gralco/TAZ6/production_parts/electronics/index.html

# Index of /TAZ/Olive/production_parts/electronics

(ICO) | Name | Last modified | Size | Description
(PARENTDIR) | Parent Directory | | -
(DIR) | RAMBo/ | 2017-02-20 23:40 | -
( ) | TAZ6_Wiring.pdf | 2017-12-14 18:19 | 142K
(DIR) | Wire_Harnesses/ | 2016-12-08 21:19 | -
(DIR) | stepper_motors/ | 2016-09-29 14:19 | -
