gralco/TAZ6/production_parts/electronics/RAMBo/index.html

# Index of /TAZ/Olive/production_parts/electronics/RAMBo

(ICO) | Name | Last modified | Size | Description
(PARENTDIR) | Parent Directory | | -
(DIR) | ArduinoAddons/ | 2017-02-20 23:40 | -
(TXT) | README.md | 2017-02-20 23:40 | 662
(DIR) | board/ | 2017-02-20 23:40 | -
(DIR) | bootloaders/ | 2017-02-20 23:40 | -
(DIR) | docs/ | 2017-02-20 23:40 | -
(DIR) | drivers/ | 2017-02-20 23:40 | -
(TXT) | license.txt | 2017-02-20 23:40 | 285
(DIR) | past/ | 2017-02-20 23:40 | -
