gralco/TAZ6/production_parts/electronics/stepper_motors/index.html

# Index of /TAZ/Olive/production_parts/electronics/stepper_motors

(ICO) | Name | Last modified | Size | Description
(PARENTDIR) | Parent Directory | | -
( ) | moons_stepper_NEMA17_MS17HD6P4150-01.pdf | 2016-09-29 14:19 | 58K
