gralco/TAZ6/production_parts/electronics/Wire_Harnesses/index.html

# Index of /TAZ/Olive/production_parts/electronics/Wire_Harnesses

(ICO) | Name | Last modified | Size | Description
(PARENTDIR) | Parent Directory | | -
( ) | Cable_List.ods | 2016-12-08 21:19 | 20K
(DIR) | External_Cable_Harnesses/ | 2017-12-06 19:19 | -
(DIR) | Extruder_Wiring/ | 2019-04-02 19:19 | -
(DIR) | Internal_Cable_Harnesses/ | 2018-10-31 19:19 | -
