gralco/TAZ6/production_parts/printed_parts/bed_mount_chassis/index.html

# Index of /TAZ/Olive/production_parts/printed_parts/bed_mount_chassis

(ICO) | Name | Last modified | Size | Description
(PARENTDIR) | Parent Directory | | -
( ) | bed_mount_chassis_v3.3_A-x8.stl | 2016-09-16 21:56 | 36M
( ) | bed_mount_chassis_v3.3_A.FCStd | 2016-09-16 21:56 | 533K
( ) | bed_mount_chassis_v3.3_A.stl | 2016-09-16 21:56 | 4.5M
(DIR) | mini/ | 2017-06-07 18:19 | -
