gralco/TAZ6/production_parts/printed_parts/electronics_case_mount/index.html

# Index of /TAZ/Olive/production_parts/printed_parts/electronics_case_mount

(ICO) | Name | Last modified | Size | Description
(PARENTDIR) | Parent Directory | | -
( ) | electronics_case_mount_v2.0-x9.stl | 2016-09-16 21:56 | 596K
( ) | electronics_case_mount_v2.0.fcstd | 2016-09-16 21:56 | 36K
( ) | electronics_case_mount_v2.0.stl | 2016-09-16 21:56 | 66K
(DIR) | mini/ | 2019-03-18 20:49 | -
(DIR) | mini2/ | 2019-03-18 20:49 | -
