gralco/TAZ6/production_docs/compliance/TAZ6_chassis_radiated_emissions_data.pdf

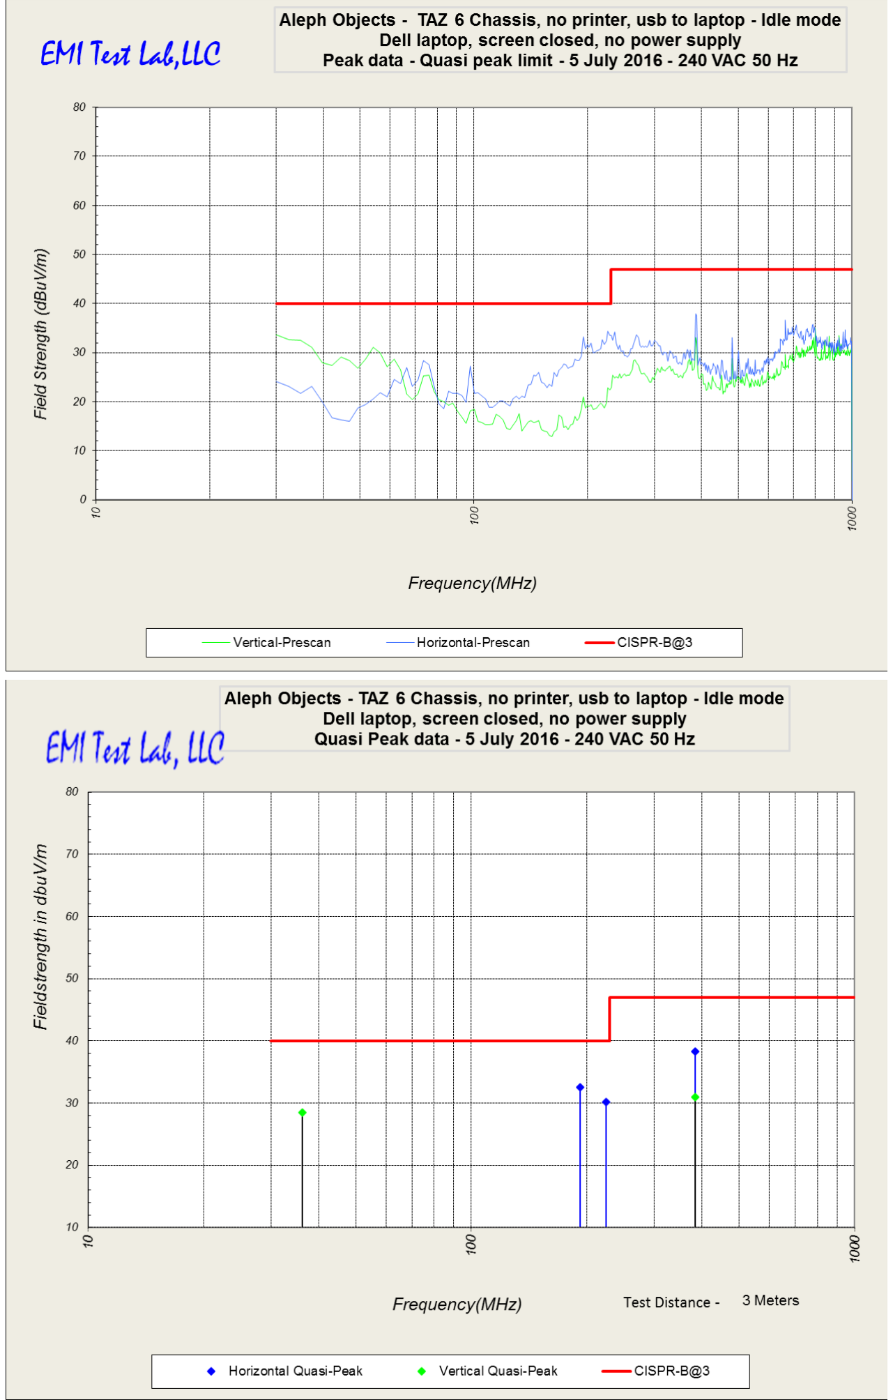
[picture p1: page 1]

### * No laptop power supply *

# EMI Test Lab

Frequency | F.S. EUT | Limit | Azimuth | Height
(MHz) | (dBuV/m) | (dBuV/m) | Degrees | Meters | H or V | Margin
383.99 | 30.94 | 47 | 228.0 | 1.40 | V | -16.06
36.18 | 28.42 | 40 | 228.0 | 1.40 | V | -11.58
191.99 | 32.53 | 40 | 16.0 | 1.40 | H | -7.47
384.00 | 38.32 | 47 | 64.0 | 1.40 | H | -8.68
224.49 | 30.20 | 40 | 312.0 | 1.40 | H | -9.80
1822 Skyway Drive, Unit J, Longmont Co | Dennis King
dennis@emitestlab.com , Cell 303-746-0611
| Antenna Polarization
