gralco/TAZ6/production_docs/OHAI/06_Frame_OHAI-T6.pdf

Frame Sub Assy

LulzBot TAZ 6.0 Frame
Step Pictures | Gather Tools and Parts

LulzBot TAZ 6.0 Frame
Step Pictures | Front Frame assembly
647 | 649
T-Nut installation orientation | 500mm threaded end alignment
651 | 2582 500mm 510mm
500mm/ 510mm frame alignment (arrows show Tnuts) | Four (4) T -Nuts per corner, Top slot
653 | 2567

500mm/ 510mm frame alignment

3mm Hex driver Squaring fixter | 4x- 500mm Aluminum Extrusion, M5 threaded one end 4x- 510mm Aluminum Extrusion, ends not threaded 41x- M5 T-Nut 32x- M5x10 BHCS 32x- M5 Washer, Black 8x- Corner gussets

Gather tools

Install four (4) T-Nuts into one side of a 500mm aluminum strut, position the T-Nuts so there are two (2) at each end of the strut; repeat for a second 500mm strut

Install four (4) T-Nuts into one side of a 510mm aluminum strut, position the T-Nuts so there are two (2) at each end of the strut; repeat for a second 510mm strut

Place the four (4) struts with the T-Nut side up

Arrange each of the 500mm struts parallel to each other and with their threaded ends at the same end oriented toward yourself

Place each of the 510mm struts between the 500mm struts so the 510mm struts align with the side and end of the 500mm strut (T-Nut sides should still be up)

Insert two (2) T-Nuts into the inside slot of the bottom 510mm strut, these will be used later in the assembly.

Place a corner gusset at each of the strut intersections; Loosely secure each gusset with (4) M5X10 BHCS and (4) M5 black washer.

Place one corner joint into a known square location, such as a squaring table; ensure the corners are square and the ends are flush; Secure each of the gusset screws are tightened to 4 ft-lbs (5.4NM); repeat this for each corner.

Additional T-Nuts on Top slot of the bottom extrusion

Frame Sub Assy

LulzBot TAZ 6.0 Frame
Step Pictures | Back Frame assembly

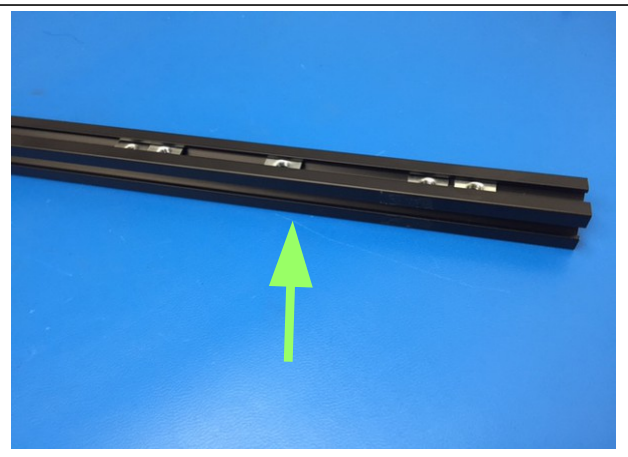
[picture p71: figure]
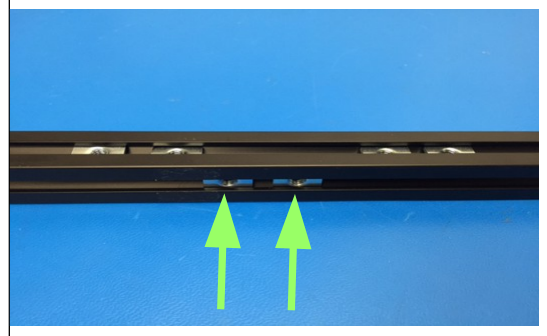
[picture p72: figure]

653 | 656
Back frame- Additional T-Nuts, Inside slot, right side | Back frame- Additional T-Nut, Top slot, left side

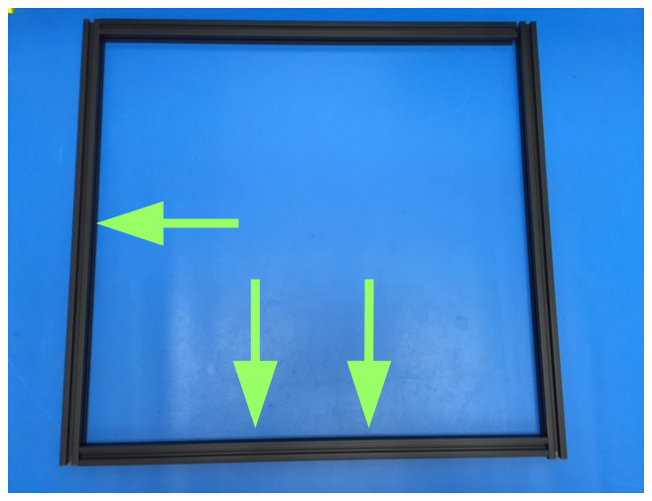
[picture p73: figure]
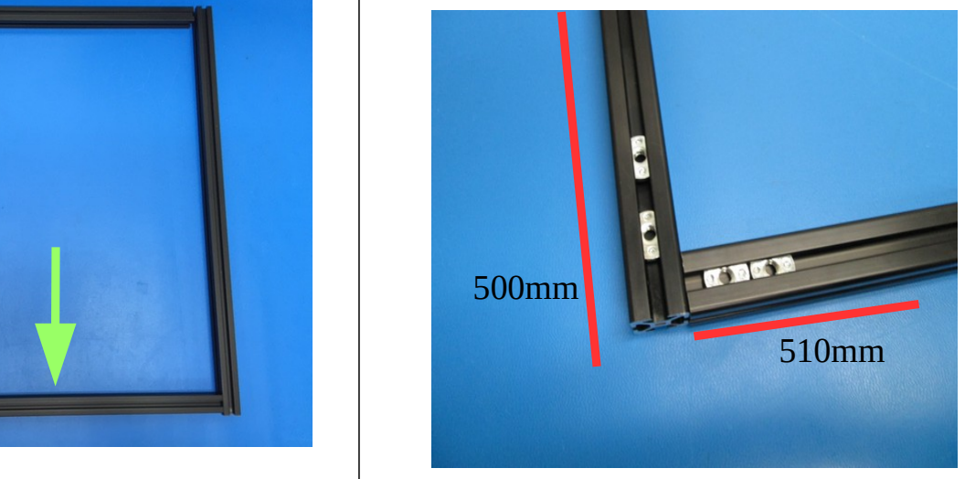
[picture p74: figure]

500mm/ 510mm frame alignment | Back frame- Additional T-Nut, Top slot, left side

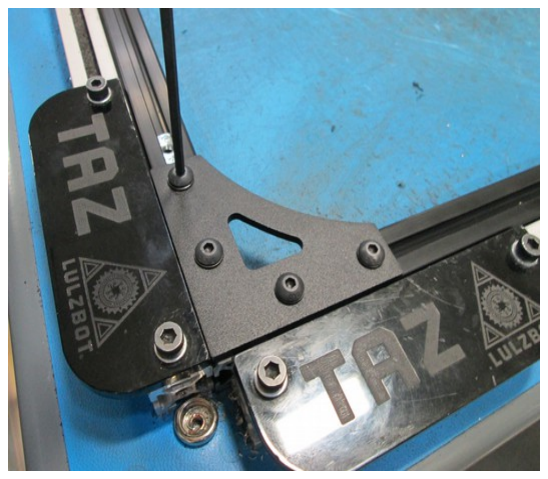
[picture p75: figure]

500mm/ 510mm frame alignment

Install four (4) T-Nuts into one side of a 500mm aluminum strut, position the T-Nuts so there are two (2) at each end of the strut; repeat for a second 500mm strut

Install four (4) T-Nuts into one side of a 510mm aluminum strut, position the T-Nuts so there are two (2) at each end of the strut; repeat for a second 510mm strut

Place the four (4) struts with the T-Nut side up

Arrange each of the 500mm struts parallel to each other and with their threaded ends at the same end oriented toward yourself

Place each of the 510mm struts between the 500mm struts so the 510mm struts align with the side and end of the 500mm strut (T-Nut sides should still be up)

Insert two (2) T-Nuts into the inside slot of the bottom 510mm strut, these will be used later in the assembly.

Place a corner gusset at each of the strut intersections; Loosely secure each gusset with (4) M5X10 BHCS and (4) M5 black washer.

Place one corner joint into a known square location, such as a squaring table; ensure the corners are square and the ends are flush; Secure each of the gusset screws are tightened to 4 ft-lbs (5.4NM); repeat this for each corner.
