gralco/TAZ6/production_docs/OHAI/10_XAssy_OHAI-T6.pdf

X Axis Sub

LulzBot TAZ 6.0 X Carriage sub assembly
Step Pictures | Gather Parts and Tools

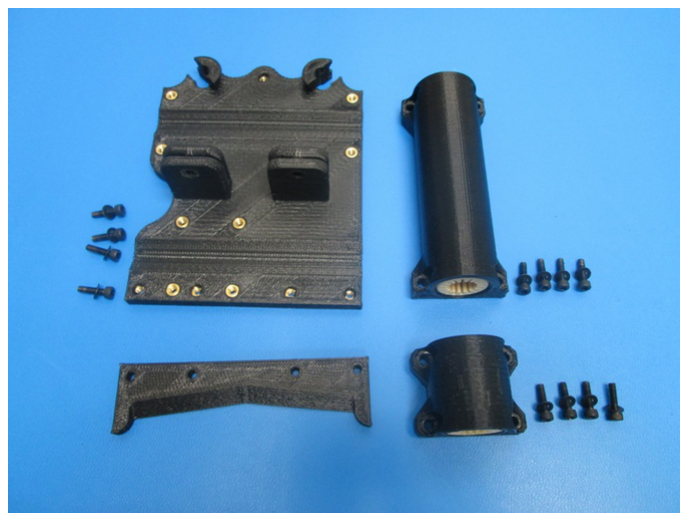
[picture p140: figure]

2134 | 2mm Hex driver | Gather Parts: 1x- X Carriage (with inserts installed) 1x- X Carriage Guide 1x- Single Bearing Holder (with bushing installed) 1x- Double Bearing Holder (with 2x bushings installed) 11x- M3x12 BHCS 12x- M3 Black washer 1x- M3x8 BHCS
Parts | Tools

LulzBot TAZ 6.0 X Carriage sub assembly
Step Pictures | X Carriage assembly

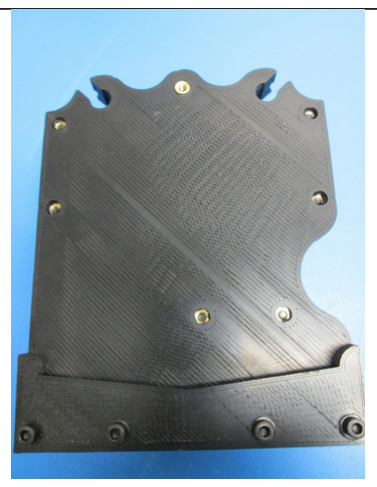
[picture p141: figure]
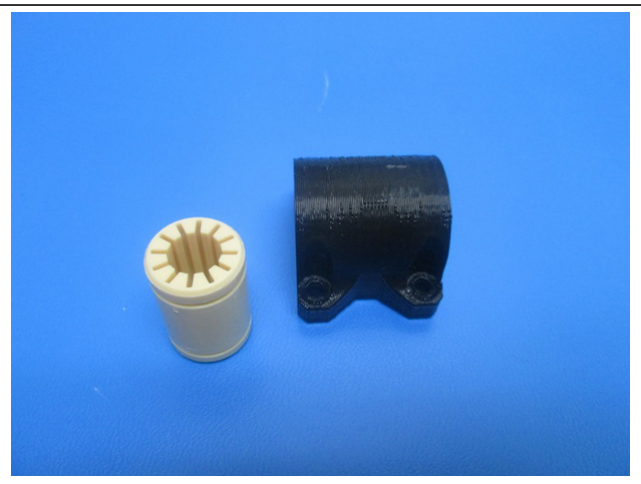
[picture p142: figure]

2007 | 2137
Install X Carriage Guide | Install single bearing into the holder

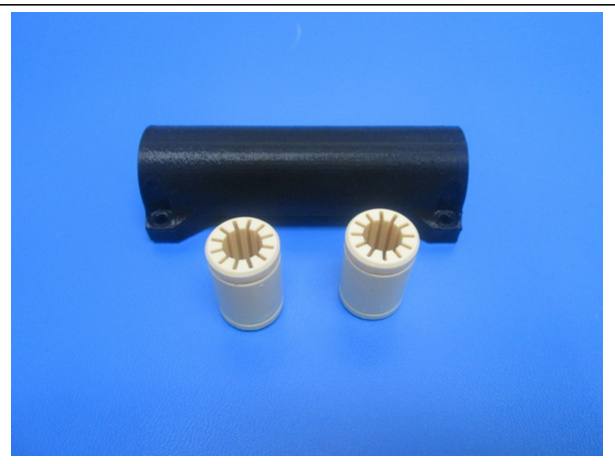
[picture p143: figure]
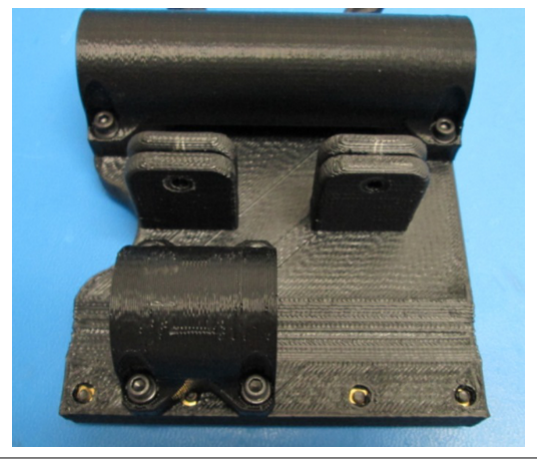
[picture p144: figure]

2009 | 2135
Install single bearing holder on the X Carraige | Install double bearing holder

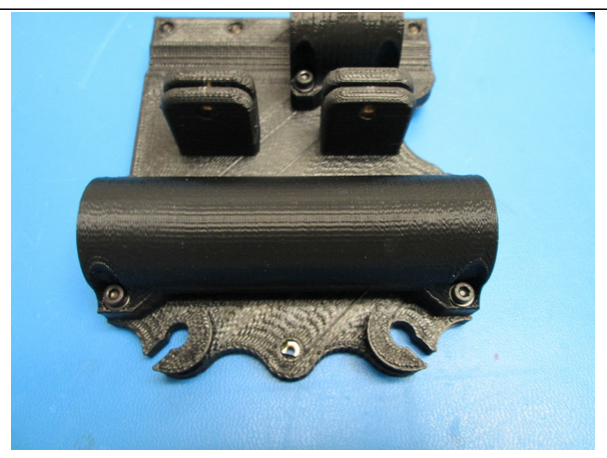
[picture p145: figure]

Install double bearing holder

Use four (4) M3x6 BHCS and four (4) M3 Black washers to install the X Carriage Guide onto the X Carriage; secure screws to hand tight

Install bushings into the Single Bearing holder

Use four (4) M3x6 BHCS and four (4) M3 Black washers to install the Single Bearing Holder onto the X Carriage; secure screws to hand tight

Install bushings into the Double Bearing holder

Use four (4) M3x6 BHCS and four (4) M3 Black washers to install the Double Bearing Holder onto the X Carriage; secure screws to hand tight
