gralco/TAZ6/software/firmware/Marlin_Oliveoil_Tilapia_v1.0.2.22_60d344d/Documentation/LCD Menu Tree.pdf

# Marlin LCD Menu Tree

Main Menu | Tune Menu | Move Menu
Info screen | Main | Prepare
Tune | Speed | Move 10mm | Move Menu
Prepare | Nozzle | Move 1mm | Move axis
Control | Nozzle2 | Move 0.1mm | Move X
Pause print | Nozzle3 | | Move Y
Resume print | Bed | | Move Z
Stop print | Fan speed | Temperature Menu | Extruder
Print from SD | Flow | Control
Change SD card | Babystep X | Nozzle
No SD card | Babystep Y | Nozzle2
Init. SD card | Babystep Z | Nozzle3
| Change filament | Bed
| | Fan speed
| | Autotemp
| Prepare Menu | \002 Min
| Main | \002 Max | Preheat PLA
| Autostart | \002 Fact | Temperature
| Disable steppers | PID-P | Fan speed
| Auto home | PID-I | Nozzle
| Preheat PLA | PID-D | Bed
| Preheat ABS | PID-C | Store memory
| Cooldown | Preheat PLA conf
| Switch power off | Preheat ABS conf | Preheat ABS
Switch power on | Temperature
Move axis | Fan speed
| Motion Menu | Nozzle
| Control | Bed
Control Menu | Z Offset | Store memory
Main | Accel
Temperature | Vxy-jerk
Motion | Vz-jerk
LCD contrast | Ve-jerk
Retract | Vmax x
Store memory | Vmax y
Load memory | Vmax z
Restore failsafe | Vmax e
| Vmin
| VTrav min
SD Card Menu | Amax x
Main | Amax y
Refresh | Amax z
filenames | Amax e
| A-retract
| Xsteps/mm
| Ysteps/mm
| Zsteps/mm
| Esteps/mm
| Endstop abort

Retract Menu
Control
AutoRetr.
Retract mm
Retract F
Hop mm
UnRet +mm
UnRet F
