gralco/TAZ6/production_parts/electronics/RAMBo/board/pin_list.ods

Port | Arduino Digital # | Function | RAMBo Function | Color | Function
PE0 | 0 | USART0_RX | USB/Serial Ext 3 |  | Serial
PE1 | 1 | USART0_TX | USB/Serial Ext 4 |  | MOSFET
PE4 | 2 | PWM2 | Fan-2 |  | Stepper
PE5 | 3 | PWM3 | Bed-Heat |  | I2C
PG5 | 4 | PWM4 | PS-On/PWM Ext 6 |  | Ext2
PE3 | 5 | PWM5 | PWM Ext 5 |  | Analog In
PH3 | 6 | PWM6 | Fan-1 |  | SPI
PH4 | 7 | PWM7 | Heat-1 |  | PWM
PH5 | 8 | PWM8 | Fan-0 |  | Stepper Ext
PH6 | 9 | PWM9 | Heat-0 |  | Endstop
PB4 | 10 | PWM10 | Z-Min |  | Endstop/Stepper Ext
PB5 | 11 | PWM11 | Y-Min
PB6 | 12 | PWM12 | X-Min
PB7 | 13 | PWM13 | LED/PWM Ext 3
PJ1 | 14 | USART3_TX | Serial Ext 10
PJ0 | 15 | USART3_RX | Serial Ext 9
PH1 | 16 | USART2_TX | Serial Ext 8
PH0 | 17 | USART2_RX | Serial Ext 7
PD3 | 18 | USART1_TX | Serial Ext 6
PD2 | 19 | USART1_RX | Serial Ext 5
PD1 | 20 | I2C_SDA | I2C Ext 3
PD0 | 21 | I2C_SCL | I2C Ext 4
PA0 | 22 | D22 | MX1-3
PA1 | 23 | D23 | Y-Max/MX3-3
PA2 | 24 | D24 | X-Max/MX2-3
PA3 | 25 | D25 | E1-En
PA4 | 26 | D26 | E0-En
PA5 | 27 | D27 | Z-En
PA6 | 28 | D28 | Y-En
PA7 | 29 | D29 | X-En
PC7 | 30 | D30 | Z-Max/MX2-4
PC6 | 31 | D31 | MX3-4
PC5 | 32 | D32 | MX1-4
PC4 | 33 | D33 | E1-Step
PC3 | 34 | D34 | E0-Step
PC2 | 35 | D35 | Z-Step
PC1 | 36 | D36 | Y-Step
PC0 | 37 | D37 | X-Step
PD7 | 38 | D38 | DigiPot-SS
PG2 | 39 | D39 | Y-MS2
PG1 | 40 | D40 | X-MS1
PG0 | 41 | D41 | X-MS2
PL7 | 42 | D42 | E1-Dir
PL6 | 43 | D43 | E0-Dir
PL5 | 44 | D44 | MX1-5
PL4 | 45 | D45 | MX3-5
PL3 | 46 | D46 | MX2-5
PL2 | 47 | D47 | Z-Dir
PL1 | 48 | D48 | X-Dir
PL0 | 49 | D49 | Y-Dir
PB3 | 50 | SPI_MISO | SPI Ext 3
PB2 | 51 | SPI_MOSI | SPI Ext 4
PB1 | 52 | SPI_SCK | SPI Ext 5
PB0 | 53 | SPI_SS | SPI Ext 6
PF0 | 54 | A0 | T0
PF1 | 55 | A1 | T1
PF2 | 56 | A2 | T2
PF3 | 57 | A3 | Analog Ext 8
PF4 | 58 | A4 | Analog Ext 6
PF5 | 59 | A5 | Analog Ext 4
PF6 | 60 | A6 | Analog Ext 3
PF7 | 61 | A7 | T3/Analog Ext 5
PK0 | 62 | A8 | Analog Ext 7
PK1 | 63 | A9 | E1-MS1
PK2 | 64 | A10 | E1-MS2
PK3 | 65 | A11 | E0-MS1
PK4 | 66 | A12 | E0-MS2
PK5 | 67 | A13 | Z-MS2
PK6 | 68 | A14 | Z-MS1
PK7 | 69 | A15 | Y-MS1
PG4 | 70 | D70 | Ext2 5
PG3 | 71 | D71 | Ext2 7
PJ2 | 72 | D72 | Ext2 9
PJ3 | 73 | D73 | Ext2 11
PJ7 | 74 | D74 | Ext2 13
PJ4 | 75 | D75 | Ext2 15
PJ5 | 76 | D76 | Ext2 17
PJ6 | 77 | D77 | Ext2 19
PE2 | 78 | D78 | Ext2 20
PE6 | 79 | D79 | Ext2 18
PE7 | 80 | D80 | Ext2 16
PD4 | 81 | D81 | Ext2 14
PD5 | 82 | D82 | Ext2 12
PD6 | 83 | D83 | Ext2 10
PH2 | 84 | D84 | Ext2 8
PH7 | 85 | D85 | Ext2 6
