gralco/TAZ6/production_docs/Cura_Update_Insert_02.pdf

# Attention:

The applications, documentation and source files included within may have been updated since the packaging of this LulzBot product.
Get the latest features, improved performance, and even more filament compatibility by installing the latest version of Cura LulzBot Edition: LulzBot.com/Cura
Learn more about Cura LE: LulzBot.com/Cura-QSG View the latest source files: Download.LulzBot.com Get answers and advice when you need them:
Lulzbot.com/Support | Support@LulzBot.com | +1-970-377-1111
