gralco/TAZ6/documentation/manual/source/images-1600x1200/electronics_case_rec.JPG

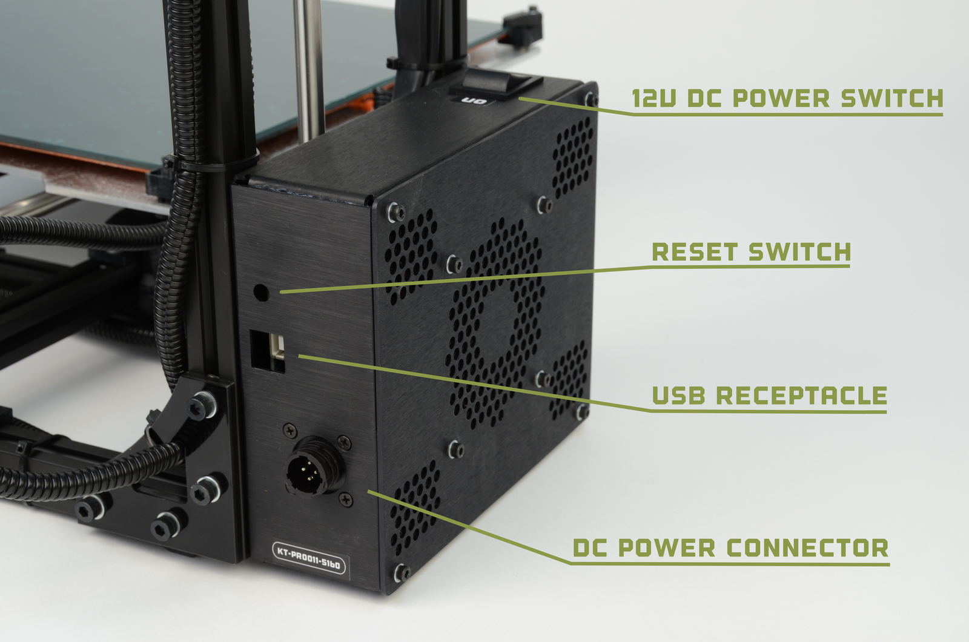
documentation/manual/source/images-1600x1200/electronics_case_rec.JPG
