gralco/TAZ6/documentation/manual/source/images-1600x1200/electronics_DC_connector_tight.JPG

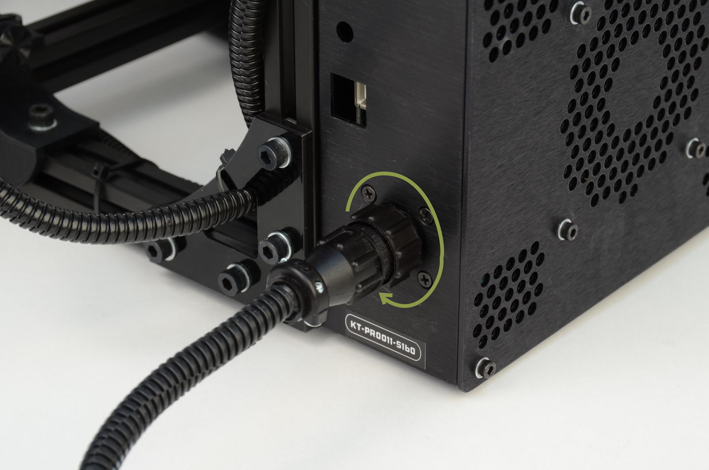
documentation/manual/source/images-1600x1200/electronics_DC_connector_tight.JPG
