gralco/TAZ6/photos/mock.JPG

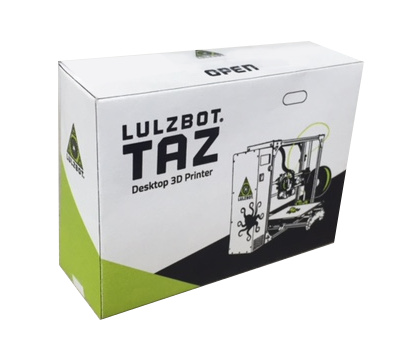
photos/mock.JPG
