gralco/TAZ6/photos/taz_6_angle_octopus.jpg

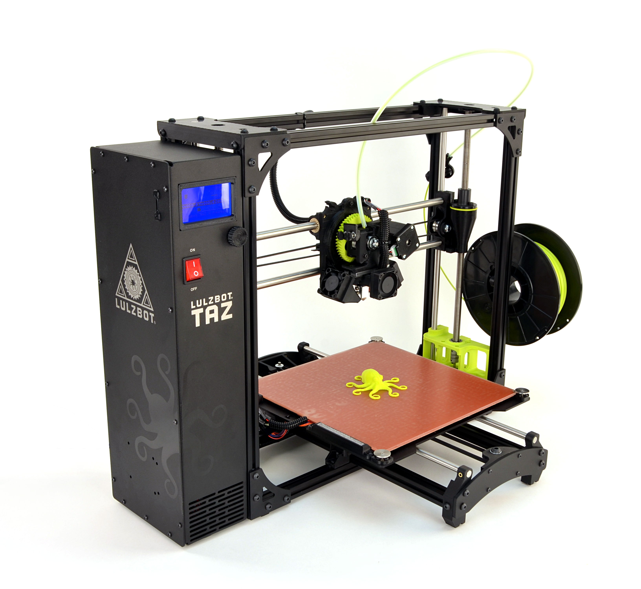
photos/taz_6_angle_octopus.jpg
