gralco/TAZ6/photos/TAZ_6_Angle_Rock2pus.jpg

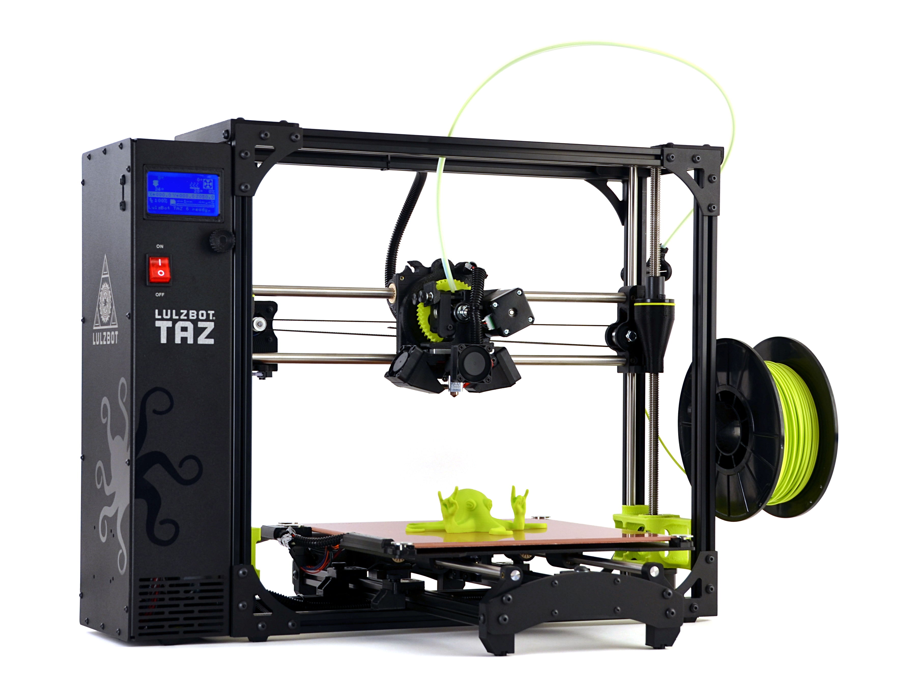
photos/TAZ_6_Angle_Rock2pus.jpg
