gralco/TAZ6/photos/TAZ_6_Angle_Rock2pus_2.jpg

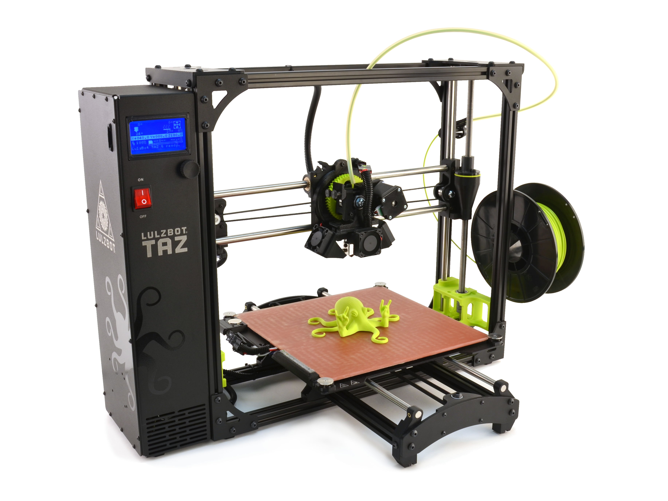
photos/TAZ_6_Angle_Rock2pus_2.jpg
