gralco/TAZ6/photos/TAZ_6_Angle_w_Rock2pus_300X200.Jpg

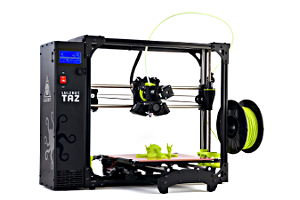
photos/TAZ_6_Angle_w_Rock2pus_300X200.Jpg
