gralco/TAZ6/photos/TAZ_6_Box_FullRes_whiteBG.JPG

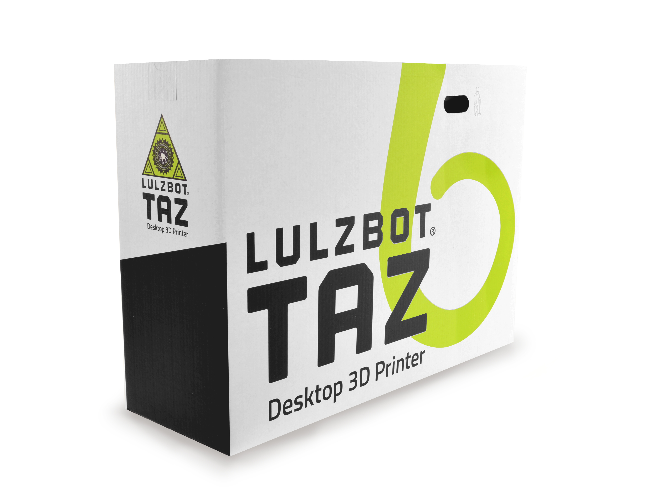
photos/TAZ_6_Box_FullRes_whiteBG.JPG
