gralco/TAZ6/photos/TAZ_6_BoxWithTape.JPG

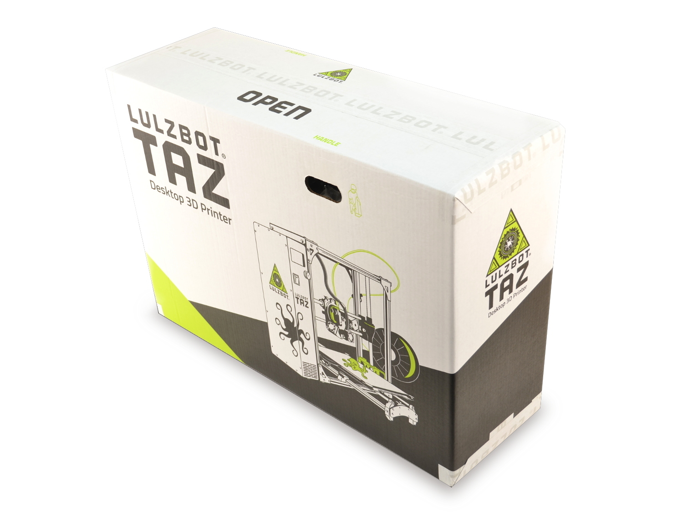
photos/TAZ_6_BoxWithTape.JPG
