gralco/TAZ6/photos/TAZ_6_DragonKnockerOnBed.JPG

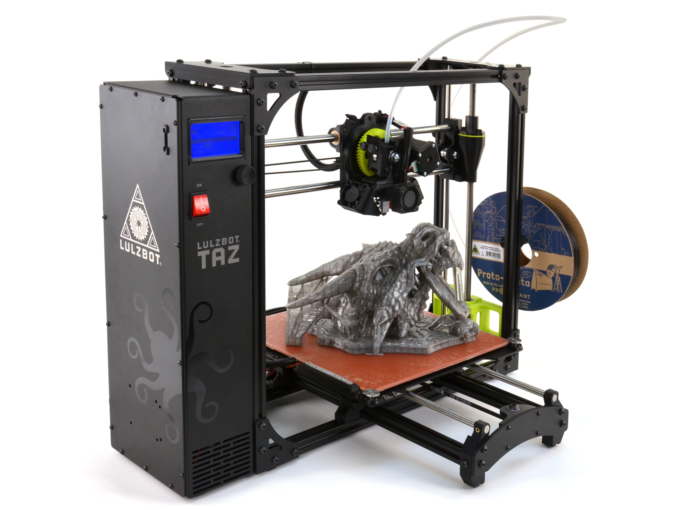
photos/TAZ_6_DragonKnockerOnBed.JPG
