gralco/TAZ6/photos/TAZ_6_frontal_transpBG.png

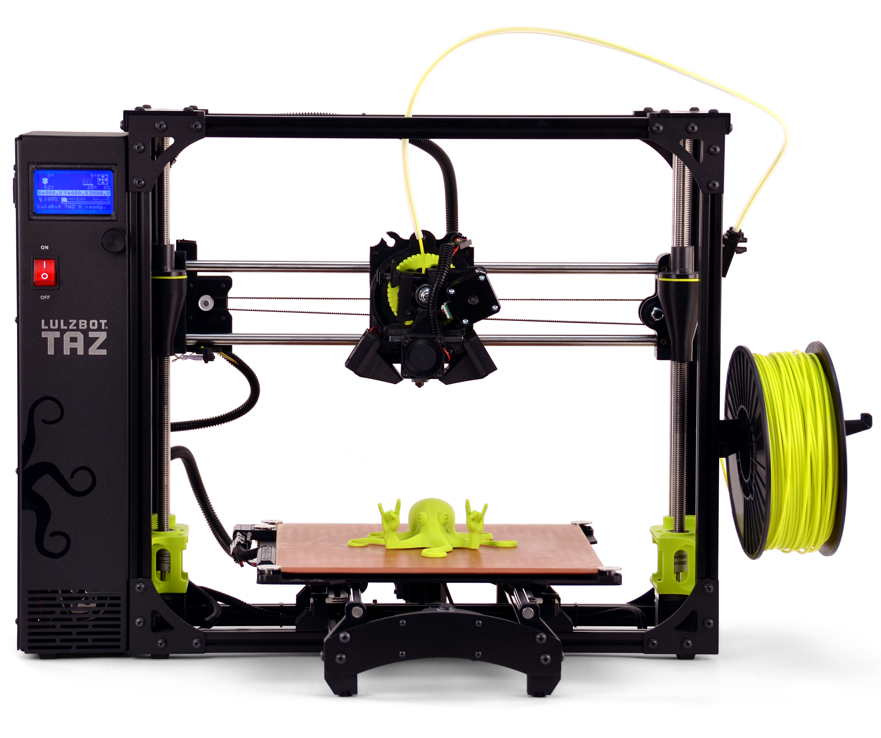
photos/TAZ_6_frontal_transpBG.png
