gralco/TAZ6/photos/TAZ_6_RightQuarterTurn_FullRes.JPG

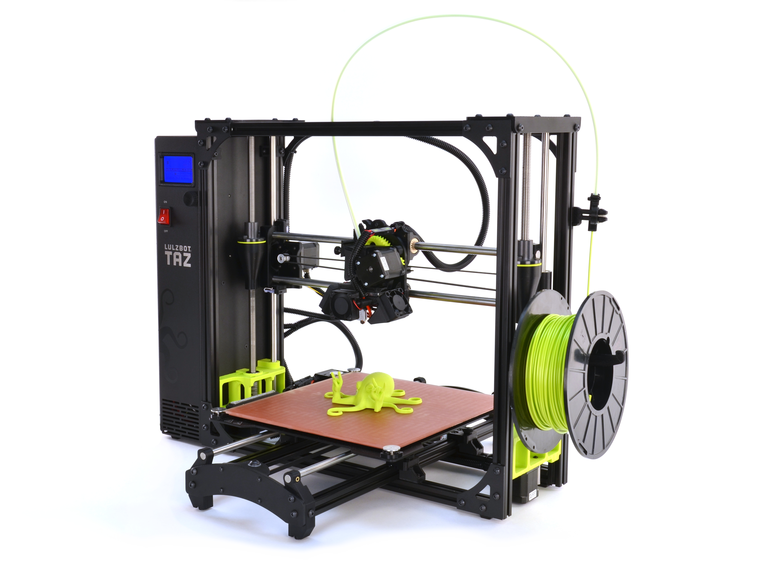
photos/TAZ_6_RightQuarterTurn_FullRes.JPG
