gralco/TAZ6/production_parts/electronics/RAMBo/past/motorExt1-1.jpg

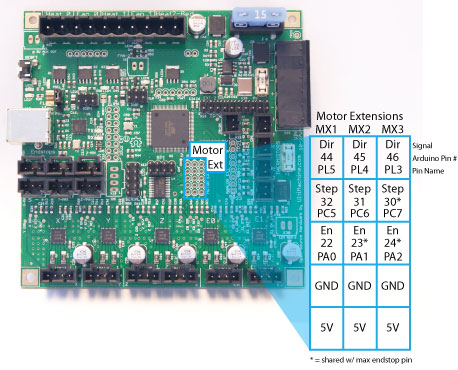
production_parts/electronics/RAMBo/past/motorExt1-1.jpg
