gralco/TAZ6/production_parts/printed_parts/bed_corner_taz6/index.html

Name | Last modified | Size | Description
Parent Directory |  | -
Taz/ | 2018-08-22 20:49 | -
bed_corner_taz6_v2.fcstd | 2016-09-16 21:56 | 19K
bed_corner_taz6_v2.stl | 2016-09-16 21:56 | 28K
mini-flexy/ | 2019-03-18 15:49 | -
mini_Aero-flexy/ | 2017-10-26 00:49 | -
