gralco/TAZ6/production_parts/printed_parts/flexy_bed_foot/index.html

Name | Last modified | Size | Description
Parent Directory |  | -
Taz/ | 2018-08-14 14:19 | -
flexy_bed_foot_v0.1.fcstd | 2016-09-16 21:56 | 6.2K
flexy_bed_foot_v0.1.stl | 2016-09-16 21:56 | 88K
mini/ | 2018-10-23 17:49 | -
