gralco/TAZ6/production_parts/printed_parts/flexy_washer/index.html

Name | Last modified | Size | Description
Parent Directory |  | -
Taz/ | 2018-08-08 16:19 | -
flexy_washer_v0.1.fcstd | 2016-09-16 21:56 | 5.2K
flexy_washer_v0.1.stl | 2016-09-16 21:56 | 107K
mini/ | 2017-11-08 15:49 | -
