gralco/TAZ6/production_parts/printed_parts/spool_arm/index.html

Name | Last modified | Size | Description
Parent Directory |  | -
spool_arm_v0.2-x2.stl | 2016-09-16 21:56 | 667K
spool_arm_v0.2.FCStd | 2016-09-16 21:56 | 758K
spool_arm_v0.2.stl | 2016-09-16 21:56 | 334K
taz/ | 2017-02-21 20:19 | -
taz6/ | 2017-01-17 19:49 | -
