gralco/TAZ6/production_docs/OliveOil_TAZ-BOM_3000.Ordering.ods

Sheet: KT-PR0041NA
Category | AO Part # | Description | Manufacturer | Manufacturer PN | Distributor | Distributor SKU | Qty Per | UOM | Price Per Unit | Price Total | Qty to Order | PO | Date | ETA
 |  |  |  |  |  |  |  |  |  | #VALUE! | 1,100
Printer | KT-PR0041 | TAZ 3D Printer, v6.0 | Aleph Objects, Inc. | KT-PR0041 |  |  | 1 | ea | = | #VALUE!
Accessories | DC-LB0098 | Label, Lulzbot TAZ 6.0 Barcode, KT-PR0041NA |  |  | Print Source of Loveland |  | 1 | ea | $0.105 | $0.10 | 1,100 | PO12745 | 03/31/16 | 04/06/16 | received
Accessories | DC-LB0097 | TAZ v6.0 serial number sticker, KT-PR0041NA |  |  | Print Source of Loveland |  | 1 | ea | $0.015 | $0.02 | 1,100 | PO12745 | 03/31/16 | 04/06/16 | received

Sheet: KT-PR0041EU
Category | AO Part # | Description | Manufacturer | Manufacturer PN | Distributor | Distributor SKU | Qty Per | UOM | Price Per Unit | Price Total | Qty to Order | PO | Date | ETA
 |  |  |  |  |  |  |  |  |  | #VALUE! | 300
Printer | KT-PR0041 | TAZ 3D Printer, v6.0 | Aleph Objects, Inc. | KT-PR0041 |  |  | 1 | ea | = | #VALUE!
Accessories | DC-LB0100 | Label, Lulzbot TAZ 6.0 Barcode, KT-PR0041EU |  |  | Print Source of Loveland |  | 1 | ea | $0.06 | $0.06 | 300 | PO12745 | 03/31/16 | 04/01/16
Accessories | DC-LB0099 | TAZ v6.0 serial number sticker, KT-PR0041EU |  |  | Print Source of Loveland |  | 1 | ea | $0.04 | $0.04 | 300 | PO12745 | 03/31/16 | 04/01/16
Accessories | EL-CA0031 | 6ft 18AWG England Power Cord Cable - H05VV-F NEMA C13 – Black |  |  | Linvox | 7691 | 1 | ea | $1.98 | $1.98 | 300 |  |  |  | 525 on hand, Hold on ordering per Steven.
Accessories | EL-CA0032 | 6ft 18AWG European Power Cord Cable - H05VV-F NEMA C13 – Black |  |  | Linvox | 7692 | 1 | ea | $1.25 | $1.25 | 300 |  |  |  | 625 On hand, Hold on ordering per Steven

Sheet: KT-PR0041AU
Category | AO Part # | Description | Manufacturer | Manufacturer PN | Distributor | Distributor SKU | Qty Per | UOM | Price Per Unit | Price Total | Qty to Order | PO | Date | ETA
 |  |  |  |  |  |  |  |  |  | #VALUE! | 100
Printer | KT-PR0041 | TAZ 3D Printer, v6.0 | Aleph Objects, Inc. | KT-PR0041 |  |  | 1 | ea | = | #VALUE!
Accessories | DC-LB0102 | Label, Lulzbot TAZ 6.0 Barcode, KT-PR0041AU |  |  | Print Source of Loveland |  | 1 | ea | $0.21 | $0.21 | 100 | PO12745 | 03/31/16 | 04/04/16
Accessories | DC-LB0101 | TAZ v6.0 serial number sticker, KT-PR0041AU |  |  | Print Source of Loveland |  | 1 | ea | $0.10 | $0.10 | 100 | PO12745 | 03/31/16 | 04/04/16
Accessories | EL-CA0056 | 6ft 18AWG Australian Power Cord Cable - H05VV-FNEMA C13 – Black |  |  | Linvox | 7670 | 1 | ea | $1.70 | $1.70 | 100 |  |  |  | PER Steven- hold to order….158 pc in stock now 4/7/16

Sheet: OdooParts_PurchaseNotes
Internal Reference | Name | Type | Long Lead | U/M | Price Per Unit | Manufacturer | Mfg PN | Supplier | Supplier PN | Distributor SKU | Notes | 2nd Distributor | 2nd Dist. Part Number | Mass each (g) | Mass per Printer (g) | Mass Total (kg)
AS-CB0005 | TAZ6, Extruder Heatsink Fan Harness | Make | No | PCE | 0 | AlephObjects | 0 | 0 | 0 | 0 | 0 | 0 | 0 | 0 | 0 | 0
AS-CB0006 | TAZ6, Extruder X-Max Switch Ext Harness | Make | No | PCE | 0 | AlephObjects | 0 | 0 | 0 | 0 | 0 | 0 | 0 | 0 | 0 | 0
AS-CB0007 | Heater Cartridge 180mm Harness | Make | No | PCE | 0 | AlephObjects | 0 | 0 | 0 | 0 | 0 | 0 | 0 | 0 | 0 | 0
AS-CB0008 | Thermistor 150mm Harness | Make | No | PCE | 0 | AlephObjects | 0 | 0 | 0 | 0 | 0 | 0 | 0 | 0 | 0 | 0
AS-CB0009 | Zero Sense 155mm Harness | Make | No | PCE | 0 | AlephObjects | 0 | 0 | 0 | 0 | 0 | 0 | 0 | 0 | 0 | 0
AS-HE0002 | .50 mm Hot End Assembly, for single | Make | No | PCE | 0 | AlephObjects | 0 | 0 | 0 | 0 | 0 | 0 | 0 | 0 | 0 | 0
AS-PK0005 | TAZ6, Olive Oil, Packaging | Make | No | PCE | 0 | AlephObjects | 0 | 0 | 0 | 0 | 0 | 0 | 0 | 0 | 0 | 0
AS-PK0006 | TAZ6, Olive Oil, Documentation Bag | Make | No | PCE | 0 | AlephObjects | 0 | 0 | 0 | 0 | 0 | 0 | 0 | 0 | 0 | 0
AS-PK0007 | TAZ6, Olive Oil, Extruder Package | Make | No | PCE | 0 | AlephObjects | 0 | 0 | 0 | 0 | 0 | 0 | 0 | 0 | 0 | 0
AS-PK0008 | TAZ6, Olive Oil, Accessories Package | Make | No | PCE | 0 | AlephObjects | 0 | 0 | 0 | 0 | 0 | 0 | 0 | 0 | 0 | 0
AS-PK0009 | TAZ6, Tool Kit | Make | No | PCE | 0 | AlephObjects | 0 | 0 | 0 | 0 | 0 | 0 | 0 | 0 | 0 | 0
AS-PK0010 | 90 mm wiper pad set | Make | No | PCE | 0 | AlephObjects | 0 | 0 | 0 | 0 | 0 | 0 | 0 | 0 | 0 | 0
AS-PR0001 | TAZ6, Olive Oil, Calibrated Assembly | Make | No | PCE | 0 | AlephObjects | 0 | 0 | 0 | 0 | 0 | 0 | 0 | 0 | 0 | 0
AS-PR0002 | TAZ6, Print Bed Assembly | Make | No | PCE | 0 | AlephObjects | 0 | 0 | 0 | 0 | 0 | 0 | 0 | 0 | 0 | 0
AS-PR0003 | TAZ6, Olive Oil, Final Mechanical Assembly | Make | No | PCE | 0 | AlephObjects | 0 | 0 | 0 | 0 | 0 | 0 | 0 | 0 | 0 | 0
AS-PR0004 | TAZ6, Olive Oil, Control Box Assembly | Make | No | PCE | 0 | AlephObjects | 0 | 0 | 0 | 0 | 0 | 0 | 0 | 0 | 0 | 0
AS-PR0005 | TAZ6, Power Supply with External wiring Assembly | Make | No | PCE | 0 | AlephObjects | 0 | 0 | 0 | 0 | 0 | 0 | 0 | 0 | 0 | 0
AS-PR0006 | TAZ6, Frame, Final Assembly | Make | No | PCE | 0 | AlephObjects | 0 | 0 | 0 | 0 | 0 | 0 | 0 | 0 | 0 | 0
AS-PR0008 | TAZ6, Bed Mount Chassis with Inserts | Make | No | PCE | 0 | AlephObjects | 0 | 0 | 0 | 0 | 0 | 0 | 0 | 0 | 0 | 0
AS-PR0008 | TAZ6, Bed Mount Chassis with Inserts | Make | No | PCE | 0 | AlephObjects | 0 | 0 | 0 | 0 | 0 | 0 | 0 | 0 | 0 | 0
AS-PR0011 | TAZ6, Tippy Feed Tube Holder with Bushing Assembly | Make | No | PCE | 0 | AlephObjects | 0 | 0 | 0 | 0 | 0 | 0 | 0 | 0 | 0 | 0
AS-PR0012 | TAZ6, Spool Arm with Bushing Assembly | Make | No | PCE | 0 | AlephObjects | 0 | 0 | 0 | 0 | 0 | 0 | 0 | 0 | 0 | 0
AS-PR0013 | TAZ6, Z Axis Left Assembly | Make | No | PCE | 0 | AlephObjects | 0 | 0 | 0 | 0 | 0 | 0 | 0 | 0 | 0 | 0
AS-PR0014 | TAZ6, Z Carriage Motor with Bearings and Inserts Assembly | Make | No | PCE | 0 | AlephObjects | 0 | 0 | 0 | 0 | 0 | 0 | 0 | 0 | 0 | 0
AS-PR0015 | TAZ6, Z Carriage Motor with Bearings Assembly | Make | No | PCE | 0 | AlephObjects | 0 | 0 | 0 | 0 | 0 | 0 | 0 | 0 | 0 | 0
AS-PR0016 | TAZ6, Z Lower Left with Inserts Assembly | Make | No | PCE | 0 | AlephObjects | 0 | 0 | 0 | 0 | 0 | 0 | 0 | 0 | 0 | 0
AS-PR0017 | TAZ6, Z Axis Right Assembly | Make | No | PCE | 0 | AlephObjects | 0 | 0 | 0 | 0 | 0 | 0 | 0 | 0 | 0 | 0
AS-PR0018 | TAZ6, Z Carriage Idler with Bearings and Inserts Assembly | Make | No | PCE | 0 | AlephObjects | 0 | 0 | 0 | 0 | 0 | 0 | 0 | 0 | 0 | 0
AS-PR0019 | TAZ6, Z Carriage Idler with Bearings Assembly | Make | No | PCE | 0 | AlephObjects | 0 | 0 | 0 | 0 | 0 | 0 | 0 | 0 | 0 | 0
AS-PR0020 | TAZ6, Z Lower Right with Inserts Assembly | Make | No | PCE | 0 | AlephObjects | 0 | 0 | 0 | 0 | 0 | 0 | 0 | 0 | 0 | 0
AS-PR0021 | TAZ6, Olive Oil, Y Axis Assembly | Make | No | PCE | 0 | AlephObjects | 0 | 0 | 0 | 0 | 0 | 0 | 0 | 0 | 0 | 0
AS-PR0022 | TAZ6, Y Axis Bed Plate Assembly | Make | No | PCE | 0 | AlephObjects | 0 | 0 | 0 | 0 | 0 | 0 | 0 | 0 | 0 | 0
AS-PR0023 | 90mm Cut wiper pad | Make | No | PCE | 0 | AlephObjects | 0 | 0 | 0 | 0 | 0 | 0 | 0 | 0 | 0 | 0
AS-PR0024 | TAZ6, Y Belt Mount with Inserts Assembly | Make | No | PCE | 0 | AlephObjects | 0 | 0 | 0 | 0 | 0 | 0 | 0 | 0 | 0 | 0
AS-PR0025 | 10mm Single Bearing holders Assembly | Make | No | PCE | 0 | AlephObjects | 0 | 0 | 0 | 0 | 0 | 0 | 0 | 0 | 0 | 0
AS-PR0026 | TAZ6, Y Corner Right with Insert Assembly | Make | No | PCE | 0 | AlephObjects | 0 | 0 | 0 | 0 | 0 | 0 | 0 | 0 | 0 | 0
AS-PR0027 | TAZ6, Y Corner Left with Insert Assembly | Make | No | PCE | 0 | AlephObjects | 0 | 0 | 0 | 0 | 0 | 0 | 0 | 0 | 0 | 0
AS-PR0028 | TAZ6, Y Idler with Bearings and Inserts | Make | No | PCE | 0 | AlephObjects | 0 | 0 | 0 | 0 | 0 | 0 | 0 | 0 | 0 | 0
AS-PR0029 | TAZ6, Y Idler Mount with Inserts Assembly | Make | No | PCE | 0 | AlephObjects | 0 | 0 | 0 | 0 | 0 | 0 | 0 | 0 | 0 | 0
AS-PR0030 | TAZ6, Y Axis Motor End Assembly | Make | No | PCE | 0 | AlephObjects | 0 | 0 | 0 | 0 | 0 | 0 | 0 | 0 | 0 | 0
AS-PR0031 | TAZ6, Y Motor Mount with Inserts Assembly | Make | No | PCE | 0 | AlephObjects | 0 | 0 | 0 | 0 | 0 | 0 | 0 | 0 | 0 | 0
AS-PR0032 | TAZ6, Olive Oil, X Carriage Assembly | Make | No | PCE | 0 | AlephObjects | 0 | 0 | 0 | 0 | 0 | 0 | 0 | 0 | 0 | 0
AS-PR0033 | TAZ6, X carriage with Inserts Assembly | Make | No | PCE | 0 | AlephObjects | 0 | 0 | 0 | 0 | 0 | 0 | 0 | 0 | 0 | 0
AS-PR0034 | TAZ6, 12mm Double Bearing Holder with Bearings Assembly | Make | No | PCE | 0 | AlephObjects | 0 | 0 | 0 | 0 | 0 | 0 | 0 | 0 | 0 | 0
AS-PR0035 | TAZ6, 12mm Single Bearing Holder with Bearing Assembly | Make | No | PCE | 0 | AlephObjects | 0 | 0 | 0 | 0 | 0 | 0 | 0 | 0 | 0 | 0
AS-PR0036 | 16mm Thumbscrew Cap Installed onto M5 x14 Black Oxide screw | Make | No | PCE | 0 | AlephObjects | 0 | 0 | 0 | 0 | 0 | 0 | 0 | 0 | 0 | 0
AS-PR0082 | Feed Tube Assembly, v3.0 | Make | No | PCE | 0 | AlephObjects | 0 | 0 | 0 | 0 | 0 | 0 | 0 | 0 | 0 | 0
AS-TH0003 | Large Herringbone, Green with Hob Bolt Assembly | Make | No | PCE | 0 | AlephObjects | 0 | 0 | 0 | 0 | 0 | 0 | 0 | 0 | 0 | 0
AS-TH0004 | Extruder Idler Block with Bearing Assembly | Make | No | PCE | 0 | AlephObjects | 0 | 0 | 0 | 0 | 0 | 0 | 0 | 0 | 0 | 0
AS-TH0005 | Extruder Thumb Screw assembly | Make | No | PCE | 0 | AlephObjects | 0 | 0 | 0 | 0 | 0 | 0 | 0 | 0 | 0 | 0
AS-TH0011 | TAZ, Dual Extruder, Feed Tube Assembly | Make | No | PCE | 0 | AlephObjects | 0 | 0 | 0 | 0 | 0 | 0 | 0 | 0 | 0 | 0
AS-TH0014 | TAZ6, Olive Oil, Extruder Assembly | Make | No | PCE | 0 | AlephObjects | 0 | 0 | 0 | 0 | 0 | 0 | 0 | 0 | 0 | 0
AS-TH0015 | TAZ6, Extruder Mount with Inserts | Make | No | PCE | 0 | AlephObjects | 0 | 0 | 0 | 0 | 0 | 0 | 0 | 0 | 0 | 0
AS-TH0016 | Extruder Heatsink Fan duct with Insert Assembly | Make | No | PCE | 0 | AlephObjects | 0 | 0 | 0 | 0 | 0 | 0 | 0 | 0 | 0 | 0
AS-TH0017 | TAZ6, Fan Duct Left | Make | No | PCE | 0 | AlephObjects | 0 | 0 | 0 | 0 | 0 | 0 | 0 | 0 | 0 | 0
AS-TH0018 | TAZ6, Fan Duct Right | Make | No | PCE | 0 | AlephObjects | 0 | 0 | 0 | 0 | 0 | 0 | 0 | 0 | 0 | 0
DC-LB0001 | Label, Lulzbot AO-101 Barcode label |  |  | PCE |  |  | 0 |  | 0
DC-LB0002 | Label, LulzBot AO-100 Barcode |  |  | PCE |  |  | 0 |  | 0
DC-LB0003 | Label, Hobbed Bolt |  |  | PCE |  |  | 0 |  | 0
DC-LB0004 | Label, Budaschnozzle 1.1 threaded extension |  |  | PCE |  |  | 0 |  | 0
DC-LB0005 | 2 x 2" D.O.T. Labels - "Right to Know" |  |  | PCE |  |  | 0 |  | S-2845
DC-LB0006 | Label, Lulzbot TAZ 2.0 Barcode |  |  | PCE |  |  | 0 |  | 0
DC-LB0007 | Label, Top of Box |  |  | PCE |  |  | 0 |  | 0
DC-LB0008 | 2 x 2" D.O.T. Labels - "Right to Know", single label |  |  | PCE |  |  | 0 |  | 0
DC-LB0009 | 1", "Made In USA" Labels 500/roll |  |  | PCE |  |  | 0 |  | S-17021
DC-LB0010 | 3X5 DELICATE INSTRUMENTS LBL 500/RL |  |  | PCE |  |  | 0 |  | S-3005
DC-LB0011 | Flame Labels - "Hot", 1 1⁄2 x 2" |  |  | PCE |  |  | 0 |  | S-248
DC-LB0012 | 14035T23 Hazardous Material Sign, NFPA Diamond Style, 5" X5", Adhesive-Backed Vinyl |  |  | PCE |  |  | 0 |  | 14035T23
DC-LB0013 | Hazardous Material Sign, NFPA Diamond, 10-1/2" x 10-1/2", Adhesive-Back Vinyl |  |  | PCE |  |  | 0 |  | 14035T25
DC-LB0014 | TAZ v3.1 serial number sticker |  |  | PCE |  |  | 0 |  | 0
DC-LB0015 | 24VDC sticker |  |  | PCE |  |  | 0 |  | 0
DC-LB0016 | TAZ v3.1 bar code and serial number sticker |  |  | PCE |  |  | 0 |  | 0
DC-LB0017 | Label, Extruder E-Step Number, Avery 1/2 x 3/4 |  |  | PCE |  |  | 0 |  | 112797
DC-LB0018 | TAZ v4.0 serial number sticker |  |  | PCE |  |  | 0 |  | 0
DC-LB0019 | Label, 12VDC Extrusion Fan |  |  | PCE |  |  | 0 |  | 0
DC-LB0020 | Label, 24VDC Extrusion Fan |  |  | PCE |  |  | 0 |  | 0
DC-LB0021 | 1" Circle Inventory Control Labels - "Inspected by _____" roll 500 |  |  | PCE |  |  | 0 |  | S-13119
DC-LB0022 | 2" Circle Inventory Control Labels - "QC Rejected" roll 500 |  |  | PCE |  |  | 0 |  | S-5914
DC-LB0023 | 1" Circle Inventory Control Labels - "QC Passed" Roll 500 |  |  | PCE |  |  | 0 |  | S-13118
DC-LB0024 | Label, Bottom of Box |  |  | PCE |  |  | 0 |  | 0
DC-LB0025 | TAZ v4.1 serial number sticker |  |  | PCE |  |  | 0 |  | 0
DC-LB0026 | Label, Lulzbot TAZ 4.1 Barcode |  |  | PCE |  |  | 0 |  | 0
DC-LB0027 | KITTAZ Labels Complete Set |  |  | PCE |  |  | 0 |  | 0
DC-LB0028 | Label, Lulzbot Mini Barcode |  | 0 | PCE | 0.14 | 0 | 0 | The print shop of loveland | 0 | 0 | 0 | 0 | 0 | 0 | 0 | 0
DC-LB0029 | Mini v1 serial number sticker |  | 0 | PCE | 0.014 | 0 | 0 | The print shop of loveland | 0 | 0 | 0 | 0 | 0 | 0 | 0 | 0
DC-LB0030 | "CE" Regulated Label - 1 x 1" |  |  | PCE |  |  | 0 |  | S-13827
DC-LB0031 | TAZ v5.0 serial number sticker, KT-PR0017NA |  |  | PCE |  |  | 0 |  | 0
DC-LB0032 | Label, Lulzbot TAZ 5.0 Barcode, KT-PR0017NA |  |  | PCE |  |  | 0 |  | 0
DC-LB0033 | TAZ v5.0 serial number sticker, KT-PR0017EU |  |  | PCE |  |  | 0 |  | 0
DC-LB0034 | Label, Lulzbot TAZ 5.0 Barcode, KT-PR0017EU |  |  | PCE |  |  | 0 |  | 0
DC-LB0035 | TAZ v5.0 serial number sticker, KT-PR0017AU |  |  | PCE |  |  | 0 |  | 0
DC-LB0036 | Label, Lulzbot TAZ 5.0 Barcode, KT-PR0017AU |  |  | PCE |  |  | 0 |  | 0
DC-LB0037 | FCC Sticker, Blank |  |  | PCE |  |  | 0 |  | 0
DC-LB0038 | FCC Sticker, KT-PR0035-**** |  |  | PCE |  |  | 0 |  | 0
DC-LB0039 | Label, LulzBot TAZ Single Extruder Tool Head v2, 0.35 Nozzle |  |  | PCE |  |  | 0 |  | 0
DC-LB0040 | Label, Lulzbot Mini Barcode, NA |  |  | PCE |  |  | 0 |  | 0
DC-LB0041 | Label, Lulzbot Mini Barcode, EU |  |  | PCE |  |  | 0 |  | 0
DC-LB0042 | Label, Lulzbot Mini Barcode, AU |  |  | PCE |  |  | 0 |  | 0
DC-LB0043 | Mini v1 serial number sticker, NA |  |  | PCE |  |  | 0 |  | 0
DC-LB0044 | Mini v1 serial number sticker, EU |  |  | PCE |  |  | 0 |  | 0
DC-LB0045 | Mini v1 serial number sticker, AU |  |  | PCE |  |  | 0 |  | 0
DC-LB0046 | FCC-CE-RSF-Colorado Made 3" x 3" B&W Sticker |  |  | PCE |  |  | 0 |  | Custom Part
DC-LB0047 | TAZ v5.0 serial number sticker, KT-PR0036NA |  |  | PCE |  |  | 0 |  | 0
DC-LB0048 | Label, Lulzbot TAZ 5.0 Barcode, KT-PR0036NA |  |  | PCE |  |  | 0 |  | 0
DC-LB0049 | TAZ v5.0 serial number sticker, KT-PR0036EU |  |  | PCE |  |  | 0 |  | 0
DC-LB0050 | Label, Lulzbot TAZ 5.0 Barcode, KT-PR0036EU |  |  | PCE |  |  | 0 |  | 0
DC-LB0051 | TAZ v5.0 serial number sticker, KT-PR0036AU |  |  | PCE |  |  | 0 |  | 0
DC-LB0052 | Label, Lulzbot TAZ 5.0 Barcode, KT-PR0036AU |  |  | PCE |  |  | 0 |  | 0
DC-LB0053 | Label, LulzBot TAZ Flexystruder Tool Head v2, 0.6 Nozzle |  |  | PCE |  |  | 0 |  | 0
DC-LB0054 | TAZ v5.0 serial number sticker, KT-PR0036NA |  |  | PCE |  |  | 0 |  | 0
DC-LB0055 | Label, Lulzbot TAZ 5.0 Barcode, KT-PR0036NA |  |  | PCE |  |  | 0 |  | 0
DC-LB0056 | TAZ v5.0 serial number sticker, KT-PR0036EU |  |  | PCE |  |  | 0 |  | 0
DC-LB0057 | Label, Lulzbot TAZ 5.0 Barcode, KT-PR0036EU |  |  | PCE |  |  | 0 |  | 0
DC-LB0058 | TAZ v5.0 serial number sticker, KT-PR0036AU |  |  | PCE |  |  | 0 |  | 0
DC-LB0059 | Label, Lulzbot TAZ 5.0 Barcode, KT-PR0036AU |  |  | PCE |  |  | 0 |  | 0
DC-LB0060 | Tool head ID label, TAZ 5 0.5mm Nozzle |  |  | PCE |  |  | 0 |  | 0
DC-LB0061 | FCC_CE_ROHS_OSHW_RYF_CO_Made_Sticker_4" x3" |  |  | PCE |  |  | 0 |  | Custom Part
DC-LB0062 | Clam Knife Sheath Sticker - Caution Sharp Blade! (1"x2.5" Rectangle) | Buy |  | PCE | $0.04 | Sticker Giant |  | Sticker Giant |  |  | Received 5,700
DC-LB0063 | Modification Warning Insert Modification 2.75 x 8.5 on 100 lb. Astrobright Lift Off Lemon Very Bright | Buy |  | PCE | $0.07 | The Print shop of Loveland |  | The Print shop of Loveland |  |  | Received 3,050
DC-LB0064 | Hexagon Hot End Retail Box Label |  |  | PCE |  |  | 0 |  | 0
DC-LB0065 | Hexagon Hot End Retail Box Label, 0.35mm |  |  | PCE |  |  | 0 |  | 0
DC-LB0066 | Hexagon Hot End Retail Box Label, 0.50mm |  |  | PCE |  |  | 0 |  | 0
DC-LB0067 | Hexagon Hot End Retail Box Label, 0.60mm |  |  | PCE |  |  | 0 |  | 0
DC-LB0068 | Label, LulzBot TAZ Flexystruder Tool Head v2c, 0.6 Nozzle, Front |  |  | PCE |  |  | 0 |  | 0
DC-LB0069 | Label, LulzBot TAZ Flexystruder Tool Head v2c, 0.6 Nozzle, Back |  |  | PCE |  |  | 0 |  | 0
DC-LB0070 | Label, LulzBot Mini Flexystruder Tool Head v2, 0.6 Nozzle, Front |  |  | PCE |  |  | 0 |  | 0
DC-LB0071 | Label, LulzBot Mini Flexystruder Tool Head v2, 0.6 Nozzle, Back |  |  | PCE |  |  | 0 |  | 0
DC-LB0072 | Label, LulzBot TAZ Dual Extruder Tool Head v2c, 0.5 Nozzle, Front |  |  | PCE |  |  | 0 |  | 0
DC-LB0073 | Label, LulzBot TAZ Dual Extruder Tool Head v2c, 0.5 Nozzle, Back |  |  | PCE |  |  | 0 |  | 0
DC-LB0074 | Label, LulzBot TAZ FlexyDually Tool Head v2c, 0.6 Nozzle, Front |  |  | PCE |  |  | 0 |  | 0
DC-LB0075 | Label, LulzBot TAZ FlexyDually Tool Head v2c, 0.6 Nozzle, Back |  |  | PCE |  |  | 0 |  | 0
DC-LB0076 | LulzBot Mini Flexystruder v2 Serial Number Label |  |  | PCE |  |  | 0 |  | 0
DC-LB0077 | Tool head ID label, TAZ 5 0.35mm Nozzle |  |  | PCE |  |  | 0 |  | 0
DC-LB0078 | Label, LulzBot TAZ Single Extruder Tool Head v2c, 0.5 Nozzle, Front |  |  | PCE |  |  | 0 |  | 0
DC-LB0079 | Label, LulzBot TAZ Single Extruder Tool Head v2c, 0.5 Nozzle, Back |  |  | PCE |  |  | 0 |  | 0
DC-LB0080 | Label, LulzBot TAZ Single Extruder Tool Head v2c, 0.35 Nozzle, Front |  |  | PCE |  |  | 0 |  | 0
DC-LB0081 | Label, LulzBot TAZ Single Extruder Tool Head v2c, 0.35 Nozzle, Back |  |  | PCE |  |  | 0 |  | 0
DC-LB0082 | LulzBot TAZ Flexystruder v2 Serial Number Label |  |  | PCE |  |  | 0 |  | 0
DC-LB0083 | LulzBot TAZ Dual Extruder v2 Serial Number Label |  |  | PCE |  |  | 0 |  | 0
DC-LB0084 | LulzBot TAZ FlexyDually v2 Serial Number Label |  |  | PCE |  |  | 0 |  | 0
DC-LB0085 | LulzBot TAZ Single Extruder 0.50noz v2c Serial Number Label |  |  | PCE |  |  | 0 |  | 0
DC-LB0086 | LulzBot TAZ Single Extruder 0.35noz v2c Serial Number Label |  |  | PCE |  |  | 0 |  | 0
DC-LB0087 | Lulzbot Mini topper "sign for Micro Center" |  |  | PCE |  |  | 0 |  | 0
DC-LB0088 | Lulzbot Taz 5, "sign for Micro Center" |  |  | PCE |  |  | 0 |  | 0
DC-LB0089 | Lulzbot ticket molding "for Micro Center" |  |  | PCE |  |  | 0 |  | 0
DC-LB0090 | Lulzbot Channel strip "for Micro Center" |  |  | PCE |  |  | 0 |  | 0
DC-LB0091 | Lulzbot Mini Fact Tag "for Micro Center" |  |  | PCE |  |  | 0 |  | 0
DC-LB0092 | Lulzbot Taz 5 Fact Tag "for Micro Center" |  |  | PCE |  |  | 0 |  | 0
DC-LB0093 | RCM certified for sales in Australia |  |  | PCE |  |  | 0 |  | 0
DC-LB0094 | Serial number label sheets (blank) 100/pk 105 up - 1.25" x 0.375" |  |  | PCE |  |  | 0 |  | 105 up - 1.25" x 0.375"
DC-LB0095 | LulzBot Logo Sticker, 3 - Inch | Buy |  | PCE | $0.21 | Sticker Giant |  | Sticker Giant |  |  | Received 3,150 pcs
DC-LB0096 | Tool head ID label, Mini 0.5mm Nozzle |  |  | PCE |  |  | 0 |  | 0
DC-LB0097 | TAZ v6.0 serial number sticker, KT-PR0041NA |  |  | PCE |  |  | 0 |  | 0
DC-LB0098 | Label, Lulzbot TAZ 6.0 Barcode, KT-PR0041NA |  |  | PCE |  |  | 0 |  | 0
DC-LB0099 | TAZ v6.0 serial number sticker, KT-PR0041EU |  |  | PCE |  |  | 0 |  | 0
DC-LB0100 | Label, Lulzbot TAZ 6.0 Barcode, KT-PR0041EU |  |  | PCE |  |  | 0 |  | 0
DC-LB0101 | TAZ v6.0 serial number sticker, KT-PR0041AU |  |  | PCE |  |  | 0 |  | 0
DC-LB0102 | Label, Lulzbot TAZ 6.0 Barcode, KT-PR0041AU |  |  | PCE |  |  | 0 |  | 0
DC-LB0104 | Tool Head Wiring Connector Alignment Label | Buy |  | PCE | $0.03 | Sticker Giant |  | Sticker Giant |  |  | Received 6,150
DC-LB0105 | Arrow Labels - Yellow, 1 x 3" 500/roll | Buy |  | PCE | $0.04 | Uline | S-13121 | Uline | S-13121 |  | Received 3,500
DC-LB0106 | TAZ 6 Inner Box Label #1 Contents |  |  | PCE | 0.0977 | Sticker Giant | 0 | Sticker Giant | 0
DC-LB0107 | TAZ 6 Inner Box Label #2, Contents |  |  | PCE | 0.0977 | Sticker Giant | 0 | Sticker Giant | 0
DC-LB0108 | Filament Samples Bag Label - TAZ 6 |  |  | PCE | 0.148 | Sticker Giant | 0 | Sticker Giant | 0
DC-LB0109 | Label, LulzBot TAZ Opah Tool Head v2c, 1.2 Nozzle, Front |  |  | PCE |  |  | 0 |  | 0
DC-LB0110 | Label, LulzBot TAZ Opah Tool Head v2c, 1.2 Nozzle, Back |  |  | PCE |  |  | 0 |  | 0
DC-LB0118 | Save your TAZ 6 Packaging Sticker |  |  | PCE | 0.1 | MaverickLabel | 0 | MaverickLabel | 0
DC-MN0000 | AO-100 User Manual |  |  | Each - OLD |  |  | 0 |  | 0
DC-MN0001 | AO-101 User Manual |  |  | PCE |  |  | 0 |  | 0
DC-MN0002 | Lulzbot-Taz Manual Print & Binding |  |  | PCE |  |  | 0 |  | 0
DC-MN0003 | Lulzbot-Taz User Manual |  |  | PCE |  |  | 0 |  | 0
DC-MN0004 | Quick Start Guide, Lulzbot |  |  | PCE |  |  | 0 |  | 0
DC-MN0005 | Lulzbot-Taz 2.0 User Manual |  |  | PCE |  |  | 0 |  | 0
DC-MN0006 | Lulzbot-Taz 2.1 User Manual |  |  | PCE |  |  | 0 |  | 0
DC-MN0007 | Lulzbot-Taz 3.0 User Manual |  |  | PCE |  |  | 0 |  | 0
DC-MN0008 | Lulzbot-Taz 3.1 User Manual |  |  | PCE |  |  | 0 |  | 0
DC-MN0009 | Lulzbot-Taz 4.0 User Manual |  |  | PCE |  |  | 0 |  | 0
DC-MN0010 | Lulzbot-Taz 4.1 User Manual |  |  | PCE |  |  | 0 |  | 0
DC-MN0011 | Getting Started Guide, TAZ 4 |  |  | PCE |  |  | 0 |  | 0
DC-MN0012 | Getting Started Guide, TAZ 5 |  |  | PCE |  |  | 0 |  | 0
DC-MN0013 | Lulzbot-Taz 5.0 User Manual |  |  | PCE |  |  | 0 |  | 0
DC-MN0014 | LulzBot Mini User Manual (PDF) |  |  | PCE |  |  | 0 |  | 0
DC-MN0015 | Lulzbot-TAZ 6.0 User Manual | Buy |  | PCE | $3.74 | Lightning Source |  | Lightning Source |  |  | Received 3,050
DC-MN0016 | Operating Guide, TAZ 6 | Buy |  | PCE | $1.07 |  |  | Color Pro Print |  |  | Received 3,050
DC-MN0017 | Unboxing Guide, TAZ 6 | Buy |  | PCE | $1.07 |  |  | Color Pro Print |  |  | Received 3,050
DC-MN0018 | FreeCAD: A Manual |  |  | PCE |  |  | 0 |  | 0
DC-MS0001 | Registration Card, AO-100 |  |  | PCE |  |  | 0 |  | 0
DC-MS0003 | AO-101 Unpacking Instructions |  |  | PCE |  |  | 0 |  | 0
DC-MS0004 | Quality checklist, TAZ 2.0 |  |  | PCE |  |  | 0 |  | 0
DC-MS0005 | Test/Acceptance record TAZ 2.0 |  |  | PCE |  |  | 0 |  | 0
DC-MS0006 | Forum Postcards |  |  | PCE |  |  | 0 |  | 0
DC-MS0007 | Packing List, TAZ 2.0 |  |  | PCE |  |  | 0 |  | 0
DC-MS0008 | AO-101 Printer Documentation |  |  | PCE |  |  | 0 |  | 0
DC-MS0009 | Brochure, Lulzbot Flyer |  |  | PCE |  |  | 0 |  | 0
DC-MS0010 | DVD Training 12: Blender for 3D Printing |  |  | PCE |  |  | 0 |  | 0
DC-MS0011 | New Product Introduction |  |  | PCE |  |  | 0 |  | 0
DC-MS0012 | Postcards |  |  | PCE |  |  | 0 |  | 0
DC-MS0013 | Product Flyers |  |  | PCE |  |  | 0 |  | 0
DC-MS0014 | Quality checklist, TAZ 3.1 |  |  | PCE |  |  | 0 |  | 0
DC-MS0015 | Test/Acceptance record TAZ 3.1 |  |  | PCE |  |  | 0 |  | 0
DC-MS0016 | Packing List, TAZ 3.1 |  |  | PCE |  |  | 0 |  | 0
DC-MS0017 | TAZ 3 unpacking instructions, #1 |  |  | PCE |  |  | 0 |  | 0
DC-MS0018 | TAZ 3 set up instructions, #2 |  |  | PCE |  |  | 0 |  | 0
DC-MS0019 | TAZ 3 quick print instructions, #3 |  |  | PCE |  |  | 0 |  | 0
DC-MS0020 | Test/Acceptance record TAZ 4.0 |  |  | PCE |  |  | 0 |  | 0
DC-MS0021 | Quality checklist, TAZ 4.0 |  |  | PCE |  |  | 0 |  | 0
DC-MS0022 | Packing List, TAZ 4.0 |  |  | PCE |  |  | 0 |  | 0
DC-MS0023 | Test/Acceptance record TAZ 4.1 |  |  | PCE |  |  | 0 |  | 0
DC-MS0024 | Quality checklist, TAZ 4.1 |  |  | PCE |  |  | 0 |  | 0
DC-MS0025 | Packing List, TAZ 4.1 |  |  | PCE |  |  | 0 |  | 0
DC-MS0026 | KITTAZ 4 Page Packing List |  |  | PCE |  |  | 0 |  | 0
DC-MS0027 | KITTAZ Insert |  |  | PCE |  |  | 0 |  | 0
DC-MS0028 | Packing List, Mini 1.0 |  | 0 | PCE | 0.24 | 0 | 0 | The print shop of loveland | 0 | 0 | 0 | 0 | 0 | 0 | 0 | 0
DC-MS0029 | Quality assurance record Mini 1.0 |  | 0 | PCE | 0.72 | 0 | 0 | The print shop of loveland | 0 | 0 | 0 | 0 | 0 | 0 | 0 | 0
DC-MS0030 | Lulzbot Mini Poster |  | 0 | PCE | 0.75 | 0 | 0 | The print shop of loveland | 0 | 0 | 0 | 0 | 0 | 0 | 0 | 0
DC-MS0031 | Warning sheet, Mini |  | 0 | PCE | 0.07 | 0 | 0 | The print shop of loveland | 0 | 0 | 0 | 0 | 0 | 0 | 0 | 0
DC-MS0032 | Quick start guide, Mini |  | 0 | PCE | 0.95 | 0 | 0 | Citizen Printing | 0 | 0 | 0 | 0 | 0 | 0 | 0 | 0
DC-MS0033 | EC Declaration of Conformity, Mini v1.0 |  | 0 | PCE | 0.114 | 0 | 0 | The print shop of loveland | 0 | 0 | 0 | 0 | 0 | 0 | 0 | 0
DC-MS0034 | Test/Acceptance record TAZ 5.0 |  |  | PCE |  |  | 0 |  | 0
DC-MS0035 | Quality checklist, TAZ 5.0 |  |  | PCE |  |  | 0 |  | 0
DC-MS0036 | Packing List, TAZ 5.0 |  |  | PCE |  |  | 0 |  | 0
DC-MS0037 | Colorado Made Green Sticker |  |  | PCE |  |  | 0 |  | 0
DC-MS0038 | Lulzbot Mini Promo Postcard |  |  | PCE |  |  | 0 |  | 0
DC-MS0039 | Lulzbot MINI Brochure |  |  | PCE |  |  | 0 |  | 0
DC-MS0040 | TAZ 4, One Pager (Brochure and Specs) |  |  | PCE |  |  | 0 |  | 0
DC-MS0041 | EC Declaration of Conformity, TAZ v5.0 |  |  | PCE |  |  | 0 |  | 0
DC-MS0042 | TAZ 5, One Pager (Brochure and Specs) |  |  | PCE |  |  | 0 |  | 0
DC-MS0043 | Vinyl Lulzbot Wall Graphic, 4/0, contour cut, 24 x 30 White # 3M Control Tac IJ180 CV3 Matte , high resolution ink jet on 1 side |  |  | PCE |  |  | 0 |  | DC-MS0043
DC-MS0044 | LulzBot Give-Away Banner v2 |  |  | PCE |  |  | 0 |  | 0
DC-MS0045 | LulzBot_Give-Away_Banner_Final |  |  | PCE |  |  | 0 |  | 0
DC-MS0046 | Warning sheet, TAZ |  |  | PCE |  |  | 0 |  | 0
DC-MS0047 | v2 - CONGRATULATIONS!- Tool Head Instruction Card |  |  | PCE |  |  | 0 |  | 0
DC-MS0048 | TAZ 1 Page Brochure v. 3.1 |  |  | PCE |  |  | 0 |  | 0
DC-MS0049 | Test/Acceptance record TAZ 6.0 | Buy |  | PCE | $0.31 | 2 SIDED |  | The Print shop of Loveland |  |  | Received 3,050
DC-MS0050 | Packing List, TAZ 6.0 | Buy |  | PCE | $0.15 |  |  | The Print shop of Loveland |  |  | Received 3,050
DC-MS0051 | EC Declaration of Conformity, TAZ 6.0 | Buy |  | PCE | $0.15 |  |  | The Print shop of Loveland |  |  | Received 3,050
DC-MS0052 | Safety Warnings sheet, TAZ 6.0 | Buy |  | PCE |  |  |  | The Print shop of Loveland |  |  | Received 3,050
DC-MS0053 | LulzBot Give-Away Banner |  |  | PCE |  |  | 0 |  | 0
DC-MS0054 | Firmware Update Warning Cards |  |  | PCE |  |  | 0 |  | 0
DC-MS0055 | TAZ 6 One-Page Flyers |  |  | PCE |  |  | 0 |  | 0
DC-MS0056 | Frosted Vinyl Applique Sticker |  |  | PCE |  |  | 0 |  | 0
DC-MS0057 | Mini One-Page Flyers |  |  | PCE |  |  | 0 |  | 0
EL-CA0001 | 6ft USB 2.0 A Male to B Male 28/24AWG Cable |  |  | PCE |  |  | 0 |  | ALE-0000133
EL-CA0002 | AC Power Cable w/ Bare End |  |  | PCE |  |  | 0 |  | ALE-0000132
EL-CA0003 | 1.5ft USB 2.0 A Male to A Male 28/24AWG Cable (Gold Plated) |  |  | PCE |  |  | 0 |  | 5441
EL-CA0004 | 15ft USB 2.0 A Male to A Male 28/24AWG Cable (Gold Plated) |  |  | PCE |  |  | 0 |  | 5445
EL-CA0005 | 1.5ft USB 2.0 A Male to B Male 28/24AWG Cable - (Gold Plated) |  |  | PCE |  |  | 0 |  | 5436
EL-CA0006 | 15ft USB 2.0 A Male to B Male 28/24AWG Cable (Gold Plated) |  |  | PCE |  |  | 0 |  | 5440
EL-CA0007 | 3ft USB 2.0 A Male to A Male 28/24AWG Cable (Gold Plated) |  |  | PCE |  |  | 0 |  | 5442
EL-CA0008 | 3ft USB 2.0 A Male to B Male 28/24AWG Cable - (Gold Plated) |  |  | PCE |  |  | 0 |  | 5437
EL-CA0009 | 6ft USB 2.0 A Male to A Male 28/24AWG Cable (Gold Plated) |  |  | PCE |  |  | 0 |  | 5443
EL-CA0010 | 10ft USB 2.0 A Male to B Male 28/24AWG Cable (Gold Plated) |  |  | PCE |  |  | 0 |  | 5439
EL-CA0011 | 10ft USB 2.0 A Male to Mini-B 5pin Male 28/24AWG Cable w/ Ferrite Core (Gold Plated) |  |  | PCE |  |  | 0 |  | 5449
EL-CA0012 | 100cm Length Wire K-type Thermocouple Sensor Probe Temperature 1M Cable New |  |  | PCE |  |  | 0 |  | 0
EL-CA0013 | Ativa® 3' High-Speed HDMI Cable, Black |  |  | PCE |  |  | 0 |  | 482038
EL-CA0014 | BNC to USB Video Converter Cable, 2M length |  |  | PCE |  |  | 0 |  | 51935
EL-CA0015 | CBL, MNG, PVC, 6' |  |  | PCE |  |  | 0 |  | 284410
EL-CA0016 | Flat Cables .050" 10C SHIELDED BLACK 28AWG STRANDED |  |  | ft |  |  | 0 |  | 517-3517/10
EL-CA0016 old | (Obsolete) Flat Cables .050" 10C SHIELDED BLACK 28AWG STRANDED |  |  | PCE |  |  | 0 |  | 517-3517/10
EL-CA0017 | HDMI cable for Raspberry Pi |  |  | PCE |  |  | 0 |  | 0
EL-CA0018 | Lot of Male to Male A/A USB cables |  |  | PCE |  |  | 0 |  | 0
EL-CA0019 | USB DATA CABLE |  |  | PCE |  |  | 0 |  | 0
EL-CA0020 | USB Extension Cable |  |  | PCE |  |  | 0 |  | 0
EL-CA0021 | AmazonBasics High-Speed HDMI Cable (6.5 Feet/2.0 Meters) - Supports Ethernet, 3D, and Audio Return [Newest Standard] |  |  | PCE |  |  | 0 |  | B003L1ZYYM
EL-CA0022 | Micro HDMI Low Profile Cable |  |  | PCE |  |  | 0 |  | 8818542
EL-CA0023 | 50ft Ultra Slim Series High Performance HDMI® Cable w/ RedMere® Technology |  |  | PCE |  |  | 0 |  | 9432
EL-CA0024 | 3FT 24AWG Cat5e 350MHz UTP Bare Copper Ethernet Network Cable - Black, 2132 |  |  | PCE |  |  | 0 |  | 2132
EL-CA0025 | 7FT 24AWG Cat5e 350MHz UTP Bare Copper Ethernet Network Cable - Black, 2139 |  |  | PCE |  |  | 0 |  | 2139
EL-CA0026 | 14FT 24AWG Cat5e 350MHz UTP Bare Copper Ethernet Network Cable - Black, 2145 |  |  | PCE |  |  | 0 |  | 2145
EL-CA0027 | 20FT 24AWG Cat5e 350MHz UTP Bare Copper Ethernet Network Cable - Black, 4984 |  |  | PCE |  |  | 0 |  | 4984
EL-CA0028 | 25FT 24AWG Cat5e 350MHz UTP Bare Copper Ethernet Network Cable - Black, 2151 |  |  | PCE |  |  | 0 |  | 2151
EL-CA0029 | 10FT 24AWG Cat5e 350MHz UTP Bare Copper Ethernet Network Cable - Black, 3384 |  |  | PCE |  |  | 0 |  | 3384
EL-CA0030 | North American - 6ft 18AWG Power Cord Cable w/ 3 Conductor PC Power Connector Socket (C13/5-15P) - Black, 5279, Box of 125 |  | 0 | PCE | 1.1 | 0 | 0 | Linvox | 5279 | 5279 | 0 | 0 | 0 | 0 | 0 | 0
EL-CA0031 | 6ft 18AWG England Power Cord Cable - H05VV-F NEMA C13 - Black , Box of 75 |  | 0 | PCE | 0 | 0 | 0 | Linvox | 7691 | 7691 | confirmed | 0 | 0 | 0 | 0 | 0
EL-CA0032 | 6ft 18AWG European Power Cord Cable - H05VV-F NEMA C13 - Black order in 125 qty boxes |  | 0 | PCE | 0 | 0 | 0 | Linvox | 7692 | 7692 | confirmed | 0 | 0 | 0 | 0 | 0
EL-CA0033 | 10ft 18AWG Power Cord Cable w/ 3 Conductor PC Power Connector Socket (C13/5-15P) - Black, 5280 |  |  | PCE |  |  | 0 |  | 5280
EL-CA0034 | 15ft 18AWG Power Cord Cable w/ 3 Conductor PC Power Connector Socket (C13/5-15P) - Black, 5281 |  |  | PCE |  |  | 0 |  | 5281
EL-CA0035 | CABLE 22AWG 2COND 300V 152M |  |  | PCE |  |  | 0 |  | T3008-152-ND
EL-CA0036 | Velcro Reusable Self-Gripping Cable Ties, 0.5 Inches x 8 Inches Long, Black, 100 Ties per Pack (91140) |  |  | PCE |  |  | 0 |  | 0
EL-CA0037 | 5FT 24AWG Cat5e 350MHz UTP Bare Copper Ethernet Network Cable - Black, 3375 |  |  | PCE |  |  | 0 |  | 0
EL-CA0038 | Patch Cord, Cat5E, 7 foot |  |  | PCE |  |  | 0 |  | 0
EL-CA0039 | Patch Cord, Cat5E, 10 foot |  |  | PCE |  |  | 0 |  | 0
EL-CA0040 | Patch Cord, Cat5E, 3 foot |  |  | PCE |  |  | 0 |  | 0
EL-CA0041 | C2G / Cables to Go 27329 WSB 2.0 A to Mini-B Cable, Black (1 Meter/3.28 Feet) |  |  | PCE |  |  | 0 |  | 0
EL-CA0042 | 50 Ft Power Extension Cable |  |  | PCE |  |  | 0 |  | 0
EL-CA0043 | Olimex Ribbon Cables / IDC Cables UEXT FEM-FEM REPLACEMENT CABLE |  |  | PCE |  |  | 0 |  | 909-CABLE-IDC40-15CM
EL-CA0044 | Olimex Specialized Cables USB TO SERIAL CABLE |  |  | PCE |  |  | 0 |  | 1188-1018-ND
EL-CA0045 | 1.5ft USB 2.0 A Male to Micro 5pin Male 28/28AWG Cable |  |  | PCE |  |  | 0 |  | 5137
EL-CA0046 | Panel Mount USB Cable - A Male to A Female |  |  | PCE |  |  | 0 |  | 908
EL-CA0047 | Panel Mount Ethernet Extension Cable |  |  | PCE |  |  | 0 |  | 909
EL-CA0048 | 1.5ft 28AWG High Speed HDMI® Cable w/Ferrite Cores - Black |  |  | PCE |  |  | 0 |  | 3872
EL-CA0049 | Serial Debug Cable for pcDuino |  |  | PCE |  |  | 0 |  | SERCAB_PCDUINO_O29
EL-CA0050 | 15ft 24AWG CL2 Standard HDMI® Cable Male to Female Extension - Black, 3344 |  |  | PCE |  |  | 0 |  | 3344
EL-CA0051 | 25ft 24AWG CL2 Standard HDMI® Cable Male to Female Extension - Black, 3345 |  |  | PCE |  |  | 0 |  | 3345
EL-CA0052 | 10ft 24AWG CL2 Silver Plated High Speed HDMI® Cable - Black, 3659 |  |  | PCE |  |  | 0 |  | 3659
EL-CA0053 | CABLE 40COND GRAY 25' RIBBON |  |  | PCE |  |  | 0 |  | AE40A-25-ND
EL-CA0054 | AmazonBasics High-Speed HDMI Cable - 3 Feet (0.9 Meter) - Supports Ethernet, 3D and Audio Return |  |  | PCE |  |  | 0 |  | RFQ442
EL-CA0055 | 7FT FLEXboot Series 24AWG Cat5e 350MHz UTP Bare Copper Ethernet Network Cable - Black, 11381 |  |  | PCE |  |  | 0 |  | 11381
EL-CA0056 | 6ft 18AWG Australian Power Cord Cable - H05VV-FNEMA C13 - Black, Box of 75 |  |  | PCE |  |  | 0 | Linvox | 7670
EL-CA0057 | Cable Assembly SMA STR Plug RG58 36" |  |  | PCE |  |  | 0 |  | ACX17236-ND
EL-CA0059 | 110A Probe Cable |  |  | PCE |  |  | 0 |  | 110A
EL-CA0060 | Cable Molded RG58/U 48" |  |  | PCE |  |  | 0 |  | 290-1012-ND
EL-CA0061 | Black Extension Cord, 14 Gauge Wire, 3' Long |  |  | PCE |  |  | 0 |  | 9581T21
EL-CA0062 | Black Extension Cord, 14 Gauge Wire, 6' Long |  |  | PCE |  |  | 0 |  | 5388K14
EL-CA0063 | 6ft Tripp Lite - USB 2.0 A/B Gold Device Cable Ferrite Chokes A Male B Male | Buy | YES | PCE | $2.89 | Trip Lite | U023-006 | EDC – Electronics Distributors Corporation | U023-006 | Tripplite U023-006 | Received 3,050
EL-CA0064 | Cable 2PR CPU SHLD PVC 22 AWG 50' |  |  | PCE |  |  | 0 |  | C1352-50-ND
EL-CA0065 | 3ft Passive HDMI Cable - Black |  |  | PCE |  |  | 0 |  | 11559
EL-CA0066 | 10FT 24AWG Cat5e 350MHz UTP Bare Copper Ethernet Network Cable - White |  |  | PCE |  |  | 0 |  | 3391
EL-CA0067 | Coboc CY-CAT5E-10-BK 10ft.24AWG Snagless Cat 5e Black Color 350MHz UTP Ethernet Stranded Copper Patch cord /Molded Network lan C |  |  | PCE |  |  | 0 |  | N82E16812422007
EL-CA0068 | 1.5 Feet USB 2.0 Extender Cable - A Male to A Female 28/24AWG Extension Gold Plated (Black) |  |  | PCE |  |  | 0 |  | B00GCG94WG
EL-CA0069 | 15ft USB 2.0 A Male to Micro 5pin Male 28/24 AWG Cable w/Ferrite Core (Gold Plated) |  |  | PCE |  |  | 0 |  | 5460
EL-CA0070 | 15ft. USB 2.0 A Male to Mini - B 5pin Male 28/24 AWG Cable w/Ferrite Core (Gold Plated) |  |  | PCE |  |  | 0 |  | 5450
EL-CA0071 | Plantronics APD-80 CS500/SAVI EHS For Grandstream |  |  | PCE |  |  | 0 |  | 87327-01
EL-CA0072 | 10ft USB Cable 2.0 EXT 3M Gold, A Male to A Female |  |  | PCE |  |  | 0 |  | TL383-ND
EL-CA0073 | Belden 1310A 010U500 Multi-Conductor Cables 14AWG 4C UNSHLD, BLACK |  |  | mm |  |  | 0 |  | 1310A 010U500
EL-CA0073- old | OLD - Multi-Conductor Cables 14AWG 4C UNSHLD 500ft BOX BLACK |  |  | PCE |  |  | 0 |  | 566-1310A-U500-10
EL-CA0074 | AmazonBasics High-Speed HDMI Cable 2-Pack - 3 Feet |  |  | PCE |  |  | 0 |  | B00L3KNY22
EL-CA0075 | Monoprice 109767 3-Feet 3.5mm Stereo Male to RCA Stereo Male Gold Plated Cable for Mobile, Black |  |  | PCE |  |  | 0 |  | 109767 or B00AJHBES6
EL-CA0076 | Ativa® 6' High-Speed HDMI Cable Kit, Black |  |  | PCE |  |  | 0 |  | 443149
EL-CA0077 | ONN miniHDMI to HDMI Cable, 3', Black |  |  | PCE |  |  | 0 |  | 68113107335
EL-CA0078 | Flat Cables .050" 10C 10 COLOR 28AWG STRANDED 2x180mm | Buy |  | mm | $0.25 | TE Connectivity AMP Connectors | 3302/10-300 | TTI | 517-3302/10-300 |  | Received 3,900ft
EL-CA0079 | Electop USB 2.0 A Female To 2 Dual USB Male Jack Y Splitter Charger Cable |  |  | PCE |  |  | 0 |  | 0
EL-CA0080 | 6ft 16 AWG 1-to-2 Power Cord Splitter (NEMA 5-15P to 1 NEMA 5-15R + 1 IEC320C13) |  |  | PCE |  |  | 0 |  | 29812
EL-CA0081 | Cable Matters Micro USB SlimPort (MyDP) to HDMI 6 Foot Cable with 6 Foot USB Charging Cable |  |  | PCE |  |  | 603002 |  | 603002
EL-CA0082 | 6ft Japan NEMA 5-15P 3-pin to C13 Power Cord with VCTF 0.75mm, Black (Box of 100) | Buy |  | PCE | $1.14 | Linvox | 3271VF76 | Linvox | 3271VF76 |  | **BOM change needed N America EL-CA0030 PO15769 KG We do not need this Japan cord,
EL-FA0001 | 40mm Fan, 5.75 CFM |  |  | PCE |  |  | 0 |  | UM40FAN
EL-FA0002 | FAN DC 40X10.5MM 12V 6.7CFM |  |  | PCE |  |  | 0 |  | 1053-1205-ND
EL-FA0004 | 12vDC Fan 40mm |  |  | PCE |  |  | 0 |  | TF4010-12H-S
EL-FA0005 | Brushless DC Cooling Fan 5V or 12V 24V 4010S Blades 40x40x10mm Sleeve-bearing |  |  | PCE |  |  | 0 |  | 0
EL-FA0006 | Fan, 12VDC |  |  | PCE |  |  | 0 |  | ME40101V1-000U-A99
EL-FA0007 | Fan 40x10mm, 5 VDC 0.9Wm 7.0 cfm |  |  | PCE |  |  | 0 |  | 25-1565-ND
EL-FA0008 | FAN 40X20MM 12VDC 1.38W 10.8CFM |  |  | PCE |  |  | 0 |  | 259-1630-ND
EL-FA0009 | Fans & Blowers 40mm 24VDC 6.8CFM |  |  | PCE |  |  | 0 |  | 664-D4010HX-G70-LF
EL-FA0010 | Link Depot FAN-4LED-80BU 80mm |  |  | PCE |  |  | 0 |  | 0
EL-FA0011 | 69829 FAN,24VDC,Sleeve,5.75CFM,40X40X10MM,60mA |  | 0 | PCE |  |  | TF4010-24H-S |  | 69829 - TF4010-24H-S
EL-FA0012 | 69866 FAN,24VDC,BALL,31.60CFM,80×80×15 MM,100mA |  | 0 | PCE |  |  | TF8015-24M-B |  | 69866 - TF8015-24M-B
EL-FA0013 | FAN DC 40X10.5MM 12V 5.7CFM |  |  | PCE |  |  | 0 |  | TF4010-12H-S
EL-FA0014 | FAN DC 40X10.5MM 24V 6.7CFM |  |  | PCE |  |  | 0 |  | 1053-1210-ND
EL-FA0015 | 24V fan for add on kit w/ connector |  |  | PCE |  |  | 0 |  | 0
EL-FA0016 | 12V fan for add on kit w/ connector |  |  | PCE |  |  | 0 |  | 0
EL-FA0017 | TAZ 24V Extruder Fan Add-on Kit |  |  | PCE |  |  | 0 |  | 0
EL-FA0018 | TAZ 12V Extruder Fan Add-on |  |  | PCE |  |  | 0 |  | TF4010-12H-S
EL-FA0019 | BLOWER 12VDC 51.6 X 51.6 X 15MM |  |  | PCE |  |  | 0 |  | 259-1316-ND
EL-FA0020 | RFB2008 Micro Blower with 30awg wire that is 250mm long |  | 0 | PCE | 6.54 | 0 | 0 | Pelonis | RFB2008 | 0 | 0 | 0 | 0 | 0 | 0 | 0
EL-FA0021 | BLOWER DC 24V 51X15 6500RPM |  |  | PCE |  |  | 0 |  | 603-1116-ND
EL-FA0022 | FAN 12VDC 30X10MM 3.5CFM |  |  | PCE |  |  | 0 |  | 259-1615-ND
EL-FA0023 | 30x30x10mm 24v DC Fan |  |  | PCE |  |  | 0 |  | 0
EL-FA0024 | RFB2008 Micro Blower, 5.5v Retail (DO Not Use - See KT-CP0082) |  |  | PCE |  |  | 0 |  | 0
EL-FA0025 | FAN 24VDC 40X40X10 Crimped Retail |  |  | PCE |  |  | 0 |  | TF4010-24H-S
EL-FA0026 | FAN 12vDC 80x80x15 Crimped Retail |  |  | PCE |  |  | 0 |  | TF8015-24M-B
EL-FA0027 | RFB2008 Micro Blower, 5.5v Crimped RMAs |  |  | PCE |  |  | 0 |  | 0
EL-FA0028 | Computer Fans - System 76 |  |  | PCE |  |  | 0 |  | 0
EL-FA0029 | FAN AXIAL 40X10MM VAPO 5VDC WIRE |  |  | PCE |  |  | 0 |  | 259-1565-ND
EL-FA0030 | Dual blower harness for v2.0 dual extruders |  |  | PCE |  |  | 0 |  | 0
EL-FA0031 | Dual 40mm fan harness for v2.0 dual extruders |  |  | PCE |  |  | 0 |  | 0
EL-FA0032 | Pelonis FAN 24V 40mmx40mmx10mm Low flow | Buy | YES | PCE | $3.13 | Pelonis | C4010L24BPLB1b-7 | Pelonis | C4010L24BPLB1b-7 |  | Received 6,200 pc
EL-FA0033 | Pelonis FAN 24V 80x80x15mm Low flow | Buy | YES | PCE | $3.12 | Pelonis | C8015L24BPLP1b-7 | Pelonis | C8015L24BPLP1b-7 |  | Received Shipping via air from China on 7/29/16.
EL-FA0034 | Pelonis FAN 5V 40x40x10mm Low flow | Buy | YES | PCE | $3.07 | Pelonis | C4010L05BPLB1b-7 | Pelonis | C4010L05BPLB1b-7 |  | Received 3,100 pc
EL-FA0035 | Pelonis FAN 24V 40x10mm Medium flow |  |  | PCE |  |  | 0 |  | C4010M24BPLP1b-7
EL-FA0036 | TAZ 6 CB Case Fan Assembly v1.0 |  |  | PCE |  |  | 0 |  | 0
EL-FA0037 | 963E Benchtop Air Ionizer w / North America Power Cord (US/MX only) |  |  | PCE |  |  | 963E |  | 00051135329573-31196
EL-FA0038 | EBM-PAPST FAN AXIAL 40X10MM 24VDC WIRE 414FH |  |  | PCE |  |  | 414FH |  | 381-2367-ND
EL-FA0039 | ORION FAN AXIAL 40X10MM 24VDC WIRE OD4010-24HSS |  |  | PCE |  |  | OD4010-24HSS |  | 1053-1210-ND
EL-FA0040 | ORION FAN AXIAL 40X10.5MM 24VDC WIRE - OD4010-24HB |  |  | PCE |  |  | OD4010-24HB |  | 1053-1208-ND
EL-FA0041 | ORIX MDS410-24, DC Axial Fan |  |  | PCE |  |  | MDS410-24 |  | MDS410-24
EL-FA0044 | Pelonis FAN 80x80x15 Medium flow |  |  | PCE |  |  | C8015M24BPLP1b-7 |  | C8015M24BPLP1b-7
EL-FA0045 | Pelonis FAN 80x80x15 High flow |  |  | PCE |  |  | C8015H24BPLP1b-7 |  | C8015H24BPLP1b-7
EL-FA0046 | LiteWorld Protective Enclosure: Additional Fan |  |  | PCE |  |  | 0 |  | 0
EL-HB0000 | 5 RepRap PCB heated beds, Out of Spec |  |  | PCE |  |  | 0 |  | 0
EL-HB0001 | Flexible Silicone-Rubber Heat Sheet Plain Backing, 6" X 6" Sheet, Med Watts/SQ Inch |  |  | PCE |  |  | 0 |  | 35765K51
EL-HB0002 | Heated Bed Kit |  |  | PCE |  |  | 0 |  | 0
EL-HB0003 | Low watts, Flexible Silicone-rubber Heat Sheet Plain backing, 10" x 10" sheet |  |  | PCE |  |  | 0 |  | 35765k512
EL-HB0004 | Med Watts, Flexible Silicone-rubber Heat Sheet Plain Backing, 10" X 10" sheet |  |  | PCE |  |  | 0 |  | 35765K513
EL-HB0005 | PCB Heatbed MK1 - soldered power wires |  |  | PCE |  |  | 0 |  | 0
EL-HB0006 | PCB Heatbed MK1 - soldered power wires and thermistor |  |  | PCE |  |  | 0 |  | 0
EL-HB0007 | Silicone Heating Pads |  |  | PCE |  |  | 0 |  | 0
EL-HB0008 | Silicone Rubber Heater Mat w/ Thermistor 12"x12" |  |  | PCE |  |  | 0 |  | 0
EL-HB0009 | Silicone-Rubber Heat Sheet Plain Backing, 9" X 9" Sheet, Med Watts/SQ Inch |  |  | PCE |  |  | 0 |  | 35765K55
EL-HB0011 | TAZ 5 Heat Bed Kit |  |  | PCE |  |  | 0 |  | 0
EL-HR0000 | Servo Y-Harness PCB |  |  | PCE |  |  | 0 |  | HH-SC_PCB_YH
EL-HR0001 | Thermistor Wire Harness |  |  | PCE |  |  | 0 |  | 0
EL-HR0002 | Y Opto Wire Harness, 470mm |  |  | PCE |  |  | 0 |  | 0
EL-HR0003 | X Opto Wire Harness, 680mm |  |  | PCE |  |  | 0 |  | 0
EL-HR0004 | Z Opto Wire Harness, 850mm |  |  | PCE |  |  | 0 |  | 0
EL-HR0006 | Heat bed extensions |  |  | PCE |  |  | 0 |  | 0
EL-HR0007 | Heat bed wiring assembly |  |  | PCE |  |  | 0 |  | 0
EL-HR0009-2 | Y switch extension short, TAZ |  |  | PCE |  |  | 0 |  | 0
EL-HR0010-2 | X switch extension short, TAZ |  |  | PCE |  |  | 0 |  | 0
EL-HR0011 | Jumper wire yellow |  |  | PCE |  |  | 0 |  | 0
EL-HR0012 | Jumper wire red |  |  | PCE |  |  | 0 |  | 0
EL-HR0014 | Power thru case assembly |  |  | PCE |  |  | 0 |  | 0
EL-HR0017-1 | Motor extension -1 |  |  | PCE |  |  | 0 |  | 0
EL-HR0017-2 | Motor extension -2 |  |  | PCE |  |  | 0 |  | 0
EL-HR0017-3 | Motor extension -3 |  |  | PCE |  |  | 0 |  | 0
EL-HR0017-4 | Motor extension -4 |  |  | PCE |  |  | 0 |  | 0
EL-HR0018 | Endstop wire harness from Rambo kit |  |  | PCE |  |  | 0 |  | 0
EL-HR0019 | Switch Wires from RAMBo Kit |  |  | PCE |  |  | 0 |  | 0
EL-HR0020 | 24vDC Power supply assembly |  |  | PCE |  |  | 0 |  | 0
EL-HR0021 | Power through case assembly, TAZ |  |  | PCE |  |  | 0 |  | 0
EL-HR0022 | Heat bed extension assembly, #6 |  |  | PCE |  |  | 0 |  | 0
EL-HR0023 | Y extension assembly, #5 |  |  | PCE |  |  | 0 |  | 0
EL-HR0024 | Budaschnozzle extension, 1300mm |  |  | PCE |  |  | 0 |  | 0
EL-HR0025 | Print head extension, #4 |  |  | PCE |  |  | 0 |  | 0
EL-HR0026 | Z switch extension assembly, #1 |  |  | PCE |  |  | 0 |  | 0
EL-HR0027 | Z right motor extension assembly, #2 |  |  | PCE |  |  | 0 |  | 0
EL-HR0028 | X extension assembly, #3A |  |  | PCE |  |  | 0 |  | 0
EL-HR0029 | X switch extension assembly, #3B |  |  | PCE |  |  | 0 |  | 0
EL-HR0030 | AMP-3K TERMINATOR MACHINE RENTAL |  |  | PCE |  |  | 0 |  | 1725950-2
EL-HR0031 | ANVIL |  |  | PCE |  |  | 0 |  | 1333228-2
EL-HR0032 | ANVIL, COMBINATION (.055) |  |  | PCE |  |  | 0 |  | 1-1333201-1
EL-HR0033 | CRIMPER, INSULATION (.070) |  |  | PCE |  |  | 0 |  | 2-456135-2
EL-HR0034 | CRIMPER, INSUL O PREMIUM |  |  | PCE |  |  | 0 |  | 2119784.7
EL-HR0035 | CRIMPER, WIRE .062 F |  |  | PCE |  |  | 0 |  | 1-456403-2
EL-HR0036 | CRIMPER, WIRE .090 F |  |  | PCE |  |  | 0 |  | 4-456406-7
EL-HR0037 | FLOATING SHEAR |  |  | PCE |  |  | 0 |  | 454276-1
EL-HR0038 | FLOATING SHEAR |  |  | PCE |  |  | 0 |  | 462006-6
EL-HR0039 | HD-I 5SMPR055F070O BENCH RENTAL |  |  | PCE |  |  | 0 |  | 1426179-2
EL-HR0040 | INSERT, SHEAR |  |  | PCE |  |  | 0 |  | 2119806-1
EL-HR0041 | OC-AT-S-FM-062F120O-001-0212 RENTAL |  |  | PCE |  |  | 0 |  | 2151641-1
EL-HR0042 | OC-AT-S-FM-090F120O-001-0021 RENTAL |  |  | PCE |  |  | 0 |  | 2151101-1
EL-HR0043 | WORK LIGHT 110V |  |  | PCE |  |  | 0 |  | CRK-1003
EL-HR0044 | Short Motor Wires - 2 |  |  | PCE |  |  | 0 |  | 0
EL-HR0045 | Dual Extruder Wiring Harness - Pre-TAZ 4.0 |  |  | PCE |  |  | 0 |  | 0
EL-HR0046 | Fan add-on wiring harness |  |  | PCE |  |  | 0 |  | 0
EL-HR0049 | FINGER GUARD |  |  | PCE |  |  | 0 |  | CRK-420102105
EL-HR0050 | Enclosure Power Connector Assy |  |  | PCE |  |  | 0 |  | 0
EL-HR0051 | Power Connector Assy |  |  | PCE |  |  | 0 |  | 0
EL-HR0052 | Extruder Extension v2.1 |  |  | PCE |  |  | 0 |  | 0
EL-HR0053 | PS-GRD Wire v1.0, Pomfret |  |  | PCE |  |  | 0 |  | 0
EL-HR0054 | PP-GRD Wire v1.0, Pomfret |  |  | PCE |  |  | 0 |  | 0
EL-HR0055 | PP-SW Black Wire v1.0, Pomfret |  |  | PCE |  |  | 0 |  | 0
EL-HR0056 | PS-SW Black Wire v1.0, Pomfret |  |  | PCE |  |  | 0 |  | 0
EL-HR0057 | PS-SW White Wire v1.0, Pomfret |  |  | PCE |  |  | 0 |  | 0
EL-HR0058 | PP-SW White Wire v1.0, Pomfret |  |  | PCE |  |  | 0 |  | 0
EL-HR0059 | TAZ Extruder Pin Assignments v3.0 |  |  | PCE |  |  | 0 |  | 0
EL-HR0060 | TAZ Extruder Extension v3.0 |  |  | PCE |  |  | 0 |  | 0
EL-HR0061 | Extruder Extension Adapter v2c to v1/v2a |  |  | PCE |  |  | 0 |  | 0
EL-HR0062 | Extruder Extension Adapter v1/v2a to v2c |  |  | PCE |  |  | 0 |  | 0
EL-HR0063 | Extruder Extension Adapter v2c to v2b |  |  | PCE |  |  | 0 |  | 0
EL-HR0064 | External Blower Harness add-on |  |  | PCE |  |  | 0 |  | 0
EL-HR0066 | TAZ Extruder Pin Assignments v2.1 |  |  | PCE |  |  | 0 |  | 0
EL-HR0067 | TAZ Extruder Pin Assignments v2.0 |  |  | PCE |  |  | 0 |  | 0
EL-HR0068 | Mini Plug to Ground Post Extension |  | 0 | PCE | 0 | 0 | 0 | 0 | 0 | 0 | 0 | 0 | 0 | 0 | 0 | 0
EL-HR0069 | Mini PS to Ground Post Extension |  | 0 | PCE | 0 | 0 | 0 | 0 | 0 | 0 | 0 | 0 | 0 | 0 | 0 | 0
EL-HR0070 | X-Extruder-1 Assembly for Mini |  |  | PCE |  |  | 0 |  | 0
EL-HR0071 | Mini Ferrite-Jumper Extension |  |  | PCE |  |  | 0 |  | 0
EL-HR0072 | Hexagon Hot End Kit, Adapter Harness |  |  | PCE |  |  | 0 |  | 0
EL-HR0073 | Thermistor Assembly |  |  | PCE |  |  | 0 |  | 0
EL-HR0074 | DC Power Harness v1.0 TAZ 6 |  |  | PCE |  |  | 0 |  | 0
EL-HR0075 | X Harness External TAZ 6 |  |  | PCE |  |  | 0 |  | 0
EL-HR0076 | Taz 6 switch to PSU white |  |  | PCE |  |  | 0 |  | 0
EL-HR0077 | TAZ 6 switch to PSU black |  |  | PCE |  |  | 0 |  | 0
EL-HR0078 | TAZ 6 plug to ground green |  |  | PCE |  |  | 0 |  | 0
EL-HR0079 | TAZ 6 PSU to ground green |  |  | PCE |  |  | 0 |  | 0
EL-HR0080 | TAZ 6 plug to switch black and white with ferrite |  |  | PCE |  |  | 0 |  | 0
EL-HR0081 | TAZ 6 Bed Harness Internal |  |  | PCE |  |  | 0 |  | Q5-3X-3/4-01
EL-HR0082 | Bed power harness internal, TAZ 6 |  |  | PCE |  |  | 0 |  | 0
EL-HR0083 | Bed power harness external, TAZ 6 |  |  | PCE |  |  | 0 |  | 0
EL-HR0084 | TAZ 6, X Harness Internal |  |  | PCE |  |  | 0 |  | Q5-3X-3/4-01
EL-HR0085 | Shielded 24AWG harness for Moon's NEMA17 stepper, 640mm |  |  | PCE |  |  | 0 |  | 0
EL-HR0086 | Mini, Ferrite Motor Extension |  |  | PCE |  |  | 0 |  | 0
EL-HR0087 | TAZ 6, CB Extruder Harness Internal |  |  | PCE |  |  | 0 | CCX | FSD74-6
EL-HR0088 | TAZ 6, Y & Z Harness Internal |  |  | PCE |  |  | 0 | CCX | Q5-3X-3/4-01
EL-HR0089 | Taz 6, Bed harness extension |  |  | PCE |  |  | 0 |  | 0
EL-HR0090 | Taz 6, Bed harness external |  |  | PCE |  |  | 0 |  | 0
EL-HR0091 | Taz 6 Y & Z harness external |  |  | PCE |  |  | 0 |  | 0
EL-HR0092 | Taz 6, Extruder 0 harness external |  |  | PCE |  |  | 0 |  | 0
EL-HR0093 | Mini X-Motor Adapter, Moons' v1.0 |  |  | PCE |  |  | 4634140204390 |  | 4634140204390
EL-HR0094 | TAZ XY, Mini Y-Motor Adapter, Moons' v1.0 |  |  | PCE |  |  | 4634140204391 |  | 4634140204391
EL-HR0095 | Extruder Fan Harness TAZ 6, v0.1 |  |  | PCE |  |  | 0 |  | 0
EL-HR0096 | Extruder Motor-switch Harness TAZ 6, v0.1 |  |  | PCE |  |  | 0 |  | 0
EL-HR0097 | LCD Harness TAZ 6, v0.1 |  |  | PCE |  |  | 0 |  | 0
EL-HR0098 | TAZ 2-3pin Blower Adapter |  |  | PCE |  |  | 0 |  | 0
EL-HR0100 | Opah thermistor assembly v0.1 |  |  | PCE |  |  | 0 |  | 0
EL-HR0101 | Taz 6, CB extruder 1 harness |  |  | PCE |  |  | 0 |  | 0
EL-HR0102 | Mini Bed Harness Assembly - Gladiola |  | 0 | PCE | 0 | 0 | 0 | 0 | 0 | 0 | 0 | 0 | 0 | 0 | 0 | 0
EL-HR0104 | Mini Plug to SW Extension Harness Assembly - Gladiola |  |  | PCE |  |  | 0 |  | 0
EL-HR0106 | Mini PS to RAMBo Harness Assembly - Gladiola |  |  | PCE |  |  | 0 |  | 0
EL-HR0107 | Mini SW to PS Extension Harness Assembly - Gladiola |  |  | PCE |  |  | 0 |  | 0
EL-HR0108 | Mini X Extruder Harnesses Assembly - Gladiola |  | 0 | PCE | 0 | 0 | 0 | 0 | 0 | 0 | 0 | 0 | 0 | 0 | 0 | 0
EL-HR0109 | Finger Guard 80mm Plastic |  |  | PCE |  |  | 09080-G |  | CR282-ND
EL-HR0110 | Finger/ Filter Assembly 80mm Plastic 30ppl |  |  | PCE |  |  | 09325-F/30 |  | CR212-ND
EL-HR0111 | Fan Filter 80mm 45ppl |  |  | PCE |  |  | GRM80-45 |  | 1053-1394-ND
EL-HR0112 | Finger Guard 8mm Plastic |  |  | PCE |  |  | 09325-G |  | CR226-ND
EL-HR0113 | igus Bed Harness Cable Sub-Assembly - Gladiola |  |  | PCE |  |  | 0 |  | 0
El-HR0114 | Mini Bed Harness Completed Assembly - Gladiola |  |  | PCE |  |  | 0 |  | 0
EL-HR0115 | Mini XY Harness Assembly - Gladiola |  |  | PCE |  |  | 0 |  | 0
EL-HR0116 | Mini USB to Ground Harness |  |  | PCE |  |  | 0 |  | 0
EL-MS0001 | Female Connector Pins .1in Gold Terminals |  |  | PCE |  |  | 0 |  | HH-PT1IN_FT
EL-MS0002 | 1x4-pin Connector Housing |  |  | PCE |  |  | 0 |  | HH-PT1IN_1x4
EL-MS0003 | Male Connector Pins .1in Gold Terminals |  |  | PCE |  |  | 0 |  | HH-PT1IN_MT
EL-MS0004 | 1x2-pin Connector Housing |  |  | PCE |  |  | 0 |  | HH-PT1IN_1x2
EL-MS0005 | 1x3-pin Connector Housing |  |  | PCE |  |  | 0 |  | HH-PT1IN_1x3
EL-MS0006 | Power Cord with Three-Blade Plug, 18 Gauge Wire, NEMA 5-15 Plug, 6' 7" Long |  |  | PCE |  |  | 0 |  | 70355K76
EL-MS0007 | 22-18 AWG butt connector |  |  | PCE |  |  | 0 |  | 0
EL-MS0008 | Anderson-Heavy Duty Power Connectors HOUSING ONLY, BLACK-BULK POWERPOLE 15/45 | Buy |  | PCE | $0.19 | Anderson | 1327G6-BK | Sager | 879-1327G6-BK |  | received
EL-MS0009 | Wire Wrap, 1/4", 100' Length |  |  | cm |  |  | 0 |  | 7432K91
EL-MS0010 | Heavy Duty Power Connectors POWERPOLE 15A CONT | Buy |  | PCE | $0.10 | Anderson | 1332-BK | Sager | 879-1332-BK |  | received
EL-MS0011 | Wire Wrap, 1/2", 100' Length |  |  | cm |  |  | 0 |  | 7432K93
EL-MS0012 | Noninsulated Wire Ferrule, 24-20 AWG, .31" Pin Length | Buy |  | PCE | $0.06 | Phoenix Contact | 3202478 | Mcmaster | 9681K15 |  | Received 15,400
EL-MS0013 | Wire Ferrules, 18 AWG |  |  | PCE |  |  | 0 |  | 9681K17
EL-MS0014 | Noninsulated Wire Ferrule, 16 AWG, .28" Pin Length |  |  | PCE | 0.0625 |  | 0 | Mcmaster | 9681K21 | 0749648
EL-MS0015 | Terminal, quick disconnect, female 22-18 AWG |  |  | PCE |  |  | 0 |  | 538-19003-0107
EL-MS0016 | Wire Wrap, 1/4", 300mm |  |  | PCE |  |  | 0 |  | 0
EL-MS0017 | Wire Wrap, 1/4", 340mm |  |  | PCE |  |  | 0 |  | 0
EL-MS0018 | Wire Wrap, 1/4", 420mm |  |  | PCE |  |  | 0 |  | 0
EL-MS0019 | Wire Wrap, 1/2", 90mm |  |  | PCE |  |  | 0 |  | 0
EL-MS0020 | 1x5-pin Connector Housing |  |  | PCE |  |  | 0 |  | HH-PT1IN_1x5
EL-MS0021 | Universal Servo JR Connector Housings |  |  | PCE |  |  | 0 |  | HH-SC_UNH
EL-MS0022 | Universal Servo Connector Sleeves |  |  | PCE |  |  | 0 |  | HH-SC_UNS
EL-MS0023 | Futaba J Servo Connector Housings |  |  | PCE |  |  | 0 |  | HH-SC_FJH
EL-MS0024 | Futaba J Servo Connector Male Sleeves |  |  | PCE |  |  | 0 |  | HH-SC_FJS
EL-MS0025 | 1x1-pin Connector Housing |  |  | PCE |  |  | 0 |  | HH-PT1IN_1x1
EL-MS0026 | 1x6-pin Connector Housing |  |  | PCE |  |  | 0 |  | HH-PT1IN_1x6
EL-MS0027 | 1x7-pin Connector Housing |  |  | PCE |  |  | 0 |  | HH-PT1IN_1x7
EL-MS0028 | 1x8-pin Connector Housing |  |  | PCE |  |  | 0 |  | HH-PT1IN_1x8
EL-MS0029 | 1x9-pin Connector Housing |  |  | PCE |  |  | 0 |  | HH-PT1IN_1x9
EL-MS0030 | 1x10-pin Connector Housing |  |  | PCE |  |  | 0 |  | HH-PT1IN_1x10
EL-MS0031 | 2x2-pin Connector Housing |  |  | PCE |  |  | 0 |  | HH-PT1IN_2x2
EL-MS0032 | 2x3-pin Connector Housing |  |  | PCE |  |  | 0 |  | HH-PT1IN_2x3
EL-MS0033 | 2x4-pin Connector Housing |  |  | PCE |  |  | 0 |  | HH-PT1IN_2x4
EL-MS0034 | 2x5-pin Connector Housing |  |  | PCE |  |  | 0 |  | HH-PT1IN_2x5
EL-MS0035 | Gold Single Row Straight Header - 40 Pin |  |  | PCE |  |  | 0 |  | HH-PT1IN_SRSH40
EL-MS0036 | Gold Double Row Straight Header - 80 Pin |  |  | PCE |  |  | 0 |  | HH-PT1IN_SRSH80
EL-MS0037 | Gold Single Row Right Angle Header - 40 Pin |  |  | PCE |  |  | 0 |  | HH-PT1IN_SRRAH40
EL-MS0038 | Gold Double Row Right Angle Header - 80 Pin |  |  | PCE |  |  | 0 |  | HH-PT1IN_SRRAH80
EL-MS0039 | Servo Connector Female to Male Adapter |  |  | PCE |  |  | 0 |  | HH-PT1IN_SCFMA
EL-MS0040 | Gold Single Row Female to Male Adapter Header - 40 Pin |  |  | PCE |  |  | 0 |  | HH-PT1IN_SRFMA40
EL-MS0041 | Gold Double Row Female to Male Adapter Header - 80 Pin |  |  | PCE |  |  | 0 |  | HH-PT1IN_SRFMA80
EL-MS0042 | Servo Connector Three-Way Male / Y Adapter |  |  | PCE |  |  | 0 |  | HH-SC_3WM
EL-MS0043 | Hammond Mfg Enclosure, 1593HAMBONEBK, Beaglebone |  |  | PCE |  |  | 0 |  | 70313867
EL-MS0044 | 0.1" Servo Strip PCB |  |  | PCE |  |  | 0 |  | HH-SC_PCB_PT1INSS
EL-MS0045 | Universal Servo Connector Adapter PCB |  |  | PCE |  |  | 0 |  | HH-SC_PCB_USCA
EL-MS0046 | Universal 22 AWG 8" Servo Lead |  |  | PCE |  |  | 0 |  | HH-LEAD_DX22-08
EL-MS0047 | Connector 4 Pin Din Power |  |  | PCE |  |  | 0 |  | ALE-0000217
EL-MS0048 | Non-Insulated Crimp-on Wire Ferrule, 12 AWG, .35" Overall Length, Packs of 100 |  |  | PCE |  |  | 0 |  | 9681K28
EL-MS0049 | Non-Insulated Crimp-on Wire Ferrule, 14 AWG, .39" Overall Length, Packs of 100 |  |  | PCE |  |  | 0 |  | 9681K25
EL-MS0050 | Non-Insulated Crimp-on Wire Ferrule, 16 AWG, .28" Overall Length, Packs of 100 |  |  | PCE |  |  | 0 |  | 9681K21
EL-MS0051 | Non-Insulated Crimp-on Wire Ferrule, 24-22 AWG, .20" Overall Length, Packs of 100 |  |  | PCE |  |  | 0 |  | 9681K13
EL-MS0052 | Non-Insulated Crimp-on Wire Ferrule, 26-24 AWG, .20" Overall Length, Packs of 100 |  |  | PCE |  |  | 0 |  | 9681K11
EL-MS0053 | Hammond Manufacturing Strip, Power; 6; 6 ft.; UL Listed, CSA Certified; Metal; 6 ft. |  |  | PCE |  |  | 0 |  | 70175099
EL-MS0054 | ENCODER OPTICAL ROTARY 256 CPR |  |  | PCE |  |  | 0 |  | ENS1J-B28-L00256L-ND
EL-MS0055 | REPLICAPE |  |  | PCE |  |  | 0 |  | 0
EL-MS0056 | Rubber Static Control Work Surface Mat, 36" L X24" W X1-16" Thickness, Wrist Strap & Ground Kit, Blue |  |  | PCE |  |  | 0 |  | 4446T72
EL-MS0057 | Rubber Static Control Work Surface Mat, 48" L X24" W 1/16" Thickness, Wrist Strap & Ground Kit, Blue |  |  | PCE |  |  | 0 |  | 4446T74
EL-MS0058 | CONN PIN MALE 24-30AWG CRIMP TIN 20K REELS |  |  | PCE |  |  | 16-02-0108 |  | 1-66106-5
EL-MS0059 | Molex-CONN TERM FEMALE 22-24AWG TIN Reels of 20K | Buy |  | PCE | $0.01 | Molex | 16-02-0086 / 16-02-0102 | TTI | WM2510TR-ND | 16-02-0086 | received 442,250
EL-MS0060 | Conn, term, female, .187 Rohs comp, insulated |  |  | PCE |  |  | 0 |  | 534-8291
EL-MS0061 | Molex-CONN HOUSING MALE 4POS .100 | Buy |  | PCE | $0.12 | Molex | 701070003 | Sager | 701070003 | WM2535-ND | Received 3,050 pc
EL-MS0062 | MOLEX-CONN HOUSING 4POS .100 W/LATCH | Buy |  | PCE | $0.05 | Molex | 50579404 | Sager | ALE-0000191 | WM2902-ND | Received 18,300 pc
EL-MS0064 | TERM BLOCK 5.08MM VERT 3POS PCB |  |  | PCE |  |  | 0 |  | ED2581-ND
EL-MS0065 | Kingston 4 GB microSDHC Class 4 Flash Memory Card SDC4/4GBET |  |  | PCE |  |  | 0 |  | B00200K1TI
EL-MS0066 | Wire Ferrules, 24-20 AWG |  |  | PCE |  |  | 0 |  | 9681K17
EL-MS0067 | Wire Ferrules, 16 AWG |  |  | PCE |  |  | 0 |  | 9681K17
EL-MS0068 | Conn, Crimp, .250, 14-16AWG |  |  | PCE |  |  | 0 |  | 3-350820-2
EL-MS0069 | 48" x 500' 4 Mil Anti-Static Poly Sheeting Roll |  |  | PCE |  |  | 0 |  | S-13010
EL-MS0071 | Connector, 8 pin ribbon |  |  | PCE |  |  | 0 |  | 71600-308LF
EL-MS0072 | Ace 16-14 AWG Blue Insulated Ring Terminal - 100 Pack |  |  | PCE |  |  | 0 |  | 34542
EL-MS0073 | Tubing Corrugated Loom .25", Black, 3200' Box | Buy |  | ft | $0.00 | Panduit / Fastenal | 0708161 | EDC – Electronics Distributors Corporation | 708161 |  | Received 160000 ft
EL-MS0073 (obsolete) | Tubing Corrugated Loom .25" x 100' (obsolete) |  |  | PCE |  |  | 0 |  | CLT25F-C20 / 298-1141-ND
EL-MS0074 | Molex-CONN HOUSING 20POS .100 DUAL, BLACK | Buy |  | PCE | $0.56 | Molex | 22552201 | Sager | 22552201 | WM2527-ND | Received 3,050
EL-MS0075 | CONN HOUSING 8POS .100 DUAL, Black | Buy |  | PCE | $0.37 | Molex | 22552081 | Sager | 22552081 |  | Received 7,390 pc
EL-MS0076 | .1in Female Gold Terminals (x1,000) |  |  | PCE |  |  | 0 |  | HH-PT1IN_FT (x1,000)
EL-MS0077 | .1in Male Gold Terminals (x1,000) |  |  | PCE |  |  | 0 |  | HH-PT1IN_MT (x1,000)
EL-MS0079 | 10 Yubikeys in White |  |  | pkg, 10 |  |  | 0 |  | 0
EL-MS0080 | 1500 Watts Step Up-Step Down Voltage Converter |  |  | PCE |  |  | 0 |  | TC-1500
EL-MS0081 | 1x1 .1in Plastic Housings (x100) |  |  | PCE |  |  | 0 |  | HH-PT1IN_1x1 (x100)
EL-MS0082 | 1x2 .1in Plastic Housings (x300) |  |  | PCE |  |  | 0 |  | HH-PT1IN_1x2 (x300)
EL-MS0083 | 1x3 .1in Plastic Housings (Economy Servo Housings) (x300) |  |  | PCE |  |  | 0 |  | HH-PT1IN_1x3 (x300)
EL-MS0084 | 1x4 .1in Plastic Housings (x300) |  |  | PCE |  |  | 0 |  | HH-PT1IN_1x4 (x300)
EL-MS0085 | AC Power Entry Modules PWR INLET W/FUSEHLDR |  |  | PCE |  |  | 0 |  | 161-PF0030/28
EL-MS0086 | Antistatic Cleaner, 32-oz Trigger Spray |  |  | PCE |  |  | 0 |  | 98265T72
EL-MS0087 | Auto Fuse Holder, Littelfuse |  |  | PCE |  |  | 0 |  | 79458035360
EL-MS0088 | Buffers & Line Drivers Hex Non-Inverting |  |  | PCE |  |  | 0 |  | 595-CD74HC4050M
EL-MS0089 | Buffers & Line Drivers Hi-Spd CMOS Logic Hex Non-Inv Bfr |  |  | PCE |  |  | 0 |  | 595-CD74HC4050PWRG4
EL-MS0090 | CONN CABLE CLAMP CPC SIZE 11 BLK |  |  | PCE |  |  | 0 |  | A32515-ND
EL-MS0091 | DC 3A Step-Down Adjustable Breadboard Module; Power Supply Converter USA |  |  | PCE |  |  | 0 |  | 0
EL-MS0092 | Fuse 5A 125V Fast NANO2 SMD |  |  | PCE |  |  | 0 |  | F1641CT-ND
EL-MS0093 | FUSE BLADE 15A 32V ATO FAST-ACT |  |  | PCE |  |  | 0 |  | F4200-ND
EL-MS0094 | Fuse Holder Inline |  |  | PCE |  |  | 0 |  | BPHHN
EL-MS0095 | FUSE MED-ACT 7A 125V UL 5X20MM |  |  | PCE |  |  | 0 |  | F4710-ND
EL-MS0096 | Cartridge Fuses 125V 7A 5X20 MA UL LBC |  | 0 | PCE | 0.381 | 0 | F4710-ND | Mouser | 576-0233007.MXP | 576-0233007.MXP | 0 | 0 | 0 | 0 | 0 | 0
EL-MS0097 | Heater Cartridge 24V, 40W |  |  | PCE |  |  | 0 |  | 0
EL-MS0098 | HOOK MINI TEST CONN BLK |  |  | PCE |  |  | 0 |  | 461-1013-ND
EL-MS0099 | HOOK MINI TEST CONN RED |  |  | PCE |  |  | 0 |  | 461-1014-ND
EL-MS0100 | MOD PWR INLET STD FILTER 10A PNL |  |  | PCE |  |  | 0 |  | 486-2181-ND
EL-MS0101 | Modular Plug |  |  | PCE |  |  | 0 |  | 783250853960
EL-MS0102 | (OLD - use EL-MS0012) Noninsulated Wire Ferrule, 24-20 AWG, .31" pin length |  |  | PCE |  |  | 0 |  | 9681K15
EL-MS0103 | Rectifiers Vr/400V Io/1A |  |  | PCE |  |  | 0 |  | 625-1N4004-E3/54
EL-MS0104 | Ring Term 12-10 GA |  |  | PCE |  |  | 0 |  | 85417
EL-MS0105 | Safe Glass Fuse, Littelfuse |  |  | PCE |  |  | 0 |  | 819562006029
EL-MS0106 | Solid State Relay SSR-25DA 25A /250V 3-32VDC for Temperature Controller |  |  | PCE |  |  | 0 |  | 0
EL-MS0107 | Static Control Strap for Personnel, 4 Receptacle Grounding Station, 10' Straight Cord |  |  | PCE |  |  | 0 |  | 72555K66
EL-MS0108 | Static Control Strap for Personnel, Wrist Strap, Coiled Cord, 6' Cord Length |  |  | PCE |  |  | 0 |  | 72555K55
EL-MS0109 | Static Control Strap for Personnel, Wrist Strap, Straight Cord, 4' Cord Length |  |  | PCE |  |  | 0 |  | 72555K54
EL-MS0110 | Static Control Strap for Personnel, Wrist Strap, Straight Cord, 6' Cord Length |  |  | PCE |  |  | 0 |  | 72555K53
EL-MS0111 | Term QD 12-10 F .375 |  |  | PCE |  |  | 0 |  | 85447
EL-MS0112 | Wall Socket, single |  |  | PCE |  |  | 0 |  | 0
EL-MS0113 | TRENDnet Rack Mount Kit for TEG-S16Dg and TEG-S24Dg (ETH-11MK) |  |  | PCE |  |  | 0 |  | 0
EL-MS0114 | Transcend 16GB Class 10 SDHC Flash Memory Card (TS16GSDHC10E) |  |  | PCE |  |  | 0 |  | 0
EL-MS0115 | CONN PWR PLUG DC 2.1X5.5 8A MOD |  |  | PCE |  |  | 0 |  | CP3-002AH-ND
EL-MS0116 | Kingston 8 GB 240-Pin DDR3 SDRAM ECC Registered DDR3 1600 (PC3 12800) Server Memory DR x4 Model KVR16R11D4/8 |  |  | PCE |  |  | 0 |  | N82E16820239229
EL-MS0117 | Pluggable Terminal Block, 6 contacts 5.08mm (black) |  |  | PCE |  |  | 0 |  | 0
EL-MS0118 | Pluggable Terminal Block, 2 contacts 5.08mm (black) |  |  | PCE |  |  | 0 |  | 0
EL-MS0119 | SD Card from GLCD Kit |  |  | PCE |  |  | 0 |  | 0
EL-MS0120 | (N82E16820239275) Kingston 16GB 240-Pin DDR3 SDRAM ECC Registered DDR3 1600 Server Memory DR x4 Model KVR16R11D4/16 |  |  | PCE |  |  | 0 |  | N82E13820239275
EL-MS0121 | 14-18 AWG Tin Sockets for Receptacle, 4k reel |  |  | PCE |  |  | 1-66359-4 |  | 1-66358-6
EL-MS0122 | CONN PIN .062 14-18AWG TIN CRIMP |  |  | PCE |  |  | 0 |  | 1-66359-4
EL-MS0123 | CONN PIN .062 24-26AWG TIN CRIMP |  |  | PCE |  |  | 0 |  | 1-66106-5
EL-MS0124 | 20-24 AWG Tin Sockets for Receptacle - 4K Reel | Buy |  | PCE | $0.21 | TE Connectivity AMP Connectors | 1-66331-4 | TTI -DIGIKEY | 1-66331-4 |  | Received 28,000 Outstanding balance 20k ETA 10/27
EL-MS0126 | CONN PLUG, 25 POS, IDC GOLD |  |  | PCE |  |  | 0 |  | 3M15408-ND
EL-MS0127 | CONN D-SUB RCPT 25 POS IDC GOLD |  |  | PCE |  |  | 0 |  | 8325-8003
EL-MS0128 | CONN PLUG CPC 4POS REV SER 1 |  |  | PCE |  |  | 206429-1 |  | 206429-1
EL-MS0129 | CONN CABLE CLAMP CPC SIZE 17 BLK |  |  | PCE |  |  | 20607-8 |  | 206070-8
EL-MS0130 | CONN CABLE CLAMP R/A CPC SIZE 17 |  |  | PCE |  |  | 0 |  | 1546349-2
EL-MS0131 | CONN PLUG CPC 14POS REV SER 1 |  |  | PCE |  |  | 206044-1 |  | A1358-ND
EL-MS0132 | CONN CLAMP, R/A, W/O COVER, SIZE 17 |  |  | PCE |  |  | 0 |  | 0
EL-MS0133 | CONN, RCPT, 14 POS w/Brass Inserts | Buy |  | PCE | $3.12 | TE Connectivity AMP Connectors | 211103-1 | TTI | 211103-1 |  | Received 3050 pc
EL-MS0134 | Conn backshell DB25 Flat Ribbon Plast |  |  | PCE |  |  | 0 |  | 636-976-025-010R031
EL-MS0136 | Corrugated Wrap-Around Polyethylene Sleeving, 3/8" ID, 100' Length, Blue |  |  | ft |  |  | 0 |  | 7700k52
EL-MS0138 | SPEAKER 4OHM 3W 82DB 28X40MM |  |  | PCE |  |  | 0 |  | 668-1234-ND
EL-MS0139 | Tubing Corrugated Loom 3/8" ID, Black, 1900' Box | Buy |  | ft | $0.00 | Panduit / Fastenal | 0708162 | EDC – Electronics Distributors Corporation | 7840K72 |  | Received 152000 ft
EL-MS0140 | Conn Cable Clamp Shell size 11 for 4-Pos; 0.329” opening |  |  | PCE |  |  | 0 |  | 1-206062-5
EL-MS0141 | Term Ring Non Ins 26-22AWG #4 Order Bulk Only | Buy | YES | PCE | $0.06 | Panduit | P22-4R-M | TTI | P22-4R-M |  | Received 30,500
EL-MS0142 | Conn Recept Faston 22-26AWG .110 - Reel of 3K | Buy | YES | PCE | $0.08 | Molex | 7-520365-2 | TTI | 7-520365-2 | A27793-ND | Received 33,000
EL-MS0143 | Conn Fast Receptacle14-16 AWG .250 - REEL of 2200 Units | Buy | YES | PCE | $0.07 | TE Connectivity AMP Connectors | 3-350819-2 | TTI | 3-350819-2 | 22-26AWG .110 | Received 22,000 pc
EL-MS0144 | Connector Accessories, Sealing Cap, Shell Size 17 | Buy | YES | PCE | $1.73 | TE Connectivity AMP Connectors | 207445-3 | TTI / Online components | 207445-3 |  | 3,050 received
EL-MS0145 | CONN D-SUB PLUG 25POS IDC GOLD |  |  | PCE |  |  | 0 |  | 3M15408-ND
EL-MS0148 | (OLD) 14-18 AWG Tin Sockets for Receptacle-[use EL-MS0121] |  |  | PCE |  |  | 0 |  | A31997-ND
EL-MS0149 | (obsolete use EL-MS0122) 14-18 AWG Tin Pin for Plug |  |  | PCE |  |  | 0 |  | A31998-ND
EL-MS0150 | CONN PIN 20-24AWG TIN CRIMP |  |  | PCE |  |  | 0 |  | A32008TR-ND
EL-MS0151 | CONN SOCKET 20-24AWG TIN CRIMP |  |  | PCE |  |  | 0 |  | A31990TR-ND
EL-MS0152 | CONN SKT .062 20-24AWG TIN CRIMP |  |  | PCE |  |  | 0 |  | A32007TR-ND
EL-MS0153 | CONN SKT .062 14-18AWG AU CRIMP |  |  | PCE |  |  | 0 |  | A25012TR-ND
EL-MS0155 | Serial Enabled 20x4 LCD - Black on Green 5V |  |  | PCE |  |  | 0 |  | LCD-09568
EL-MS0156 | IC REG LDO 5V 3A TO220-3 |  |  | PCE |  |  | 0 |  | 576-1121-ND
EL-MS0157 | Tubing Corrugated Loom .25", Blue |  |  | ft |  |  | 0 |  | 7700K51
EL-MS0158 | JY-MCU Bluetooth Wireless Serial Port Module for Arduino |  |  | PCE |  |  | 0 |  | 104299
EL-MS0159 | Eleronic Butt Terminal |  |  | PCE |  |  | 0 |  | 0
EL-MS0160 | Noninsulated Wire Ferrule, 14 AWG, .39" Pin Length |  |  | PCE |  |  | 11225-04231 |  | 11225-04231
EL-MS0161 | LCD Graphic Display Modules & Accessories 4.3"LCDDispCAPEw/Tch for Beaglebone Black |  |  | PCE |  |  | 0 |  | 971-4DCAPE-43T
EL-MS0162 | Display Modules 7" LCD DispCapew/tch for BeagleBone Black |  |  | PCE |  |  | 0 |  | 971-4DCAPE-70T
EL-MS0163 | CONN PIN .062 24-26AWG TIN CRIMP |  |  | PCE |  |  | 0 |  | 1-66107-2-ND (BULK)
EL-MS0164 | Servo - Generic (Sub-Micro Size) |  |  | PCE |  |  | 0 |  | ROB-09065
EL-MS0165 | Snap-Together Cable and Hose Carrier, Feed-Through, 0.41" High x 0.39" Wide Interior Size |  | 0 | ft | 0.0202604986877 | 0 | 06-10-028-0 | IGUS | 06-10-028-0 | 06-10-028-0 | 0 | 0 | 0 | 0 | 0 | 0
EL-MS0165- old | (OLD) Snap-Together Cable and Hose Carrier, Feed-Through, 0.41" High x 0.39" Wide Interior Size |  |  | PCE |  |  | 0 |  | 55835K32
EL-MS0166-Female | Mounting Brackets for .41" High x .39" Wide Interior Snap-Together Cable and Hose Carrier - Female |  |  | PCE |  |  | 060-10-12 |  | 060-10-1
EL-MS0166-Male | Mounting Brackets for .41" High x .39" Wide Interior Snap-Together Cable and Hose Carrier - Male |  |  | PCE |  |  | 060-10-12 |  | 55835K2
EL-MS0167 | QUALITY USA brand fuses, Set of 5 pcs, T6.3AL250V, T6.3A 250V, T6.3L250V cartridge GLASS fuses 5X20mm (3/16" X 3/4"), 6.3A 250V |  |  | PCE |  |  | 0 |  | 0
EL-MS0168 | UniCrimp 200 Crimping Machine |  |  | PCE |  |  | 0 |  | 0
EL-MS0169 | Uni-A Mechanical Side Feed / Double Banded Applicator for Processing Molex Terminal #16-02-0086 |  |  | PCE |  |  | 0 |  | 0
EL-MS0170 | Uni-A Mechanical Side Feed / Front Banded Applicator for Processing Molex Terminal #16-02-0105 |  |  | PCE |  |  | 0 |  | 0
EL-MS0171 | FUSE 10 A/T 5x20 (115V) |  |  | PCE |  |  | 0 |  | CRK-22042
EL-MS0172 | FUSE 2 A/T 5x20 (24V) |  |  | PCE |  |  | 0 |  | CRK-6270008
EL-MS0173 | MAGNETIC BASE FOR WORK LIGHT |  |  | PCE |  |  | 0 |  | CRK-1005
EL-MS0174 | Olimex LCD Graphic Display Modules & Accessories 7 IN TFT TOUCHSCREEN A13 OLINUXINO |  |  | PCE |  |  | 0 |  | 909-A13-LCD7-TS
EL-MS0175 | pcDuino3 |  |  | PCE |  |  | 0 |  | PCDUINOV3
EL-MS0176 | Kingston Digital 8 GB microSD Class 10 UHS-1 Memory Card 30MB/s with Adapter SDC10/8GB |  |  | PCE |  |  | 0 |  | 0
EL-MS0177 | Micro USB OTG Adapter |  |  | PCE |  |  | 0 |  | 9724
EL-MS0178 | RJ-45 MODULAR PLUGS RJ45 - 100 PACK FOR SOLID |  |  | PCE |  |  | 0 |  | 7245
EL-MS0179 | Cat5e Inline Coupler - White |  |  | PCE |  |  | 0 |  | 7284
EL-MS0180 | Prototyping board, PC BOARD 2-SIDE PPH 2.0X3.0 |  |  | PCE |  |  | 8029 |  | V2025-ND
EL-MS0181 | Breakout pins, 2x36 |  |  | PCE |  |  | 0 |  | S2252E-36-ND
EL-MS0182 | Breakout pins, 1x36 |  |  | PCE |  |  | 0 |  | WM50018-36-ND
EL-MS0183 | 2 POS Term block header, 5.08mm |  |  | PCE |  |  | 395311002 |  | WM7837-ND
EL-MS0184 | 24V 40W Heater Cartridge |  |  | PCE |  |  | 0 |  | 0
EL-MS0200 | FOOT PEDAL, UniCrimp |  |  | PCE |  |  | 0 |  | SCH-404129
EL-MS0201 | 7"HDMI LCD Module Display Optional TouchScreen VGA,Video Driver board |  |  | PCE |  |  | 0 |  | ER-TFTV070-3
EL-MS0202 | Power Module |  |  | PCE |  |  | 0 |  | PL-TPower
EL-MS0203 | Leviton 30/50 Amp Black Commercial Grade Straight Blade Plug (00931-000) |  |  | PCE |  |  | 0 |  | 3201365
EL-MS0204 | 10mm Strip to Strip Snap Connector for RGB |  |  | PCE |  |  | 0 |  | RGB-C2
EL-MS0205 | Molex-CONN TERM MALE 22-24AWG TIN - Reels of 20K | Buy |  | PCE | $0.02 | Molex | 16-02-0107 | TTI | 16-02-0107 | WM2517TR-ND | Received 220,000
EL-MS0206 | CONN 3.5MM MALE MONO PHONE PLUG |  |  | PCE |  |  | MP3-3501 |  | CP3-1005-ND
EL-MS0207 | POT 10K OHM 17MM RD .06W CARB |  |  | PCE |  |  | 0 |  | PDB182-E420K-103A-ND
EL-MS0208 | Crucial 16GB (2 x 8GB) 240-Pin DDR3 SDRAM ECC Unbuffered DDR3 1600 (PC3 12800) Server Memory Model CT2KIT102472BA160B |  |  | PCE |  |  | 0 |  | 0
EL-MS0209 | BULK - RING TONGUE CONN 16-22 AWG #10 PIDG |  |  | PCE |  |  | 0 |  | A1062-ND
EL-MS0210 | CONN RING UNINS 15-20AWG #M3 DO NOT USE See EL-MS0246 |  |  | PCE |  |  | 0 |  | A107160CT-ND
EL-MS0211 | TE- REEL / RING TONGUE CONN 16-22 AWG #10 PIDG |  | 0 | PCE | 0.0854 | TE | 2-36154-2 | SAGER | 2-36154.2 | A1062TR-ND | 0 | 0 | 0 | 0 | 0 | 0
EL-MS0212 | Molex-CONN PIN 24-30AWG Crimp Tin, 20,000 Unit Reel |  |  | PCE | 0.022 | Molex | 16-02-0105 | TTI | WM2565-ND
EL-MS0213 | 2 x 50' Vinyl Anti-Static Table Mat |  |  | PCE |  |  | 0 |  | S-14117
EL-MS0214 | Ferrite Tubular Bead 13.72mm |  |  | PCE |  |  | 0 |  | 240-2116-ND
EL-MS0215 | Ferrite Tubular Bead 15.49mm |  |  | PCE |  |  | 0 |  | 240-2313-ND
EL-MS0216 | Steward-Ferrite Tubular Bead 19.00mm |  | 0 | PCE | 0.295 | Laird Technologies - Signal Integrity Products | 28B1142-100 | SAGER | 28B1142-100 | 28B1142-100 | Received SAGER $0.295 ea 12-14 wk leadtime w/expedite | 0 | 0 | 0 | 0 | 0
EL-MS0217 | Ferrite Tubular Bead 19.00mm |  |  | PCE |  |  | 0 |  | 240-2118-ND
EL-MS0218 | FERRITE BEAD CORE EMI L/F 15.0MM |  |  | PCE |  |  | 0 |  | 240-2285-ND
EL-MS0219 | Ferrite Bead Core EMI L/F 10.0mm |  |  | PCE |  |  | 0 |  | 240-2283-ND
EL-MS0220 | SWM Style USB Flash drive, 4gb, black with MINI logo |  |  | PCE |  |  | 0 |  | 0
EL-MS0221 | Near Field E/H Probe Set to 3GHz |  |  | PCE |  |  | 0 |  | EMCO-7405
EL-MS0222 | 9kHz-6GHz Spectrum Analyzer w/EMI Filter/Detector/Tracking Gen opts B31/34,B30,K9,B7,B8,B22 |  |  | PCE |  |  | 0 |  | ROHD-FSL616-PKG02
EL-MS0223 | 9kHz-200MHz Transient Limiter, BNC(f) Input, N(m) Output |  |  | PCE |  |  | 0 |  | AGIL-11947A
EL-MS0224 | LISN, 10kHz-50MHz 500V Single Line, 50A max, 50uH |  |  | PCE |  |  | 0 |  | SOLA-9247-50-TS-50-N
EL-MS0225 | Broadband AMPL / SMA |  |  | PCE |  |  | 0 |  | ZFL-1000LN+
EL-MS0226 | Programmable DC Power Supply with 2 0-30V/3A c |  |  | PCE |  |  | 0 |  | RIGOLDP832
EL-MS0227 | Conn Adapt SMA Plug to BNC Jack |  |  | PCE |  |  | 0 |  | J10098-ND
EL-MS0228 | Test Lead STKG BANAMINGRABR - BLACK |  |  | PCE |  |  | 0 |  | 501-1060-ND
EL-MS0229 | Test Lead STKG BANAMINGRABR - RED |  |  | PCE |  |  | 0 |  | 501-1061-ND
EL-MS0231 | Pneumatic Feed Kit for pneumatic applicator |  |  | PCE |  |  | 0 |  | CRK-5000
EL-MS0232 | Uni-A Mechanical Side Feed / Front Banded Applicator, for Processing TE #1-66331-4 |  |  | PCE |  |  | 0 |  | SCA-700266001
EL-MS0233 | Uni-A Mechanical Side Feed / Front Banded Applicator, for Processing TE #1-66358-6 & 1-66359-4 |  |  | PCE |  |  | 0 |  | SCA-700269001 for Processing TE# 1-66358-6 & 1-66359-4
EL-MS0234 | Uni-A Mechanical Side Feed / Front Banded Applicator, for processing TE #1-66106-5 |  |  | PCE |  |  | 0 |  | 0
EL-MS0235 | Surface Mount Fuses 125V V/FA 5A NANO2 |  |  | PCE |  |  | 0 |  | 576-0448005.MR
EL-MS0236 | Steward-FERRITE CYLINDR BOX CLAMP.350"WHT |  |  | PCE |  |  | 28A2029-0A0 |  | 28A2029-0A0
EL-MS0237 | FERRITE BEADCORE L/F EMI 19.00MM |  |  | PCE |  |  | 0 |  | 240-2139-ND
EL-MS0238 | Enercell™ High-Power AC Adapter |  |  | PCE |  |  | 0 |  | 0
EL-MS0239 | Grounding Cord Kit for Rubber Static Control Work Surface Mat |  |  | PCE |  |  | 0 |  | 4446T752
EL-MS0240 | Beagle Bone Enclosure - Plastic, Black |  |  | PCE |  |  | 0 |  | PRT-12843
EL-MS0241 | 4 GB DataStick Pro USB 2.0 Flash Drive DSP4GB-007 |  |  | PCE |  |  | 0 |  | DSP4GB-007
EL-MS0242 | TAPE COPPER FOIL 12.7MMX5.5 |  |  | PCE |  |  | 0 |  | 3M9903-ND
EL-MS0243 | Corrugated Wrap-Around Polyethylene Sleeving, 3/8" ID, 100' Length, Blue |  |  | mm |  |  | 0 |  | 7700K52
EL-MS0244 | D SUB CONNECTOR, STANDARD, 25 POSITION, PLUG - ASSEMBLY |  |  | PCE |  |  | 0 |  | 8225-6000
EL-MS0245 | D SUB CONNECTOR, STANDARD, 25 POSITION, RECEPTACLE - ASSEMBLY |  |  | PCE |  |  | 0 |  | 8325-6003
EL-MS0246 | Conn Ring 16-22 AWG #4 Red PIDG - Reel 5000 | Buy |  | PCE | $0.40 | Digikey | A27229TR-ND | TTI | 2-323758-1 | A27229TR-ND | Received 10,000 pc
EL-MS0247 | Heat Shrink Tubing – 0.19-0.09 – Black, 100' | Buy |  | PCE | $0.01 | EDC – Electronics Distributors Corporation | 88-01870 | McMaster-Carr | 7856K74 |  | Received 700'
EL-MS0248 | CONN RING 14-16 AWG #10 PIDG - 5,000 Unit Reel | Buy |  | PCE | $0.10 | TE Connectivity AMP Connectors | 2-36160-1 | TTI | A1072TR-ND |  | Received 30,000
EL-MS0249 | WEiPU Front Mount Male, 4 pin, solder |  |  | PCE |  |  | SP2112/P4 1N |  | SP2112/P4 1N
EL-MS0250 | WEiPU Cable connector female, 4 pin, solder |  |  | PCE |  |  | SP2110/S4II 1N |  | SP2110/S4II1N
EL-MS0251 | CONN HOUSING 16POS .100 DUAL | Buy |  | PCE | $0.53 | Molex | 22552161 | TTI | 22552161 |  | Received 6,100
EL-MS0252 | Nikon MH-23 Quick Charger for EN-EL9 Li-ion Battery by Nikon |  |  | PCE |  |  | 0 |  | B000KWGS9K
EL-MS0253 | FERRITE TUBULAR BEAD 7.87MM |  |  | PCE |  |  | 0 |  | 240-2115-ND
EL-MS0254 | FERRITE BRDBAND CYLINDER 17.07MM |  |  | PCE |  |  | 0 |  | 240-2769-ND
EL-MS0255 | FERRITE EMI SPLIT/SNAP-ON CORE |  |  | PCE |  |  | 0 |  | 240-2601-ND
EL-MS0256 | FERRITE CYLINDER CLAMP-ON 6.60MM |  |  | PCE |  |  | 0 |  | 240-2246-ND
EL-MS0257 | FERRITE BROADBAND CLAMPON 9.00MM |  |  | PCE |  |  | 0 |  | 240-2124-ND
EL-MS0258 | FERRITE EMI SPLIT/SNAP-ON CORE |  |  | PCE |  |  | 0 |  | 240-2604-ND
EL-MS0259 | Heat Shrink DL WL Q53X 3/4" | Buy |  | ft, 100 | $0.17 | Qualtek | Q5-3X-3/4-01-QB48IN-5 | Electronics Distributors Corp. | 67-30751 | Q53X034B-ND | Received 2,100 ft
EL-MS0260 | SSB 31-5TJ Battery |  |  | PCE |  |  | 0 |  | 0
EL-MS0261 | ADATA 8GB Micro SDHC Card Class 4 + SD Adapter - AUSDH8GCL4-RA1 by A-Data USA |  |  | PCE |  |  | 0 |  | AUSDH8GCL4-RA1
EL-MS0262 | SWM Style USB Flash drive, 4gb, Black Pre-flashed with Data and Logo |  | 0 | PCE | 3.95 | 0 | 0 | Nexcopy | 0 | 0 | 0 | 0 | 0 | 0 | 0 | 0
EL-MS0323 | Reflective Safety Strip, Silver |  |  | PCE |  |  | 0 |  | 2906900907
EL-MS0324 | Uni-A Mechanical Side Feed / Front Banded Applicator for Processing Molex Terminal #70021-0004 |  |  | PCE |  |  | 0 |  | SCA-99-700
EL-MS0325 | CONNECTOR, PLUG CPC 57POS |  |  | PCE |  |  | 0 |  | A1383-ND
EL-MS0326 | CONNECTOR CABLE CLAMP SZ 23 1 3/8-18 |  |  | PCE |  |  | 0 |  | A32517-ND
EL-MS0327 | CONNECTOR RECEPTICAL CPC 57POS REV SER 2 |  |  | PCE |  |  | 0 |  | A1381-ND
EL-MS0328 | Heater Cartridge - 24V, 30W, 6mm OD, 20mm long, 230mm Wire length minimum - RoHS compliant |  |  | PCE |  |  | 0 |  | 0
EL-MS0329 | TVS Diode – 1500W, 5V Reverse Standoff, 6V Breakdown, 9.4V Clamp, 200A Surge | Buy |  | PCE | $0.17 | ON Semiconductor | 1N6373G | Future | 1N6373G | 1N6373GOS-ND | Received 3,050
EL-MS0330 | TVS DIODE 5VWM 7.5VC 1.5KE |  |  | PCE |  |  | 1N6373-E3/54GICT-ND |  | 1N6373-E3/54GICT-ND
EL-MS0331 | Ferrite Cable Cores 82ohm @100MHz Beads Core |  |  | PCE |  |  | 81-FSRH070140RN000B |  | 81-FSRH070140RN000B
EL-MS0332 | Ferrite Cable Cores 220ohms 100MHz 5mm I.D. | Buy |  | PCE | $0.15 | Laird Technologies - Signal Integrity Products | 28B0434-000 | Mouser / Sager | 28B0434-000 |  | Eta 9/27
EL-MS0333 | Ferrite Toroids / Ferrite Rings 10/6/4 T46 TOROID |  |  | PCE |  |  | B64290L0038X046 |  | B64290L0038X046
EL-MS0334 | Ferrite Toroids / Ferrite Rings 475ohm @100MHz Ring Core |  |  | PCE |  |  | FSRB100100RTB00B |  | FSRB100100RTB00B
EL-MS0335 | Ferrite Cable Cores 92ohm @100MHz Beads Core |  |  | PCE |  |  | FSRH100150RTB00T |  | FSRH100150RTB00T
EL-MS0336 | Ferrite Cable Cores 310ohms 100MHz 7mm Inside Dia. | Buy |  | PCE | $0.29 | Laird Technologies - Signal Integrity Products | 28B0616-000 | Sager | 28B0616-000 |  | Received 3,050
EL-MS0337 | Ferrite Cable Cores WE-AFB Axial 25MHz 195Ohm |  |  | PCE |  |  | 74270053 |  | 74270053
EL-MS0338 | Ferrite Cable Cores WE-AFB Axial 25MHz 133Ohm |  |  | PCE |  |  | 7427005 |  | 7427005
EL-MS0339 | Ferrite Cable Cores 200ohm @100MHz Beads Core |  |  | PCE |  |  | FSRH190285RT000T |  | FSRH190285RT000T
EL-MS0340 | Ferrite Cable Cores WE-AFB Axial 25MHz 90Ohm |  |  | PCE |  |  | 74270093 |  | 74270093
EL-MS0341 | Ferrite Cable Cores 43 Round Cable Core Z=53 OHM @100MHz |  |  | PCE |  |  | 2643801502 |  | 2643801502
EL-MS0342 | Ferrite Tubular Bead 7.87MM RoHS Status | Buy |  | PCE | $0.23 | Laird Technologies - Signal Integrity Products | 28B0625-100 | Sager | 240-2115-ND |  | 500 pcs Ordered fill in from Digikey 9/27 delivery / best delivery 10/5 from Sager, Ordered fill in from Digikey
EL-MS0343 | Ferrite Tubular Bead 10.16MM | Buy |  | PCE | $0.26 | Laird Technologies - Signal Integrity Products | 28B0735-000 | Sager | 240-2080-ND |  | Received 3,050
EL-MS0344 | Ferrite Tubular Bead 5.90mm | Buy |  | PCE | $0.34 | Laird Technologies - Signal Integrity Products | 28B0591-200 | Sager Digikey | 240-2242-ND |  | Eta 9/27 per tracking
EL-MS0345 | MODULE POWER ENTRY W/FUSE HOLDER |  |  | PCE |  |  | CCM1620-ND |  | CCM1620-ND
EL-MS0346 | MOD PWR ENTRY INLET W/FUSE 6A - IEC C14 Receptacle – AC Filter 6A 250VAC | Buy |  | PCE | $4.70 | Shaffner | FN9260-6-06 | Sager | FN9260-6-06 | 817-1488-ND | Received Confirmed 2095 pc 8/2 balance 5,145 9/1Sager quoted new cost $4.70. KG (from $4.76ea previously)
EL-MS0347 | Fuse Ceramic 6.3A 250VAC 5X20MM | Buy |  | PCE | $0.37 | Littlefuse | 023406.3MXP | Mouser & TTI | 023406.3MXP |  | received 7,000 pc
EL-MS0348 | Heat Shrink Tubing, Flexible, HRHT - 1/3 (.25') |  |  | PCE |  |  | A105288-ND |  | A105288-ND
EL-MS0349 | HEAT SHRINK EPS400 .700 BK 48 IN (4') |  |  | PCE |  |  | 0 |  | 3M15379-ND
EL-MS0350 | Heat Shrink Dual Wall 16MM 1 = 1' |  |  | ft |  |  | ATUM-16/4-0-SP-01-ND |  | ATUM-16/4-0-SP-01-ND
EL-MS0350 | HEAT SHRINK DUAL WALL 16MM 1=1FT(do not use) |  |  | ft |  |  | ATUM-16/4-0-SP-01-ND |  | ATUM-16/4-0-SP-01-ND
EL-MS0351 | JST - CONN TERM CRIMP PH 24-30AWG - 8,000 Unit Reel | Buy |  | PCE | $0.01 | JST Sales America, Inc. | SPH-002T-P0.5S | Future Electronics / Digikey | 455-1127-1-ND |  | ** stock available on hand to cover this build**do not need to order KG
EL-MS0352 | Heavy Duty Power Connectors PP30 #12-16 CONTACT |  |  | PCE |  |  | 0 |  | 0
EL-MS0353 | Ferrule for 16 AWG wire |  |  | PCE |  |  | 3200043 |  | 3200043
EL-MS0354 | Ferrule for 14 AWG wire |  |  | PCE |  |  | 3200522 |  | 3200522
EL-MS0355 | CONN HOUSING PH 6POS 2MM WHITE | Buy |  | PCE | $0.04 | JST Sales America, Inc. | PHR-6 | Future Electronics / Digikey | PHR-6 |  | 108,500 pc on hand on hand, to cover Olivebranch
EL-MS0356 | Heat Shrink Dual Tubing 1/2" for 5mm ID 11mm OD Ferrite, Black 4FT | Buy |  | ft | $0.01 | Molex | 192690028 | Electronics Distributors Corp. | 84-60500 | WM7377-ND | Received 16,000ft
EL-MS0357 | 24 AWG 8.0mm Pin Length Power Phase® Turquoise Single Wire - Insulated Ferrule |  |  | PCE |  |  | 0 |  | 749599
EL-MS0358 | Ferrule, Terminals 20AWG NON-INSL |  |  | PCE |  |  | 0 |  | F76-8-M
EL-MS0359 | Ferrule, Terminals 18AWG NON-INSL |  |  | PCE |  |  | 0 |  | F77-8-M
EL-MS0360 | Ferrule, Terminals 16AWG NON-INSL | Buy |  | PCE | $0.03 | Panduit | F78-8-M | Fastenal | 713067 |  | Received 3,500 pc
EL-MS0361 | 16 AWG 6.0mm Pin Length Power Phase Black Single Wire - Insulated Ferrule | Buy |  | PCE | $0.20 | Panduit | FSD78-6-D | TTI | FSD78-6-D | FSD78-6-D | Received 32,300 pc
EL-MS0362 | 24 AWG 6.0mm Pin Length Single Wire - Insulated Ferrule | Buy |  | PCE | $0.19 | Panduit | FSD73-6-D | TTI | FSD73-6-D | 713000 | Received 47,000 PO15013 = 4,130 received mouser. Backfil for CCX & 3,490 Digikey received.
EL-MS0363 | JST - CONN HEADER PH TOP 6POS 2MM |  |  | PCE |  |  | B6B-PH-K-S(LF)(SN) |  | 455-1708-ND
EL-MS0364 | 4 Circuit 0.438" (11.12mm) Barrier Block Connector, Screws |  |  | PCE |  |  | 4-141 |  | CBBB204-ND
EL-MS0365 | SENS OPTO SLOT 3.81MM TRANS C-MT |  |  | PCE |  |  | OPB857Z |  | 365-1741-ND
EL-MS0366 | Vernier Sensor - Gas Pressure Sensor |  |  | PCE |  |  | SEN-12874 |  | SEN-12874
EL-MS0367 | Terminal .110 Faston Tab PCB |  |  | PCE |  |  | 61134-3 |  | 61134-3
EL-MS0368 | RepRapDiscount Heater Cartridges |  |  | PCE |  |  | 0 |  | 0
EL-MS0369 | Conn Header 12POS .100 VERT 15AU |  |  | PCE |  |  | 70545-0046 |  | 70545-0046
EL-MS0370 | Conn Header 20POS .100 VERT GOLD |  |  | PCE |  |  | 70246-2002 |  | WM6549-ND
EL-MS0371 | Conn Header 2POS .100 VERT TIN |  |  | PCE |  |  | 70545-0001 |  | WM4133-ND
EL-MS0372 | Conn Header 8POS .100 VERT TIN |  |  | PCE |  |  | 70545-0007 |  | WM4138-ND
EL-MS0373 | Conn Header 10POS .100" STR GOLD |  |  | PCE |  |  | 90136-1210 |  | WM8231-ND
EL-MS0374 | Term Block HDR 6POS VERT 5.08MM |  |  | PCE |  |  | 395311006 |  | 395311006
EL-MS0375 | Class 1 Bluetooth USB Serial Adapter |  |  | PCE |  |  | 0 |  | KC-4132
EL-MS0377 | 24V 30W Heater Cartridge, 23cm Leads (with no connectors on end) |  |  | PCE | 1.95 | Reprapdiscount | 0 | Reprapdiscount | HC24V
EL-MS0378 | igus Energy chain® 06 Series 16mm Inner Width, 28mm Bend Radius |  |  | PCE |  |  | 06-16-028-0 | IGUS | 06-16-028-0
EL-MS0379 | igus Energy chain® 06 Series 20mm Inner Width, 28mm Bend Radius |  | 0 | PCE | 0 | Igus | 06-20-028-0 | IGUS | 06-20-028-0 | 06-10-028-0 | 0 | 0 | 0 | 0 | 0 | 0
EL-MS0380 | igus Energy chain® 06 Series 30mm Inner Width, 28mm Bend Radius |  | 0 | PCE | 0 | Igus | 06-30-028-0 | IGUS | 06-30-028-0 | 0 | 0 | 0 | 0 | 0 | 0 | 0
EL-MS0381 | Igus 06 Series Mounting Bracket Set 16mm Inner Width |  |  | PCE |  |  | 0 | IGUS | 060-16-12
EL-MS0382 | Igus 06 Series Mounting Bracket Set 20mm Inner Width |  | 0 | PCE | 1.8 | Igus | E2-100-20-12 or ?? 06-20-12 | IGUS | E2-100-20-12 | 0 | Female and Males are sold as a set under a single MFR Part Number. Please see part number description in ERP for details and make sure we don't double order. | 0 | 0 | 0 | 0 | 0
EL-MS0383 | Igus 06 Series Mounting Bracket Set 30mm Inner Width |  | 0 | PCE | 5.1 | Igus | E2-100-30-12 or ?? 06-30-12 | IGUS | E2-100-30-12 | 0 | 0 | 0 | 0 | 0 | 0 | 0
EL-MS0384 | igus Chainflex® CF9 Control Cable TPE |  |  | PCE |  |  | CF9-02-08 | IGUS | CF9-02-08
EL-MS0385 | Verbatim 8GB SDHC Class 10 UHS-I / Bulk | Buy |  | PCE | $4.20 | Verbatim | 99197 – 8GB SDHC Memory Card Class 10 UHS-1 400Pk Bulk | Verbatim Americas, LLC | 99197 – 8GB SDHC Memory Card Class 10 UHS-1 400Pk Bulk
EL-MS0386 | Schottky Diodes & Rectifiers 1.0A 30V |  |  | PCE |  |  | 0 |  | 621-SB130-T
EL-MS0387 | Schottky Diodes & Rectifiers Schottky Brdge Rect 2A 40V Low Vf |  |  | PCE |  |  | 0 |  | CDBHM240L-HF
EL-MS0388 | 2-1/2" x 2" Standard Magnetic-Base Holder for Dial and Digital Indicators |  |  | PCE |  |  | 41111630 |  | 3299171
EL-MS0389 | Headers, Wire Housing 20P Strt 1 Row Gold 5.5mm mating pin |  |  | PCE |  |  | 961120-6404-AR |  | 517-9611206404AR
EL-MS0399 | SD Card Connector |  |  | PCE |  |  | 10067847-011RLF |  | 649-10067847-011RLF
EL-MS0400 | Encoders 11mm 15 RES 30 DTENT |  |  | PCE |  |  | EC11E15244B2 |  | 688-EC11E15244B2
EL-MS0401 | Audio Indicators & Alerts Buzzers |  |  | PCE |  |  | CX-0905C |  | 490-CX-0905C
EL-MS0402 | Audio Indicators / Alerts Buzzers |  |  | PCE |  |  | 30310-6002HB |  | 517-30310-6002
EL-MS0403 | LDO Voltage Regulator |  |  | PCE |  |  | MIC5209-3.3YS-TR |  | 998-MIC5209-3.3YSTR
EL-MS0404 | Buffer & Line Drivers Hex Non-Inverting |  |  | PCE |  |  | CD74HC4050M9 |  | 595-CD74HC4050M9
EL-MS0405 | Bipolar Transistor BJT NPN BIPOLAR |  |  | PCE |  |  | BC817-40-7-F |  | 621-BC817-40-7-F
EL-MS0406 | Thick Film Resistors - SMD 0805 68ohms 5% AEC-Q200 |  |  | PCE |  |  | ERJ-6GEYJ680V |  | 667-ERJ-6GEYJ680V
EL-MS0407 | Thick Film Resistors - SMD 1/8watt 1Kohms 1% 100ppm |  |  | PCE |  |  | CRCW08051K00FKEA |  | 71-CRCW08051K00FKEA
EL-MS0408 | Multilayer Ceramic Capacitors MLCC - SMD/SMT 50V .1uF X7R 0805 10% Tol |  |  | PCE |  |  | 08055C104KAT2A |  | 581-08055C104K
EL-MS0409 | Multilayer Ceramic Capacitors MLCC - SMD/SMT 1uF 100Volts X7R 10% 1812 STD |  |  | PCE |  |  | HMK432B7105KM-T |  | 963-HMK432B7105KM-T
EL-MS0410 | LCD Display Serial Graphic Display 128x64 ST7920,White on Blue |  |  | PCE |  |  | 128x64 ST7920,White on Blue |  | 128x64 ST7920,White on Blue
EL-MS0411 | Docooler 1 ohm - 10M ohm 1/4W Metal Film Resistors Assortment Kit Set 64 Values Total 1280pcs |  |  | PCE |  |  | 0 |  | H9917
EL-MS0412 | Ceramic Electrolytic Capacitor Mix, 40 Value 866 Pcs |  |  | PCE |  |  | 0 |  | 0
EL-MS0413 | DIP Color Wheel Inductor Assorted Kit 1/2W 10%, VvW 0410 (0.56uH - 4.7mH) 24 value 240pcs |  |  | PCE |  |  | 0 |  | 700646562671
EL-MS0414 | Cartridge Fuse 250V 3.15A Slo-Blo |  |  | PCE |  |  | 02153.15MXP |  | 576-02153.15MXP
EL-MS0415 | Solder Sleeves |  |  | PCE |  |  | 0 |  | 30515-03
EL-MS0416 | Solder Sleeve B155, one step |  |  | PCE |  |  | 0 |  | A104858-ND
EL-MS0417 | Graphic Module 128x64 Serial LCD Display ST7920 Black on White |  |  | PCE |  |  | 128x64 Serial LCD Display ST7920 Black on White |  | 128x64 Serial LCD Display ST7920 Black on White
EL-MS0418 | Conn Housing 10Pos .100 Dual |  |  | PCE |  |  | 22552101 |  | 22552101
EL-MS0419 | Audio Indicators & Alerts 5V 85dBA 2300Hz |  |  | PCE |  |  | AI-1223-TWT-5V-R |  | AI-1223-TWT-5V-R
EL-MS0420 | SWM Style USB Flash Drive, 16gb, Black with Mini Logo - No Data |  |  | PCE |  |  | 0 |  | 0
EL-MS0421 | CABLE CLAMP BLACK 1/2" |  |  | PCE |  |  | 0 |  | RP329-ND
EL-MS0422 | Circuit Breaker Thermal 5A 250VAC 32VDC |  |  | PCE |  |  | 0 |  | PB186-ND
EL-MS0431 | Fork Terminal, non-insulated, 26 – 22 AWG, #4 stud size |  |  | PCE |  |  | P22-4F-C |  | 0
EL-MS0432 | Clip-On EMI Shielding Gasket 150.876mm length |  |  | PCE | 1.77 | Tech Etch | 187RF1C100-5.94-L-08 |  | 187RF1C100-5.94-L-08
EL-MS0434 | Heat Shrink Tubing – 0.19-0.09 – Red, 100' | Buy |  | PCE | $0.02 | 3M | FP-301-3/16-RED-100' | Electronics Distributors Corp. |  |  | Received 100' next 300' due 9/30
EL-MT0001 | NEMA 17 Stepper Motors |  |  | PCE |  |  | 0 |  | 0
EL-MT0002 | Pololu Stepper Motor: Unipolar/Bipolar, 200 Steps/Rev, 42x48mm, 4V, 1200mA |  |  | PCE |  |  | 0 |  | 1200
EL-MT0003 | Lin Engineering NEMA 17 Stepper Motor |  |  | PCE |  |  | 0 |  | 28M068
EL-MT0004 | Kysan DC Geared Motor A37RE-12V2RPM |  |  | PCE |  |  | 0 |  | 1156006
EL-MT0005 | Kysan NEMA 17 Motor 42BYGH102 |  |  | PCE |  |  | 0 |  | 1124002
EL-MT0006 | Kysan 1124030 Nema 17 Stepper Motor |  |  | PCE |  |  | 0 |  | UMN17MTR
EL-MT0007 | Lot of 22 Stepper Motors |  |  | PCE |  |  | 0 |  | 0
EL-MT0008 | Nema 17 Stepper Motors, Motor Wire Lengths - 350mm |  |  | PCE |  |  | 0 |  | 0
EL-MT0009 | 12VDC Wiper Motor |  |  | PCE |  |  | 0 |  | 12VWM
EL-MT0010 | A4988 Stepper Motor Driver Carrier |  |  | PCE |  |  | 0 |  | 1182
EL-MT0011 | Gearhead Step Motor, 12V, 2.3A |  |  | PCE |  |  | 0 |  | 18840 MS
EL-MT0014 | Kysan 1124001 42BYGH001 NEMA 17 Stepper Motors |  |  | PCE |  |  | 0 |  | 1124001
EL-MT0015 | Low Profile NEMA 17 for Dual, Changzhou SY42STH33-1504A |  |  | PCE |  |  | SY42STH33-1504A |  | 42BYGH001-D
EL-MT0016 | Kysan 1124110 Stepper Motor, 12mm, Bipolar, 1.7kg-cm, 2vdc/0.95a, 2.1 Ohm, 2.3 mH 42BYGH001-D |  |  | PCE |  |  | 42BYGH001-D |  | 1124110
EL-MT0017 | Half Height NEMA 17 Stepper Motor |  |  | PCE |  |  | 0 |  | 17H133H-150-4A
EL-MT0018 | Kysan 1040214 Geared Stepper Motor, 1/27 ratio |  |  | PCE |  |  | 1040214 |  | 1040214
EL-MT0019 | Kysan 1040217 Geared Stepper Motor, 1/100 ratio |  |  | PCE |  |  | 1040217 |  | 1040217
EL-MT0020 | NEMA 17 Stepper Motor, terminated, TAZ XYZ |  |  | PCE |  |  | 0 |  | 0
EL-MT0021 | NEMA 17 Stepper Motor, terminated, Mini X |  |  | PCE |  |  | 0 |  | 0
EL-MT0022 | NEMA 17 Stepper Motor, terminated, Mini Y / Z-right |  |  | PCE |  |  | 0 |  | 0
EL-MT0023 | NEMA 17 Stepper Motor, terminated, Mini Z-Left |  |  | PCE |  |  | 0 |  | 0
EL-MT0024 | NEMA 17 Stepper Motor, terminated, Mini Extruder |  |  | PCE |  |  | 0 |  | 0
EL-MT0025 | NEMA 17 Stepper Motor, terminated, TAZ Extruder |  |  | PCE |  |  | 0 |  | 0
EL-MT0026 | NEMA 17 Stepper Motor, 48mm long, Kysan |  |  | PCE |  |  | 0 |  | 1124098
EL-MT0027 | NEMA 17 Stepper Motor, 34mm long, Kysan |  |  | PCE |  |  | 0 |  | 1124099
EL-MT0028 | NEMA 17 Stepper Motor, Moons' |  |  | PCE |  |  | 0 |  | MS17HD6P4150
EL-MT0029 | NEMA 17 Stepper Motor, Moons' - NOT INCLUDING wire harness | Buy |  | PCE | $8.30 | Moons | MS17HD6P4150-01-B | Moons | MS17HD6P4150-01-B | MS17HD6P4150MS17HD6P4150-01-B | Scheduled monthly deliveries slated to begin 8/31/16 and run until 1/30/17 and we have until June 30, 2017 to pull these in if the line slows down.
EL-MT0030 | NEMA 17 Stepper Motor, Moons' - INCLUDING Adapter |  |  | PCE |  |  | MS17HD6P4150-01-B |  | MS17HD6P4150-01-B
EL-MT0031 | NEMA 17 Damper - Astrosyn MY17RMDAMP |  |  | PCE |  |  | 0 |  | N17D
EL-MT0032 | Nema 17 Stepper Motor Damper, Flange-less, w/Pilot - Moons' |  |  | PCE | 2.45 | Moons | 4696325000008 | Moons | 4696325000008 | 4696325000008 | 0 | 0 | 0 | 0 | 0 | 0
EL-PS0001 | 12vDC 20A 240W Power Supply (DO NOT USE) |  |  | PCE |  |  | 0 |  | SP-240-12
EL-PS0002 | 400W (12/24V/48V for selected) M&W brand switch power supply |  |  | PCE |  |  | 0 |  | S-400
EL-PS0003 | 12vDC 25A 300W Power Supply |  |  | PCE |  |  | 0 |  | S-300-12
EL-PS0004 | Power Supply with Cord, 12V, 16A with 4pin DIn and power cord |  |  | PCE |  |  | 0 |  | ALE-0000214
EL-PS0005 | Assy, Power Supply 12V, 16A with 4Pin DIN and Power Cord |  |  | PCE |  |  | 0 |  | ALE-0000214
EL-PS0006 | 12vDC 16A Power Supply w/ 4 pin plug |  |  | PCE |  |  | 0 |  | 0
EL-PS0009 | 12vDC 30A 360W Power Supply |  |  | PCE |  |  | 0 |  | S-360-12
EL-PS0011 | AC100-240V to 24V DC 6A 145W Regulated Switching Power Supply |  |  | PCE |  |  | 0 |  | 0
EL-PS0012 | General Purpose / Industrial Relays 5A 12VDC SPDT PCB |  |  | PCE |  |  | 0 |  | 769-JQ1-12V-F
EL-PS0013 | Linear and Switching Power Supplies 350.4W 24V 14.6A |  |  | PCE |  |  | 0 |  | 709-NES350-24
EL-PS0014 | 24vDC 15A 360W Power Supply |  |  | PCE |  |  | 0 |  | 0
EL-PS0015 | Power supply, 24v, 15amp, 360w, PCIE-6 pin, Pengchu Ind. Ltd. |  |  | PCE |  |  | 0 |  | 0
EL-PS0017 | Power Supply, 24V, 16.66A, 400W, 4pin, Pengchu Ltd. Kit |  |  | PCE |  |  | 0 |  | PC-240167
EL-PS0018 | Power Supply, 24V, 16.66A, 400W, 4pin, Pengchu Ltd. |  |  | PCE |  |  | 0 |  | 0
EL-PS0019 | AC/DC CONVERTER 24V 150W |  |  | PCE |  |  | 0 |  | 1145-1075-ND
EL-PS0020 | AC/DC CONVERTER 24V 200W UL |  |  | PCE |  |  | 0 |  | 1145-1076-ND
EL-PS0021 | 12V DC Power Adapter Supply 2.1mm 1A, CCTV |  |  | PCE |  |  | 0 |  | 0
EL-PS0022 | Power Supply, 24V, 16.66A, 400W, 4pin, Pengchu Ltd. v2 |  |  | PCE |  |  | 0 |  | 0
EL-PS0023 | DC/DC CONVERTER 12V 0.75W |  |  | PCE |  |  | 0 |  | 811-2892-5-ND
EL-PS0024 | JACKYLED New DC 12V 2A 2.0A Switching Power Supply Adapter For 110V- 240V AC 50/60Hz 2.1mm |  |  | PCE |  |  | 0 |  | 0
EL-PS0025 | DELTA POWER SUP 150W 24V 6.25A PNL MT |  | 0 | PCE | 23 | Delta | PMC-24V150W1AA | DELTA | 603-1637-ND | PMC-24V150W1AA | 0 | 0 | 0 | 0 | 0 | 0
EL-PS0026 | S-400-24 400W 24V Switching Power Supply |  |  | PCE |  |  | 0 |  | S-400-24
EL-PS0027 | Switching Power Supplies 451.2W 24V 18.8A |  |  | PCE |  |  | 0 |  | 709-SE450-24
EL-PS0028 | PWR WALLMNT ADPT MED 5V 10W US |  |  | PCE |  |  | 0 |  | 454-1453-ND
EL-PS0030 | Mean Well Switching Power Supplies 451.2W 24V 18.8A W/PFC |  |  | PCE |  |  | 0 |  | HRP-450-24
EL-PS0031 | Mean Well Switching Power Supplies 500W 24V 21A Power Supply W/PFC | Buy |  | PCE | $65.00 | Mean Well | RSP-500-24 | Sager | RSP-500-24 |  | Received 3,200 pcs 800 units per month delivery from California warehouse to here Freight cost is only from CA – CO We have from Aug.2015 - Dec. 2016 to take delivery of the 10,000 units The above stated delivery schedule can be adjusted as needed. Net 60.TS
EL-SD0001 | American Terminal AT-31604 60-40 Rosin Core Solder (4 Ounces) |  |  | PCE |  |  | 0 |  | B00030AP48
EL-SD0002 | Chem-Wik® Rosin SD Desoldering Braid .050" x 5', Yellow, ESD Spool |  |  | PCE |  |  | 0 |  | 5-5L
EL-SD0003 | Chemtronics Chem-Wik. Sz 5, Rosin, .050"Wx5', yellow |  |  | Each - OLD |  |  | 0 |  | 0
EL-SD0004 | Kester Wire Solder, .015”, Sn63 Pb37, #50/245, 1 lb. |  |  | PCE |  |  | 0 |  | 488SO788
EL-SD0005 | Kester Wire Solder, .031", Sn96.5 Ag3 Cu.5, #58/275, 1 lb |  |  | PCE |  |  | 0 |  | 488SO7871
EL-SD0006 | Soder-Wick® No Clean SD .030" ESD 10' Spool |  |  | PCE |  |  | 0 |  | 60-1-10
EL-SD0007 | Solder, Fluxes & Accessories SUPERWICK - #1 WHITE |  |  | PCE |  |  | 0 |  | 590-423
EL-SD0008 | Solder, Fluxes & Accessories SUPERWICK - #2 YELLO |  |  | PCE |  |  | 0 |  | 590-424
EL-SD0009 | 7659A42 Solder with Rosin Flux Core for Electronics, 0.031" Diameter, 370°F Melting Temperature, 1/2 oz. |  |  | PCE |  |  | 0 |  | 7659A42
EL-SD0010 | Solder Removal SUPRWIK .050in WIDTH YELLOW 5FT LENGTH |  |  | PCE |  |  | 0 |  | 590-424
EL-SD0011 | Solder Removal SUPRWIK .075in WIDTH GREEN 5FT LENGTH |  |  | PCE |  |  | 0 |  | 590-425
EL-SD0012 | Soldering Flux 2331-ZX WS FLUX PEN |  |  | PCE |  |  | 0 |  | 533-2331
EL-SD0013 | Solder Removal Desoldering Pump |  |  | PCE |  |  | 0 |  | 801-DP-140
EL-SD0014 | Lead-Free Wire Solder with No-Clean Flux Core for HVAC & High Temperature Applications, 0.125" Diameter, 1 lb. |  |  | PCE |  |  | 0 |  | 7837A38
EL-SD0015 | Lead-Free Solder without Flux Core, Drinking-Water Safe, 0.118" Diameter Wire, 1 lb. |  |  | PCE |  |  | 0 |  | 76805A61
EL-SD0016 | ECG J-045-DS 45 Watt Desoldering Iron |  |  | PCE |  |  | 0 |  | ECG J-045-DS
EL-SW0000 | TRENDnet 16-Port Gigabit GREENnet Switch (TEG-S16DG) |  |  | PCE |  |  | 0 |  | 0
EL-SW0001 | Rocker Switch, 16A Oval, Black Housing, Wht Off-On |  |  | PCE |  |  | 0 |  | 612-RE111C1121
EL-SW0002 | Mechanical Endstops - Red Wizard |  |  | PCE |  |  | 0 |  | 0
EL-SW0003 | Mechanical Endstop Switch, 3 Pack(DO NOT USE. SEE [KT-EL0062] |  |  | PCE |  |  | 0 |  | 0
EL-SW0004 | Switch, 24V, 20A |  |  | PCE |  |  | 0 |  | C1350ARBB-602AW
EL-SW0005 | Tactile & Jog Switches 6MM R/A TACT W/SQARE ACTUATOR |  |  | PCE |  |  | 0 |  | 506-FSMRACDAH
EL-SW0006 | Tactile & Jog Switches SPST Rnd Bttn PC .05A 12VDC Thru-Hole |  |  | PCE |  |  | 0 |  | 611-PTS645SH70LFS
EL-SW0007 | Toggle Switches SWITCH TOGGLE SPDT |  |  | PCE |  |  | 0 |  | 108-1MS1T2B3M2QE-EVX
EL-SW0008 | Rocker Switches & Paddle Switches POWER ROCKER 16A 250V |  |  | PCE |  |  | 0 |  | ALE-0000126
EL-SW0010 | SWITCH ROCKER DPST 20A 250V (C1350AABB-602AW) |  |  | PCE |  |  | 0 |  | 1091-1017-ND / C1350AABB-602AW
EL-SW0011 | OMRON Switch Snap Action N.O./N.C. SPDT Simulated Roller Lever Quick Connect 3A 125VAC 30VDC 0.5N Screw Mount |  |  | PCE |  |  | 0 |  | SS-3GL13PT
EL-SW0012 | SPST On-None-Off Full Size Toggle Switch, 4A |  |  | PCE |  |  | 0 |  | 5002 SW
EL-SW0013 | SWITCH MINIATURE SNAP ACTION |  |  | PCE |  |  | 0 |  | MS0850505F065C1A-ND
EL-SW0014 | TRENDnet 24-Port Unmanaged Gigabit GREENnet Desktop Switch (24 x Gigabit Auto-MDIX RJ-45 Ports) TEG-S24Dg (Black Metal) |  |  | PCE |  |  | 0 |  | 0
EL-SW0015 | TRENDnet 16-Port Unmanaged 10/100 Mbps GREENnet Ethernet Desktop Metal Housing Switch, TE100-S16EG |  |  | PCE |  |  | 0 |  | N82E16833156273
EL-SW0016 | Rocker Switches & Paddle Switches SPST ROCKER SWITCH 16A 250V |  |  | PCE |  |  | 0 |  | 103-R13-112A-02-EV
EL-SW0017 | TRENDnet 8-Port Unmanaged Gigabit GREENnet Desktop Metal Housing Switch, TEG-S80g |  |  | PCE |  |  | 0 |  | 0
EL-SW0018 | TRENDnet 24-Port Unmanaged Gigabit GREENnet Desktop Metal Housing Switch, TEG-S24Dg |  |  | PCE |  |  | 0 |  | 0
EL-SW0019 | TRENDnet Rack Mount Kit, TEG-S24Dg |  |  | PCE |  |  | 0 |  | 0
EL-SW0020 | Switch Rocker DPST 20A 125V |  |  | PCE |  |  | 0 |  | R5ABLKBLKFF0
EL-SW0021 | Switch SIM Roll SPDT 3A 125V | Buy |  | PCE | $0.59 | Omron | SS-3GL13PT | TTI | SW768-ND |  | Received 7,349 pcs 8,175 pc balance due 10/25 TTI 22,000 on hand AO.
EL-SW0022 | SWITCH BASIC SPDT 3A .110QC 125V |  | YES | PCE | 0.42 | 0 | SS-3GPT | TTI | SS-3GPT | SW766-ND | TTI 18-20 wk Ltime Interium stock ordered Cyclop Electronics – until Heilind stock available | 0 | 0 | 0 | 0 | 0
EL-SW0023 | SWITCH ROCKER DPST 20A 250V, Illuminated Red | Buy | YES | PCE | $1.25 | E-Switch | R5BBLKREDFF2 | Future / Cyclops | R5BBLKREDFF2 | 612-R5BBLKREDFF2
EL-SW0024 | SWITCH ROCKER DPST 20A 277V, RED Illuminated |  |  | PCE |  |  | 0 |  | 1091-1193-ND
EL-SW0025 | TRENDnet TE100-S16Eg Switches 12 to 16 Ports GREENnet Switch |  |  | PCE |  |  | 0 |  | N82E16833156273
EL-SW0026 | SWITCH ROCKER DPST 20A 125V - Green |  |  | PCE |  |  | 0 |  | R5BBHLKGRNFF2
EL-SW0027 | Sealed C&K Pushbutton Switches Module |  |  | PCE |  |  | 0 |  | 611-ESMK1215NCL130
EL-SW0028 | Pushbutton Switches PushBtn Switch SPST N.O. Economy Black |  |  | PCE |  |  | 0 |  | 706-30-601BLK
EL-SW0029 | Pushbutton Switches 0-2A 48VDC Off (On) 16mm Flat 1 Pole |  |  | PCE |  |  | 0 |  | 612-PV2F240NNM01
EL-SW0030 | Momentary Metal Flat Flush Mount Push Button Switch | Buy |  | PCE | $3.44 | Parts Express | 060-660 (Model Number 66-2436) | Parts Express | 060-660 (66-2436) |  | Received 3,050 pc
EL-SW0031 | Stainless Steel Push button momentary Switch |  |  | PCE |  |  | 0 |  | 0
EL-SW0032 | TRENDnet 5-Port Unmanaged Gigabit GREENnet Desktop Metal Housing Switch, TEG-S50g |  |  | PCE |  |  | TEG-S50g |  | TEG-S50g
EL-SW0033 | TP-LINK TL-SG105 5-Port Gigabit Ethernet Desktop Switch, 10/100/1000 Mbps,IEEE 802.1p QoS by TP-LINK |  |  | PCE |  |  | 0 |  | TL-SG105
EL-SW0034 | Schurter - SWITCH PUSHBUTTON SPDT 5A 125V |  |  | PCE |  |  | 1241.6631.1120000 |  | 486-1186-ND
EL-SW0035 | Bulgin - SWITCH PUSHBUTTON SPDT 5A 250V |  |  | PCE |  |  | MP0038 |  | 708-1297-ND
EL-SW0036 | Schurter - SWITCH PUSH SPST-NO 100MA 42V |  |  | PCE |  |  | 1241.3008 |  | 486-1546-ND
EL-SW0037 | Switch Push SPST-NO 3A 250V |  |  | PCE |  |  | 2213763-1 |  | 2213763.1
EL-SW0038 | EAO Switch Momentary, Non-Illuminated, Flat Lens, Screw Terminals |  |  | PCE |  |  | 82-5152.1000 |  | 82-5152.1000
EL-SW0039 | TP-LINK 16-Port Gigabit Ethernet Rackmount Switch (TL-SG1016D) by TP-LINK |  |  | PCE |  |  | 0 |  | TL-SG1016D
EL-TH0001 | 100k Honeywell Axial Thermistor |  |  | PCE |  |  | 135-104LAG-J01 |  | 785-135-104LAG-J01
EL-TH0002 | Thermistor, 100k heatbed (USE: 100k Epcos Thermistor) |  |  | PCE |  |  | 0 |  | 0
EL-TH0003 | 100k Epcos Thermistor |  |  | PCE |  |  | B57560G1104F |  | 871-B57560G104F
EL-TH0004 | Honeywell Thermistors - NTC ecncapsultd. CHIP |  |  | PCE |  |  | 0 |  | 785-135-104LAG-J01
EL-TH0005 | THERMISTOR NTC GLASS 100KOHM AXL |  |  | PCE |  |  | 0 |  | 480-3135-ND
EL-TH0006 | Thermistors - NTC 100KOHM 2% Axial Thermistor NTC GLASS |  |  | PCE |  |  | 135-104QAD-J01 |  | 785-135-104QAD-J01
EL-TH0007 | Thermistors - NTC 100kohm 3%, Semitec |  |  | PCE |  |  | 0 |  | 954-104GT-2
EL-TH0008 | Semitec GT2 thermistor for Hexagon 100kOhm, 23cm leads |  |  | PCE |  |  | 0 |  | 0
EL-TH0009 | NTC Thermistors 100kohm 3%, 4390 |  |  | PCE |  |  | 0 |  | 954-104NT-4-R025H43G
EL-TH0010 | NTC Thermistors 100kohm 3%, 4267 |  |  | PCE |  |  | 0 |  | 954-104NT-4-R025H43G
EL-TH0011 | Semitec GT2 Thermistor (100kOhm type) 23cm Leads with no connectors on end. |  | YES | PCE | 0.8 | Reprapdiscount | 0 | Reprapdiscount | Semitec104gt2 Thermistor
EL-TH0012 | Cartridge Style Thermistor with Molex Connector |  |  | PCE |  |  | 0 |  | 0
EL-VA0060 | Cable Molded RG58/U 48" |  |  | PCE |  |  | 0 |  | 290-1012-ND
EL-WR0001 | 20 AWG, red, 610mm |  |  | PCE |  |  | 0 |  | 0
EL-WR0002 | 20 AWG, black, 610mm |  |  | PCE |  |  | 0 |  | 0
EL-WR0003 | Wire, Red, 16AWG Stranded |  |  | PCE |  |  | 0 |  | 0
EL-WR0004 | Wire, Yellow, 16AWG Stranded |  |  | PCE |  |  | 0 |  | ALE-0000232
EL-WR0005 | 20 AWG, red, 100' Length |  |  | cm |  |  | 0 |  | B0002ZGBLK
EL-WR0006 | 20 AWG, black, 100' Length |  |  | cm |  |  | 0 |  | B0002ZGBME
EL-WR0007 | 22 AWG Two Strand Wire, 100' Length |  |  | cm |  |  | 0 |  | 0
EL-WR0008 | 24 AWG 3 Conductor Ribbon Cable, 100' Length |  |  | cm |  |  | 0 |  | 0
EL-WR0009 | Cerrowire 1,000 ft. 24/4-Gauge Category 5e Riser Gray Internet Wire |  |  | PCE |  |  | 0 |  | 48243994137
EL-WR0010 | 16 AWG 2 conductor wire, black |  |  | ft |  |  | 0 |  | 252-1001G3
EL-WR0011 | 20 AWG, High Temp Wire, red, 80mm |  |  | PCE |  |  | 0 |  | 0
EL-WR0012 | 20 AWG, High Temp Wire, red, 100' Length |  |  | ft, 100 |  |  | 0 |  | 602-2856/1-100-03
EL-WR0013 | HOOK-UP WIRE 100FT 18AWG TIN-COPPER BLK |  |  | ft |  |  | 0 |  | C2064B-100-ND
EL-WR0014 | 24 AWG, High Temp Wire, Orange, 100' Length |  |  | ft, 100 |  |  | 0 |  | 602-2854/1-100-08
EL-WR0015 | 20 AWG, High Temp Wire, red, 140mm |  |  | PCE |  |  | 0 |  | 0
EL-WR0016 | 24 AWG, High Temp Wire, Orange, 140mm |  |  | PCE |  |  | 0 |  | 0
EL-WR0017 | 20 AWG, High Temp Wire, red, 300' Length |  |  | ft, 100 |  |  | 0 |  | ALE-0000024
EL-WR0019 | 22 AWG Two Strand Wire |  |  | PCE |  |  | 0 |  | 0
EL-WR0020 | 24 AWG 3 Conductor Ribbon Cable, 470mm |  |  | PCE |  |  | 0 |  | 0
EL-WR0021 | 24 AWG 3 Conductor Ribbon Cable, 680mm |  |  | PCE |  |  | 0 |  | 0
EL-WR0022 | 24 AWG 3 Conductor Ribbon Cable, 850mm |  |  | PCE |  |  | 0 |  | 0
EL-WR0023 | 24 AWG 2 conductor wire, black, 600mm |  |  | PCE |  |  | 0 |  | 0
EL-WR0024 | Economy Servo Wire 24 AWG - Futaba Colors |  |  | ft |  |  | 0 |  | HH-SW_EC_24_FU
EL-WR0025 | Deluxe Servo Wire 22AWG - Futaba Colors |  |  | ft |  |  | 0 |  | HH-SW_DX22_FU
EL-WR0026 | 20 AWG, blue, 100' Length |  |  | cm |  |  | 0 |  | C2003L-100-ND
EL-WR0027 | 20 AWG, High Temp Wire, red, 180mm |  |  | PCE |  |  | 0 |  | 602-2856-1-100-03
EL-WR0029 | Deluxe 22AWG Servo Wire - Futaba Colors |  |  | ft |  |  | 0 |  | 0
EL-WR0030 | Deluxe 22AWG Servo Wire - Futaba Colors (300ft) |  |  | ft |  |  | 0 |  | HH-SW_DX22_FU (300ft)
EL-WR0031 | Deluxe 22 AWG Battery Wire (10ft) |  |  | PCE |  |  | 0 |  | HH-BW_DX22
EL-WR0032 | Deluxe 22AWG Battery Wire (300ft) |  |  | ft |  |  | 0 |  | HH-BW_DX22 (300ft)
EL-WR0033 | Stranded Single-Conductor Wire, UL 1007/1569, 16 AWG, 300 VAC, Purple |  |  | PCE |  |  | 0 |  | ALE-0000095
EL-WR0034 | Stranded Single-Conductor Wire, UL 1007/1569, 16 AWG, 300 VAC, Red |  |  | PCE |  |  | 0 |  | 7587K962
EL-WR0035 | Stranded Single-Conductor Wire, UL 1007/1569, 24 AWG, 300 VAC, Yellow by ft |  |  | PCE |  |  | 0 |  | 7587K923
EL-WR0036 | Wire - Single Conductor 24 AWG Yellow, 100' |  |  | ft |  |  | 0 |  | 8073K621
EL-WR0037 | Easy-ID Low Voltage Cable, 24/2 AWG, .11" w X .06" thickness, 12 VDC |  |  | PCE |  |  | 0 |  | 9697T1
EL-WR0038 | Cerrowire 250 ft. Black 16/2 Lamp Cord |  |  | PCE |  |  | 0 |  | 48243437252
EL-WR0039 | Cable, Ribbon, 8 cond |  |  | PCE |  |  | 0 |  | 3365/08 100
EL-WR0040 | Wire - Single Conductor 20AWG SOLID PTFE, RED | Buy |  | ft | $0.00 | Alpha Wire | 2856/1 | Allcable | 602-2856/1-100-03 |  | received
EL-WR0040-old | Wire - Single Conductor 20AWG SOLID PTFE 100ft SPOOL RED (OLD) |  |  | PCE |  |  | 0 |  | 602-2856/1-100-03
EL-WR0041 | Wire - Single Conductor 24AWG SOLID PTFE 100ft SPOOL ORANGE |  |  | ft |  |  | 0 |  | 602-2854/1-100-08
EL-WR0041-old | Wire - Single Conductor 24AWG SOLID PTFE 100ft SPOOL ORANGE (OLD) |  |  | PCE |  |  | 0 |  | 602-2854/1-100-08
EL-WR0042 | Headers & Wire Housings .100"RCPYT 2X5" |  |  | PCE |  |  | 0 |  | 649-71600-310LF
EL-WR0043 | Headers & Wire Housings 10P SR HEADER |  |  | PCE |  |  | 0 |  | 649-69190-410HLF
EL-WR0044 | Headers & Wire Housings 12P SR UNSHRD HRD TIN OVER NI |  |  | PCE |  |  | 0 |  | 649-68000-412HLF
EL-WR0045 | Headers & Wire Housings 16 CON STR BRDMNT SKT |  |  | PCE |  |  | 0 |  | 517-929974-01-16-RK
EL-WR0046 | Headers & Wire Housings 16P 1ROW STRT SOCKET |  |  | PCE |  |  | 0 |  | 517-974-01-16
EL-WR0047 | Headers & Wire Housings 22-24 TERMINAL BULK FEMALE |  |  | PCE |  |  | 0 |  | 538-16-02-0102
EL-WR0048 | Headers & Wire Housings 4 CKT VERT HEADER |  |  | PCE |  |  | 0 |  | 538-39-28-1043
EL-WR0049 | Headers & Wire Housings 4P STRT BRD MNT SKT 2 ROW 10MICRO AU |  |  | PCE |  |  | 0 |  | 517-929852-01-02-RA
EL-WR0050 | Headers & Wire Housings BOARDMOUNT SOCKET Female Header |  |  | PCE |  |  | 0 |  | 517-929974-01-36-RK
EL-WR0051 | Headers & Wire Housings CLOSED WITH TABS 2P red tin 22 AWG |  |  | PCE |  |  | 0 |  | 571-3-643813-2
EL-WR0052 | Headers & Wire Housings CLOSED WITH TABS 3P red tin 22 AWG |  |  | PCE |  |  | 0 |  | 571-3-643813-3
EL-WR0053 | Headers & Wire Housings CLOSED WITH TABS 4P red tin 22 AWG |  |  | PCE |  |  | 0 |  | 571-3-643813-4
EL-WR0054 | Stranded Single-Conductor Wire, UL 1007/1569, 16 AWG, 300 VAC, Black, per foot |  |  | ft |  |  | 0 |  | 0
EL-WR0055 | Stranded Single-Conductor Wire, UL 1007/1569, 16 AWG, 300 VAC, Gray, per foot |  |  | ft |  |  | 0 |  | 0
EL-WR0057 | Coleman Cable 100ft Black Primary Wire (12-100-17) |  |  | PCE |  |  | 0 |  | 83180
EL-WR0058 | Jumper Wire Kit |  |  | PCE |  |  | 0 |  | COM-00124
EL-WR0070 | Headers & Wire Housings 18P STR DR TMT HDR .76 AU .425IN LENGTH 2x18 |  |  | PCE |  |  | 0 |  | 649-77313-101-18LF
EL-WR0072 | Headers & Wire Housings 8 PIN STACKABLE MALE HEADER, TH |  |  | PCE |  |  | 0 |  | 649-77313-101-18LF
EL-WR0073 | Headers & Wire Housings ECONOMY SHUNT Jumper |  |  | PCE |  |  | 0 |  | A31697-ND
EL-WR0074 | Headers & Wire Housings HSG 2P SINGLE ROW POSITIVE LATCH |  |  | PCE |  |  | 0 |  | 538-50-57-9402
EL-WR0075 | Headers & Wire Housings OPEN TOP .100 GOLD PLATED |  |  | PCE |  |  | 0 |  | 737-MSB-G
EL-WR0076 | Headers & Wire Housings POLARIZED HEADER 2P Right Angle Post tin |  |  | PCE |  |  | 0 |  | 571-6404552
EL-WR0077 | Headers & Wire Housings POLARIZED HEADER 3P Right Angle Post tin |  |  | PCE |  |  | 0 |  | 571-6404553
EL-WR0078 | Headers & Wire Housings POLARIZED HEADER 4P Right Angle Post tin |  |  | PCE |  |  | 0 |  | 571-6404554
EL-WR0079 | 842 Degree F Braided Wire 20 AWG, .105" OD, 600 VAC/VDC, Tan |  |  | PCE |  |  | 0 |  | 8209K11
EL-WR0080 | ALPHA WIRE, ORG, 24AWGM 1/24AWG, 30.5M |  |  | PCE |  |  | 0 |  | 2854/1 OR005
EL-WR0081 | Aluminum Wire, 19 gauge, 50 ft |  |  | PCE |  |  | 0 |  | 0
EL-WR0082 | ScotchLok Inline 4-wire 19-24 AWG |  |  | PCE |  |  | 0 |  | U1R20017-ND
EL-WR0083 | Static-Free Fluxed Copper Braid, 1/32" Width, 10' Length |  |  | PCE |  |  | 0 |  | 76855A8
EL-WR0084 | Stranded Single Conductor Wire, UL 1007/1569, 24 AWG, 300 VAC, Orange, 100' Length |  |  | ft, 100 |  |  | 0 |  | 7587K929
EL-WR0085 | Stranded Single-Conductor Wire, UL 1007/1569, 24 AWG, 300 VAC, Black, 100' Length |  |  | ft, 100 |  |  | 0 |  | 7587K921
EL-WR0086 | Stranded Single-Conductor Wire, UL 1007/1569, 24 AWG, 300 VAC, Blue, 100' Length |  |  | ft, 100 |  |  | 0 |  | 7587K28
EL-WR0087 | Stranded Single-Conductor Wire, UL 1007/1569, 24 AWG, 300 VAC, Green, 100' Length |  |  | ft, 100 |  |  | 0 |  | 7587K19
EL-WR0088 | Stranded Single-Conductor Wire, UL 1007/1569, 24 AWG, 300 VAC, Purple, 100' Length |  |  | ft, 100 |  |  | 0 |  | 7587K075
EL-WR0089 | Stranded Single-Conductor Wire, UL 1007/1569, 24 AWG, 300 VAC, Red, 100' Length |  |  | ft, 100 |  |  | 0 |  | 7587K922
EL-WR0090 | Wire - Single Conductor 16AWG 19/29 PTFE 100' SPOOL VIOLET |  |  | PCE |  |  | 0 |  | 602-5858-100-10
EL-WR0091 | Wire - Single Conductor 16AWG Purple, 100' |  |  | ft |  |  | 0 |  | 7587K079
EL-WR0092 | Greg's Wade Reloaded Extruder |  |  | PCE |  |  | 0 |  | 0
EL-WR0092 | Wire - Two Conductor 24 AWG Red and Black, 1' |  |  | ft |  |  | 0 |  | 0
EL-WR0093 | Stranded Single-Conductor Wire, 16 AWG, White |  |  | PCE |  |  | 0 |  | 0
EL-WR0094 | Stranded Single-Conductor Wire, 24 AWG, Yellow |  |  | PCE |  |  | 0 |  | 0
EL-WR0095 | Stranded Single-Conductor Wire, 16 AWG, Yellow |  |  | PCE |  |  | 0 |  | 0
EL-WR0097 | Wire, Shielded, 4 cond, 22 AWG |  |  | PCE |  |  | 0 |  | 0
EL-WR0098 | Cable 25Cond Ribbon LT GRY |  |  | ft |  |  | 0 |  | HF-365/25SF
EL-WR0099 | Shielded 22AWG UL2464 4 COND | Buy |  | ft | $0.00 | Allcable | C0762A.41.10 | Allcable | C0762A.41.10 | W504-100-ND | received
EL-WR0101 | (obsolete) 16AWG Stranded – Violet |  |  | PCE |  |  | 0 |  | C2065V-1000-ND
EL-WR0102 | (obsolete) 24AWG Stranded – Yellow |  |  | PCE |  |  | 0 |  | C2015Y-1000-ND
EL-WR0103 | 24AWG Stranded – Red | Buy |  | ft | $0.00 | Allcable | HU1569247RD | Allcable | C2015R-1000-ND |  | received
EL-WR0104 | 24AWG Stranded – Orange | Buy |  | ft | $0.00 | Allcable | HU1569247OE | Allcable | HU1569247OE |  | received
EL-WR0105 | 24AWG Stranded – Black | Buy |  | ft | $0.00 | Allcable | HU1569247BK | Allcable | HU1569247BK |  | received
EL-WR0106 | 16AWG Stranded – Red | Buy |  | ft | $0.00 | Allcable | HU15691626RD | Allcable | HU15691626RD | C2065R-1000-ND | Received 17,000 ft
EL-WR0107 | 24AWG Stranded – White | Buy |  | ft | $0.00 | Allcable | HU1569247WE | Allcable | HU1569247WE |  | received
EL-WR0108 | 16AWG Stranded – Violet |  |  | ft |  |  | 0 |  | 78R8060
EL-WR0109 | 24AWG Stranded – Yellow | Buy |  | ft | $0.00 | Allcable | HU1569247YW | Allcable | HU1569247YW |  | received
EL-WR0110 | 16AWG Stranded - Yellow |  |  | ft |  |  | 0 |  | C2065Y-100-ND
EL-WR0111 | 24AWG Stranded – Blue | Buy |  | ft | $0.00 | Allcable | HU1569247BE | Allcable | HU1569247BE |  | received
EL-WR0112 | 24AWG Stranded – Red (use EL-WR0103) |  |  | ft |  |  | 0 |  | HU1569247RD
EL-WR0113 | Headers & Wire Housings HSG 4P W/O EARS SINGLE ROW, Molex 70107-0003 |  |  | PCE |  |  | 0 |  | 538-70107-0003
EL-WR0114 | HOOK-UP STRND 16AWG BLACK 100' |  |  | ft |  |  | 0 |  | C2065B-100-ND
EL-WR0115 | HOOK-UP STRND 16AWG GREEN 100' |  |  | ft |  |  | 0 |  | C2065G-100-ND
EL-WR0116 | HOOK-UP STRND 16AWG WHITE 100' |  |  | ft |  |  | 0 |  | C2065W-100-ND
EL-WR0117 | RGB 4 Wire Cable |  |  | PCE |  |  | 0 |  | SA-LS-ACC-001
EL-WR0118 | 24AWG Stranded Wire – Blue (Use EL-WR0111) |  |  | ft |  |  | 0 |  | C2015L-100-ND
EL-WR0119 | 24AWG Stranded Wire – Green | Buy |  | ft | $0.00 | Allcable | HU1569247GN | Allcable | HU1569247GN |  | received
EL-WR0120 | 24AWG Stranded Wire – Purple | Buy |  | ft | $0.00 | Allcable | HU1569247VT | Allcable | HU1569247VT |  | received
EL-WR0121 | 16AWG Stranded Wire – Black | Buy |  | ft | $0.00 | Allcable | HU15691626BK | Allcable | HU15691626BK |  | Received 26,000 ft
EL-WR0122 | 16AWG Stranded Wire – Green |  |  | ft |  |  | 0 |  | C2065G-100-ND
EL-WR0123 | 16AWG Stranded Wire – White | Buy |  | ft | $0.00 | Allcable | HU15691626WE | Allcable | HU15691626WE | C2065W-100-ND | Received 15,000 ft
EL-WR0124 | 16AWG Stranded – Green w/ yellow stripe | Buy |  | mm | $0.00 | Allcable | HU15691626GN | Allcable | HU15691626GN | HU15691626GN | Received 4,000 ft
EL-WR0124 (old) | (OLD) 16AWG Stranded – Green w/ yellow stripe |  |  | PCE |  |  | 0 |  | 0
EL-WR0125 | Multi-Conductor Cables 16AWG 4C UNSHLD, BLACK |  |  | mm |  |  | 0 |  | 566-1308A-U500-10
EL-WR0126 | Hook-up Wire 28AWG SOLID PTFE, WHT |  |  | mm |  |  | 0 |  | 602-2842/1-100-01
EL-WR0127 | Hook-up Wire 26AWG SOLID PTFE, WHT |  |  | mm |  |  | 0 |  | 2843/1 WH005
EL-WR0128 | Hook-up Wire 28AWG KYNAR INSUL 100' SPOOL BLUE |  |  | mm |  |  | 0 |  | 801-R28B
EL-WR0129 | Multi-Paired Cables 24AWG9PR SHIELD 100ft SPOOL SLATE |  |  | PCE |  |  | 0 |  | 602-5479C-100
EL-WR0130 | Wire, HOOK-UP STRND 28AWG BLACK 100' |  |  | PCE |  |  | 0 |  | 6710 BK005-ND
EL-WR0131 | Wire, HOOK-UP STRND 28AWG RED 100' |  |  | PCE |  |  | 0 |  | 6710 RD005
EL-WR0132 | INSULTHERM TRU-FIT 16AWG 500' |  |  | PCE |  |  | FGLG.16BK |  | 1030-1124-ND
EL-WR0133 | INSULTHERM TRU-FIT 18AWG |  |  | PCE |  |  | FGLG.18BK |  | 1030-1124-ND
EL-WR0134 | INSULTHERM TRU-FIT 20AWG |  |  | PCE |  |  | FGLG.20BK |  | 1030-1124-ND
EL-WR0135 | WIRE MTW 16AWG PPL 500ft SPOOL 600V 26-STRAND BARE COPPER - Purple | Buy |  | ft | $0.00 | Allcable | MTW16PL25 | Allcable | MTW16PL |  | received
EL-WR0136 | Hook-up Wire 20AWG 600V MICA 100ft SPOOL TAN |  |  | ft, 100 |  |  | 3112010 TN005 |  | 3112010 TN005
EL-WR0137 | igus 2-Wire 16AWG Chainflex Cable |  |  | PCE |  |  | CF9-15-02 |  | CF9-15-02
EL-WR0138 | igus 6-Wire Chainflex® CF9 Control Cable TPE |  | 0 | mm | 0 | Igus | CF9-02-06 | 0 | CF9-02-06 | 0 | 0 | 0 | 0 | 0 | 0 | 0
EL-WR0139 | igus 12-Wire Chainflex® CF9 Control Cable TPE |  |  | mm |  |  | CF9-02-012 |  | CF9-02-012
EL-WR0140 | igus 4-Wire Chainflex® CF11 Data Cable TPE |  | 0 | mm | 0 | Igus | CF11-02-02-02 | 0 | CF11-02-02-02 | 0 | 0 | 0 | 0 | 0 | 0 | 0
EL-WR0141 | igus Chainflex® CF9 control cable TPE |  |  | mm |  |  | CF9-02-02 |  | CF9-02-02
HD-BL0000 | Belt GT2 2mm, 516 tooth, Neoprene |  |  | PCE |  |  | 0 |  | 0
HD-BL0001 | Belt, T5 860mm, Y-axis |  |  | PCE |  |  | 0 |  | 0
HD-BL0002 | Belt, T5 910mm, X-axis |  |  | PCE |  |  | 0 |  | 0
HD-BL0003 | Belt, T5 |  |  | ft |  |  | 0 |  | B6T5-MPS
HD-BL0004 | Belt, T5 840mm |  |  | PCE |  |  | 0 |  | QB-T5-0840-06
HD-BL0005 | Belt, T5 1380mm |  |  | PCE |  |  | 0 |  | QB-T5-1380-06
HD-BL0007 | 6T2.5 Open End Belt Roll Polyurethane with Steel Cords |  |  | PCE |  |  | 0 |  | B6T2.5-MPS
HD-BL0008 | GT2, Single sided Neoprene Belt, 2mm pitch, 628 teeth, 6mm wide,fiberglass cords |  |  | PCE |  |  | 0 |  | ALE-0000080
HD-BL0009 | 1164-2P-06-2MR-1164-06 / GT 2 Single Sided Neoprene Belt - 1164mm by 6mm belt | Buy |  | PCE | $2.54 | B&B Manufacturing | 1164-2P-06 (2MR-1164-06) | B&B Manufacturing | 1164-2P-06 - 2MR-1164-06 |  | Received 3,050 pcs with 3050 balance due 9/22 confirmed
HD-BL0010 | Belt, T5, per foot |  |  | PCE |  |  | 0 |  | 0
HD-BL0011 | DONTUSE. 1164-2P-06 - 2MR-1164-06. Use [HD-BL0009] GT2 1164mm by 6mm belt |  |  | PCE |  |  | 0 |  | 0
HD-BL0012 | GT2 (3mm) Pitch, 308 Teeth, 6mm (.236) Wide Neoprene Belt |  |  | PCE |  |  | 0 |  | A 6R53M308060
HD-BL0013 | GT2 (3mm) Pitch, 350 Teeth, 6mm (.236) Wide Neoprene Belt |  |  | PCE |  |  | 0 |  | A 6R53M350060
HD-BL0014 | DRIVE BELT |  |  | PCE |  |  | 0 |  | 89140301004
HD-BL0015 | Timing belt, 372 teeth, GT2 2mm pitch, 744 mm pitch length, 6 mm belt width, Neoprene |  | 0 | PCE | 1.93 | 0 | 0 | B & B Manufacturing, Inc | 744-2P06-2MR-744-06 | 744-2P-06 (2MR-744-06) | 0 | 0 | 0 | 0 | 0 | 0
HD-BT0001 | M3 x 14 Bolt, SHCS Black-oxide |  |  | PCE |  |  | 0 |  | 8050-0314
HD-BT0002 | Hobbed Bolt, plain steel |  |  | PCE |  |  | 0 |  | 0
HD-BT0003 | M4 x 50 Hex Head Bolt |  |  | PCE |  |  | 0 |  | 91280A154
HD-BT0004 | M8 x 60 Hex Head Bolt, Stainless Steel |  |  | PCE |  |  | 0 |  | 91287A160
HD-BT0005 | M3 x 10 Bolt, SHCS Black-oxide |  |  | PCE |  |  | 0 |  | 8050-0310
HD-BT0006 | M3 x 16 Bolt, SHCS Black-oxide |  |  | PCE |  |  | 0 |  | 8050-0316
HD-BT0007 | M3 x 20 Bolt, SHCS Black-oxide |  |  | PCE |  |  | 0 |  | 91290A123
HD-BT0008 | M3 x 25 Bolt, SHCS Black-oxide |  |  | PCE |  |  | 0 |  | 8050-0325
HD-BT0009 | M3 x 35 Bolt, SHCS Black-oxide |  |  | PCE |  |  | 0 |  | N/A
HD-BT0010 | M4 x 20 Bolt, SHCS Black-oxide | Buy |  | PCE | $0.01 | Fastenal | 1139527 | Fastenal | 1139527 | 91290A168 | Received 4,000 pc (PO for complete Olivebranch Build, Monthly qtys identified and will be delivered when we signal Fastenal.)
HD-BT0011 | M8 x 30 Bolt, SHCS Black-oxide |  |  | PCE |  |  | 0 |  | 91290A434
HD-BT0012 | M3 Set Screw (Grub Screw) | Buy |  | PCE | $0.02 | Fastenal | 40818 | Fastenal | 40818 | 91390A100 | Received 22,000 pc (PO for complete Olivebranch Build, Monthly qtys identified and will be delivered when we signal Fastenal.)
HD-BT0013 | M3 x 12 Bolt, SHCS Black-oxide |  |  | PCE |  |  | 0 |  | 8050-0312
HD-BT0014 | M3 Phillips Machine Screw, Zinc plated steel, 10mm |  |  | PCE |  |  | 0 |  | 92005A120
HD-BT0015 | M3 Phillips Machine Screw, Zinc plated steel, 25mm |  |  | PCE |  |  | 0 |  | 92005A130
HD-BT0016 | M3 Phillips Machine Screw, Zinc plated steel, 40mm |  |  | PCE |  |  | 0 |  | 92005A135
HD-BT0017 | M4 Phillips Machine Screw, Zinc plated steel, 20mm |  |  | PCE |  |  | 0 |  | 92005A228
HD-BT0018 | Metric 8.8 Zinc-Plated Steel Hex Head Cap Screw, M8 Size, 60MM Length, 1.25MM Pitch, Partially Thread, |  |  | PCE |  |  | 0 |  | 91280A550
HD-BT0019 | M3 x 40 Bolt, SHCS Black-oxide |  |  | PCE |  |  | 0 |  | 91290A136
HD-BT0020 | M3 x 5 Bolt, SHCS Black-oxide |  |  | PCE |  |  | 0 |  | 91290A110
HD-BT0021 | M5 x 10 Bolt, SHCS Black-oxide |  |  | PCE |  |  | 0 |  | 91290A224
HD-BT0022 | M5 x 45 Bolt, BHCS, Plain Steel |  |  | PCE |  |  | 0 |  | 0
HD-BT0023 | M8 x 35 Bolt, SHCS Black-oxide |  |  | PCE |  |  | 0 |  | 0
HD-BT0025 | M4 x 55 Hex Head Bolt |  |  | PCE |  |  | 0 |  | 0
HD-BT0027 | M5 x 16 Bolt, BHCS Black-oxide |  |  | PCE |  |  | 0 |  | 0
HD-BT0028 | Hobbed Bolt, M8 x 60mm Hex head, Stainless Steel |  |  | PCE |  |  | 0 |  | 0
HD-BT0029 | Metric Class 12.9 Socket Head Cap Screw Alloy Steel, M3 Thread, 40mm Length, 0.50mm Pitch |  |  | PCE |  |  | 0 |  | 91290A136
HD-BT0030 | Metric 8.8 Zinc-Pltd Steel Hex Head Cap Screw M4 Size, 20mm Length, .7mm Pitch, Fully Threaded |  |  | PCE |  |  | 1138525 |  | 91280A140
HD-BT0031 | Metric 18-8 Stainless Steel Cup Point Socket Set Screw, M3 size, 4MM Length, .5MM pitch |  |  | PCE |  |  | 0 |  | 92015A102
HD-BT0032 | M8 x 60 Hex Head Bolt, Zinc Plated Steel |  |  | PCE |  |  | 0 |  | 0
HD-BT0033 | Metric Class 12.9 Socket Head Cap Screw Alloy Steel, M4 Thread, 60mm Length, 0.70mm Pitch, packs of 25 |  |  | PCE |  |  | 0 |  | 91290A188
HD-BT0034 | Metric Zinc Yellow Plated Steel Hex Head Cap Screw, class 10.9, M8 sz, 50MM length, 1.25MM pitch |  |  | PCE |  |  | 0 |  | 95327A577
HD-BT0035 | Metric Class 12.9 Socket Head Cap Screw Alloy Steel, M8 Thread, 55mm Length, 1.25mm Pitch |  |  | PCE |  |  | 0 |  | 91290A452
HD-BT0036 | M8 x 55 Hex Head Bolt |  |  | PCE |  |  | 0 |  | 0
HD-BT0037 | M3-0.5, 8, SS 316 Phillips Pan Head Sheet Metal Screw |  |  | PCE |  |  | 0 |  | ALE-0000143
HD-BT0038 | Metric Class 12.9 Socket Head Cap Screw Alloy Steel, M2 Thread, 12mm Length, 0.4mm Pitch |  |  | PCE |  |  | 0 |  | 91290A019
HD-BT0039 | Metric Class 12.9 Socket Head Cap Screw, Alloy Steel, M3 Thread, 12MM Length, 0.50MM Pitch | Buy |  | PCE | $0.01 | Fastenal | 39505 | Fastenal | 39505 | 91290A117 | Received 24,000 pc balance will be delivered when we signal Fastenal
HD-BT0040 | Metric Class 12.9 Socket Head Cap Screw, Alloy Steel, M3 Thread, 20MM Length, 0.50MM Pitch, Packs of 100 |  |  | PCE |  |  | 0 |  | 91290A123
HD-BT0041 | Metric Class 12.9 Socket Head Cap Screw Alloy Steel, M3 Thread, 25mm Length, 0.50mm Pitch | Buy |  | PCE | $0.03 | Fastenal | 39508 | Fastenal | 39508 | 91290A125 | Ordered 9/30, will deliver 10/4/16 on hand qty from Extruders orders if needed.
HD-BT0042 | Metric Class 12.9 Socket Head Cap Screw, Alloy Steel, M3 Thread, 30MM Length, 0.50MM Pitch, packs of 100 |  |  | PCE |  |  | 0 |  | 91290A130
HD-BT0043 | Metric Class 12.9 Socket Head Cap Screw, Alloy Steel, M3 Thread, 35MM Length, 0.50MM Pitch |  |  | PCE |  |  | 0 |  | 91290A135
HD-BT0044 | Metric Class 12.9 Socket Head Cap Screw, Alloy Steel, M3 Thread, 5MM Length, 0.50MM Pitch |  | 0 | PCE | 0.0222 | Fastenal | 39501 | Fastenal | 91290A110 | 39501 | 3000 pcs requested delivery 10/19 | 0 | 0 | 0 | 0 | 0
HD-BT0045 | Metric Class 12.9 Socket Head Cap Screw, Alloy Steel, M3 Thread, 8MM Length, 0.50MM Pitch, Packs of 100 |  |  | PCE |  |  | 0 |  | 91290A113
HD-BT0046 | Metric Class 12.9 Socket Head Cap Screw, Alloy Steel, M4 thread, 16MM length, 0.70MM Pitch |  |  | PCE |  |  | 0 |  | 91290A154
HD-BT0048 | Metric Class 12.9 Socket Head Cap Screw Alloy Steel, M5 Thread, 10mm Length, 0.80mm Pitch |  | 0 | PCE | 0.021 | Fastenal | 39544 | Fastenal | 91290A224 | 39544 | Bin stock program Provided Fastenal totals for Foxglove demand and totals needed | Mcmaster | 91290A224 | 0 | 0 | 0
HD-BT0049 | Metric Class 12.9 Socket Head Cap Screw, Alloy Steel, M5 thread, 14MM length, 0.80MM pitch | Buy |  | PCE | $0.02 | Fastenal | 1139539 | Fastenal | 1139539 | 91290A230 | Received 12,000 pc (PO for complete Olivebranch Build, Monthly qtys identified and will be delivered when we signal Fastenal.)
HD-BT0050 | Metric Class 12.9 Socket Head Cap Screw, Alloy Steel, M8 Thread, 30MM length, 1.25MM pitch |  |  | PCE |  |  | 0 |  | 91290A452
HD-BT0051 | Metric Class 12.9 Socket Head Cap Screw, Alloy Steel, M8 Thread, 50MM Length, 1.25MM Pitch, packs of 25 |  |  | PCE |  |  | 0 |  | 91290A448
HD-BT0052 | Metric Class 12.9 Socket Head Cap Screw M4 Thread, 55mm Length, 0.70mm Pitch | Buy |  | PCE | $0.08 | Fastenal | ZT2530055PF000 | Fastenal | ZT2530055PF0000 | 91290A187 | Received 4,000 pc (PO for complete Olivebranch Build, Monthly qtys identified and will be delivered when we signal Fastenal.)
HD-BT0053 | 18-8 Stainless Steel Flat Head Phillips Machine Screw, Black-Oxide Finish, 4-40 Thread, 1/4" Length | Buy |  | PCE | $0.02 | Fastenal | 145202 | McMaster-Carr | 96640A054 |  | PO for complete Olivebranch Build, Monthly qtys identified and will be delivered when we signal Fastenal.
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
