gralco/TAZ6/production_docs/TAZ_6.02_BOM.ods

Sheet: BOM Structure
BOM Name | Level | Product Reference | Product Name | Quantity | Unit of Measure | Reference
LulzBot TAZ 3D Printer, v6.0 Boxed for Retail, NA |  | KT-PR0041NA | LulzBot TAZ 3D Printer, v6.0 Boxed for Retail, NA | 1 | PCE
 | > | AS-PR0001 | TAZ6, Olive Oil, Calibrated Assembly | 1 | PCE
 | > > | AS-PR0002 | TAZ6, Print Bed Assembly | 1 | PCE
 | > > > | PC-BD0027 | Silicon Heater, 24V ,360W, 298mm x 298mm, Self Adhesive, w/ connectors | 1 | PCE
 | > > > | HD-MS0002-3 | Borosilicate Glass Bed 300mm x 300mm x 1/8" | 1 | PCE
 | > > > | HD-MS0349 | PEI (10mil) with 3M 468 adhesive attached, heat-treated, TAZ | 1 | PCE
 | > > > > | HD-MS0311 | SULT1000NA.010X26.000X90FT - 0.010 X 26.000 WIDE X 90 FT NAT ULTEM 1000 FILM | 1024 | cm²
 | > > > > | HD-MS0310 | TAPE3M468MP.005X26.000X60YD .005" THK 3M ADHESIVE 468MP 26" WIDE X 60 YARDS | 1024 | cm²
 | > > > | EL-MS0073 | Tubing Corrugated Loom .25", Black, 3200' Box | 60 | mm
 | > > > | HD-MS0058 | Wire Tie, 8" Black, pk 1000 | 1 | PCE
 | > > | DC-MS0049 | Test/Acceptance record TAZ 6.0 | 1 | PCE
 | > > | AS-PR0003 | TAZ6, Olive Oil, Final Mechanical Assembly | 1 | PCE
 | > > > | PP-GP0154 | Electronics Case Mount v1.0 | 4 | PCE
 | > > > > | RM-AB0082 | Black ABS 3mm Filament, 5lb Reel Village Plastics | 4.19 | g
 | > > > | HD-WA0040 | Black-Oxide 18-8 Stainless Steel Flat Washer, M5 Screw Size, 5.3mm ID, 10.0mm OD | 8 | PCE
 | > > > | HD-WA0038 | Black-Oxide 18-8 Stainless Steel Flat Washer, M3 Screw Size, 3.2mm ID, 7.0mm OD | 11 | PCE
 | > > > | HD-RD0047 | 12mm X 515mm Stainless Steel Smooth Rod | 2 | PCE
 | > > > | HD-NT0053 | T-Slot Slide in T-nuts for Aluminum Frame, M5 | 4 | PCE
 | > > > | HD-MS0351 | Helical Flexible Shaft Coupling with Set Screw - X10835-5mm-5mm - Anodize IAW HPS1000 | 2 | PCE
 | > > > | HD-MS0336 | Black Adhesive-Back Bumper, Square, Polyurethane, 3/4" Wide, 1/4" High | 4 | PCE
 | > > > | HD-MS0058 | Wire Tie, 8" Black, pk 1000 | 7 | PCE
 | > > > | HD-BT0148 | Class 10.9 Steel Button-Head Socket Cap Screw, M3 Size, 10 mm Length, .5 mm Pitch | 8 | PCE
 | > > > | HD-BT0039 | Metric Class 12.9 Socket Head Cap Screw, Alloy Steel, M3 Thread, 12MM Length, 0.50MM Pitch | 3 | PCE
 | > > > | HD-BT0073 | Class 10.9 Stl Button Head Socket Cap Screw M5 Size, 10 Mm Length, .8 Mm Pitch | 8 | PCE
 | > > > | HD-BT0012 | M3 Set Screw (Grub Screw) | 4 | PCE
 | > > > | HD-BL0009 | 1164-2P-06-2MR-1164-06 / GT 2 Single Sided Neoprene Belt - 1164mm by 6mm belt | 1 | PCE
 | > > > | EL-MT0029 | NEMA 17 Stepper Motor, Moons' - NOT INCLUDING wire harness | 2 | PCE
 | > > > | HD-MS0055 | Metric Press-Fit Plastic Thumb Screw Head Knurled, Black, Fits M5 Screw, 16mm A, 6.5mm B | 4 | PCE
 | > > > | AS-PR0032 | TAZ6, Olive Oil, X Carriage Assembly | 1 | PCE
 | > > > > | HD-BT0146 | M3 x 12 BHCS, Black Oxide, Class 10.9 Steel | 11 | PCE
 | > > > > | PP-GP0207 | X Carriage Guide v2.0 | 1 | PCE
 | > > > > > | RM-AB0082 | Black ABS 3mm Filament, 5lb Reel Village Plastics | 6.12 | g
 | > > > > | HD-WA0038 | Black-Oxide 18-8 Stainless Steel Flat Washer, M3 Screw Size, 3.2mm ID, 7.0mm OD | 12 | PCE
 | > > > > | HD-BT0137 | M3 x 8 Bolt, BHCS, Black-Oxide | 1 | PCE
 | > > > > | AS-PR0035 | TAZ6, 12mm Single Bearing Holder with Bearing Assembly | 1 | PCE
 | > > > > > | HD-BU0029 | DryLin® R - Solid Precision Polymer Bearing RJMP-01, 12mm | 1 | PCE
 | > > > > > | RM-AB0082 | Black ABS 3mm Filament, 5lb Reel Village Plastics | 9.05 | g
 | > > > > | AS-PR0034 | TAZ6, 12mm Double Bearing Holder with Bearings Assembly | 1 | PCE
 | > > > > > | HD-BU0029 | DryLin® R - Solid Precision Polymer Bearing RJMP-01, 12mm | 2 | PCE
 | > > > > > | RM-AB0082 | Black ABS 3mm Filament, 5lb Reel Village Plastics | 22.65 | g
 | > > > > | AS-PR0033 | TAZ6, X carriage with Inserts Assembly | 1 | PCE
 | > > > > > | HD-MS0030 | Metric Brass Heat-Set Insert for Plastics Tapered, M3-.5 Internal Thread, 3.8mm Length | 15 | PCE
 | > > > > > | PP-GP0206 | X Carriage TAZ6 v0.3 | 1 | PCE
 | > > > > > > | RM-AB0082 | Black ABS 3mm Filament, 5lb Reel Village Plastics | 60.94 | g
 | > > > | AS-PR0021 | TAZ6, Olive Oil, Y Axis Assembly | 1 | PCE
 | > > > > | HD-RD0018 | 10mm Smooth Rod, Stainless Steel, 500mm | 2 | PCE
 | > > > > | PP-GP0238 | Flexy Bed Foot v0.1 | 4 | PCE
 | > > > > > | RM-TE0002 | Midnight NinjaFlex™ TPE Filament, 3mm, 0.75kg | 0.44 | g
 | > > > > | PP-GP0224 | Bed mount table v3.1 | 4 | PCE
 | > > > > > | RM-AB0082 | Black ABS 3mm Filament, 5lb Reel Village Plastics | 7.41 | g
 | > > > > | HD-WA0040 | Black-Oxide 18-8 Stainless Steel Flat Washer, M5 Screw Size, 5.3mm ID, 10.0mm OD | 24 | PCE
 | > > > > | AS-PR0030 | TAZ6, Y Axis Motor End Assembly | 1 | PCE
 | > > > > > | PP-MP0111 | Y End Plate v0.2 | 1 | PCE
 | > > > > > | HD-WA0038 | Black-Oxide 18-8 Stainless Steel Flat Washer, M3 Screw Size, 3.2mm ID, 7.0mm OD | 4 | PCE
 | > > > > > | HD-BT0148 | Class 10.9 Steel Button-Head Socket Cap Screw, M3 Size, 10 mm Length, .5 mm Pitch | 4 | PCE
 | > > > > > | HD-MS0030 | Metric Brass Heat-Set Insert for Plastics Tapered, M3-.5 Internal Thread, 3.8mm Length | 4 | PCE
 | > > > > > | PP-GP0226 | Y Motor Mount v3.0, TAZ | 1 | PCE
 | > > > > > > | RM-AB0082 | Black ABS 3mm Filament, 5lb Reel Village Plastics | 26.95 | g
 | > > > > | EL-HR0089 | Taz 6, Bed harness extension | 1 | PCE
 | > > > > > | PC-CN0061 | Male 8 pin Molex Connector Housing | 1 | PCE
 | > > > > > | EL-WR0119 | 24AWG Stranded Wire – Green | 360 | mm
 | > > > > > | EL-WR0111 | 24AWG Stranded – Blue | 500 | mm
 | > > > > > | EL-WR0104 | 24AWG Stranded – Orange | 500 | mm
 | > > > > > | EL-WR0103 | 24AWG Stranded – Red | 260 | mm
 | > > > > > | EL-MS0205 | Molex-CONN TERM MALE 22-24AWG TIN - Reels of 20K | 8 | PCE
 | > > > > > | EL-MS0142 | Conn Recept Faston 22-26AWG .110 - Reel of 3K | 4 | PCE
 | > > > > > | EL-MS0141 | Term Ring Non Ins 26-22AWG #4 Order Bulk Only | 2 | PCE
 | > > > > > | EL-MS0012 | Noninsulated Wire Ferrule, 24-20 AWG, .31" Pin Length | 2 | PCE
 | > > > > | EL-MT0029 | NEMA 17 Stepper Motor, Moons' - NOT INCLUDING wire harness | 1 | PCE
 | > > > > | HD-BL0009 | 1164-2P-06-2MR-1164-06 / GT 2 Single Sided Neoprene Belt - 1164mm by 6mm belt | 1 | PCE
 | > > > > | HD-BT0012 | M3 Set Screw (Grub Screw) | 4 | PCE
 | > > > > | HD-BT0073 | Class 10.9 Stl Button Head Socket Cap Screw M5 Size, 10 Mm Length, .8 Mm Pitch | 24 | PCE
 | > > > > | HD-BT0146 | M3 x 12 BHCS, Black Oxide, Class 10.9 Steel | 6 | PCE
 | > > > > | HD-EX0062 | T-Slot Aluminum Frame TPW, Extrusion 20mm x 20mm x 500mm,Tapped M5x0.8 on Both Ends, Black (Ends free of anodize) | 2 | PCE
 | > > > > | HD-MS0033 | GT2, 16 Teeth, timing pulley, AL | 1 | PCE
 | > > > > | HD-NT0053 | T-Slot Slide in T-nuts for Aluminum Frame, M5 | 16 | PCE
 | > > > > | AS-PR0026 | TAZ6, Y Corner Right with Insert Assembly | 2 | PCE
 | > > > > > | PP-GP0229 | Y Corner Right v2.4 | 1 | PCE
 | > > > > > > | RM-AB0082 | Black ABS 3mm Filament, 5lb Reel Village Plastics | 19.46 | g
 | > > > > > | HD-MS0060 | Metric Brass Heat-Set Insert For Plastics Tapered, M5-.8 Internal Thread, 11.1mm Length | 1 | PCE
 | > > > > > | HD-MS0030 | Metric Brass Heat-Set Insert for Plastics Tapered, M3-.5 Internal Thread, 3.8mm Length | 2 | PCE
 | > > > > | AS-PR0027 | TAZ6, Y Corner Left with Insert Assembly | 2 | PCE
 | > > > > > | PP-GP0228 | Y Corner Left V2.4 | 1 | PCE
 | > > > > > > | RM-AB0082 | Black ABS 3mm Filament, 5lb Reel Village Plastics | 19.4 | g
 | > > > > > | HD-MS0060 | Metric Brass Heat-Set Insert For Plastics Tapered, M5-.8 Internal Thread, 11.1mm Length | 1 | PCE
 | > > > > > | HD-MS0030 | Metric Brass Heat-Set Insert for Plastics Tapered, M3-.5 Internal Thread, 3.8mm Length | 2 | PCE
 | > > > > | AS-PR0028 | TAZ6, Y Idler with Bearings and Inserts | 1 | PCE
 | > > > > > | HD-MS0282 | 608-2RS ABEC3/C3 Rubber Sealed Bearing - BLACK | 2 | PCE
 | > > > > > | HD-WA0006 | M8 Washer, Steel, Zinc Plated | 4 | PCE
 | > > > > > | HD-NT0002 | M8 Nyloc Nut, Zinc Plated | 1 | PCE
 | > > > > > | PP-MP0111 | Y End Plate v0.2 | 1 | PCE
 | > > > > > | HD-WA0038 | Black-Oxide 18-8 Stainless Steel Flat Washer, M3 Screw Size, 3.2mm ID, 7.0mm OD | 4 | PCE
 | > > > > > | HD-BT0148 | Class 10.9 Steel Button-Head Socket Cap Screw, M3 Size, 10 mm Length, .5 mm Pitch | 4 | PCE
 | > > > > > | HD-BT0061 | Class 10.9 Stl Button Head Socket Cap Screw M8 Size, 40 Mm Length, 1.25 Mm Pitch | 1 | PCE
 | > > > > > | HD-MS0030 | Metric Brass Heat-Set Insert for Plastics Tapered, M3-.5 Internal Thread, 3.8mm Length | 4 | PCE
 | > > > > > | PP-GP0225 | Y Idler Mount v4.0, TAZ | 1 | PCE
 | > > > > > > | RM-AB0082 | Black ABS 3mm Filament, 5lb Reel Village Plastics | 17.81 | g
 | > > > > | AS-PR0023 | 90mm Cut wiper pad | 1 | PCE, 90mm
 | > > > > > | PP-FP0087 | LulzBot Wiper Pads | 90 | mm
 | > > > > | PP-GP0216 | Z-min switch mount v4.1 | 1 | PCE
 | > > > > > | RM-AB0082 | Black ABS 3mm Filament, 5lb Reel Village Plastics | 8.81 | g
 | > > > > | PP-GP0221 | Bed corner TAZ6 v2.0 | 4 | PCE
 | > > > > > | RM-TE0002 | Midnight NinjaFlex™ TPE Filament, 3mm, 0.75kg | 1.54 | g
 | > > > > | PP-GP0231 | Wiper Mount, v1.1 | 1 | PCE
 | > > > > > | RM-AB0082 | Black ABS 3mm Filament, 5lb Reel Village Plastics | 12.35 | g
 | > > > > | AS-PR0024 | TAZ6, Y Belt Mount with Inserts Assembly | 1 | PCE
 | > > > > > | PP-MP0066 | Metric Brass Heat-Set Insert for Plastics, Tapered, M2-.4 Internal Thread, 2.9MM Length | 4 | PCE
 | > > > > > | HD-MS0030 | Metric Brass Heat-Set Insert for Plastics Tapered, M3-.5 Internal Thread, 3.8mm Length | 2 | PCE
 | > > > > > | PP-GP0222 | Y belt mount v.75 | 1 | PCE
 | > > > > > > | RM-AB0082 | Black ABS 3mm Filament, 5lb Reel Village Plastics | 26.09 | g
 | > > > > | HD-WA0038 | Black-Oxide 18-8 Stainless Steel Flat Washer, M3 Screw Size, 3.2mm ID, 7.0mm OD | 41 | PCE
 | > > > > | HD-WA0027 | Metric 18-8 Stainless Steel Internal-Tooth Lock Washer, M3 Screw Size, 6MM OD, .4MM Min Thick | 1 | PCE
 | > > > > | HD-WA0012 | Steel Flat Washer, DIN 125 zinc-plated class 4,M2 screw sz, 5mm OD, .25mm-.35mm thick | 4 | PCE
 | > > > > | HD-NT0001 | Metric Zinc-Plated Steel Nylon-Insert Locknut, Class 8, M3 Screw sz, .5MM pitch, 5.5MM W, 4MM H | 1 | PCE
 | > > > > | HD-MS0058 | Wire Tie, 8" Black, pk 1000 | 1 | PCE
 | > > > > | HD-BT0148 | Class 10.9 Steel Button-Head Socket Cap Screw, M3 Size, 10 mm Length, .5 mm Pitch | 1 | PCE
 | > > > > | HD-BT0137 | M3 x 8 Bolt, BHCS, Black-Oxide | 34 | PCE
 | > > > > | HD-BT0107 | Metric Class 12.9 Socket Head Cap Screw Alloy Steel, Black, M2 Thread, 10mm Length, 0.4mm Pitch | 4 | PCE
 | > > > > | HD-BT0082 | Metric 18-8 SS Flat Head Socket Cap Screw M3 Size, 16mm Length, .50mm Pitch | 1 | PCE
 | > > > > | EL-SW0030 | Momentary Metal Flat Flush Mount Push Button Switch | 1 | PCE
 | > > > > | EL-SW0022 | SWITCH BASIC SPDT 3A .110QC 125V | 2 | PCE
 | > > > > | AS-PR0025 | 10mm Single Bearing holders Assembly | 4 | PCE
 | > > > > > | HD-BU0030 | DryLin® R - Solid Polymer Bearing RJMP-01-10mm | 1 | PCE
 | > > > > > | RM-AB0082 | Black ABS 3mm Filament, 5lb Reel Village Plastics | 9.51 | g
 | > > > > | PP-FP0080 | Laser Etched TAZ Bed Mount Plate, 6061 v5.0 - PP-MP0145 | 1 | PCE
 | > > > > > | PP-MP0145 | TAZ 300mm Bed Plate, 6061, revC | 1 | PCE
 | > > > > > | SR-MN0004 | Laser Etching Service for PP-FP0080 | 1 | PCE
 | > > > | AS-PR0006 | TAZ6, Frame, Final Assembly | 1 | PCE
 | > > > > | AS-PR0011 | TAZ6, Tippy Feed Tube Holder with Bushing Assembly | 1 | PCE
 | > > > > > | HD-MS0062 | Metric Aluminum Unthreaded Spacer, 8MM OD, 8MM Length, M5 Screw Size | 1 | PCE
 | > > > > > | PP-GP0218 | Tippy Feed tube holder v0.6 | 1 | PCE
 | > > > > > > | RM-AB0082 | Black ABS 3mm Filament, 5lb Reel Village Plastics | 4.43 | g
 | > > > > | HD-BT0049 | Metric Class 12.9 Socket Head Cap Screw, Alloy Steel, M5 thread, 14MM length, 0.80MM pitch | 2 | PCE
 | > > > > | AS-PR0017 | TAZ6, Z Axis Right Assembly | 1 | PCE
 | > > > > > | AS-PR0018 | TAZ6, Z Carriage Idler with Bearings and Inserts Assembly | 1 | PCE
 | > > > > > > | HD-MS0060 | Metric Brass Heat-Set Insert For Plastics Tapered, M5-.8 Internal Thread, 11.1mm Length | 2 | PCE
 | > > > > > > | HD-MS0030 | Metric Brass Heat-Set Insert for Plastics Tapered, M3-.5 Internal Thread, 3.8mm Length | 2 | PCE
 | > > > > > > | AS-PR0019 | TAZ6, Z Carriage Idler with Bearings Assembly | 1 | PCE
 | > > > > > > > | HD-BU0030 | DryLin® R - Solid Polymer Bearing RJMP-01-10mm | 2 | PCE
 | > > > > > > > | RM-AB0082 | Black ABS 3mm Filament, 5lb Reel Village Plastics | 89.11 | g
 | > > > > > | HD-MS0282 | 608-2RS ABEC3/C3 Rubber Sealed Bearing - BLACK | 3 | PCE
 | > > > > > | HD-BT0175 | Thread-Locking Socket Head Cap Screw, Alloy Steel, M5 Thread, 16mm Long, 0.8mm Pitch | 2 | PCE
 | > > > > > | HD-BT0012 | M3 Set Screw (Grub Screw) | 1 | PCE
 | > > > > > | AS-PR0020 | TAZ6, Z Lower Right with Inserts Assembly | 1 | PCE
 | > > > > > > | PP-GP0227 | Z Lower Right, v2.3 | 1 | PCE
 | > > > > > > > | RM-AB0096 | LulzBot Green ABS 3mm Filament, 5lb Reel Village Plastic | 81.84 | g
 | > > > > > > | HD-MS0030 | Metric Brass Heat-Set Insert for Plastics Tapered, M3-.5 Internal Thread, 3.8mm Length | 1 | PCE
 | > > > > > | PP-GP0237 | Flexy Washer v0.1 | 1 | PCE
 | > > > > > > | RM-TE0027 | LulzBot Green NinjaFlex TPE Filament, 3mm. 0.75kg Fenner Drives | 3.36 | g
 | > > > > > | HD-RD0048 | Helix - Screw, Lead, Stainless Steel 12mm x 2mm, RH, 420mm OAL, Machined | 1 | PCE
 | > > > > > | HD-RD0018 | 10mm Smooth Rod, Stainless Steel, 500mm | 1 | PCE
 | > > > > > | HD-NT0355 | Helix - Nut, Lead Screw, Resin, 12mm x 2mm, RH PPS, Round Flange | 1 | PCE
 | > > > > > | HD-NT0002 | M8 Nyloc Nut, Zinc Plated | 1 | PCE
 | > > > > > | HD-WA0006 | M8 Washer, Steel, Zinc Plated | 3 | PCE
 | > > > > > | HD-BT0061 | Class 10.9 Stl Button Head Socket Cap Screw M8 Size, 40 Mm Length, 1.25 Mm Pitch | 1 | PCE
 | > > > > | AS-PR0013 | TAZ6, Z Axis Left Assembly | 1 | PCE
 | > > > > > | PP-GP0237 | Flexy Washer v0.1 | 1 | PCE
 | > > > > > > | RM-TE0027 | LulzBot Green NinjaFlex TPE Filament, 3mm. 0.75kg Fenner Drives | 3.36 | g
 | > > > > > | HD-WA0038 | Black-Oxide 18-8 Stainless Steel Flat Washer, M3 Screw Size, 3.2mm ID, 7.0mm OD | 4 | PCE
 | > > > > > | HD-WA0012 | Steel Flat Washer, DIN 125 zinc-plated class 4,M2 screw sz, 5mm OD, .25mm-.35mm thick | 4 | PCE
 | > > > > > | HD-RD0048 | Helix - Screw, Lead, Stainless Steel 12mm x 2mm, RH, 420mm OAL, Machined | 1 | PCE
 | > > > > > | HD-RD0018 | 10mm Smooth Rod, Stainless Steel, 500mm | 1 | PCE
 | > > > > > | HD-NT0355 | Helix - Nut, Lead Screw, Resin, 12mm x 2mm, RH PPS, Round Flange | 1 | PCE
 | > > > > > | HD-MS0282 | 608-2RS ABEC3/C3 Rubber Sealed Bearing - BLACK | 1 | PCE
 | > > > > > | HD-MS0033 | GT2, 16 Teeth, timing pulley, AL | 1 | PCE
 | > > > > > | HD-BT0175 | Thread-Locking Socket Head Cap Screw, Alloy Steel, M5 Thread, 16mm Long, 0.8mm Pitch | 2 | PCE
 | > > > > > | HD-BT0146 | M3 x 12 BHCS, Black Oxide, Class 10.9 Steel | 4 | PCE
 | > > > > > | HD-BT0107 | Metric Class 12.9 Socket Head Cap Screw Alloy Steel, Black, M2 Thread, 10mm Length, 0.4mm Pitch | 4 | PCE
 | > > > > > | HD-BT0012 | M3 Set Screw (Grub Screw) | 2 | PCE
 | > > > > > | EL-SW0022 | SWITCH BASIC SPDT 3A .110QC 125V | 2 | PCE
 | > > > > > | EL-MT0029 | NEMA 17 Stepper Motor, Moons' - NOT INCLUDING wire harness | 1 | PCE
 | > > > > > | AS-PR0016 | TAZ6, Z Lower Left with Inserts Assembly | 1 | PCE
 | > > > > > > | PP-GP0215 | Z Lower Left, v2.3 | 1 | PCE
 | > > > > > > > | RM-AB0096 | LulzBot Green ABS 3mm Filament, 5lb Reel Village Plastic | 81.61 | g
 | > > > > > > | HD-MS0030 | Metric Brass Heat-Set Insert for Plastics Tapered, M3-.5 Internal Thread, 3.8mm Length | 1 | PCE
 | > > > > > | AS-PR0014 | TAZ6, Z Carriage Motor with Bearings and Inserts Assembly | 1 | PCE
 | > > > > > > | PP-MP0066 | Metric Brass Heat-Set Insert for Plastics, Tapered, M2-.4 Internal Thread, 2.9MM Length | 4 | PCE
 | > > > > > > | HD-MS0060 | Metric Brass Heat-Set Insert For Plastics Tapered, M5-.8 Internal Thread, 11.1mm Length | 2 | PCE
 | > > > > > > | HD-MS0030 | Metric Brass Heat-Set Insert for Plastics Tapered, M3-.5 Internal Thread, 3.8mm Length | 2 | PCE
 | > > > > > > | AS-PR0015 | TAZ6, Z Carriage Motor with Bearings Assembly | 1 | PCE
 | > > > > > > > | RM-AB0082 | Black ABS 3mm Filament, 5lb Reel Village Plastics | 103.38 | g
 | > > > > > > > | HD-BU0030 | DryLin® R - Solid Polymer Bearing RJMP-01-10mm | 2 | PCE
 | > > > > | AS-PR0012 | TAZ6, Spool Arm with Bushing Assembly | 1 | PCE
 | > > > > > | HD-MS0062 | Metric Aluminum Unthreaded Spacer, 8MM OD, 8MM Length, M5 Screw Size | 1 | PCE
 | > > > > > | PP-GP0217 | Spool Arm v0.2 | 1 | PCE
 | > > > > > > | RM-AB0082 | Black ABS 3mm Filament, 5lb Reel Village Plastics | 20.64 | g
 | > > > > | PP-GP0236 | Z Upper v2.3 | 2 | PCE
 | > > > > > | RM-AB0082 | Black ABS 3mm Filament, 5lb Reel Village Plastics | 55.1 | g
 | > > > > | HD-WA0040 | Black-Oxide 18-8 Stainless Steel Flat Washer, M5 Screw Size, 5.3mm ID, 10.0mm OD | 58 | PCE
 | > > > > | HD-NT0053 | T-Slot Slide in T-nuts for Aluminum Frame, M5 | 54 | PCE
 | > > > > | HD-NT0044 | Post assembly M5 T-nut | 1 | PCE
 | > > > > | HD-MS0282 | 608-2RS ABEC3/C3 Rubber Sealed Bearing - BLACK | 2 | PCE
 | > > > > | HD-BT0073 | Class 10.9 Stl Button Head Socket Cap Screw M5 Size, 10 Mm Length, .8 Mm Pitch | 56 | PCE
 | > > > > | HD-EX0061 | T-Slot Extrusion, Aluminum, 20mm x 20mm x 510mm, Black | 4 | PCE
 | > > > > | HD-EX0063 | T-Slot Aluminum Frame LTP, Extrusion 20mm x 20mm x 500mm,Tapped M5x0.8 on One End, Black | 4 | PCE
 | > > > > | PP-MP0106 | Corner Bracket V2.0 | 8 | PCE
 | > > > > | AS-PR0008 | TAZ6, Bed Mount Chassis with Inserts | 4 | PCE
 | > > > > > | HD-MS0060 | Metric Brass Heat-Set Insert For Plastics Tapered, M5-.8 Internal Thread, 11.1mm Length | 1 | PCE
 | > > > > > | PP-GP0223 | Bed Mount Chassis v3.3 | 1 | PCE
 | > > > > > > | RM-AB0082 | Black ABS 3mm Filament, 5lb Reel Village Plastics | 6.4 | g
 | > > > | AS-PR0004 | TAZ6, Olive Oil, Control Box Assembly | 1 | PCE
 | > > > > | PP-FP0075 | Silk Screened and Laser Etched TAZ Electronics Chassis revE v0.3 PP-FP0073 | 1 | PCE
 | > > > > > | PP-FP0073 | Silk Screened TAZ Electronics Chassis revD, PP-MP0110 | 1 | PCE
 | > > > > > | SR-MN0001 | Laser Etching Service for PP-FP0075 | 1 | PCE
 | > > > > | EL-HR0078 | TAZ 6 plug to ground green | 1 | PCE
 | > > > > > | EL-WR0124 | 16AWG Stranded – Green w/ yellow stripe | 120 | mm
 | > > > > > | EL-MS0246 | Conn Ring 16-22 AWG #4 Red PIDG - Reel 5000 | 1 | PCE
 | > > > > > | EL-MS0143 | Conn Fast Receptacle14-16 AWG .250 - REEL of 2200 Units | 1 | PCE
 | > > > > | EL-HR0075 | X Harness External TAZ 6 | 1 | PCE
 | > > > > > | PC-CN0053 | Headers & Wire Housings HSG 12P W/O Ears Single Row | 1 | PCE
 | > > > > > | EL-WR0109 | 24AWG Stranded – Yellow | 720 | mm
 | > > > > > | EL-WR0107 | 24AWG Stranded – White | 700 | mm
 | > > > > > | EL-WR0099 | Shielded 22AWG UL2464 4 COND | 285 | mm
 | > > > > > | EL-MS0355 | CONN HOUSING PH 6POS 2MM WHITE | 1 | PCE
 | > > > > > | EL-MS0351 | JST - CONN TERM CRIMP PH 24-30AWG - 8,000 Unit Reel | 4 | PCE
 | > > > > > | EL-MS0205 | Molex-CONN TERM MALE 22-24AWG TIN - Reels of 20K | 9 | PCE
 | > > > > > | EL-MS0142 | Conn Recept Faston 22-26AWG .110 - Reel of 3K | 4 | PCE
 | > > > > > | EL-MS0073 | Tubing Corrugated Loom .25", Black, 3200' Box | 270 | mm
 | > > > > | PP-FP0078 | Laser Etched TAZ Interconnect Cover v0.5, PP-MP0107 | 1 | PCE
 | > > > > > | PP-MP0107 | TAZ Interconnect Cover V0.5 | 1 | PCE
 | > > > > > | SR-MN0003 | Laser Etching Service for PP-FP0078 | 1 | PCE
 | > > > > | PP-FP0076 | Silk Screened and Laser Etched TAZ Electronics Cover PP-MP0109 | 1 | PCE
 | > > > > > | PP-MP0109 | TAZ Electronics Cover, v0.4 with Powder Coat | 1 | PCE
 | > > > > > | SR-MN0002 | Laser Etching Service for PP-FP0076 | 1 | PCE
 | > > > > | EL-FA0036 | TAZ 6 CB Case Fan Assembly v1.0 | 1 | PCE
 | > > > > > | PC-CN0001 | Molex-Conn Housing 2POS .100 W/Latch | 1 | PCE
 | > > > > > | EL-MS0059 | Molex-CONN TERM FEMALE 22-24AWG TIN Reels of 20K | 2 | PCE
 | > > > > > | EL-FA0033 | Pelonis FAN 24V 80x80x15mm Low flow | 1 | PCE
 | > > > > | PP-GP0235 | SD card bezel v0.8 | 1 | PCE
 | > > > > > | RM-AB0082 | Black ABS 3mm Filament, 5lb Reel Village Plastics | 0.82 | g
 | > > > > | PP-GP0234 | LCD Knob, V0.2 Design Dent 2 | 1 | PCE
 | > > > > > | RM-AB0082 | Black ABS 3mm Filament, 5lb Reel Village Plastics | 2.24 | g
 | > > > > | PP-GP0230 | LCD_bezel | 1 | PCE
 | > > > > > | RM-AB0082 | Black ABS 3mm Filament, 5lb Reel Village Plastics | 11.01 | g
 | > > > > | PP-GP0220 | Interconnect housing v0.6 | 1 | PCE
 | > > > > > | RM-AB0082 | Black ABS 3mm Filament, 5lb Reel Village Plastics | 37.97 | g
 | > > > > | PP-GP0089 | LCD_spacer_v0.4 | 4 | PCE
 | > > > > > | RM-AB0082 | Black ABS 3mm Filament, 5lb Reel Village Plastics | 0.08 | g
 | > > > > | PC-BD0045 | RAMBo Electronics v1.3L Assembled Board Only | 1 | PCE
 | > > > > | PC-AS0041 | Plastic Laser Cut LCD Cover | 1 | PCE
 | > > > > | PC-AS0019 | Full Graphic Smart LCD Controller, gLCD Kit | 1 | PCE
 | > > > > | HD-WA0038 | Black-Oxide 18-8 Stainless Steel Flat Washer, M3 Screw Size, 3.2mm ID, 7.0mm OD | 24 | PCE
 | > > > > | HD-WA0027 | Metric 18-8 Stainless Steel Internal-Tooth Lock Washer, M3 Screw Size, 6MM OD, .4MM Min Thick | 2 | PCE
 | > > > > | HD-WA0013 | Steel Flat Washer, DIN 125 Zinc-Plated Class 4, M2.5 screw sz, 6MM OD, .45MM-.55MM thick | 4 | PCE
 | > > > > | HD-NT0004 | M3 Nut, Steel, Zinc Plated | 4 | PCE
 | > > > > | HD-NT0001 | Metric Zinc-Plated Steel Nylon-Insert Locknut, Class 8, M3 Screw sz, .5MM pitch, 5.5MM W, 4MM H | 2 | PCE
 | > > > > | HD-MS0336 | Black Adhesive-Back Bumper, Square, Polyurethane, 3/4" Wide, 1/4" High | 3 | PCE
 | > > > > | HD-MS0249 | UV-Resistant Cable Tie Holder, Adhesive Back/Screw Mount, 4-Way, for.18" Maximum Tie, Black | 4 | PCE
 | > > > > | HD-MS0058 | Wire Tie, 8" Black, pk 1000 | 4 | PCE
 | > > > > | HD-BT0171 | Class 10.9 Steel Button-Head Socket Cap Screw M3 Size, 20 mm Length, .5 mm Pitch | 4 | PCE
 | > > > > | HD-BT0155 | Black Alloy Steel Flat-Head Socket Cap Screw, Class 10.9, M4 Size, 6mm Length, .70mm Pitch | 5 | PCE
 | > > > > | HD-BT0146 | M3 x 12 BHCS, Black Oxide, Class 10.9 Steel | 6 | PCE
 | > > > > | HD-BT0137 | M3 x 8 Bolt, BHCS, Black-Oxide | 14 | PCE
 | > > > > | HD-BT0116 | Black Alloy Steel Flat-Head Socket Cap Screw, Class 10.9, M3 Size, 10mm Length, .50mm Pitch | 2 | PCE
 | > > > > | HD-BT0104 | M3 x 8 Bolt, BHCS, SST | 4 | PCE
 | > > > > | HD-BT0054 | Metric Class 12.9 Socket Head Cap Screw, Alloy Steel, M2.5 Thread, 12MM Length, 0.45MM Pitch | 4 | PCE
 | > > > > | HD-BT0053 | 18-8 Stainless Steel Flat Head Phillips Machine Screw, Black-Oxide Finish, 4-40 Thread, 1/4" Length | 4 | PCE
 | > > > > | EL-SW0023 | SWITCH ROCKER DPST 20A 250V, Illuminated Red | 1 | PCE
 | > > > > | EL-MS0347 | Fuse Ceramic 6.3A 250VAC 5X20MM | 2 | PCE
 | > > > > | EL-MS0346 | MOD PWR ENTRY INLET W/FUSE 6A - IEC C14 Receptacle – AC Filter 6A 250VAC | 1 | PCE
 | > > > > | EL-MS0144 | Connector Accessories, Sealing Cap, Shell Size 17 | 1 | PCE
 | > > > > | EL-HR0101 | Taz 6, CB extruder 1 harness | 1 | PCE
 | > > > > > | PC-CN0032 | Term Block Plug 2POS STR 5.08MM | 2 | PCE
 | > > > > > | PC-CN0001 | Molex-Conn Housing 2POS .100 W/Latch | 2 | PCE
 | > > > > > | EL-WR0119 | 24AWG Stranded Wire – Green | 120 | mm
 | > > > > > | EL-WR0111 | 24AWG Stranded – Blue | 110 | mm
 | > > > > > | EL-WR0109 | 24AWG Stranded – Yellow | 120 | mm
 | > > > > > | EL-WR0107 | 24AWG Stranded – White | 110 | mm
 | > > > > > | EL-WR0105 | 24AWG Stranded – Black | 100 | mm
 | > > > > > | EL-WR0104 | 24AWG Stranded – Orange | 260 | mm
 | > > > > > | EL-WR0103 | 24AWG Stranded – Red | 200 | mm
 | > > > > > | EL-WR0099 | Shielded 22AWG UL2464 4 COND | 130 | mm
 | > > > > > | EL-MS0362 | 24 AWG 6.0mm Pin Length Single Wire - Insulated Ferrule | 4 | PCE
 | > > > > > | EL-MS0141 | Term Ring Non Ins 26-22AWG #4 Order Bulk Only | 1 | PCE
 | > > > > > | EL-MS0133 | CONN, RCPT, 14 POS w/Brass Inserts | 1 | PCE
 | > > > > > | EL-MS0124 | 20-24 AWG Tin Sockets for Receptacle - 4K Reel | 13 | PCE
 | > > > > > | EL-MS0062 | MOLEX-CONN HOUSING 4POS .100 W/LATCH | 1 | PCE
 | > > > > > | EL-MS0059 | Molex-CONN TERM FEMALE 22-24AWG TIN Reels of 20K | 8 | PCE
 | > > > > | EL-HR0097 | LCD Harness TAZ 6, v0.1 | 1 | PCE
 | > > > > > | PC-CN0010 | Conn Socket IDC, 10POS DUAL 30AU, | 2 | PCE
 | > > > > > | EL-MS0075 | CONN HOUSING 8POS .100 DUAL, Black | 1 | PCE
 | > > > > > | EL-MS0074 | Molex-CONN HOUSING 20POS .100 DUAL, BLACK | 1 | PCE
 | > > > > > | EL-MS0059 | Molex-CONN TERM FEMALE 22-24AWG TIN Reels of 20K | 18 | PCE
 | > > > > > | EL-CA0078 | Flat Cables .050" 10C 10 COLOR 28AWG STRANDED 2x180mm | 360 | mm
 | > > > > | EL-HR0092 | Taz 6, Extruder 0 harness external | 1 | PCE
 | > > > > > | PC-CN0055 | Headers & Wire Housings Male 20Ckt | 1 | PCE
 | > > > > > | EL-WR0120 | 24AWG Stranded Wire – Purple | 2040 | mm
 | > > > > > | EL-WR0119 | 24AWG Stranded Wire – Green | 1020 | mm
 | > > > > > | EL-WR0111 | 24AWG Stranded – Blue | 1020 | mm
 | > > > > > | EL-WR0109 | 24AWG Stranded – Yellow | 1020 | mm
 | > > > > > | EL-WR0107 | 24AWG Stranded – White | 1020 | mm
 | > > > > > | EL-WR0105 | 24AWG Stranded – Black | 1020 | mm
 | > > > > > | EL-WR0104 | 24AWG Stranded – Orange | 2040 | mm
 | > > > > > | EL-WR0103 | 24AWG Stranded – Red | 2040 | mm
 | > > > > > | EL-WR0099 | Shielded 22AWG UL2464 4 COND | 1020 | mm
 | > > > > > | EL-MS0251 | CONN HOUSING 16POS .100 DUAL | 1 | PCE
 | > > > > > | EL-MS0205 | Molex-CONN TERM MALE 22-24AWG TIN - Reels of 20K | 16 | PCE
 | > > > > > | EL-MS0139 | Tubing Corrugated Loom 3/8" ID, Black, 1900' Box | 1000 | mm
 | > > > > > | EL-MS0059 | Molex-CONN TERM FEMALE 22-24AWG TIN Reels of 20K | 15 | PCE
 | > > > > > | DC-LB0104 | Tool Head Wiring Connector Alignment Label | 1 | PCE
 | > > > > | EL-HR0091 | Taz 6 Y & Z harness external | 1 | PCE
 | > > > > > | PC-CN0057 | Male 16 pin Molex Connector Housing | 1 | PCE
 | > > > > > | EL-WR0099 | Shielded 22AWG UL2464 4 COND | 1285 | mm
 | > > > > > | EL-MS0355 | CONN HOUSING PH 6POS 2MM WHITE | 3 | PCE
 | > > > > > | EL-MS0351 | JST - CONN TERM CRIMP PH 24-30AWG - 8,000 Unit Reel | 12 | PCE
 | > > > > > | EL-MS0205 | Molex-CONN TERM MALE 22-24AWG TIN - Reels of 20K | 15 | PCE
 | > > > > > | EL-MS0073 | Tubing Corrugated Loom .25", Black, 3200' Box | 1225 | mm
 | > > > > | EL-HR0088 | TAZ 6, Y & Z Harness Internal | 1 | PCE
 | > > > > | EL-HR0087 | TAZ 6, CB Extruder Harness Internal | 1 | PCE
 | > > > > | EL-HR0084 | TAZ 6, X Harness Internal | 1 | PCE
 | > > > > | EL-HR0083 | Bed power harness external, TAZ 6 | 1 | PCE
 | > > > > > | PC-CN0062 | Female 8 pin Molex Connector Housing | 1 | PCE
 | > > > > > | PC-CN0059 | Male 10 pin Molex Connector Housing | 1 | PCE
 | > > > > > | PC-CN0001 | Molex-Conn Housing 2POS .100 W/Latch | 1 | PCE
 | > > > > > | HD-MS0058 | Wire Tie, 8" Black, pk 1000 | 1 | PCE
 | > > > > > | EL-WR0135 | WIRE MTW 16AWG PPL 500ft SPOOL 600V 26-STRAND BARE COPPER - Purple | 840 | mm
 | > > > > > | EL-WR0119 | 24AWG Stranded Wire – Green | 840 | mm
 | > > > > > | EL-WR0111 | 24AWG Stranded – Blue | 840 | mm
 | > > > > > | EL-WR0109 | 24AWG Stranded – Yellow | 860 | mm
 | > > > > > | EL-WR0104 | 24AWG Stranded – Orange | 840 | mm
 | > > > > > | EL-WR0103 | 24AWG Stranded – Red | 840 | mm
 | > > > > > | EL-MS0205 | Molex-CONN TERM MALE 22-24AWG TIN - Reels of 20K | 10 | PCE
 | > > > > > | EL-MS0139 | Tubing Corrugated Loom 3/8" ID, Black, 1900' Box | 350 | mm
 | > > > > > | EL-MS0073 | Tubing Corrugated Loom .25", Black, 3200' Box | 50 | mm
 | > > > > > | EL-MS0059 | Molex-CONN TERM FEMALE 22-24AWG TIN Reels of 20K | 10 | PCE
 | > > > > > | EL-MS0010 | Heavy Duty Power Connectors POWERPOLE 15A CONT | 4 | PCE
 | > > > > > | EL-MS0008 | Anderson-Heavy Duty Power Connectors HOUSING ONLY, BLACK-BULK POWERPOLE 15/45 | 4 | PCE
 | > > > > | EL-HR0082 | TAZ6 CB Bed Power Harness | 1 | PCE
 | > > > > > | EL-MS0356 | Heat Shrink Dual Tubing 1/2" for 5mm ID 11mm OD Ferrite, Black 4FT | 55 | mm
 | > > > > > | PC-CN0032 | Term Block Plug 2POS STR 5.08MM | 1 | PCE
 | > > > > > | EL-WR0123 | 16AWG Stranded Wire – White | 600 | mm
 | > > > > > | EL-MS0361 | 16 AWG 6.0mm Pin Length Power Phase Black Single Wire - Insulated Ferrule | 2 | PCE
 | > > > > > | EL-MS0332 | Ferrite Cable Cores 220ohms 100MHz 5mm I.D. | 1 | PCE
 | > > > > > | EL-MS0010 | Heavy Duty Power Connectors POWERPOLE 15A CONT | 2 | PCE
 | > > > > > | EL-MS0008 | Anderson-Heavy Duty Power Connectors HOUSING ONLY, BLACK-BULK POWERPOLE 15/45 | 2 | PCE
 | > > > > | EL-HR0081 | TAZ 6 Bed Harness Internal | 1 | PCE
 | > > > > | EL-HR0080 | TAZ 6 plug to switch black and white with ferrite | 1 | PCE
 | > > > > > | EL-WR0123 | 16AWG Stranded Wire – White | 455 | mm
 | > > > > > | EL-WR0121 | 16AWG Stranded Wire – Black | 455 | mm
 | > > > > > | EL-MS0356 | Heat Shrink Dual Tubing 1/2" for 5mm ID 11mm OD Ferrite, Black 4FT | 55 | mm
 | > > > > > | EL-MS0332 | Ferrite Cable Cores 220ohms 100MHz 5mm I.D. | 1 | PCE
 | > > > > > | EL-MS0143 | Conn Fast Receptacle14-16 AWG .250 - REEL of 2200 Units | 4 | PCE
 | > > > > | EL-HR0079 | TAZ 6 PSU to ground green | 1 | PCE
 | > > > > > | EL-WR0124 | 16AWG Stranded – Green w/ yellow stripe | 100 | mm
 | > > > > > | EL-MS0248 | CONN RING 14-16 AWG #10 PIDG - 5,000 Unit Reel | 1 | PCE
 | > > > > > | EL-MS0246 | Conn Ring 16-22 AWG #4 Red PIDG - Reel 5000 | 1 | PCE
 | > > > > | EL-HR0076 | Taz 6 switch to PSU white | 1 | PCE
 | > > > > > | EL-MS0248 | CONN RING 14-16 AWG #10 PIDG - 5,000 Unit Reel | 1 | PCE
 | > > > > > | EL-MS0143 | Conn Fast Receptacle14-16 AWG .250 - REEL of 2200 Units | 1 | PCE
 | > > > > > | EL-WR0123 | 16AWG Stranded Wire – White | 435 | mm
 | > > > > | EL-HR0077 | TAZ 6 switch to PSU black | 1 | PCE
 | > > > > > | EL-MS0248 | CONN RING 14-16 AWG #10 PIDG - 5,000 Unit Reel | 1 | PCE
 | > > > > > | EL-MS0143 | Conn Fast Receptacle14-16 AWG .250 - REEL of 2200 Units | 1 | PCE
 | > > > > > | EL-WR0121 | 16AWG Stranded Wire – Black | 435 | mm
 | > > > > | EL-PS0031 | Mean Well Switching Power Supplies 500W 24V 21A Power Supply W/PFC | 1 | PCE
 | > > > > | EL-HR0074 | DC Power Harness v1.0 TAZ 6 | 1 | PCE
 | > > > > > | PC-CN0036 | Term Block Plug 6POS STR 5.08mm | 1 | PCE
 | > > > > > | EL-MS0248 | CONN RING 14-16 AWG #10 PIDG - 5,000 Unit Reel | 6 | PCE
 | > > > > > | EL-MS0361 | 16 AWG 6.0mm Pin Length Power Phase Black Single Wire - Insulated Ferrule | 6 | PCE
 | > > > > > | EL-WR0106 | 16AWG Stranded – Red | 1650 | mm
 | > > > > > | EL-WR0121 | 16AWG Stranded Wire – Black | 1650 | mm
 | > > > | AS-TH0014 | TAZ6, Olive Oil, Extruder Assembly | 1 | PCE
 | > > > > | PP-MP0137 | Standard Hexagon Mount Plate | 1 | PCE
 | > > > > | PP-GP0192 | Herringbone Small Gear v1.1, Lulzbot green | 1 | PCE
 | > > > > > | RM-AB0096 | LulzBot Green ABS 3mm Filament, 5lb Reel Village Plastic | 3.47 | g
 | > > > > | PP-GP0186 | extruder body hex black v1.4.1 | 1 | PCE
 | > > > > > | RM-AB0082 | Black ABS 3mm Filament, 5lb Reel Village Plastics | 32.82 | g
 | > > > > | PP-GP0091 | Extruder Latch v2.1 | 1 | PCE
 | > > > > > | RM-AB0082 | Black ABS 3mm Filament, 5lb Reel Village Plastics | 2.46 | g
 | > > > > | PP-GP0060 | Extruder Washer v3.0, Taz | 1 | PCE
 | > > > > > | RM-AB0082 | Black ABS 3mm Filament, 5lb Reel Village Plastics | 0.2 | g
 | > > > > | HD-WA0039 | Black-Oxide 18-8 Stainless Steel Flat Washer, M4 Screw Size, 4.3mm ID, 9.0mm OD | 6 | PCE
 | > > > > | HD-WA0038 | Black-Oxide 18-8 Stainless Steel Flat Washer, M3 Screw Size, 3.2mm ID, 7.0mm OD | 5 | PCE
 | > > > > | HD-WA0012 | Steel Flat Washer, DIN 125 zinc-plated class 4,M2 screw sz, 5mm OD, .25mm-.35mm thick | 2 | PCE
 | > > > > | HD-WA0009 | Metric Spring Steel Shim - DIN 988 1.0mm Thick, 8mm ID, 14mm OD | 1 | PCE
 | > > > > | HD-WA0008 | Metric Spring Steel Shim - DIN 988 0.5mm Thick, 8mm ID, 14mm OD | 1 | PCE
 | > > > > | HD-WA0006 | M8 Washer, Steel, Zinc Plated | 3 | PCE
 | > > > > | HD-NT0011 | M4 Nut, Steel, Zinc Plated | 4 | PCE
 | > > > > | HD-NT0004 | M3 Nut, Steel, Zinc Plated | 2 | PCE
 | > > > > | HD-NT0002 | M8 Nyloc Nut, Zinc Plated | 1 | PCE
 | > > > > | HD-MS0282 | 608-2RS ABEC3/C3 Rubber Sealed Bearing - BLACK | 2 | PCE
 | > > > > | HD-MS0058 | Wire Tie, 8" Black, pk 1000 | 2 | PCE
 | > > > > | HD-MS0027 | Extruder Comp Spring - Music Wire, Extruder, 6mm OD, 0.8mm WD, 9.7mm FL | 2 | PCE
 | > > > > | HD-BT0118 | M3 x 14 Bolt FHCS, Black-Oxide | 4 | PCE
 | > > > > | HD-BT0107 | Metric Class 12.9 Socket Head Cap Screw Alloy Steel, Black, M2 Thread, 10mm Length, 0.4mm Pitch | 2 | PCE
 | > > > > | HD-BT0010 | M4 x 20 Bolt, SHCS Black-oxide | 2 | PCE
 | > > > > | HD-BT0041 | Metric Class 12.9 Socket Head Cap Screw Alloy Steel, M3 Thread, 25mm Length, 0.50mm Pitch | 2 | PCE
 | > > > > | HD-BT0039 | Metric Class 12.9 Socket Head Cap Screw, Alloy Steel, M3 Thread, 12MM Length, 0.50MM Pitch | 11 | PCE
 | > > > > | HD-BT0012 | M3 Set Screw (Grub Screw) | 1 | PCE
 | > > > > | EL-SW0022 | SWITCH BASIC SPDT 3A .110QC 125V | 1 | PCE
 | > > > > | EL-MT0029 | NEMA 17 Stepper Motor, Moons' - NOT INCLUDING wire harness | 1 | PCE
 | > > > > | EL-MS0139 | Tubing Corrugated Loom 3/8" ID, Black, 1900' Box | 70 | mm
 | > > > > | DC-LB0104 | Tool Head Wiring Connector Alignment Label | 1 | PCE
 | > > > > | AS-HE0002 | .50mm Hot End Assembly, for single | 1 | PCE
 | > > > > > | HD-BT0104 | M3 x 8 Bolt, BHCS, SST | 2 | PCE
 | > > > > > | PP-MP0134 | Hexagon Heater Block with Holes for Retention Plate and Hexagon Logo Laser Etched on Front | 1 | PCE
 | > > > > > | PP-MP0133 | Hexagon Heatsink for 3mm Filament | 1 | PCE
 | > > > > > | HD-BT0173 | Heat Sink Setscrew (M2 x 6 SCHS) | 1 | PCE
 | > > > > > | HD-BT0172 | M3 x 4 Setscrew (Heater Cartridge Set Screw) | 1 | PCE
 | > > > > > | PP-MP0136 | Thermistor Retention Plate | 1 | PCE
 | > > > > > | PP-MP0135 | 0.5mm Nozzle for 3mm Filament | 1 | PCE
 | > > > > > | AS-CB0008 | Thermistor 150mm Harness | 1 | PCE
 | > > > > > > | EL-TH0011 | Semitec GT2 Thermistor (100kOhm type) 23cm Leads with no connectors on end. | 1 | PCE
 | > > > > > > | EL-MS0212 | Molex-CONN PIN 24-30AWG Crimp Tin, 20,000 Unit Reel | 2 | PCE
 | > > > > > | AS-CB0007 | Heater Cartridge 180mm Harness | 1 | PCE
 | > > > > > > | EL-MS0377 | 24V 30W Heater Cartridge, 23cm Leads (with no connectors on end) | 1 | PCE
 | > > > > > > | EL-MS0205 | Molex-CONN TERM MALE 22-24AWG TIN - Reels of 20K | 2 | PCE
 | > > > > > | HD-WA0035 | Metric 18-8 Stainless Steel External Serrated Lock Washer, M3 Screw Size, 6mm OD, 0.4mm min Thick | 1 | PCE
 | > > > > > | AS-CB0009 | Zero Sense 155mm Harness | 1 | PCE
 | > > > > > > | EL-WR0040 | Wire - Single Conductor 20AWG SOLID PTFE, RED | 155 | mm
 | > > > > > > | EL-MS0205 | Molex-CONN TERM MALE 22-24AWG TIN - Reels of 20K | 1 | PCE
 | > > > > > > | EL-MS0141 | Term Ring Non Ins 26-22AWG #4 Order Bulk Only | 1 | PCE
 | > > > > | AS-TH0005 | Extruder Thumb Screw assembly | 2 | PCE
 | > > > > > | HD-MS0031 | Metric Press-Fit Plastic Thumb Screw Head Knurled, Black, Fits M4 Screw, 13mm A, 5.5mm B | 1 | PCE
 | > > > > > | HD-BT0052 | Metric Class 12.9 Socket Head Cap Screw M4 Thread, 55mm Length, 0.70mm Pitch | 1 | PCE
 | > > > > | AS-TH0004 | Extruder Idler Block with Bearing Assembly | 1 | PCE
 | > > > > > | PP-GP0193 | Extruder Idler Block v1.4c, Taz & Mini | 1 | PCE
 | > > > > > > | RM-AB0082 | Black ABS 3mm Filament, 5lb Reel Village Plastics | 9.3 | g
 | > > > > > | HD-MS0282 | 608-2RS ABEC3/C3 Rubber Sealed Bearing - BLACK | 1 | PCE
 | > > > > > | HD-RD0004 | 8mm Smooth Rod x 18-19mm, Stainless Steel (Nubbin) | 1 | PCE
 | > > > > | AS-TH0018 | TAZ6, Fan Duct Right | 1 | PCE
 | > > > > > | PP-MP0066 | Metric Brass Heat-Set Insert for Plastics, Tapered, M2-.4 Internal Thread, 2.9MM Length | 2 | PCE
 | > > > > > | PP-GP0212 | Fan duct right v0.7.4 | 1 | PCE
 | > > > > > > | RM-AB0082 | Black ABS 3mm Filament, 5lb Reel Village Plastics | 9.51 | g
 | > > > > > | HD-MS0030 | Metric Brass Heat-Set Insert for Plastics Tapered, M3-.5 Internal Thread, 3.8mm Length | 2 | PCE
 | > > > > | AS-TH0017 | TAZ6, Fan Duct Left | 1 | PCE
 | > > > > > | PP-GP0211 | Fan duct left v0.7.4 | 1 | PCE
 | > > > > > > | RM-AB0082 | Black ABS 3mm Filament, 5lb Reel Village Plastics | 9.51 | g
 | > > > > > | HD-MS0030 | Metric Brass Heat-Set Insert for Plastics Tapered, M3-.5 Internal Thread, 3.8mm Length | 2 | PCE
 | > > > > | AS-TH0016 | Extruder Heatsink Fan duct with Insert Assembly | 1 | PCE
 | > > > > > | PP-GP0232 | heatsink-fan-duct_black_v0.6 | 1 | PCE
 | > > > > > > | RM-AB0082 | Black ABS 3mm Filament, 5lb Reel Village Plastics | 11.07 | g
 | > > > > > | HD-MS0030 | Metric Brass Heat-Set Insert for Plastics Tapered, M3-.5 Internal Thread, 3.8mm Length | 4 | PCE
 | > > > > | AS-CB0006 | X-Max-185mm Purple Harness | 2 | PCE
 | > > > > > | EL-WR0120 | 24AWG Stranded Wire – Purple | 185 | mm
 | > > > > > | EL-MS0205 | Molex-CONN TERM MALE 22-24AWG TIN - Reels of 20K | 1 | PCE
 | > > > > > | EL-MS0142 | Conn Recept Faston 22-26AWG .110 - Reel of 3K | 1 | PCE
 | > > > > | EL-HR0096 | RevB Stepper Motor JST 115mm Harness | 1 | PCE
 | > > > > > | EL-WR0119 | 24AWG Stranded Wire – Green | 115 | mm
 | > > > > > | EL-WR0107 | 24AWG Stranded – White | 115 | mm
 | > > > > > | EL-WR0105 | 24AWG Stranded – Black | 115 | mm
 | > > > > > | EL-WR0103 | 24AWG Stranded – Red | 115 | mm
 | > > > > > | EL-MS0355 | CONN HOUSING PH 6POS 2MM WHITE | 1 | PCE
 | > > > > > | EL-MS0351 | JST - CONN TERM CRIMP PH 24-30AWG - 8,000 Unit Reel | 4 | PCE
 | > > > > > | EL-MS0251 | CONN HOUSING 16POS .100 DUAL | 1 | PCE
 | > > > > > | EL-MS0205 | Molex-CONN TERM MALE 22-24AWG TIN - Reels of 20K | 4 | PCE
 | > > > > | EL-HR0095 | Extruder Fan Harness TAZ 6, v0.1 | 1 | PCE
 | > > > > > | EL-WR0111 | 24AWG Stranded – Blue | 115 | mm
 | > > > > > | EL-WR0107 | 24AWG Stranded – White | 115 | mm
 | > > > > > | EL-MS0205 | Molex-CONN TERM MALE 22-24AWG TIN - Reels of 20K | 2 | PCE
 | > > > > > | EL-MS0416 | 2.7mm Solder Sleeve | 2 | PCE
 | > > > > > | EL-FA0032 | Pelonis FAN 24V 40mmx40mmx10mm Low flow | 2 | PCE
 | > > > > | AS-CB0005 | 40mm 5v Low Flow Fan-150mm Harness | 1 | PCE
 | > > > > > | EL-MS0205 | Molex-CONN TERM MALE 22-24AWG TIN - Reels of 20K | 2 | PCE
 | > > > > > | EL-FA0034 | Pelonis FAN 5V 40x40x10mm Low flow | 1 | PCE
 | > > > > | AS-TH0003 | Large Herringbone, Green with Hob Bolt Assembly | 1 | PCE
 | > > > > > | PP-GP0191 | Herringbone Large Gear v1.3, Lulzbot green | 1 | PCE
 | > > > > > > | RM-AB0096 | LulzBot Green ABS 3mm Filament, 5lb Reel Village Plastic | 23.71 | g
 | > > > > > | HD-BT0108 | Hobbed Bolt, M8 x 50mm Hex head, 26mm offset, Stainless Steel | 1 | PCE
 | > > > > | AS-TH0015 | TAZ6, Extruder Mount with Inserts | 1 | PCE
 | > > > > > | PP-GP0208 | Extruder Mount TAZ6 v0.8 | 1 | PCE
 | > > > > > > | RM-AB0082 | Black ABS 3mm Filament, 5lb Reel Village Plastics | 62.7 | g
 | > > > > > | HD-MS0030 | Metric Brass Heat-Set Insert for Plastics Tapered, M3-.5 Internal Thread, 3.8mm Length | 5 | PCE
 | > > | PP-MP0082 | Bed Leveling Washer, 303 SST | 4 | PCE
 | > > | HD-MS0287 | Metric 18-8 Stainless Steel Unthreaded Spacer, 8mm OD, 10mm Length, M3 Screw Size | 4 | PCE
 | > > | HD-BT0082 | Metric 18-8 SS Flat Head Socket Cap Screw M3 Size, 16mm Length, .50mm Pitch | 4 | PCE
 | > > | EL-MS0385 | Verbatim 8GB SDHC Class 10 UHS-I / Bulk | 1 | PCE
 | > > | EL-CA0030 | North American - 6ft 18AWG Power Cord Cable w/ 3 Conductor PC Power Connector Socket (C13/5-15P) - Black, 5279, Box of 125 | 1 | PCE
 | > > | EL-CA0063 | 6ft Tripp Lite - USB 2.0 A/B Gold Device Cable Ferrite Chokes A Male B Male | 1 | PCE
 | > > | AS-PR0082 | Feed Tube Assembly, v3.0 | 1 | PCE
 | > > > | PP-GP0219 | Feed tube spinner v3.0 | 1 | PCE
 | > > > > | RM-AB0082 | Black ABS 3mm Filament, 5lb Reel Village Plastics | 5.45 | g
 | > > > | HD-MS0058 | Wire Tie, 8" Black, pk 1000 | 1 | PCE
 | > > > | HD-TB0007 | Feed Tube, 0.187 ID X .250 OD NAT PTFE Tube | 850 | mm
 | > > | DC-LB0097 | TAZ v6.0 serial number sticker, KT-PR0041NA | 1 | PCE
 | > | EL-CA0030 | North American - 6ft 18AWG Power Cord Cable w/ 3 Conductor PC Power Connector Socket (C13/5-15P) - Black, 5279, Box of 125 | 1 | PCE
 | > | SH-PG0072 | 3M 8898 Economy Strapping Tape - 2" x 60 yards | 600 | mm
 | > | SH-PG0131 | #260 White Reinforced Gummed Tape with LulzBot Printed Logo, 10 Pack | 144 | inch(es)
 | > | SH-PG0141 | TAZ 6: Set of 4 Foam Corners, 1.5 lb. Density Expanded Polyethylene Foam, Black | 1 | PCE
 | > | SH-PG0142 | TAZ 6: Top Endcap Foam, 1.5 lb. Density Expanded Polyethylene Foam, Black | 1 | PCE
 | > | SH-PG0143 | TAZ 6: Bottom Endcap Foam, 1.5 lb. Density Expanded Polyethylene Foam, Black | 1 | PCE
 | > | SH-PG0069 | 3M 8898 Economy Strapping Tape - 1⁄2" x 60 yards | 700 | mm
 | > | DC-MS0051 | EC Declaration of Conformity, TAZ 6.0 | 1 | PCE
 | > | DC-MS0052 | Safety Warnings sheet, TAZ 6.0 | 1 | PCE
 | > | SH-BX0051 | TAZ 6 Box White: 34-1/2 x 11-3/16 x 25 RSC, 51ECT, Double Wall, White, 2 Colors, Glue Joint | 1 | PCE
 | > | SH-BX0053 | TAZ 6 Scored Pad: 10-3/8 x 28-3/4 Scored Pad, 44 ECT, C Flute, Kraft, Plain | 1 | PCE
 | > | SH-BX0054 | TAZ 6 U-Pad: 25 x 19-7/16 Scored Pad, 51 ECT, Double Wall, Kraft, Plain | 1 | PCE
 | > | SH-BX0052 | TAZ 6 Bed Insert: 19-5/8 x 17-1/8 Die Cut, 44 ECT, C Flute, Kraft, Plain | 1 | PCE
 | > | AS-PK0006 | TAZ6, Olive Oil, Documentation Bag | 1 | PCE
 | > > | DC-MN0017 | Unboxing Guide, TAZ 6 | 1 | PCE
 | > > | DC-MN0016 | Operating Guide, TAZ 6 | 1 | PCE
 | > > | DC-MN0015 | Lulzbot-TAZ 6.0 User Manual | 1 | PCE
 | > > | SH-PG0083 | 9 x 12" 8 Mil Reclosable Bags | 1 | PCE
 | > | AS-PK0007 | TAZ6, Olive Oil, Extruder Package | 1 | PCE
 | > > | SH-PG0123 | TAZ 6: Tool Head Foam Insert: 1.2 lb. Density Extruded Polyethylene Foam, Gray | 1 | PCE
 | > > | SH-BX0055 | TAZ 6 Tool Head and Accessory Box: 9-1/2 x 7 x 3-7/8 Die Cut, 32 ECT, B Flute, Kraft, Plain | 1 | PCE
 | > > | HD-MS0375 | ESD Foam 1.06" x .6" x .3" - Extruder Pin Insertion | 1 | PCE
 | > > | DC-LB0107 | TAZ 6 Inner Box Label #2, Contents | 1 | PCE
 | > | AS-PK0008 | TAZ6, Olive Oil, Accessories Package | 1 | PCE
 | > > | DC-LB0095 | LulzBot Logo Sticker, 3 - Inch | 1 | PCE
 | > > | RM-MS0035 | nGen Amphora (colorFabb) Sample Pack, AM3300 Polymer, LulzBot Green | 1 | PCE
 | > > | DC-LB0106 | TAZ 6 Inner Box Label #1 Contents | 1 | PCE
 | > > | SH-PG0031 | 2 x 3" No Print Reclosable Static Shielding Bags (ESD) | 1 | PCE
 | > > | SH-MS0057 | Label nGen Sample (for Olive) | 1 | PCE
 | > > | SH-BX0055 | TAZ 6 Tool Head and Accessory Box: 9-1/2 x 7 x 3-7/8 Die Cut, 32 ECT, B Flute, Kraft, Plain | 1 | PCE
 | > > | RM-PL0149 | Verbatim PLA 2.85mm, 5m Sample Coil | 1 | PCE
 | > > | RM-PL0091 | High Temp PLA 2.85mm, 5 Meter Sample Coil, Proto-Pasta | 1 | PCE
 | > | AS-PK0009 | TAZ6, Tool Kit | 1 | PCE
 | > > | AS-PK0010 | 90 mm wiper pad set | 1 | PCE, 90mm, 5 pack
 | > > > | AS-PR0023 | 90mm Cut wiper pad | 5 | PCE, 90mm
 | > > > > | PP-FP0087 | LulzBot Wiper Pads | 90 | mm
 | > > > | SH-PG0002 | 3 x 4" 2 Mil Reclosable Polypropylene Bags | 1 | PCE
 | > > | TL-HD0280 | Tekton 13-pc. Long Arm Ball Hex Key Wrench Set (Metric) - Red/Bulk Un-packaged | 1 | PCE
 | > > | TL-HD0049 | 6" Deluxe Bent Stainless Steel Tweezers with Serrated Teeth and Safety Cap | 1 | PCE
 | > > | TL-HD0050 | Stanley 6" Long Nose Pliers | 1 | PCE
 | > > | TL-HD0048 | Elmer's X-Acto No. 1 Precision Knife - Aluminum | 1 | PCE
 | > > | TL-HD0008 | Stainless Steel Pocket Rule Semiflexible, Metric Grads, 150 mm Length | 1 | PCE
 | > > | TL-HD0046 | PRO DENTAL PICK (PROBE) (DP-19) M S V - in a protective sleeve or with a safety cap | 1 | PCE
 | > > | TL-MS0020 | .003 Stainless Steel/Straight Instrument Cleaner Brush | 1 | PCE
 | > > | DC-LB0062 | Clam Knife Sheath Sticker - Caution Sharp Blade! (1"x2.5" Rectangle) | 1 | PCE
 | > > | TL-HD0359 | 7 1/2" Nylon Handle Clam Knife - Laser Etched with "Sharp" Icon | 1 | PCE
 | > > | TL-MS0343 | Bright Travels Hanging Utility Kit - TAZ Tool Bag with LulzBot Green Logo | 1 | PCE
 | > | DC-LB0063 | Modification Warning Insert Modification 2.75 x 8.5 on 100 lb. Astrobright Lift Off Lemon Very Bright | 1 | PCE
 | > | DC-LB0105 | Arrow Labels - Yellow, 1 x 3" 500/roll | 1 | PCE
 | > | DC-MS0050 | Packing List, TAZ 6.0 | 1 | PCE
 | > | DC-LB0118 | Save your TAZ 6 Packaging Sticker | 1 | PCE

Sheet: Pivot Table_BOM Structure_1
Product Reference | Product Name | Unit of Measure | Sum - Quantity
AS-CB0005 | 40mm 5v Low Flow Fan-150mm Harness | PCE | 1
AS-CB0006 | X-Max-185mm Purple Harness | PCE | 2
AS-CB0007 | Heater Cartridge 180mm Harness | PCE | 1
AS-CB0008 | Thermistor 150mm Harness | PCE | 1
AS-CB0009 | Zero Sense 155mm Harness | PCE | 1
AS-HE0002 | .50mm Hot End Assembly, for single | PCE | 1
AS-PK0006 | TAZ6, Olive Oil, Documentation Bag | PCE | 1
AS-PK0007 | TAZ6, Olive Oil, Extruder Package | PCE | 1
AS-PK0008 | TAZ6, Olive Oil, Accessories Package | PCE | 1
AS-PK0009 | TAZ6, Tool Kit | PCE | 1
AS-PK0010 | 90 mm wiper pad set | PCE, 90mm, 5 pack | 1
AS-PR0001 | TAZ6, Olive Oil, Calibrated Assembly | PCE | 1
AS-PR0002 | TAZ6, Print Bed Assembly | PCE | 1
AS-PR0003 | TAZ6, Olive Oil, Final Mechanical Assembly | PCE | 1
AS-PR0004 | TAZ6, Olive Oil, Control Box Assembly | PCE | 1
AS-PR0006 | TAZ6, Frame, Final Assembly | PCE | 1
AS-PR0008 | TAZ6, Bed Mount Chassis with Inserts | PCE | 4
AS-PR0011 | TAZ6, Tippy Feed Tube Holder with Bushing Assembly | PCE | 1
AS-PR0012 | TAZ6, Spool Arm with Bushing Assembly | PCE | 1
AS-PR0013 | TAZ6, Z Axis Left Assembly | PCE | 1
AS-PR0014 | TAZ6, Z Carriage Motor with Bearings and Inserts Assembly | PCE | 1
AS-PR0015 | TAZ6, Z Carriage Motor with Bearings Assembly | PCE | 1
AS-PR0016 | TAZ6, Z Lower Left with Inserts Assembly | PCE | 1
AS-PR0017 | TAZ6, Z Axis Right Assembly | PCE | 1
AS-PR0018 | TAZ6, Z Carriage Idler with Bearings and Inserts Assembly | PCE | 1
AS-PR0019 | TAZ6, Z Carriage Idler with Bearings Assembly | PCE | 1
AS-PR0020 | TAZ6, Z Lower Right with Inserts Assembly | PCE | 1
AS-PR0021 | TAZ6, Olive Oil, Y Axis Assembly | PCE | 1
AS-PR0023 | 90mm Cut wiper pad | PCE, 90mm | 6
AS-PR0024 | TAZ6, Y Belt Mount with Inserts Assembly | PCE | 1
AS-PR0025 | 10mm Single Bearing holders Assembly | PCE | 4
AS-PR0026 | TAZ6, Y Corner Right with Insert Assembly | PCE | 2
AS-PR0027 | TAZ6, Y Corner Left with Insert Assembly | PCE | 2
AS-PR0028 | TAZ6, Y Idler with Bearings and Inserts | PCE | 1
AS-PR0030 | TAZ6, Y Axis Motor End Assembly | PCE | 1
AS-PR0032 | TAZ6, Olive Oil, X Carriage Assembly | PCE | 1
AS-PR0033 | TAZ6, X carriage with Inserts Assembly | PCE | 1
AS-PR0034 | TAZ6, 12mm Double Bearing Holder with Bearings Assembly | PCE | 1
AS-PR0035 | TAZ6, 12mm Single Bearing Holder with Bearing Assembly | PCE | 1
AS-PR0082 | Feed Tube Assembly, v3.0 | PCE | 1
AS-TH0003 | Large Herringbone, Green with Hob Bolt Assembly | PCE | 1
AS-TH0004 | Extruder Idler Block with Bearing Assembly | PCE | 1
AS-TH0005 | Extruder Thumb Screw assembly | PCE | 2
AS-TH0014 | TAZ6, Olive Oil, Extruder Assembly | PCE | 1
AS-TH0015 | TAZ6, Extruder Mount with Inserts | PCE | 1
AS-TH0016 | Extruder Heatsink Fan duct with Insert Assembly | PCE | 1
AS-TH0017 | TAZ6, Fan Duct Left | PCE | 1
AS-TH0018 | TAZ6, Fan Duct Right | PCE | 1
DC-LB0062 | Clam Knife Sheath Sticker - Caution Sharp Blade! (1"x2.5" Rectangle) | PCE | 1 | Sticker Giant
DC-LB0063 | Modification Warning Insert Modification 2.75 x 8.5 on 100 lb. Astrobright Lift Off Lemon Very Bright | PCE | 1 | THE PRINT SHOP OF LOVELAND LLC (FORMERLY LIGHT SPEED COLOR)
DC-LB0095 | LulzBot Logo Sticker, 3 - Inch | PCE | 1 | Sticker Giant
DC-LB0097 | TAZ v6.0 serial number sticker, KT-PR0041NA | PCE | 1 | THE PRINT SHOP OF LOVELAND LLC (FORMERLY LIGHT SPEED COLOR)
DC-LB0104 | Tool Head Wiring Connector Alignment Label | PCE | 2 | Sticker Giant
DC-LB0105 | Arrow Labels - Yellow, 1 x 3" 500/roll | PCE | 1 | Uline | S-13121
DC-LB0106 | TAZ 6 Inner Box Label #1 Contents | PCE | 1 | Sticker Giant
DC-LB0107 | TAZ 6 Inner Box Label #2, Contents | PCE | 1 | Sticker Giant
DC-LB0118 | Save your TAZ 6 Packaging Sticker | PCE | 1 | MaverickLabel
DC-MN0015 | Lulzbot-TAZ 6.0 User Manual | PCE | 1 | LIGHTNING SOURCE
DC-MN0016 | Operating Guide, TAZ 6 | PCE | 1
DC-MN0017 | Unboxing Guide, TAZ 6 | PCE | 1 | THE PRINT SHOP OF LOVELAND LLC (FORMERLY LIGHT SPEED COLOR)
DC-MS0049 | Test/Acceptance record TAZ 6.0 | PCE | 1 | THE PRINT SHOP OF LOVELAND LLC (FORMERLY LIGHT SPEED COLOR)
DC-MS0050 | Packing List, TAZ 6.0 | PCE | 1 | THE PRINT SHOP OF LOVELAND LLC (FORMERLY LIGHT SPEED COLOR)
DC-MS0051 | EC Declaration of Conformity, TAZ 6.0 | PCE | 1 | THE PRINT SHOP OF LOVELAND LLC (FORMERLY LIGHT SPEED COLOR)
DC-MS0052 | Safety Warnings sheet, TAZ 6.0 | PCE | 1 | THE PRINT SHOP OF LOVELAND LLC (FORMERLY LIGHT SPEED COLOR)
EL-CA0030 | North American - 6ft 18AWG Power Cord Cable w/ 3 Conductor PC Power Connector Socket (C13/5-15P) - Black, 5279, Box of 125 | PCE | 2 | Linvox | 3271V86
EL-CA0063 | 6ft Tripp Lite - USB 2.0 A/B Gold Device Cable Ferrite Chokes A Male B Male | PCE | 1 | Electronics Distributors Corp. | U023-006
EL-CA0078 | Flat Cables .050" 10C 10 COLOR 28AWG STRANDED 2x180mm | mm | 360 | TTI Global Distribution‎ | 3302/10-300
EL-FA0032 | Pelonis FAN 24V 40mmx40mmx10mm Low flow | PCE | 2 | Pelonis Technologies, Inc. | C4010L24BPLB1b-7
EL-FA0033 | Pelonis FAN 24V 80x80x15mm Low flow | PCE | 1 | Pelonis Technologies, Inc. | C8015L24BPLP1b-7
EL-FA0034 | Pelonis FAN 5V 40x40x10mm Low flow | PCE | 1 | Pelonis Technologies, Inc. | C4010L05BPLB1b-7
EL-FA0036 | TAZ 6 CB Case Fan Assembly v1.0 | PCE | 1
EL-HR0074 | DC Power Harness v1.0 TAZ 6 | PCE | 1
EL-HR0075 | X Harness External TAZ 6 | PCE | 1
EL-HR0076 | Taz 6 switch to PSU white | PCE | 1
EL-HR0077 | TAZ 6 switch to PSU black | PCE | 1
EL-HR0078 | TAZ 6 plug to ground green | PCE | 1
EL-HR0079 | TAZ 6 PSU to ground green | PCE | 1
EL-HR0080 | TAZ 6 plug to switch black and white with ferrite | PCE | 1
EL-HR0081 | TAZ 6 Bed Harness Internal | PCE | 1 | CCX Corp. | Q5-3X-3/4-01
EL-HR0082 | TAZ6 CB Bed Power Harness | PCE | 1
EL-HR0083 | Bed power harness external, TAZ 6 | PCE | 1
EL-HR0084 | TAZ 6, X Harness Internal | PCE | 1 | CCX Corp. | Q5-3X-3/4-01
EL-HR0087 | TAZ 6, CB Extruder Harness Internal | PCE | 1 | CCX Corp. | FSD74-6
EL-HR0088 | TAZ 6, Y & Z Harness Internal | PCE | 1 | CCX Corp. | Q5-3X-3/4-01
EL-HR0089 | Taz 6, Bed harness extension | PCE | 1
EL-HR0091 | Taz 6 Y & Z harness external | PCE | 1
EL-HR0092 | Taz 6, Extruder 0 harness external | PCE | 1
EL-HR0095 | Extruder Fan Harness TAZ 6, v0.1 | PCE | 1
EL-HR0096 | RevB Stepper Motor JST 115mm Harness | PCE | 1
EL-HR0097 | LCD Harness TAZ 6, v0.1 | PCE | 1
EL-HR0101 | Taz 6, CB extruder 1 harness | PCE | 1
EL-MS0008 | Anderson-Heavy Duty Power Connectors HOUSING ONLY, BLACK-BULK POWERPOLE 15/45 | PCE | 6 | Sager Electronics | 879-1327G6-BK
EL-MS0010 | Heavy Duty Power Connectors POWERPOLE 15A CONT | PCE | 6 | Mouser Electronics | 879-1332-BK
EL-MS0012 | Noninsulated Wire Ferrule, 24-20 AWG, .31" Pin Length | PCE | 2 | McMaster-Carr | 9681K15
EL-MS0014 | Noninsulated Wire Ferrule, 16 AWG, .28" Pin Length | PCE | 2 | McMaster-Carr | 9681K21
EL-MS0059 | Molex-CONN TERM FEMALE 22-24AWG TIN Reels of 20K | PCE | 53 | TTI Global Distribution‎ | 16-02-0086
EL-MS0062 | MOLEX-CONN HOUSING 4POS .100 W/LATCH | PCE | 1 | Sager Electronics | 50579404
EL-MS0073 | Tubing Corrugated Loom .25", Black, 3200' Box | mm | 1605 | Electronics Distributors Corp. | 88-00011
EL-MS0074 | Molex-CONN HOUSING 20POS .100 DUAL, BLACK | PCE | 1 | TTI Global Distribution‎ | 22552201
EL-MS0075 | CONN HOUSING 8POS .100 DUAL, Black | PCE | 1 | TTI Global Distribution‎ | 22552081
EL-MS0124 | 20-24 AWG Tin Sockets for Receptacle - 4K Reel | PCE | 13 | TTI Global Distribution‎ | 1-66331-4
EL-MS0133 | CONN, RCPT, 14 POS w/Brass Inserts | PCE | 1 | TTI Global Distribution‎ | 211103-1
EL-MS0139 | Tubing Corrugated Loom 3/8" ID, Black, 1900' Box | mm | 1420 | Electronics Distributors Corp. | 88-00012
EL-MS0141 | Term Ring Non Ins 26-22AWG #4 Order Bulk Only | PCE | 4 | TTI Global Distribution‎ | P22-4R-M
EL-MS0142 | Conn Recept Faston 22-26AWG .110 - Reel of 3K | PCE | 9 | TTI Global Distribution‎ | 7-520365-2
EL-MS0143 | Conn Fast Receptacle14-16 AWG .250 - REEL of 2200 Units | PCE | 7 | TTI Global Distribution‎ | 3-350819-2
EL-MS0144 | Connector Accessories, Sealing Cap, Shell Size 17 | PCE | 1 | TTI Global Distribution‎ | 207445-3
EL-MS0205 | Molex-CONN TERM MALE 22-24AWG TIN - Reels of 20K | PCE | 70 | TTI Global Distribution‎ | 16-02-0107
EL-MS0212 | Molex-CONN PIN 24-30AWG Crimp Tin, 20,000 Unit Reel | PCE | 2 | TTI Global Distribution‎ | 16-02-0105
EL-MS0246 | Conn Ring 16-22 AWG #4 Red PIDG - Reel 5000 | PCE | 2 | TTI Global Distribution‎ | 2-323758-1
EL-MS0248 | CONN RING 14-16 AWG #10 PIDG - 5,000 Unit Reel | PCE | 9 | TTI Global Distribution‎ | 2-36160-1
EL-MS0251 | CONN HOUSING 16POS .100 DUAL | PCE | 2 | TTI Global Distribution‎ | 22552161
EL-MS0332 | Ferrite Cable Cores 220ohms 100MHz 5mm I.D. | PCE | 2 | Mouser Electronics | 28B0434-000
EL-MS0346 | MOD PWR ENTRY INLET W/FUSE 6A - IEC C14 Receptacle – AC Filter 6A 250VAC | PCE | 1 | Digi-Key Corp | 817-1488-ND
EL-MS0347 | Fuse Ceramic 6.3A 250VAC 5X20MM | PCE | 2 | Digi-Key Corp | 023406.3MXP
EL-MS0351 | JST - CONN TERM CRIMP PH 24-30AWG - 8,000 Unit Reel | PCE | 20 | Future Electronics | SPH-002T-P0.5S
EL-MS0355 | CONN HOUSING PH 6POS 2MM WHITE | PCE | 5 | Digi-Key Corp | PHR-6
EL-MS0356 | Heat Shrink Dual Tubing 1/2" for 5mm ID 11mm OD Ferrite, Black 4FT | mm | 110 | Digi-Key Corp | WM7377-ND
EL-MS0361 | 16 AWG 6.0mm Pin Length Power Phase Black Single Wire - Insulated Ferrule | PCE | 8 | Mouser Electronics | FSD78-6-D
EL-MS0362 | 24 AWG 6.0mm Pin Length Single Wire - Insulated Ferrule | PCE | 4 | Fastenal | 713000
EL-MS0377 | 24V 30W Heater Cartridge, 23cm Leads (with no connectors on end) | PCE | 1 | Reprapdiscount / PLUG IT LTD | HC24V
EL-MS0385 | Verbatim 8GB SDHC Class 10 UHS-I / Bulk | PCE | 1 | Verbatim Americas, LLC | 99197
EL-MT0029 | NEMA 17 Stepper Motor, Moons' - NOT INCLUDING wire harness | PCE | 5 | Moons' Industries (America), Inc. | MS17HD6P4150-01-B
EL-PS0031 | Mean Well Switching Power Supplies 500W 24V 21A Power Supply W/PFC | PCE | 1 | Sager Electronics | RSP-500-24
EL-SW0022 | SWITCH BASIC SPDT 3A .110QC 125V | PCE | 5 | TTI Global Distribution‎ | SS-3GPT
EL-SW0023 | SWITCH ROCKER DPST 20A 250V, Illuminated Red | PCE | 1 | Mouser Electronics | 612-R5BBLKREDFF2
EL-SW0030 | Momentary Metal Flat Flush Mount Push Button Switch | PCE | 1 | Parts Express | 060-660 (66-2436)
EL-TH0011 | Semitec GT2 Thermistor (100kOhm type) 23cm Leads with no connectors on end. | PCE | 1 | Reprapdiscount / PLUG IT LTD | Semitec104gt2 Thermistor
EL-WR0040 | Wire - Single Conductor 20AWG SOLID PTFE, RED | mm | 155 | Allcable | 2856/1
EL-WR0099 | Shielded 22AWG UL2464 4 COND | mm | 2720 | Digi-Key Corp | W504-100-ND
EL-WR0103 | 24AWG Stranded – Red | mm | 3455 | Digi-Key Corp | C2015R-1000-ND
EL-WR0104 | 24AWG Stranded – Orange | mm | 3640 | Digi-Key Corp | C2015A-1000-ND
EL-WR0105 | 24AWG Stranded – Black | mm | 1235 | Digi-Key Corp | C2015B-1000-ND
EL-WR0106 | 16AWG Stranded – Red | mm | 1650 | Allcable | HU15691626RD
EL-WR0107 | 24AWG Stranded – White | mm | 2075 | Allcable | HU1569247WE
EL-WR0109 | 24AWG Stranded – Yellow | mm | 2720 | Allcable | HU1569247YW
EL-WR0111 | 24AWG Stranded – Blue | mm | 2600 | Allcable | HU1569247BE
EL-WR0119 | 24AWG Stranded Wire – Green | mm | 2455 | Digi-Key Corp | C2015G-100-ND
EL-WR0120 | 24AWG Stranded Wire – Purple | mm | 2225 | Digi-Key Corp | C2015V-100-ND
EL-WR0121 | 16AWG Stranded Wire – Black | mm | 2540 | Allcable | HU15691626BK
EL-WR0123 | 16AWG Stranded Wire – White | mm | 1490 | Digi-Key Corp | C2065W-100-ND
EL-WR0124 | 16AWG Stranded – Green w/ yellow stripe | mm | 220 | Allcable | HU15691626GN
EL-WR0135 | WIRE MTW 16AWG PPL 500ft SPOOL 600V 26-STRAND BARE COPPER - Purple | mm | 840 | Allcable | MTW16VT
HD-BL0009 | 1164-2P-06-2MR-1164-06 / GT 2 Single Sided Neoprene Belt - 1164mm by 6mm belt | PCE | 2 | B & B Manufacturing, Inc | 1164-2P-06 - 2MR-1164-06
HD-BT0010 | M4 x 20 Bolt, SHCS Black-oxide | PCE | 2 | McMaster-Carr | 91290A168
HD-BT0012 | M3 Set Screw (Grub Screw) | PCE | 12 | McMaster-Carr | 91390A100
HD-BT0039 | Metric Class 12.9 Socket Head Cap Screw, Alloy Steel, M3 Thread, 12MM Length, 0.50MM Pitch | PCE | 14 | McMaster-Carr | 91290A117
HD-BT0041 | Metric Class 12.9 Socket Head Cap Screw Alloy Steel, M3 Thread, 25mm Length, 0.50mm Pitch | PCE | 2 | McMaster-Carr | 91290A125
HD-BT0049 | Metric Class 12.9 Socket Head Cap Screw, Alloy Steel, M5 thread, 14MM length, 0.80MM pitch | PCE | 2 | McMaster-Carr | 91290A230
HD-BT0052 | Metric Class 12.9 Socket Head Cap Screw M4 Thread, 55mm Length, 0.70mm Pitch | PCE | 1 | McMaster-Carr | 91290A187
HD-BT0053 | 18-8 Stainless Steel Flat Head Phillips Machine Screw, Black-Oxide Finish, 4-40 Thread, 1/4" Length | PCE | 4 | McMaster-Carr | 96640A054
HD-BT0054 | Metric Class 12.9 Socket Head Cap Screw, Alloy Steel, M2.5 Thread, 12MM Length, 0.45MM Pitch | PCE | 4 | McMaster-Carr | 91290A104
HD-BT0061 | Class 10.9 Stl Button Head Socket Cap Screw M8 Size, 40 Mm Length, 1.25 Mm Pitch | PCE | 2 | Fastenal | 38972
HD-BT0073 | Class 10.9 Stl Button Head Socket Cap Screw M5 Size, 10 Mm Length, .8 Mm Pitch | PCE | 88 | Fastenal | 1139905
HD-BT0082 | Metric 18-8 SS Flat Head Socket Cap Screw M3 Size, 16mm Length, .50mm Pitch | PCE | 5 | McMaster-Carr | 92125A134
HD-BT0104 | M3 x 8 Bolt, BHCS, SST | PCE | 6 | McMaster-Carr | 92095A181
HD-BT0107 | Metric Class 12.9 Socket Head Cap Screw Alloy Steel, Black, M2 Thread, 10mm Length, 0.4mm Pitch | PCE | 10 | Fastenal | 134599
HD-BT0108 | Hobbed Bolt, M8 x 50mm Hex head, 26mm offset, Stainless Steel | PCE | 1 | Quattro Machining Services, Inc.
HD-BT0116 | Black Alloy Steel Flat-Head Socket Cap Screw, Class 10.9, M3 Size, 10mm Length, .50mm Pitch | PCE | 2 | Fastenal | 40923
HD-BT0118 | M3 x 14 Bolt FHCS, Black-Oxide | PCE | 4 | McMaster-Carr | 91294A133
HD-BT0137 | M3 x 8 Bolt, BHCS, Black-Oxide | PCE | 49 | Fastenal | 40868
HD-BT0146 | M3 x 12 BHCS, Black Oxide, Class 10.9 Steel | PCE | 27 | McMaster-Carr | 91239A117
HD-BT0148 | Class 10.9 Steel Button-Head Socket Cap Screw, M3 Size, 10 mm Length, .5 mm Pitch | PCE | 17 | McMaster-Carr | 91239A115
HD-BT0155 | Black Alloy Steel Flat-Head Socket Cap Screw, Class 10.9, M4 Size, 6mm Length, .70mm Pitch | PCE | 5 | Fastenal | 40931
HD-BT0171 | Class 10.9 Steel Button-Head Socket Cap Screw M3 Size, 20 mm Length, .5 mm Pitch | PCE | 4 | Fastenal | 11510092
HD-BT0172 | M3 x 4 Setscrew (Heater Cartridge Set Screw) | PCE | 1 | Reprapdiscount / PLUG IT LTD | M3x4 Setscrew
HD-BT0173 | Heat Sink Setscrew (M2 x 6 SCHS) | PCE | 1 | Reprapdiscount / PLUG IT LTD | M2x6 SCHS
HD-BT0175 | Thread-Locking Socket Head Cap Screw, Alloy Steel, M5 Thread, 16mm Long, 0.8mm Pitch | PCE | 4 | McMaster-Carr | 91760A242
HD-BU0029 | DryLin® R - Solid Precision Polymer Bearing RJMP-01, 12mm | PCE | 3 | Igus, Inc. | RJMP-01-12
HD-BU0030 | DryLin® R - Solid Polymer Bearing RJMP-01-10mm | PCE | 5 | Igus, Inc. | RJMP-01-10
HD-EX0061 | T-Slot Extrusion, Aluminum, 20mm x 20mm x 510mm, Black | PCE | 4 | In-Position Technologies | 2020M CTL
HD-EX0062 | T-Slot Aluminum Frame TPW, Extrusion 20mm x 20mm x 500mm,Tapped M5x0.8 on Both Ends, Black (Ends free of anodize) | PCE | 2 | In-Position Technologies | 2020M 2 Tap
HD-EX0063 | T-Slot Aluminum Frame LTP, Extrusion 20mm x 20mm x 500mm,Tapped M5x0.8 on One End, Black | PCE | 4 | In-Position Technologies | 2020M 1 Tap
HD-MS0002-3 | Borosilicate Glass Bed 300mm x 300mm x 1/8" | PCE | 1 | Allen Scientific Glass, Inc. | HD-MS0002-3
HD-MS0027 | Extruder Comp Spring - Music Wire, Extruder, 6mm OD, 0.8mm WD, 9.7mm FL | PCE | 2 | Associated Spring | C0240-032-0380-M
HD-MS0030 | Metric Brass Heat-Set Insert for Plastics Tapered, M3-.5 Internal Thread, 3.8mm Length | PCE | 48 | McMaster-Carr | 94180A331
HD-MS0031 | Metric Press-Fit Plastic Thumb Screw Head Knurled, Black, Fits M4 Screw, 13mm A, 5.5mm B | PCE | 1 | Fastenal | 11102951
HD-MS0033 | GT2, 16 Teeth, timing pulley, AL | PCE | 2 | B & B Manufacturing, Inc | 16-2P06M6CA5
HD-MS0055 | Metric Press-Fit Plastic Thumb Screw Head Knurled, Black, Fits M5 Screw, 16mm A, 6.5mm B | PCE | 4 | Fastenal | 11225-04232
HD-MS0058 | Wire Tie, 8" Black, pk 1000 | PCE | 17 | McMaster-Carr | 7130K32
HD-MS0060 | Metric Brass Heat-Set Insert For Plastics Tapered, M5-.8 Internal Thread, 11.1mm Length | PCE | 7 | McMaster-Carr | 94180A363
HD-MS0062 | Metric Aluminum Unthreaded Spacer, 8MM OD, 8MM Length, M5 Screw Size | PCE | 2 | McMaster-Carr | 94669A757
HD-MS0249 | UV-Resistant Cable Tie Holder, Adhesive Back/Screw Mount, 4-Way, for.18" Maximum Tie, Black | PCE | 4 | McMaster-Carr | 7582K22
HD-MS0282 | 608-2RS ABEC3/C3 Rubber Sealed Bearing - BLACK | PCE | 11 | JSB Great Bearings | 608-2RS ABEC3/C3
HD-MS0287 | Metric 18-8 Stainless Steel Unthreaded Spacer, 8mm OD, 10mm Length, M3 Screw Size | PCE | 4 | Fastenal | 11225-04326
HD-MS0310 | TAPE3M468MP.005X26.000X60YD .005" THK 3M ADHESIVE 468MP 26" WIDE X 60 YARDS | cm² | 1024
HD-MS0311 | SULT1000NA.010X26.000X90FT - 0.010 X 26.000 WIDE X 90 FT NAT ULTEM 1000 FILM | cm² | 1024
HD-MS0336 | Black Adhesive-Back Bumper, Square, Polyurethane, 3/4" Wide, 1/4" High | PCE | 7 | McMaster-Carr | 95495K716
HD-MS0349 | PEI (10mil) with 3M 468 adhesive attached, heat-treated, TAZ | PCE | 1
HD-MS0351 | Helical Flexible Shaft Coupling with Set Screw - X10835-5mm-5mm - Anodize IAW HPS1000 | PCE | 2 | Helical Products Company, Inc. | 30070
HD-MS0375 | ESD Foam 1.06" x .6" x .3" - Extruder Pin Insertion | PCE | 1 | Preferred Packaging Products, Inc. | 4075
HD-NT0001 | Metric Zinc-Plated Steel Nylon-Insert Locknut, Class 8, M3 Screw sz, .5MM pitch, 5.5MM W, 4MM H | PCE | 3 | McMaster-Carr | 90576A102
HD-NT0002 | M8 Nyloc Nut, Zinc Plated | PCE | 3 | McMaster-Carr | 90576A117
HD-NT0004 | M3 Nut, Steel, Zinc Plated | PCE | 6 | McMaster-Carr | 90591A121
HD-NT0011 | M4 Nut, Steel, Zinc Plated | PCE | 4 | McMaster-Carr | 90591A141
HD-NT0044 | Post assembly M5 T-nut | PCE | 1 | Misumi USA | HNTAP5-5
HD-NT0053 | T-Slot Slide in T-nuts for Aluminum Frame, M5 | PCE | 74 | In-Position Technologies | 682888
HD-NT0355 | Helix - Nut, Lead Screw, Resin, 12mm x 2mm, RH PPS, Round Flange | PCE | 2 | Helix Linear Technologies | 16011745-01
HD-RD0004 | 8mm Smooth Rod x 18-19mm, Stainless Steel (Nubbin) | PCE | 1 | Vergent Products | ALE-0000108
HD-RD0018 | 10mm Smooth Rod, Stainless Steel, 500mm | PCE | 4 | Igus, Inc. | EWMR-10-500x
HD-RD0047 | 12mm X 515mm Stainless Steel Smooth Rod | PCE | 2 | Misumi USA | SSFHR12-515
HD-RD0048 | Helix - Screw, Lead, Stainless Steel 12mm x 2mm, RH, 420mm OAL, Machined | PCE | 2 | Helix Linear Technologies | 16011746-01
HD-TB0007 | Feed Tube, 0.187 ID X .250 OD NAT PTFE Tube | mm | 850 | Professional Plastics | 0.187 ID X .250 OD NAT PTFE TUBE
HD-TB0066 | Flexible Polyolefin Heat Shrink Tubing 1/8" ID Before, 1/16" ID After, 100' L, Black | mm | 40 | Electronics Distributors Corp. | 88-01250
HD-WA0006 | M8 Washer, Steel, Zinc Plated | PCE | 10 | McMaster-Carr | 91166A270
HD-WA0008 | Metric Spring Steel Shim - DIN 988 0.5mm Thick, 8mm ID, 14mm OD | PCE | 1 | Fastenal | 11511045
HD-WA0009 | Metric Spring Steel Shim - DIN 988 1.0mm Thick, 8mm ID, 14mm OD | PCE | 1 | Fastenal | 11511046
HD-WA0012 | Steel Flat Washer, DIN 125 zinc-plated class 4,M2 screw sz, 5mm OD, .25mm-.35mm thick | PCE | 10 | Fastenal | 40350
HD-WA0013 | Steel Flat Washer, DIN 125 Zinc-Plated Class 4, M2.5 screw sz, 6MM OD, .45MM-.55MM thick | PCE | 4 | Fastenal | 40351
HD-WA0027 | Metric 18-8 Stainless Steel Internal-Tooth Lock Washer, M3 Screw Size, 6MM OD, .4MM Min Thick | PCE | 3 | McMaster-Carr | 93925A240
HD-WA0035 | Metric 18-8 Stainless Steel External Serrated Lock Washer, M3 Screw Size, 6mm OD, 0.4mm min Thick | PCE | 1 | McMaster-Carr | 91120A120
HD-WA0038 | Black-Oxide 18-8 Stainless Steel Flat Washer, M3 Screw Size, 3.2mm ID, 7.0mm OD | PCE | 105 | McMaster-Carr | 98269A420
HD-WA0039 | Black-Oxide 18-8 Stainless Steel Flat Washer, M4 Screw Size, 4.3mm ID, 9.0mm OD | PCE | 6 | Fastenal | 11264487
HD-WA0040 | Black-Oxide 18-8 Stainless Steel Flat Washer, M5 Screw Size, 5.3mm ID, 10.0mm OD | PCE | 90 | Fastenal | 11264558
KT-PR0041NA | LulzBot TAZ 3D Printer, v6.0 Boxed for Retail, NA | PCE | 1
PC-AS0019 | Full Graphic Smart LCD Controller, gLCD Kit | PCE | 1 | Reprapdiscount / PLUG IT LTD
PC-AS0041 | Plastic Laser Cut LCD Cover | PCE | 1 | Laser Engraving Designs, LLC
PC-BD0027 | Silicon Heater, 24V ,360W, 298mm x 298mm, Self Adhesive, w/ connectors | PCE | 1 | National Plastic Heater | NPH PC-BD0027
PC-BD0045 | RAMBo Electronics v1.3L Assembled Board Only | PCE | 1 | Ultimachine | UMRAMBOPCB13
PC-CN0001 | Molex-Conn Housing 2POS .100 W/Latch | PCE | 4 | Digi-Key Corp | WM2900-ND
PC-CN0010 | Conn Socket IDC, 10POS DUAL 30AU, | PCE | 2 | TTI Global Distribution‎ | 71600-010LF
PC-CN0032 | Term Block Plug 2POS STR 5.08MM | PCE | 3 | TTI Global Distribution‎ | 395300002
PC-CN0036 | Term Block Plug 6POS STR 5.08mm | PCE | 1 | TTI Global Distribution‎ | 395300006
PC-CN0053 | Headers & Wire Housings HSG 12P W/O Ears Single Row | PCE | 1 | Mouser Electronics | 538-70107-0011
PC-CN0055 | Headers & Wire Housings Male 20Ckt | PCE | 1 | Mouser Electronics | 538-70107-0019
PC-CN0057 | Male 16 pin Molex Connector Housing | PCE | 1 | Mouser Electronics | 538-70107-0015
PC-CN0059 | Male 10 pin Molex Connector Housing | PCE | 1 | Mouser Electronics | 538-70107-0009
PC-CN0061 | Male 8 pin Molex Connector Housing | PCE | 1 | Mouser Electronics | 538-70107-0007
PC-CN0062 | Female 8 pin Molex Connector Housing | PCE | 1 | Mouser Electronics | 538-50-57-9408
PP-FP0073 | Silk Screened TAZ Electronics Chassis revD, PP-MP0110 | PCE | 1 | Precision Metal Manufacturing
PP-FP0075 | Silk Screened and Laser Etched TAZ Electronics Chassis revE v0.3 PP-FP0073 | PCE | 1 | Laser Engraving Designs, LLC
PP-FP0076 | Silk Screened and Laser Etched TAZ Electronics Cover PP-MP0109 | PCE | 1 | Laser Engraving Designs, LLC
PP-FP0078 | Laser Etched TAZ Interconnect Cover v0.5, PP-MP0107 | PCE | 1 | Laser Engraving Designs, LLC
PP-FP0080 | Laser Etched TAZ Bed Mount Plate, 6061 v5.0 - PP-MP0145 | PCE | 1 | Laser Engraving Designs, LLC
PP-FP0087 | LulzBot Wiper Pads | mm | 180 | eNTWORKS Ltd.
PP-GP0060 | Extruder Washer v3.0, Taz | PCE | 1
PP-GP0089 | LCD_spacer_v0.4 | PCE | 4
PP-GP0091 | Extruder Latch v2.1 | PCE | 1
PP-GP0154 | Electronics Case Mount v1.0 | PCE | 4
PP-GP0186 | extruder body hex black v1.4.1 | PCE | 1
PP-GP0191 | Herringbone Large Gear v1.3, Lulzbot green | PCE | 1
PP-GP0192 | Herringbone Small Gear v1.1, Lulzbot green | PCE | 1
PP-GP0193 | Extruder Idler Block v1.4c, Taz & Mini | PCE | 1
PP-GP0206 | X Carriage TAZ6 v0.3 | PCE | 1
PP-GP0207 | X Carriage Guide v2.0 | PCE | 1
PP-GP0208 | Extruder Mount TAZ6 v0.8 | PCE | 1
PP-GP0211 | Fan duct left v0.7.4 | PCE | 1
PP-GP0212 | Fan duct right v0.7.4 | PCE | 1
PP-GP0215 | Z Lower Left, v2.3 | PCE | 1
PP-GP0216 | Z-min switch mount v4.1 | PCE | 1
PP-GP0217 | Spool Arm v0.2 | PCE | 1
PP-GP0218 | Tippy Feed tube holder v0.6 | PCE | 1
PP-GP0219 | Feed tube spinner v3.0 | PCE | 1
PP-GP0220 | Interconnect housing v0.6 | PCE | 1
PP-GP0221 | Bed corner TAZ6 v2.0 | PCE | 4
PP-GP0222 | Y belt mount v.75 | PCE | 1
PP-GP0223 | Bed Mount Chassis v3.3 | PCE | 1
PP-GP0224 | Bed mount table v3.1 | PCE | 4
PP-GP0225 | Y Idler Mount v4.0, TAZ | PCE | 1
PP-GP0226 | Y Motor Mount v3.0, TAZ | PCE | 1
PP-GP0227 | Z Lower Right, v2.3 | PCE | 1
PP-GP0228 | Y Corner Left V2.4 | PCE | 1
PP-GP0229 | Y Corner Right v2.4 | PCE | 1
PP-GP0230 | LCD_bezel | PCE | 1
PP-GP0231 | Wiper Mount, v1.1 | PCE | 1
PP-GP0232 | heatsink-fan-duct_black_v0.6 | PCE | 1
PP-GP0234 | LCD Knob, V0.2 Design Dent 2 | PCE | 1
PP-GP0235 | SD card bezel v0.8 | PCE | 1
PP-GP0236 | Z Upper v2.3 | PCE | 2
PP-GP0237 | Flexy Washer v0.1 | PCE | 2
PP-GP0238 | Flexy Bed Foot v0.1 | PCE | 4
PP-MP0066 | Metric Brass Heat-Set Insert for Plastics, Tapered, M2-.4 Internal Thread, 2.9MM Length | PCE | 10 | McMaster-Carr | 94180A307
PP-MP0082 | Bed Leveling Washer, 303 SST | PCE | 4 | MBK Machine Corp. (S&DC CORP)
PP-MP0106 | Corner Bracket V2.0 | PCE | 8 | Precision Metal Manufacturing
PP-MP0107 | TAZ Interconnect Cover V0.5 | PCE | 1 | Precision Metal Manufacturing
PP-MP0109 | TAZ Electronics Cover, v0.4 with Powder Coat | PCE | 1 | Precision Metal Manufacturing
PP-MP0111 | Y End Plate v0.2 | PCE | 2 | Precision Metal Manufacturing
PP-MP0133 | Hexagon Heatsink for 3mm Filament | PCE | 1 | Reprapdiscount / PLUG IT LTD | Hexagon AO Body
PP-MP0134 | Hexagon Heater Block with Holes for Retention Plate and Hexagon Logo Laser Etched on Front | PCE | 1 | Reprapdiscount / PLUG IT LTD | Hexagon AO Block
PP-MP0135 | 0.5mm Nozzle for 3mm Filament | PCE | 1 | Reprapdiscount / PLUG IT LTD | Nozzle 0.5mm
PP-MP0136 | Thermistor Retention Plate | PCE | 1 | Reprapdiscount / PLUG IT LTD | Hexagon AO Retention Plate
PP-MP0137 | Standard Hexagon Mount Plate | PCE | 1 | Reprapdiscount / PLUG IT LTD | Grove Mount Plate
PP-MP0145 | TAZ 300mm Bed Plate, 6061, revC | PCE | 1 | Precision Metal Manufacturing | PP-MP0145
RM-AB0082 | Black ABS 3mm Filament, 5lb Reel Village Plastics | g | 724.94 | Village Plastics (3D SYSTEMS, INC.) | 356327-00-012-3MM-BK-5LB-R-ABS
RM-AB0096 | LulzBot Green ABS 3mm Filament, 5lb Reel Village Plastic | g | 190.63 | Village Plastics (3D SYSTEMS, INC.) | 357549-00-01-3MM-GNLULZ-543.1-5LB-R ABS
RM-MS0035 | nGen Amphora (colorFabb) Sample Pack, AM3300 Polymer, LulzBot Green | PCE | 1
RM-PL0091 | High Temp PLA 2.85mm, 5 Meter Sample Coil, Proto-Pasta | PCE | 1 | Proto-Pasta / ProtoPlant
RM-PL0149 | Verbatim PLA 2.85mm, 5m Sample Coil | PCE | 1
RM-TE0002 | Midnight NinjaFlex™ TPE Filament, 3mm, 0.75kg | g | 1.98 | Fenner Drives | 3D3011290A
RM-TE0027 | LulzBot Green NinjaFlex TPE Filament, 3mm. 0.75kg Fenner Drives | g | 6.72 | Fenner Drives | 3D3261290
SH-BX0051 | TAZ 6 Box White: 34-1/2 x 11-3/16 x 25 RSC, 51ECT, Double Wall, White, 2 Colors, Glue Joint | PCE | 1 | Preferred Packaging Products, Inc. | 3080E
SH-BX0052 | TAZ 6 Bed Insert: 19-5/8 x 17-1/8 Die Cut, 44 ECT, C Flute, Kraft, Plain | PCE | 1 | Preferred Packaging Products, Inc. | 3080F
SH-BX0053 | TAZ 6 Scored Pad: 10-3/8 x 28-3/4 Scored Pad, 44 ECT, C Flute, Kraft, Plain | PCE | 1 | Preferred Packaging Products, Inc. | 3080G
SH-BX0054 | TAZ 6 U-Pad: 25 x 19-7/16 Scored Pad, 51 ECT, Double Wall, Kraft, Plain | PCE | 1 | Preferred Packaging Products, Inc. | 3080H
SH-BX0055 | TAZ 6 Tool Head and Accessory Box: 9-1/2 x 7 x 3-7/8 Die Cut, 32 ECT, B Flute, Kraft, Plain | PCE | 2 | Preferred Packaging Products, Inc. | 3080I
SH-MS0057 | Label nGen Sample (for Olive) | PCE | 1 | Sticker Giant
SH-PG0002 | 3 x 4" 2 Mil Reclosable Polypropylene Bags | PCE | 1 | Uline | S-1292
SH-PG0031 | 2 x 3" No Print Reclosable Static Shielding Bags (ESD) | PCE | 1 | Mouser Electronics | 517-30023
SH-PG0069 | 3M 8898 Economy Strapping Tape - 1⁄2" x 60 yards | mm | 700 | Uline | S-16075
SH-PG0072 | 3M 8898 Economy Strapping Tape - 2" x 60 yards | mm | 600 | Uline | S-16076
SH-PG0083 | 9 x 12" 8 Mil Reclosable Bags | PCE | 1 | Uline | S-13440
SH-PG0123 | TAZ 6: Tool Head Foam Insert: 1.2 lb. Density Extruded Polyethylene Foam, Gray | PCE | 1 | Preferred Packaging Products, Inc. | 3080D
SH-PG0131 | #260 White Reinforced Gummed Tape with LulzBot Printed Logo, 10 Pack | inch(es) | 144 | Preferred Packaging Products, Inc. | 815
SH-PG0141 | TAZ 6: Set of 4 Foam Corners, 1.5 lb. Density Expanded Polyethylene Foam, Black | PCE | 1 | Preferred Packaging Products, Inc. | 3080C
SH-PG0142 | TAZ 6: Top Endcap Foam, 1.5 lb. Density Expanded Polyethylene Foam, Black | PCE | 1 | Preferred Packaging Products, Inc. | 3080A
SH-PG0143 | TAZ 6: Bottom Endcap Foam, 1.5 lb. Density Expanded Polyethylene Foam, Black | PCE | 1 | Preferred Packaging Products, Inc. | 3080B
SR-MN0001 | Laser Etching Service for PP-FP0075 | PCE | 1 | Laser Engraving Design
SR-MN0002 | Laser Etching Service for PP-FP0076 | PCE | 1 | Laser Engraving Design
SR-MN0003 | Laser Etching Service for PP-FP0078 | PCE | 1
SR-MN0004 | Laser Etching Service for PP-FP0080 | PCE | 1 | Laser Engraving Design
TL-HD0008 | Stainless Steel Pocket Rule Semiflexible, Metric Grads, 150 mm Length | PCE | 1 | McMaster-Carr | 6813A62
TL-HD0046 | PRO DENTAL PICK (PROBE) (DP-19) M S V - in a protective sleeve or with a safety cap | PCE | 1 | Image Supply Service, Inc. | J1031S
TL-HD0048 | Elmer's X-Acto No. 1 Precision Knife - Aluminum | PCE | 1 | BUSINESS SUPPLY | EPIX3201
TL-HD0049 | 6" Deluxe Bent Stainless Steel Tweezers with Serrated Teeth and Safety Cap | PCE | 1 | ROEDER INDUSTRIES INC. | TWE6 6'' Tweezers
TL-HD0050 | Stanley 6" Long Nose Pliers | PCE | 1 | Image Supply Service, Inc. | 2532-8493
TL-HD0280 | Tekton 13-pc. Long Arm Ball Hex Key Wrench Set (Metric) - Red/Bulk Un-packaged | PCE | 1 | Boston Industrial Tools | 25272
TL-HD0359 | 7 1/2" Nylon Handle Clam Knife - Laser Etched with "Sharp" Icon | PCE | 1 | Laser Engraving Designs, LLC
TL-MS0020 | .003 Stainless Steel/Straight Instrument Cleaner Brush | PCE | 1 | GORDON BRUSH MFG CO, INC | 906501
TL-MS0343 | Bright Travels Hanging Utility Kit - TAZ Tool Bag with LulzBot Green Logo | PCE | 1 | Specialty Incentives, Inc | 7007-04BKOR

Sheet: product_supplier
id | default_code | seller_ids/name/name | seller_ids/product_code
__export__.product_template_5573 | HD-MS0302 | Professional Plastics | SULT1000NA.010X26.000X90FT
__export__.product_template_2576 | TL-MS0020 | GORDON BRUSH MFG CO, INC | 906501
 |  | GORDON BRUSH MFG CO, INC | 906501
__export__.product_template_2407 | TL-MS0022 | GORDON BRUSH MFG CO, INC | 906500SDX
__export__.product_template_2039 | PP-MP0033 | Home Depot | 78575126029
__export__.product_template_283 | EL-MS0044 | Hansen Hobbies | HH-SC_PCB_PT1INSS
__export__.product_template_6873 | PP-MP0138 | Reprapdiscount / PLUG IT LTD | Nozzle 0.35mm
__export__.product_template_6866 | PP-MP0135 | Reprapdiscount / PLUG IT LTD | Nozzle 0.5mm
__export__.product_template_6874 | PP-MP0139 | Reprapdiscount / PLUG IT LTD | Nozzle 0.6mm
__export__.product_template_4923 | TL-HD0233 | Home Depot
__export__.product_template_1249 | HD-MS0072 | SDP-SI | A 7Z41MPSB10M
__export__.product_template_2153 | HD-MS0073 | VXB, NationSkander California Corp. | 100Skate
__export__.product_template_1661 | EL-CA0012 | tinxi-english
__export__.product_template_335 | EL-TH0003 | Mouser Electronics | 871-B57560G104F
 |  | Ultimachine | UMTHR100
 |  | Digi-Key Corp | 495-2136-ND
 |  | Vergent Products | ALE-0000094
__export__.product_template_37 | EL-TH0001 | Mouser Electronics | 785-135-104LAG-J01
 |  | Vergent Products | ALE-0000022
 |  | Digi-Key Corp | 480-3135-ND
__export__.product_template_4056 | HD-MS0204 | VXB, NationSkander California Corp. | kit708
__export__.product_template_1009 | OF-MS0065 | Shippers Supply, Inc | VDF13
__export__.product_template_819 | HD-RD0031 | McMaster-Carr | 99030A001
__export__.product_template_7643 | HD-BT0177 | Monoprice | 8621
__export__.product_template_7379 | OF-CS0418 | envelopesuperstore.com | 99602
__export__.product_template_3127 | EL-CA0033 | Monoprice | 5280
__export__.product_template_3128 | EL-CA0029 | Monoprice | 3384
__export__.product_template_4657 | EL-CA0066 | Monoprice | 3391
__export__.product_template_4291 | EL-CA0052 | Monoprice | 3659
__export__.product_template_925 | EL-CA0010 | Monoprice | 5439
__export__.product_template_885 | EL-CA0011 | Monoprice | 5449
__export__.product_template_5185 | EL-CA0072 | Digi-Key Corp | TL383-ND
__export__.product_template_3139 | FR-ST0085 | Walmart
__export__.product_template_7725 | OF-CP0234 | pfSense | CAB-10GSFP-P1M
__export__.product_template_7726 | OF-CP0235 | pfSense | CAB-10GSFP-P3M
__export__.product_template_4669 | HD-MS0251 | CS Hyde Company | 36-10A-12x12
__export__.product_template_4692 | HD-MS0253 | CS Hyde Company | 36-10A-12x12
__export__.product_template_4691 | HD-MS0252 | CS Hyde Company | 36-10A
__export__.product_template_4668 | HD-MS0250 | CS Hyde Company | 36-10A
__export__.product_template_1678 | FR-ST0034 | Fastenal | 403084
__export__.product_template_5275 | HD-RD0045 | Misumi USA | SLMU10
__export__.product_template_1797 | HD-RD0018 | Igus, Inc. | EWMR-10-500x
 |  | Igus, Inc. | EWMR-10-500x
__export__.product_template_4292 | EL-MS0204 | Flexfire LEDs | RGB-C2
__export__.product_template_7054 | PP-MP0150 | Amazon | B019MUIC
__export__.product_template_4478 | HD-NT0047 | Thomson | CTL_MTS10X2M
__export__.product_template_5274 | HD-RD0044 | Misumi USA | SFJ10-477
__export__.product_template_5267 | HD-RD0039 | Misumi USA | SSFHR10-477
__export__.product_template_5273 | HD-RD0043 | Misumi USA | SFJ10-500
__export__.product_template_7743 | HD-RD0050 | Igus, Inc. | HD-RD0050
__export__.product_template_2344 | OF-CP0076 | Monoprice | 9200
__export__.product_template_529 | TL-EL0003 | Zephyrtronics | THB-0010
__export__.product_template_530 | TL-HD0015 | Zephyrtronics | AT-10PC-S&P
__export__.product_template_8280 | PC-CN0065 | Digi-Key Corp | 952-1383-ND
__export__.product_template_1116 | OF-PA0020 | Shippers Supply, Inc | RP5
__export__.product_template_1397 | SH-PG0007 | Shippers Supply | R17
__export__.product_template_2143 | SH-BX0001 | SHIPPERS' SUPPLY CUSTOM PACK | R17
 |  | Uline | S-4105
__export__.product_template_1118 | SH-PG0008 | Shippers Supply, Inc | F21013
__export__.product_template_5684 | SH-PG0095 | Uline | S-14445
__export__.product_template_2617 | SH-BX0025 | SHIPPERS' SUPPLY CUSTOM PACK
__export__.product_template_3959 | SH-PG0065 | Uline | S-16536
__export__.product_template_901 | SH-BX0003 | SHIPPERS' SUPPLY CUSTOM PACK | R15
 |  | Uline | S4103
__export__.product_template_2577 | EL-MS0079 | YUBICO USA INC.
__export__.product_template_4797 | EL-CA0059 | Beehive Electronics | 110A
__export__.product_template_7721 | HD-BU0035 | Fastenal | 68014
__export__.product_template_5213 | SH-PG0088 | Uline | S-3180
__export__.product_template_5095 | HD-MS0273 | McMaster-Carr | 7776A25
__export__.product_template_6746 | SH-BX0058 | Uline | S-650
__export__.product_template_10265 | TL-CS0223 | Schleuniger, Inc. | PSP-639.0011
__export__.product_template_862 | HD-BL0009 | B & B Manufacturing, Inc | 1164-2P-06 - 2MR-1164-06
__export__.product_template_7428 | KT-CP0107 | B & B Manufacturing, Inc
__export__.product_template_3968 | SH-PA0023 | Uline | S-2964P
__export__.product_template_3271 | TL-MS0084 | McMaster-Carr | 1174K33
__export__.product_template_3273 | TL-MS0085 | McMaster-Carr | 1174K39
__export__.product_template_4803 | OF-MS0272 | Fire Exinguisher Depot | 397
__export__.product_template_4204 | SH-PG0070 | Uline | S-16668
__export__.product_template_5068 | FR-ST0144 | Uline | S-15643G
__export__.product_template_5067 | FR-ST0143 | Uline | S-12415BLU
__export__.product_template_5064 | FR-ST0140 | Uline | S-12416BLU
__export__.product_template_5150 | OF-MS0313 | Home Depot
__export__.product_template_4479 | TL-PW0057 | Amazon | CHIGH0014UL
__export__.product_template_4254 | FR-TB0023 | JUST OFFICE FURNITURE | PL237
__export__.product_template_5372 | FR-FU0053 | JUST OFFICE FURNITURE
__export__.product_template_1822 | OF-PA0019 | Shippers Supply, Inc | RP22
__export__.product_template_1762 | HD-MS0070 | Home Depot | 96037157503
__export__.product_template_6133 | OF-MS0380 | Amazon | BTKR-2502
__export__.product_template_1845 | PP-MP0032 | HardwareAndTools.com | 6102362
__export__.product_template_7762 | OF-MS0485 | Amazon | B00ATWXRWW
__export__.product_template_1120 | SH-MS0010 | Shippers Supply, Inc | HS-12
__export__.product_template_1686 | HD-MS0068 | Home Depot
__export__.product_template_1685 | HD-MS0069 | Home Depot | 1508108
__export__.product_template_8135 | TL-CS0202 | Home Depot | 788-287
__export__.product_template_9922 | TL-MS0486 | Home Depot | 803014143363
__export__.product_template_6940 | OF-MS0435 | Home Depot | 504926
__export__.product_template_6971 | KT-CP0097 | Igus, Inc. | RJMP-01, 12mm
__export__.product_template_7204 | PP-MP0155 | E3D Online Ltd. | CC-AO-NOZZEL-1200
__export__.product_template_7077 | KT-HD0002 | Igus, Inc. | EWMR-12-515x
__export__.product_template_7742 | HD-RD0051 | Igus, Inc. | HD-RD0051
__export__.product_template_6036 | HD-RD0047 | Misumi USA | SSFHR12-515
 |  | Igus, Inc. | EWMR-12-515x
__export__.product_template_1665 | HD-MS0137 | Fastenal | 68615
__export__.product_template_4278 | TL-HD0188 | Home Depot | 34139160328
__export__.product_template_6777 | HD-MS0356 | SHIPPERS' SUPPLY CUSTOM PACK
__export__.product_template_1339 | OF-MS0012 | Office Max | 71701913319
__export__.product_template_3991 | SH-PA0024 | SHIPPERS' SUPPLY CUSTOM PACK
__export__.product_template_8229 | OF-CS0428 | Amazon | B00HRCNB1E
__export__.product_template_26 | EL-PS0001 | Powergate, LLC | SP-240-12
 |  | Yueqing Mingyu Electronic Technology Co., Ltd. | S-240-12
__export__.product_template_453 | EL-PS0003 | Shenzhen TongliYuan Electronics Co., Ltd | S-300-12
__export__.product_template_2087 | EL-PS0009 | Shenzhen TongliYuan Electronics Co., Ltd | S-360-12
__export__.product_template_1531 | EL-FA0004 | Kysan | TF4010-12H-S
__export__.product_template_4159 | EL-PS0021 | Amazon
__export__.product_template_1695 | EL-MT0009 | Monster Guts | 12VWM
__export__.product_template_1357 | TL-PW0015 | Home Depot | 45242293025
__export__.product_template_6352 | SH-PG0111 | Uline | S-1703
__export__.product_template_1891 | HD-MS0074 | 1984yht888 | 8992
__export__.product_template_1138 | SH-PG0009 | Shippers Supply, Inc | R90~
__export__.product_template_2740 | SH-BX0031 | SHIPPERS' SUPPLY CUSTOM PACK | R 20
__export__.product_template_5415 | SH-BX0045 | SHIPPERS' SUPPLY CUSTOM PACK | R369
__export__.product_template_1007 | SH-BX0004 | SHIPPERS' SUPPLY CUSTOM PACK | R58
 |  | Uline | S-19068
__export__.product_template_5120 | HD-MS0275 | Amazon | B0027RL0SA
__export__.product_template_5119 | HD-MS0274 | Amazon | 10691
__export__.product_template_7092 | SH-BA0005 | Preferred Packaging Products, Inc. | 40F-1224
__export__.product_template_6954 | SH-PG0137 | Preferred Packaging Products, Inc. | 40F-1224
__export__.product_template_2738 | SH-PA0000 | SHIPPERS' SUPPLY CUSTOM PACK | B-1/2-24p12
__export__.product_template_2737 |  | SHIPPERS' SUPPLY CUSTOM PACK | STRAP PAK
__export__.product_template_4706 | TL-MS0210 | Uline | S-107
__export__.product_template_5113 | OF-MS0308 | Uline | S-3780
__export__.product_template_662 | TL-PW0001 | Sears | 921414000
__export__.product_template_5016 | TL-HD0253 | Image Supply Service, Inc. | MI13MML19
__export__.product_template_1055 | TL-HD0071 | Sears | 942870000
 |  | Orchards Ace Hardware | 2299857
__export__.product_template_2142 | SH-BX0002 | Uline | S-18196
__export__.product_template_2092 | SH-BX0005 | SHIPPERS' SUPPLY CUSTOM PACK | R76
__export__.product_template_1952 | SH-BX0006 | Uline | S-4886
__export__.product_template_5090 | SH-BX0042 | SHIPPERS' SUPPLY CUSTOM PACK | R386
__export__.product_template_3039 | DC-LB0012 | McMaster-Carr | 14035T23
__export__.product_template_3488 | EL-MS0121 | TTI Global Distribution‎ | 1-66358-6
 |  | Heilind | 1-66358-6
 |  | Digi-Key Corp | A31997TR-ND
__export__.product_template_1670 | HD-NT0032 | Fastenal | 36301
__export__.product_template_1679 | HD-BT0065 | Fastenal | 11009
__export__.product_template_1677 | HD-BT0066 | Fastenal | 11007
__export__.product_template_1666 | HD-BT0067 | Fastenal | 11010
__export__.product_template_1668 | HD-BT0068 | Fastenal | 11011
__export__.product_template_7717 | FR-ST0198 | Pallet Rack Now | RB-S32I-600-144
__export__.product_template_1682 | TL-MS0003 | Fastenal | 708910
__export__.product_template_824 | TL-MS0004 | Custom Laser Design
__export__.product_template_3124 | EL-CA0026 | Monoprice | 2145
__export__.product_template_1667 | HD-WA0018 | Fastenal | 33077
__export__.product_template_1773 | OF-CP0046 | Office Depot | 95.86
__export__.product_template_4866 | TL-HD0221 | McMaster-Carr | 7767A11
__export__.product_template_5000 | TL-HD0251 | McMaster-Carr | 7236A97
__export__.product_template_4570 | HD-MS0248 | McMaster-Carr | 7195A13
__export__.product_template_4571 | TL-HD0201 | McMaster-Carr | 5514A48
__export__.product_template_3946 | HD-MS0192 | McMaster-Carr | 5543A44
__export__.product_template_8290 | TL-HD0465 | McMaster-Carr | 5521A18
__export__.product_template_8230 | OF-CS0429 | Amazon | B00HRFGHJ4
__export__.product_template_2919 | HD-MS0138 | Home Depot
__export__.product_template_967 | SH-BX0007 | SHIPPERS' SUPPLY CUSTOM PACK | R391
__export__.product_template_5798 | SH-BX0046 | Shippers Supply | R 50
__export__.product_template_2670 | SH-BX0021 | Uline | S-4142
__export__.product_template_2291 | SH-BX0020 | SHIPPERS' SUPPLY CUSTOM PACK | R 31
__export__.product_template_7064 | SH-BX0061 | Uline | S-4410
__export__.product_template_7065 | SH-BX0062 | Uline | S-4943
__export__.product_template_2741 | SH-BX0033 | SHIPPERS' SUPPLY CUSTOM PACK | R 1042
 |  | Uline | S-11261
__export__.product_template_4904 | SH-BX0041 | SHIPPERS' SUPPLY CUSTOM PACK | R138
__export__.product_template_7423 | SH-BX0070 | Uline | S-16737
__export__.product_template_1077 | EL-MS0080 | 220converters.com | TC-1500
__export__.product_template_1450 | FR-ST0029 | Home Depot | 17398231008
 |  | Orchards Ace Hardware | 34270
__export__.product_template_696 | TL-MS0005 | Uline | H-480
__export__.product_template_5259 | OF-MS0328 | Amazon | NC1305224R1
__export__.product_template_5443 | OF-MS0335 | McMaster-Carr | 7503K9
__export__.product_template_5438 | OF-MS0334 | McMaster-Carr | 7361K54
__export__.product_template_4869 | OF-MS0281 | McMaster-Carr | 7361K46
__export__.product_template_5134 | EL-CA0068 | Amazon | B00GCG94WG
__export__.product_template_3126 | EL-CA0034 | Monoprice | 5281
__export__.product_template_4289 | EL-CA0050 | Monoprice | 3344
__export__.product_template_4206 | EL-CA0048 | Monoprice | 3872
__export__.product_template_7445 | EL-MS0427 | Monoprice | 6362
__export__.product_template_695 | EL-CA0003 | Monoprice | 5441
__export__.product_template_692 | EL-CA0004 | Monoprice | 5445
__export__.product_template_709 | EL-CA0005 | Monoprice | 5436
__export__.product_template_707 | EL-CA0006 | Monoprice | 5440
__export__.product_template_5160 | EL-CA0069 | Monoprice | 5460
__export__.product_template_4161 | EL-CA0045 | Monoprice | 5137
__export__.product_template_5161 | EL-CA0070 | Monoprice | 5450
__export__.product_template_2918 | TL-MS0073 | Home Depot
__export__.product_template_3806 | SH-PG0058 | Uline | S-17748
__export__.product_template_5063 | FR-ST0139 | Uline | S-12419BLU
__export__.product_template_73 | EL-WR0010 | Home Depot | 252-1001G3
__export__.product_template_6563 | EL-MS0361 | Mouser Electronics | FSD78-6-D
 |  | Fastenal | 713013
 |  | Allied Electronics | FSD78-6-D
 |  | TTI Global Distribution‎ | FSD78-6-D
 |  | Digi-Key Corp | 298-10766-ND
__export__.product_template_5355 | EL-WR0124 | Allcable | HU15691626GN
__export__.product_template_3640 | EL-WR0106 | Allcable | HU15691626RD
 |  | Digi-Key Corp | C2065R-1000-ND
__export__.product_template_3688 | EL-WR0108 | Newark | 78R8060
 |  | Digi-Key Corp | C2065V-1000-ND
 |  | Allcable | HU15691626VT
__export__.product_template_4548 | EL-WR0121 | Allcable | HU15691626BK
 |  | Digi-Key Corp | C2065B-100-ND
__export__.product_template_4549 | EL-WR0122 | Digi-Key Corp | C2065G-100-ND
 |  | Allcable | HU15691626GN
__export__.product_template_4550 | EL-WR0123 | Digi-Key Corp | C2065W-100-ND
 |  | Allcable | HU15691626WE
__export__.product_template_3703 | EL-WR0110 | Digi-Key Corp | C2065Y-100-ND
 |  | Allcable | HU15691626YW
__export__.product_template_4105 | PC-MS0027 | Office Max | 751492498096
__export__.product_template_4104 | PC-MS0026 | Office Max | 650590158584
__export__.product_template_4581 | SH-PA0037 | SHIPPERS' SUPPLY CUSTOM PACK | TP 35
__export__.product_template_10274 | SH-BA0008 | Uline | S-14410
__export__.product_template_1562 | MK-DM0000 | Bigwow Displays | 3066
__export__.product_template_4582 | SH-PA0038 | SHIPPERS' SUPPLY CUSTOM PACK | TP 9
__export__.product_template_6910 | SH-BX0059 | Shippers Supply | R 209
 |  | Uline | S-4165
__export__.product_template_10356 | SH-BX0079 | Uline | S-4535
__export__.product_template_4209 | TL-CS0113 | Amazon
__export__.product_template_2215 | RM-HI0003 | Village Plastics (3D SYSTEMS, INC.) | 44-1.75MM-1KG
__export__.product_template_2216 | RM-PL0024 | Village Plastics (3D SYSTEMS, INC.) | 33-175MM-N-.5KG
__export__.product_template_9920 | TL-CS0214 | Home Depot | 52427600127
__export__.product_template_2866 | OF-MS0132 | Uline | S-19290
__export__.product_template_4 | HD-WA0002 | McMaster-Carr | 94744A163
__export__.product_template_7134 | SH-BX0068 | Preferred Packaging Products, Inc.
__export__.product_template_4678 | TL-MS0209 | McMaster-Carr | 1882T11
__export__.product_template_1864 | HD-RD0023 | McMaster-Carr | 95061A191
__export__.product_template_917 | HD-BT0069 | McMaster-Carr | 91772A253
__export__.product_template_6266 | HD-BT0166 | McMaster-Carr | 92095A168
__export__.product_template_7339 | HD-BT0085 | McMaster-Carr | 92095A177
 |  | Fastenal | 11511411
__export__.product_template_4615 | HD-NT0048 | McMaster-Carr | 94758A655
__export__.product_template_2459 | HD-BT0053 | McMaster-Carr | 96640A054
 |  | Timberline Fasteners
 |  | Fastenal | 145202
__export__.product_template_8235 | HD-BT0178 | McMaster-Carr | 91287A020
__export__.product_template_8236 | HD-BT0179 | McMaster-Carr | 91287A125
__export__.product_template_2019 | HD-WA0019 | McMaster-Carr | 90313A107
__export__.product_template_10103 | HD-BT0180 | McMaster-Carr | 90265A121
__export__.product_template_8237 | HD-NT0055 | McMaster-Carr | 94545A210
__export__.product_template_10178 | FR-ST0212 | Omega Products Corp. | SU2-187236-C
__export__.product_template_953 | HD-MS0048 | Uline | S-12356FO
 |  | Vergent Products | ALE-0000185
__export__.product_template_943 | SH-MS0004 | Interstate Group - kaptontape.com | K20Z-Green
__export__.product_template_946 | SH-MS0005 | Interstate Group - kaptontape.com | K20ZV-Green
__export__.product_template_941 | SH-MS0006 | Interstate Group - kaptontape.com | K20Z-Red
__export__.product_template_944 | SH-MS0007 | Interstate Group - kaptontape.com | K20ZV-Red
__export__.product_template_942 | SH-MS0008 | Interstate Group - kaptontape.com | K20Z-Yellow
__export__.product_template_945 | SH-MS0009 | Interstate Group - kaptontape.com | K20ZV-Yellow
__export__.product_template_4099 | TL-HD0183 | Walmart | 88691000003
__export__.product_template_671 | TL-PW0002 | McMaster-Carr | 42955A66
__export__.product_template_6778 | HD-MS0357 | SHIPPERS' SUPPLY CUSTOM PACK
__export__.product_template_4324 | SH-BX0038 | Uline | S-4191
__export__.product_template_6751 | FR-ST0176 | Uline | S-1242C
__export__.product_template_4022 | FR-ST0124 | Uline | S-12422G
__export__.product_template_5062 | FR-ST0138 | Uline | S-12422BLU
__export__.product_template_4556 | FR-ST0130 | Uline | S-12422G
__export__.product_template_4557 | FR-ST0131 | Uline | S-12422R
__export__.product_template_4445 | SH-PA0033 | Uline | S-6132
__export__.product_template_10174 | SH-BX0077 | Uline | S-4468
__export__.product_template_1540 | SH-BX0028 | Shippers Supply, Inc | R96
__export__.product_template_970 | SH-PG0010 | Uline | S-11817B
 |  | Uline | S-11817
__export__.product_template_7425 | SH-PG0148 | Uline | S-1379
__export__.product_template_5676 | TL-HD0320 | Amazon | 683405470069
__export__.product_template_1778 | OF-MS0011 | Uline | S-13181
__export__.product_template_3995 | DC-LB0021 | Uline | S-13119
__export__.product_template_3997 | DC-LB0023 | Uline | S-13118
__export__.product_template_4239 | PC-LE0016 | SolidApollo | SA-LS-RGB-5050-300-24V-1F
__export__.product_template_975 | PC-BD0008 | Loveland Computer Repair
__export__.product_template_5866 | OF-MS0367 | Quill | 901-711514QL
__export__.product_template_8147 | TL-MS0475 | Home Depot | 130-222
__export__.product_template_497 | EL-MS0076 | Hansen Hobbies | HH-PT1IN_FT (x1,000)
__export__.product_template_498 | EL-MS0077 | Hansen Hobbies | HH-PT1IN_MT (x1,000)
__export__.product_template_878 | HD-MS0067 | Home Depot | 465796
__export__.product_template_8052 | TL-CS0198 | Home Depot | 22065
__export__.product_template_1824 |  | Village Plastics (3D SYSTEMS, INC.)
__export__.product_template_1846 |  | 1Kg Sample Spool; empty
__export__.product_template_1779 | DC-LB0009 | Uline | S-17021
__export__.product_template_8249 | TL-HD0461 | Home Depot | 82474966044
__export__.product_template_1889 | OF-CS0135 | Office Depot | 772407
__export__.product_template_2348 |  | SHIPPERS' SUPPLY CUSTOM PACK
__export__.product_template_7297 | TL-MS0434 | Fastenal | 501128
__export__.product_template_269 | EL-MS0030 | Hansen Hobbies | HH-PT1IN_1x10
__export__.product_template_499 | EL-MS0081 | Hansen Hobbies | HH-PT1IN_1x1 (x100)
__export__.product_template_264 | EL-MS0025 | Hansen Hobbies | HH-PT1IN_1x1
__export__.product_template_1740 | SH-BX0027 | Warneke Paper Box Company
__export__.product_template_500 | EL-MS0082 | Hansen Hobbies | HH-PT1IN_1x2 (x300)
__export__.product_template_43 | EL-MS0004 | Hansen Hobbies | HH-PT1IN_1x2
 |  | Newark | 08N6813
 |  | Vergent Products | ALE-0000100
__export__.product_template_501 | EL-MS0083 | Hansen Hobbies | HH-PT1IN_1x3 (x300)
__export__.product_template_46 | EL-MS0005 | Hansen Hobbies | HH-PT1IN_1x3
 |  | Vergent Products | ALE-0000123
__export__.product_template_5008 | TL-HD0252 | Home Depot
__export__.product_template_502 | EL-MS0084 | Hansen Hobbies | HH-PT1IN_1x4 (x300)
__export__.product_template_41 | EL-MS0002 | Hansen Hobbies | HH-PT1IN_1x4
 |  | Hansen Hobbies | HH-PT1IN_1x4
 |  | Vergent Products | ALE-0000055
__export__.product_template_255 | EL-MS0020 | Hansen Hobbies | HH-PT1IN_1x5
__export__.product_template_6708 | TL-HD0392 | Amazon | 64006
__export__.product_template_265 | EL-MS0026 | Hansen Hobbies | HH-PT1IN_1x6
__export__.product_template_266 | EL-MS0027 | Hansen Hobbies | HH-PT1IN_1x7
__export__.product_template_267 | EL-MS0028 | Hansen Hobbies | HH-PT1IN_1x8
__export__.product_template_268 | EL-MS0029 | Hansen Hobbies | HH-PT1IN_1x9
__export__.product_template_10060 | OF-CS0439 | Quill | 901-032962
__export__.product_template_6382 | OF-CS0394 | Quill | 901-032961
__export__.product_template_6381 | OF-CS0393 | Quill | 901-032960
__export__.product_template_2937 | OF-CS0136 | Quill | 901-030255
__export__.product_template_2928 |  | WELCH EQUIPMENT COMPANY
__export__.product_template_7595 | OF-MS0470 | Quill | 901-QDMA90MW17
__export__.product_template_4881 | OF-MS0283 | Quill | 901-SK240015
__export__.product_template_4750 | OF-MS0270 | Quill | 901-PM122815
__export__.product_template_6379 | OF-MS0402 | Quill | 901-BS1649016
__export__.product_template_10061 | OF-MS0510 | Quill | 901-QDM110MW17
__export__.product_template_6596 | PC-CN0064 | Fastenal | 58591
 |  | Fastenal | 710538
__export__.product_template_3491 | EL-MS0124 | TTI Global Distribution‎ | 1-66331-4
 |  | Digi-Key Corp | A31995TR-ND
 |  | TTI Global Distribution‎ | 1-66331-4
__export__.product_template_69 | EL-WR0006 | Amazon | B0002ZGBME
 |  | Vergent Products | ALE-0000030
__export__.product_template_464 | EL-WR0026 | Digi-Key Corp | C2003L-100-ND
__export__.product_template_113 | EL-WR0012 | Mouser Electronics | 602-2856/1-100-03
__export__.product_template_1036 | EL-WR0027 | Mouser Electronics | 602-2856-1-100-03
 |  | Allied Electronics | 70134931
__export__.product_template_2256 | EL-WR0017 | Vergent Products | ALE-0000024
__export__.product_template_68 | EL-WR0005 | Amazon | B0002ZGBLK
 |  | Digi-Key Corp | C2028R-100-ND
 |  | Vergent Products | ALE-0000029
__export__.product_template_6936 | OF-CS0405 | Amazon | B00G93CG0Y
__export__.product_template_5462 | FU-ST0155 | Quill | 901-18198Q
__export__.product_template_3122 | EL-CA0027 | Monoprice | 4984
__export__.product_template_6014 | TL-MS0336 | Home Depot | 938963
__export__.product_template_5910 | HD-MS0333 | OpenBuilds Part Store
__export__.product_template_5890 | HD-MS0332 | OpenBuilds Part Store
__export__.product_template_8286 | EL-MS0445 | Digi-Key Corp | 1212-1490-ND
__export__.product_template_8287 | EL-MS0446 | Digi-Key Corp | ED1600-ND
__export__.product_template_5152 | HD-MS0276 | Home Depot
__export__.product_template_1539 | SH-PG0013 | Shippers Supply, Inc | R217
__export__.product_template_1820 | SH-PG0014 | Shippers Supply, Inc | R217
__export__.product_template_2736 | RM-WO0001 | SHIPPERS' SUPPLY CUSTOM PACK | V-BOARD
__export__.product_template_7153 | EL-MS0388 | Fastenal | 3299171
__export__.product_template_2836 | OF-CP0103 | XIAMEN GREATOUCH TECHNOLOGY CO., LTD
__export__.product_template_3142 | TL-MS0076 | McMaster-Carr | 2196A73
__export__.product_template_3994 | SH-BX0035 | SHIPPERS' SUPPLY CUSTOM PACK
 |  | Uline | S-11380
__export__.product_template_3141 | TL-MS0077 | McMaster-Carr | 2216A54
__export__.product_template_7019 | TL-HD0402 | Flexible Assembly | BLD2
__export__.product_template_3143 | TL-MS0078 | McMaster-Carr | 22455A66
__export__.product_template_3140 | TL-MS0079 | McMaster-Carr | 2245A45
__export__.product_template_1552 | SH-BX0029 | Shippers Supply, Inc
__export__.product_template_2267 | SH-BX0018 | Vergent Products | ALE-0000180
__export__.product_template_1112 | SH-BX0019 | Shippers Supply, Inc | Z226111
__export__.product_template_900 | SH-BX0009 | Shippers Supply, Inc | TW848
__export__.product_template_969 | SH-BX0010 | Shippers Supply, Inc | R586~~
__export__.product_template_971 | SH-PA0003 | Uline | S-11818B
 |  | Vergent Products | ALE-0000181
__export__.product_template_7728 | SH-BX0073 | Preferred Packaging Products, Inc.
__export__.product_template_6595 | PC-CN0063 | Fastenal | 710538
 |  | Fastenal | 710538
__export__.product_template_6562 | EL-MS0362 | Fastenal | 713000
 |  | Walker Components | FSD73-8-D
 |  | Digi-Key Corp | FSD74-8-D
 |  | TTI Global Distribution‎ | FSD73-6-D
__export__.product_template_6453 | EL-MS0357 | Fastenal | 749599
__export__.product_template_115 | EL-WR0014 | Mouser Electronics | 602-2854/1-100-08
__export__.product_template_3639 | EL-WR0105 | Digi-Key Corp | C2015B-1000-ND
 |  | Allcable | HU1569247BK
__export__.product_template_3763 | EL-WR0111 | Allcable | HU1569247BE
 |  | Digi-Key Corp | C2015L-1000-ND
__export__.product_template_3638 | EL-WR0104 | Digi-Key Corp | C2015A-1000-ND
 |  | Allcable | HU1569247OE
__export__.product_template_3637 | EL-WR0103 | Digi-Key Corp | C2015R-1000-ND
 |  | Allcable | HU1569247RD
__export__.product_template_3641 | EL-WR0107 | Allcable | HU1569247WE
 |  | Digi-Key Corp | C2015W-1000-ND
__export__.product_template_4541 | EL-WR0118 | Digi-Key Corp | C2015L-100-ND
 |  | Allcable | HU1569247BE
__export__.product_template_4546 | EL-WR0119 | Digi-Key Corp | C2015G-100-ND
 |  | Allcable | HU1569247GN
__export__.product_template_4547 | EL-WR0120 | Digi-Key Corp | C2015V-100-ND
 |  | Allcable | HU1569247VT
__export__.product_template_3689 | EL-WR0109 | Allcable | HU1569247YW
 |  | Digi-Key Corp | C2015Y-1000-ND
__export__.product_template_7119 | PC-LE0019 | Home Depot | 836607009036
__export__.product_template_6868 | EL-MS0377 | Reprapdiscount / PLUG IT LTD | HC24V
__export__.product_template_7198 | EL-MS0184 | E3D Online Ltd. | E-HEATER-24V-40W
__export__.product_template_3041 | EL-HR0020 | RPC Manufacturing Solutions, LLC
__export__.product_template_5114 | OF-MS0309 | Uline | S-4243
__export__.product_template_2643 | SH-BX0026 | SHIPPERS' SUPPLY CUSTOM PACK | R 45
__export__.product_template_5137 | SH-BX0044 | SHIPPERS' SUPPLY CUSTOM PACK | R260
__export__.product_template_5136 | SH-BX0043 | SHIPPERS' SUPPLY CUSTOM PACK | R110
 |  | Uline | S-4340
__export__.product_template_968 | SH-BX0011 | Shippers Supply, Inc | R675
__export__.product_template_3160 | FR-TB0021 | Amazon
__export__.product_template_6924 | SH-BX0060 | Uline | S-18924
__export__.product_template_4709 | TL-MS0212 | McMaster-Carr | 2563A11
__export__.product_template_5390 | OF-CP0172 | Amazon | B00AF2OVEY
__export__.product_template_3121 | EL-CA0028 | Monoprice | 2151
__export__.product_template_4290 | EL-CA0051 | Monoprice | 3345
 |  | Amazon | ABAV001
__export__.product_template_7446 | EL-MS0428 | Monoprice | 6363
__export__.product_template_4911 | TL-HD0226 | MSC Industrial Supply | 44486009
 |  | Hayden Industrial Hardware and Supply, Inc.
__export__.product_template_5699 | TL-HD0327 | Amazon | MS107
__export__.product_template_6824 | SH-PG0124 | Preferred Packaging Products, Inc. | 804
__export__.product_template_6960 | SH-PG0131 | Preferred Packaging Products, Inc. | 815
__export__.product_template_5710 | TL-HD0329 | Lexjet | D444 - UPC076769444003
__export__.product_template_4970 | TL-HD0236 | Amazon | 27014
__export__.product_template_3205 | TL-PW0039 | McMaster-Carr | 27995A516
__export__.product_template_3204 | TL-PW0038 | McMaster-Carr | 27995A524
__export__.product_template_5151 | OF-MS0314 | Home Depot
__export__.product_template_3203 | TL-PW0037 | McMaster-Carr | 2821A143
__export__.product_template_7046 | TL-MS0412 | Northern Safety | 2835
__export__.product_template_7045 | TL-MS0411 | Northern Safety | 2822
__export__.product_template_7470 | EL-MS0430 | Adafruit Industries | 1947
__export__.product_template_7469 | EL-MS0429 | Adafruit Industries | 1651
__export__.product_template_3808 | TL-CS0097 | Walmart | 3019201815
 |  | Uline | H-2017
__export__.product_template_10173 | SH-BX0076 | Uline | S-4915
__export__.product_template_1838 | OF-MS0066 | Office Depot | 919320
__export__.product_template_3996 | DC-LB0022 | Uline | S-5914
__export__.product_template_10100 | HD-MS0388 | RobotDigg | IPulley-20T 4mm_No Tooth
__export__.product_template_10101 | HD-MS0389 | RobotDigg | IPulley-20T 4mm_Toothed
__export__.product_template_7786 | HD-MS0380 | RobotDigg | IPulley-20T 5mm_Toothed
__export__.product_template_6480 | TL-HD0378 | Amazon | 2250
__export__.product_template_8148 | TL-MS0476 | Home Depot | 130-249
__export__.product_template_6711 | OF-MS0418 | Quill | 901-732834STP
__export__.product_template_4879 | TL-HD0223 | Reprapdiscount / PLUG IT LTD
 |  | MSC Industrial Supply | 5747035
__export__.product_template_7482 | TL-MS0439 | Schleuniger, Inc. | CSB-5-2mm
__export__.product_template_4813 | TL-HD0215 | Home Depot | 28-142
__export__.product_template_4729 | EL-MS0183 | Digi-Key Corp | WM7837-ND
__export__.product_template_4005 | SH-PA0027 | SHIPPERS' SUPPLY CUSTOM PACK | F-1/2-48
__export__.product_template_2727 | SH-PG0011 | Uline | S-423
__export__.product_template_847 | SH-BX0034 | Uline | S-7010
__export__.product_template_1912 | DC-LB0005 | Uline | S-2845
__export__.product_template_270 | EL-MS0031 | Hansen Hobbies | HH-PT1IN_2x2
__export__.product_template_1266 | SH-PG0012 (DO NOT USE) See SH-PG0001 | Uline | S-1291
__export__.product_template_2482 | SH-PG0001 | Uline | S-1291
__export__.product_template_1703 | SH-PG0015 | Uline | S-5251
__export__.product_template_2859 | OF-CS0126 | Uline | S-7194
__export__.product_template_2863 | OF-CS0127 | Uline | S-18004
__export__.product_template_2858 | OF-CS0128 | Uline | S-16877
__export__.product_template_2860 | OF-CS0129 | Uline | S-9665
__export__.product_template_2861 | OF-CS0130 | Uline | S-13511
__export__.product_template_2862 | OF-CS0131 | Uline | S-385
__export__.product_template_2856 | OF-CS0132 | Uline | S-16873
__export__.product_template_2857 | OF-CS0133 | Uline | S-13512
__export__.product_template_2855 | OF-CS0134 | Uline | S-2183
__export__.product_template_835 | SH-PG0031 | Mouser Electronics | 517-30023
 |  | Uline | S-6509
__export__.product_template_271 | EL-MS0032 | Hansen Hobbies | HH-PT1IN_2x3
__export__.product_template_2582 | RM-WO0000 | Home Depot
__export__.product_template_272 | EL-MS0033 | Fastenal | 11511046
__export__.product_template_1741 | PC-BD0009 | Future Bits Open Tech UG
__export__.product_template_4705 | EL-MS0213 | Uline | S-14117
__export__.product_template_1089 | SH-PG0016 | Uline | S-7829
__export__.product_template_4558 | FR-FU0132 | Uline | H-786
__export__.product_template_273 | EL-MS0034 | Hansen Hobbies | HH-PT1IN_2x5
__export__.product_template_2728 | FR-FU0010 | Uline | H-3090
__export__.product_template_2428 | TL-MS0015 | PORT PLASTICS-DENVER | 30039
__export__.product_template_5805 | TL-MS0313 | PORT PLASTICS-DENVER | 30044
__export__.product_template_3412 | TL-MS0086 | PORT PLASTICS-DENVER | 30044
__export__.product_template_5806 | TL-MS0314 | PORT PLASTICS-DENVER | 30044
__export__.product_template_5225 | PP-MP0088 | Precision Metal Manufacturing | PP-MP0088
__export__.product_template_6017 | PP-MP0108 | Precision Metal Manufacturing
__export__.product_template_1990 | HD-WA0020 | McMaster-Carr | 98019A309
__export__.product_template_1963 | PP-MP0045 | Epocs Manufacturing
 |  | Rapid Sheet Metal | PP-MP0045
__export__.product_template_7011 | TL-HD0399 | Starrett.com | 3020-12
__export__.product_template_1041 | TL-PW0023 | McMaster-Carr | 3022A44
__export__.product_template_652 | TL-PW0005 | McMaster-Carr | 30555A64
__export__.product_template_7018 | TL-HD0401 | Flexible Assembly | FAS-TS30
__export__.product_template_7022 | TL-HD0403 | MSC Industrial Supply | 66934332
__export__.product_template_2099 | SH-PG0018 | MM Solutions, Inc
__export__.product_template_2705 | SH-BX0032 | SHIPPERS' SUPPLY CUSTOM PACK | CUSTOM
__export__.product_template_4776 | EL-FA0023 | E3D-online
__export__.product_template_3250 | TL-MS0083 | Ckitchen
__export__.product_template_5026 | SH-MS0043 | Uline | S2411GPW
__export__.product_template_5024 | SH-MS0041 | Uline | S2411RPW
__export__.product_template_5025 | SH-MS0042 | Uline | S2411YPW
__export__.product_template_5978 | TL-HD0353 | Home Depot | # 24250
__export__.product_template_10019 | HD-WA0043 | McMaster-Carr | 93237A104
__export__.product_template_2671 | SH-PA0014 | SHIPPERS' SUPPLY CUSTOM PACK | BUBBLE MASK 3
__export__.product_template_2739 |  | SHIPPERS' SUPPLY CUSTOM PACK | B-3/16-24P12
__export__.product_template_7390 | OF-MS0456 | Home Depot | 50563
__export__.product_template_854 | HD-MS0035 | Binswanger Glass | WGCLRCUT-3/32"
__export__.product_template_1600 | TL-MS0024 | Jax Outdoor Gear | J10342
__export__.product_template_765 | TL-EL0004 | Amscope | SM-4TZ-144-10MT
__export__.product_template_10125 | FR-ST0208 | Workplace Partners
__export__.product_template_5289 | FR-FU0142 | Global Industrial | 796491
__export__.product_template_1550 | HD-RD0015 | Vergent Products | ALE-0000081
__export__.product_template_2917 | HD-NT0040 | Home Depot | 887480023916
__export__.product_template_5093 | TL-HD0262 | McMaster-Carr | 5835A15
__export__.product_template_5094 | TL-HD0263 | McMaster-Carr | 5849A17
__export__.product_template_5115 | TL-HD0264 | McMaster-Carr | 5849A21
__export__.product_template_4999 | TL-HD0250 | McMaster-Carr | 5311A39
__export__.product_template_1746 | HD-MS0075 | VXB, NationSkander California Corp. | R6ZZ
__export__.product_template_1840 | OF-MS0015 | Office Depot | 465556
 |  | Quill | 901-7223WE
__export__.product_template_1470 | PP-FP0017 | Amazon | 3DX-700028
__export__.product_template_6759 | PC-BD0054 | 3Dfilamenta | BBP 1S
__export__.product_template_8322 | TL-HD0466 | Amazon | TBL-SPA-20
__export__.product_template_1319 | PC-BD0010 | 3D Robotics | BR-3DRLEA-6
__export__.product_template_1320 | KT-EL0003 | 3D Robotics | KT-Telemetry-DR433
__export__.product_template_1321 | KT-EL0002 | 3D Robotics | KT-Telemetry-3DR915
__export__.product_template_3125 | EL-CA0024 | Monoprice | 2132
__export__.product_template_4931 | EL-CA0065 | Monoprice | 11559
 |  | Amazon
__export__.product_template_694 | EL-CA0007 | Monoprice | 5442
__export__.product_template_708 | EL-CA0008 | Monoprice | 5437
__export__.product_template_10077 | EL-CA0103 | Monoprice | 5447
__export__.product_template_2178 | FR-FU0011 | Office Depot | 783882
__export__.product_template_8277 | TL-HD0462 | Home Depot | 37064090609
__export__.product_template_8279 | TL-MS0484 | Home Depot | 648846001272
__export__.product_template_5846 | FR-ST0160 | Uline | H-2188
__export__.product_template_9921 | TL-CS0215 | Home Depot | 76308731625
__export__.product_template_4953 | OF-MS0288 | Amazon
__export__.product_template_10237 | SH-PG0155 | Uline | S-12747
__export__.product_template_8141 | TL-MS0473 | Home Depot | 565-222
__export__.product_template_4948 | HD-MS0263 | Professional Plastics | 3M 468MP Adhesive Transfer Tape - 12.50" x 60 yards
__export__.product_template_4699 | HD-MS0254 | Professional Plastics | 3M 468MP Adhesive Transfer Tape - 12" x 60 yards
 |  | Uline | S-13994
__export__.product_template_5597 | HD-MS0307 | Professional Plastics | TAPE3M468MP.005x13.750x60YD
__export__.product_template_5171 | HD-MS0278 | Professional Plastics | TAPE3M468MP.005x14.400x60yd
__export__.product_template_5568 | HD-MS0300 | Uline | S-13995
__export__.product_template_5596 | HD-MS0306 | Professional Plastics | TAPE3M468MP.005x8.6250x60YD
__export__.product_template_4090 | SH-PG0068 | Uline | S-13973
__export__.product_template_7405 | TL-CS0186 | Amazon | 8810
__export__.product_template_4425 | SH-PG0069 | Uline | S-16075
__export__.product_template_4392 | SH-PG0072 | Uline | S-16076
__export__.product_template_5816 | HD-MS0325 | Amazon
__export__.product_template_5606 | TL-CS0142 | Pack-N-Tape | AP115 - 00051115234781
__export__.product_template_10262 | TL-MS0508 | Uline | H-2312
__export__.product_template_2960 | OF-MS0158 | Office Depot | 785460
__export__.product_template_2379 | OF-MS0018 | Office Depot | 447154
__export__.product_template_5128 | TL-MS0225 | Hayden Industrial Hardware and Supply, Inc. | 8984
__export__.product_template_7041 | TL-MS0409 | Uline | S-12572
__export__.product_template_7040 | TL-MS0408 | Uline | S-12570
__export__.product_template_5493 | OF-MS0336 | Amazon | MMMC22
__export__.product_template_680 | RM-AB0022 | Coombes Solutions Reprapcentral | RRCFL00079
__export__.product_template_681 | RM-AB0023 | Coombes Solutions Reprapcentral | RRCFL00082
__export__.product_template_679 | RM-AB0021 | Coombes Solutions Reprapcentral | RRCFL00080
__export__.product_template_674 | RM-AB0018 | AMS - 3D Printer Stuff | 22
__export__.product_template_675 | RM-AB0019 | AMS - 3D Printer Stuff | 31
__export__.product_template_7584 | EL-MS0189 | Mouser Electronics | 517-SD-RSMT-2-MQ
__export__.product_template_7483 | TL-MS0440 | Schleuniger, Inc. | CSB-5-3mm
__export__.product_template_1429 | RM-PL0029 | Printbl | PLA3MM1KBBRY
__export__.product_template_1426 | RM-PL0032 | Printbl | PLA3MM1KDIA
__export__.product_template_1428 | RM-PL0036 | Printbl | PLA3MM1KGRP
__export__.product_template_1427 | RM-PL0038 | Printbl | PLA3MM1KLYLK
__export__.product_template_1433 | RM-PL0039 | Printbl | PLA3MM1KORNG
__export__.product_template_1430 | RM-PL0000 | Printbl | PLA3MM1KSYBL
__export__.product_template_2426 | RM-NY0001 | Jdeal-Form srl / 3ntr | filpa-3-00-05
__export__.product_template_1649 | SH-PA0015 | SHIPPERS' SUPPLY CUSTOM PACK | 3M 371
 |  | Uline | S-749
__export__.product_template_1398 | OF-MS0016 | Office Depot
__export__.product_template_1837 | OF-MS0017 | Office Depot | 525282
__export__.product_template_4423 | HD-MS0206 | Pack-N-Tape | 51115647239
__export__.product_template_7657 | OF-CP0228 | Amazon | B00L2AN9IW
__export__.product_template_8139 | TL-MS0472 | Home Depot | 1000-541-538
__export__.product_template_8150 | TL-CS0210 | Home Depot | 1000-538-895
__export__.product_template_7094 | TL-CS0177 | Amazon | 11694NA
__export__.product_template_6050 | TL-MS0337 | Home Depot | 90128-00001
 |  | Walmart | 5114198569
__export__.product_template_8144 | TL-CS0208 | Home Depot | 253-884
__export__.product_template_4250 | TL-MS0202 | Home Depot
__export__.product_template_10014 | OF-WU0052 | Quill | 901-581WBE
__export__.product_template_5021 | OF-MS0298 | Amazon
__export__.product_template_1356 | TL-HD0054 | Home Depot | 716341015305
__export__.product_template_4098 | TL-HD0182 | Walmart | 88691005225
__export__.product_template_7088 | TL-MS0417 | McMaster-Carr | 7110A21
__export__.product_template_4102 | SH-PA0028 | SHIPPERS' SUPPLY CUSTOM PACK | F-1/2-48
__export__.product_template_7539 | FR-ST0187 | Uline | H-4607BL
__export__.product_template_2963 | FR-FU0035 | Amazon
__export__.product_template_2847 | OF-MS0133 | Uline | S-12552
__export__.product_template_1702 | SH-BX0012 | Uline | S-435
__export__.product_template_2013 | SH-BX0013 | Uline | S-10616
__export__.product_template_2015 | SH-PG0020 (DO NOT USE) See SH-PG0002 | Uline | S-1292
__export__.product_template_2483 | SH-PG0002 | Uline | S-1292
__export__.product_template_1545 | SH-PG0017 (DO NOT USE) See SH-PG0002 | Uline | S-1292
__export__.product_template_2486 | SH-PG0005 | Uline | S-1293
__export__.product_template_4767 | SH-PG0085 | Uline | S-14567
__export__.product_template_2853 | FR-FU0023 | Uline | H-1984BU
__export__.product_template_2854 | FR-FU0024 | Uline | H-1984GR
__export__.product_template_954 | DC-LB0010 | Uline | S-3005
__export__.product_template_1402 | TL-MS0025 | Hobby Town USA | SBMB4000LPTX
__export__.product_template_123 | EL-PS0002 | Yueqing Mingyu Electronic Technology Co., Ltd. | S-400
__export__.product_template_4912 | TL-HD0227 | MSC Industrial Supply | 42131888
 |  | Hayden Industrial Hardware and Supply, Inc.
__export__.product_template_653 | EL-FA0001 | Ultimachine | UM40FAN
 |  | Kysan | 1531067
__export__.product_template_6601 | SH-MS0055 | Mobile Mini, Inc | 401 63070
__export__.product_template_5709 | SH-MS0047 | Mobile Mini, Inc | 40ZS 194454
__export__.product_template_6725 | TL-MS0399 | Amazon | MG21011A
__export__.product_template_5956 | SH-BX0048 | Uline | S-3193
__export__.product_template_7574 | TL-HD0429 | McMaster-Carr | 5157A38
__export__.product_template_1179 | TL-HD0055 | McMaster-Carr | 5157A39
__export__.product_template_1680 | HD-BT0062 | Fastenal | 139005
__export__.product_template_6939 | OF-MS0434 | Home Depot | 521234W
__export__.product_template_6248 | SH-PG0110 | Uline | S-15136
__export__.product_template_4677 | TL-MS0208 | McMaster-Carr | 4372T28
__export__.product_template_5091 | TL-HD0260 | Tool Barn | Craftsman-009-24887
 |  | MSC Industrial Supply | 72902935
__export__.product_template_5896 | OF-CS0299 | Amazon | B00947QMK2
__export__.product_template_3938 | TL-PW0055 | Drytac | JM18
__export__.product_template_4620 | OF-MS0260 | Home Depot | 49206634008
__export__.product_template_6206 | FR-TB0030 | Uline | H-2127BL
__export__.product_template_4601 | OF-MS0259 | McMaster-Carr | 4793T81
__export__.product_template_3932 | RM-WO0003 | Home Depot | 854884001024
__export__.product_template_6938 | OF-MS0433 | Home Depot | 551738Y
__export__.product_template_1577 | KT-CP0016 | Home Depot | 808339671249
__export__.product_template_5278 | FR-FU0140 | Global Industrial | 796490
__export__.product_template_6597 | FR-BN0021 | Global Industrial | T9F601148
__export__.product_template_3249 | FR-BN0009 | Northern Tool | 143194
__export__.product_template_3248 | FR-BN0010 | Northern Tool | 143197
__export__.product_template_393 | EL-MS0069 | Uline | S-13010
 |  | Vergent Products | ALE-0000186
__export__.product_template_2692 | SH-PA0008 | MM Solutions, Inc | RP19 (10)L23
__export__.product_template_6653 | EL-MS0364 | Digi-Key Corp | CBBB204-ND
__export__.product_template_5293 | FR-ST0152 | JUST OFFICE FURNITURE | HON
__export__.product_template_7540 | MK-DM0013 | Discountexhibit.net
__export__.product_template_952 | HD-MS0076 | Uline | S-2151FO
__export__.product_template_6081 | OF-MS0376 | Home Depot | TGT8CL4 R24
__export__.product_template_6082 | OF-MS0377 | Home Depot | 456608
__export__.product_template_5148 | OF-CS0267 | Home Depot
__export__.product_template_5174 | OF-CS0270 | Home Depot
__export__.product_template_5122 | EL-MS0241 | Amazon | DSP4GB-007
__export__.product_template_6121 | TL-HD0363 | Home Depot | 441619
__export__.product_template_9972 | TL-HD0471 | McMaster-Carr | 7397A44
__export__.product_template_7577 | TL-HD0431 | McMaster-Carr | 3590A32
__export__.product_template_7129 | TL-HD0407 | Fastenal | 3162728
 |  | Zoro Tools | G0662277
__export__.product_template_4006 | OF-CP0139 | Monoprice | 6442
__export__.product_template_7112 | HD-MS0359 | Widgetco.com | #3-093-180-TP
__export__.product_template_2848 | OF-MS0134 | Uline | S-15578
__export__.product_template_2849 | OF-MS0135 | Uline | S-15579
__export__.product_template_524 | SH-PA0016 | Uline | S-12665
__export__.product_template_2250 | SH-PG0022 | Uline | S-417
__export__.product_template_1088 | SH-BX0014 | Uline | S-11607
 |  | Vergent Products | ALE-0000195
__export__.product_template_1254 | SH-BX0015 | Uline | S-11608
__export__.product_template_2484 | SH-PG0003 | Uline | S-1294
__export__.product_template_9963 | SH-BA0007 | Uline | S-1662
__export__.product_template_6249 | SH-PG0109 | Uline | S-12846
__export__.product_template_8266 | TL-MS0482 | Troemner | 318ST
__export__.product_template_6492 | TL-EL0098 | B & B Manufacturing, Inc | 74200508
__export__.product_template_3198 | OF-MS0175 | Walmart | 78175657101
__export__.product_template_4101 | EL-CA0042 | Walmart
__export__.product_template_2984 | EL-CA0023 | Monoprice | 9432
__export__.product_template_906 | PC-MS0005 | newdeparture2010 - Chun Shu
__export__.product_template_2339 | OF-WU0002 | Office Depot | 510232
__export__.product_template_5065 | FR-ST0141 | Uline | S-12413BLU
__export__.product_template_2038 | HD-TB0030 | Home Depot | 48643105423
__export__.product_template_4742 | OF-MS0268 | Home Depot | 71691467106
__export__.product_template_4649 | TL-HD0209 | McMaster-Carr | 5521A17
__export__.product_template_410 | TL-HD0016 | Lowe's | 338890
__export__.product_template_1053 | PC-AS0021 | Hobby King - HEXTRONIK LIMITED | 263000001
__export__.product_template_444 | HD-MS0077 | Uline | S-3810BLU
__export__.product_template_4234 | TL-CS0115 | Fastenal | 607086
__export__.product_template_1507 | TL-HD0056 | Home Depot | 79423029776
__export__.product_template_1825 |  | Village Plastics (3D SYSTEMS, INC.)
__export__.product_template_1870 | PP-MP0030 | B & B Manufacturing, Inc | 16-2P06M6CA5
__export__.product_template_7484 | TL-MS0441 | Schleuniger, Inc. | CSB-5-5mm
__export__.product_template_1542 | MK-MS0000 | B&H Photo Video Pro Audio | Impact IMFL5
__export__.product_template_1011 | OF-BK0021 | Amazon | 978-1563270475
__export__.product_template_1121 | SH-PG0024 | Shippers Supply, Inc | APB-5120
__export__.product_template_1648 | SH-BX0016 | Uline | S-461
__export__.product_template_10298 | SH-BX0078 | Preferred Packaging Products, Inc. | M437
__export__.product_template_2869 | SH-PG0055 | SHIPPERS' SUPPLY CUSTOM PACK
__export__.product_template_4021 | SH-PG0067 | Uline | S-1695
__export__.product_template_1931 | SH-BA0001 | Vergent Products | ALE-0000197
 |  | Uline | S-1695
__export__.product_template_2693 | SH-PG0026 | MM Solutions, Inc | F20507H
__export__.product_template_9962 | SH-BA0006 | Uline | S-15258
__export__.product_template_6942 | SH-PG0136 | Uline | S-5306
__export__.product_template_2249 | SH-PG0025 | Uline | S-1295
__export__.product_template_5252 | HD-MS0282 | JSB Great Bearings | 608-2RS ABEC3/C3
__export__.product_template_118 | HD-MS0013 | VXB, NationSkander California Corp. | 100SKATE
 |  | Vergent Products | ALE-0000056
__export__.product_template_2730 | FR-ST0037 | Uline | H-3158
__export__.product_template_3256 | FR-ST0133 | BuyMetalShelving.com | BS602484DS4HC
__export__.product_template_3247 | FR-BN0011 | Northern Tool | 143199
__export__.product_template_6131 | HD-BT0164 | Fastenal | 1172902
__export__.product_template_4693 | HD-BT0138 | Fastenal | 1131222
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
