gralco/TAZ6/production_parts/electronics/Wire_Harnesses/Cable_List.ods

Sheet: Cabling Requirements Dec2016
Project | Where used | PN | Odoo Description
Cuckoo | Extruder_assembly
Mini Flexy v3
TBD
Albatross | Extruder_assembly | AS-CB0003 | Zero Sense 220mm Harness
Mini Flexy v2 |  | AS-CB0015 | X-Max 160mm-Purple Harness
AS-TH0047 |  | AS-CB0023 | X-Max-160mm Black harness
 |  | AS-CB0008 | Thermistor 150mm Harness
 |  | AS-CB0016 | NEMA17 Stepper Motor-200mm Leads Harness
 |  | AS-CB0007 | Heater Cartridge 180mm Harness
 |  | AS-CB0020 | 40mm 24v Low Flow Fan-120mm Harness
 |  | AS-CB0017 | Microblower- 195mm
 |  | Pin assign | AS-TH0047_Mini_Flexystruder_v2_Pin_Assignments_RevA
Gladiola | Chassis assembly | EL-HR0128 | Mini Case Fan Harness RevA
Mini 1.04 |  | EL-HR0118 | Chassis Ground Extension Wire Harness
 |  | EL-HR0117 | Earth Ground Extension Wire Harness
 |  | EL-HR0068 | Mini Plug to Ground Post Extension
 |  | EL-HR0104 | Mini Plug to SW Extension Harness Assembly - Gladiola
 |  | EL-HR0069 | Mini PS to Ground Post Extension
 |  | EL-HR0106 | Mini PS to RAMBo Harness Assembly - Gladiola
 |  | EL-HR0107 | Mini SW to PS - Black Wire Extension Harness Assembly - Gladiola
 |  | EL-HR0127 | Mini SW to PS - White Wire Extension Harness Assembly – Gladiola
AS-TH0022 | Extruder_assembly | EL-HR0121 | Mini, Nozzle Fan Harness
 |  | EL-HR0122 | Mini, Extruder Motor Harness
 |  | EL-HR0123 | Mini, Heat Sink Fan Harness
 |  | EL-HR0124 | Mini, Zero Sense 215mm Harness
 |  | EL-HR0125 | Mini X Max Switch Harness
 |  | AS-CB0024 | 175mm_Heater_Cartridge_Harness
 |  | AS-CB0025 | 195mm_Thermistor_Harness
 |  | Pin assign | AS-TH0022_Mini_Extruder_Pin_Assignments_RevB
Olive | External Cable | EL-HR0089 | Taz 6, Bed harness extension
TAZ 6 |  | EL-HR0083 | Bed power harness external, TAZ 6
 |  | EL-HR0092 | Taz 6, Extruder 0 harness external
 |  | EL-HR0075 | X Harness External TAZ 6
 |  | EL-HR0091 | Taz 6 Y & Z harness external
 | Internal Cable | EL-HR0081 | TAZ 6 Bed Harness Internal
 |  | EL-HR0082 | TAZ6 CB Bed Power Harness
 |  | EL-FA0036 | [EL-FA0036] TAZ 6 CB Case Fan Assembly v1.0
 |  | EL-HR0074 | DC Power Harness v1.0 TAZ 6
 |  | EL-HR0101 | Taz 6, CB extruder 1 harness
 |  | EL-HR0087 | TAZ 6, CB Extruder Harness Internal
 |  | EL-HR0097 | LCD Harness TAZ 6, v0.1
 |  | EL-HR0078 | TAZ 6 plug to ground green
 |  | EL-HR0080 | TAZ 6 plug to switch black and white with ferrite
 |  | EL-HR0079 | TAZ 6 PSU to ground green
 |  | EL-HR0077 | TAZ 6 switch to PSU black
 |  | EL-HR0076 | Taz 6 switch to PSU white
 |  | EL-HR0084 | TAZ 6, X Harness Internal
 |  | EL-HR0088 | TAZ 6, Y & Z Harness Internal
AS-TH0014 | Extruder Wiring | EL-HR0095 | Extruder Fan Harness TAZ 6, v0.1
 |  | EL-HR0096 | Extruder Motor-switch Harness TAZ 6, v0.1
 |  | AS-CB0007 | Heater Cartridge 180mm Harness
 |  | AS-CB0008 | Thermistor 150mm Harness
 |  | AS-CB0005 | 40mm 5v Low Flow Fan-150mm Harness
 |  | AS-CB0006 | X-Max-185mm Purple Harness
 |  | Pin assign | AS-TH0014_TAZ6_Extruder_Pin_Assignments_RevC
Javelin | Extruder_assembly | EL-FA0030 | Dual Microblower-250mm
TAZ Dualy |  | EL-FA0031 | TAZ, Dual Extruder, 40mm Fan Harness
AS-TH0010 |  | EL-HR0060 | TAZ Extruder Extension v3.0
 |  | AS-CB0002 | Thermistor 220mm Harness
 |  | AS-CB0021 | NEMA17 Half Height Stepper Motor-130mm Leads Harness
 |  | AS-CB0001 | Heater Cartridge 225mm Harness
 |  | AS-CB0003 | Zero Sense 220mm Harness
 |  | Pin assign | AS-TH0010_TAZ_Dual_Extruder_v2_Pin_Assignments_RevA
Kanyu | Extruder_assembly | AS-CB0003 | Zero Sense 220mm Harness
TAZ flexy |  | AS-CB0019 | Heater Cartridge 210mm Harness
AS-TH0045 |  | AS-CB0022 | Thermistor 235mm Harness
 |  | AS-CB0017 | Microblower- 195mm
 |  | AS-CB0020 | 40mm 24v Low Flow Fan-120mm Harness
 |  | AS-CB0016 | NEMA17 Stepper Motor-200mm Leads Harness
 |  | Pin assign | AS-TH0045_TAZ_Flexy_v2_Pin_Assignments_RevA
Longfin | Extruder_assembly | EL-FA0030 | Dual Microblower-250mm
TAZ Flexy Dually |  | EL-FA0031 | TAZ, Dual Extruder, 40mm Fan Harness
AS-TH0019 |  | EL-HR0060 | TAZ Extruder Extension v3.0
 |  | AS-CB0002 | Thermistor 220mm Harness
 |  | AS-CB0021 | NEMA17 Half Height Stepper Motor-130mm Leads Harness
 |  | AS-CB0001 | Heater Cartridge 225mm Harness
 |  | AS-CB0003 | Zero Sense 220mm Harness
 |  | Pin assign | AS-TH0019_TAZ_FlexyDual_Extruder_v2_Pin_Assignments_RevA
Tilapia | Extruder_assembly | EL-HR0095 | Revision history is needed
TAZ 6 |  | EL-HR0096 | Revision history is needed
AS-TH0014 |  | AS-CB0009 | Zero Sense 155mm Harness
 |  | AS-CB0007 | Heater Cartridge 180mm Harness
 |  | AS-CB0008 | Thermistor 150mm Harness
 |  | AS-CB0005 | 40mm 5v Low Flow Fan-150mm Harness
 |  | AS-CB0006 | X-Max-185mm Purple Harness
 |  | Pin assign | AS-TH0014_TAZ6_Extruder_Pin_Assignments_RevC
Uaru | Extruder_assembly | AS-CB0016 | NEMA17 Stepper Motor-200mm Leads Harness
TAZ 5 |  | AS-CB0022 | Thermistor 235mm Harness
AS-TH0049 |  | AS-CB0019 | Heater Cartridge 210mm Harness
 |  | AS-CB0017 | Microblower- 195mm
 |  | AS-CB0020 | 40mm 24v Low Flow Fan-120mm Harness
 |  | Pin assign | AS-TH0049_TAZ5_Extruder_v2d_Pin_Assignments_RevB
Opah | Extruder_assembly | EL-TH0012 | MOARstruder 50mm Thermistor Harness
MOARstruder |  | EL-HR0096 | Extruder Motor-switch Harness TAZ 6, v0.1
AS-TH0032 |  | AS-CB0010 | Zero Sense 175mm Harness
 |  | AS-CB0011 | 40mm 5v Low Flow Fan-160mm Harness
 |  | AS-CB0012 | Dual 24v Fan 115mm-65mm SS Harness
 |  | AS-CB0013 | Heater Cartridge 185mm Harness
 |  | AS-CB0014 | MOARstruder Thermistor Extension Harness
 |  | Pin assign | AS-TH0032_MOARstruder_Extruder_Pin_Assignments_RevA

Sheet: Extruders Only Cables Dec2016
Project | PN | Odoo Description
Cuckoo
Mini Flexy v3
Albatross | AS-CB0003 | Zero Sense 220mm Harness
Mini Flexy v2 | AS-CB0015 | X-Max 160mm-Purple Harness
AS-TH0047 | AS-CB0023 | X-Max-160mm Black harness
 | AS-CB0008 | Thermistor 150mm Harness
 | AS-CB0016 | NEMA17 Stepper Motor-200mm Leads Harness
 | AS-CB0007 | Heater Cartridge 180mm Harness
 | AS-CB0020 | 40mm 24v Low Flow Fan-120mm Harness
 | AS-CB0017 | Microblower- 195mm
 | Pin assign | AS-TH0047_Mini_Flexystruder_v2_Pin_Assignments_RevA
Gladiola | EL-HR0121 | Mini, Nozzle Fan Harness
AS-TH0022 | EL-HR0122 | Mini, Extruder Motor Harness
 | EL-HR0123 | Mini, Heat Sink Fan Harness
 | EL-HR0124 | Mini, Zero Sense 215mm Harness
 | EL-HR0125 | Mini X Max Switch Harness
 | AS-CB0024 | 175mm_Heater_Cartridge_Harness
 | AS-CB0025 | 195mm_Thermistor_Harness
 | Pin assign | AS-TH0022_Mini_Extruder_Pin_Assignments_RevB
Olive | EL-HR0095 | Extruder Fan Harness TAZ 6, v0.1
AS-TH0014 | EL-HR0096 | Extruder Motor-switch Harness TAZ 6, v0.1
 | AS-CB0007 | Heater Cartridge 180mm Harness
 | AS-CB0008 | Thermistor 150mm Harness
 | AS-CB0005 | 40mm 5v Low Flow Fan-150mm Harness
 | AS-CB0006 | X-Max-185mm Purple Harness
 | Pin assign | AS-TH0014_TAZ6_Extruder_Pin_Assignments_RevC
Javelin | EL-FA0030 | Dual Microblower-250mm
TAZ Dualy | EL-FA0031 | TAZ, Dual Extruder, 40mm Fan Harness
AS-TH0010 | EL-HR0060 | TAZ Extruder Extension v3.0
 | AS-CB0002 | Thermistor 220mm Harness
 | AS-CB0021 | NEMA17 Half Height Stepper Motor-130mm Leads Harness
 | AS-CB0001 | Heater Cartridge 225mm Harness
 | AS-CB0003 | Zero Sense 220mm Harness
 | Pin assign | AS-TH0010_TAZ_Dual_Extruder_v2_Pin_Assignments_RevA
Kanyu | AS-CB0003 | Zero Sense 220mm Harness
TAZ flexy | AS-CB0019 | Heater Cartridge 210mm Harness
AS-TH0045 | AS-CB0022 | Thermistor 235mm Harness
 | AS-CB0017 | Microblower- 195mm
 | AS-CB0020 | 40mm 24v Low Flow Fan-120mm Harness
 | AS-CB0016 | NEMA17 Stepper Motor-200mm Leads Harness
 | Pin assign | AS-TH0045_TAZ_Flexy_v2_Pin_Assignments_RevA
Longfin | EL-FA0030 | Dual Microblower-250mm
TAZ Flexy Dually | EL-FA0031 | TAZ, Dual Extruder, 40mm Fan Harness
AS-TH0019 | EL-HR0060 | TAZ Extruder Extension v3.0
 | AS-CB0002 | Thermistor 220mm Harness
 | AS-CB0021 | NEMA17 Half Height Stepper Motor-130mm Leads Harness
 | AS-CB0001 | Heater Cartridge 225mm Harness
 | AS-CB0003 | Zero Sense 220mm Harness
 | Pin assign | AS-TH0019_TAZ_FlexyDual_Extruder_v2_Pin_Assignments_RevA
Tilapia | EL-HR0095 | Revision history is needed
TAZ 6 | EL-HR0096 | Revision history is needed
AS-TH0014 | AS-CB0009 | Zero Sense 155mm Harness
 | AS-CB0007 | Heater Cartridge 180mm Harness
 | AS-CB0008 | Thermistor 150mm Harness
 | AS-CB0005 | 40mm 5v Low Flow Fan-150mm Harness
 | AS-CB0006 | X-Max-185mm Purple Harness
 | Pin assign | AS-TH0014_TAZ6_Extruder_Pin_Assignments_RevC
Uaru | AS-CB0016 | NEMA17 Stepper Motor-200mm Leads Harness
TAZ 5 | AS-CB0022 | Thermistor 235mm Harness
AS-TH0049 | AS-CB0019 | Heater Cartridge 210mm Harness
 | AS-CB0017 | Microblower- 195mm
 | AS-CB0020 | 40mm 24v Low Flow Fan-120mm Harness
 | Pin assign | AS-TH0049_TAZ5_Extruder_v2d_Pin_Assignments_RevB
Opah | EL-TH0012 | MOARstruder 50mm Thermistor Harness
MOARstruder | EL-HR0096 | Extruder Motor-switch Harness TAZ 6, v0.1
AS-TH0032 | AS-CB0010 | Zero Sense 175mm Harness
 | AS-CB0011 | 40mm 5v Low Flow Fan-160mm Harness
 | AS-CB0012 | Dual 24v Fan 115mm-65mm SS Harness
 | AS-CB0013 | Heater Cartridge 185mm Harness
 | AS-CB0014 | MOARstruder Thermistor Extension Harness
 | Pin assign | AS-TH0032_MOARstruder_Extruder_Pin_Assignments_RevA
