gralco/TAZ6/production_docs/Olive_Project_ECO_Tracking.ods

Sheet: Log
Serial Number where implemented is required only during significant changes
Project: |  |  | TAZ 6.0 -Olive |  | Project release date: |  | April 1, 2016
ECO # | Change Type | ECO Date | Description of Change | Item impacted (Pn, file, etc.) | New Item (Pn, file, etc.) | Serial Number or Date implemented | LulzBot Material Disposition
1 | Part Design | 04/15/2016 | Bed plate material change from 5052 to 6061 aluminium to address supplier processing warping | PP-FP0108 | PP-MP0145 | N/A | Use up inventory
2 | Part Design | 04/28/16 | Change case masking area from 8.00mm to 7.50mm to improve masking exposure possibility due to tolerance stack | PP-FP0075 | N/A | N/A | Rework inventory
3 | Part Design | 05/02/16 | Correct through hole size in FreeCAD file to 2.5mm, add through hole dimension to part print; add masking requirement to 5 locations on painted bed plate to improve grounding | PP-FP0108 | N/A | N/A | Scrap inventory
4 | Part Design | 05/05/16 | Resize M5 insert through hole size to improve insert retention strength of Bed Mount Chassis | PP-GP0223 v3.3 | PP-GP0223 v3.4 | KT-PR0041NA-15230 | Scrap inventory
5 | Processing Change | 05/13/16 | Addition of TL-CS0114 White Lithium grease to Z drive rods left and right to process instructions and to BOM | N/A | N/A | 05/13/2016 KT-PR0041NA-15376 | N/A
6 | Hardware Change | Pending | Replace HD-BT004 (Class 12.9 SHCS, Alloy Steel, M5-.8 x 10mm) (X4) to Thread locking M5-.8 x 10 SHCS Black Oxide (x4); TEMPORARY DEVIATION to use M5-.8 x14 mm SHCS (HD-BT0049) until HD-BT0174 is available | HD-BT0048 | HD-BT0174 | KT-PR0041NA-15635 | N/A
7 | Processing Change | 05/16/16 | Update work instruction- changed corner M4 BHCS torque specification to 40 in-lbs from 48 in-lbs; electronic torque drivers released to production to allow torque setting verification; 40 in-lbs backed off of screw break rate | N/A | N/A | 05/11/16 | N/A
8 | Processing Change | 05/20/16 | Removal of TL-CS0114 White Lithium grease from Z drive rods left and right, removed from process instructions and to BOM | TL-CS0114 | N/A | 05/20/2016 KT-PR0041NA-15519 | N/A
9 | Part Design | 05/23/16 | Resize M5 & M3 insert through hole size to improve insert retention strength: change M5-.8 x 6.7mm insert length (HD-MS0158) to M5-.8 x 11.1mm insert length (HD-MS0060) | PP-GP0214 v2.7 (X4) HD-MS0158 | PP-GP0214 v2.9 (x4) HD-MS0060 | 05/27/2016 printing KT-PR0041NA-15411 | Scrap inventory
10 | Part Design | 05/23/16 | Resize M5 & M3 insert through hole size to improve insert retention strength, lower motor mount 5mm to align pulley with midpoint of idler, resized 12.4mm OD through holes to 12.2mm to address rigidity of Z axis;, change M5-.8 x 6.7mm insert length (HD-MS0158) to M5-.8 x 11.1mm insert length (HD-MS0060) | PP-GP0213 v2.9 (X4) HD-MS0158 | PP-GP0213 v2.10 (x4) HD-MS0060 | 05/27/2016 printing KT-PR0041NA-15670 | Scrap inventory
11 | Part Design | 05/23/16 | Move lower 1.65mm x 37.7mm slot in case to a higher location to improve weldability and metal erosion of the slot | PP-MP0110 Rev A | PP-MP0110 Rev B | released to supplier 5/26 | Use up inventory
12 | Part Design | 05/23/16 | Add callout of surface finish requirement in areas of laser etching | PP-MP0145 Rev A | PP-MP0145 Rev B | released to supplier 5/26
13 | Part Design | 05/23/16 | Palm project change- Rotate front nut recess 12 degrees to align a flat of the nut to a parallel orientation of the front edge of the printed part, increase part density to 60%, slightly increased size of nut recess to improve nut fit | PP-GP0186 V1.3.2 | PP-GP0186 V1.4.1-15C | 05/30/2016 Printing KT-PR0041NA-16243 | Scrap inventory
14 | INI- Temperature | 05/26/16 | bearing_holder ini changed to implement fan cooling to address part warping that resulted in bearing bind in ~30% of parts. | bearing_holder_v1.0-16c-m50.250.110-x2 | bearing_holder_v1.0-17c-m50.250.110-x2 | 05/26/2016 printing KT-PR0041NA-15564 | Use up inventory
15 | Part Design | 05/26/16 | Z_Lower_left, M4 mount to frame walls have 2x recesses each that are 2.5mm thick which can cause hardware stack interference allowing Z lower to slip- change is to thicken recess to 3.5mm each; resize 10mm rod holes to 10.2 (set screw hole) and 10.4 (lower hole) to address excess play; until change can be implemented a TEMPORARY DEVIATION to permit use of double washers in each of the mount holes is required. | PP-GP0215 v2.3 | PP-GP0215 v2.5 | 05/26/2016- TDA 6/6/2016 printing of 2.5 KT-PR0041NA-15981 | Use up inventory
16 | Part Design | 05/26/16 | Z_Lower_Right, M4 mount to frame walls have 2x recesses each that are 2.5mm thick which can cause hardware stack interference allowing Z lower to slip- change is to thicken recess to 3.5mm each; resize 10mm rod holes to 10.2 (set screw hole) and 10.4 (lower hole) to address excess play; until change can be implemented a TEMPORARY DEVIATION to permit use of double washers in each of the mount holes is required. | PP-GP0227 c2.3 | PP-GP0227 v2.5 | 05/26/2016- TDA 6/6/2016 printing of 2.5 KT-PR0041NA-15981 | Use up inventory
17 | Component Change | 06/01/16 | BOM and Drawing Change for EL-HR0087; Remove 1x: PC-CN0003 (3 pos conn) Add 1x: EL-MS0075 (8 pos conn), 6x EL-MS0059 (Female Socket 22-24awg) | PC-CN0003 | EL-MS0059 EL-MS0075 | KT-PR0041NA-15730 | Rework inventory
18 | Component Change | 05/23/16 | replace SD card with Verbatim model SD card | EL-MS0119 | EL-MS0385 | KT-PR0041NA-16105 | Scrap inventory
19 | Component Change | 07/18/16 | Replace M3x8 BHCS (qty 8 of HD-BT0137) ) used to mount Moon's motor to the Z axis with M3x10 BHCS (qty 8 of HD-BT0148), decreases HD-BT0137 to BOM Qty to 33 and increases HD-BT0148 BOM qty to 24 | HD-BT0137 | HD-BT0148 |  | Use up inventory
20 | Part Design | 07/25/16 | Z Upper removal of un-necessary radius that hampers assembly and increases size of top side mount holes to |  |  |  | Use up inventory
21 | Part Design | 07/25/16 | PP-MP0145 Rev B to Rev C- Additional masked area notes added, tolerance limits for parts reset at dimension lines | PP-MP0145 Rev B | PP-MP0145 Rev C |  | Use up inventory
22 | Part Design | 07/25/16 | PP-MP0109 rev C to D- Outer holes (3.4mm) increased to 4.0mm to ease fit of the cover to the case | PP-MP0109 rev C | PP-MP0109 rev D |  | Use up inventory
23 | Part Design | 07/25/16 | PP-MP0110 rev C to E, Skipped rev D due to an early release of a print before review- Rev D and E changes Updated freeCAD file to correct dimensional error with power entry module (change is noted in RevD), Corrected dimensional allowance for the power entry module, corrected Rev D note (Rev E) | PP-MP0110 Rev C | PP-MP0110 Rev E |  | Use up inventory

Sheet: Change Notifications
Action from Change | Purchased off the shelf item | Purchased make to AO print item | Printed/ Made in house item | Task Owner
New Part Number | Create PN in ERP | Create PN in ERP | Create PN in ERP | Purchasing
 | Update BOM | Update BOM | Update BOM | ??? (Mfg Eng. Am I taking over BOM control?)
 | Create new retail part? | Create new retail part? | Create new retail part? | Purchasing
 | Purchase new item | Purchase new item |  | Purchasing
 | Pull MSDS, provide to Facilities |  |  | Purchasing
 |  | Create new part model & drawing | Create new part model & drawing | R&D
 |  |  | Create Slice and gcode | R&D???
 | Update Downloads | Update Downloads | Update Downloads | ???
 | Apply material disposition (scrap, rework, UAI) to stock items | Apply material disposition (scrap, rework, UAI) to stock items | Apply material disposition (scrap, rework, UAI) to stock items | Warehouse
 | Create new Inspection plan | Create new Inspection plan |  | Quality Manager
 | review OHAI (update PN references if any, check form factors) | review OHAI (update PN references if any, check form factors) | review OHAI (update PN references if any, check form factors) | Mfg Eng
 | Purchased off the shelf item | Purchased make to AO print item | Printed/ Made in house item | Task Owner
Existing part modification | Update PN in ERP | Update PN in ERP | Update PN in ERP | Purchasing
 | Update BOM | Update BOM | Update BOM | ??? (Mfg Eng. Am I taking over BOM control?)
 | Revised retail part? | Revised retail part? | Revised retail part? | Purchasing
 | Purchase new item | Purchase new item |  | Purchasing
 | Pull MSDS, provide to Facilities |  |  | Purchasing
 |  | Revise part model & drawing | Revise part model & drawing | R&D
 |  |  | Create Slice and gcode | R&D ???
 | Update Downloads | Update Downloads | Update Downloads | ???
 | Apply material disposition (scrap, rework, UAI) to stock items | Apply material disposition (scrap, rework, UAI) to stock items | Apply material disposition (scrap, rework, UAI) to stock items | Warehouse
 | Revise Inspection plan | Revise Inspection plan |  | Quality Manager
 | review OHAI (update PN references if any, check form factors) | review OHAI (update PN references if any, check form factors) | review OHAI (update PN references if any, check form factors) | Mfg Eng
BOM item change |  |  |  | Task Owner
 | Temporary Deviation of PN or Quantity of part | Update purchasing plan for both parts, single part increase
 | Change from one existing part to another | Update purchasing plan for both parts
 | ECO # | Change Type | ECO Date | Description of Change | Item impacted (Pn, file, etc.) | New Item (Pn, file, etc.) | Serial Number or Date implemented | LulzBot Material Disposition
 | TAZ 6.0 -Olive

Sheet: Action Template
Project: | TAZ 6- Olive
ECO# | 19
Change: | Replace M3x8 BHCS (qty 8 of HD-BT0137) ) used to mount Moon's motor to the Z axis with M3x10 BHCS (qty 8 of HD-BT0148), decreases HD-BT0137 to BOM Qty to 33 and increases HD-BT0148 BOM qty to 32
Old item | Old Qty | New Item | New Qty | Old Item Disposition
HD-BT0137 HD-BT0148 | 49 16 | HD-BT0137 HD-BT0148 | 33 32 | USE AS IS
Task |  |  |  | Action Owner
Create PN in ERP |  |  |  | N/A
Update BOM |  |  |  | Mfg Eng
Create new retail part? |  |  |  | N/A
Purchase new item |  |  |  | Purchasing
Pull MSDS, provide to Facilities |  |  |  | N/A
Create new part model & drawing |  |  |  | N/A
Create Slice and gcode |  |  |  | N/A
Update Downloads |  |  |  | Steven
Apply material disposition (scrap, rework, UAI) to stock items |  |  |  | N/A
Create new Inspection plan |  |  |  | N/A
review OHAI (update PN references if any, check form factors) |  |  |  | Mfg Eng
Update materials at work stations
