gralco/TAZ6/photos/TAZ_6_prusa_parts.jpg

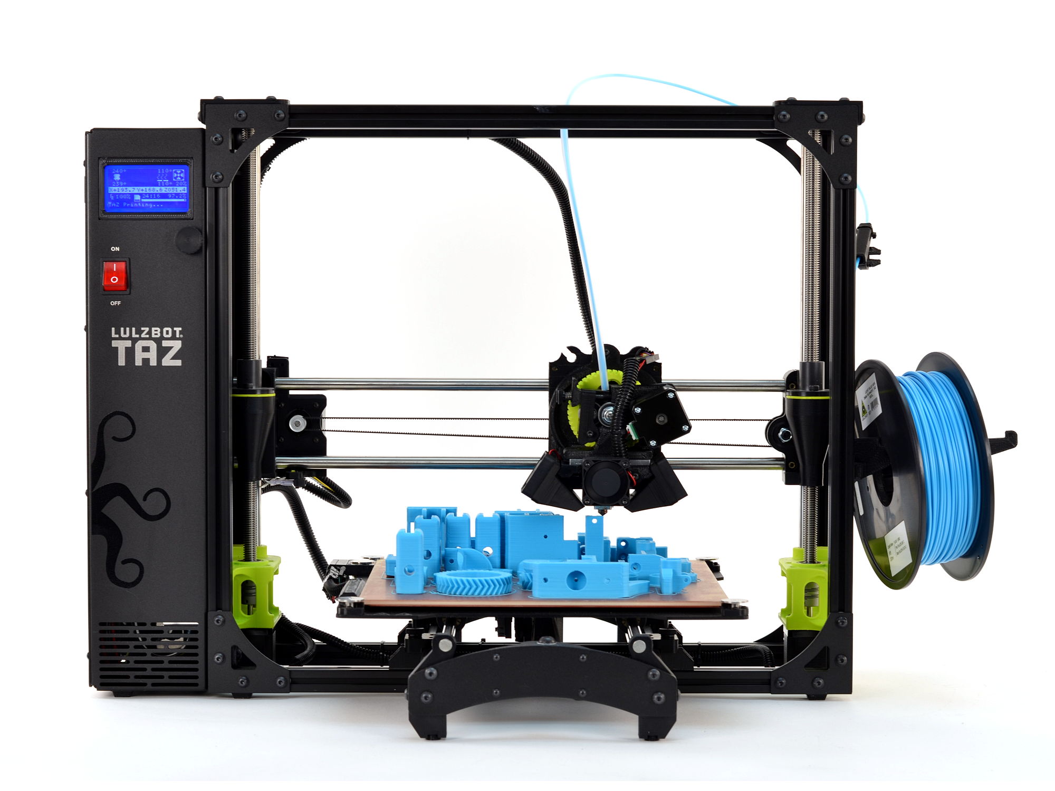
photos/TAZ_6_prusa_parts.jpg
