gralco/TAZ6/production_parts/assemblies/z_axis_assembly_left.fcstd

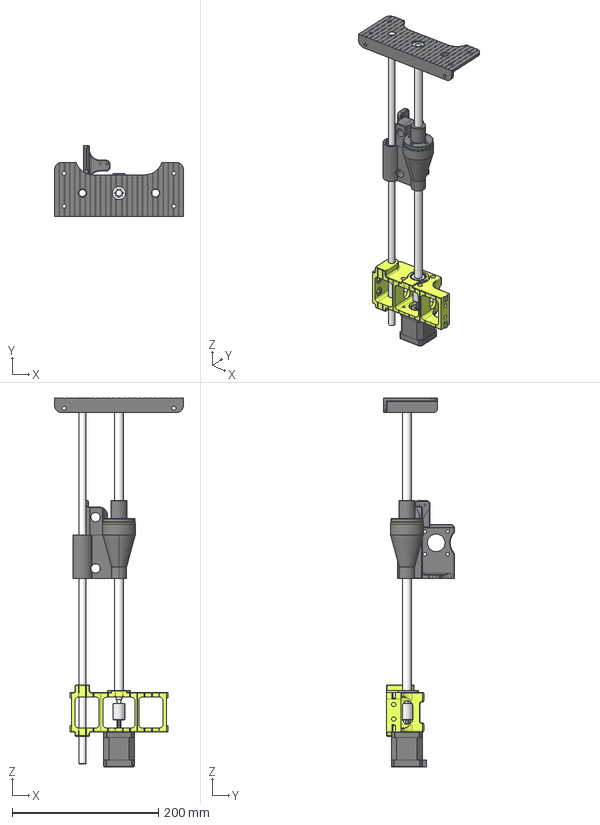
[picture p161: CAD file, 2024-03-15]
production_parts/assemblies/z_axis_assembly_left.fcstd
176.3 x 97.0 x 504.4 mm
z_lower_left_v2_5_01
z_upper_v2_3_01
_0mmx500mm_rod_v0_1_01
_08_bearing_01
_08_bearing_02
NEMA17_01
_2mm_drive_rod_01
z_coupler_01
drive_nut_01
z_carriage_motor_v2_10_01
flexy_washer_v0_1_01
