gralco/TAZ6/production_parts/assemblies/y_axis_assembly.fcstd

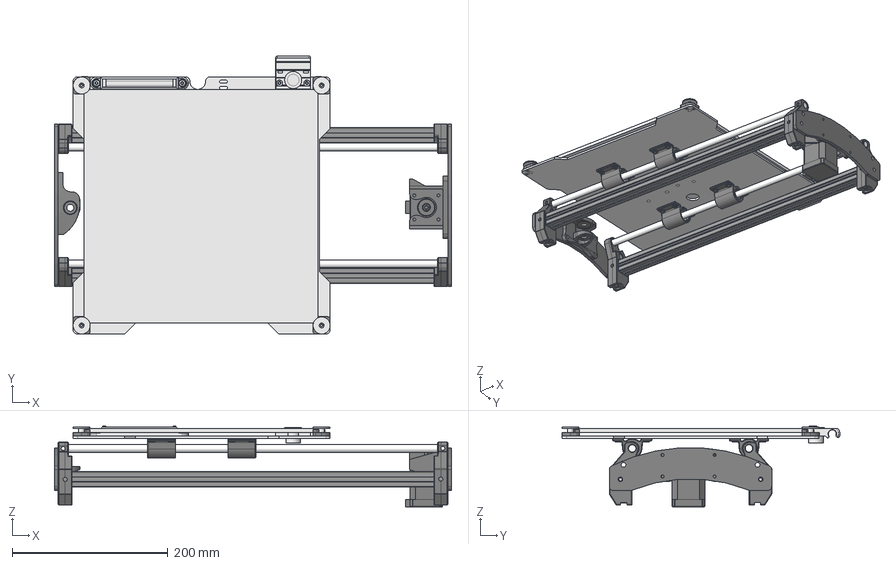
[picture p162: CAD file, 2024-03-15]
production_parts/assemblies/y_axis_assembly.fcstd
509.5 x 356.9 x 103.9 mm
y_corner_v2_4_01
y_corner_v2_4_02
y_corner_v2_4_01001
y_corner_v2_4_03
_0mmx500mm_rod_v0_1_01
_0mmx500mm_rod_v0_1_02
y_end_plate_v0_2_revB_01
y_end_plate_v0_2_revB_02
_00mm_extrusion_01
_00mm_extrusion_02
y_idler_mount_v4_0_01
y_motor_mount_v3_0_01
NEMA17_01
bearing_holder_v1_0_01
bearing_holder_v1_0_02
bearing_holder_v1_0_03
bearing_holder_v1_0_04
bed_corner_taz6_v2_01
bed_corner_taz6_v2_02
bed_corner_taz6_v2_03
bed_corner_taz6_v2_04
print_surface_assy_01
