gralco/TAZ6/production_parts/assemblies/z_axis_frame_assembly.fcstd

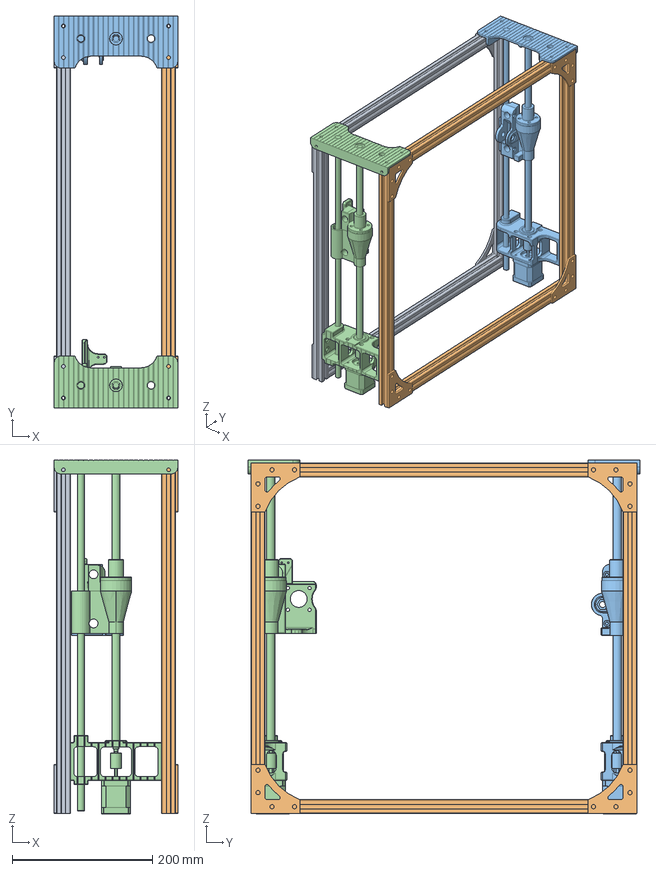
[picture p163: CAD file, 2024-03-15]
production_parts/assemblies/z_axis_frame_assembly.fcstd
176.4 x 558.0 x 504.4 mm
z_frame_assembly_01
z_frame_assembly_02
z_axis_assembly_right_01
z_axis_assembly_left_01
