gralco/TAZ6/production_parts/assemblies/electronics_case_assembly.fcstd

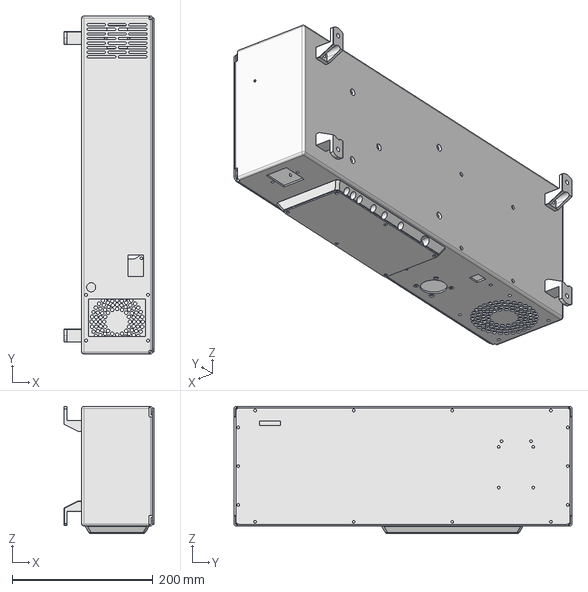
[picture p164: CAD file, 2024-03-15]
production_parts/assemblies/electronics_case_assembly.fcstd
127.6 x 480.0 x 180.9 mm
