gralco/TAZ6/production_parts/machined_parts/lulzbot_edition_hexagon_hotend-0.5mm/tube ASM long HB.DXF

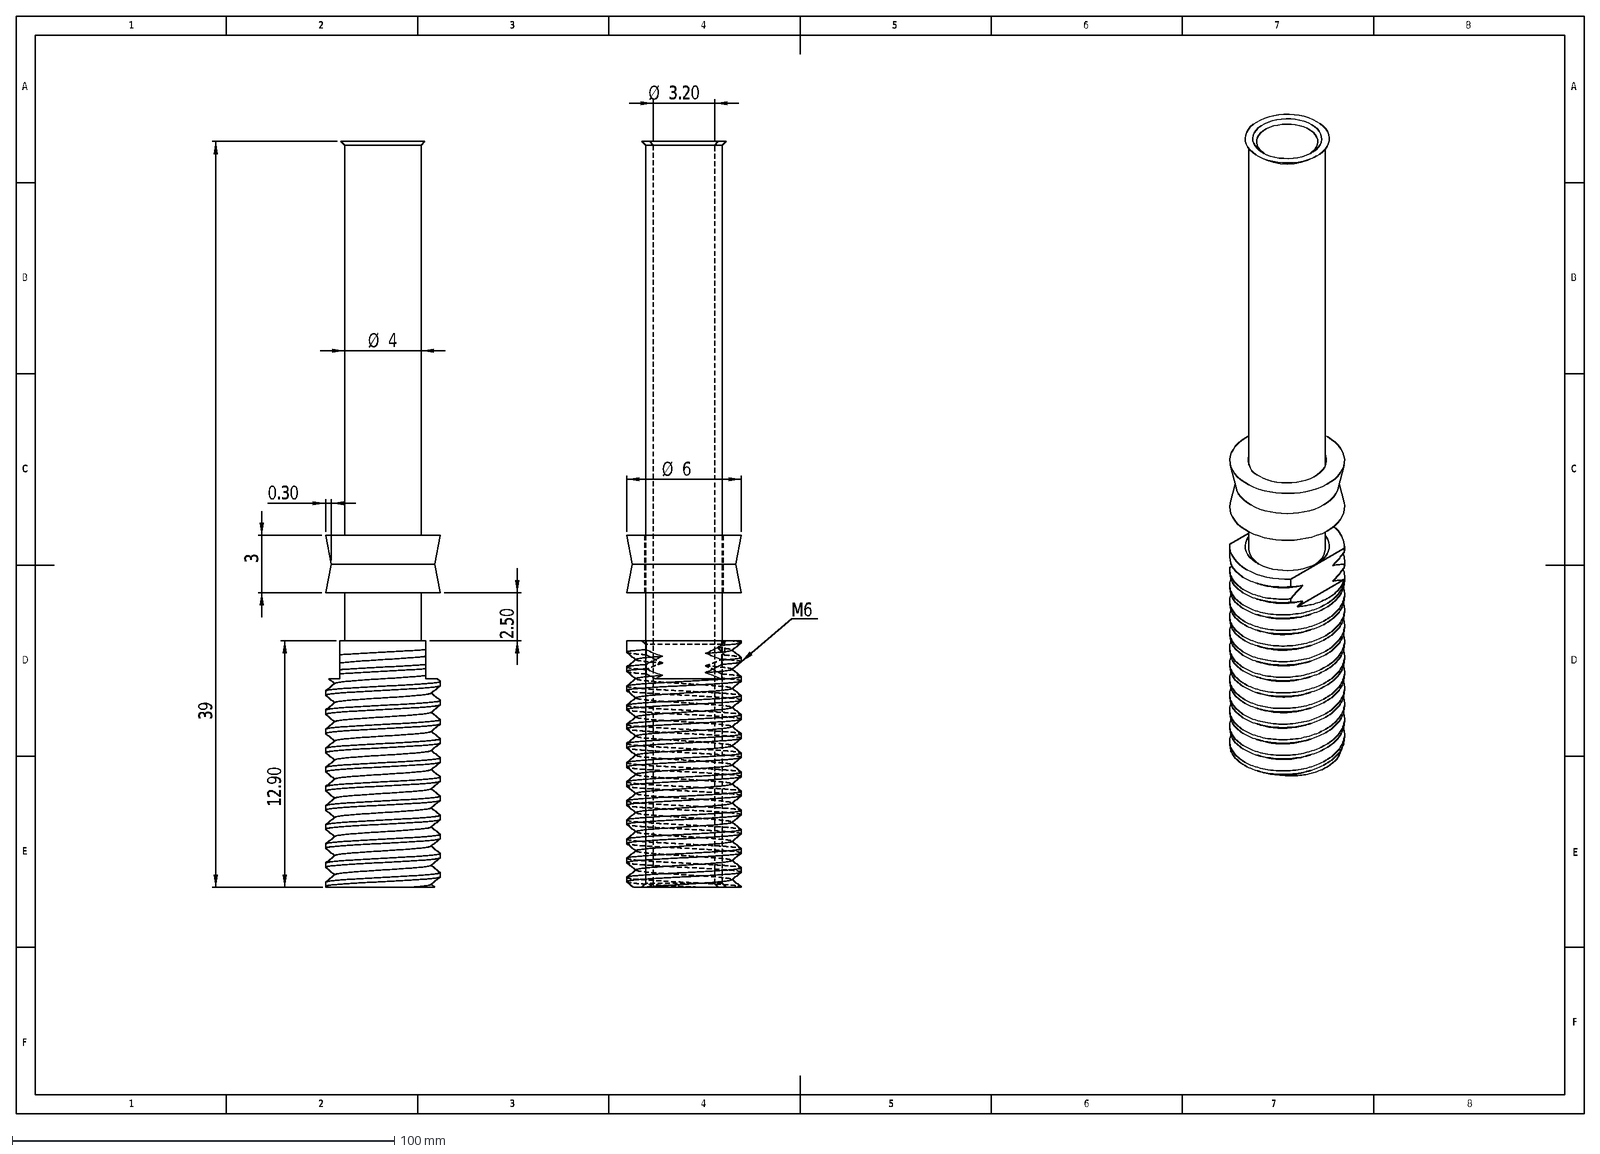
[picture p165: CAD file, 2024-03-15]
production_parts/machined_parts/lulzbot_edition_hexagon_hotend-0.5mm/tube ASM long HB.DXF
D
E
F
C
1
2
3
4
B
A
5
6
7
8
12.90
2.50
0.30
Ø
39
3.20
M6
