gralco/TAZ6/production_parts/assemblies/z_frame_assembly.fcstd

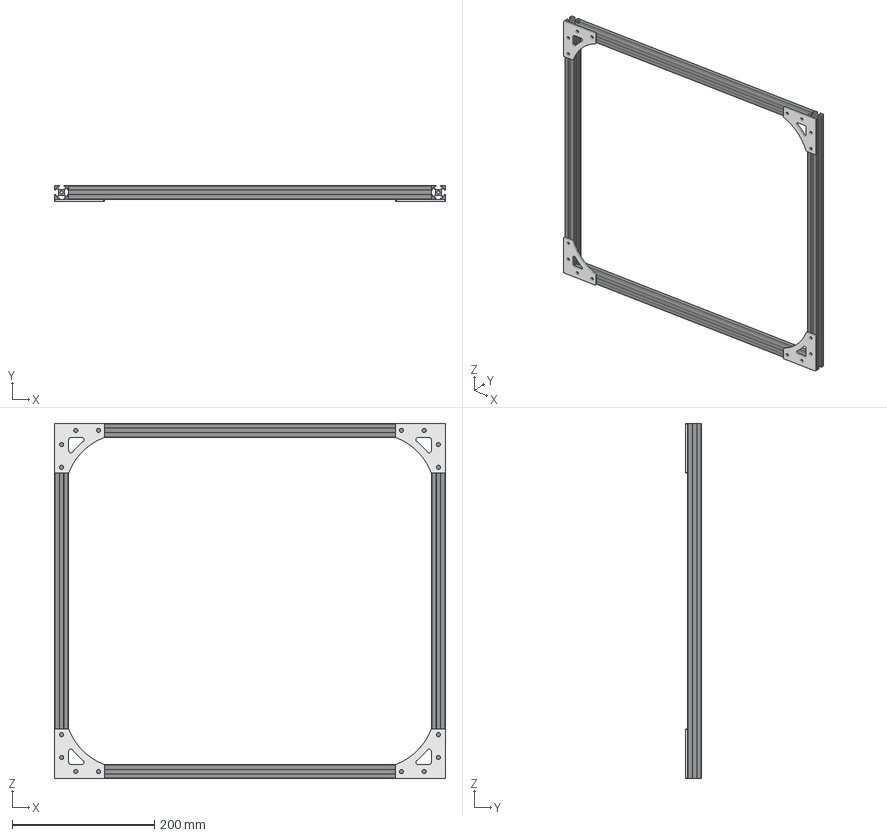
[picture p166: CAD file, 2024-03-15]
production_parts/assemblies/z_frame_assembly.fcstd
550.0 x 23.2 x 500.0 mm
_00mm_extrusion_01
_10mm_extrusion_01
_10mm_extrusion_02
_00mm_extrusion_02
corner_bracket_v2_0_1_01
corner_bracket_v2_0_1_02
corner_bracket_v2_0_1_03
corner_bracket_v2_0_1_04
