gralco/TAZ6/production_parts/assemblies/z_axis_assembly_right.fcstd

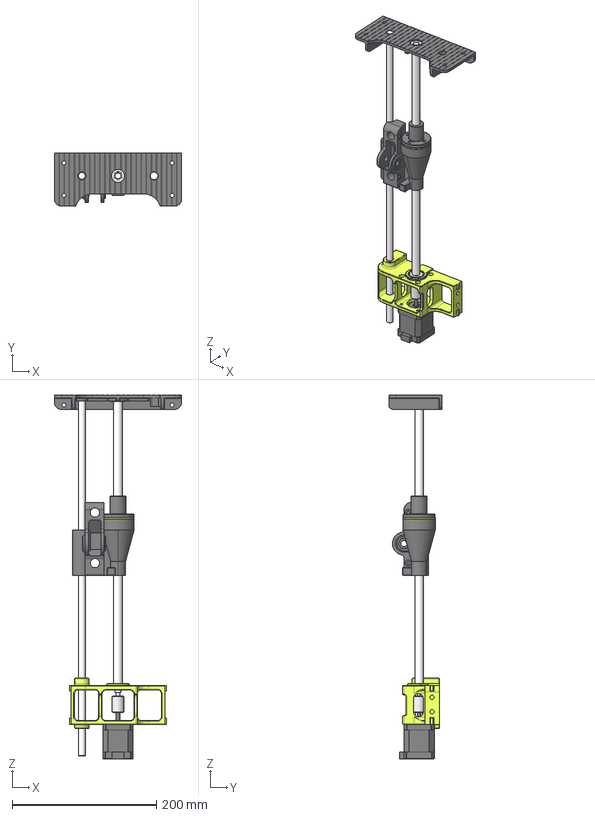
[picture p167: CAD file, 2024-03-15]
production_parts/assemblies/z_axis_assembly_right.fcstd
176.4 x 74.0 x 504.4 mm
z_upper_v2_3_01
_0mmx500mm_rod_v0_1_01
_08_bearing_01
_08_bearing_02
NEMA17_01
_2mm_drive_rod_01
z_coupler_01
drive_nut_01
z_carriage_idler_v2_9_01
z_lower_right_v2_5_01
flexy_washer_v0_1_01
