gralco/TAZ6/production_parts/jigs/TAZ6_frame_assy_fixture/TAZ6_frame_assy.fcstd

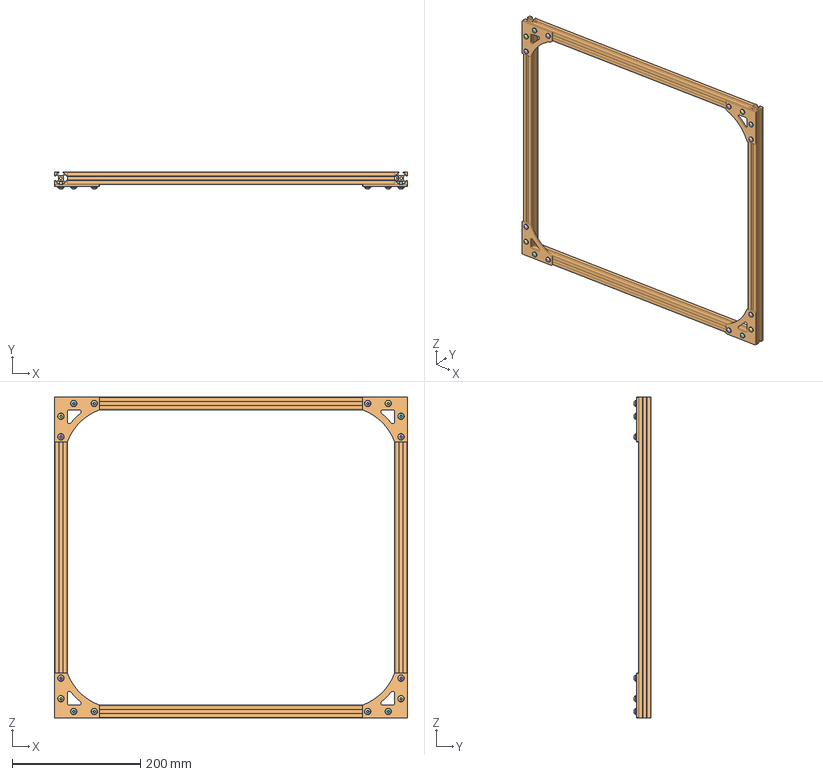
[picture p168: CAD file, 2024-03-15]
production_parts/jigs/TAZ6_frame_assy_fixture/TAZ6_frame_assy.fcstd
550.0 x 27.0 x 500.0 mm
M6-Washer
M5-Washer
M5-Washer001
M5-Washer002
M5-Washer003
M5x10-Screw
M5x10-Screw001
M5x10-Screw002
M5x10-Screw003
M5-Washer004
M5-Washer005
M5-Washer006
M5-Washer007
M5x10-Screw004
M5x10-Screw005
M5x10-Screw006
M5x10-Screw007
M5-Washer011
M5-Washer010
M5-Washer009
M5-Washer008
M5x10-Screw011
M5x10-Screw010
M5x10-Screw009
M5x10-Screw008
M5-Washer012
M5-Washer013
M5-Washer014
M5-Washer015
M5x10-Screw015
M5x10-Screw014
M5x10-Screw013
M5x10-Screw012
muxedAssembly
