gralco/TAZ6/production_parts/assemblies/assembly_parts/print_surface_assy.fcstd

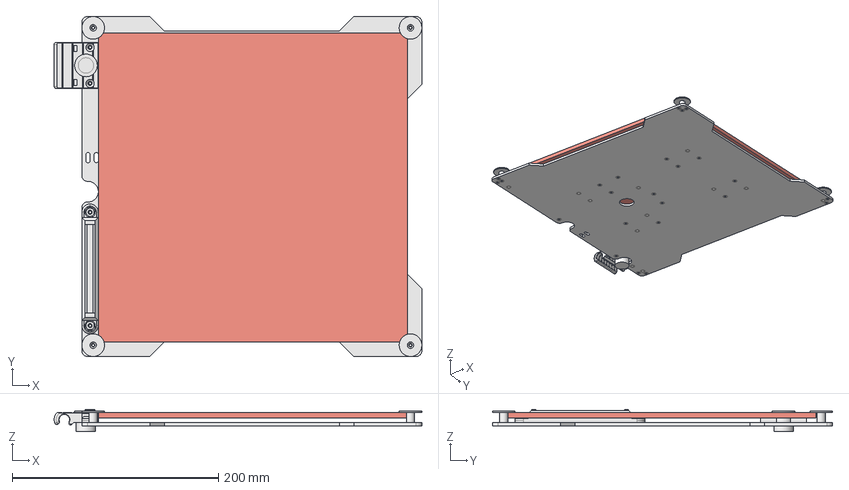
[picture p169: CAD file, 2024-03-15]
production_parts/assemblies/assembly_parts/print_surface_assy.fcstd
356.9 x 330.0 x 21.8 mm
bed_standoff_10mm_01
bed_standoff_10mm_02
bed_standoff_10mm_03
bed_standoff_10mm_04
_00mm_bed_plate_6061_revD_01
bed_leveling_washer_v2_0_PP_MP0082_01
bed_leveling_washer_v2_0_PP_MP0082_01001
bed_leveling_washer_v2_0_PP_MP0082_01002
bed_leveling_washer_v2_0_PP_MP0082_01003
_00mmx300mm_bed_01
wiper_mount_v1_1_01
z_min_switch_mount_v4_1_01
z_min_button_01
