gralco/TAZ6/production_parts/jigs/TAZ6_frame_assy_fixture/TAZ6_frame_full_assy.fcstd

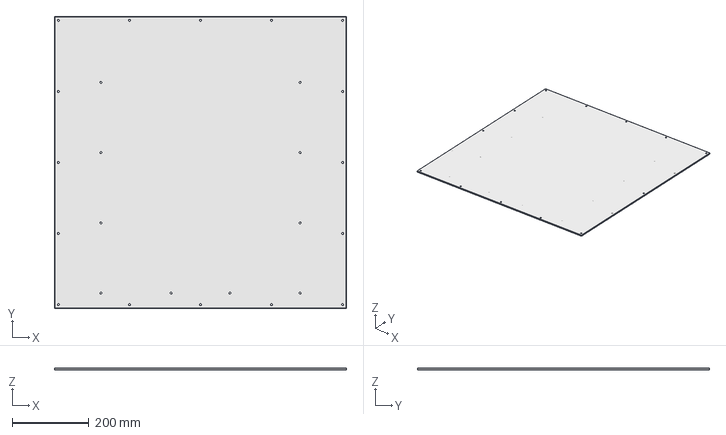
[picture p170: CAD file, 2024-03-15]
production_parts/jigs/TAZ6_frame_assy_fixture/TAZ6_frame_full_assy.fcstd
762.0 x 762.0 x 4.83 mm
