gralco/TAZ6/production_parts/assemblies/assembly_parts/NEMA17.fcstd

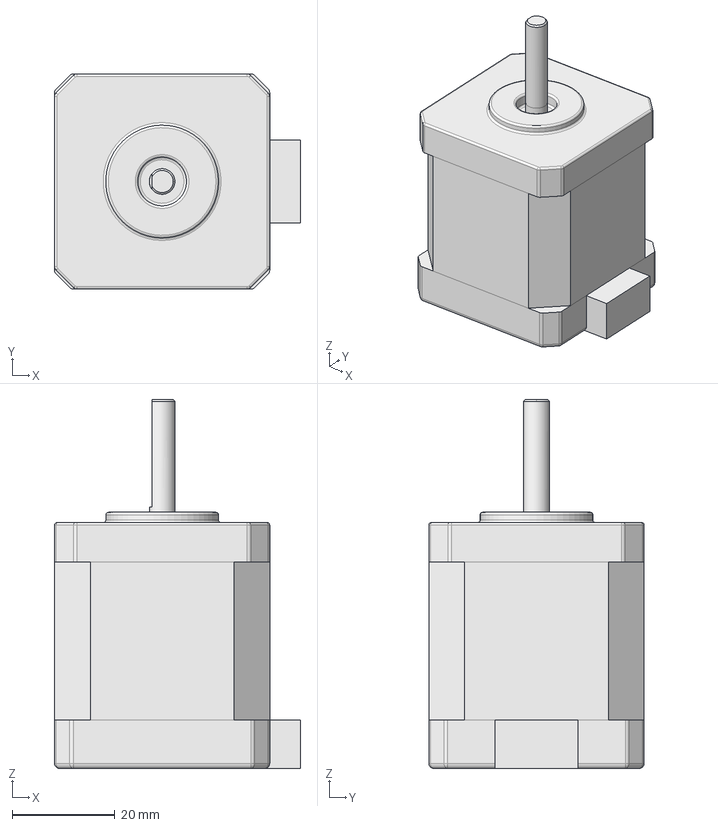
[picture p172: CAD file, 2024-03-15]
production_parts/assemblies/assembly_parts/NEMA17.fcstd
48.0 x 42.0 x 72.0 mm
