gralco/TAZ6/production_parts/jigs/anti_skid_pad.fcstd

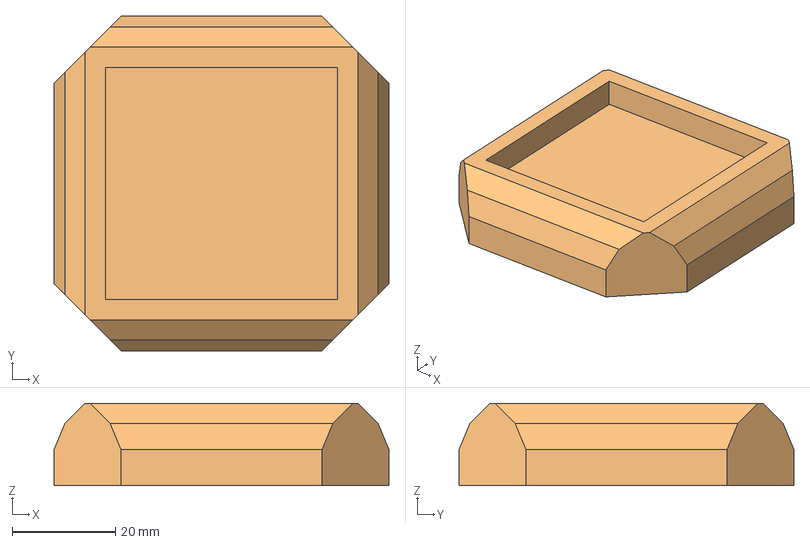
[picture p173: CAD file, 2024-03-15]
production_parts/jigs/anti_skid_pad.fcstd
65.0 x 65.0 x 16.0 mm
