gralco/TAZ6/production_parts/jigs/control_box_test_fixture/control_box_test_fixture_top_plate.fcstd

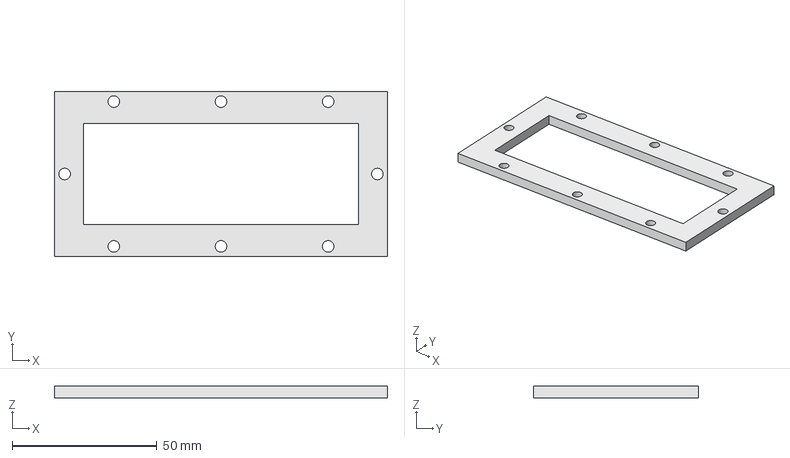
[picture p174: CAD file, 2024-03-15]
production_parts/jigs/control_box_test_fixture/control_box_test_fixture_top_plate.fcstd
115.0 x 57.0 x 4.00 mm
