gralco/TAZ6/production_parts/jigs/harness_test_fixture/taz_heat_bed_external_harness_v2.fcstd

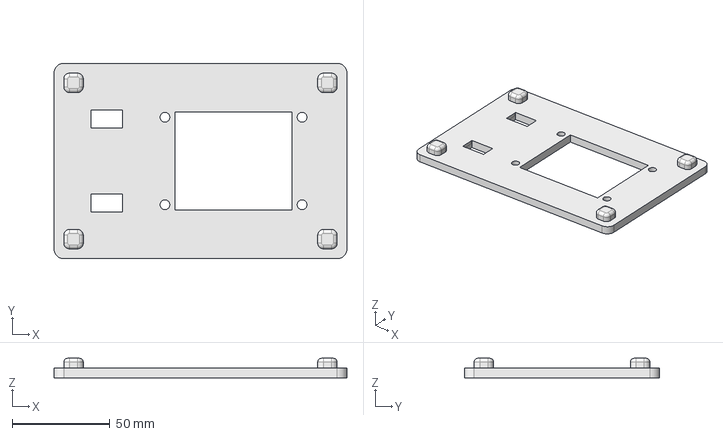
[picture p175: CAD file, 2024-03-15]
production_parts/jigs/harness_test_fixture/taz_heat_bed_external_harness_v2.fcstd
150.0 x 100.0 x 10.0 mm
