gralco/TAZ6/production_parts/jigs/insert jigs/Y corners/y_corner_left_insert_jig.stl

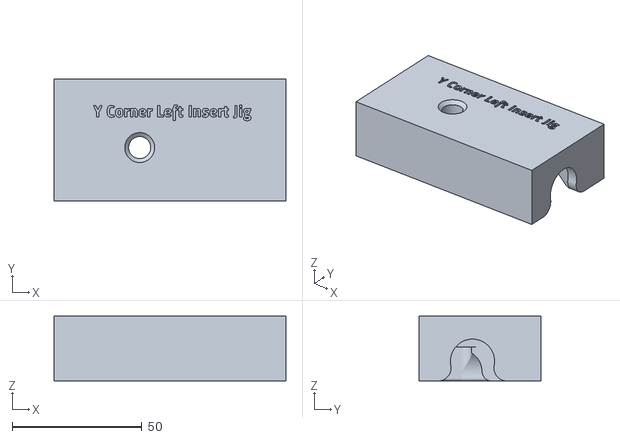
[picture p176: CAD file, 2024-03-15]
production_parts/jigs/insert jigs/Y corners/y_corner_left_insert_jig.stl
89.4 x 47.0 x 25.0
