gralco/TAZ6/production_parts/jigs/insert jigs/YmountChassis/ymnt_chassis_insert_x4.fcstd

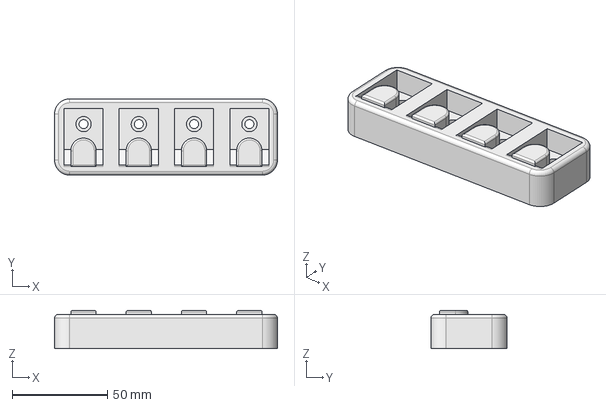
[picture p177: CAD file, 2024-03-15]
production_parts/jigs/insert jigs/YmountChassis/ymnt_chassis_insert_x4.fcstd
117.0 x 40.0 x 20.2 mm
