gralco/TAZ6/production_parts/jigs/insert jigs/Z lowers/Z_lower_insert_jig.fcstd

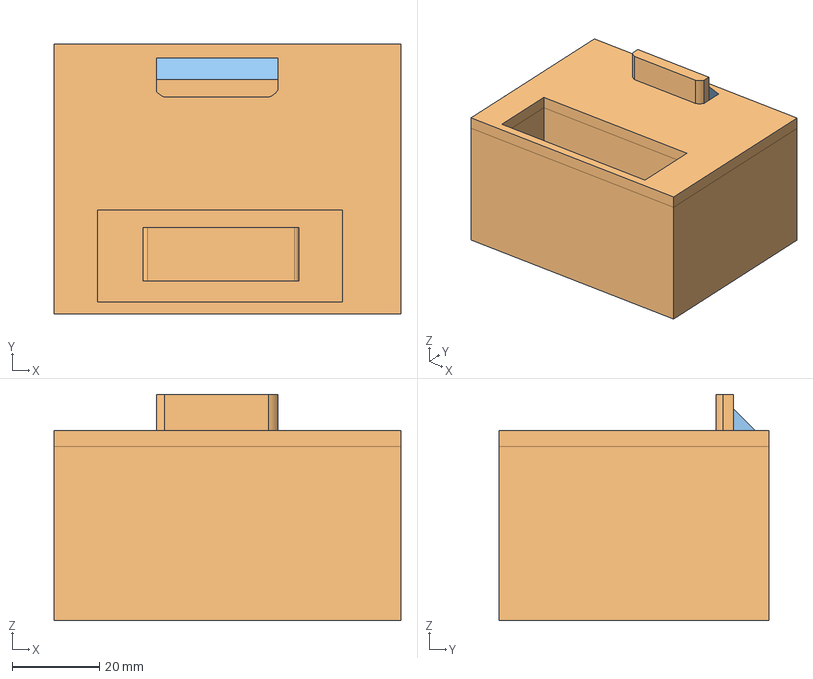
[picture p178: CAD file, 2024-03-15]
production_parts/jigs/insert jigs/Z lowers/Z_lower_insert_jig.fcstd
79.7 x 62.1 x 52.0 mm
Fillet002Body
ChamferBody
