gralco/TAZ6/production_parts/jigs/SmallHerringBone_DrillJig/Herring6shooterTOP.stl

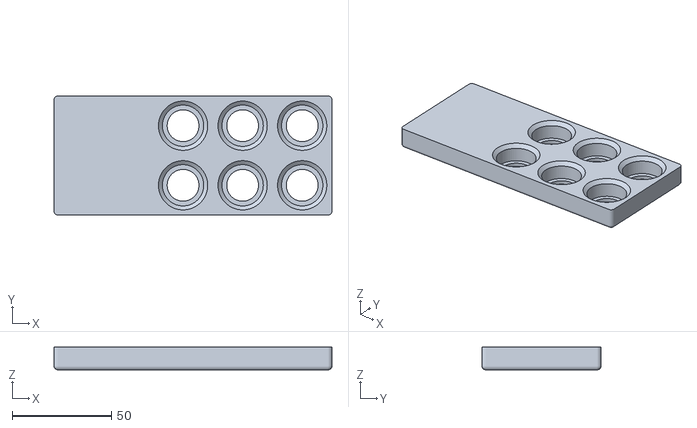
[picture p179: CAD file, 2024-03-15]
production_parts/jigs/SmallHerringBone_DrillJig/Herring6shooterTOP.stl
140.0 x 60.0 x 11.5
