gralco/TAZ6/production_parts/jigs/TAZ6_Control_Box_Tie_Down_Jig/Taz6_Control_Box_Tie_Down_Jig_v1.1.fcstd

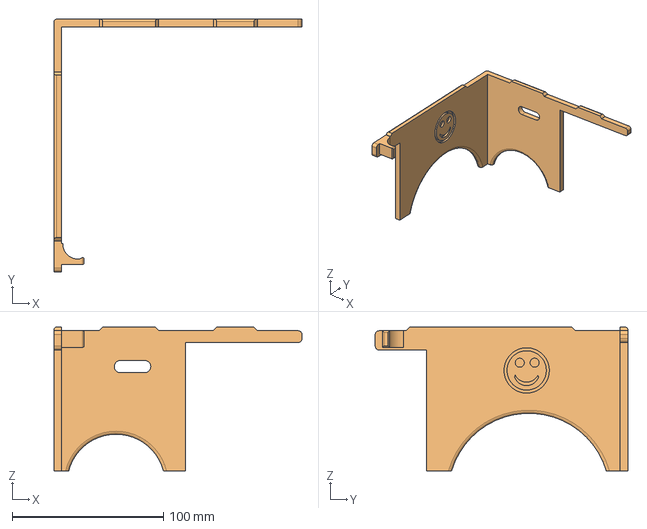
[picture p180: CAD file, 2024-03-15]
production_parts/jigs/TAZ6_Control_Box_Tie_Down_Jig/Taz6_Control_Box_Tie_Down_Jig_v1.1.fcstd
164.0 x 167.0 x 95.0 mm
