gralco/TAZ6/production_parts/jigs/TAZ6_frame_assy_fixture/2018_update/ClampHolder_milling_boxy_chamfer_flipside.fcstd

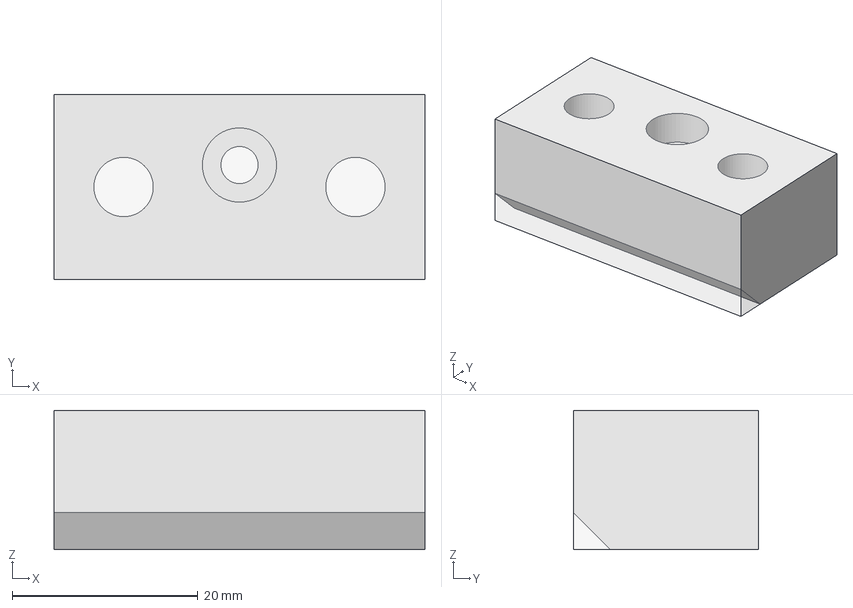
[picture p181: CAD file, 2024-03-15]
production_parts/jigs/TAZ6_frame_assy_fixture/2018_update/ClampHolder_milling_boxy_chamfer_flipside.fcstd
40.0 x 20.0 x 15.0 mm
Base-Chamfer001
Stock001
