gralco/TAZ6/production_parts/jigs/TAZ6_frame_assy_fixture/540mm_extrusion.fcstd

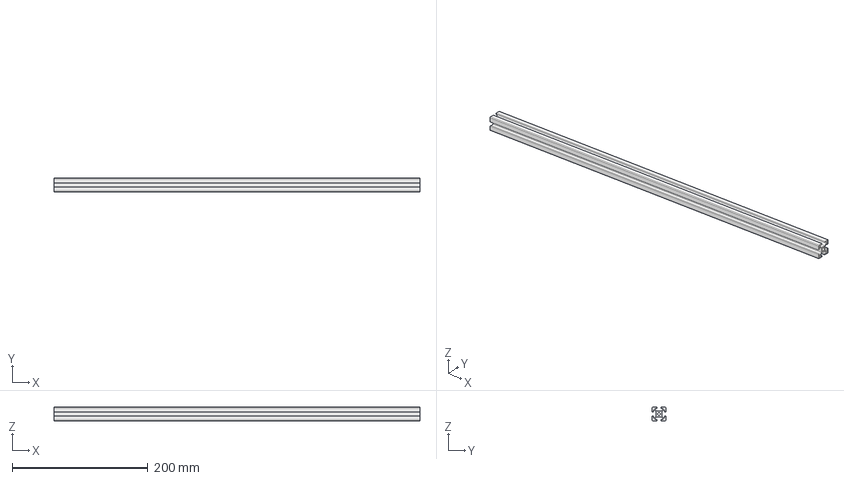
[picture p182: CAD file, 2024-03-15]
production_parts/jigs/TAZ6_frame_assy_fixture/540mm_extrusion.fcstd
540.0 x 20.0 x 20.0 mm
