gralco/TAZ6/production_parts/jigs/TAZ_drive_rod_run_out_fixture/slider_mount.fcstd

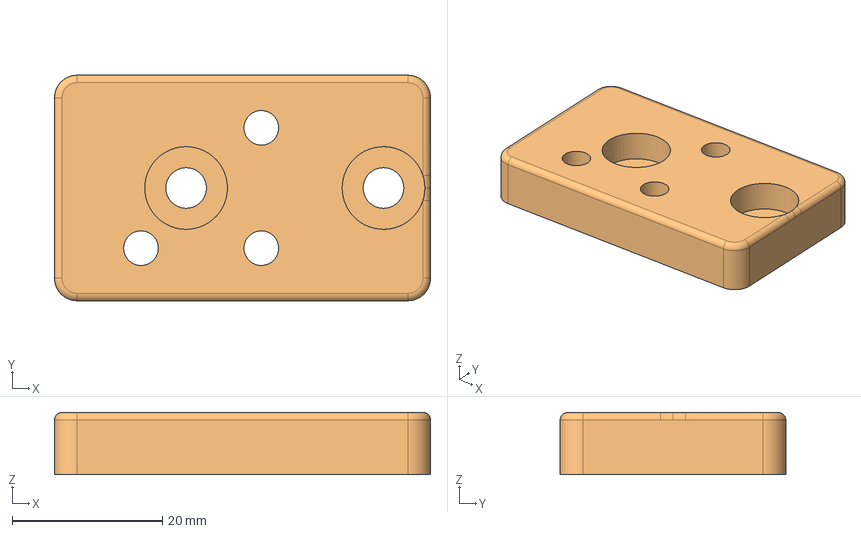
[picture p183: CAD file, 2024-03-15]
production_parts/jigs/TAZ_drive_rod_run_out_fixture/slider_mount.fcstd
50.0 x 30.0 x 8.25 mm
