gralco/TAZ6/production_parts/machined_parts/0.5mm_hotend_assembly_single_v2/V6 Nozzle.stp

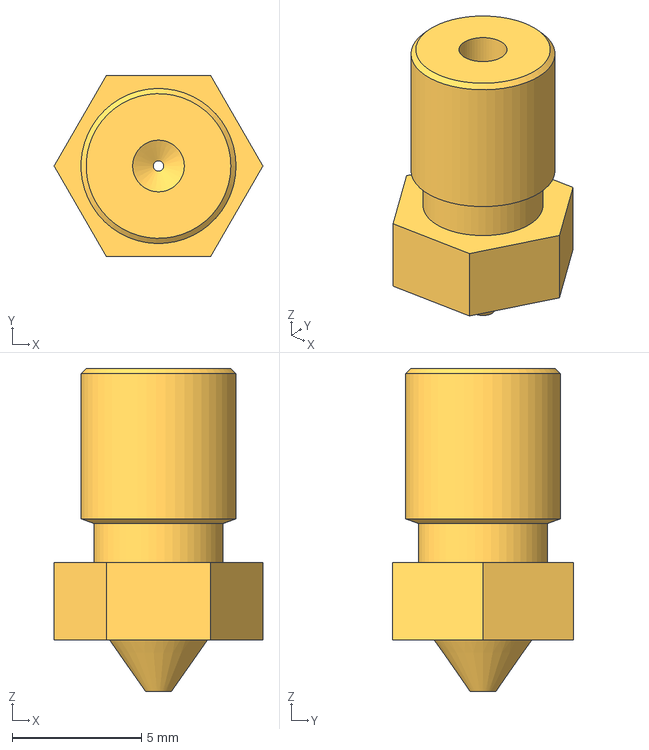
[picture p184: CAD file, 2024-03-15]
production_parts/machined_parts/0.5mm_hotend_assembly_single_v2/V6 Nozzle.stp
8.08 x 7.00 x 12.5 mm
