gralco/TAZ6/production_parts/machined_parts/10_12_mm_smooth_rods/12mmx515_rod_v1.0_revA.step

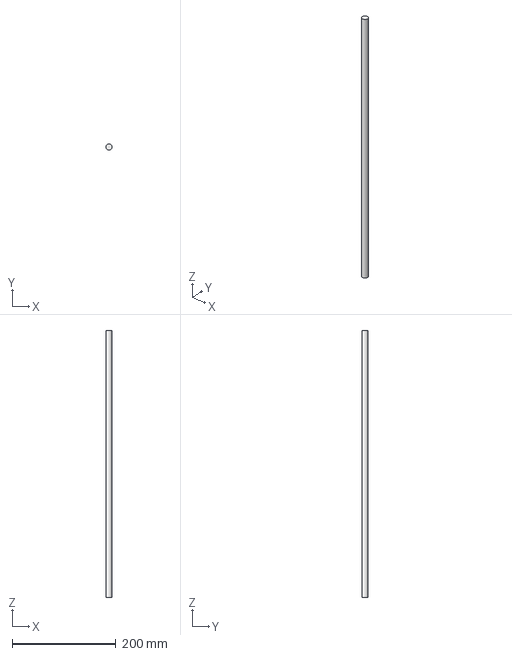
[picture p185: CAD file, 2024-03-15]
production_parts/machined_parts/10_12_mm_smooth_rods/12mmx515_rod_v1.0_revA.step
12.0 x 12.0 x 515.0 mm
