gralco/TAZ6/production_parts/machined_parts/bed_plate_v5.0/300mm_bed_plate_6061_PP-FP0146_revA.step

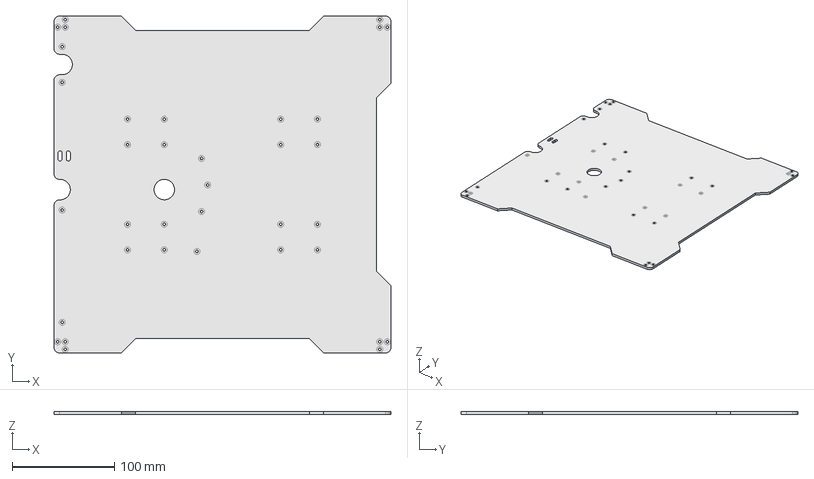
[picture p186: CAD file, 2024-03-15]
production_parts/machined_parts/bed_plate_v5.0/300mm_bed_plate_6061_PP-FP0146_revA.step
330.0 x 330.0 x 3.17 mm
