gralco/TAZ6/production_parts/machined_parts/corner_bracket_v2.0/corner_bracket_PP-MP0106_revC.step

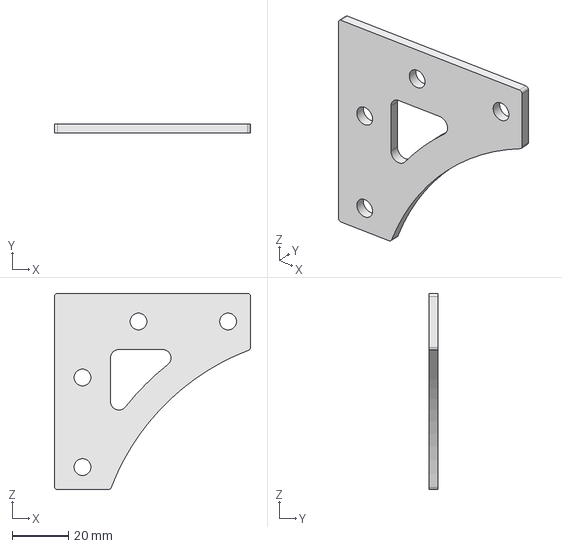
[picture p187: CAD file, 2024-03-15]
production_parts/machined_parts/corner_bracket_v2.0/corner_bracket_PP-MP0106_revC.step
70.0 x 3.18 x 70.0 mm
