gralco/TAZ6/production_parts/machined_parts/drive_rod_12mm/drive_rod_12mm_HD-RD0048_revA.step

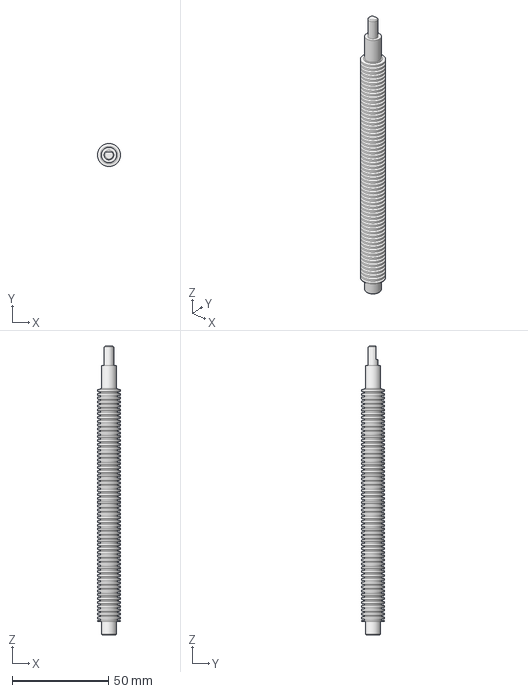
[picture p188: CAD file, 2024-03-15]
production_parts/machined_parts/drive_rod_12mm/drive_rod_12mm_HD-RD0048_revA.step
12.0 x 12.0 x 150.0 mm
