gralco/TAZ6/production_parts/machined_parts/electronics_chassis/electronics_chassis_PP-FP0142_RevA.step

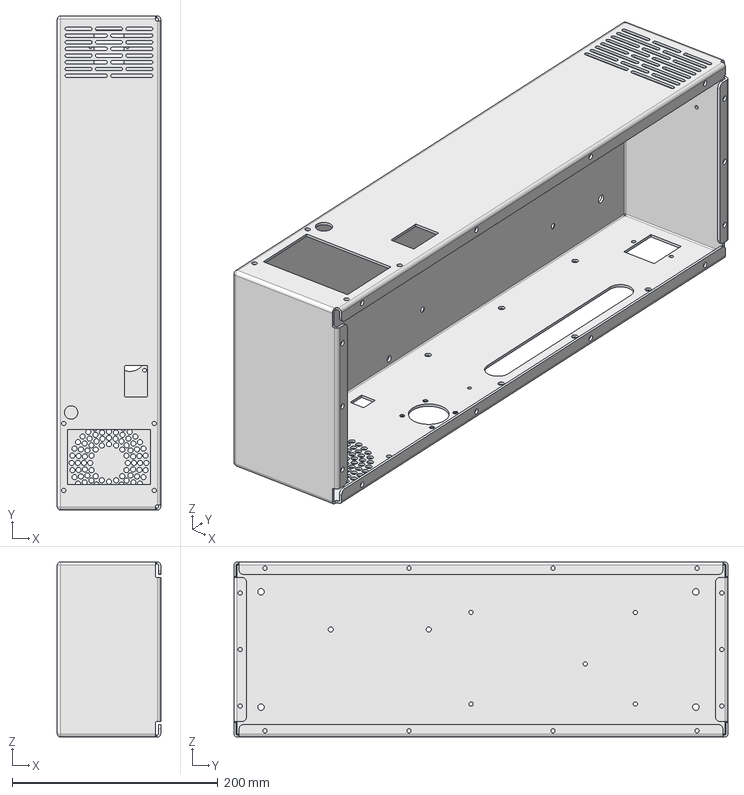
[picture p189: CAD file, 2024-03-15]
production_parts/machined_parts/electronics_chassis/electronics_chassis_PP-FP0142_RevA.step
100.6 x 480.0 x 170.0 mm
