gralco/TAZ6/production_parts/machined_parts/electronics_cover/electronics_cover_PP-FP0143_RevB.step

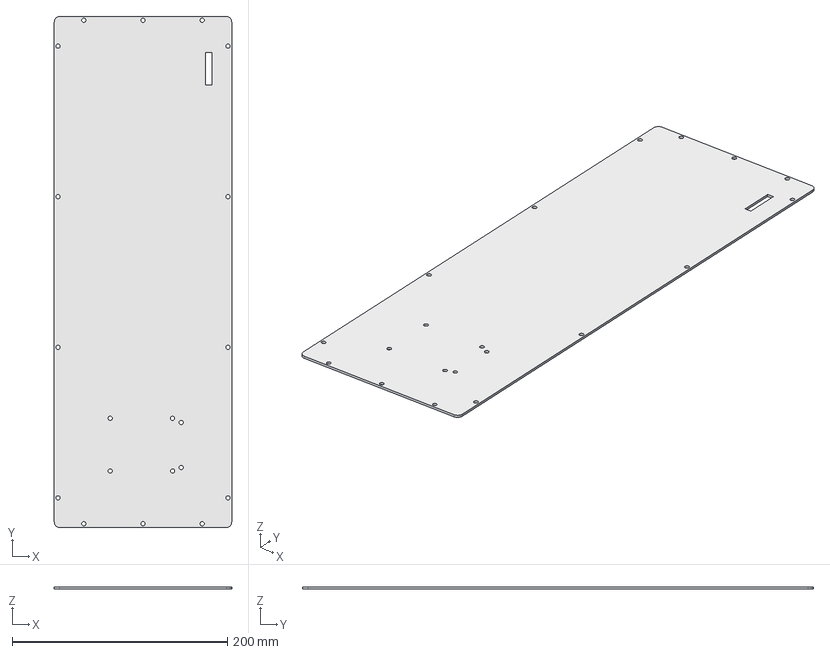
[picture p190: CAD file, 2024-03-15]
production_parts/machined_parts/electronics_cover/electronics_cover_PP-FP0143_RevB.step
165.0 x 475.0 x 2.03 mm
