gralco/TAZ6/production_parts/machined_parts/interconnect_cover_v0.5/interconnect_cover_PP-FP0144.step

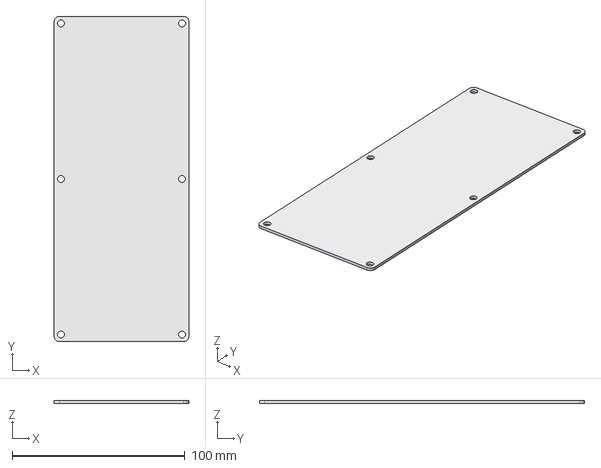
[picture p192: CAD file, 2024-03-15]
production_parts/machined_parts/interconnect_cover_v0.5/interconnect_cover_PP-FP0144.step
78.0 x 188.0 x 1.59 mm
