gralco/TAZ6/production_parts/machined_parts/lulzbot_edition_hexagon_hotend-0.5mm/cooling block 3mm short .DXF

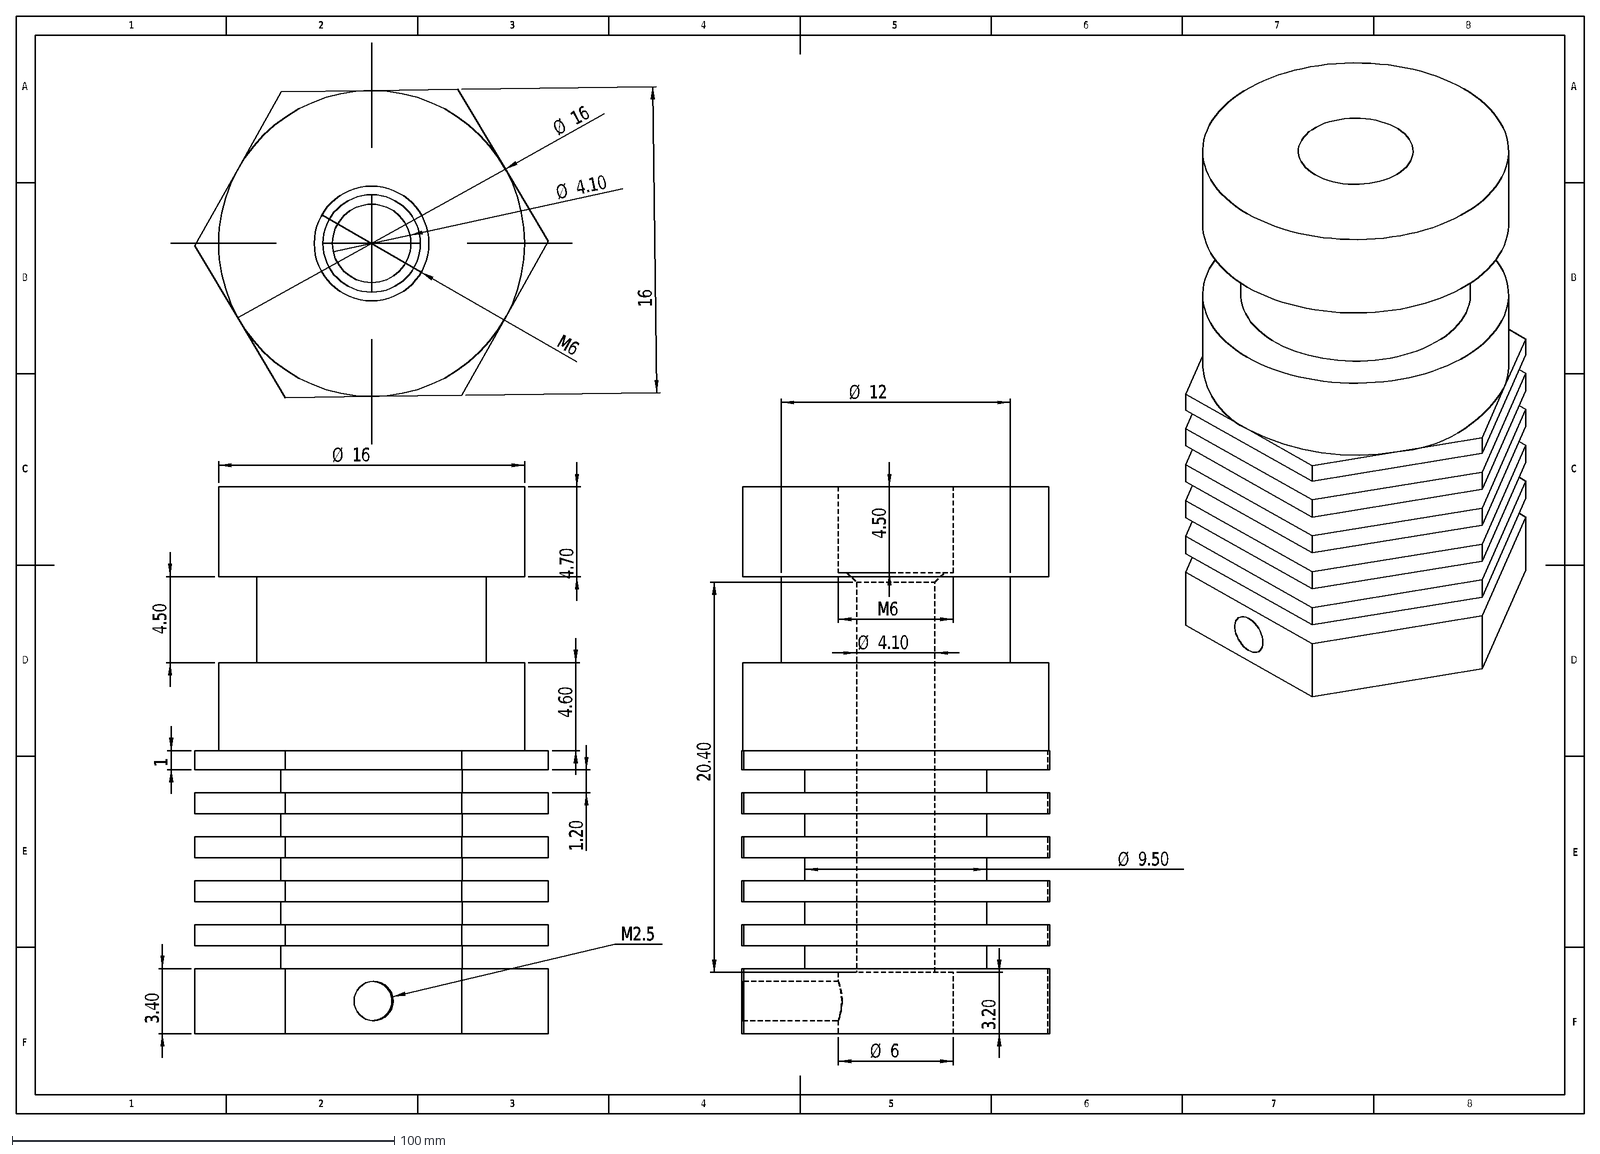
[picture p193: CAD file, 2024-03-15]
production_parts/machined_parts/lulzbot_edition_hexagon_hotend-0.5mm/cooling block 3mm short .DXF
D
E
F
C
1
2
3
4
B
A
5
6
7
8
4.70
4.60
4.50
Ø
16
1.20
3.40
M2.5
4.10
M6
3.20
20.40
12
9.50
