gralco/TAZ6/production_parts/machined_parts/plastic_laser_cut_lcd/plastic_laser_cut_lcd_cover.step

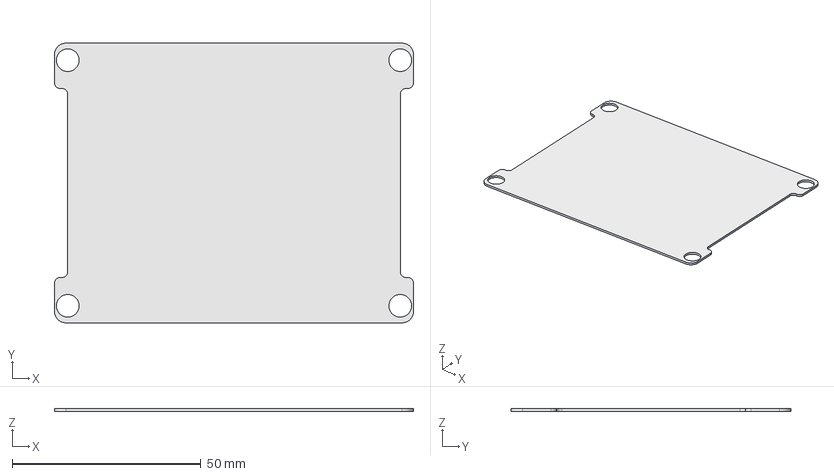
[picture p194: CAD file, 2024-03-15]
production_parts/machined_parts/plastic_laser_cut_lcd/plastic_laser_cut_lcd_cover.step
95.0 x 74.0 x 0.76 mm
