gralco/TAZ6/production_parts/machined_parts/y_end_plate_v0.2/y_end_plate_v0.2_revE.step

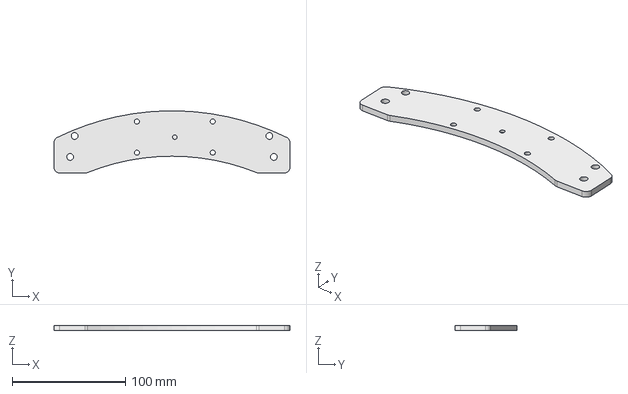
[picture p195: CAD file, 2024-03-15]
production_parts/machined_parts/y_end_plate_v0.2/y_end_plate_v0.2_revE.step
208.5 x 54.9 x 4.76 mm
