gralco/TAZ6/production_parts/printed_parts/12mm_double_bearing_holder/12mm_double_bearing_holder_v0.7.fcstd

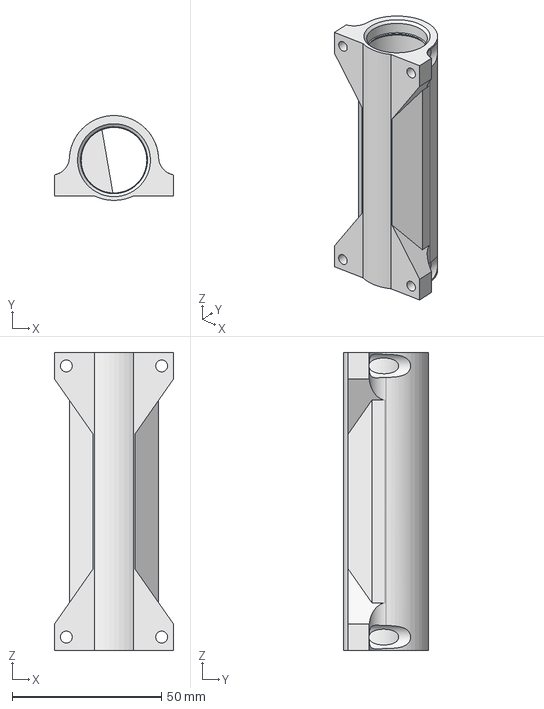
[picture p196: CAD file, 2024-03-15]
production_parts/printed_parts/12mm_double_bearing_holder/12mm_double_bearing_holder_v0.7.fcstd
40.0 x 28.5 x 100.0 mm
