gralco/TAZ6/production_parts/printed_parts/12mm_single_bearing_holder/12mm_single_bearing_holder_v0.4.FCStd

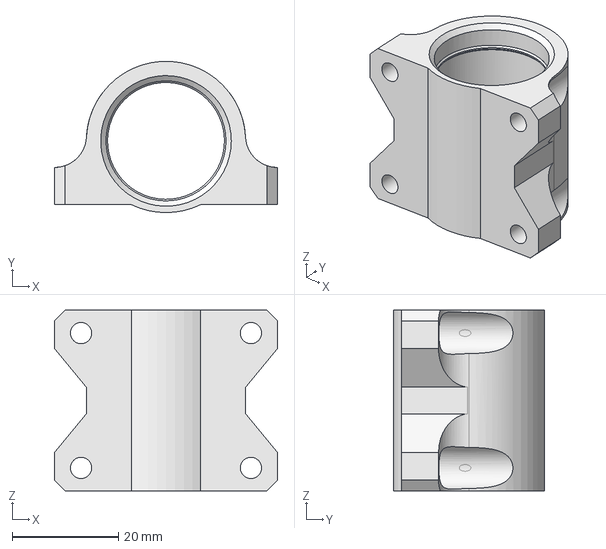
[picture p197: CAD file, 2024-03-15]
production_parts/printed_parts/12mm_single_bearing_holder/12mm_single_bearing_holder_v0.4.FCStd
42.0 x 28.5 x 34.0 mm
