gralco/TAZ6/production_parts/printed_parts/bearing_holder/bearing_holder_v1.0.fcstd

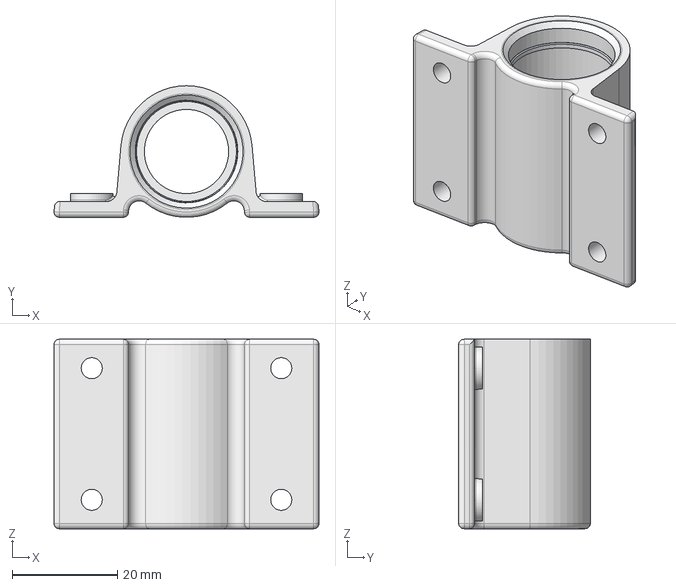
[picture p198: CAD file, 2024-03-15]
production_parts/printed_parts/bearing_holder/bearing_holder_v1.0.fcstd
50.3 x 25.0 x 36.0 mm
