gralco/TAZ6/production_parts/printed_parts/bed_corner_taz6/bed_corner_taz6_v2.fcstd

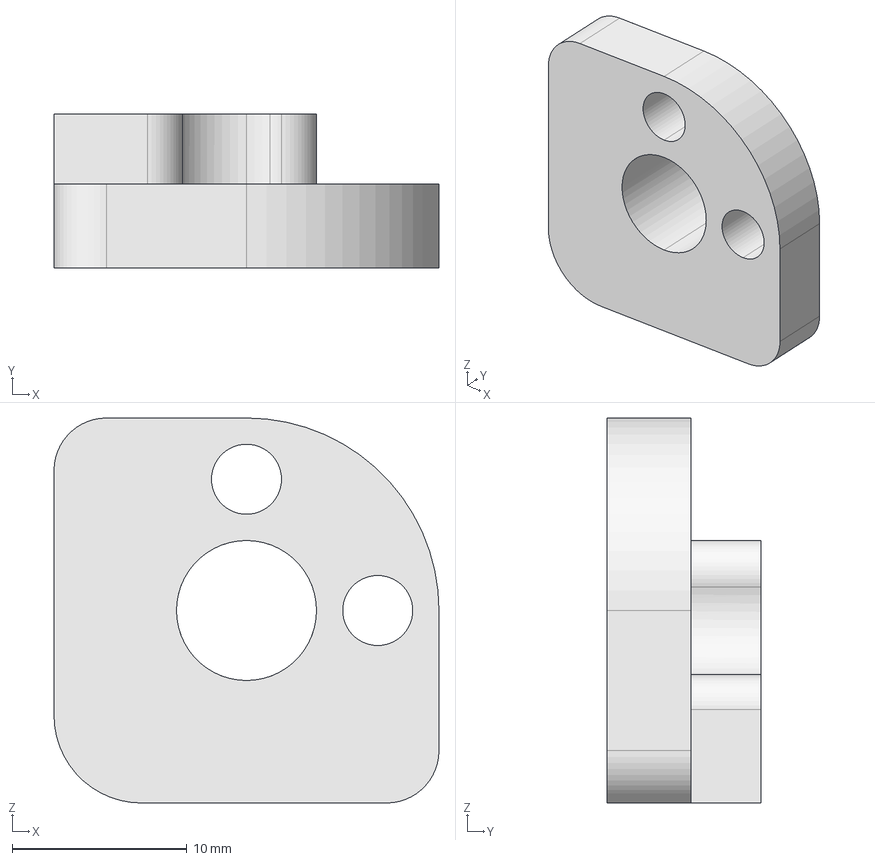
[picture p199: CAD file, 2024-03-15]
production_parts/printed_parts/bed_corner_taz6/bed_corner_taz6_v2.fcstd
22.0 x 8.82 x 22.0 mm
