gralco/TAZ6/production_parts/printed_parts/bed_mount_chassis/bed_mount_chassis_v3.3_A.FCStd

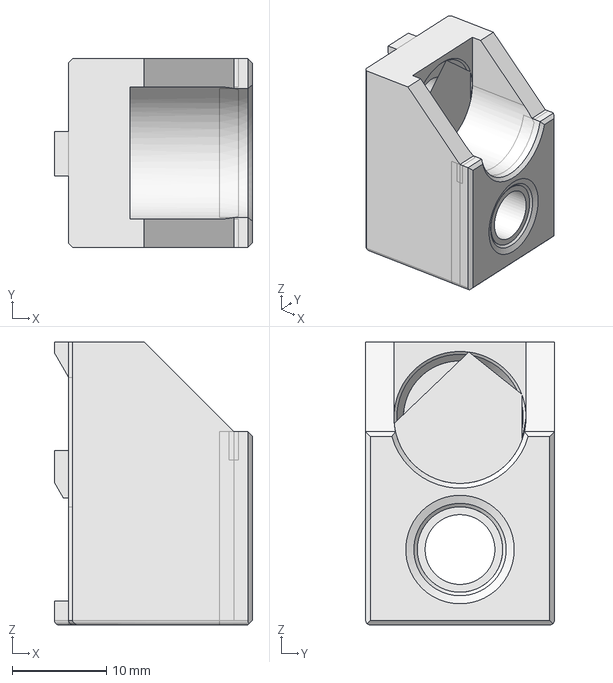
[picture p200: CAD file, 2024-03-15]
production_parts/printed_parts/bed_mount_chassis/bed_mount_chassis_v3.3_A.FCStd
21.0 x 20.0 x 30.0 mm
