gralco/TAZ6/production_parts/printed_parts/bed_mount_table/bed_mount_table_v3.1.fcstd

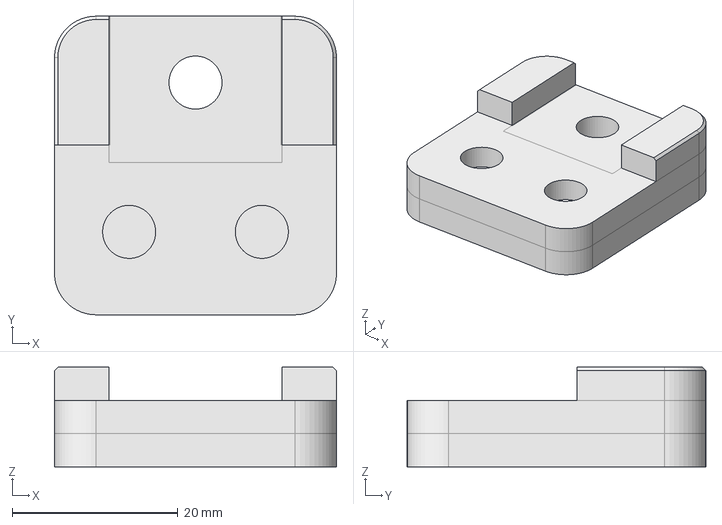
[picture p201: CAD file, 2024-03-15]
production_parts/printed_parts/bed_mount_table/bed_mount_table_v3.1.fcstd
34.0 x 36.0 x 12.0 mm
