gralco/TAZ6/production_parts/printed_parts/electronics_case_mount/electronics_case_mount_v2.0-x9.stl

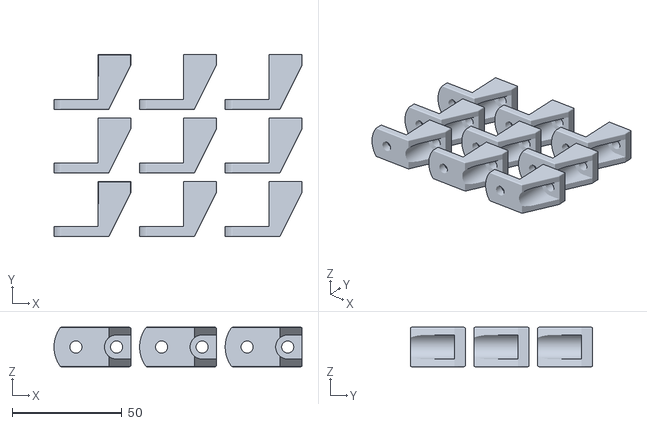
[picture p202: CAD file, 2024-03-15]
production_parts/printed_parts/electronics_case_mount/electronics_case_mount_v2.0-x9.stl
113.0 x 83.0 x 18.0
