gralco/TAZ6/production_parts/printed_parts/extruder_body_hex/extruder_body_hex_v1.4.1.stl

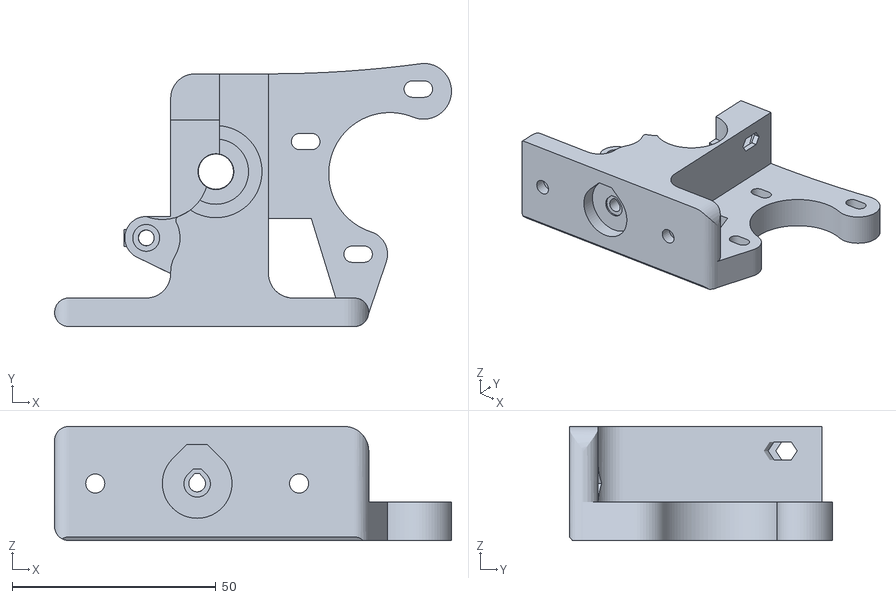
[picture p203: CAD file, 2024-03-15]
production_parts/printed_parts/extruder_body_hex/extruder_body_hex_v1.4.1.stl
97.4 x 64.5 x 28.0
