gralco/TAZ6/production_parts/printed_parts/extruder_latch/extruder_latch_v2.1.fcstd

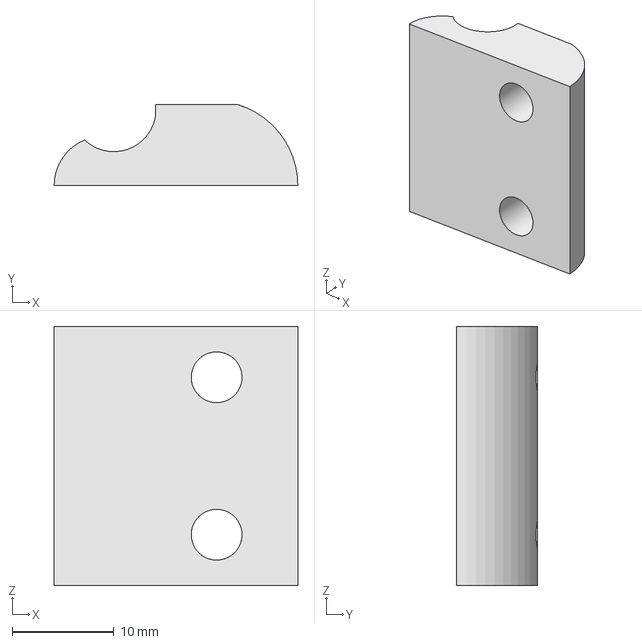
[picture p205: CAD file, 2024-03-15]
production_parts/printed_parts/extruder_latch/extruder_latch_v2.1.fcstd
24.0 x 8.00 x 25.5 mm
