gralco/TAZ6/production_parts/printed_parts/extruder_mount_taz6/extruder_mount_taz6_v0.8.stl

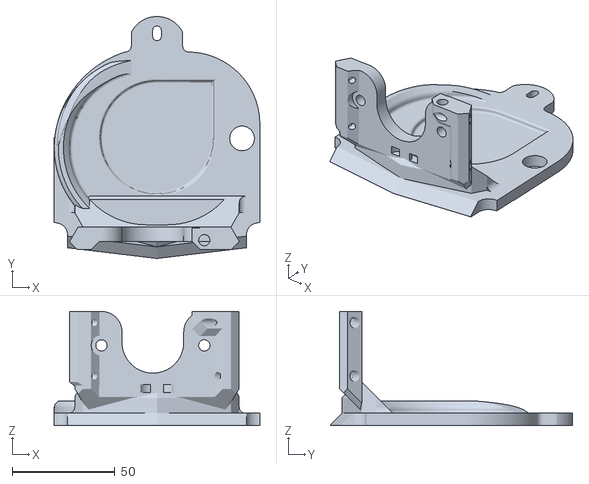
[picture p206: CAD file, 2024-03-15]
production_parts/printed_parts/extruder_mount_taz6/extruder_mount_taz6_v0.8.stl
100.0 x 117.7 x 55.5
