gralco/TAZ6/production_parts/printed_parts/fan_duct_left/fan_duct_left_v0.7.4.1d.stl

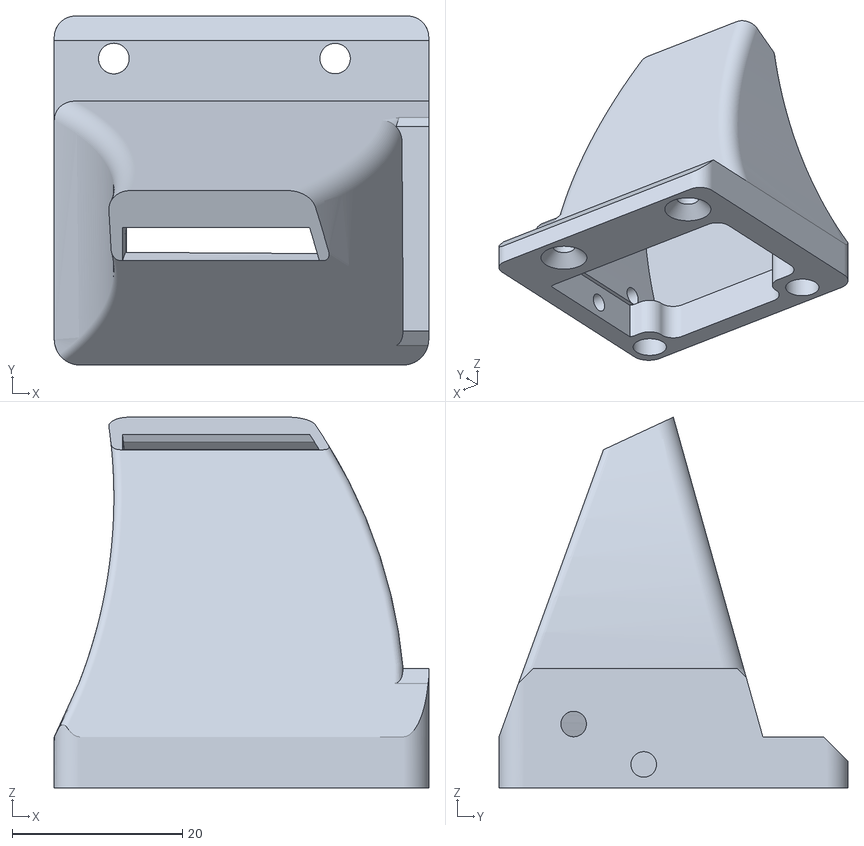
[picture p207: CAD file, 2024-03-15]
production_parts/printed_parts/fan_duct_left/fan_duct_left_v0.7.4.1d.stl
44.0 x 41.0 x 43.6
