gralco/TAZ6/production_parts/printed_parts/feed_tube_spinner/feed_tube_spinner_v3.0-x6.stl

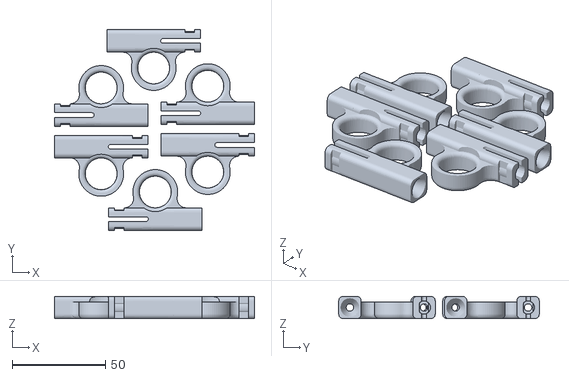
[picture p208: CAD file, 2024-03-15]
production_parts/printed_parts/feed_tube_spinner/feed_tube_spinner_v3.0-x6.stl
107.1 x 107.4 x 12.0
