gralco/TAZ6/production_parts/printed_parts/flexy_bed_foot/flexy_bed_foot_v0.1.fcstd

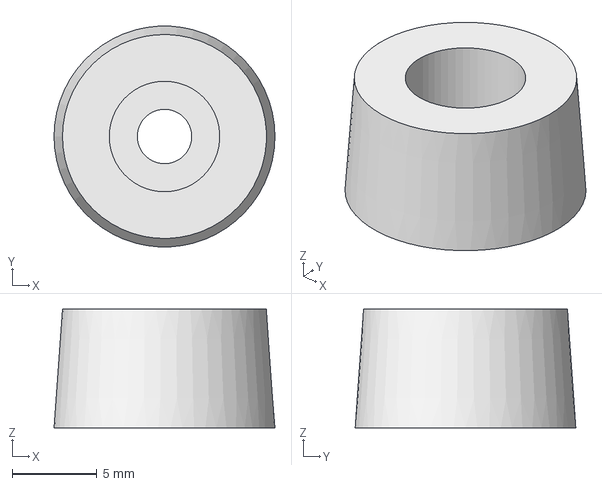
[picture p209: CAD file, 2024-03-15]
production_parts/printed_parts/flexy_bed_foot/flexy_bed_foot_v0.1.fcstd
13.0 x 13.0 x 7.00 mm
