gralco/TAZ6/production_parts/printed_parts/heatsink_fan/heatsink_fan_duct_v0.6.stl

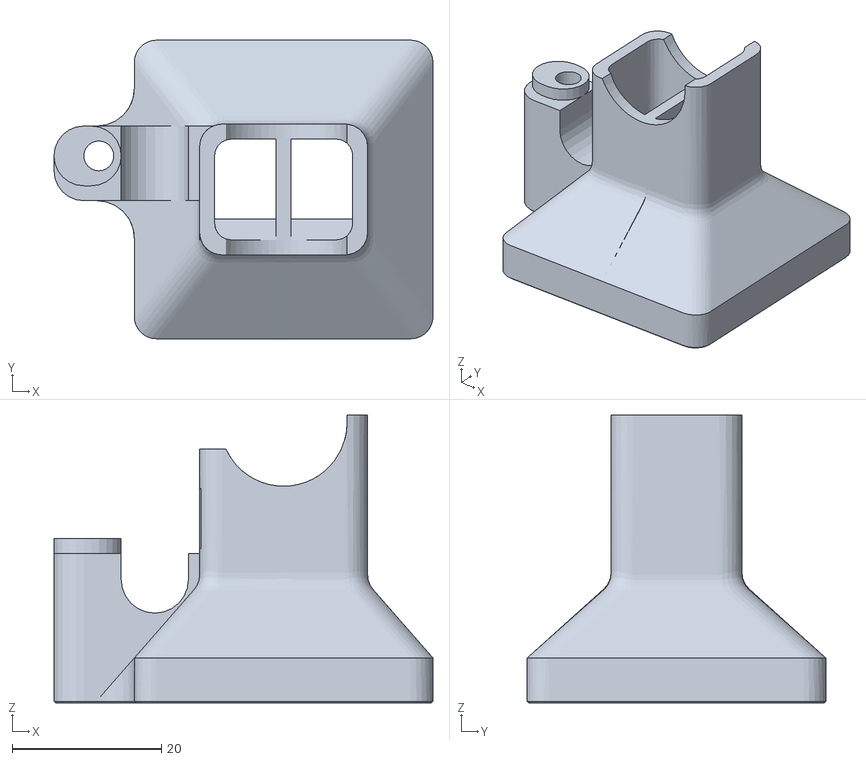
[picture p210: CAD file, 2024-03-15]
production_parts/printed_parts/heatsink_fan/heatsink_fan_duct_v0.6.stl
50.8 x 40.0 x 38.5
