gralco/TAZ6/production_parts/printed_parts/herringbone_large_gear_blk/herringbone_large_gear_v1.3.stl

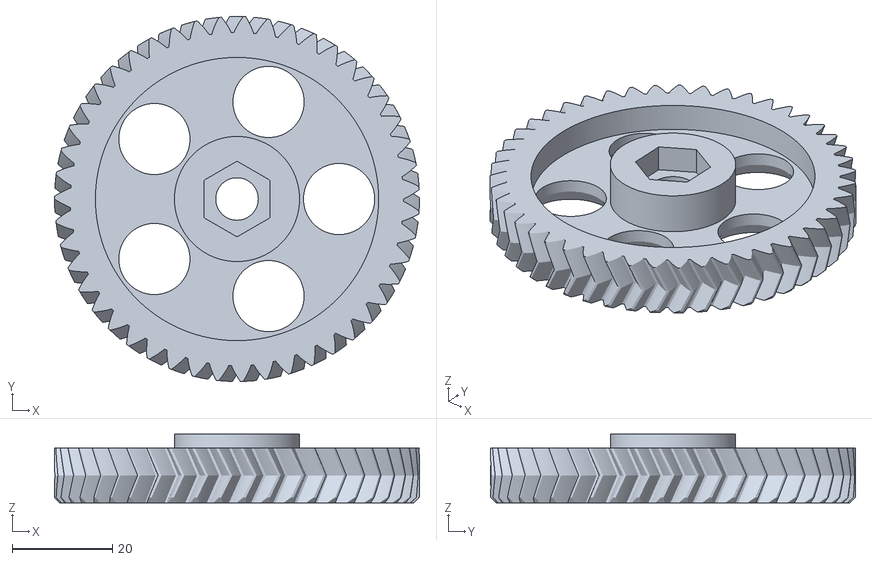
[picture p211: CAD file, 2024-03-15]
production_parts/printed_parts/herringbone_large_gear_blk/herringbone_large_gear_v1.3.stl
73.0 x 73.0 x 13.8
