gralco/TAZ6/production_parts/printed_parts/herringbone_small_gear_blk/herringbone_small_gear-1.1-highres-x3.stl

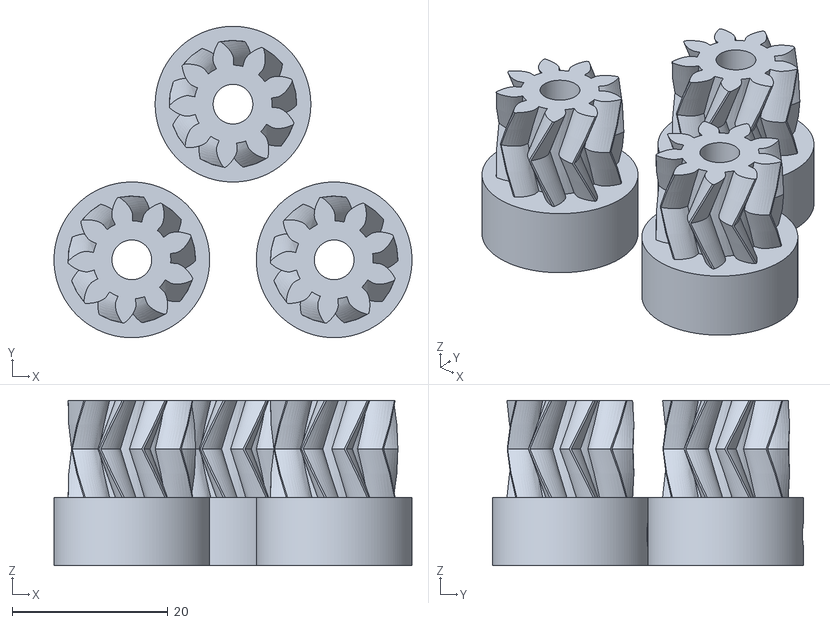
[picture p212: CAD file, 2024-03-15]
production_parts/printed_parts/herringbone_small_gear_blk/herringbone_small_gear-1.1-highres-x3.stl
46.0 x 40.0 x 21.2
