gralco/TAZ6/production_parts/printed_parts/herringbone_small_gear_blk/source/herringbone_small_gear.stl

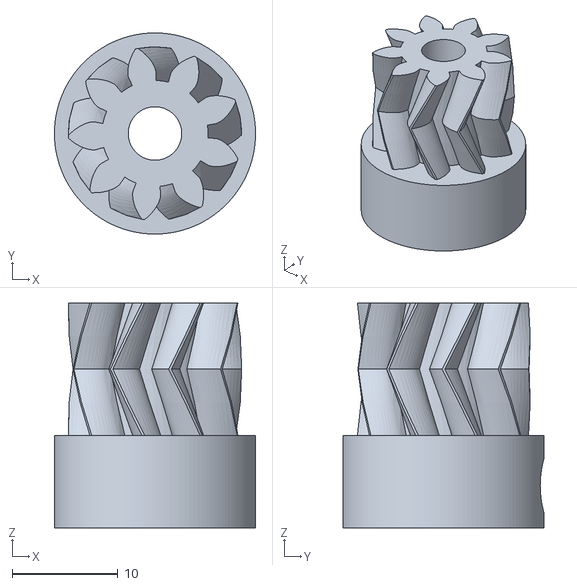
[picture p213: CAD file, 2024-03-15]
production_parts/printed_parts/herringbone_small_gear_blk/source/herringbone_small_gear.stl
19.0 x 19.0 x 21.2
