gralco/TAZ6/production_parts/printed_parts/herringbone_small_gear_grn/herringbone_small_gear-1.1-highres.stl

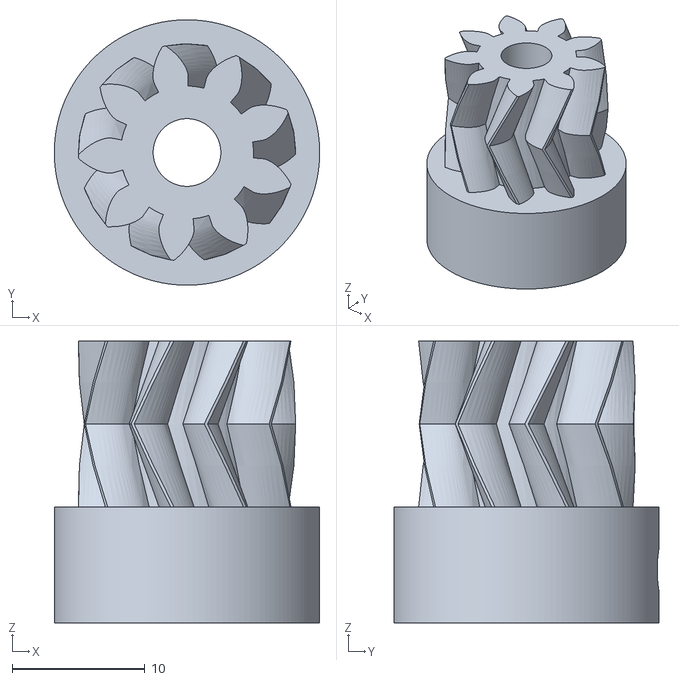
[picture p214: CAD file, 2024-03-15]
production_parts/printed_parts/herringbone_small_gear_grn/herringbone_small_gear-1.1-highres.stl
20.0 x 20.0 x 21.2
