gralco/TAZ6/production_parts/printed_parts/interconnect_housing/interconnect_housing_0.6.FCStd

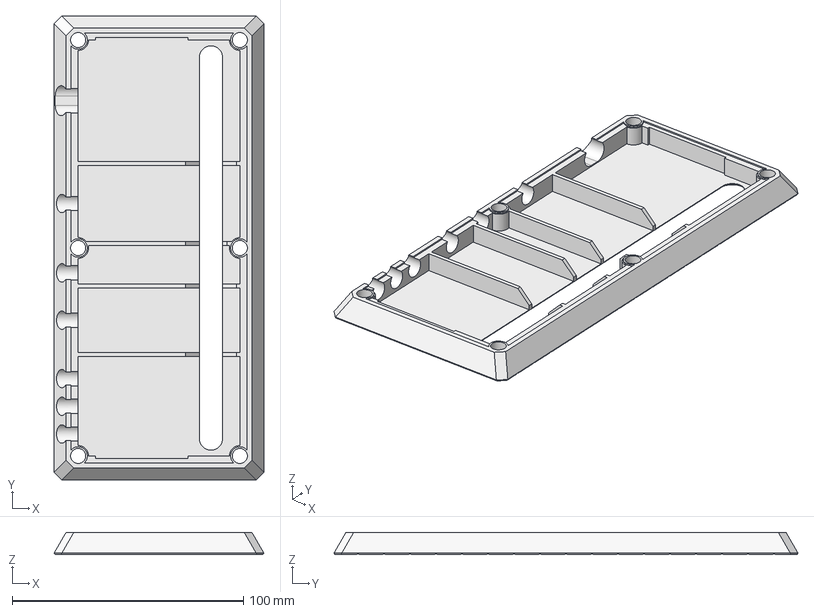
[picture p215: CAD file, 2024-03-15]
production_parts/printed_parts/interconnect_housing/interconnect_housing_0.6.FCStd
90.8 x 200.8 x 9.60 mm
