gralco/TAZ6/production_parts/printed_parts/lcd_bezel/lcd_bezel_v1.1.fcstd

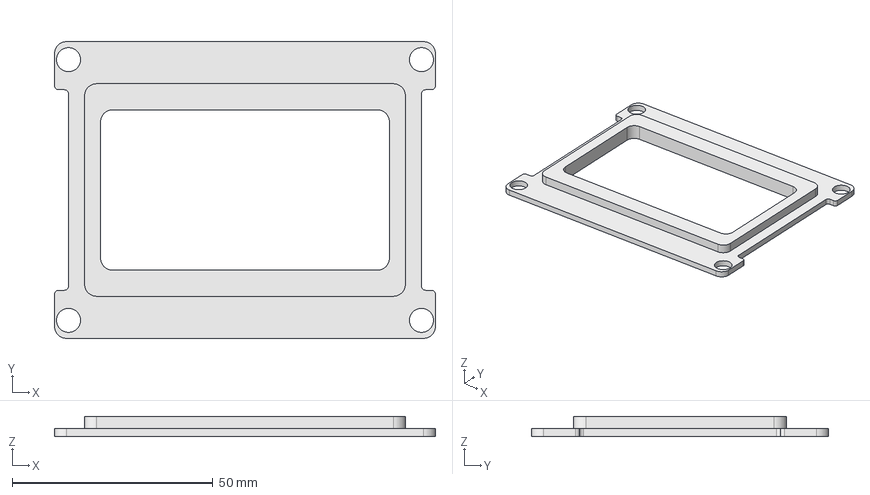
[picture p216: CAD file, 2024-03-15]
production_parts/printed_parts/lcd_bezel/lcd_bezel_v1.1.fcstd
95.0 x 74.0 x 5.00 mm
