gralco/TAZ6/production_parts/printed_parts/lcd_knob/lcd_knob_0.2_design_dent_2.stl

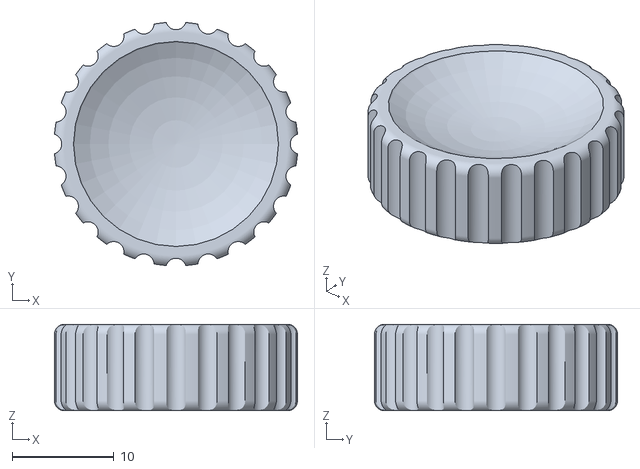
[picture p217: CAD file, 2024-03-15]
production_parts/printed_parts/lcd_knob/lcd_knob_0.2_design_dent_2.stl
23.9 x 23.9 x 8.50
