gralco/TAZ6/production_parts/printed_parts/lcd_spacer/lcd_spacer_v0.4-x200.stl

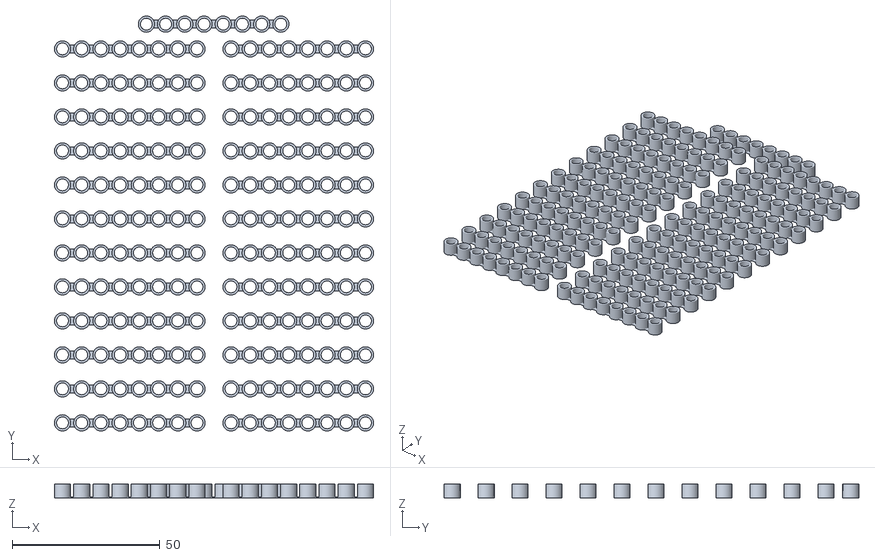
[picture p218: CAD file, 2024-03-15]
production_parts/printed_parts/lcd_spacer/lcd_spacer_v0.4-x200.stl
108.0 x 140.4 x 4.75
