gralco/TAZ6/production_parts/printed_parts/sd_card_bezel/sd_card_bezel_v0.8.fcstd

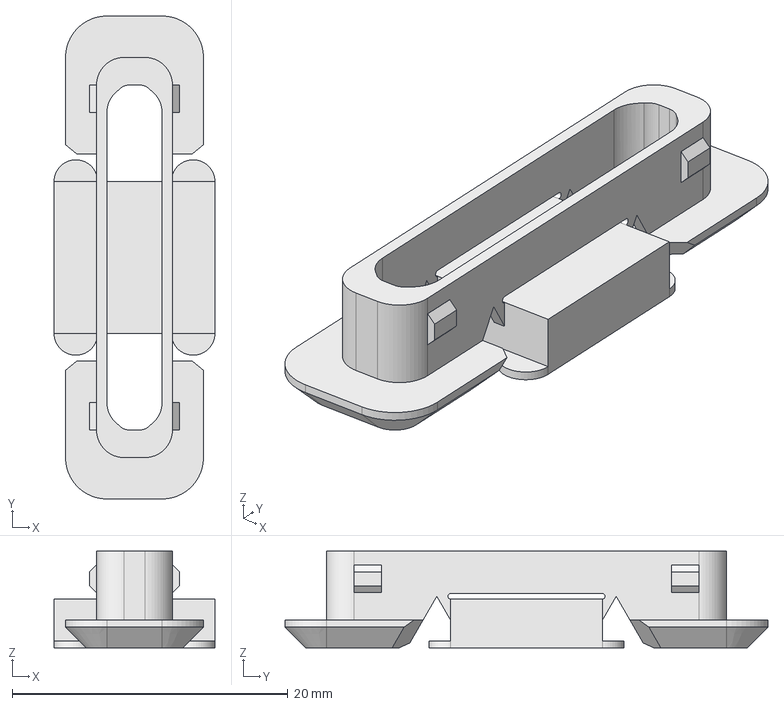
[picture p219: CAD file, 2024-03-15]
production_parts/printed_parts/sd_card_bezel/sd_card_bezel_v0.8.fcstd
11.7 x 35.0 x 7.00 mm
