gralco/TAZ6/production_parts/printed_parts/spool_arm/spool_arm_v0.2.FCStd

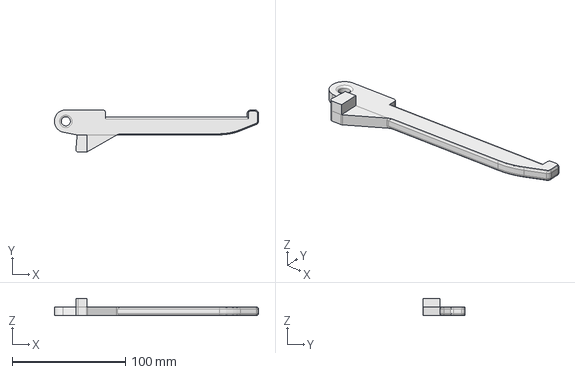
[picture p220: CAD file, 2024-03-15]
production_parts/printed_parts/spool_arm/spool_arm_v0.2.FCStd
180.0 x 37.0 x 15.0 mm
