gralco/TAZ6/production_parts/printed_parts/tippy_feed_tube_holder/tippy_feed_tube_holder_v0.6-x4.stl

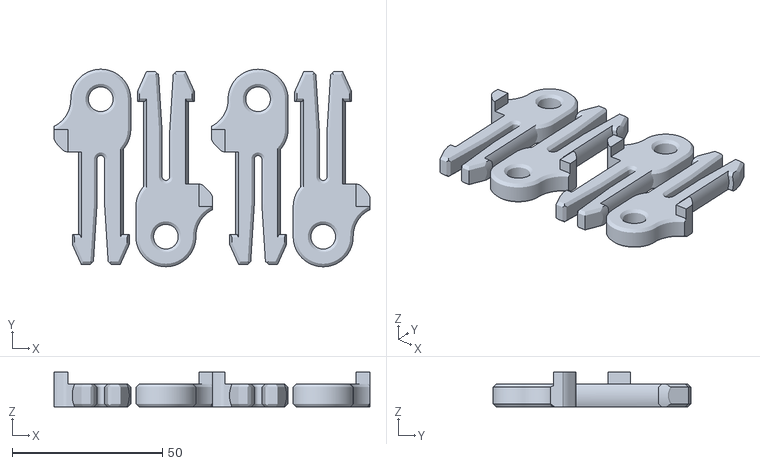
[picture p221: CAD file, 2024-03-15]
production_parts/printed_parts/tippy_feed_tube_holder/tippy_feed_tube_holder_v0.6-x4.stl
105.2 x 65.8 x 11.5
