gralco/TAZ6/production_parts/printed_parts/wiper_mount/wiper_mount_v1.1-x3.stl

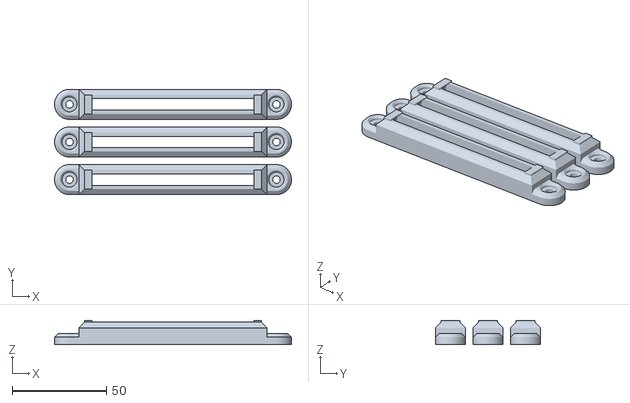
[picture p222: CAD file, 2024-03-15]
production_parts/printed_parts/wiper_mount/wiper_mount_v1.1-x3.stl
126.0 x 56.0 x 13.0
