gralco/TAZ6/production_parts/printed_parts/x_carriage/x_carriage_taz6_v0.3.FCStd

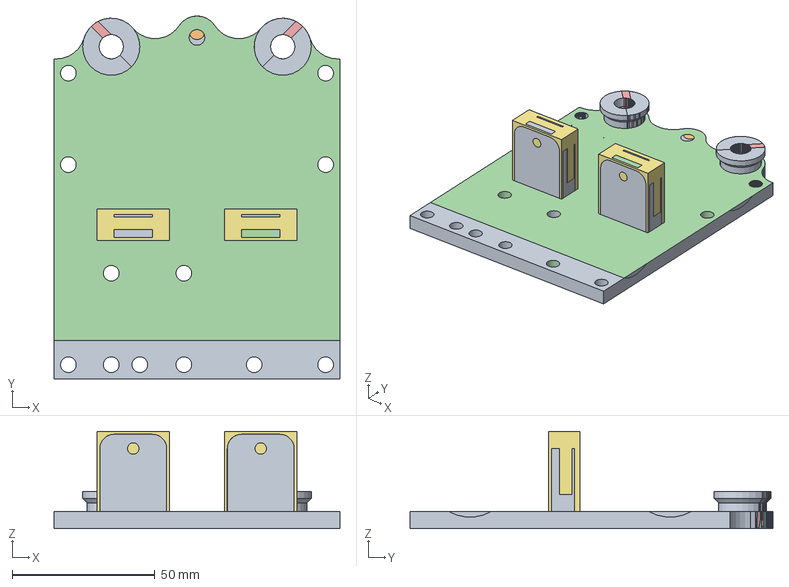
[picture p223: CAD file, 2024-03-15]
production_parts/printed_parts/x_carriage/x_carriage_taz6_v0.3.FCStd
100.0 x 127.0 x 34.0 mm
