gralco/TAZ6/production_parts/printed_parts/x_carriage_guide/x_carriage_guide_v2.fcstd

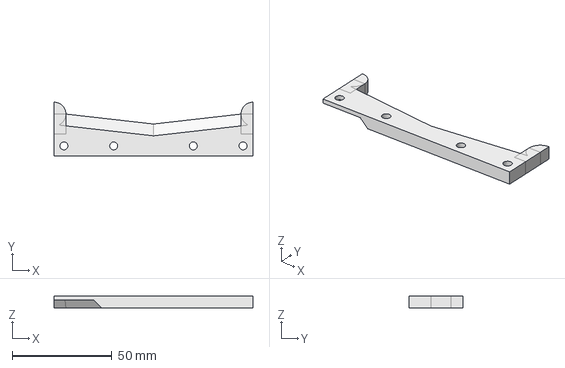
[picture p224: CAD file, 2024-03-15]
production_parts/printed_parts/x_carriage_guide/x_carriage_guide_v2.fcstd
100.0 x 27.0 x 6.00 mm
