gralco/TAZ6/production_parts/printed_parts/y_belt_clamp/Y_belt_clamp.fcstd

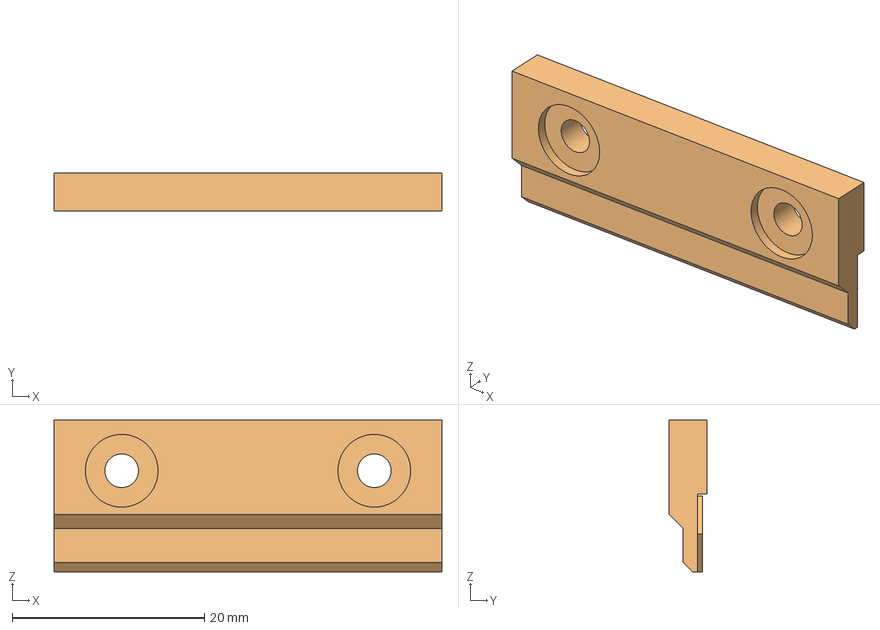
[picture p225: CAD file, 2024-03-15]
production_parts/printed_parts/y_belt_clamp/Y_belt_clamp.fcstd
40.4 x 4.00 x 15.8 mm
