gralco/TAZ6/production_parts/printed_parts/y_belt_mount/y_belt_mount_v2.2.fcstd

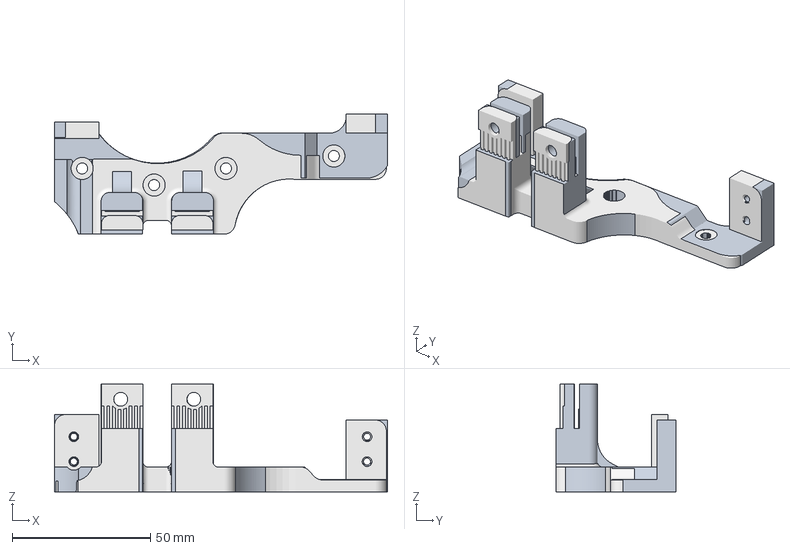
[picture p226: CAD file, 2024-03-15]
production_parts/printed_parts/y_belt_mount/y_belt_mount_v2.2.fcstd
120.4 x 43.5 x 39.0 mm
y_belt_mount_v2
