gralco/TAZ6/production_parts/printed_parts/y_corner_left/y_corner_left_v2.4-x2.stl

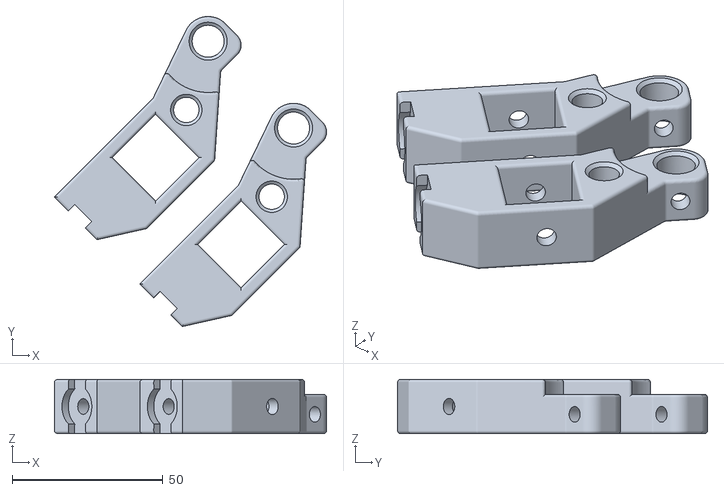
[picture p227: CAD file, 2024-03-15]
production_parts/printed_parts/y_corner_left/y_corner_left_v2.4-x2.stl
90.3 x 102.9 x 18.0
