gralco/TAZ6/production_parts/printed_parts/y_corner_right/y_corner_v2.4.fcstd

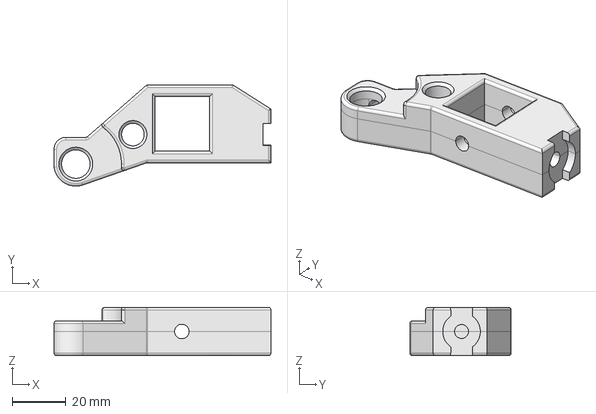
[picture p228: CAD file, 2024-03-15]
production_parts/printed_parts/y_corner_right/y_corner_v2.4.fcstd
80.8 x 37.7 x 18.0 mm
