gralco/TAZ6/production_parts/printed_parts/y_idler_mount/y_idler_mount_v4.0.FCStd

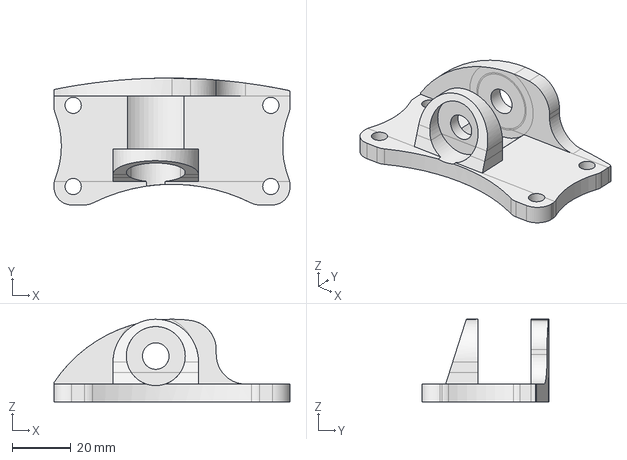
[picture p229: CAD file, 2024-03-15]
production_parts/printed_parts/y_idler_mount/y_idler_mount_v4.0.FCStd
80.0 x 43.0 x 28.0 mm
