gralco/TAZ6/production_parts/printed_parts/y_motor_mount/y_motor_mount_v3.0.FCStd

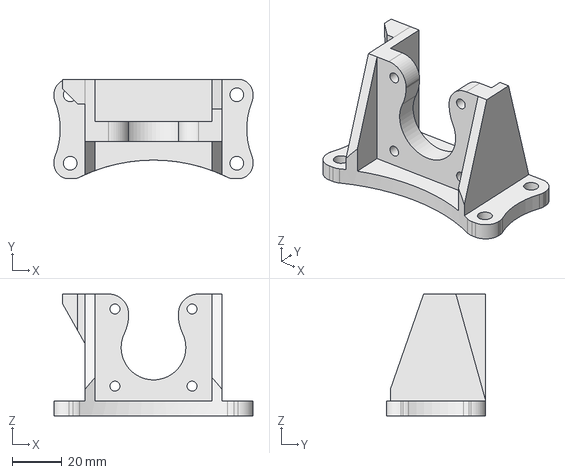
[picture p230: CAD file, 2024-03-15]
production_parts/printed_parts/y_motor_mount/y_motor_mount_v3.0.FCStd
80.0 x 40.0 x 49.0 mm
