gralco/TAZ6/production_parts/printed_parts/z-min_switch_mount/z-min_switch_mount_v4.1.fcstd

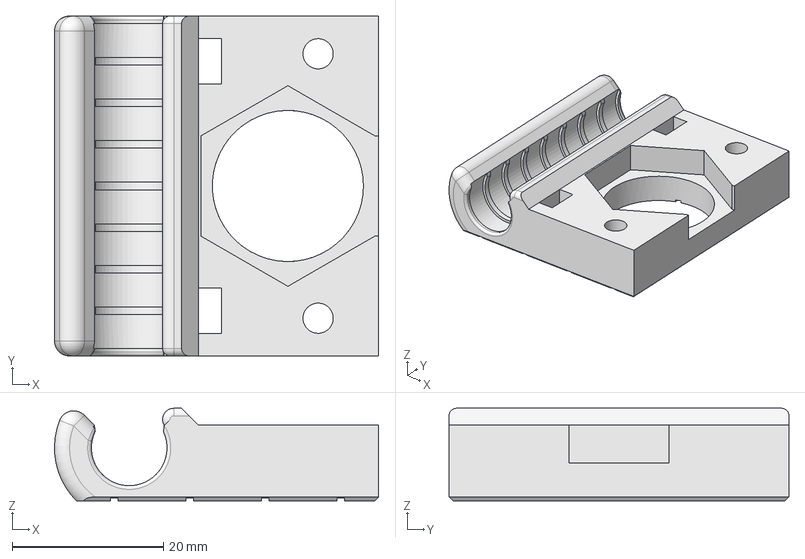
[picture p231: CAD file, 2024-03-15]
production_parts/printed_parts/z-min_switch_mount/z-min_switch_mount_v4.1.fcstd
42.9 x 45.0 x 12.3 mm
