gralco/TAZ6/production_parts/printed_parts/z_carriage_idler/carriage_base_olive_idler.fcstd

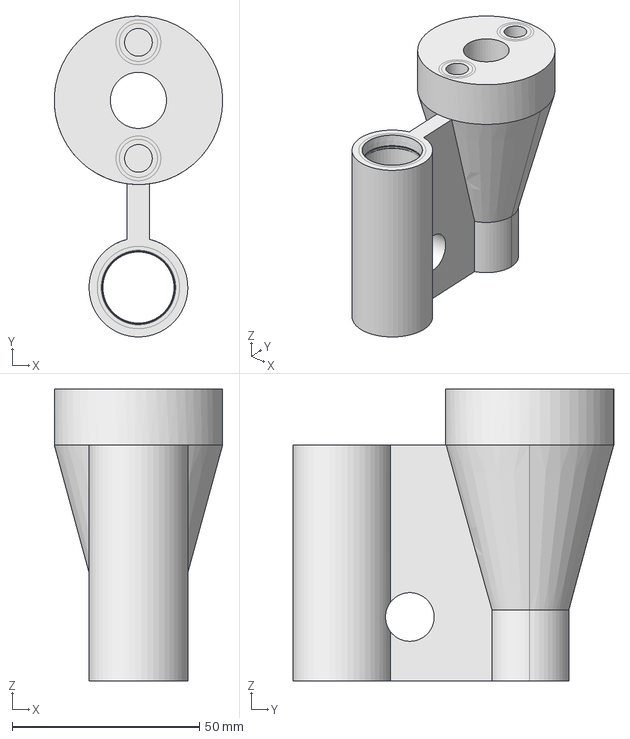
[picture p232: CAD file, 2024-03-15]
production_parts/printed_parts/z_carriage_idler/carriage_base_olive_idler.fcstd
45.0 x 85.7 x 78.0 mm
