gralco/TAZ6/production_parts/printed_parts/z_carriage_motor/carriage_motor_z.fcstd

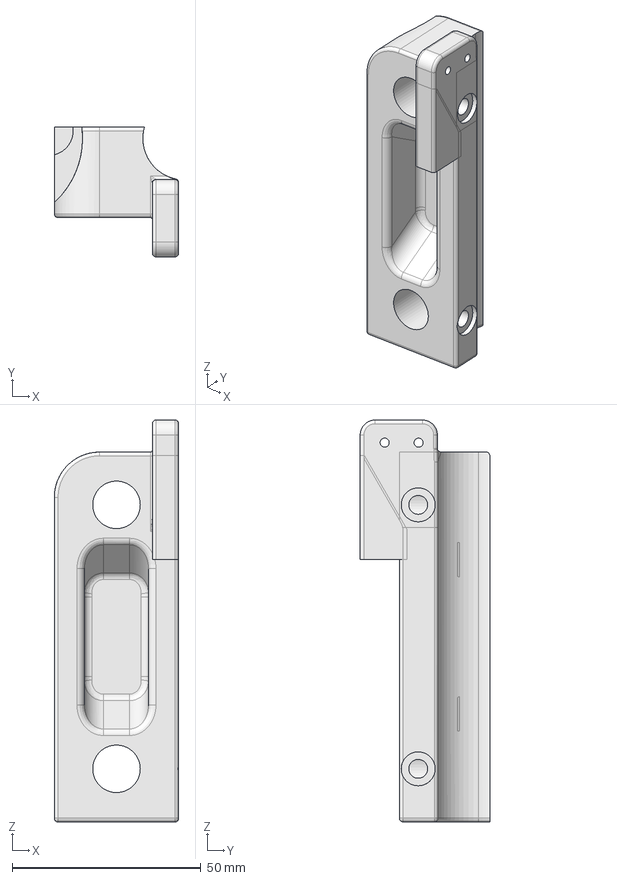
[picture p233: CAD file, 2024-03-15]
production_parts/printed_parts/z_carriage_motor/carriage_motor_z.fcstd
33.0 x 34.4 x 106.6 mm
