gralco/TAZ6/production_parts/printed_parts/z_lower_left/z_lower_left_v2.5_rotated.stl

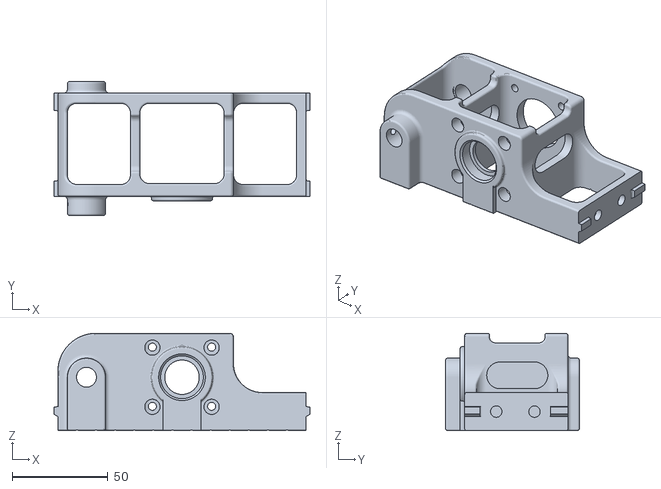
[picture p234: CAD file, 2024-03-15]
production_parts/printed_parts/z_lower_left/z_lower_left_v2.5_rotated.stl
134.0 x 70.0 x 51.0
