gralco/TAZ6/production_parts/printed_parts/z_upper/z_upper_v2.6.fcstd

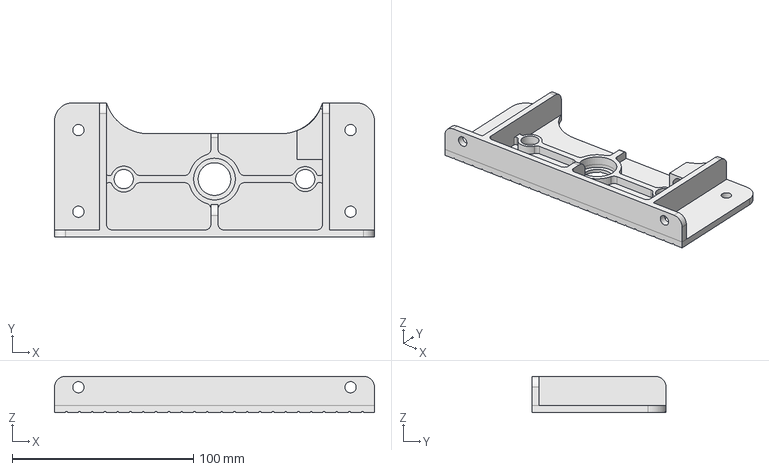
[picture p235: CAD file, 2024-03-15]
production_parts/printed_parts/z_upper/z_upper_v2.6.fcstd
176.3 x 74.0 x 20.0 mm
