gralco/TAZ6/sample_prints/benchmarks/make_2015_tests/all_tests_at_once.stl

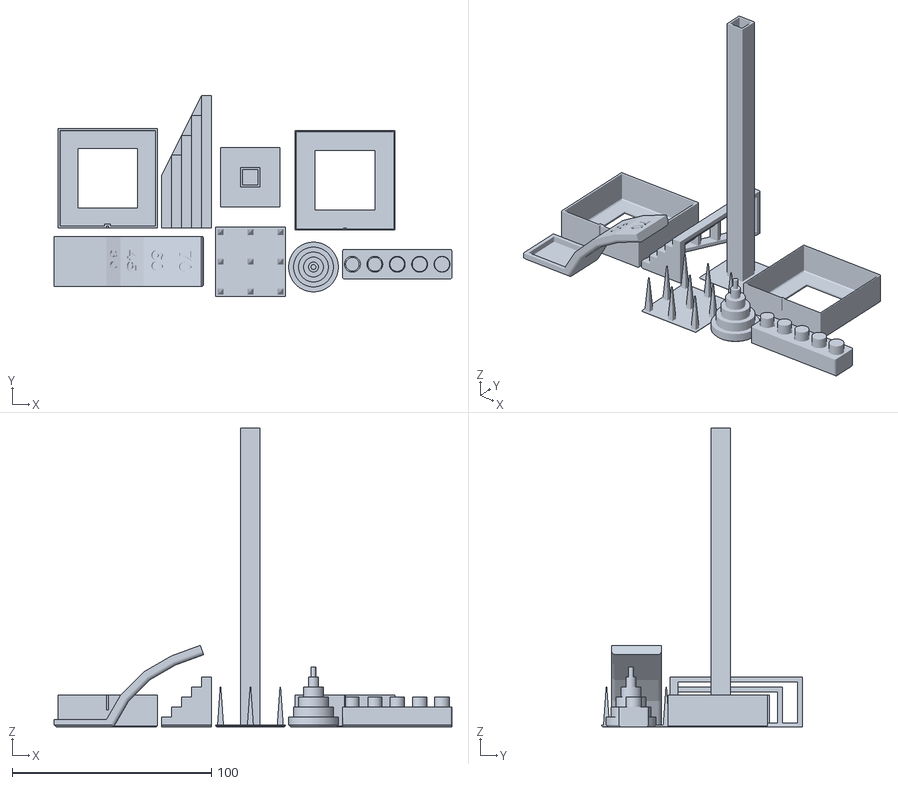
[picture p236: CAD file, 2024-03-15]
sample_prints/benchmarks/make_2015_tests/all_tests_at_once.stl
199.9 x 100.9 x 150.0
