gralco/TAZ6/sample_prints/benchmarks/make_torture_test/torture_test.stl

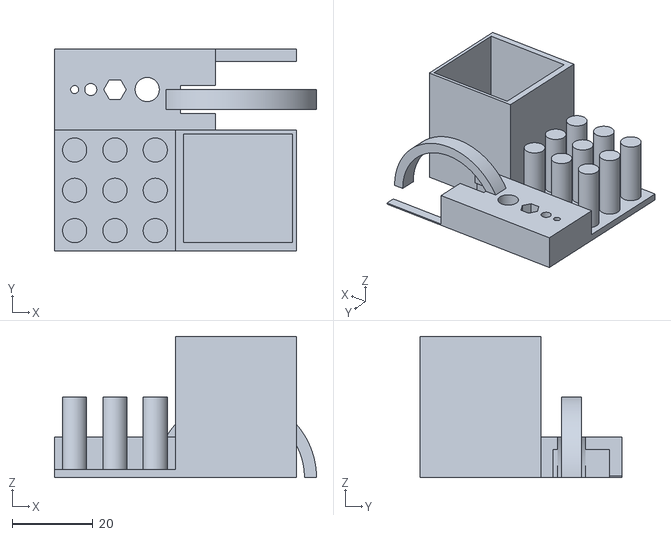
[picture p237: CAD file, 2024-03-15]
sample_prints/benchmarks/make_torture_test/torture_test.stl
65.0 x 50.0 x 35.0
