gralco/TAZ6/sample_prints/benchmarks/marvin_keychain/marvin_keychain.STL

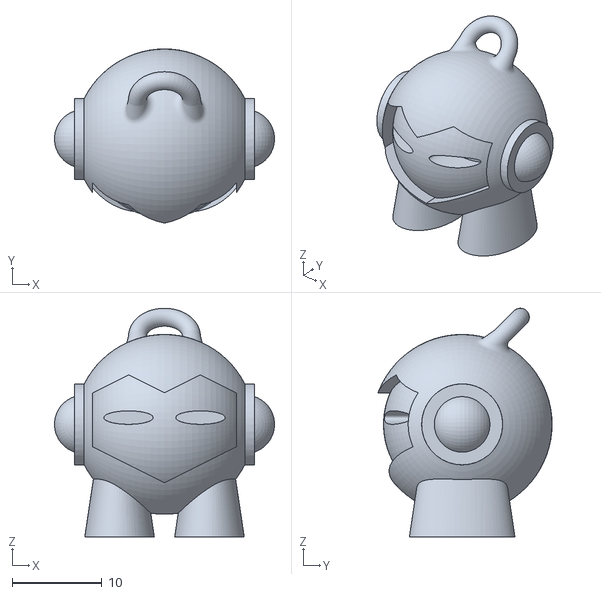
[picture p238: CAD file, 2024-03-15]
sample_prints/benchmarks/marvin_keychain/marvin_keychain.STL
24.5 x 19.4 x 25.4
