gralco/TAZ6/sample_prints/functional/mobile_device_rack/stand_3.stl

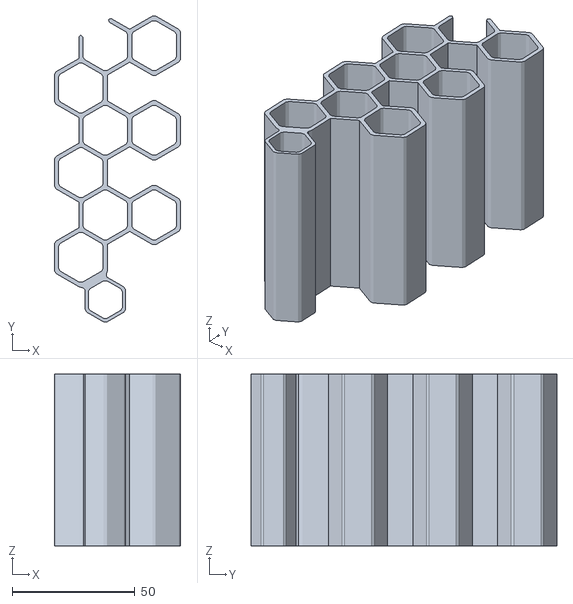
[picture p239: CAD file, 2024-03-15]
sample_prints/functional/mobile_device_rack/stand_3.stl
51.5 x 124.8 x 70.0
