gralco/TAZ6/sample_prints/LulzBot/LulzBot_keychain/LulzBot_keychain.stl

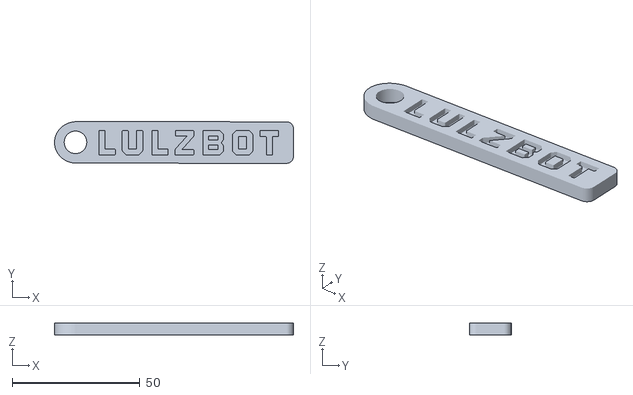
[picture p240: CAD file, 2024-03-15]
sample_prints/LulzBot/LulzBot_keychain/LulzBot_keychain.stl
93.7 x 16.3 x 4.80
