gralco/TAZ6/sample_prints/modifications/spool_mount/spool_mount.STL

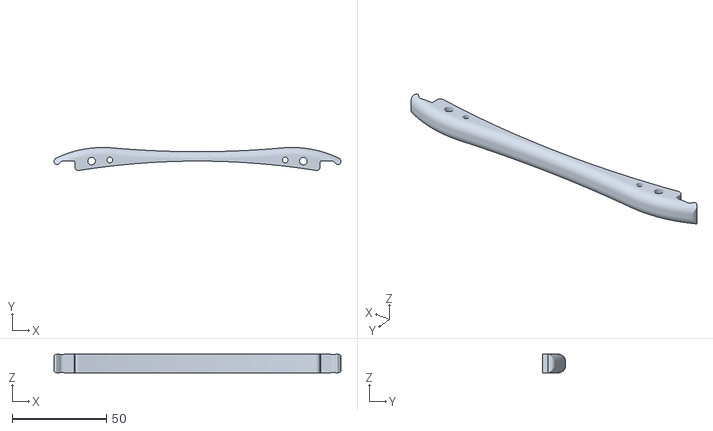
[picture p241: CAD file, 2024-03-15]
sample_prints/modifications/spool_mount/spool_mount.STL
152.0 x 12.2 x 10.0
