gralco/TAZ6/sample_prints/novelties/fish_fossilz/fish_fossilz.stl

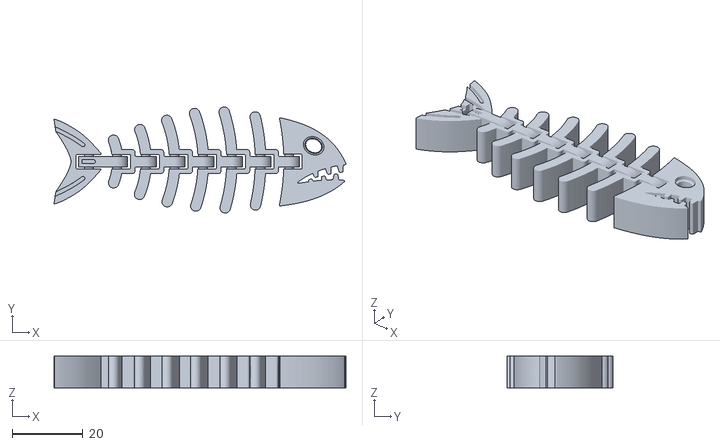
[picture p242: CAD file, 2024-03-15]
sample_prints/novelties/fish_fossilz/fish_fossilz.stl
82.8 x 30.1 x 9.00
