gralco/TAZ6/sample_prints/novelties/mustache_ring/mustache_ring.stl

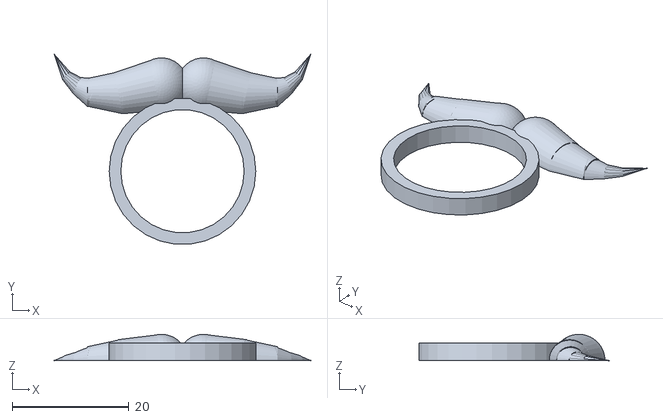
[picture p243: CAD file, 2024-03-15]
sample_prints/novelties/mustache_ring/mustache_ring.stl
43.9 x 32.5 x 4.50
