gralco/TAZ6/sample_prints/novelties/OSHW_logo/OSHW_logo.stl

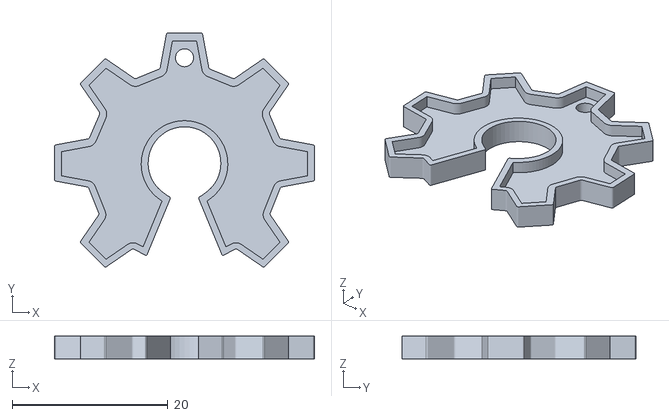
[picture p244: CAD file, 2024-03-15]
sample_prints/novelties/OSHW_logo/OSHW_logo.stl
33.3 x 30.0 x 2.94
