gralco/TAZ6/production_parts/jigs/40mmfan_65mm_wire_jig.fcstd

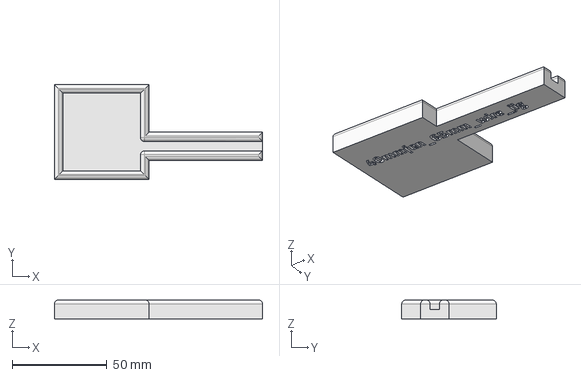
[picture p245: CAD file, 2024-03-15]
production_parts/jigs/40mmfan_65mm_wire_jig.fcstd
110.0 x 50.0 x 10.0 mm
