gralco/TAZ6/production_parts/jigs/control_box_test_fixture/frame_T.fcstd

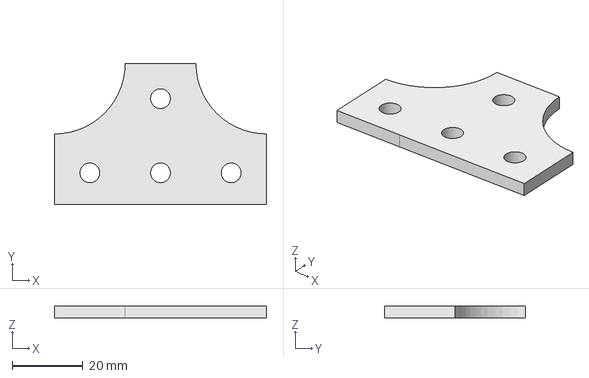
[picture p246: CAD file, 2024-03-15]
production_parts/jigs/control_box_test_fixture/frame_T.fcstd
60.0 x 40.0 x 3.50 mm
