gralco/TAZ6/production_parts/jigs/insert jigs/YmountChassis/ymnt_chassis_insert.fcstd

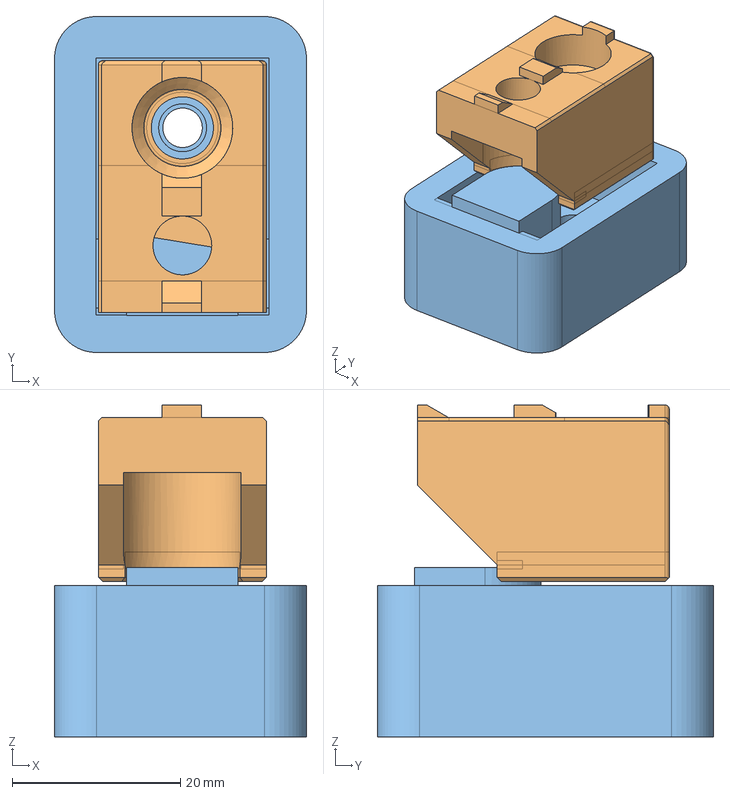
[picture p247: CAD file, 2024-03-15]
production_parts/jigs/insert jigs/YmountChassis/ymnt_chassis_insert.fcstd
30.0 x 40.0 x 39.5 mm
bed_mount_chassis_v3_3_A_01
