gralco/TAZ6/production_parts/jigs/SmallHerringBone_DrillJig/HerringBone6shooter.stl

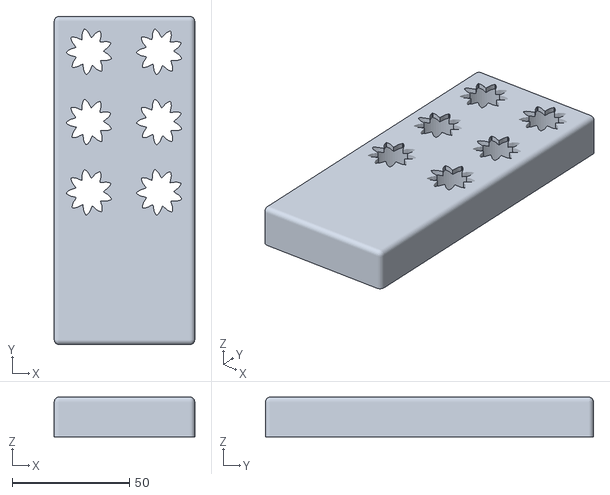
[picture p248: CAD file, 2024-03-15]
production_parts/jigs/SmallHerringBone_DrillJig/HerringBone6shooter.stl
60.0 x 140.0 x 17.0
