gralco/TAZ6/production_parts/jigs/TAZ6_Control_Box_Tie_Down_Jig/Taz6_Control_Box_Tie_Down_Jig.fcstd

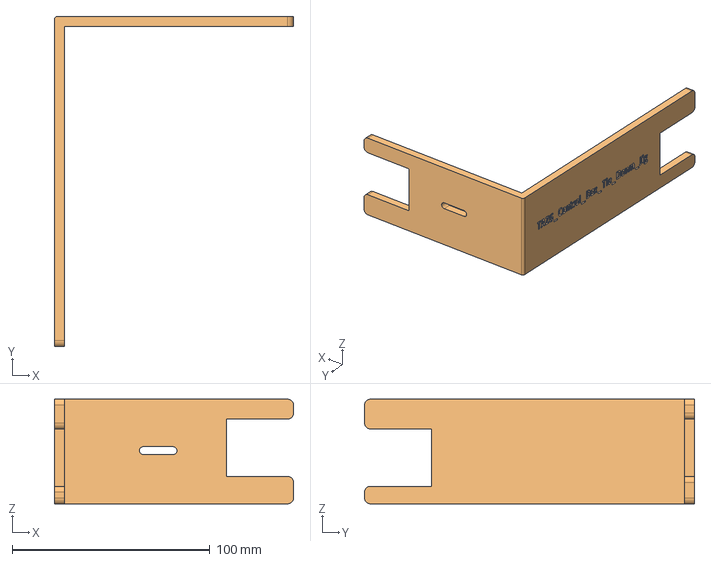
[picture p249: CAD file, 2024-03-15]
production_parts/jigs/TAZ6_Control_Box_Tie_Down_Jig/Taz6_Control_Box_Tie_Down_Jig.fcstd
121.0 x 167.0 x 53.0 mm
