gralco/TAZ6/production_parts/jigs/TAZ6_frame_assy_fixture/6X3_workspace.fcstd

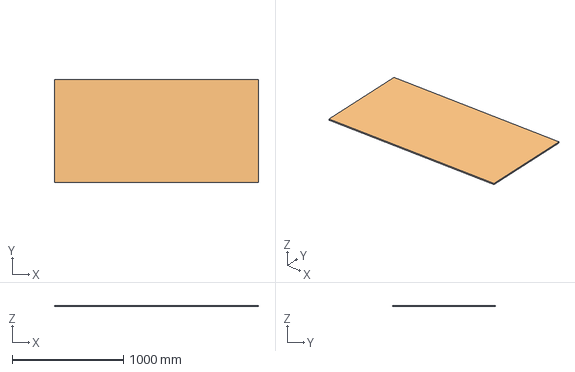
[picture p250: CAD file, 2024-03-15]
production_parts/jigs/TAZ6_frame_assy_fixture/6X3_workspace.fcstd
1830.0 x 923.0 x 12.0 mm
