gralco/TAZ6/production_parts/jigs/TAZ_drive_rod_run_out_fixture/Drive_rod_run_out_fixture_headstock_sliding.fcstd

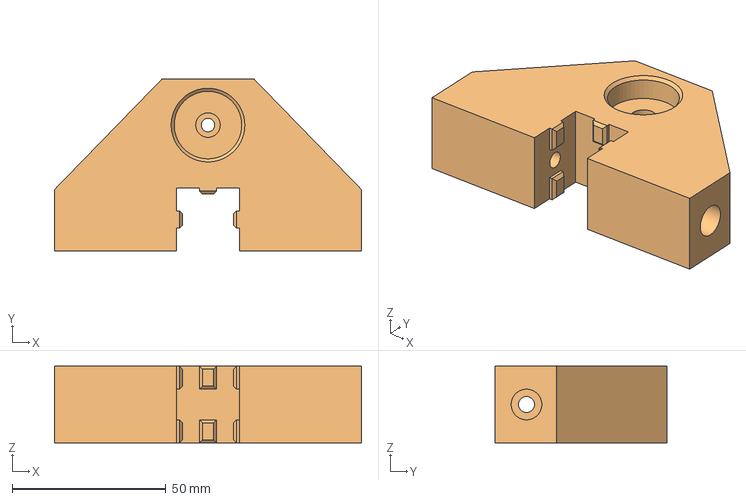
[picture p251: CAD file, 2024-03-15]
production_parts/jigs/TAZ_drive_rod_run_out_fixture/Drive_rod_run_out_fixture_headstock_sliding.fcstd
100.0 x 56.0 x 25.0 mm
