gralco/TAZ6/production_parts/machined_parts/0.5mm_hotend_assembly_single_v2/molex_2pos_male.fcstd

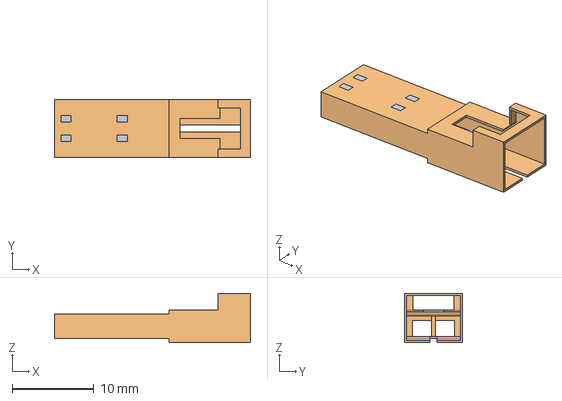
[picture p252: CAD file, 2024-03-15]
production_parts/machined_parts/0.5mm_hotend_assembly_single_v2/molex_2pos_male.fcstd
24.0 x 7.14 x 6.00 mm
