gralco/TAZ6/production_parts/machined_parts/lulzbot_edition_hexagon_hotend-0.5mm/retention plate V2 .DXF

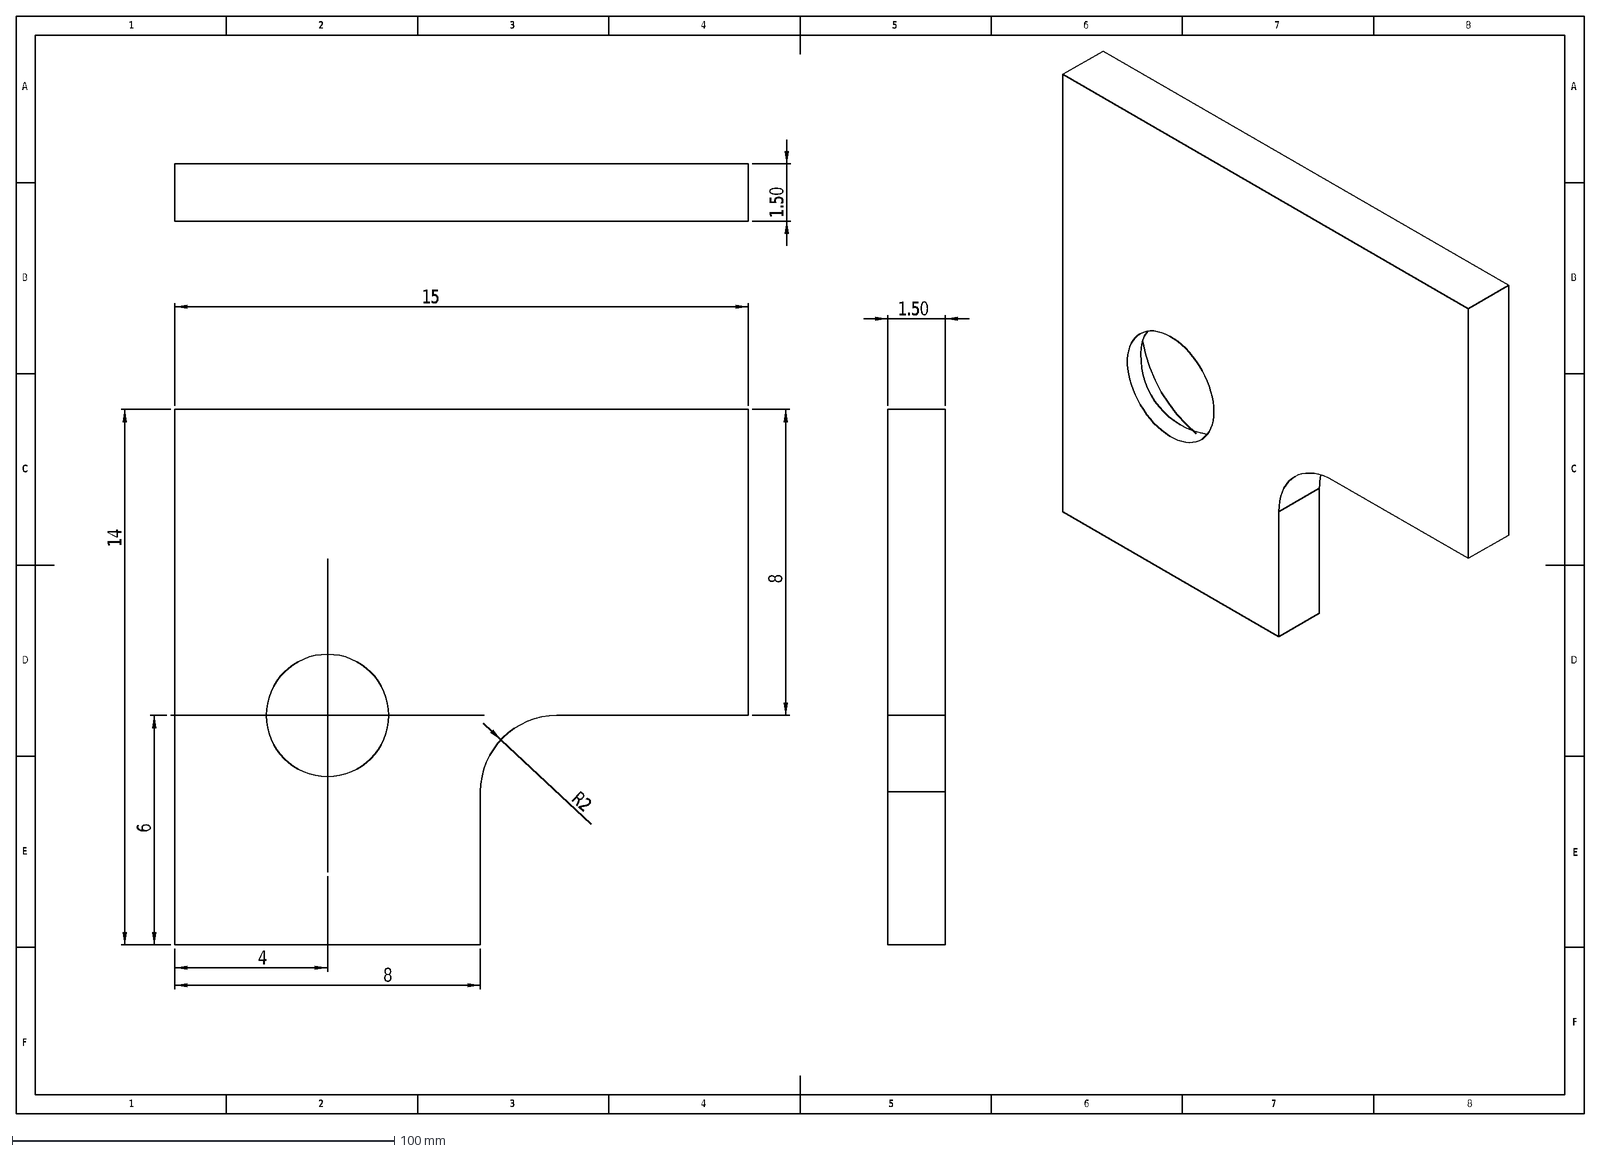
[picture p253: CAD file, 2024-03-15]
production_parts/machined_parts/lulzbot_edition_hexagon_hotend-0.5mm/retention plate V2 .DXF
D
E
F
C
1
2
3
4
B
A
5
6
7
8
15
14
R2
1.50
