gralco/TAZ6/production_parts/printed_parts/12mm_single_bearing_holder/12mm_single_bearing_holder_v0.4-x2.stl

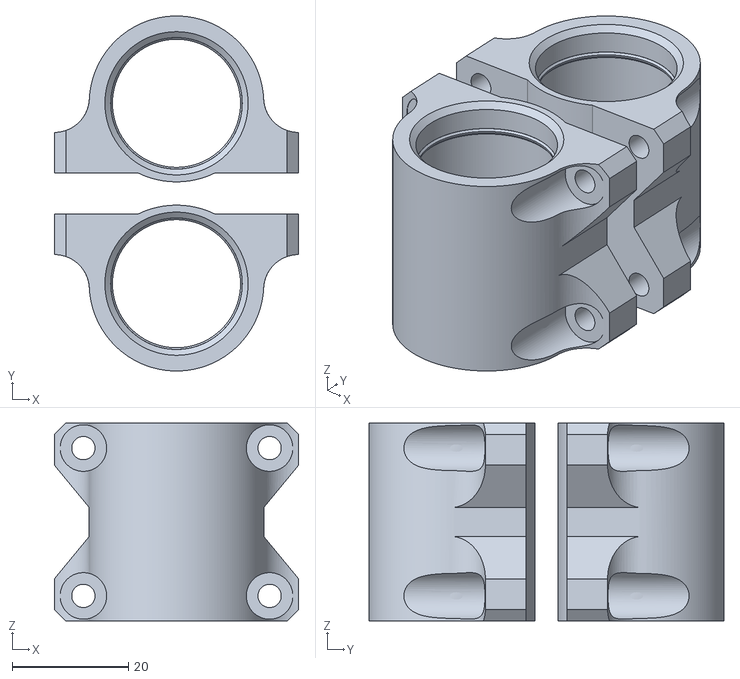
[picture p254: CAD file, 2024-03-15]
production_parts/printed_parts/12mm_single_bearing_holder/12mm_single_bearing_holder_v0.4-x2.stl
42.0 x 61.0 x 34.0
