gralco/TAZ6/production_parts/printed_parts/electronics_case_mount/electronics_case_mount_v2.0.fcstd

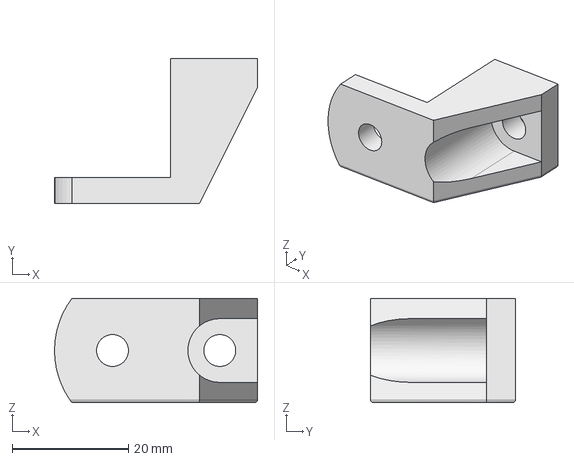
[picture p255: CAD file, 2024-03-15]
production_parts/printed_parts/electronics_case_mount/electronics_case_mount_v2.0.fcstd
35.0 x 25.0 x 18.0 mm
