gralco/TAZ6/production_parts/printed_parts/extruder_idler_block/extruder_idler_block_v1.4.fcstd

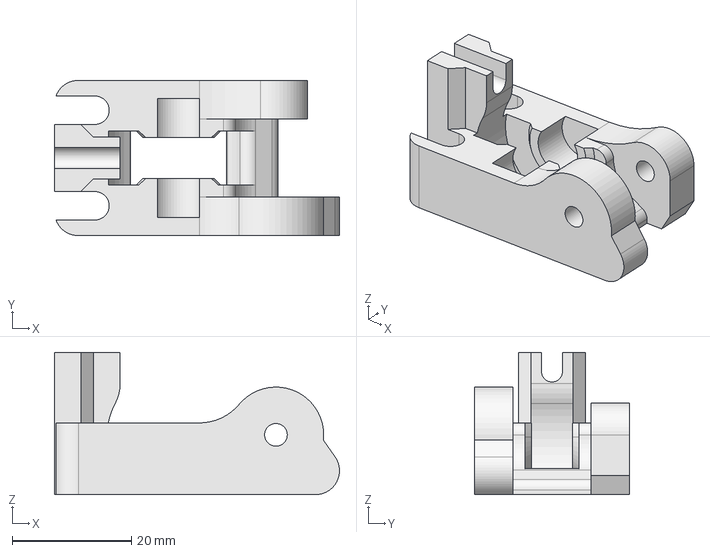
[picture p256: CAD file, 2024-03-15]
production_parts/printed_parts/extruder_idler_block/extruder_idler_block_v1.4.fcstd
47.7 x 26.0 x 23.8 mm
