gralco/TAZ6/production_parts/printed_parts/feed_tube_spinner/feed_tube_spinner_v3.0.FCStd

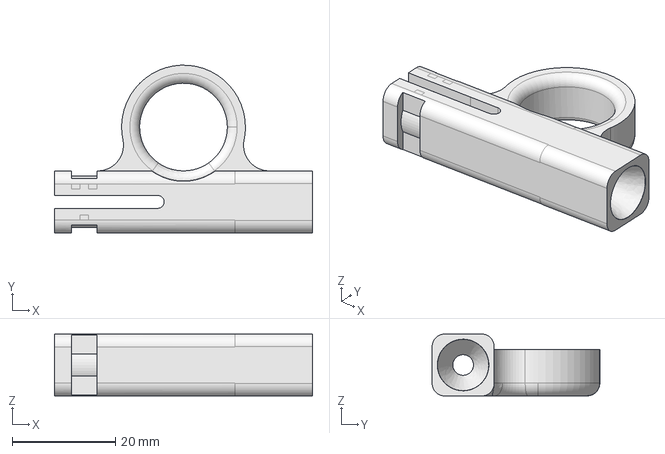
[picture p257: CAD file, 2024-03-15]
production_parts/printed_parts/feed_tube_spinner/feed_tube_spinner_v3.0.FCStd
50.0 x 32.5 x 12.0 mm
