gralco/TAZ6/production_parts/printed_parts/heatsink_fan/heatsink_fan_duct_v0.6_bedLayout.stl

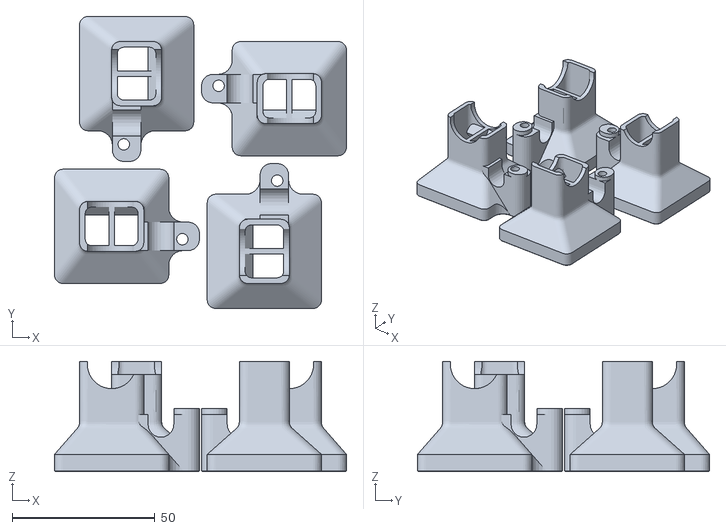
[picture p258: CAD file, 2024-03-15]
production_parts/printed_parts/heatsink_fan/heatsink_fan_duct_v0.6_bedLayout.stl
102.2 x 102.2 x 38.5
