gralco/TAZ6/production_parts/printed_parts/lcd_bezel/lcd_bezel_v1.1-x4.stl

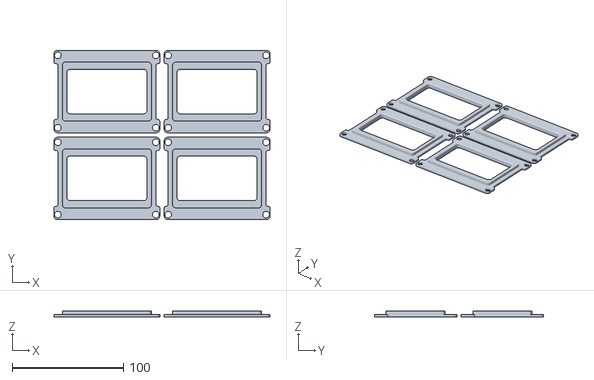
[picture p259: CAD file, 2024-03-15]
production_parts/printed_parts/lcd_bezel/lcd_bezel_v1.1-x4.stl
194.0 x 152.0 x 5.00
