gralco/TAZ6/production_parts/printed_parts/lcd_knob/lcd_knob_v0.2.fcstd

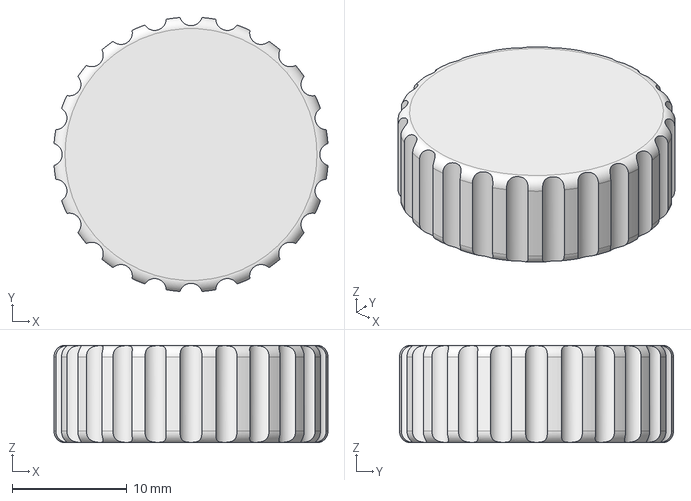
[picture p260: CAD file, 2024-03-15]
production_parts/printed_parts/lcd_knob/lcd_knob_v0.2.fcstd
23.9 x 23.9 x 8.50 mm
