gralco/TAZ6/production_parts/printed_parts/lcd_spacer/lcd_spacer_v0.4-x64.stl

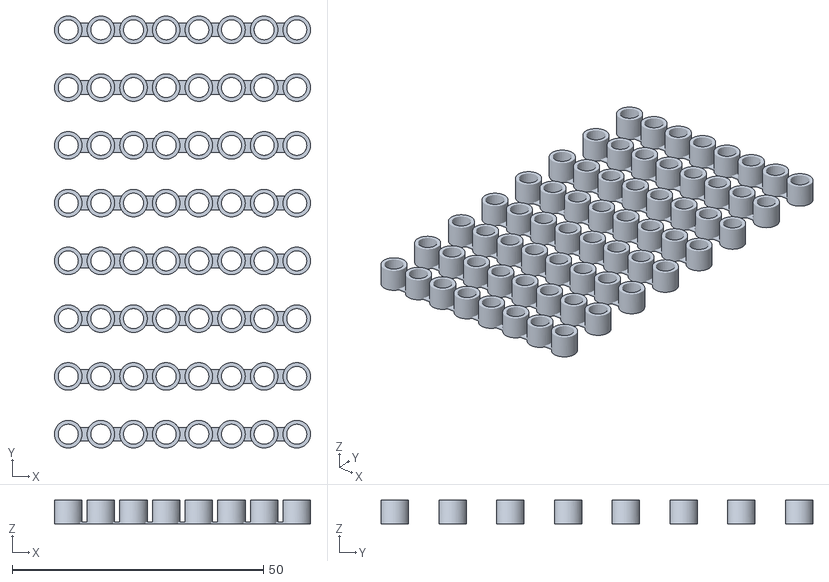
[picture p261: CAD file, 2024-03-15]
production_parts/printed_parts/lcd_spacer/lcd_spacer_v0.4-x64.stl
51.0 x 86.0 x 4.75
