gralco/TAZ6/production_parts/printed_parts/sd_card_bezel/sd_card_bezel_v0.8-x10.stl

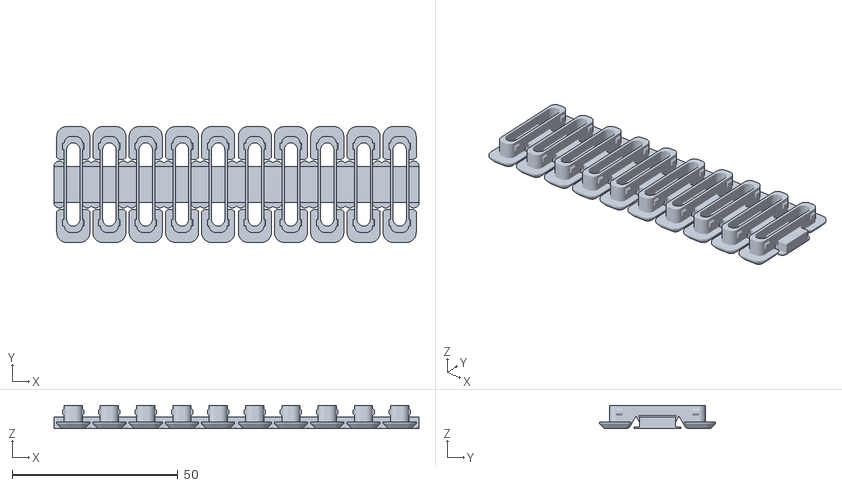
[picture p262: CAD file, 2024-03-15]
production_parts/printed_parts/sd_card_bezel/sd_card_bezel_v0.8-x10.stl
110.2 x 35.0 x 7.00
