gralco/TAZ6/production_parts/printed_parts/spool_arm/spool_arm_v0.2-x2.stl

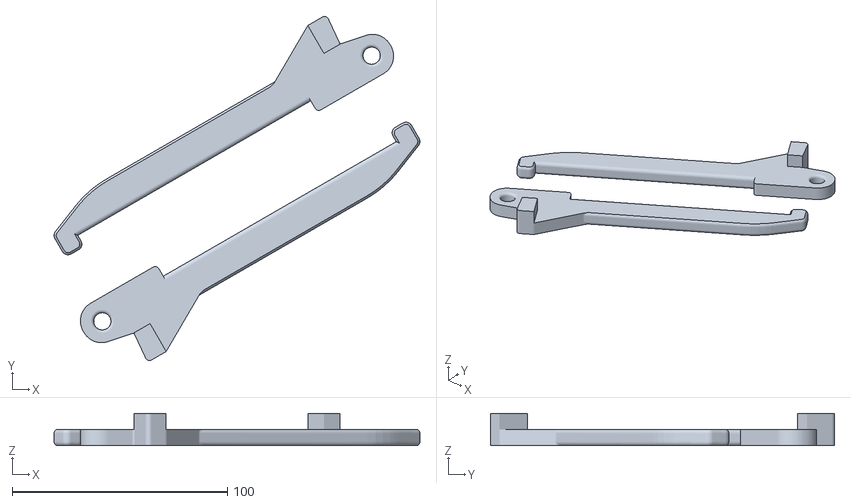
[picture p263: CAD file, 2024-03-15]
production_parts/printed_parts/spool_arm/spool_arm_v0.2-x2.stl
170.0 x 159.9 x 15.0
