gralco/TAZ6/production_parts/printed_parts/tippy_feed_tube_holder/tippy_feed_tube_holder_v0.6.fcstd

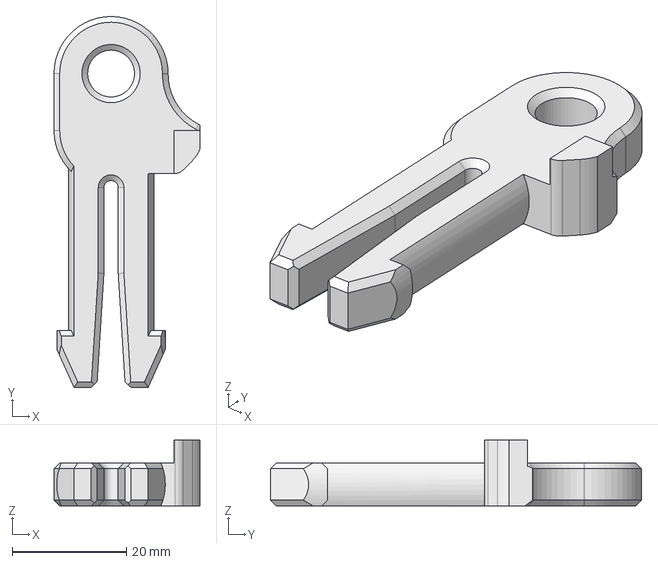
[picture p264: CAD file, 2024-03-15]
production_parts/printed_parts/tippy_feed_tube_holder/tippy_feed_tube_holder_v0.6.fcstd
25.6 x 65.0 x 11.5 mm
