gralco/TAZ6/production_parts/printed_parts/wiper_mount/wiper_mount_v1.1.fcstd

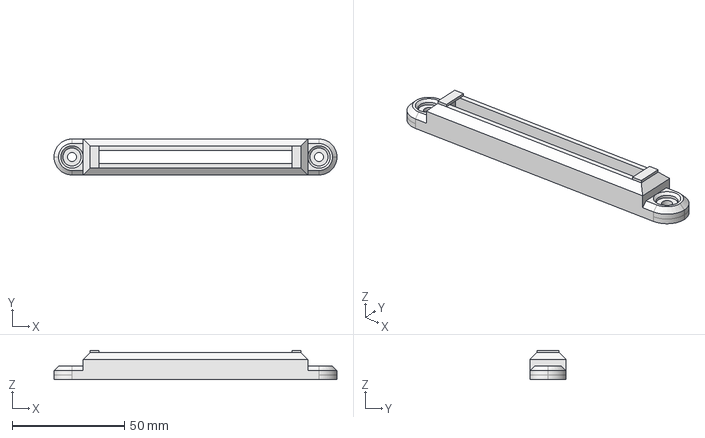
[picture p265: CAD file, 2024-03-15]
production_parts/printed_parts/wiper_mount/wiper_mount_v1.1.fcstd
126.0 x 16.0 x 13.0 mm
