gralco/TAZ6/production_parts/printed_parts/x_carriage_guide/x_carriage_guide_v2-x4.stl

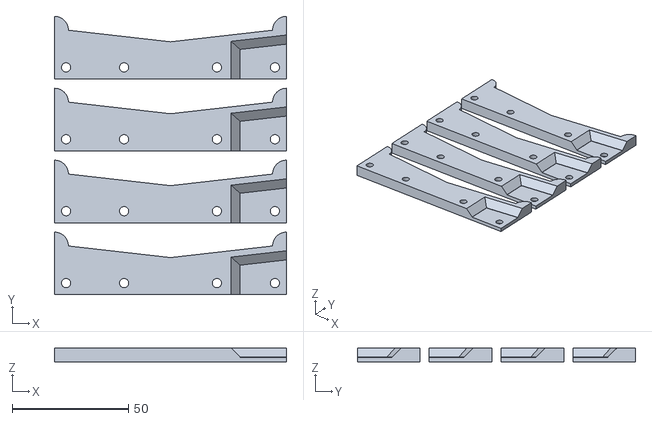
[picture p266: CAD file, 2024-03-15]
production_parts/printed_parts/x_carriage_guide/x_carriage_guide_v2-x4.stl
100.0 x 120.0 x 6.00
