gralco/TAZ6/production_parts/printed_parts/y_corner_right/y_corner_right_v2.4.stl

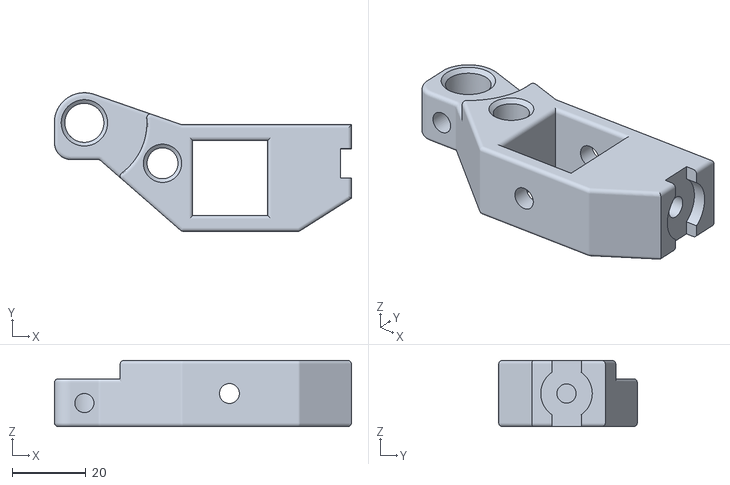
[picture p268: CAD file, 2024-03-15]
production_parts/printed_parts/y_corner_right/y_corner_right_v2.4.stl
80.8 x 37.7 x 18.0
