gralco/TAZ6/production_parts/printed_parts/z-min_switch_mount/zmin_switch_mount_v4.1-x4.stl

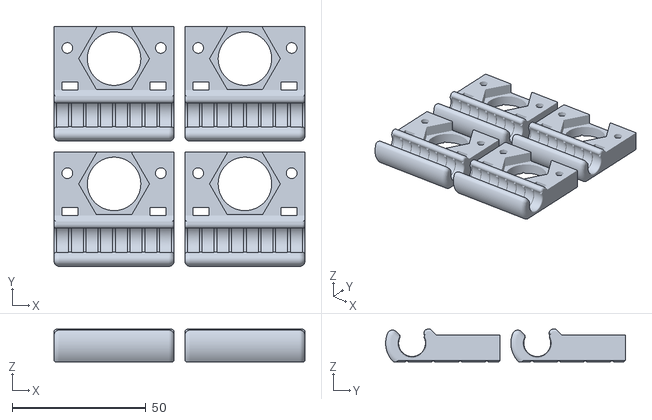
[picture p269: CAD file, 2024-03-15]
production_parts/printed_parts/z-min_switch_mount/zmin_switch_mount_v4.1-x4.stl
94.0 x 89.8 x 12.3
