gralco/TAZ6/production_parts/printed_parts/z_lower_right/z_lower_right_v2.5_rotated.stl

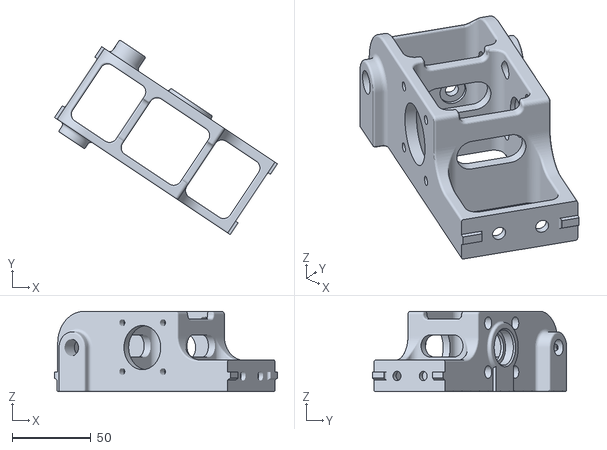
[picture p270: CAD file, 2024-03-15]
production_parts/printed_parts/z_lower_right/z_lower_right_v2.5_rotated.stl
141.4 x 123.3 x 51.0
