gralco/TAZ6/sample_prints/benchmarks/make_2015_tests/XY_resonance_test.stl

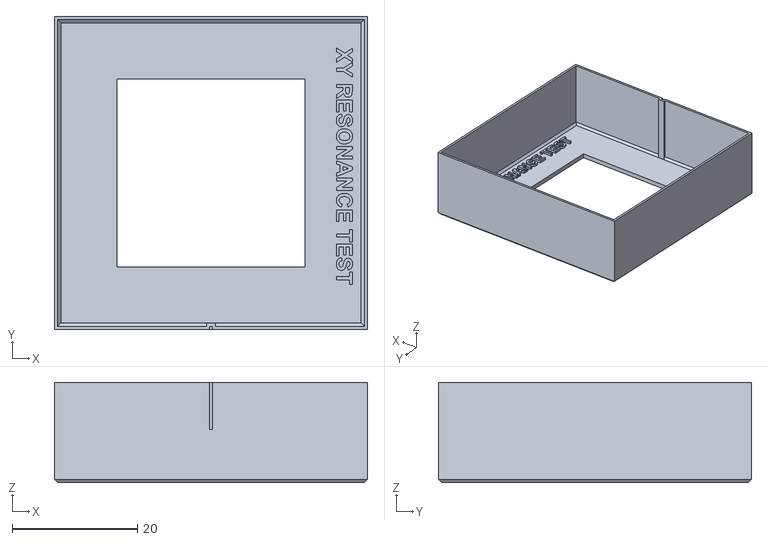
[picture p271: CAD file, 2024-03-15]
sample_prints/benchmarks/make_2015_tests/XY_resonance_test.stl
50.0 x 50.0 x 16.0
