gralco/TAZ6/production_parts/assemblies/assembly_parts/500mm_extrusion.fcstd

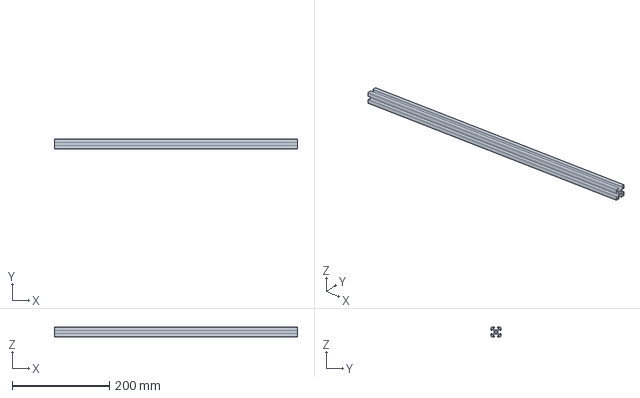
[picture p272: CAD file, 2024-03-15]
production_parts/assemblies/assembly_parts/500mm_extrusion.fcstd
500.0 x 20.0 x 20.0 mm
