gralco/TAZ6/production_parts/jigs/control_box_test_fixture/control_box_test_fixture_front.fcstd

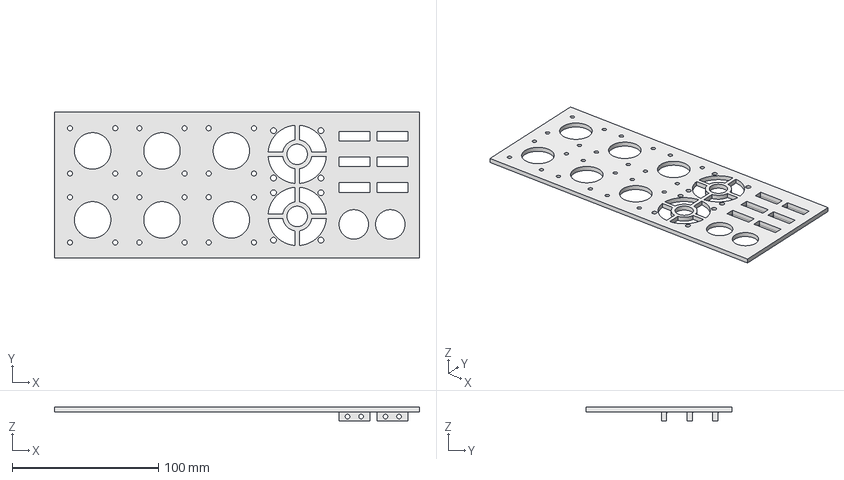
[picture p273: CAD file, 2024-03-15]
production_parts/jigs/control_box_test_fixture/control_box_test_fixture_front.fcstd
250.0 x 100.0 x 9.50 mm
