gralco/TAZ6/production_parts/jigs/heat_pad_alignment_jig_TAZ.fcstd

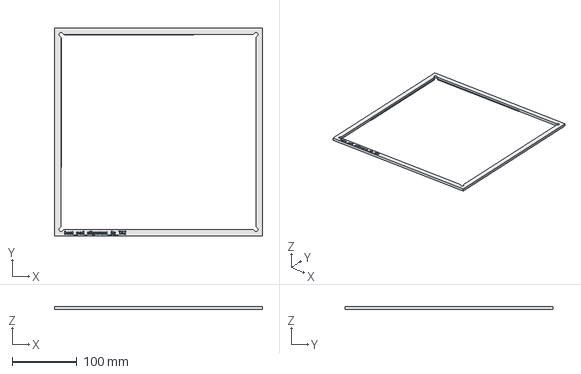
[picture p274: CAD file, 2024-03-15]
production_parts/jigs/heat_pad_alignment_jig_TAZ.fcstd
321.0 x 321.0 x 5.00 mm
