gralco/TAZ6/production_parts/jigs/insert jigs/YmountChassis/ymnt_chassis_insert_x4_with_label.stl

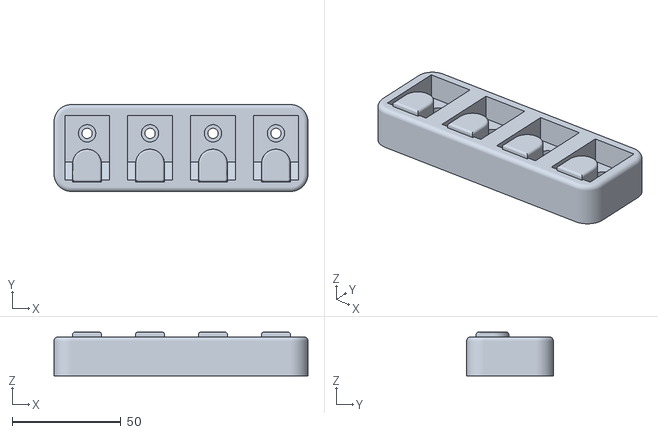
[picture p275: CAD file, 2024-03-15]
production_parts/jigs/insert jigs/YmountChassis/ymnt_chassis_insert_x4_with_label.stl
117.0 x 40.0 x 20.1
