gralco/TAZ6/production_parts/jigs/SmallHerringBone_DrillJig/HerringBone6shooterTOP.fcstd

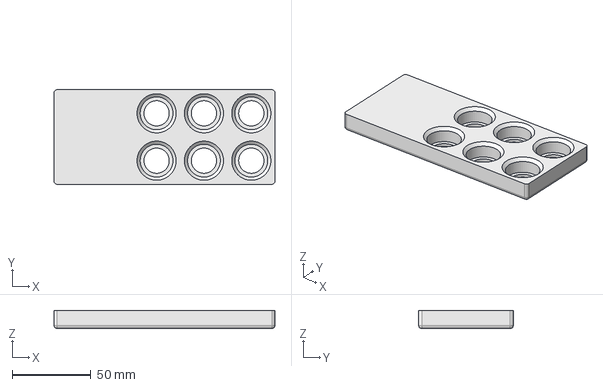
[picture p276: CAD file, 2024-03-15]
production_parts/jigs/SmallHerringBone_DrillJig/HerringBone6shooterTOP.fcstd
140.0 x 60.0 x 11.5 mm
