gralco/TAZ6/production_parts/jigs/TAZ6_frame_assy_fixture/762mm_extrusion.fcstd

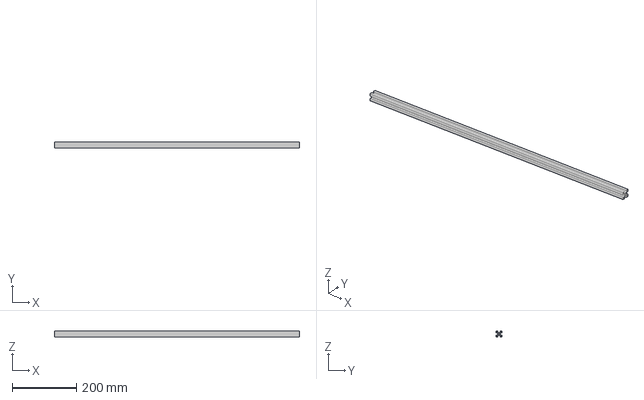
[picture p277: CAD file, 2024-03-15]
production_parts/jigs/TAZ6_frame_assy_fixture/762mm_extrusion.fcstd
762.0 x 20.0 x 20.0 mm
