gralco/TAZ6/production_parts/jigs/TAZ_drive_rod_run_out_fixture/angled_tailstock.stl

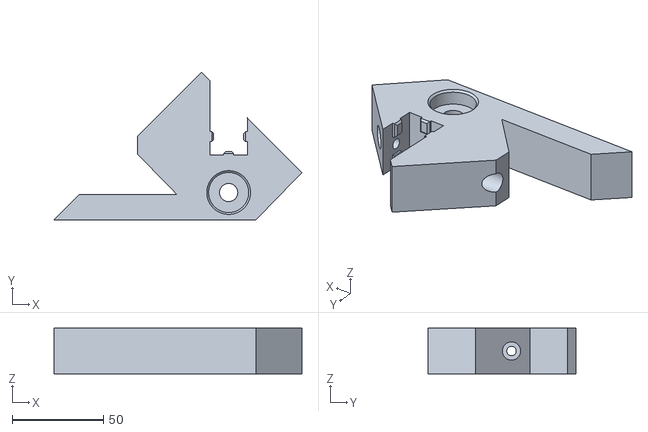
[picture p278: CAD file, 2024-03-15]
production_parts/jigs/TAZ_drive_rod_run_out_fixture/angled_tailstock.stl
136.2 x 81.1 x 25.0
