gralco/TAZ6/production_parts/machined_parts/0.5mm_hotend_assembly_single_v2/some_struder_heater_block.fcstd

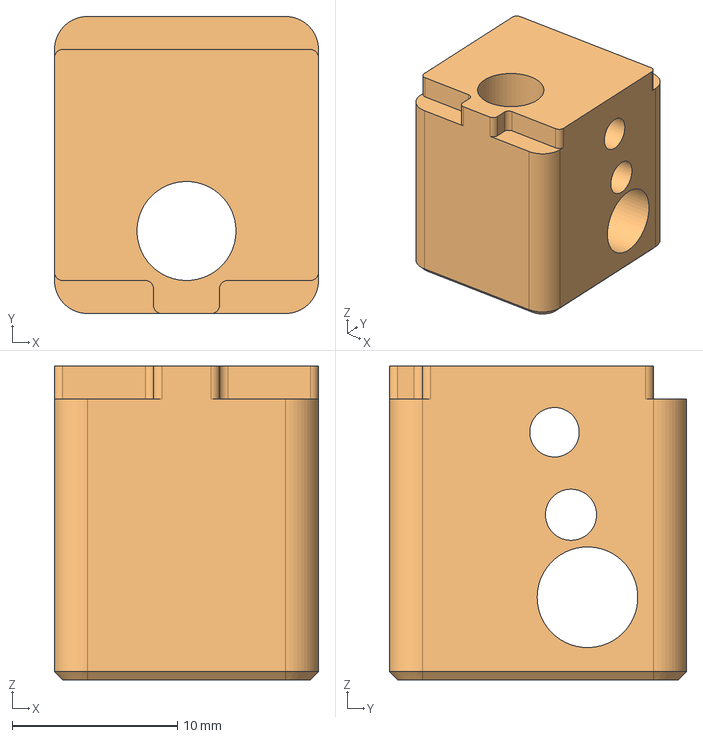
[picture p279: CAD file, 2024-03-15]
production_parts/machined_parts/0.5mm_hotend_assembly_single_v2/some_struder_heater_block.fcstd
16.0 x 18.0 x 19.0 mm
