gralco/TAZ6/production_parts/machined_parts/lulzbot_edition_hexagon_hotend-0.5mm/ao-hex_heater-block_revA.step

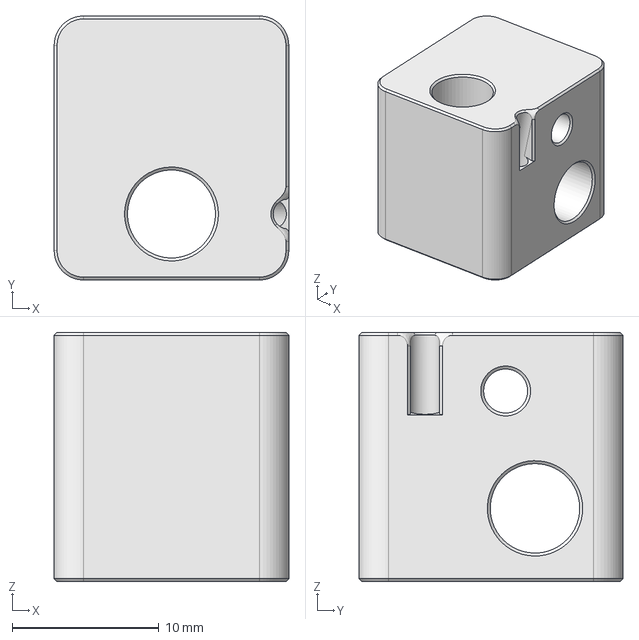
[picture p280: CAD file, 2024-03-15]
production_parts/machined_parts/lulzbot_edition_hexagon_hotend-0.5mm/ao-hex_heater-block_revA.step
16.0 x 18.0 x 17.0 mm
