gralco/TAZ6/production_parts/printed_parts/lcd_bezel/mini_lcd_bezel_v0.1.fcstd

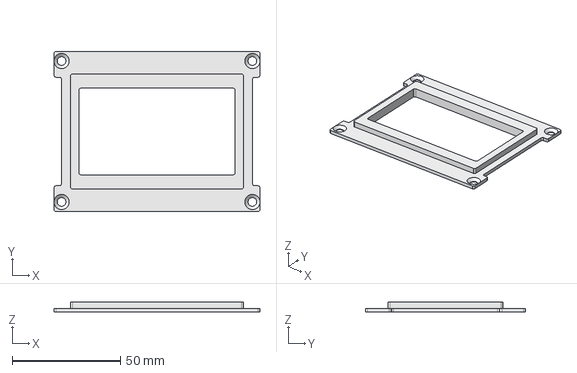
[picture p281: CAD file, 2024-03-15]
production_parts/printed_parts/lcd_bezel/mini_lcd_bezel_v0.1.fcstd
95.0 x 74.0 x 4.80 mm
