gralco/TAZ6/production_parts/printed_parts/y_corner_right/y_corner_right_v2.4-x2.stl

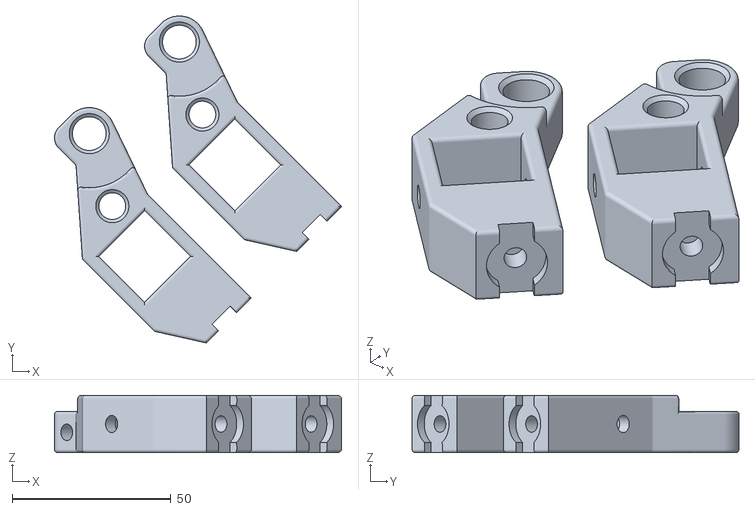
[picture p282: CAD file, 2024-03-15]
production_parts/printed_parts/y_corner_right/y_corner_right_v2.4-x2.stl
90.3 x 102.9 x 18.0
