gralco/TAZ6/sample_prints/benchmarks/make_2015_tests/overhang_test.stl

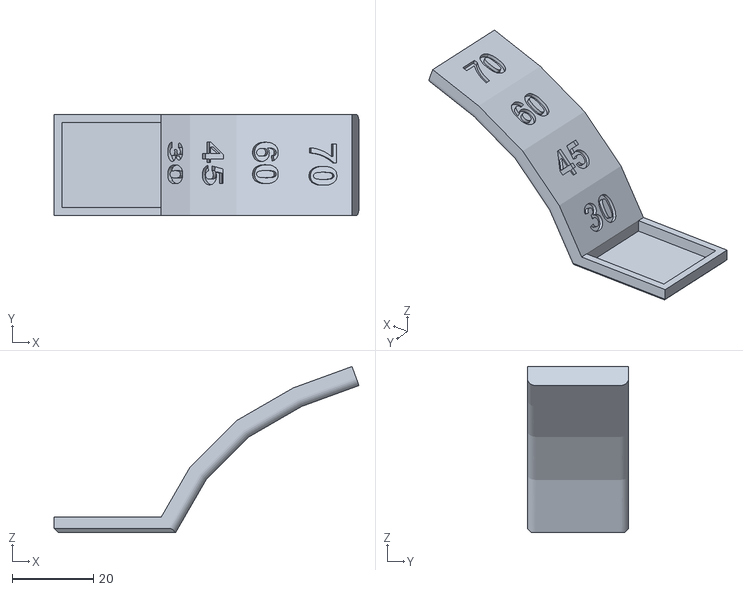
[picture p283: CAD file, 2024-03-15]
sample_prints/benchmarks/make_2015_tests/overhang_test.stl
75.2 x 25.0 x 40.9
