gralco/TAZ6/production_parts/assemblies/assembly_parts/power_switch.fcstd

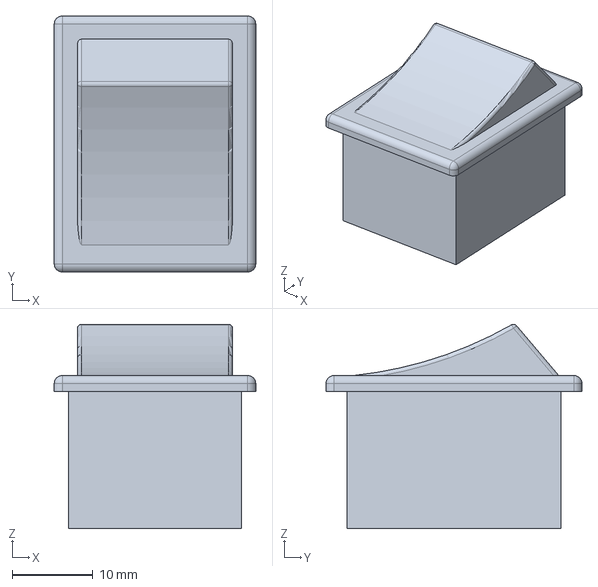
[picture p284: CAD file, 2024-03-15]
production_parts/assemblies/assembly_parts/power_switch.fcstd
25.0 x 31.8 x 25.4 mm
