gralco/TAZ6/production_parts/jigs/10mm_bushing_pusher_second_piece.fcstd

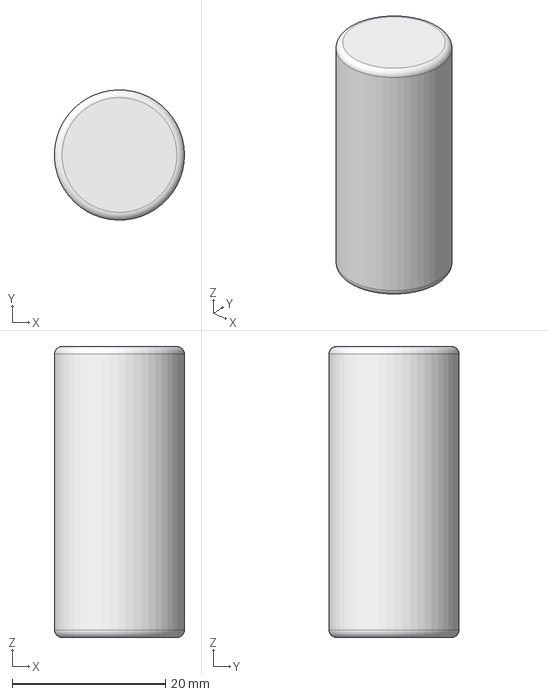
[picture p285: CAD file, 2024-03-15]
production_parts/jigs/10mm_bushing_pusher_second_piece.fcstd
17.0 x 17.0 x 38.0 mm
