gralco/TAZ6/production_parts/jigs/control_box_test_fixture/frame_corner_48.5_degree.fcstd

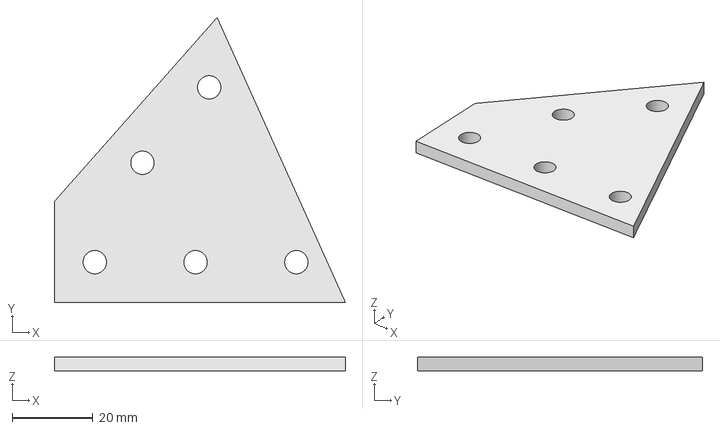
[picture p286: CAD file, 2024-03-15]
production_parts/jigs/control_box_test_fixture/frame_corner_48.5_degree.fcstd
72.2 x 70.7 x 3.50 mm
