gralco/TAZ6/production_parts/jigs/harness_test_fixture/blank_tile.stl

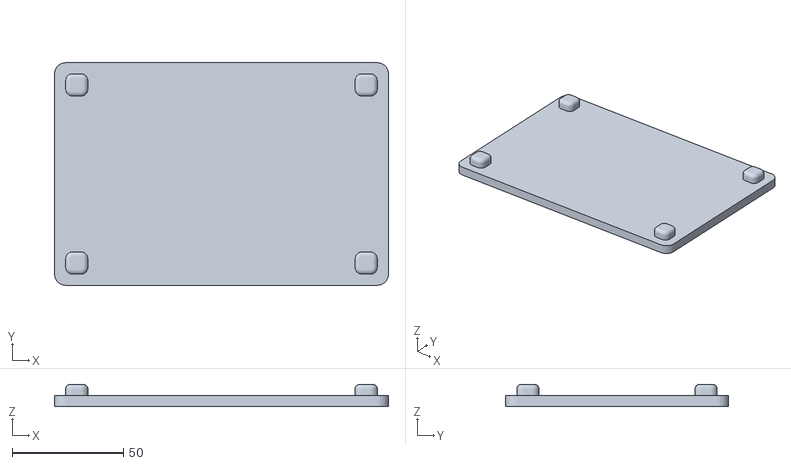
[picture p287: CAD file, 2024-03-15]
production_parts/jigs/harness_test_fixture/blank_tile.stl
150.0 x 100.0 x 10.0
