gralco/TAZ6/production_parts/jigs/insert jigs/YmountChassis/ymnt_chassis_insert_x4_with_label_2%bigger.stl

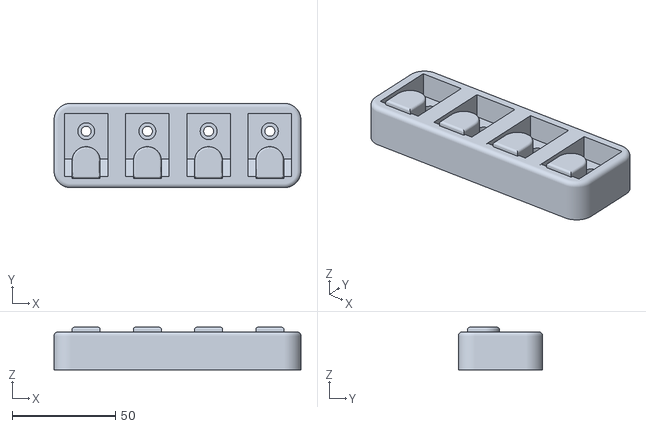
[picture p288: CAD file, 2024-03-15]
production_parts/jigs/insert jigs/YmountChassis/ymnt_chassis_insert_x4_with_label_2%bigger.stl
119.3 x 40.8 x 20.6
