gralco/TAZ6/production_parts/jigs/TAZ6_frame_assy_fixture/722mm_extrusion.fcstd

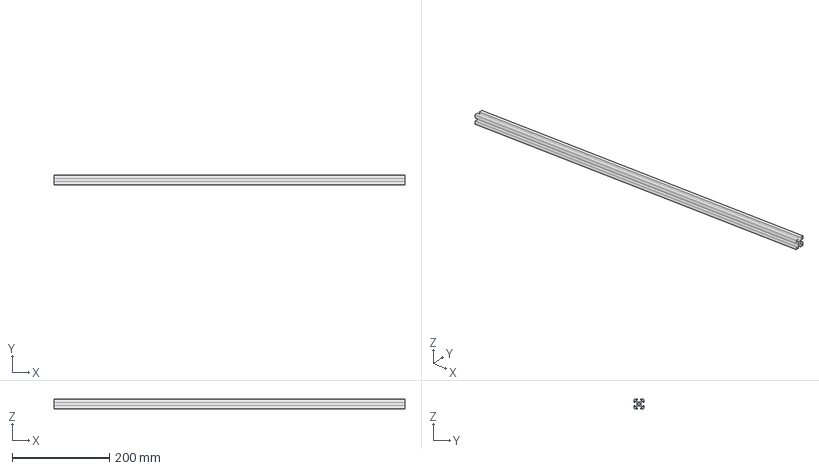
[picture p289: CAD file, 2024-03-15]
production_parts/jigs/TAZ6_frame_assy_fixture/722mm_extrusion.fcstd
722.0 x 20.0 x 20.0 mm
