gralco/TAZ6/(list of files, cad)

Other CAD files:
production_parts/jigs/TAZ6_frame_assy_fixture/TAZ6_frame_assy_fixture_base_plate.fcstd
production_parts/printed_parts/fan_duct_right/fan_duct_right_v0.7.4.1d.stl
production_parts/printed_parts/herringbone_large_gear_blk/source/herringbone_large_gear.stl
production_parts/printed_parts/herringbone_large_gear_grn/source/herringbone_large_gear.stl
production_parts/printed_parts/z_lower_right/z_lower_right_v2.5.stl
production_parts/jigs/harness_test_fixture/taz_heat_bed_external_extention_harness.fcstd
production_parts/jigs/insert jigs/Y corners/y_corner_right_insert_jig_m3.stl
production_parts/jigs/TAZ6_frame_assy_fixture/2018_update/ClampHolder_milling_boxy_chamfer_holes.fcstd
production_parts/printed_parts/interconnect_housing/interconnect_housing_v0.6.stl
production_parts/printed_parts/z_lower_left/z_lower_left_v2.5.stl
production_parts/jigs/harness_test_fixture/taz_bed_external_harness_v2.stl
production_parts/jigs/insert jigs/Y corners/y_corner_right_insert_jig.stl
production_parts/printed_parts/lcd_knob/knob_depression.fcstd
production_parts/printed_parts/y_corner_left/y_corner_v2.4.fcstd
production_parts/jigs/insert jigs/Y corners/y_corner_left_insert_jig_m3.stl
production_parts/printed_parts/herringbone_large_gear_blk/source/Herringbone_gears.scad
production_parts/printed_parts/herringbone_large_gear_blk/source/Herringbone_gears_hi-res.scad
production_parts/printed_parts/herringbone_large_gear_blk/source/Herringbone_gears_hi-res_chamfer.scad
production_parts/printed_parts/herringbone_large_gear_grn/source/Herringbone_gears.scad
production_parts/assemblies/assembly_parts/12mm_drive_rod.fcstd
production_parts/assemblies/assembly_parts/510mm_extrusion.fcstd
production_parts/assemblies/assembly_parts/608_bearing.fcstd
production_parts/assemblies/assembly_parts/drive_nut.fcstd
production_parts/assemblies/assembly_parts/pulley.fcstd
production_parts/assemblies/assembly_parts/z_coupler.fcstd
production_parts/jigs/10mm_bushing_pusher.fcstd
production_parts/jigs/10mm_bushing_pusher.stl
production_parts/jigs/10mm_bushing_pusher_second_piece.stl
production_parts/jigs/12mm_drill_handle.fcstd
production_parts/jigs/12mm_drill_handle.stl
production_parts/jigs/12mm_drill_handle_small.fcstd
production_parts/jigs/12mm_drill_handle_small.stl
production_parts/jigs/190mm_spacer-v1.2.fcstd
production_parts/jigs/190mm_spacer-v1.2.stl
production_parts/jigs/40mmfan_115mm_wire_jig.fcstd
production_parts/jigs/40mmfan_115mm_wire_jig.stl
production_parts/jigs/40mmfan_150mm_wire_jig.fcstd
production_parts/jigs/40mmfan_150mm_wire_jig.stl
production_parts/jigs/40mmfan_65mm_wire_jig.stl
production_parts/jigs/80mmfan_100mm_wire_jig.fcstd
production_parts/jigs/80mmfan_100mm_wire_jig.stl
production_parts/jigs/TAZ6_Control_Box_Tie_Down_Jig/Taz6_Control_Box_Tie_Down_Jig.stl
production_parts/jigs/TAZ6_Control_Box_Tie_Down_Jig/Taz6_Control_Box_Tie_Down_Jig_v1.1.stl
production_parts/jigs/TAZ6_frame_assy_fixture/200mm_extrusion.fcstd
production_parts/jigs/TAZ6_frame_assy_fixture/400mm_extrusion.fcstd
production_parts/jigs/TAZ6_frame_assy_fixture/510mm_extrusion.fcstd
production_parts/jigs/TAZ6_frame_assy_fixture/520mm_extrusion.fcstd
production_parts/jigs/TAZ6_frame_assy_fixture/550mm_extrusion.fcstd
production_parts/jigs/TAZ6_frame_assy_fixture/580mm_extrusion.fcstd
production_parts/jigs/TAZ6_frame_assy_fixture/590mm_extrusion.fcstd
production_parts/jigs/TAZ6_frame_assy_fixture/clamp_holder.fcstd
production_parts/jigs/TAZ6_frame_assy_fixture/clamp_holder.stl
production_parts/jigs/TAZ6_frame_assy_fixture/extrusion_slider.fcstd
production_parts/jigs/TAZ6_frame_assy_fixture/extrusion_slider.stl
production_parts/jigs/TAZ6_frame_assy_fixture/frame_corner_slide_stop_bottom.fcstd
production_parts/jigs/TAZ6_frame_assy_fixture/frame_corner_slide_stop_bottom.stl
production_parts/jigs/TAZ6_frame_assy_fixture/frame_corner_slide_stop_top.fcstd
production_parts/jigs/TAZ6_frame_assy_fixture/frame_corner_slide_stop_top.stl
production_parts/jigs/TAZ6_frame_assy_fixture/frame_corner_stop.fcstd
production_parts/jigs/TAZ6_frame_assy_fixture/frame_corner_stop.stl
production_parts/jigs/TAZ_drive_rod_run_out_fixture/10mm_M5_thumbscrew_spacer.fcstd
production_parts/jigs/TAZ_drive_rod_run_out_fixture/10mm_M5_thumbscrew_spacer.stl
production_parts/jigs/TAZ_drive_rod_run_out_fixture/6mm_M5_thumbscrew_spacer.fcstd
production_parts/jigs/TAZ_drive_rod_run_out_fixture/6mm_M5_thumbscrew_spacer.stl
production_parts/jigs/TAZ_drive_rod_run_out_fixture/Drive_rod_run_out_fixture.fcstd
production_parts/jigs/TAZ_drive_rod_run_out_fixture/Drive_rod_run_out_fixture_headstock.fcstd
production_parts/jigs/TAZ_drive_rod_run_out_fixture/Drive_rod_run_out_fixture_headstock.stl
production_parts/jigs/TAZ_drive_rod_run_out_fixture/Drive_rod_run_out_fixture_headstock_sliding.stl
production_parts/jigs/TAZ_drive_rod_run_out_fixture/Drive_rod_run_out_fixture_tailstock.fcstd
production_parts/jigs/TAZ_drive_rod_run_out_fixture/Drive_rod_run_out_fixture_tailstock.stl
production_parts/jigs/TAZ_drive_rod_run_out_fixture/angled_headstock.stl
production_parts/jigs/TAZ_drive_rod_run_out_fixture/slider_mount.stl
production_parts/jigs/anti_skid_pad.stl
production_parts/jigs/bearing_palm_press_0.1.fcstd
production_parts/jigs/bearing_palm_press_0.1.stl
production_parts/jigs/bed_spacer_from_control_box_135mm.fcstd
production_parts/jigs/bed_spacer_from_control_box_135mm.stl
production_parts/jigs/control_box_test_fixture/Control_box_test_fixture_front.stl
production_parts/jigs/control_box_test_fixture/Control_box_test_fixture_front_0.1.stl
production_parts/jigs/control_box_test_fixture/Control_box_test_fixture_top.stl
production_parts/jigs/control_box_test_fixture/Control_box_test_fixture_top_plate.stl
production_parts/jigs/control_box_test_fixture/control_box_test_fixture_front_0.1.fcstd
production_parts/jigs/control_box_test_fixture/control_box_test_fixture_top.fcstd
production_parts/jigs/control_box_test_fixture/frame_T.stl
production_parts/jigs/control_box_test_fixture/frame_corner.fcstd
production_parts/jigs/control_box_test_fixture/frame_corner.stl
production_parts/jigs/control_box_test_fixture/frame_corner_41.5_degree.fcstd
production_parts/jigs/control_box_test_fixture/frame_corner_41.5_degree.stl
production_parts/jigs/control_box_test_fixture/frame_corner_48.5_degree.stl
production_parts/jigs/control_box_test_fixture/heater_pwm_fan_test_ext.fcstd
production_parts/jigs/control_box_test_fixture/heater_pwm_fan_test_ext.stl
production_parts/jigs/control_box_test_fixture/stepper_arrow_wheel.fcstd
production_parts/jigs/control_box_test_fixture/stepper_arrow_wheel.stl
production_parts/jigs/control_box_test_fixture/stepper_arrows.stl
production_parts/jigs/double_box_handle_adhesive_jig.fcstd
production_parts/jigs/double_box_handle_adhesive_jig.stl
production_parts/jigs/extrusion_slider.fcstd
production_parts/jigs/extrusion_slider.stl
production_parts/jigs/harness_test_fixture/taz_Y_Z_Z_external_harness.fcstd
production_parts/jigs/harness_test_fixture/taz_Y_Z_Z_external_harness_proto_board_plate.fcstd
production_parts/jigs/harness_test_fixture/taz_Y_Z_Z_external_harness_proto_board_plate.stl
production_parts/jigs/harness_test_fixture/taz_bed_external_harness.stl
production_parts/jigs/harness_test_fixture/taz_dual_harness.fcstd
production_parts/jigs/harness_test_fixture/taz_dual_harness.stl
production_parts/jigs/harness_test_fixture/taz_dual_harness_internal.fcstd
production_parts/jigs/harness_test_fixture/taz_dual_harness_internal.stl
production_parts/jigs/harness_test_fixture/taz_heat_bed_external_extention_harness.stl
production_parts/jigs/harness_test_fixture/taz_heat_bed_external_extention_harness_plate.fcstd
production_parts/jigs/harness_test_fixture/taz_heat_bed_external_extention_harness_plate.stl
production_parts/jigs/harness_test_fixture/taz_heat_bed_external_harness.fcstd
production_parts/jigs/harness_test_fixture/taz_x_axis_external_harness.fcstd
production_parts/jigs/harness_test_fixture/taz_x_axis_external_harness.stl
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
