gralco/TAZ6/documentation/manual/source/Software.tex

%
% Software.tex
%
% LulzBot TAZ User Manual
%
% Copyright (C) 2015 Aleph Objects, Inc.
%
% This document is licensed under the Creative Commons Attribution 4.0
% International Public License (CC BY-SA 4.0) by Aleph Objects, Inc.
%

\section{Software Overview}
\index{software}

To operate your desktop 3D printer you will need to install a few software packages onto your PC. You will need a 3D printer host, an \texttt{.STL} to \texttt{.GCODE} generator, and optional CAD or 3D modeling software.

\texttt{Cura LulzBot Edition is the recommended software for your LulzBot 3D printer.} Download Cura LulzBot Edition by visiting \texttt{LulzBot.com/Cura}.

\glossary{.GCODE}{The file extension for G-Code files}
\glossary{GCODE}{The common name for the most widely used CNC programming language.}
\glossary{CAD}{Computer Aided Design}

\index{GNU/Linux}
\index{OS X}
\index{Windows}
\index{operating system}
All of the following Free/Libre Software packages are available for GNU/Linux, Windows, and OS X. We highly recommend using these programs on GNU/Linux.

\section{Software Types}
\index{printer hosts}
\index{slicing}
\index{slicers}
\index{GCODE}
\index{g-code}
\index{.gcode}
\index{.gco}

\begin{description}
\item{Printer Hosts} \hfill \\
Printer Host software is used to control the 3D printer. The program not only allows you to manually move the printer along all the axes, but set temperatures manually, send commands, and receive feedback/error messages from the onboard electronics. We recommend that new users start with Cura LulzBot Edition as it includes a slicing engine as well.

\item{\texttt{Slicers}} \hfill \\
These programs take the 3-Dimensional model (typically STL/OBJ/etc) and determine the 3D printer toolpath based on the options selected. The slicing engine uses the nozzle diameter, movement speeds, layer height, and other variables to determine the coordinates where it needs to move, and the rates at which it will do so. This information is exported out of the program as a GCODE file. The GCODE file is a plain-text file with a series of text-based codes and a list of the complete X,Y, and Z-axis coordinates used for printing the 3D model. We recommend that new users start with Cura LulzBot Edition as it includes the printer host as well.

%Recommended Slicers:
%\begin{itemize}
%\item Cura LulzBot Edition
%\item Slic3r
%\item Skeinforge
%\item Sfact
%\end{itemize}

\end{description}

\index{download}
\index{driver}
\section{Installing Drivers}
GNU/Linux and OS X users will not need to install a driver to communicate with the LulzBot TAZ 3D printer. Windows users will need to install the drivers. Using Cura LulzBot Edition as your printer host and slicing software is recommended, as the drivers will automatically be installed during the Cura installation process. Download Cura LulzBot Edition by visiting \texttt{LulzBot.com/Cura}. The drivers can also be downloaded from \texttt{LulzBot.com/downloads}. A visual guide showing the driver installation process can be found in our download section as well.

\section{CAD and 3D Modeling Software}
\index{CAD}
\index{STL}

LulzBot is not distributing a CAD or 3D modeling software package. However, multiple Free/Libre Software packages are available. Other common non-free CAD and 3D modeling software are also capable of exporting the required \texttt{.STL} files.

On some CAD and 3D modeling software you will need to select millimeters as the output unit. If possible it is best to build your 3D design in metric units rather than imperial units. Cura requires .STL/.OBJ files sized in millimeters. If an .STL/.OBJ with inches as units is loaded into Cura, the model will be scaled much smaller than expected. You can scale the model by \texttt{25.40} to compensate. The software listed below outputs millimeters as the unit by default.

\subsection{FreeCAD}
\index{FreeCAD}
\index{GNU/Linux}
\index{Windows}
\index{OS X}
Website: \texttt{http://www.freecadweb.org/}

Although still in development, contains a full GUI for building CAD models. FreeCAD is capable of creating simple to complex designs. STL files can also easily be exported for use with 3D printing. FreeCAD is available for GNU/Linux, Windows, and OS X. The latest development version is recommended.

\subsection{OpenSCAD}
\index{OpenSCAD}
\index{GNU/Linux}
\index{Windows}
\index{OS X}
Website: \texttt{http://openscad.org}

OpenSCAD is different than FreeCAD in that it is script based. Rather than using a GUI to generate CAD designs, OpenSCAD CAD designs are created using script based renderings. Users with programming experience would find this useful. Also, OpenSCAD uses a simple script language that is easy for users with little or no programming experience to learn.

\subsection{Blender}
\index{Blender}
\index{GNU/Linux}
\index{Windows}
\index{OS X}
Website: \texttt{http://blender.org}

The most widely used Free/Libre Software 3D modeling software, Blender is well documented with tutorials available on the Blender.org website as well as found online.

\begin{comment} %% Turning off as Shapesmith is no longer actively maintained.
\subsection{\texttt{Shapesmith}}
\index{Shapesmith}
Website: \texttt{http://shapesmith.net}

Shapesmith is a web-based 3D modeling software. This means there is no required software to get started designing models. Shapesmith is also a great choice for anyone starting out in CAD/ 3D modeling.
\end{comment}

\section{Alternative Printer Host Software}
\index{printer host}
\index{software}
\index{STL}

\subsection{OctoPrint}
\index{OctoPrint}
\index{GNU/Linux}
\index{Windows}
\index{OS X}
Website: \texttt{http://octoprint.org/}

Octoprint is a printer host that uses a web-based interface to access and control your 3D printer. Added web-cam functionality allows for time-lapse videos and a live stream. Octoprint will run on GNU/Linux, Windows, OS X based computers and can even run well on a Beagle Bone Black or a RaspberryPi (inexpensive business-card sized computers).

\subsection{BotQueue}
\index{BotQueue}
\index{GNU/Linux}
\index{OS X}
Website: \texttt{https://www.botqueue.com/}

BotQueue works well for those users wanting to have a web-based multiple 3D printer operation running off a queuing system.

\subsection{MatterControl}
\index{MatterControl}
%\index{GNU/Linux}
\index{Windows}
\index{OS X}
Website: \texttt{http://www.mattercontrol.com/}

MatterControl is another printer host that currently runs on GNU/Linux, Windows, and OS X. It features 2D and 3D model viewing, a print queue, and print file organization and searching.

\subsection{Source Files}
\index{source files}
Aleph Objects, Inc., the maker of the LulzBot TAZ 3D printer, completely supports Free Software, Libre Innovation, and Open Source Hardware. Along with the LulzBot TAZ 3D printer being a Free Software and Open Source Hardware design, it has been tested to work with 100\% Free/Libre Software. Our source code and design files are hosted on:

\begin{description}
\item [LulzBot Download Server] \texttt{http://download.lulzbot.com}
\item [LulzBot Development Server] \texttt{http://devel.lulzbot.com}
\item [Aleph Objects Code Repository] \texttt{http://code.alephobjects.com}
%\item [Aleph Objects Download Server] \texttt{http://download.alephobjects.com}
%\item [Aleph Objects Development Server] \texttt{http://devel.alephobjects.com}
\end{description}

\glossary{Free Software}{Free Software (or Free/Libre Software) can be thought of as ``free as in free speech, not just free as in free beer'', although most Free Software is available for no cost. Free Software can be copied, modified and is freely available for download.}
\glossary{Libre Innovation}{Aleph Objects uses Free/Libre Software to build and improve Open Source Hardware so that everything we create is free to be viewed, copied, and/or modified by anyone.}
\glossary{Open Source Hardware}{Open source hardware is hardware whose design is made publicly available so that anyone can study, modify, distribute, make, and sell the design or hardware based on that design. The hardware source, the design from which it is made, is available in the preferred format for making modifications to it. For more information visit \texttt{http://www.oshwa.org/definition/}.}
