gralco/TAZ6/documentation/manual/source/slic3r/FirstLayer.tex

%!TEX root = Slic3r-Manual.tex

\subsection{\texttt{The Important First Layer}}
\label{sec:the_important_first_layer}
\index{First Layer}
Before delving into producing the first print it is worthwhile taking a little detour to talk about the importance of getting the first layer right.  As many have found through trial and error, if the first layer is not the best it can be then it can lead to complete failure, parts detaching, and warping.  There are several techniques and recommendations one can heed in order to minimise the chance of this happening.

\paragraph{\texttt{Level bed.}} % (fold)
\label{par:level_bed}
Having a level bed is critical.  If the distance between the nozzle tip and the bed deviates by even a small amount it can result in either the material not lying down on the bed (because the nozzle is too close and scrapes the bed instead), or the material lying too high from the bed and not adhering correctly.
% paragraph level_bed (end)

\paragraph{\texttt{Higher temperature.}} % (fold)
\label{par:higher_temperature}
The extruder hot-end and bed, if it is heated, can be made hotter for the first layer, thus decreasing the viscosity of the material being printed.  As a rule of thumb, an additonal 5° is recommended.
% paragraph higher_temperature (end)

\paragraph{\texttt{Lower speeds.}} % (fold)
\label{par:lower_speeds}
Slowing down the extruder for the first layer reduces the forces applied to the molten material as it emerges, reducing the chances of it being stretched too much and not adhering correctly.  30\% or 50\% of the normal speed is recommended.
% paragraph lower_speeds (end)

\paragraph{\texttt{Correctly calibrated extrusion rates.}} % (fold)
\label{par:correct_extrusion_settings}
If too much material is laid down then the nozzle may drag through it on the second pass, causing it to lift off the bed (particularly if the material has cooled).  Too little material may result in the first layer coming loose later in the print, leading either to detached objects or warping.  For these reasons it is important to have a well-calibrated extrusion rate as recommended in §\ref{calibration}).
% paragraph correct_extrusion_settings (end)

\paragraph{\texttt{First layer height.}} % (fold)
\label{par:first_layer_height}
A thicker layer height will provide more flow, and consequently more heat, making the extrusion adhere to the bed more.  It also gives the benefit of giving more tolerance for the levelness of the bed.  It is recommended to raise the first layer height to match the diameter of the nozzle, e.g. a first layer height of 0.35mm for a 0.35mm nozzle.
Note: The first layer height is set this way automatically in simple mode.
% paragraph first_layer_height (end)

\paragraph{\texttt{Fatter extrusion width.}} % (fold)
\label{par:wider_extrusion_width}
The more material touching the bed, the better the object will adhere to it, and this can be achieved by increasing the extrusion width of the first layer, either by a percentage or a fixed amount.  Any spaces between the extrusions are adjusted accordingly.

A value of approximately 200\% is usually recommended, but note that the value is calculated from the layer height and so the value should only be set if the layer height is the highest possible.  For example, if the layer height is 0.1mm, and the extrusion width is set to 200\%, then the actual extruded width will only be 0.2mm, which is smaller than the nozzle.   This would cause poor flow and lead to a failed print.  It is therefore highly recommended to combine the high first layer height technique recommended above with this one. Setting the first layer height to 0.35mm and the first extrusion width to 200\% would result in a nice fat extrusion 0.65mm wide.
% paragraph wider_extrusion_width (end)

\paragraph{\texttt{Bed material.}} % (fold)
\label{par:bed_material}
Many options exist for the material to use for the bed, and preparing the right surface can vastly improve first layer adhesion.

PLA is more forgiving and works well on PEI, PET, Kapton, or blue painters tape.

ABS usually needs more cajoling. While it's generally preferred to print directly on the PEI surface, a watered-down PVA or white school-glue solution can help prints adhere to the bed and is preferred. \textcolor{red}{Never use anything with acetone on the PEI print surface as it can degrade the PEI material}. 
% paragraph bed_material (end)

\paragraph{\texttt{No cooling.}} % (fold)
\label{par:no_cooling}
Directly related with the above, it makes no sense to increase the temperature of the first layer and still have a fan or other cooling mechanism at work.  Keeping the fan turned off for the first few layers is generally recommended.
% paragraph no_cooling (end)
