gralco/TAZ6/production_docs/Packing_list_v6.1_Print_Shop.odt

Model: LulzBot TAZ 6 3D Printer

Serial Number:

Date Completed:

Completed by:

Items to include:

Printer and Cables:

- LulzBot TAZ 6 3D printer
- 1.83 meter (6ft) 18AWG North America Power Cord Cable
- 1.83 meter (6ft) 18AWG United Kingdom Power Cord Cable (If applicable)
- 1.83 meter (6ft) 18AWG Europe Power Cord Cable (If applicable)
- 1.83 meter (6ft) 18AWG Australia Power Cord Cable (If applicable)
- USB cord
- Filament guide tube with mounting clip
- Tool head assembly

Supplies:

- SD Card with source files
- Tool kit
- Sample filament
- LulzBot sticker

Documentation:

- Unboxing guide
- Operating guide
- Test acceptance record
- Packing list
- User manual
- EC Declaration of Conformity
- Safety and warning sheet
- Modification warning

Final Print:

- Octopus printed by this LulzBot TAZ 3D Printer. Octopus_v18 by yeoldbrian is licensed under CC BY-SA 4.0

Packing List
