gralco/TAZ6/sample_prints/index.html

# Index of /TAZ/Olive/sample_prints

(ICO) | Name | Last modified | Size | Description
(PARENTDIR) | Parent Directory | | -
(DIR) | LulzBot/ | 2016-09-16 21:57 | -
(TXT) | README.html | 2016-09-16 21:57 | 1.4K
(DIR) | benchmarks/ | 2016-09-16 21:57 | -
(DIR) | calibration/ | 2018-09-17 19:19 | -
(DIR) | functional/ | 2016-09-16 21:57 | -
(DIR) | modifications/ | 2016-09-16 21:57 | -
(DIR) | novelties/ | 2016-09-16 21:57 | -

About Sample Prints

This directory contains freely licensed sample prints for your LulzBot TAZ 6 desktop 3D printer. Each one comes with four files:

- Attribution: Credit to the original creator of the model.
- License: The copyleft terms that protect this model file and ensure it can be freely used.
- STL: Model files that can be edited in your 3D modeling software of choice and/or uploaded into Cura LulzBot Edition.
- GCODE: Printing files prepared with Cura LulzBot Edition quickprint profiles, based on the STL.

All GCODE in this directory is generated from nGen (colorFabb) quickprint profiles in Cura LulzBot Edition. To learn more about the software used to run your LulzBot TAZ 6, visit LulzBot.com/Cura

nGen is the default material for the LulzBot TAZ 6. nGen is a co-polyester filament made from Eastman Amphora 3300. To learn more about nGen and other materials, visit LulzBot.com/filament

If you are experiencing issues printing these files, contact technical support by emailing support@lulzbot.com or by calling +1-970-377-1111. Find a list of regional phone numbers by visiting LulzBot.com/contact
