gralco/TAZ6/production_parts/assemblies/index.html

# Index of /TAZ/Olive/production_parts/assemblies

(ICO) | Name | Last modified | Size | Description
(PARENTDIR) | Parent Directory | | -
(TXT) | README.txt | 2017-02-20 23:19 | 384
(DIR) | assembly_parts/ | 2017-02-20 23:19 | -
( ) | electronics_case_assembly.fcstd | 2017-02-20 23:19 | 470K
( ) | electronics_case_assembly.fcstd1 | 2017-02-20 23:19 | 245K
( ) | taz_full_assembly.fcstd | 2017-02-20 23:19 | 13M
( ) | taz_full_assembly.fcstd1 | 2017-02-20 23:19 | 13M
( ) | y_axis_assembly.fcstd | 2017-02-20 23:19 | 1.3M
( ) | y_axis_assembly.fcstd1 | 2017-02-20 23:19 | 1.3M
( ) | z_axis_assembly_left.fcstd | 2017-02-20 23:19 | 817K
( ) | z_axis_assembly_left.fcstd1 | 2017-02-20 23:19 | 817K
( ) | z_axis_assembly_right.fcstd | 2017-02-20 23:19 | 594K
( ) | z_axis_assembly_right.fcstd1 | 2017-02-20 23:19 | 594K
( ) | z_axis_frame_assembly.fcstd | 2017-02-20 23:19 | 1.5M
( ) | z_axis_frame_assembly.fcstd1 | 2017-02-20 23:19 | 1.5M
( ) | z_frame_assembly.fcstd | 2017-02-20 23:19 | 82K
