gralco/TAZ6/sample_prints/functional/index.html

# Index of /TAZ/Olive/sample_prints/functional

(ICO) | Name | Last modified | Size | Description
(PARENTDIR) | Parent Directory | | -
(DIR) | mobile_device_rack/ | 2016-09-16 21:57 | -
