gralco/TAZ6/sample_prints/modifications/index.html

# Index of /TAZ/Olive/sample_prints/modifications

(ICO) | Name | Last modified | Size | Description
(PARENTDIR) | Parent Directory | | -
(DIR) | spool_mount/ | 2016-09-16 21:57 | -
