gralco/TAZ6/production_parts/machined_parts/0.5mm_hotend_assembly_single_v2/index.html

# Index of /TAZ/Olive/production_parts/machined_parts/0.5mm_hotend_assembly_single_v2

(ICO) | Name | Last modified | Size | Description
(PARENTDIR) | Parent Directory | | -
( ) | 0.5mm_hotend_assem_single_v2.fcstd | 2019-02-22 15:49 | 494K
( ) | 0.5mm_hotend_assem_single_v2.odg | 2019-02-22 15:49 | 183K
( ) | 0.5mm_hotend_assem_single_v2.pdf | 2019-02-22 15:49 | 333K
( ) | HEATER_CARTRIDGE.fcstd | 2019-02-22 15:49 | 12K
( ) | MOARstruder-heatbreak_PP-MP0152_revA.fcstd | 2019-02-22 15:49 | 391K
( ) | MOARstruder-heatsink_PP-MP0151_revA.fcstd | 2019-02-22 15:49 | 320K
( ) | V6 Nozzle.stp | 2019-02-22 15:49 | 22K
( ) | m3_setscrew.fcstd | 2019-02-22 15:49 | 14K
( ) | molex_2pos_male.fcstd | 2019-02-22 15:49 | 202K
( ) | some_struder_heater_block.fcstd | 2019-02-22 15:49 | 355K
( ) | somestruder_retention_plate.fcstd | 2019-02-22 15:49 | 39K
( ) | thermistor.fcstd | 2019-02-22 15:49 | 12K
