gralco/TAZ6/production_docs/OHAI/03_ControlBoxWiring-OHAI-T6.pdf

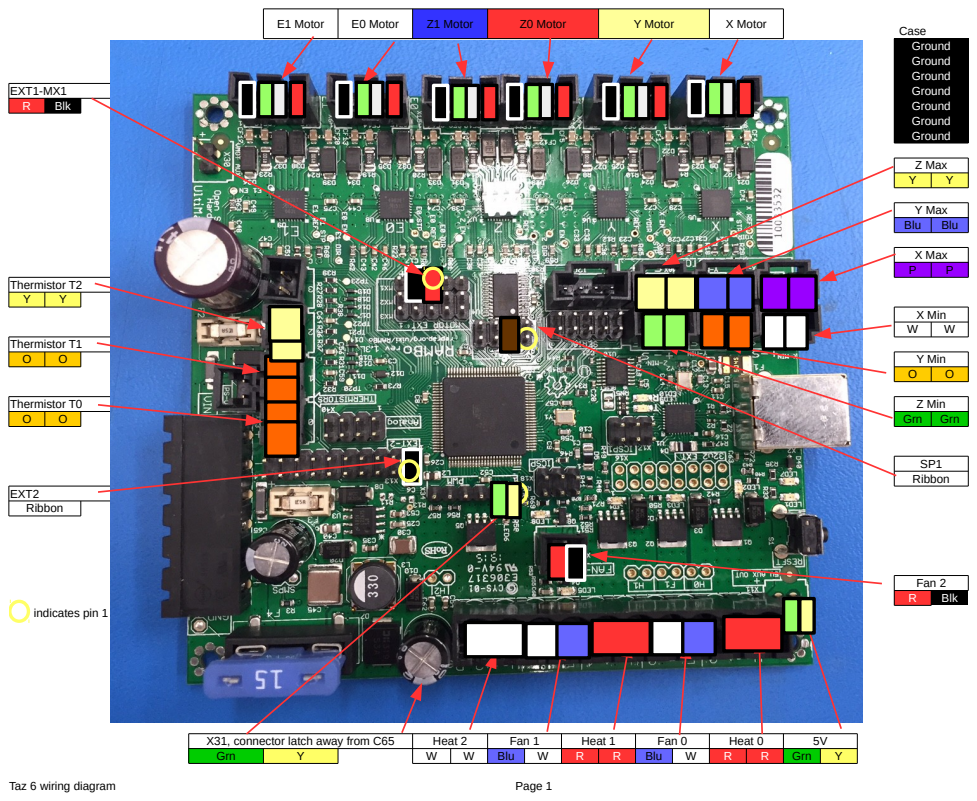
[picture p332: page 1]
Taz 6 wiring diagram; Page 1; E1 Motor; E0 Motor; Z1 Motor; Z0 Motor; Y Motor; X Motor; Case; Ground Ground Ground; EXT1-MX1; Ground; Blk; Ground Ground; Z Max; Y Max; Blu; X Max; Thermistor T2; X Min; Thermistor T1; Y Min; Thermistor T0; Z Min; Grn; SP1 Ribbon; EXT2 Ribbon; Fan 2; indicates pin 1

X31, connector latch away from C65 | Heat 2 | Fan 1 | Heat 1 | Fan 0 | Heat 0 | 5V
Grn | Y | | W | W | Blu | W | R | R | Blu | W | R | R | Grn | Y

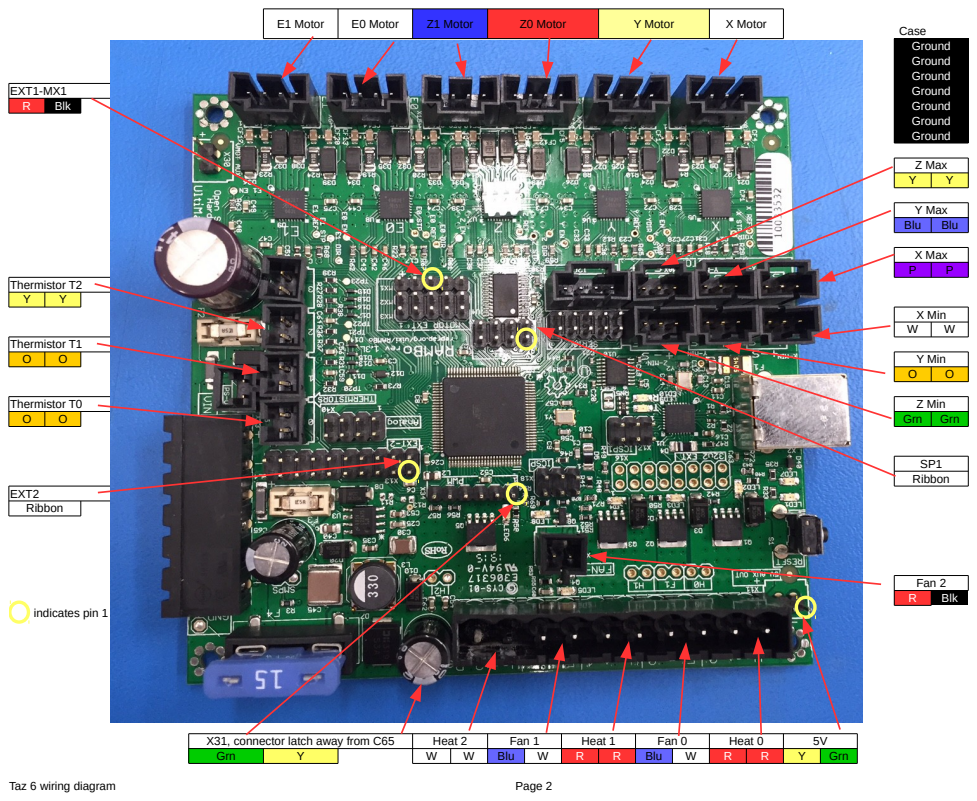
[picture p333: page 2]
E1 Motor; E0 Motor; Z1 Motor; Z0 Motor; Y Motor; X Motor; Case; Ground Ground Ground; EXT1-MX1; Ground; Blk; Ground Ground; Z Max; Y Max; Blu; X Max; Thermistor T2; X Min; Thermistor T1; Y Min; Thermistor T0; Z Min; Grn; SP1 Ribbon; EXT2 Ribbon; Fan 2; indicates pin 1

X31, connector latch away from C65 | Heat 2 | Fan 1 | Heat 1 | Fan 0 | Heat 0 | 5V
Grn | Y | | W | W | Blu | W | R | R | Blu | W | R | R | Y | Grn

EL-HR0088 | Z1 Motor | Z0 Motor | Y Motor

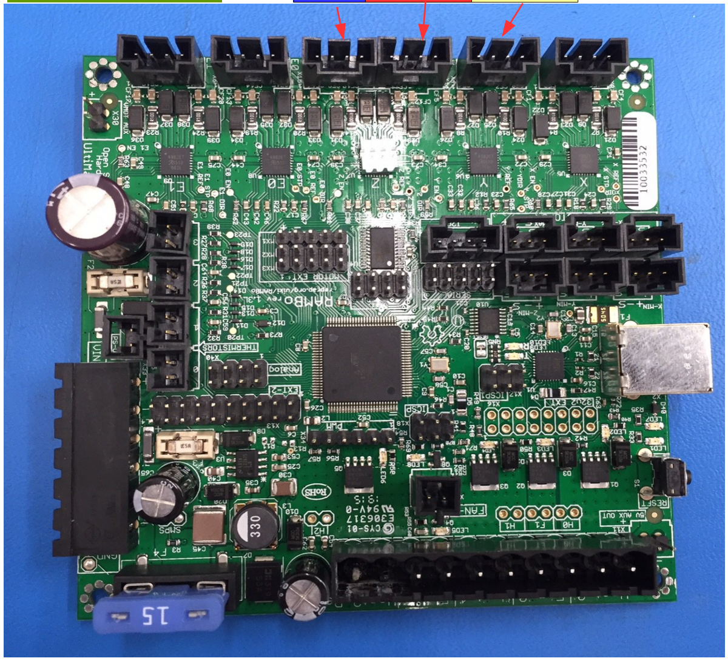
[picture p334: figure]

EL-HR0084 | X Motor | Case

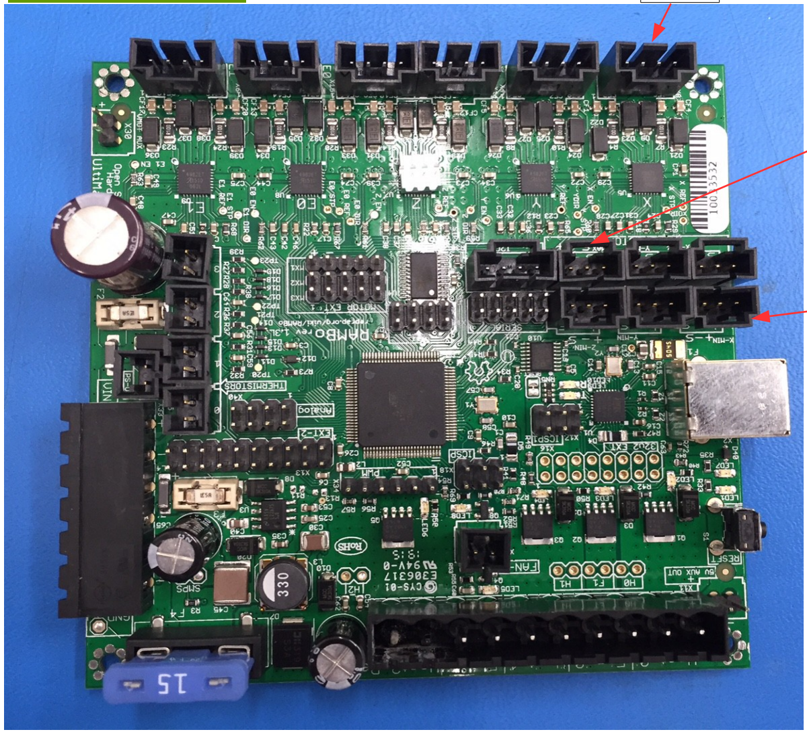
[picture p335: figure]

| | Ground

Z Max
Y Y

X Min
W W

## EL-HR0081

Case
Ground

EXT1-MX1
R

Y Max
Blu Blu

Thermistor T2
Y Y

Y Min
O O

Z Min
Grn Grn

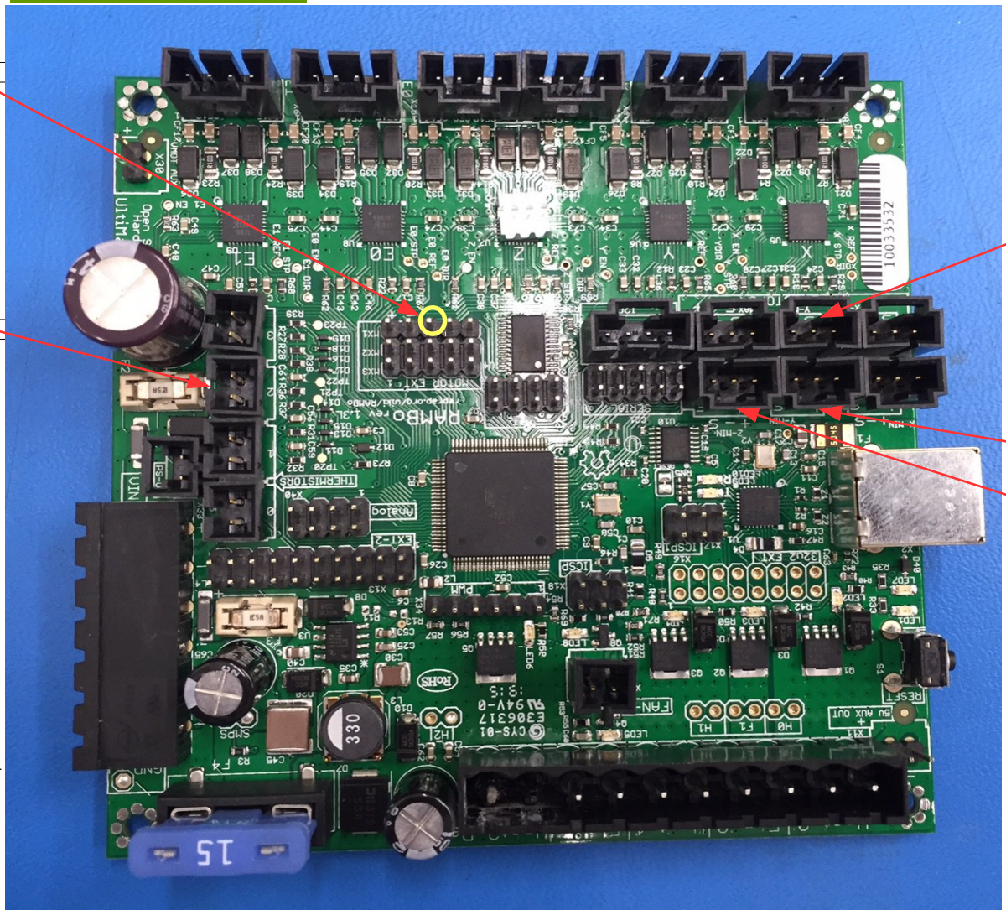
[picture p336: figure]

indicates pin 1

do not connect at
this time, connect
to EL-HR0087
before connecting
to EXT1-MX1

E0 Motor | EL-HR0087 | Case
| | Ground

EXT1-MX1
Blk

X Max
P P

Thermistor T0
O O

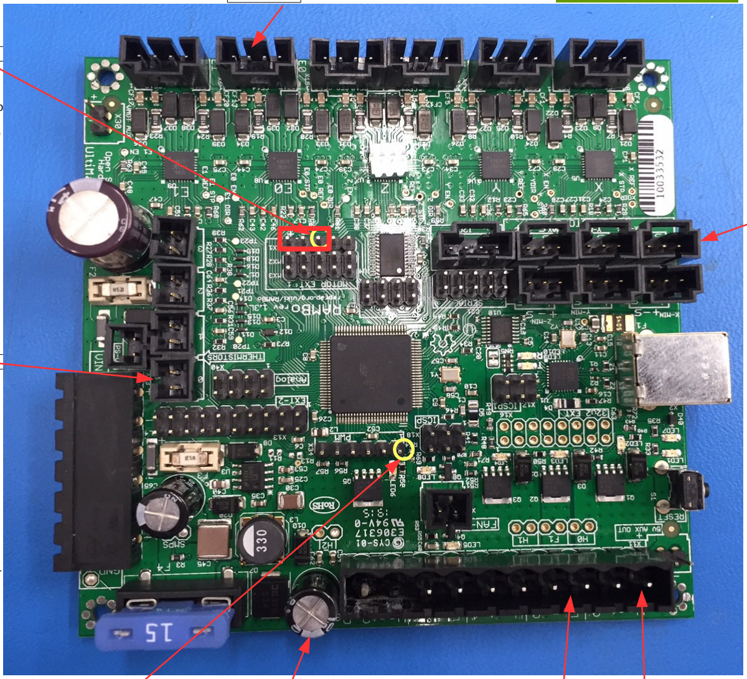
[picture p337: figure]

indicates pin 1

X31, connector latch away from C65 | Fan 0 | Heat 0
Grn | Y | Blu | W | R | R

Connect red wire
from EL-HR0081 to
the 3pin connector
before attaching to
MX1 header

E1 Motor | EL-HR0095 | Case
| | Ground

Thermistor T1
O O

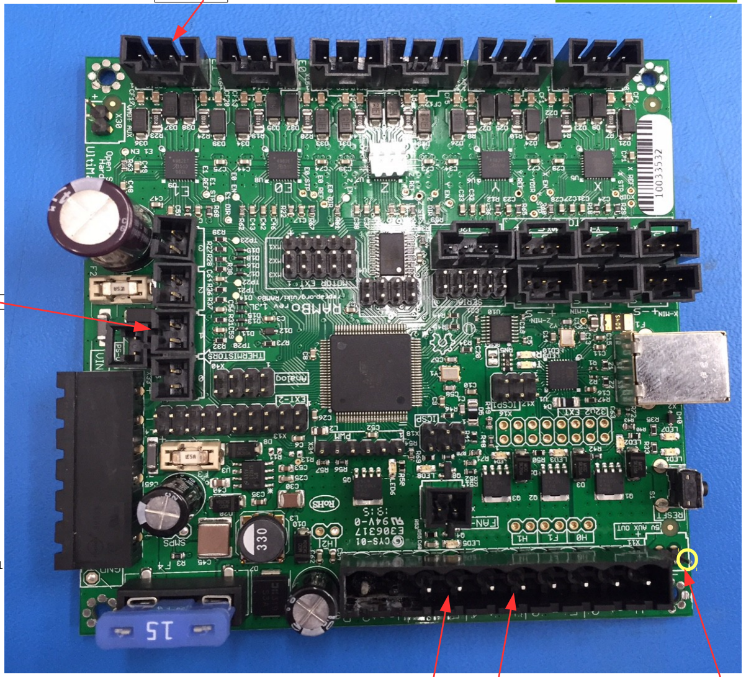
[picture p338: figure]

indicates pin 1

Fan 1 | Heat 1 | 5V
Blu | W | R | R | Y | Grn

## EL-HR0097

SP1
Ribbon
EXT2
Ribbon

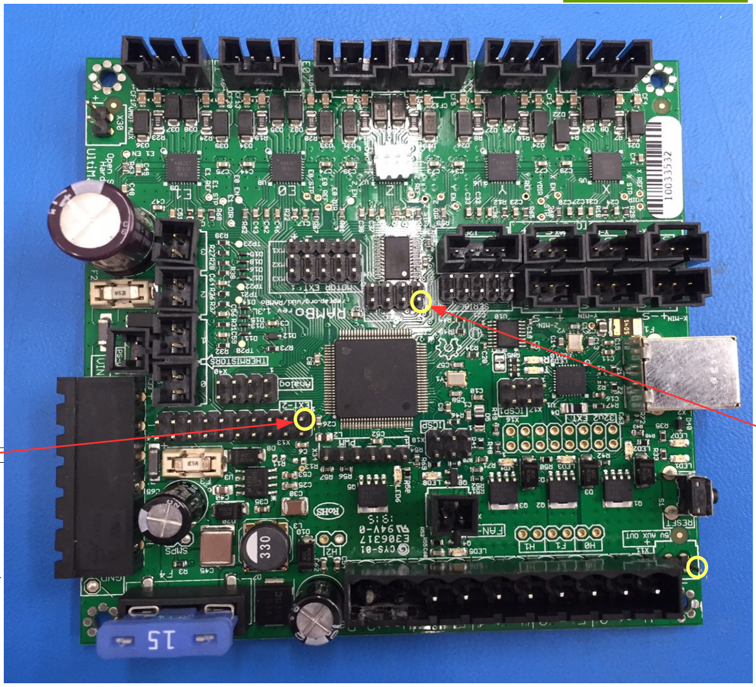
[picture p339: figure]

indicates pin 1

CASE FAN
Fan 2
R Blk

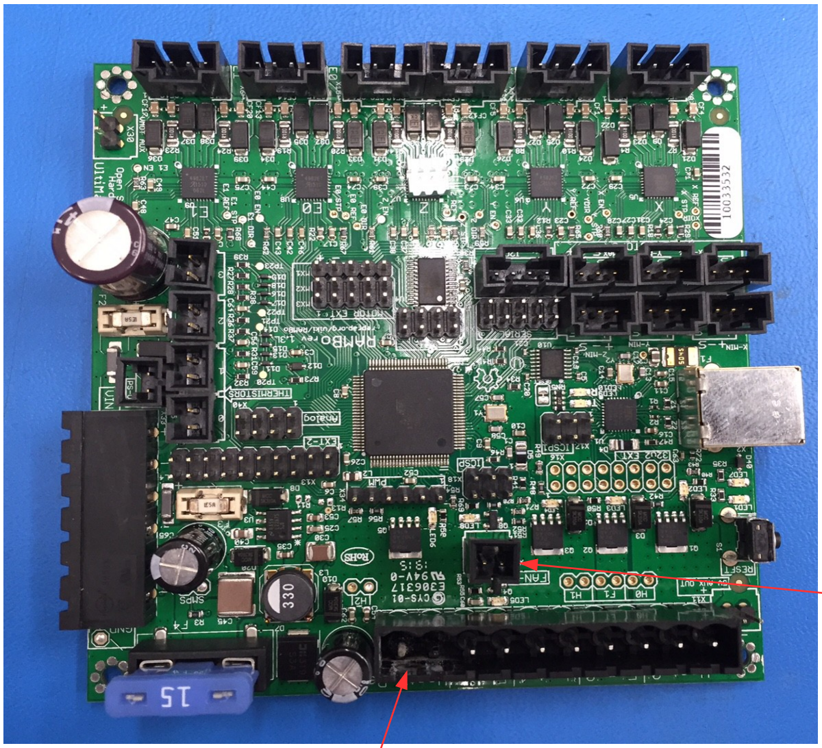
[picture p340: figure]

Heat 2
W W
EL-HR0082

EL-HR0088 CB Y-Z HarnesRambo | EL-HR0084 CB X Harness | EL-HR0081 CB Bed Harness | EL-HR0087 CB Extruder Harness
#1 | Red

Z0 Motor
| | #2 | Red
X Motor
#3 | Yellow | Thermistor T2 | #4 | Red

Motor Harness | E0 Motor White | X Harness | White | Yellow | White
Green | Green | Green
Black | Black | Green | Z Min | Black
| | | | Green
Red
Y Motor
Yellow | Z Max | EXT1- MX1 White | Yellow | Blue | Y Max | Black
Green | | | | | Blue
Black | White | X Min | Red | Heat 0 White | Orange | Y Min | Red

Red
Z1 Motor
| | | | | Orange
White | Black | Ground | Blue | Fan 0 Green | EXT1- MX1 | White
Black | | | | | Red
Yellow
Black | Ground | Black | Ground | Green
Connect Red wire to EL0HR0087 | Orange | Thermistor T0 at PC-CN0003 2Pin housing | Orange
Z1 | Y | Z0 | at pin 1
Purple | X Max Purple
Black | Ground
EL-HR0095 CB Dual Extruder Harness | EL-HR0097 CB LCD Harness | Case Fan
#5 | Red

E1 Motor
#6 | Gray

EXT2

#7 | Red | Fan 2 White | Gray | Case Fan | Black | 1 | EL-HR0088 CB Y-Z Harness

Green | Blue | 2 | EL-HR0084 CB X Harness
Black | Green | 3 | EL-HR0081 CB Bed Harness
EXP2 on LCD Orange | EL-HR0082 CB Bed Power Harness | 4 | EL-HR0095 CB Dual Extruder Harness
Blue | Fan 1 | Red | #8 | 5 | EL-HR0087 CB Extruder Harness
White | Pink | Heat Bed | White | Heat 2 | 6 | EL-HR0097 CB LCD Harness
Brown | White | 7 | Case Fan
Red | Heat 1 | 8 | EL-HR0082 CB Bed Power Harness
Red | Black

SP1

9 | EL-HR0074 CB DC Power Harness
White | EL-HR0074 CB DC Power Harness | 10 EL-HR0080 CB Plug to Switch Harn.
Yellow | 5V | Gray | #9 | PS | V In
Green | Gray

EXP1 on LCD

Blue
Orange | Thermistor T1 | Green | EL-HR0080 CB Plug to Switch Harn.
Orange | Orange | #10 | PS | Power Switch | SEQUENCE MUST BE FOLLOWED;
Red | NO ALTERATIONS OF WIRING OR
Black | Ground | Pink | ROUTING OF WIRES IS PERMITTED!
Brown

Pin 1 to Pin 1, both connectors

X31, connector
latch toward
C65

Cable installation &
Connection sequence
Extruder
Harness

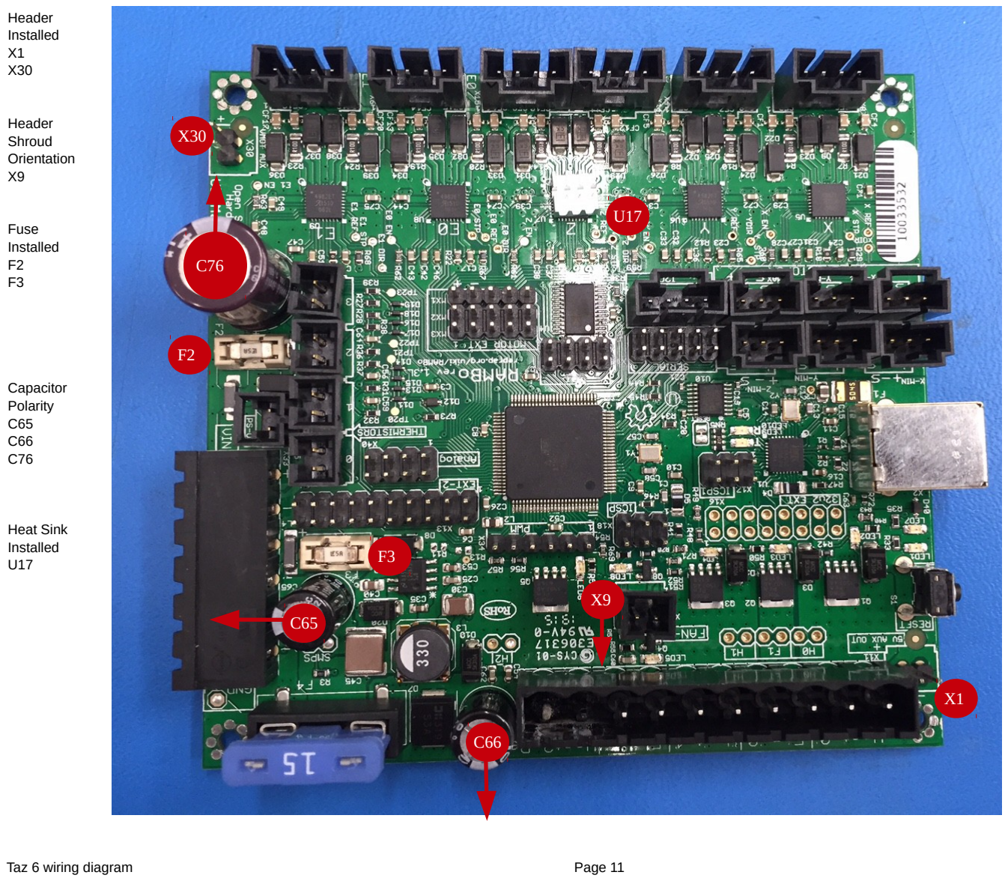
[picture p341: page 11]

Header
Installed
X1
X30

Header
Shroud
Orientation
X9

Fuse
Installed
F2
F3

Capacitor
Polarity
C65
C66
C76

Heat Sink
Installed
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
