gralco/TAZ6/production_docs/OHAI/TAZ6_OHAI_SequenceOfOperations.pdf

Sequence of Operations for building a TAZ 6.0

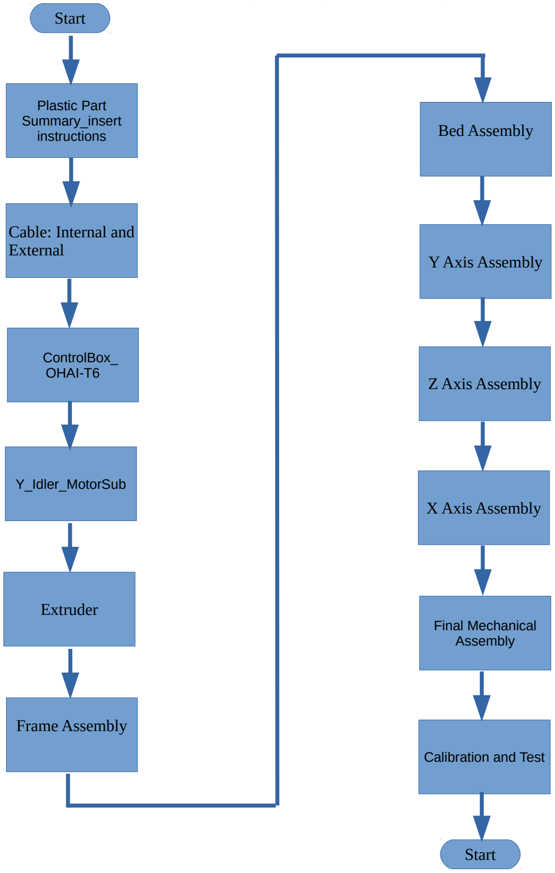
[picture p354: figure]
Y Axis Assembly; Z Axis Assembly; Frame Assembly; Cable: Internal and External; Plastic Part Summary_insert; instructions; Bed Assembly; Y_Idler_MotorSub; ControlBox_ OHAI-T6; Extruder; Final Mechanical Assembly; Calibration and Test; Start; X Axis Assembly

1) references to “hand tight” refer to the torque that can be applied to a screw with a screw driver, and hand tight roughly equates to 8 in-lbs or .9 N-m
2) references to “finger tight” refer to the torque that can be applied to a screw with a screw driver, and hand tight roughly equates to 5 in-lbs or .56 N-m
