gralco/TAZ6/documentation/manual/9780989378482_exterior_r6_02.pdf

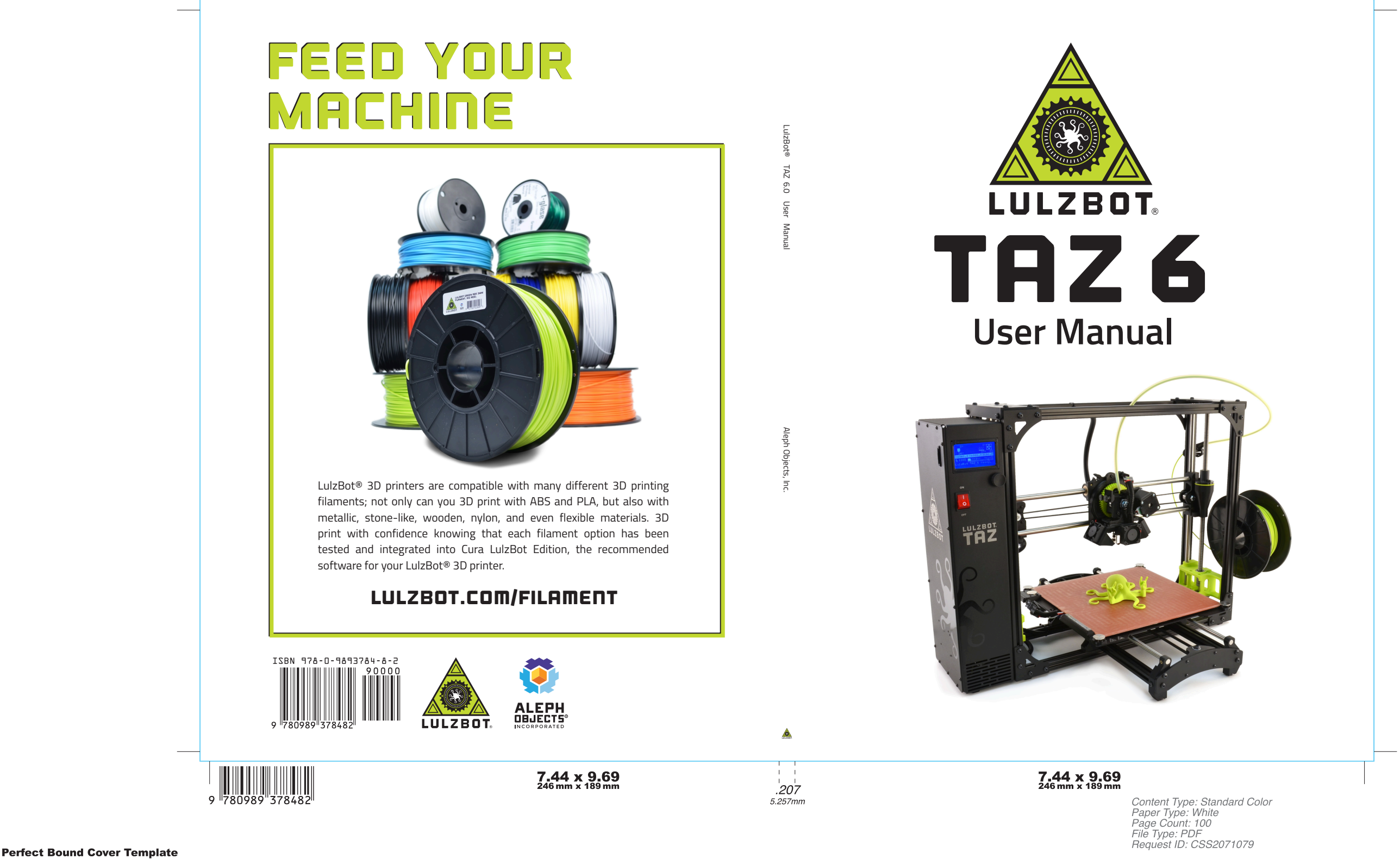
[picture p355: figure]
User Manual; FEED your mACHINE; LULZBOT.COM/FILAMENT; software for your LulzBot® 3D printer.; FEED your

LulzBot® 3D printers are compatible with many different 3D printing filaments; not only can you 3D print with ABS and PLA, but also with metallic, stone-like, wooden, nylon, and even flexible materials. 3D print with confidence knowing that each filament option has been tested and integrated into Cura LulzBot Edition, the recommended

mACHINE | LulzBot® TAZ 6.0 User Manual Aleph Objects, Inc.
