gralco/TAZ6/documentation/manual/source/Colophon.tex

%
% Colophon.tex
%
% LulzBot TAZ User Manual
%
% Copyright (C) 2015 Aleph Objects, Inc.
%
% This document is licensed under the Creative Commons Attribution 4.0
% International Public License (CC BY-SA 4.0) by Aleph Objects, Inc.
%

%%% COLOPHON %%%
\begin{vplace}
\centering
\emph{\LARGE Colophon}

\rule{0.5\textwidth}{0.4pt}\\[\baselineskip]

{\tiny Created with 100\% Free/Libre Software}

GNU/Linux

{\LaTeX} Memoir

% XXX surely a less dumb way to make some space :)
\rule{0\textwidth}{0pt}\\[\baselineskip]%
\rule{0.5\textwidth}{0.4pt}\\[\baselineskip]
\end{vplace}
%%% END COLOPHON %%%
