gralco/TAZ6/documentation/manual/source/Title.tex

%
% Title.tex
% Title Page.
%
% LulzBot TAZ User Manual
%
% Copyright (C) 2014 Aleph Objects, Inc.
%
% This document is licensed under the Creative Commons Attribution 4.0
% International Public License (CC BY-SA 4.0) by Aleph Objects, Inc.
%

% clear the page style
\date {}
\thispagestyle{empty}
\begingroup
\centering 

\begin{center}
%%{\huge \scshape TAZ Six User Manual}
\fontspec{Outage.ttf}\fontsize{24pt}{1em}\selectfont LulzBot TAZ
%%%\fontspec{Titillium-BoldUpright.otf}\fontsize{24pt}{1em}\selectfont 6
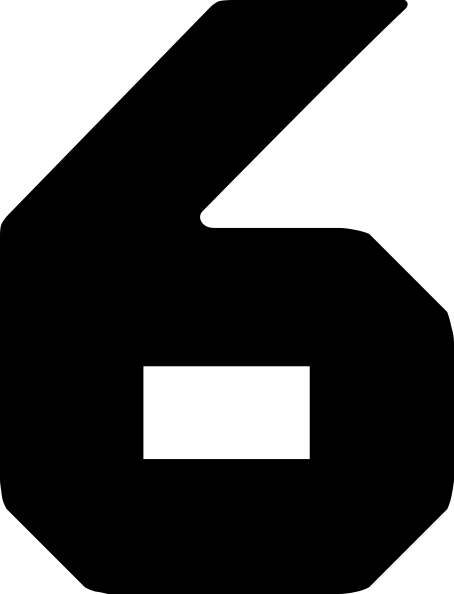
[picture p356: documentation/guide/source/images/outage-6.png]

\fontspec{Outage.ttf}\fontsize{24pt}{1em}\selectfont User Manual
\end{center}

\par

%\vspace*{0.1\textheight} 
%%% SET TITLE FONT

%\includegraphics[keepaspectratio=true,angle=0,height=1.0\textheight,width=1.0\textwidth]{TAZ_6_Angle.JPG}



%\null\vfill
%\rule{0.4\textwidth}{0.4pt}
%\par
\begin{center}


{\large \itshape Aleph Objects, Inc.}
\end{center}
\endgroup
%\vspace*{0.1\textheight} 
%\newpage
%\clearpage
