gralco/TAZ6/documentation/guide/index.html

# Index of /TAZ/Olive/documentation/guide

(ICO) | Name | Last modified | Size | Description
(PARENTDIR) | Parent Directory | | -
(DIR) | PDFs_for_print/ | 2017-01-19 16:49 | -
(DIR) | PDFs_for_web/ | 2017-01-19 16:49 | -
(DIR) | source/ | 2017-01-19 16:49 | -
