gralco/TAZ6/sample_prints/LulzBot/index.html

# Index of /TAZ/Olive/sample_prints/LulzBot

(ICO) | Name | Last modified | Size | Description
(PARENTDIR) | Parent Directory | | -
(DIR) | LulzBot_keychain/ | 2016-09-16 21:57 | -
(DIR) | rock2pus/ | 2016-09-16 21:57 | -
(DIR) | rocktopus/ | 2016-09-16 21:57 | -
