gralco/TAZ6/sample_prints/novelties/index.html

# Index of /TAZ/Olive/sample_prints/novelties

(ICO) | Name | Last modified | Size | Description
(PARENTDIR) | Parent Directory | | -
(DIR) | OSHW_logo/ | 2016-09-16 21:57 | -
(DIR) | fish_fossilz/ | 2016-09-16 21:57 | -
(DIR) | mustache_ring/ | 2016-09-16 21:57 | -
