gralco/TAZ6/documentation/guide/PDFs_for_print/index.html

# Index of /TAZ/Olive/documentation/guide/PDFs_for_print

(ICO) | Name | Last modified | Size | Description
(PARENTDIR) | Parent Directory | | -
( ) | TAZ_6_QSG_OPERATION_FINAL.pdf | 2017-01-19 16:49 | 37M
( ) | TAZ_6_QSG_Operation_COVER_FINAL.pdf | 2016-09-16 21:55 | 501K
( ) | TAZ_6_QSG_Unboxing_COVER_FINAL.pdf | 2016-09-16 21:56 | 501K
( ) | TAZ_6_QSG_Unboxing_FINAL.pdf | 2017-01-19 16:49 | 56M
