gralco/TAZ6/documentation/guide/PDFs_for_web/index.html

# Index of /TAZ/Olive/documentation/guide/PDFs_for_web

(ICO) | Name | Last modified | Size | Description
(PARENTDIR) | Parent Directory | | -
( ) | TAZ_6_QSG_OPERATION_WEB.pdf | 2017-01-19 16:49 | 5.1M
( ) | TAZ_6_QSG_Unboxing_WEB.pdf | 2017-01-19 16:49 | 8.6M
