gralco/TAZ6/documentation/guide/source/index.html

# Index of /TAZ/Olive/documentation/guide/source

(ICO) | Name | Last modified | Size | Description
(PARENTDIR) | Parent Directory | | -
(IMG) | Start_cover.png | 2016-09-16 21:56 | 71K
( ) | TAZ_6_QSG_OPERATION_FINAL.pdf | 2017-01-19 16:49 | 37M
( ) | TAZ_6_QSG_OPERATION_FINAL.sla | 2017-01-19 16:49 | 3.0M
( ) | TAZ_6_QSG_OPERATION_WEB.pdf | 2017-01-19 16:49 | 5.1M
( ) | TAZ_6_QSG_OPERATION_WEB.sla | 2017-01-19 16:49 | 3.0M
( ) | TAZ_6_QSG_Unboxing_FINAL.pdf | 2017-01-19 16:49 | 56M
( ) | TAZ_6_QSG_Unboxing_FINAL.sla | 2017-01-19 16:49 | 619K
( ) | TAZ_6_QSG_Unboxing_WEB.pdf | 2017-01-19 16:49 | 8.6M
( ) | TAZ_6_QSG_Unboxing_WEB.sla | 2017-01-19 16:49 | 622K
( ) | TAZ_6_Unbox_and_Operation_COVER_FINAL.sla | 2016-09-16 21:56 | 232K
(IMG) | cover_back.png | 2016-09-16 21:56 | 39K
(IMG) | cover_screenshot.png | 2016-09-16 21:56 | 74K
(DIR) | images/ | 2016-09-16 21:56 | -
