gralco/TAZ6/documentation/guide/source/cover_back.png

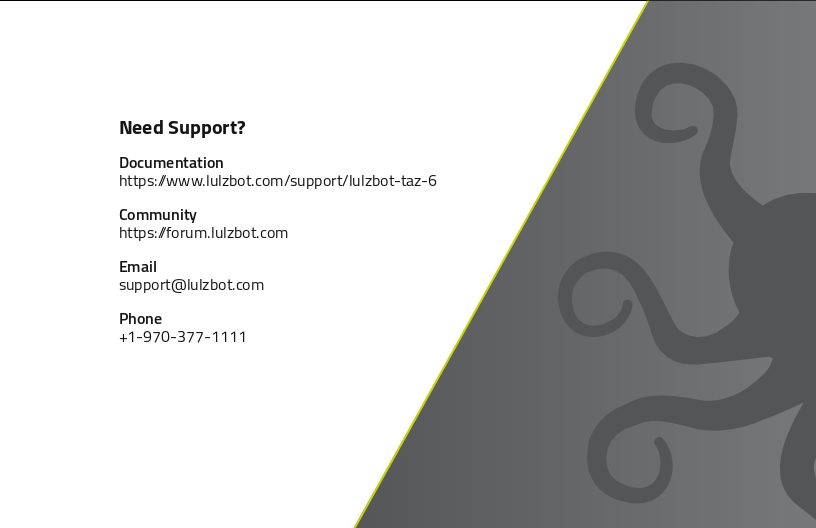
documentation/guide/source/cover_back.png
