gralco/TAZ6/documentation/guide/source/cover_screenshot.png

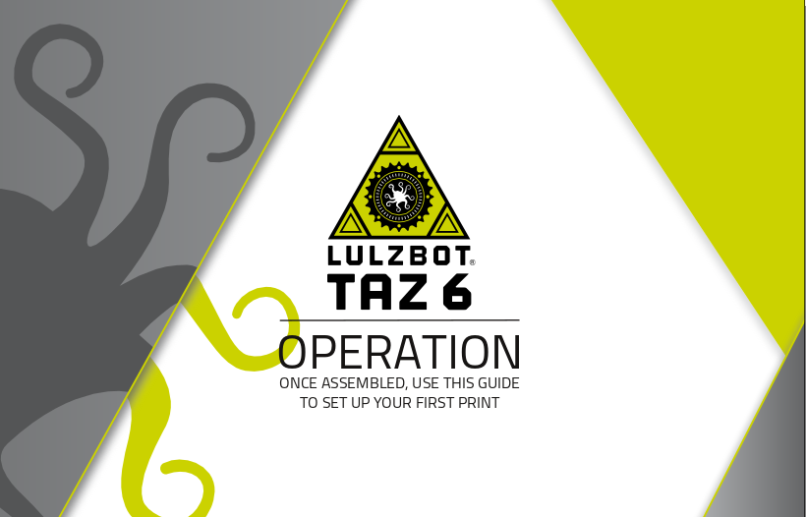
documentation/guide/source/cover_screenshot.png
