gralco/TAZ6/documentation/guide/source/images/2_5MMAllenWrench.JPG

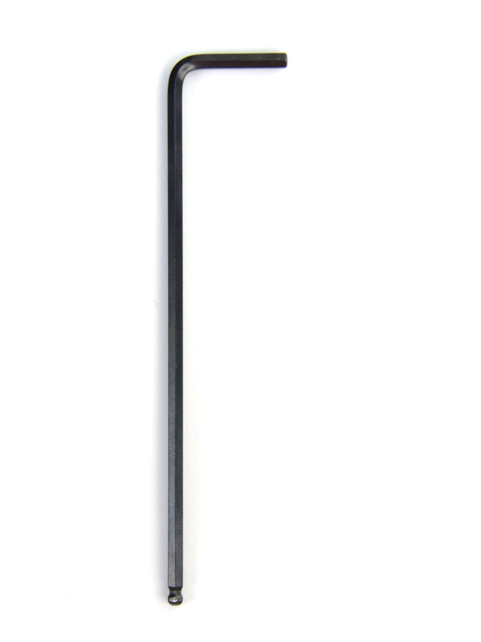
documentation/guide/source/images/2_5MMAllenWrench.JPG
