gralco/TAZ6/documentation/guide/source/images/AC_cable.JPG

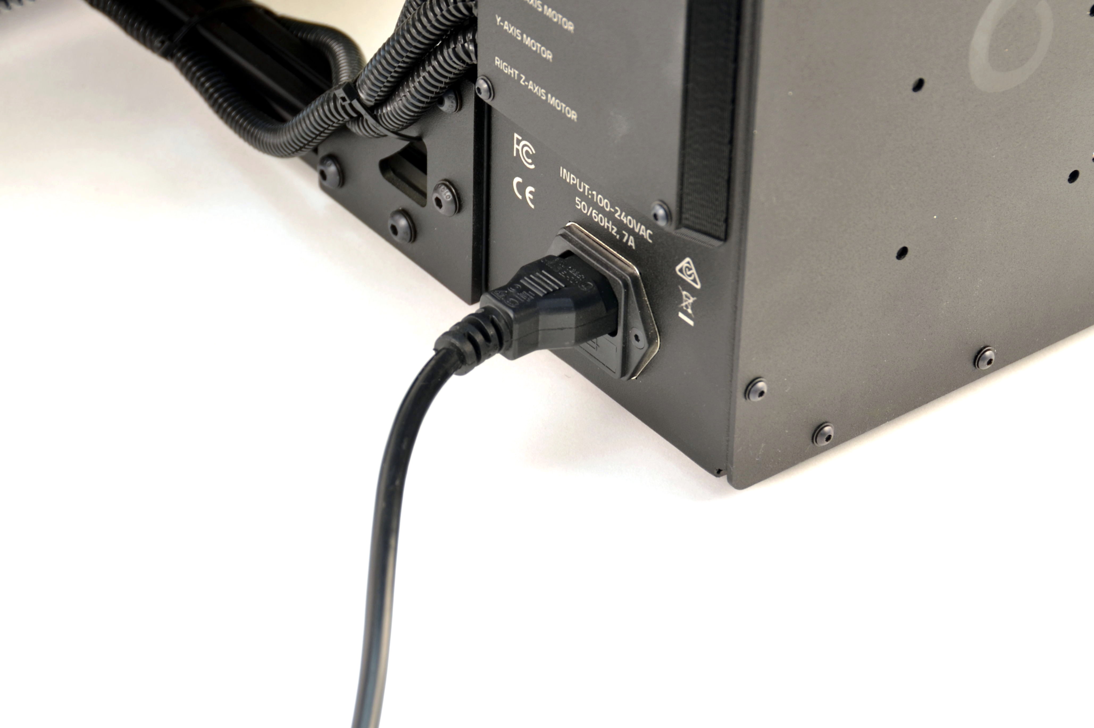
documentation/guide/source/images/AC_cable.JPG
