gralco/TAZ6/documentation/guide/source/images/bed_connectors.JPG

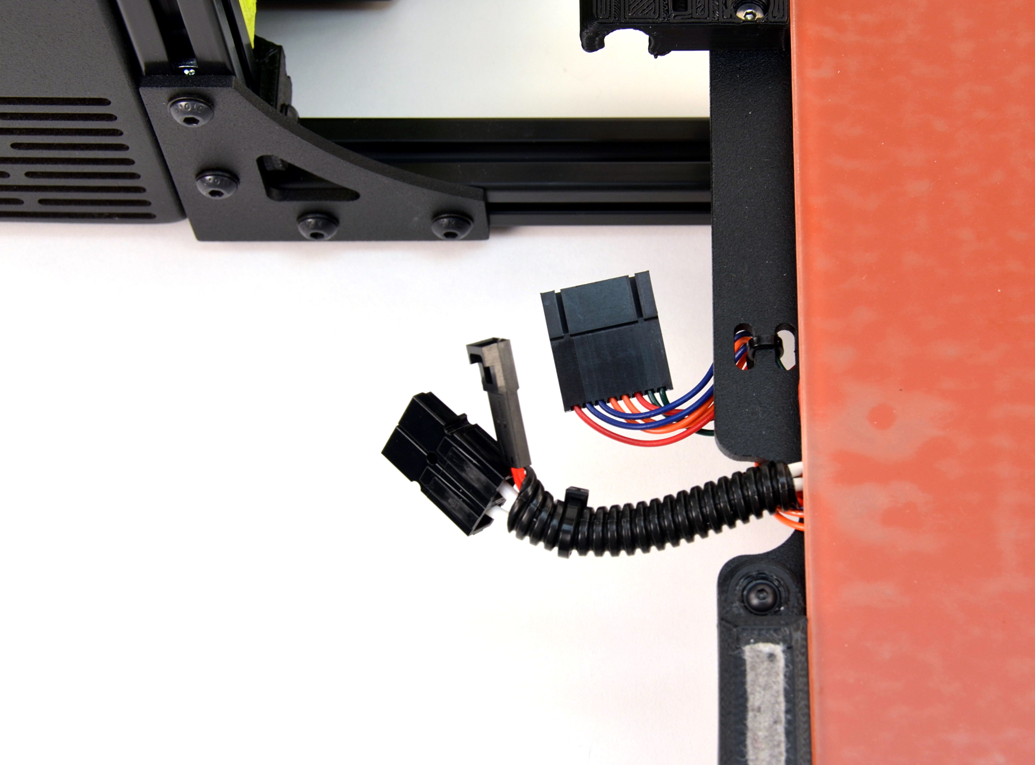
documentation/guide/source/images/bed_connectors.JPG
