gralco/TAZ6/documentation/guide/source/images/check_connections.JPG

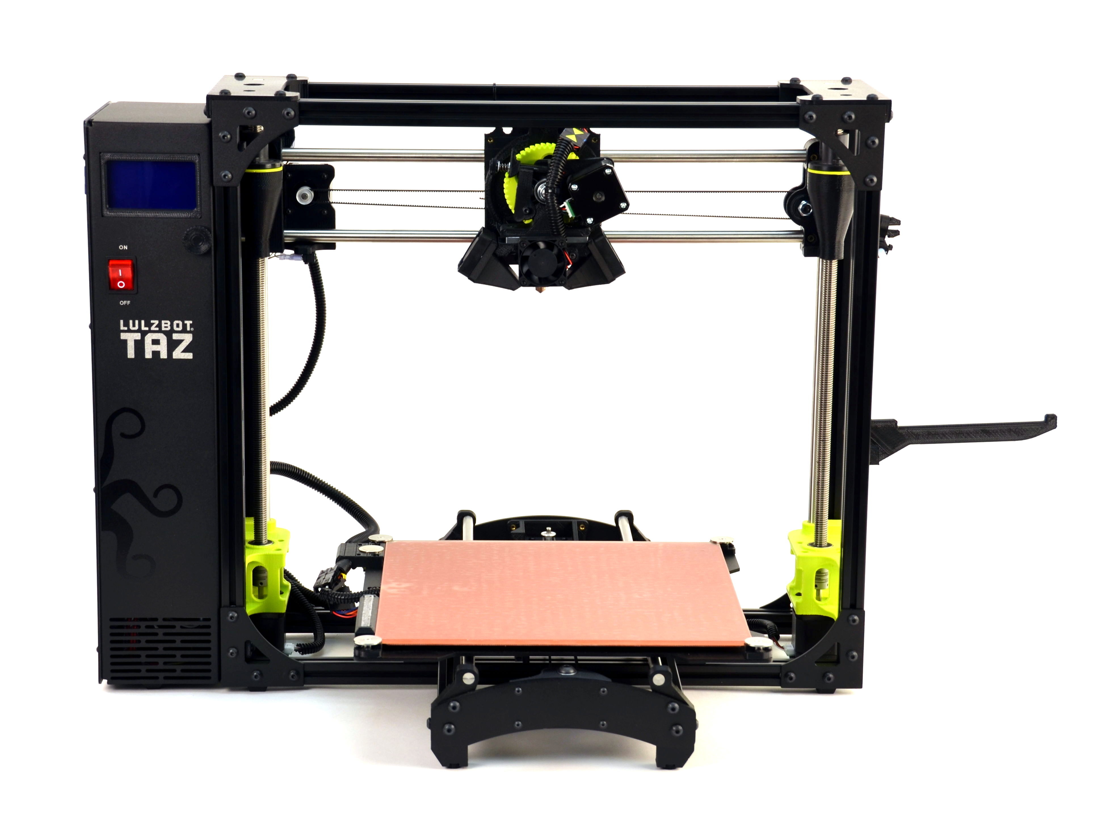
documentation/guide/source/images/check_connections.JPG
