gralco/TAZ6/documentation/guide/source/images/close_the_idler_action.JPG

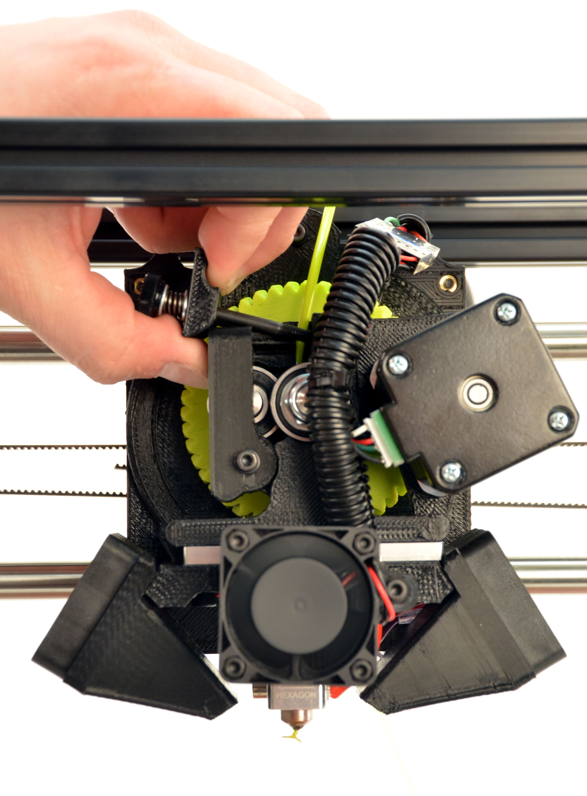
documentation/guide/source/images/close_the_idler_action.JPG
