gralco/TAZ6/documentation/guide/source/images/Connect_Y-Axis_Motor.JPG

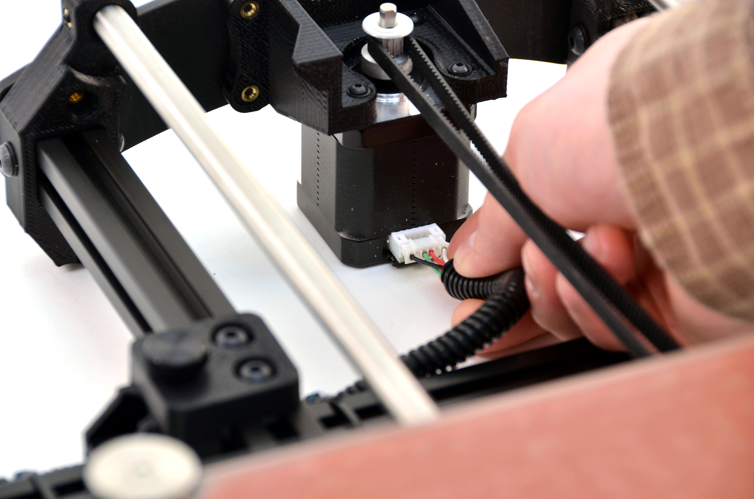
documentation/guide/source/images/Connect_Y-Axis_Motor.JPG
