gralco/TAZ6/documentation/guide/source/images/connector1.JPG

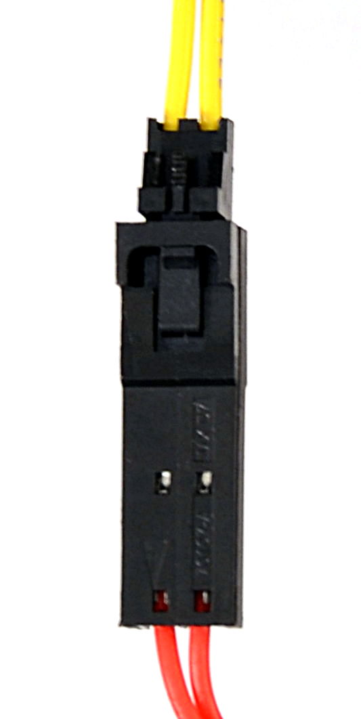
documentation/guide/source/images/connector1.JPG
