gralco/TAZ6/documentation/guide/source/images/connector2.JPG

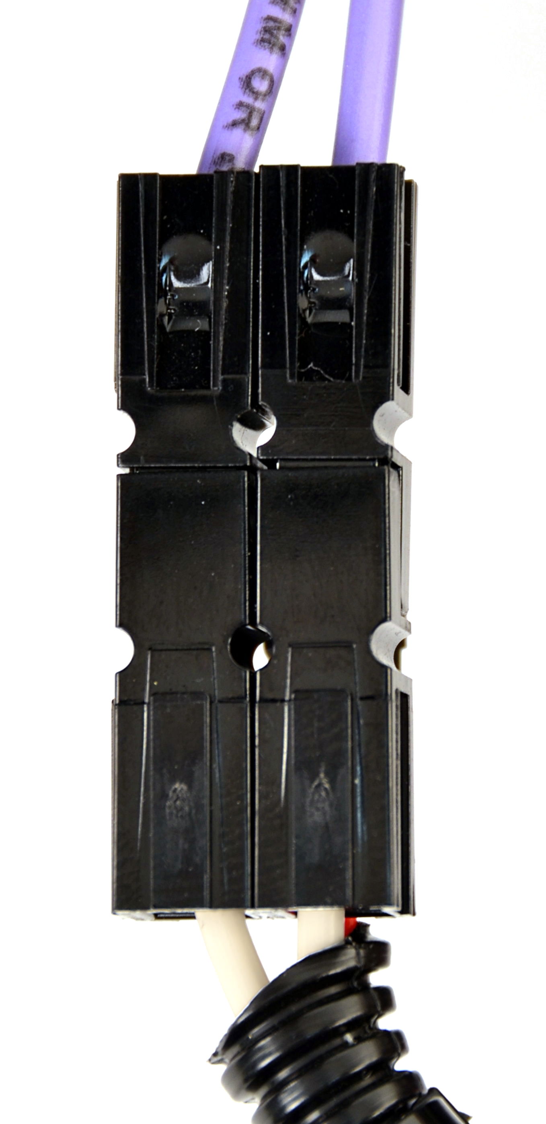
documentation/guide/source/images/connector2.JPG
