gralco/TAZ6/documentation/guide/source/images/connector3.JPG

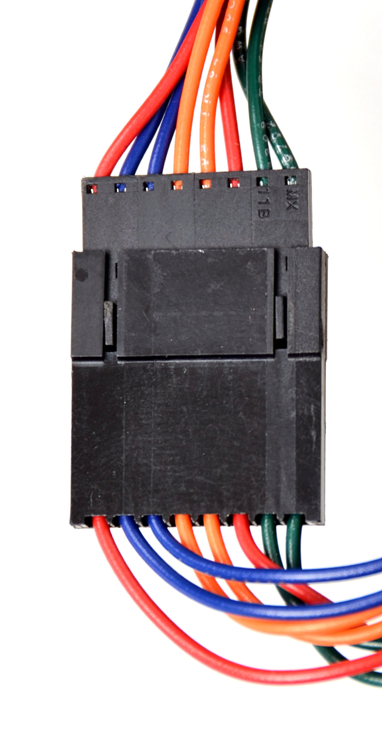
documentation/guide/source/images/connector3.JPG
