gralco/TAZ6/documentation/guide/source/images/Cura_Step4c.png

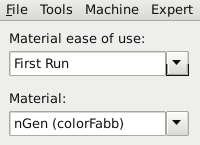
documentation/guide/source/images/Cura_Step4c.png
