gralco/TAZ6/documentation/guide/source/images/Cura_Step4d_01.png

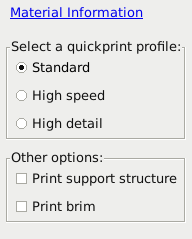
documentation/guide/source/images/Cura_Step4d_01.png
