gralco/TAZ6/documentation/guide/source/images/Cura_Step5a.png

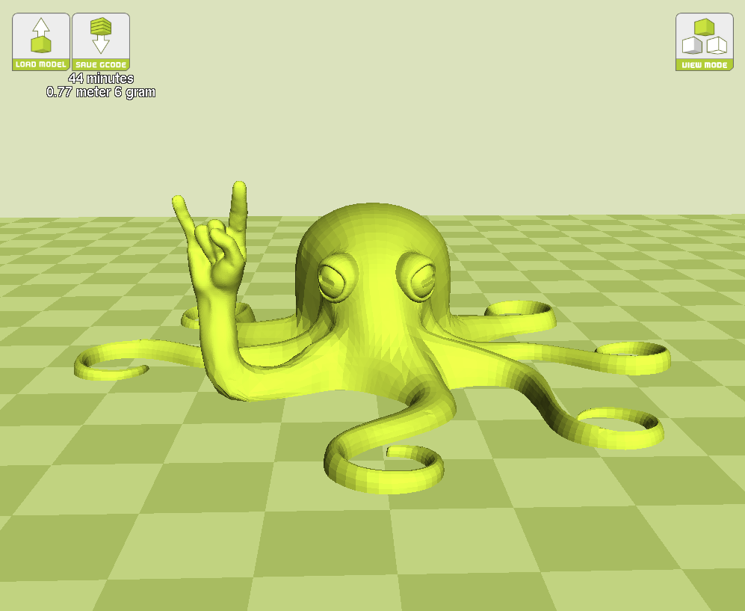
documentation/guide/source/images/Cura_Step5a.png
