gralco/TAZ6/documentation/guide/source/images/Cura_Step5b.png

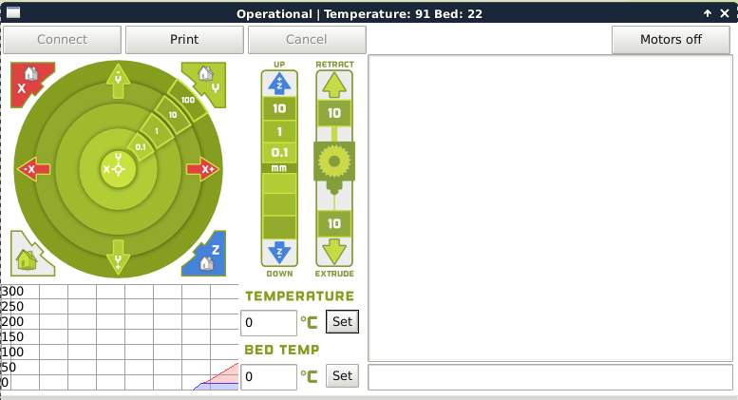
documentation/guide/source/images/Cura_Step5b.png
