gralco/TAZ6/documentation/guide/source/images/Cura_Step9a_01.png

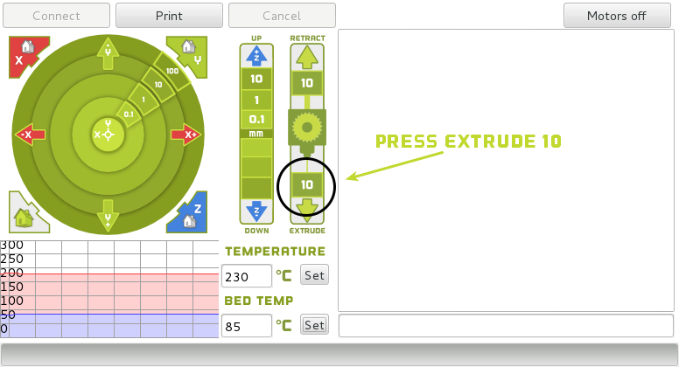
documentation/guide/source/images/Cura_Step9a_01.png
