gralco/TAZ6/documentation/guide/source/images/extruded_filament_and_tweezers.JPG

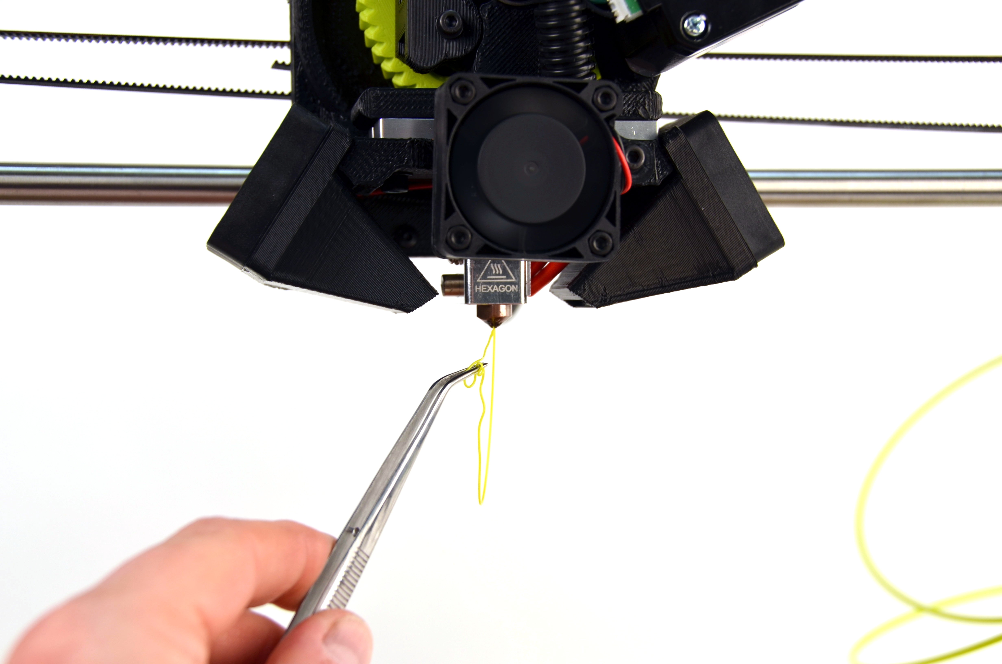
documentation/guide/source/images/extruded_filament_and_tweezers.JPG
