gralco/TAZ6/documentation/guide/source/images/Filament_in_extruder.JPG

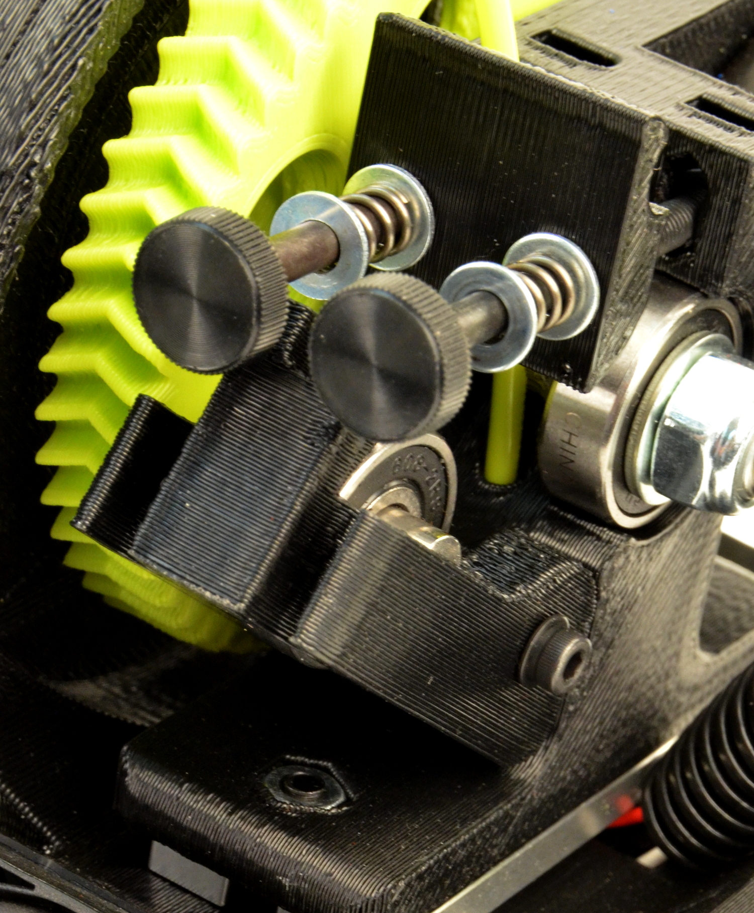
documentation/guide/source/images/Filament_in_extruder.JPG
