gralco/TAZ6/documentation/guide/source/images/GLCD_TAZ_6_Ready.JPG

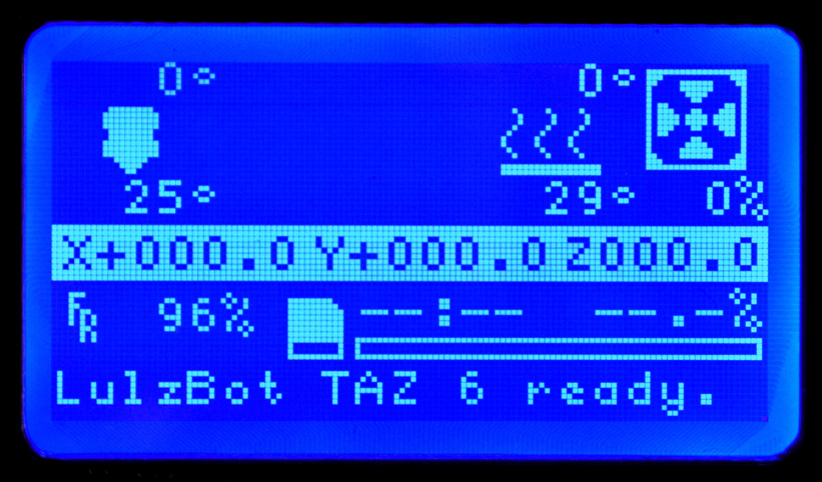
documentation/guide/source/images/GLCD_TAZ_6_Ready.JPG
