gralco/TAZ6/documentation/guide/source/images/HexKeyDetail.JPG

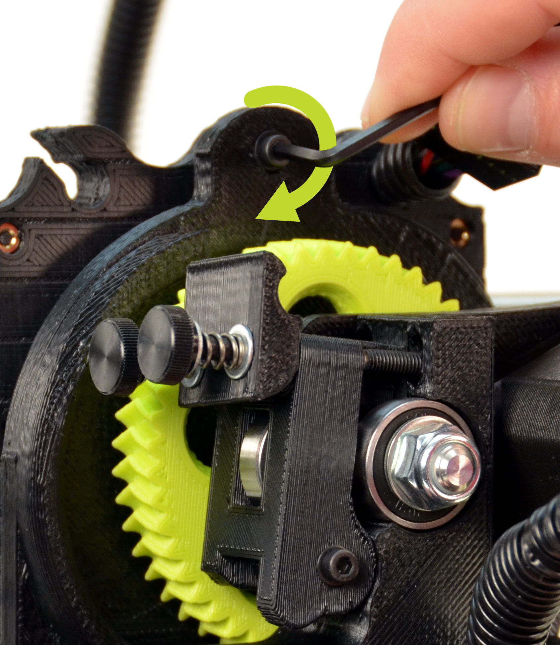
documentation/guide/source/images/HexKeyDetail.JPG
