gralco/TAZ6/documentation/guide/source/images/install_filament_guide.JPG

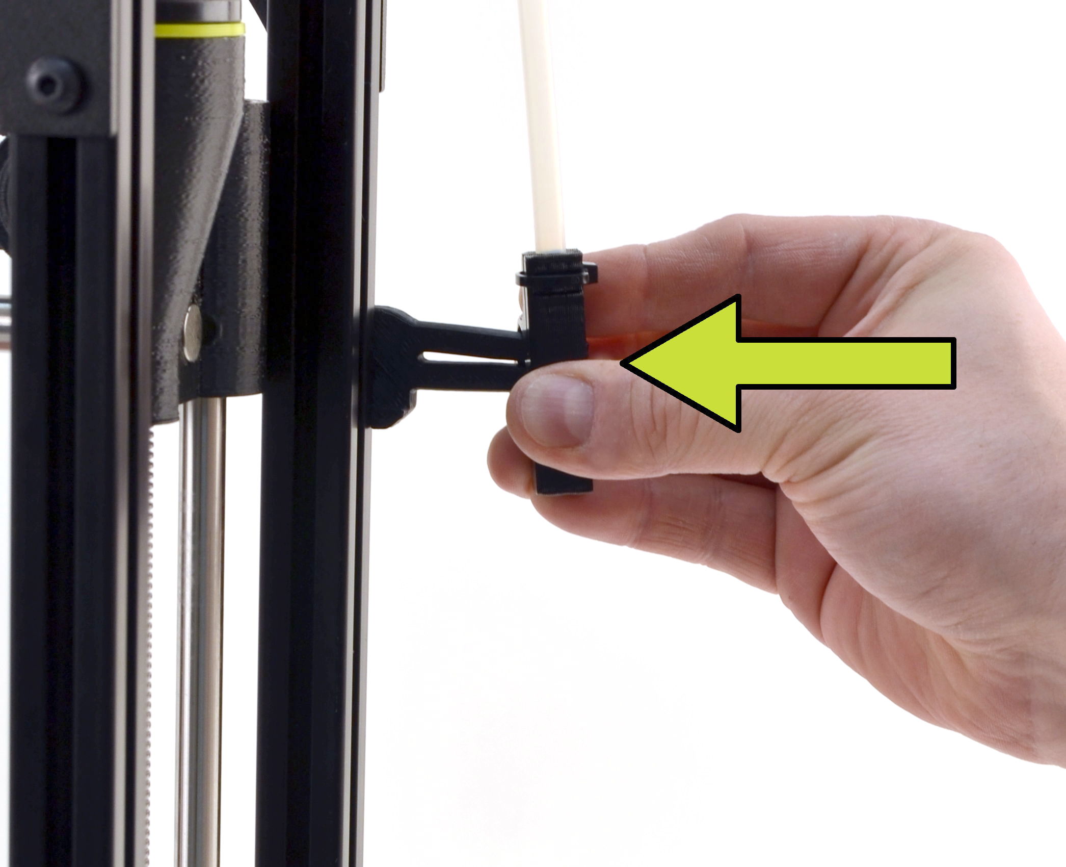
documentation/guide/source/images/install_filament_guide.JPG
