gralco/TAZ6/documentation/guide/source/images/Install_Front_Thumbscrews.JPG

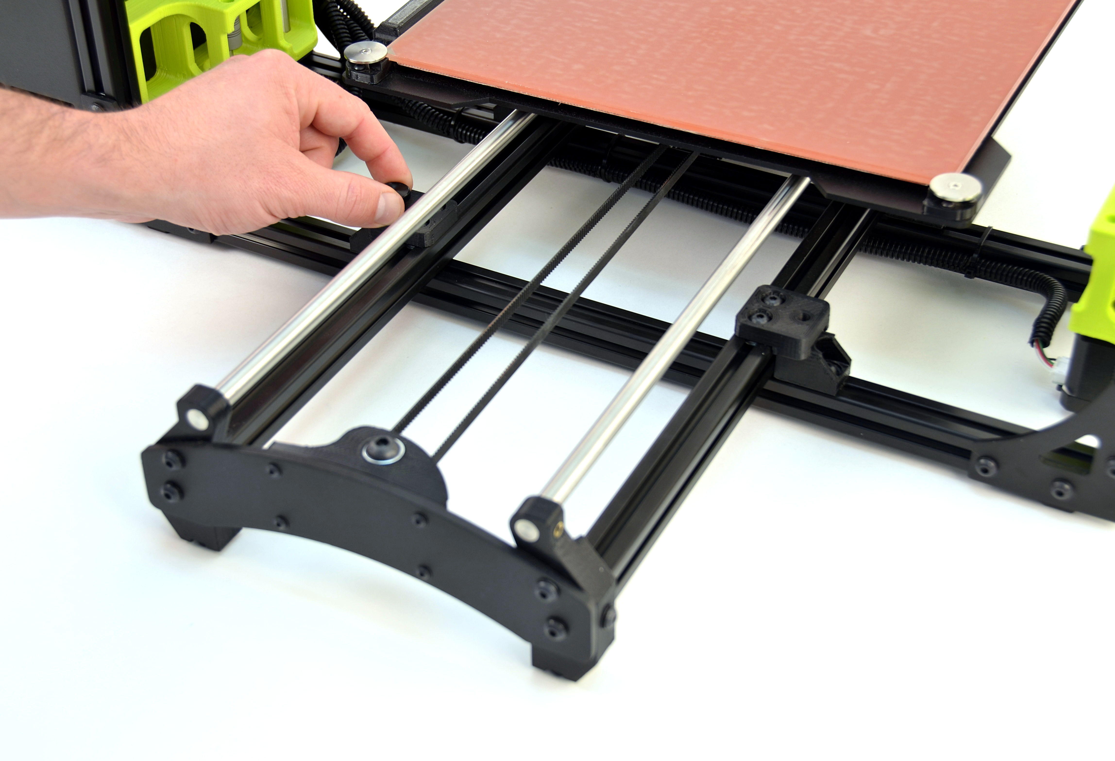
documentation/guide/source/images/Install_Front_Thumbscrews.JPG
