gralco/TAZ6/documentation/guide/source/images/Install_Rear_Thumbscrews.JPG

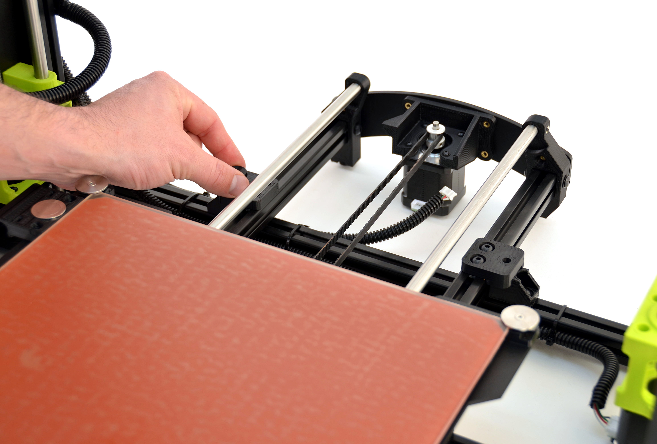
documentation/guide/source/images/Install_Rear_Thumbscrews.JPG
