gralco/TAZ6/documentation/guide/source/images/install_toolhead.JPG

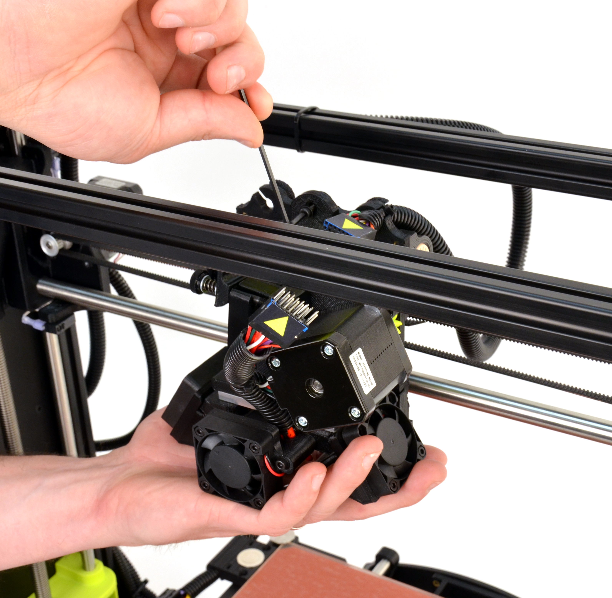
documentation/guide/source/images/install_toolhead.JPG
