gralco/TAZ6/documentation/guide/source/images/lay_box_down.JPG

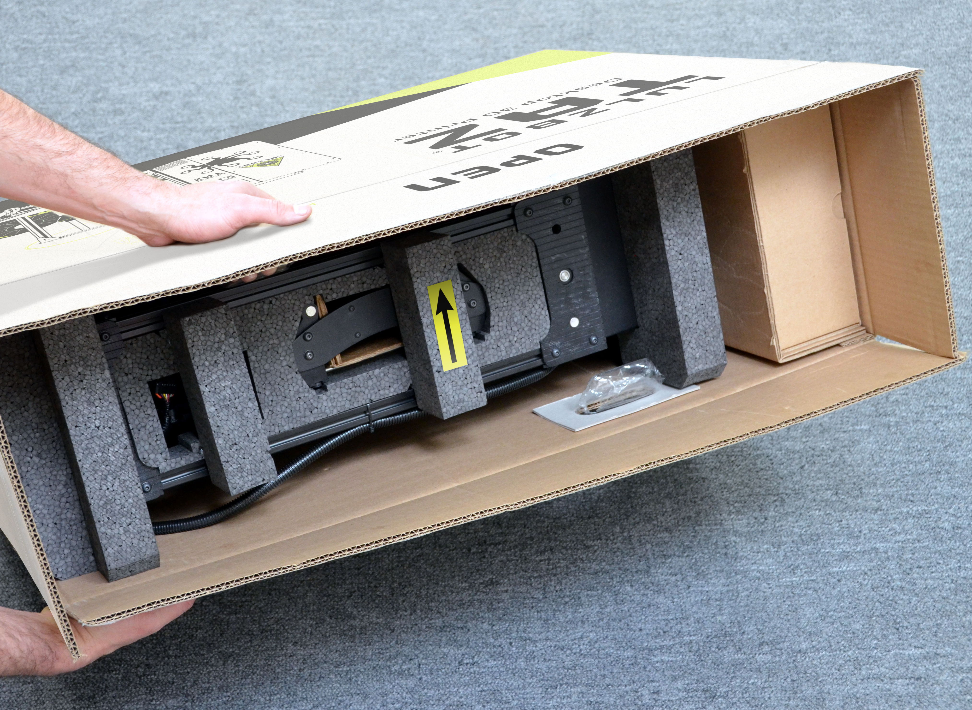
documentation/guide/source/images/lay_box_down.JPG
