gralco/TAZ6/documentation/guide/source/images/lift_out_y-axis_assembly.JPG

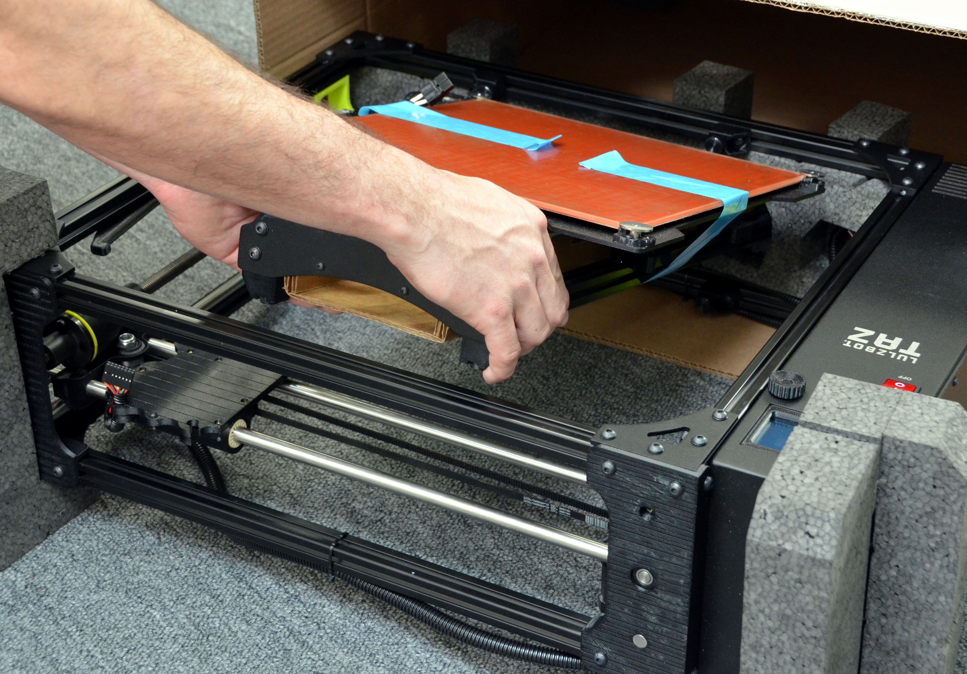
documentation/guide/source/images/lift_out_y-axis_assembly.JPG
