gralco/TAZ6/documentation/guide/source/images/load_filament.JPG

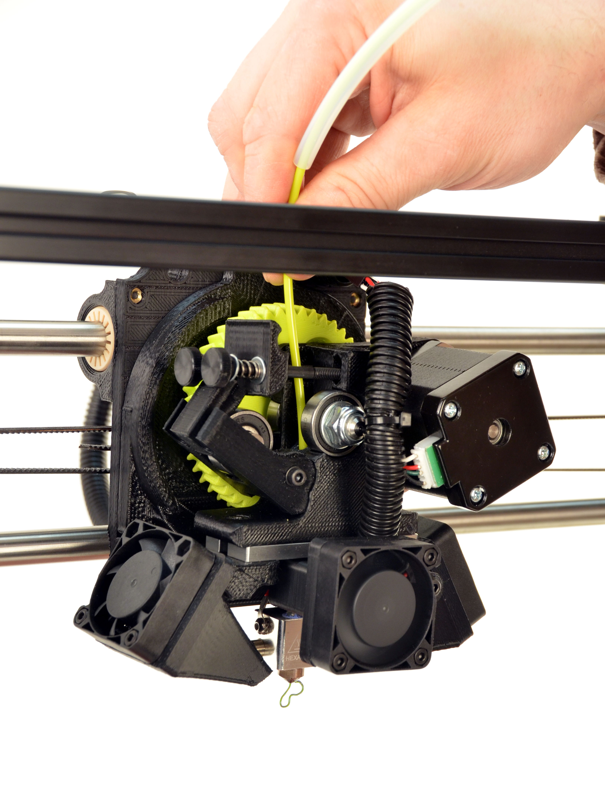
documentation/guide/source/images/load_filament.JPG
