gralco/TAZ6/documentation/guide/source/images/Look_in_box_see_red_bed.JPG

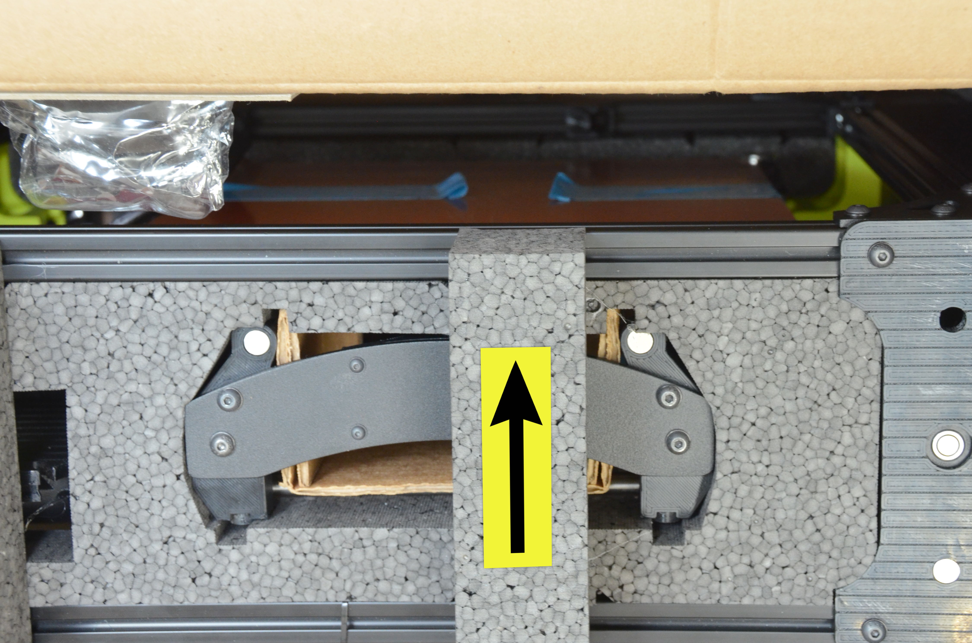
documentation/guide/source/images/Look_in_box_see_red_bed.JPG
