gralco/TAZ6/documentation/guide/source/images/place_y-axis.JPG

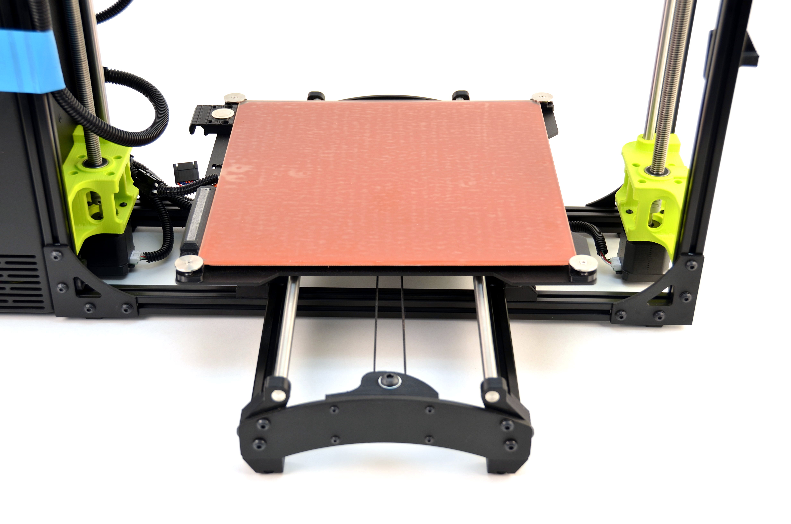
documentation/guide/source/images/place_y-axis.JPG
