gralco/TAZ6/documentation/guide/source/images/ready_to_print.JPG

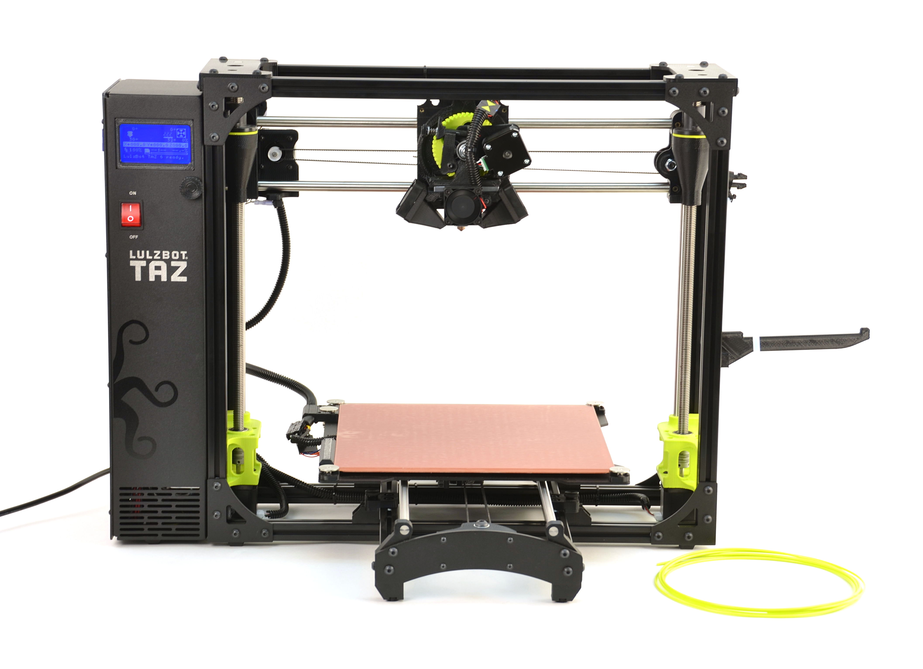
documentation/guide/source/images/ready_to_print.JPG
