gralco/TAZ6/documentation/guide/source/images/remove_1.JPG

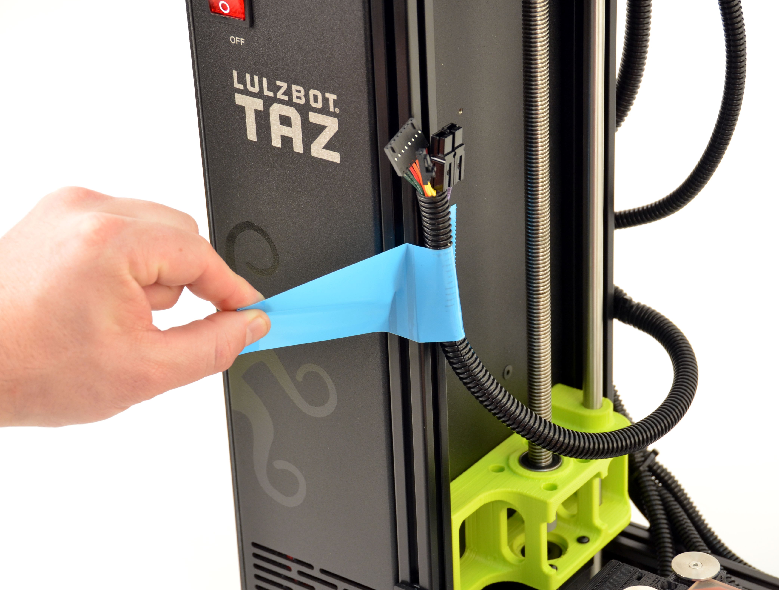
documentation/guide/source/images/remove_1.JPG
