gralco/TAZ6/documentation/guide/source/images/remove_bottom_foam.JPG

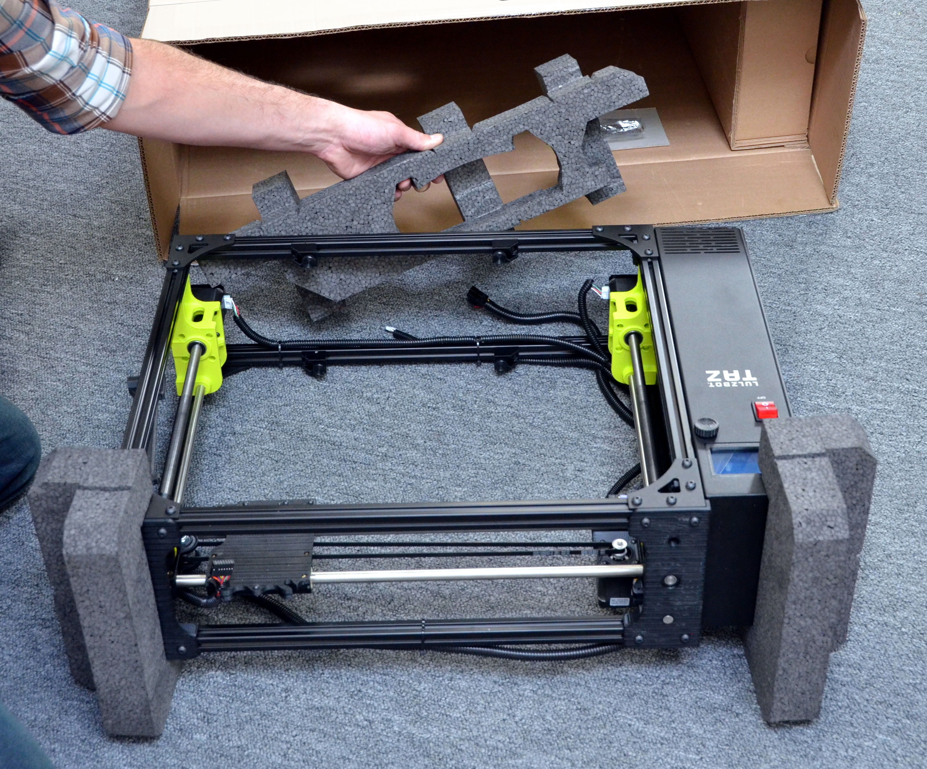
documentation/guide/source/images/remove_bottom_foam.JPG
