gralco/TAZ6/documentation/guide/source/images/remove_boxes.JPG

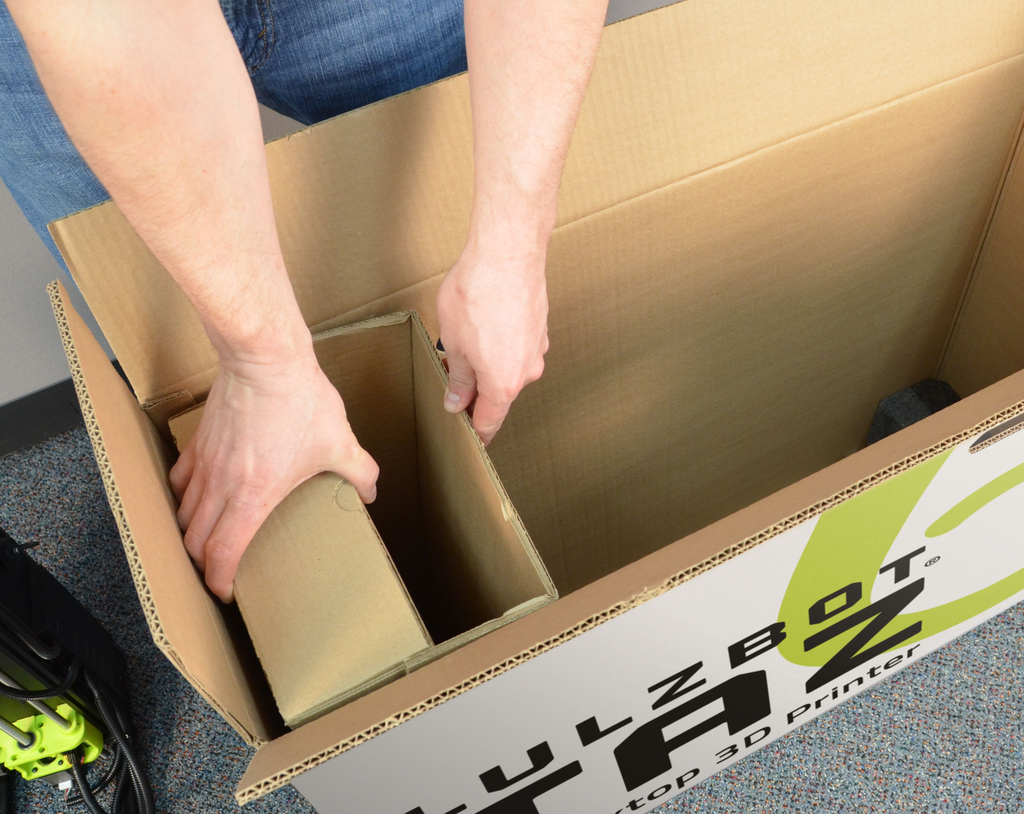
documentation/guide/source/images/remove_boxes.JPG
