gralco/TAZ6/documentation/guide/source/images/remove_corner_foam.JPG

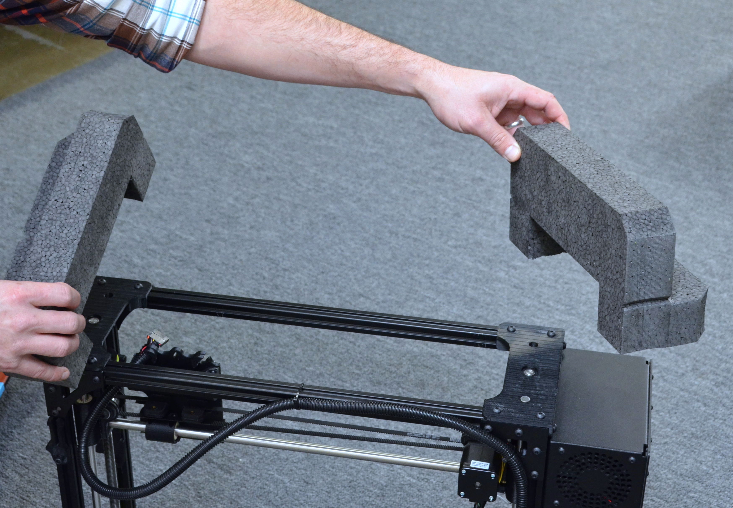
documentation/guide/source/images/remove_corner_foam.JPG
