gralco/TAZ6/documentation/guide/source/images/remove_filament.JPG

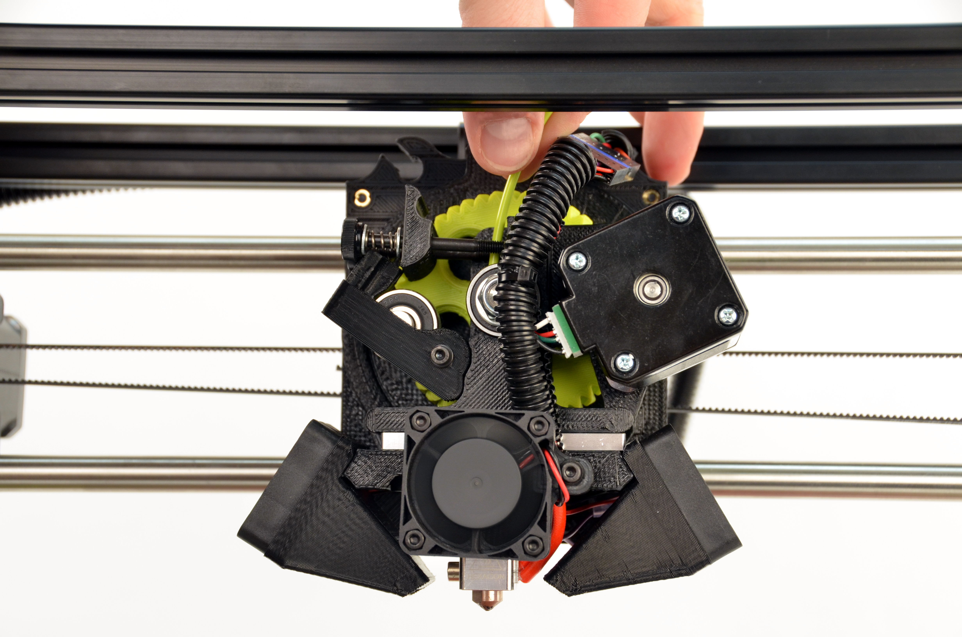
documentation/guide/source/images/remove_filament.JPG
