gralco/TAZ6/documentation/guide/source/images/remove_tape.JPG

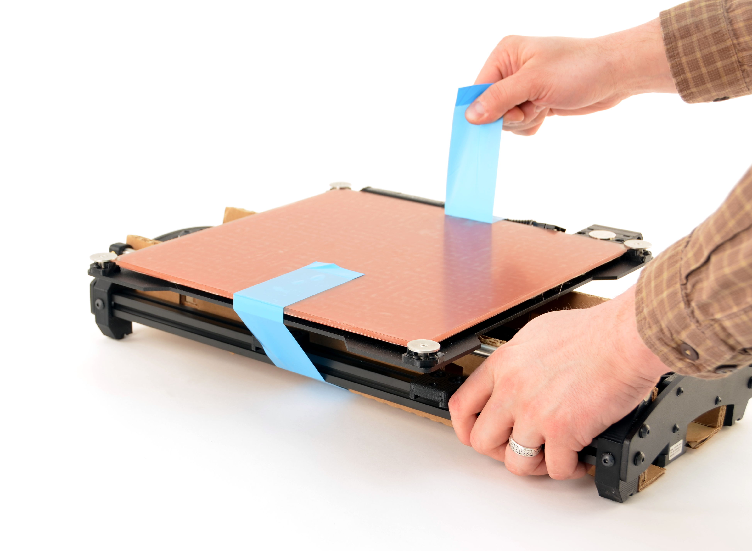
documentation/guide/source/images/remove_tape.JPG
