gralco/TAZ6/documentation/guide/source/images/remove_tape_frame.JPG

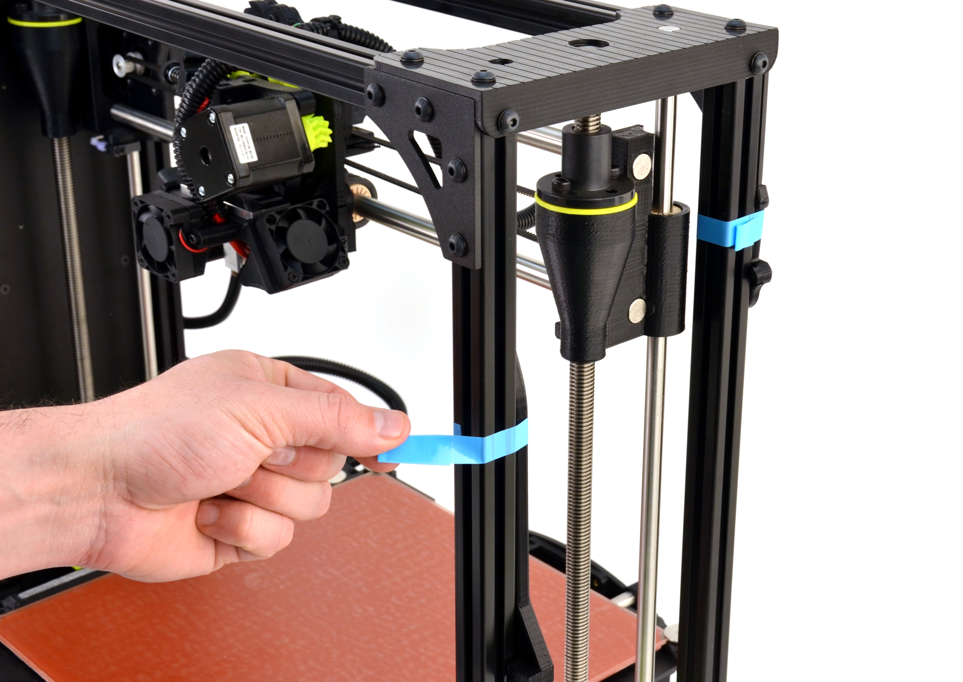
documentation/guide/source/images/remove_tape_frame.JPG
