gralco/TAZ6/documentation/guide/source/images/Remove_Thumbscrews.JPG

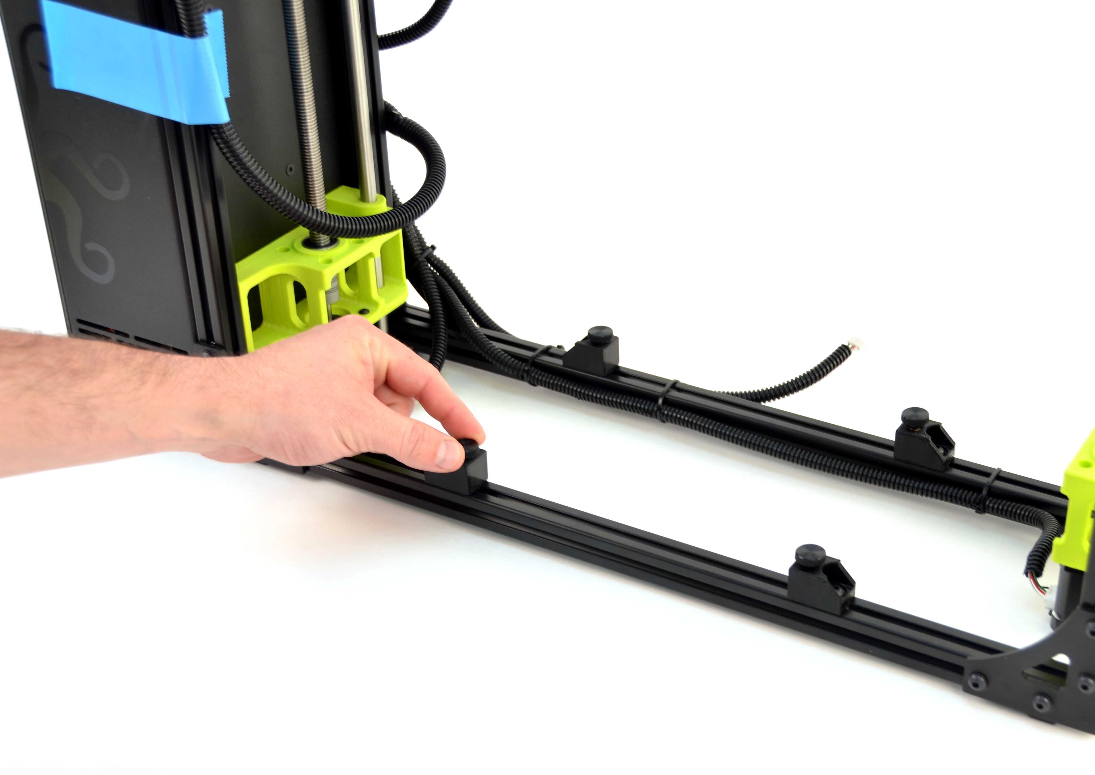
documentation/guide/source/images/Remove_Thumbscrews.JPG
