gralco/TAZ6/documentation/guide/source/images/Remove_tool_head_screw.JPG

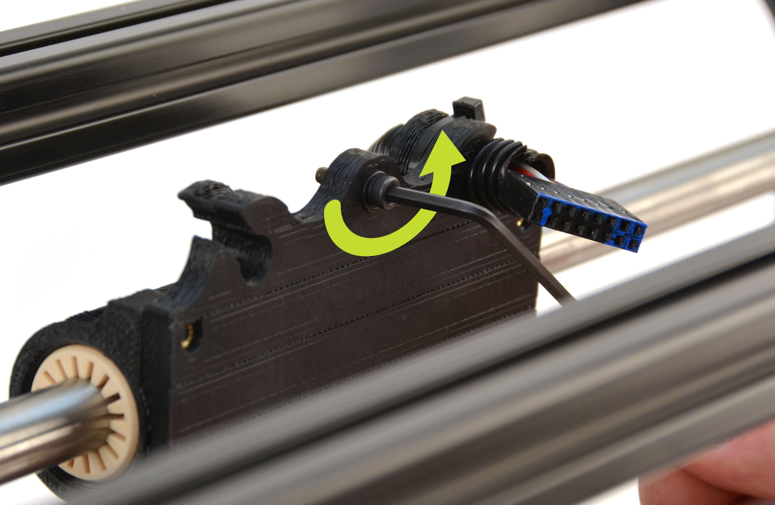
documentation/guide/source/images/Remove_tool_head_screw.JPG
