gralco/TAZ6/documentation/guide/source/images/remove_top_foam.JPG

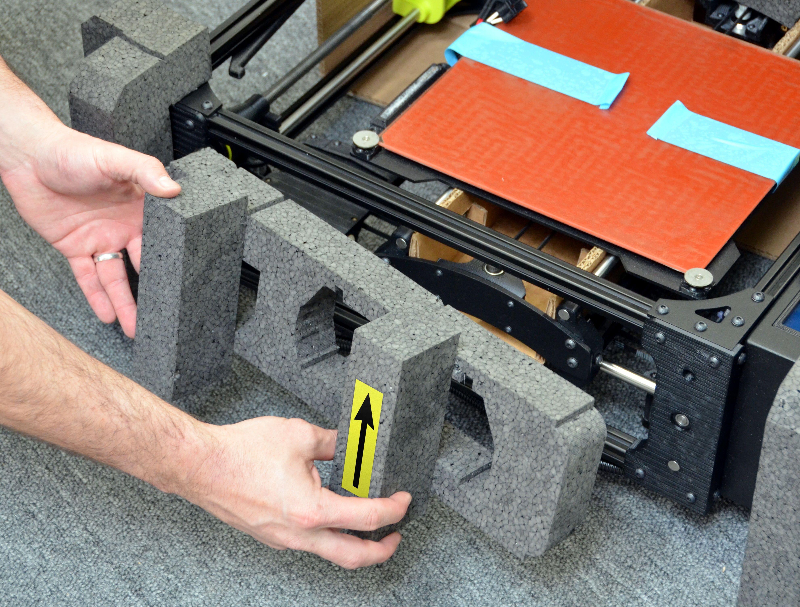
documentation/guide/source/images/remove_top_foam.JPG
