gralco/TAZ6/documentation/guide/source/images/remove_y-axis_carboard.JPG

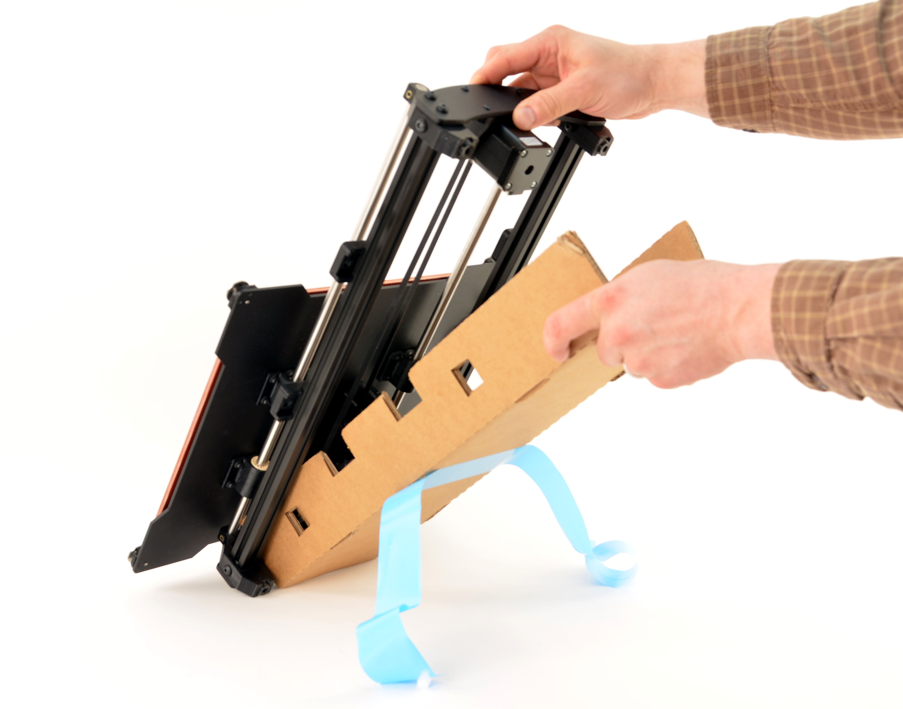
documentation/guide/source/images/remove_y-axis_carboard.JPG
