gralco/TAZ6/documentation/guide/source/images/rotate_filament_holders.JPG

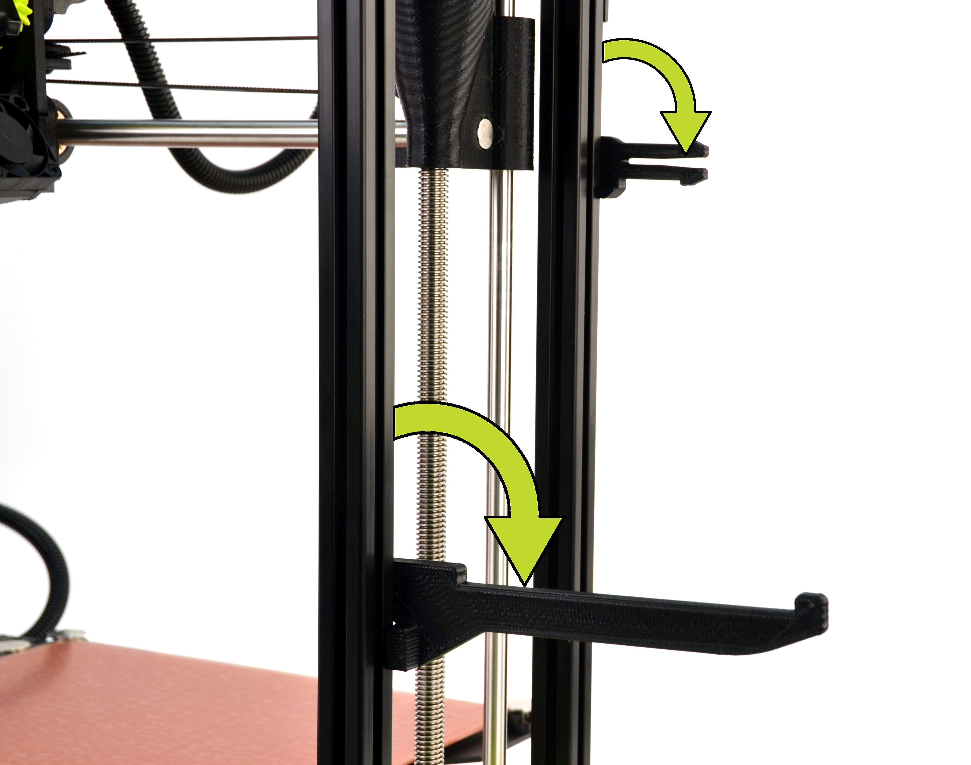
documentation/guide/source/images/rotate_filament_holders.JPG
