gralco/TAZ6/documentation/guide/source/images/slide_out_of_box.JPG

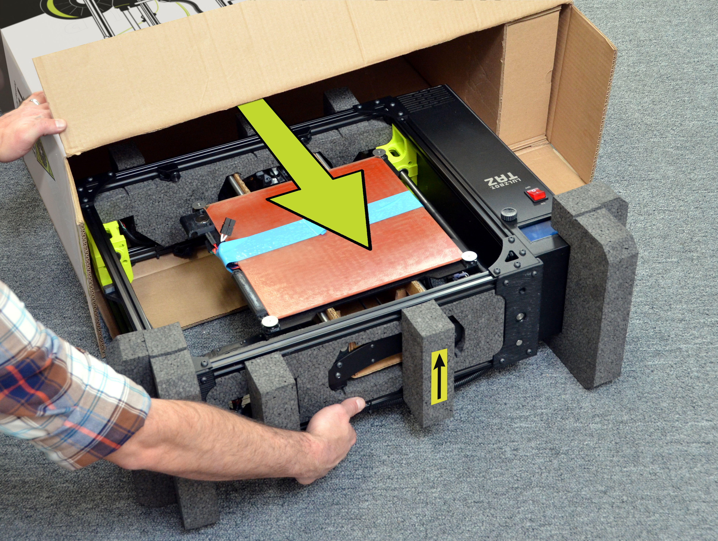
documentation/guide/source/images/slide_out_of_box.JPG
