gralco/TAZ6/documentation/guide/source/images/Snap_Bundle_into_holder.JPG

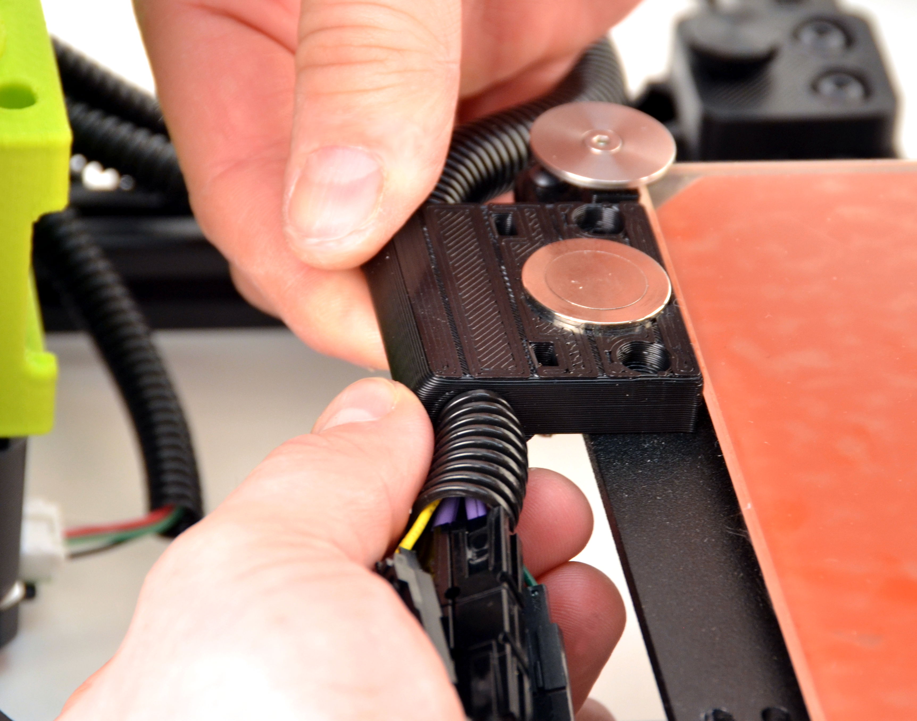
documentation/guide/source/images/Snap_Bundle_into_holder.JPG
