gralco/TAZ6/documentation/guide/source/images/Step3c_01.JPG

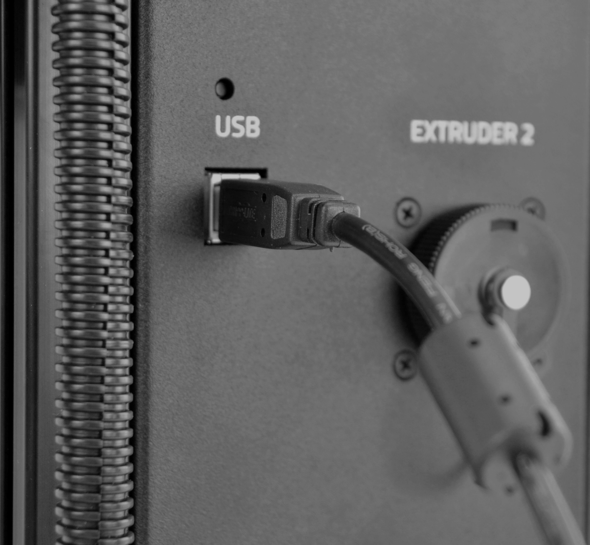
documentation/guide/source/images/Step3c_01.JPG
