gralco/TAZ6/documentation/guide/source/images/Step6a.JPG

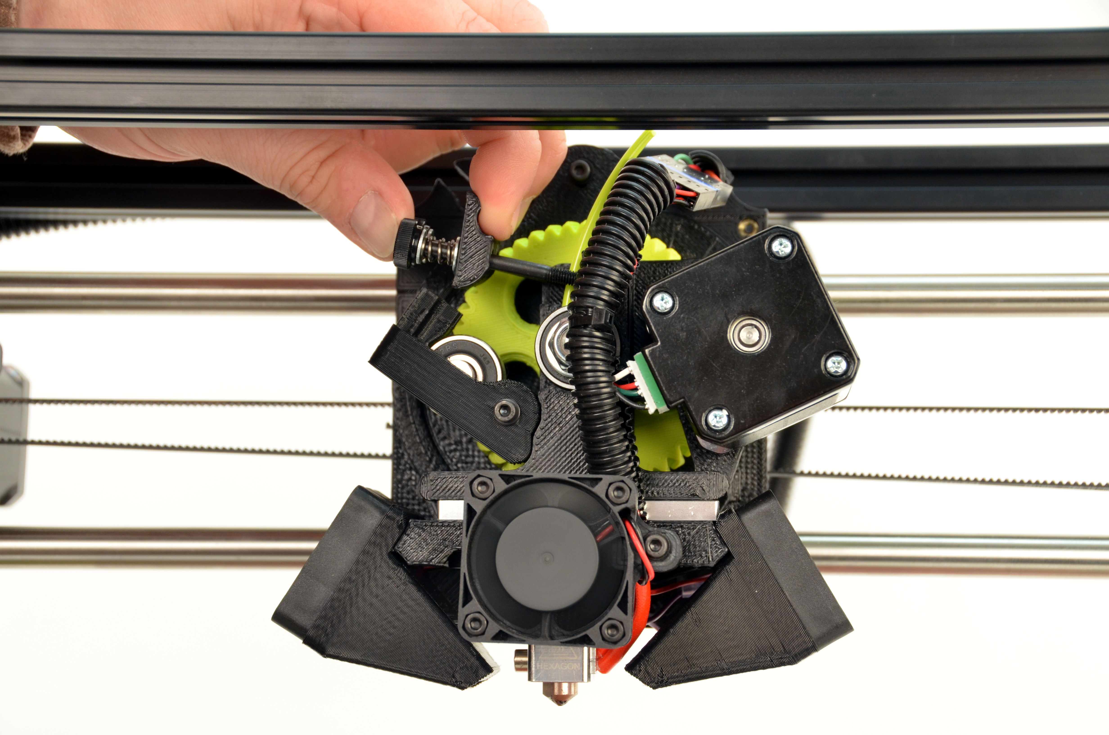
documentation/guide/source/images/Step6a.JPG
