gralco/TAZ6/documentation/guide/source/images/Step7a.JPG

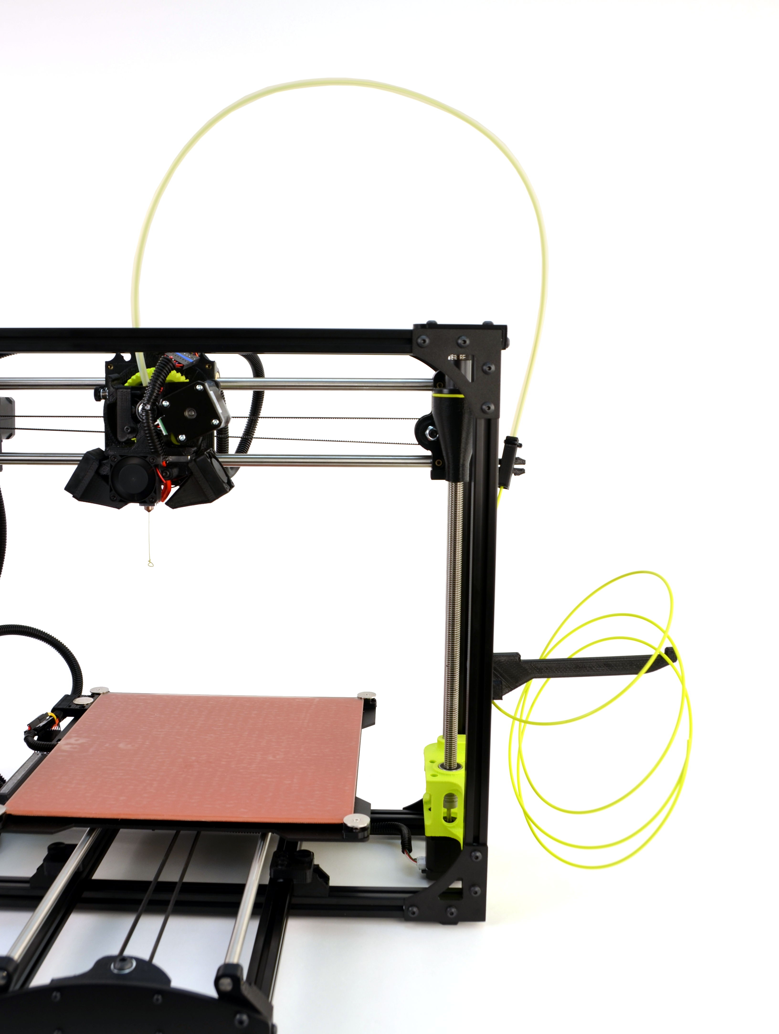
documentation/guide/source/images/Step7a.JPG
