gralco/TAZ6/documentation/guide/source/images/Step10A_01.png

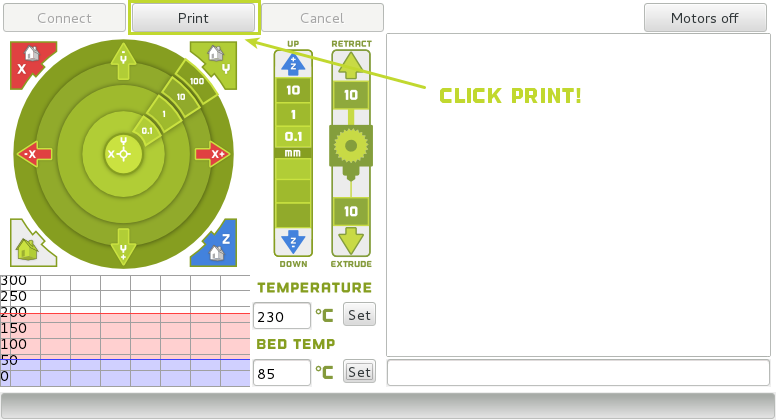
documentation/guide/source/images/Step10A_01.png
