gralco/TAZ6/documentation/guide/source/images/Step13d_01.png

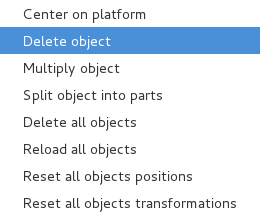
documentation/guide/source/images/Step13d_01.png
