gralco/TAZ6/documentation/guide/source/images/Switched_Off.JPG

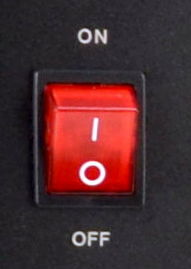
documentation/guide/source/images/Switched_Off.JPG
