gralco/TAZ6/documentation/guide/source/images/Switched_On.jpg

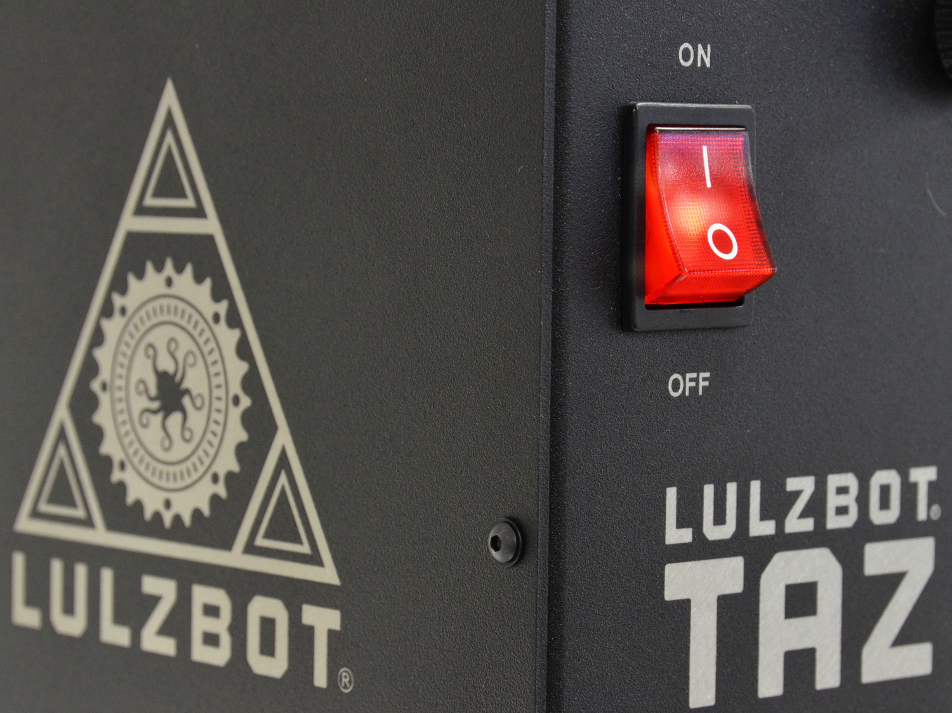
documentation/guide/source/images/Switched_On.jpg
