gralco/TAZ6/documentation/guide/source/images/TAZ6_OpenBox.JPG

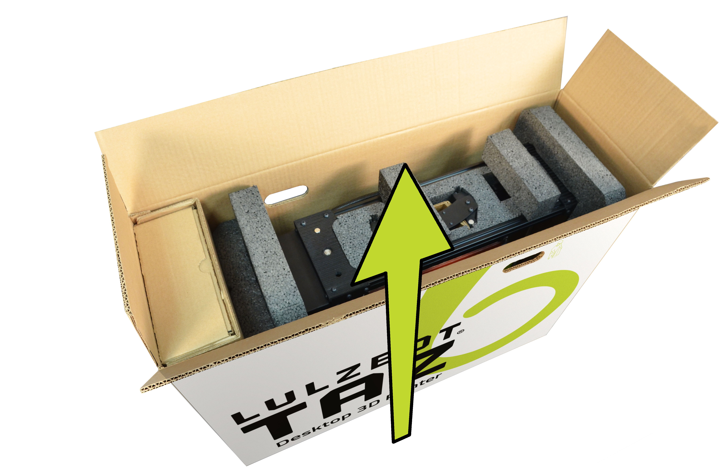
documentation/guide/source/images/TAZ6_OpenBox.JPG
