gralco/TAZ6/documentation/guide/source/images/TAZ_6_Angle_Extruder.JPG

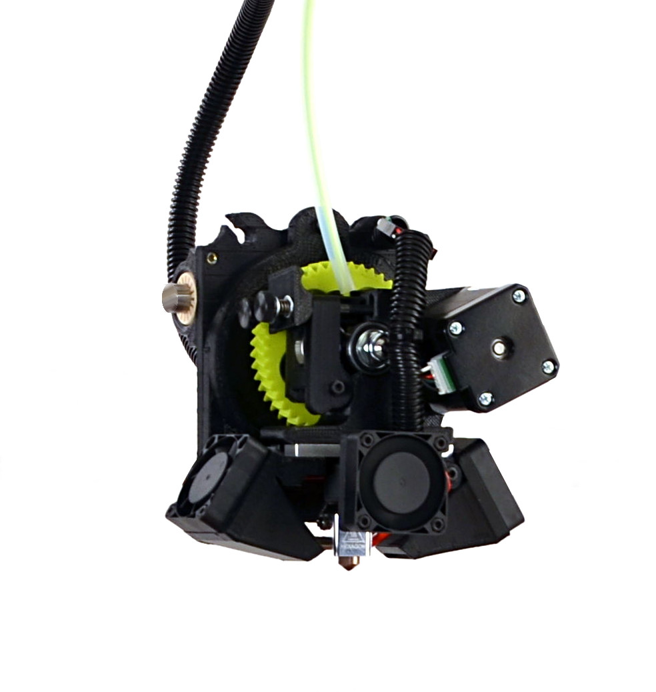
documentation/guide/source/images/TAZ_6_Angle_Extruder.JPG
