gralco/TAZ6/documentation/guide/source/images/TAZ_6_Cooling_anglerd_02.JPG

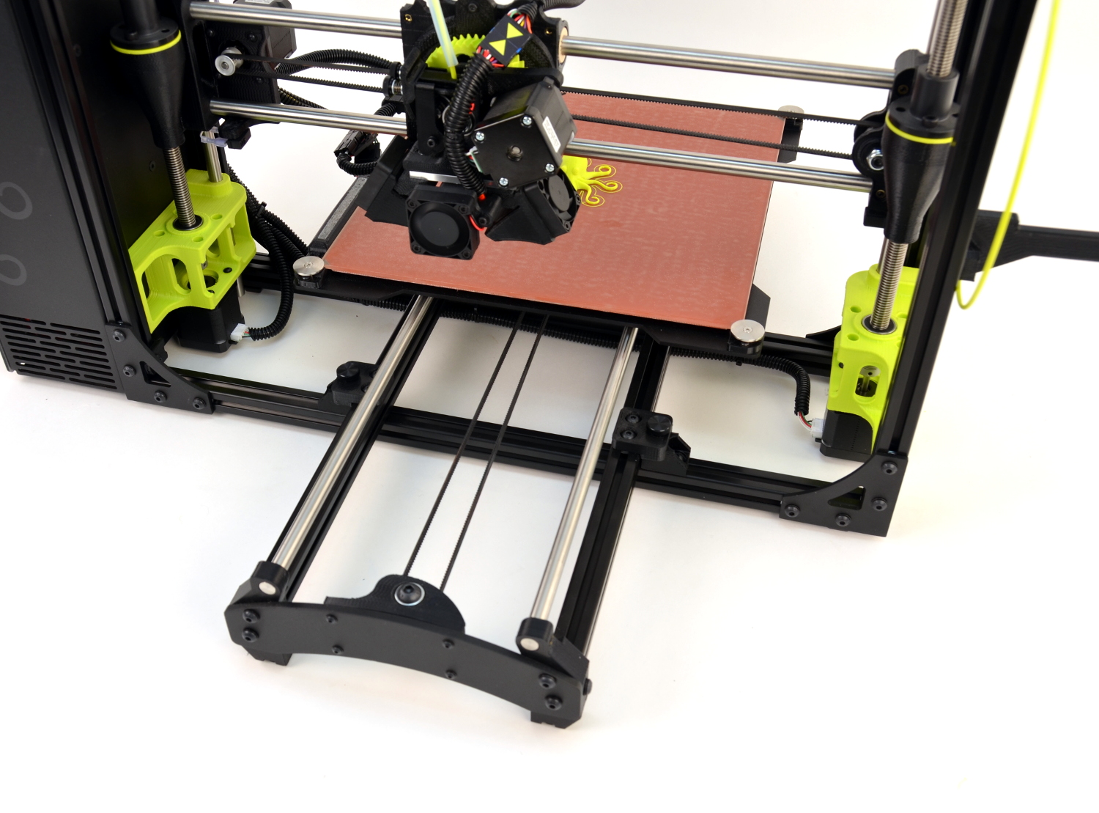
documentation/guide/source/images/TAZ_6_Cooling_anglerd_02.JPG
