gralco/TAZ6/documentation/guide/source/images/TAZ_6_Octopus.JPG

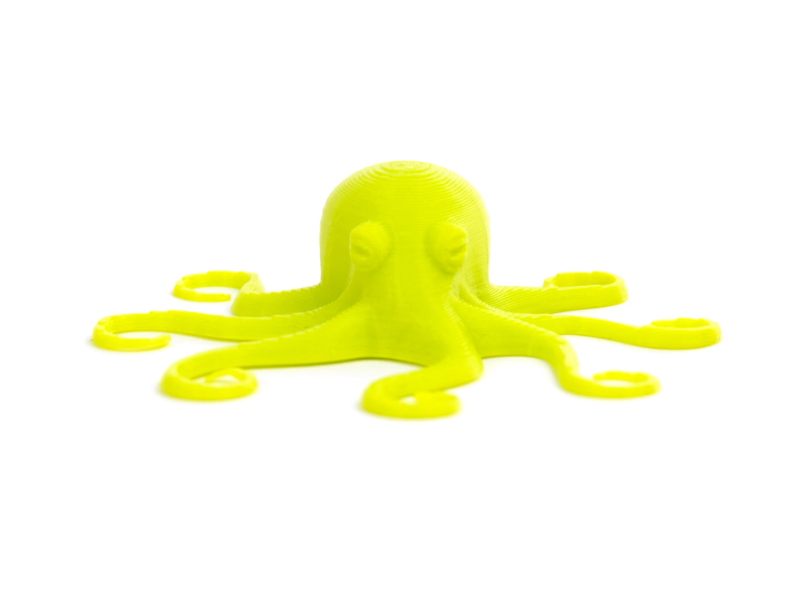
documentation/guide/source/images/TAZ_6_Octopus.JPG
