gralco/TAZ6/documentation/guide/source/images/TAZ_6_PrintRemoval_second.JPG

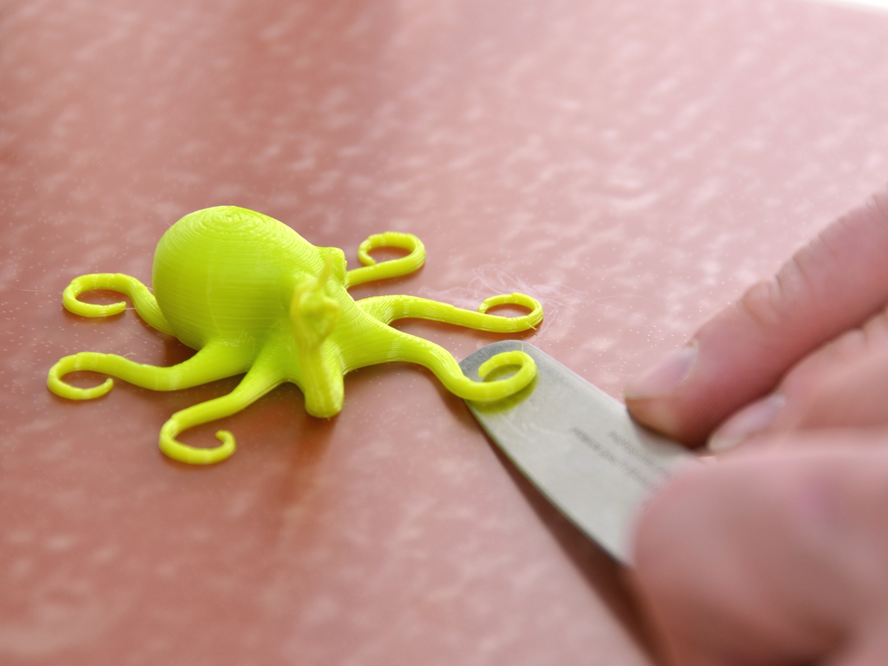
documentation/guide/source/images/TAZ_6_PrintRemoval_second.JPG
