gralco/TAZ6/documentation/guide/source/images/TAZ_6_PrintRemoval_skirt.JPG

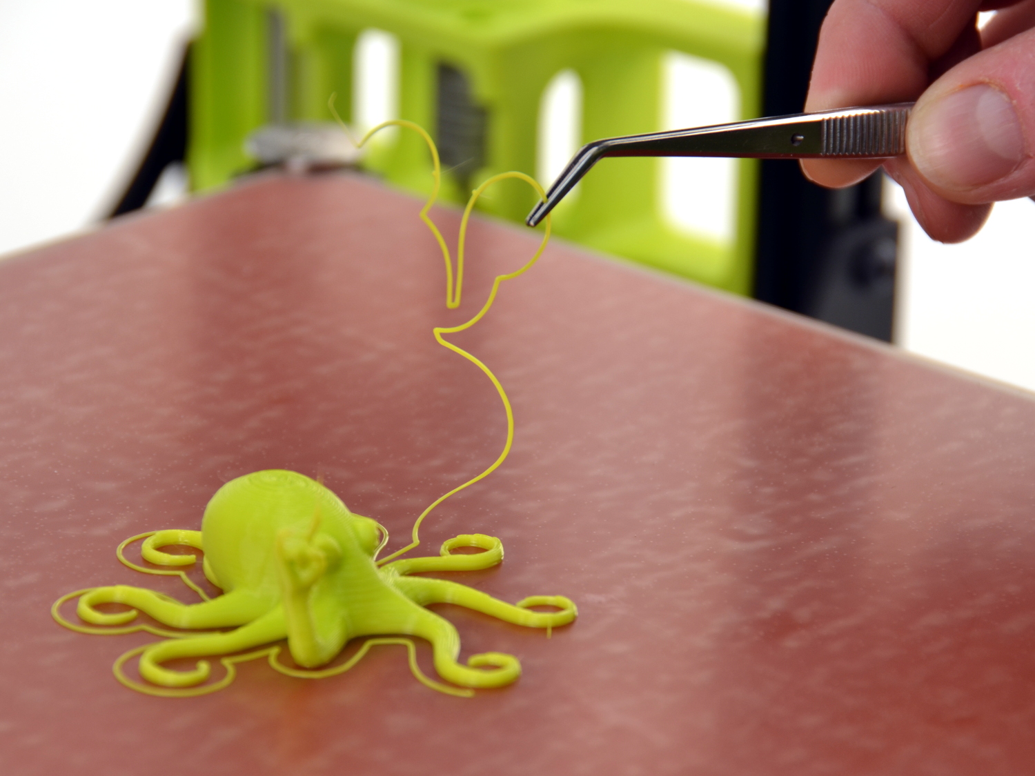
documentation/guide/source/images/TAZ_6_PrintRemoval_skirt.JPG
