gralco/TAZ6/documentation/guide/source/images/TAZ_6_Roctopus.JPG

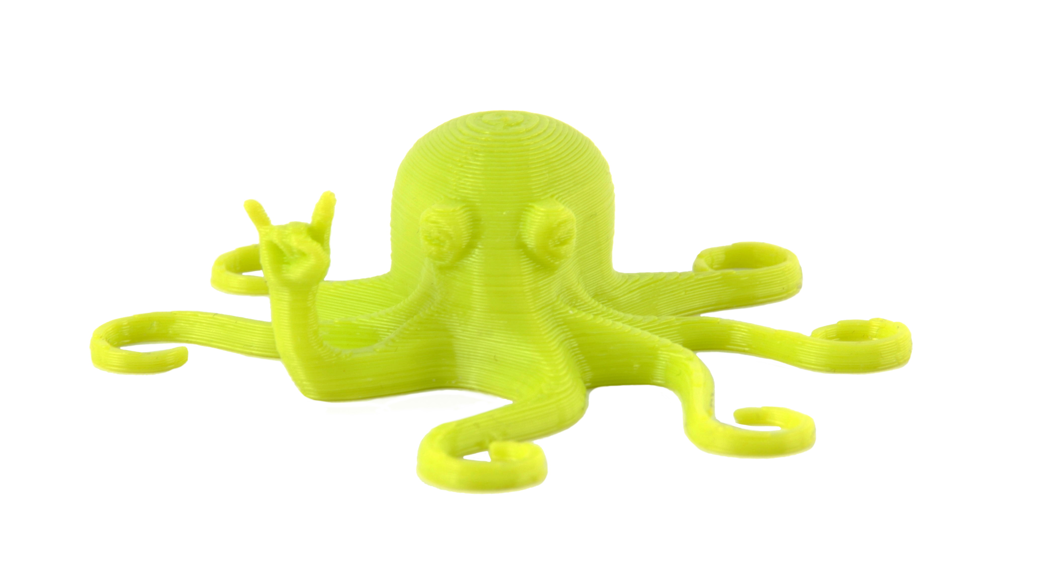
documentation/guide/source/images/TAZ_6_Roctopus.JPG
