gralco/TAZ6/documentation/guide/source/images/TAZ_6_roctopus_printing.JPG

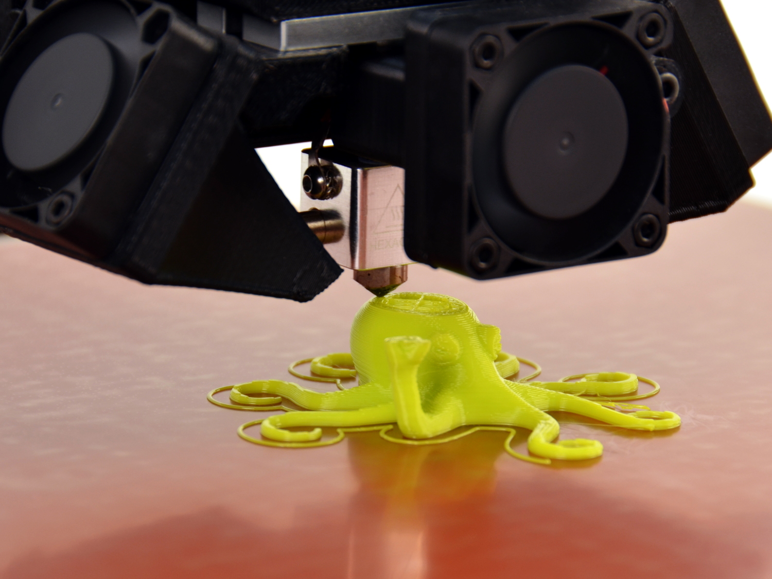
documentation/guide/source/images/TAZ_6_roctopus_printing.JPG
