gralco/TAZ6/documentation/guide/source/images/TAZ_6_SdCard.JPG

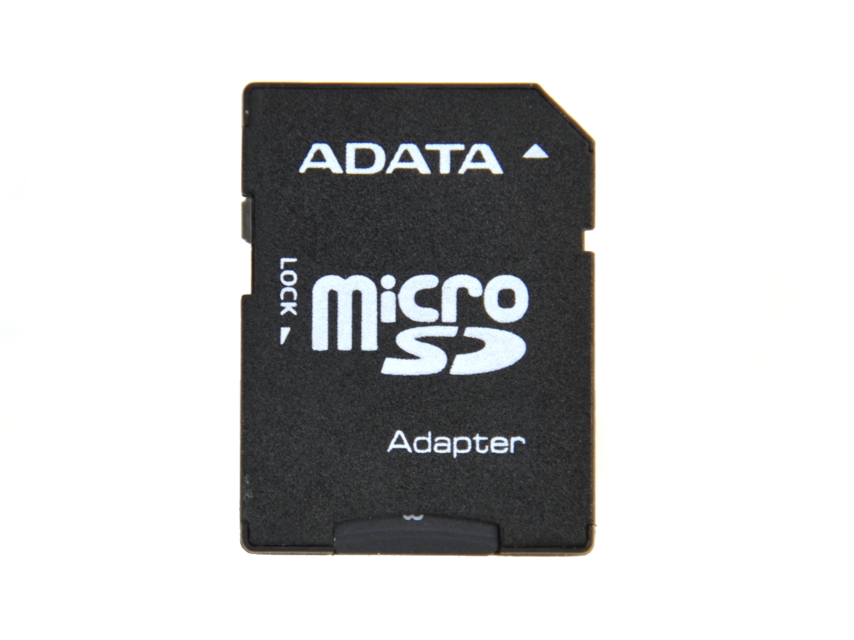
documentation/guide/source/images/TAZ_6_SdCard.JPG
