gralco/TAZ6/documentation/guide/source/images/TAZ_6_SelectYourMachine.png

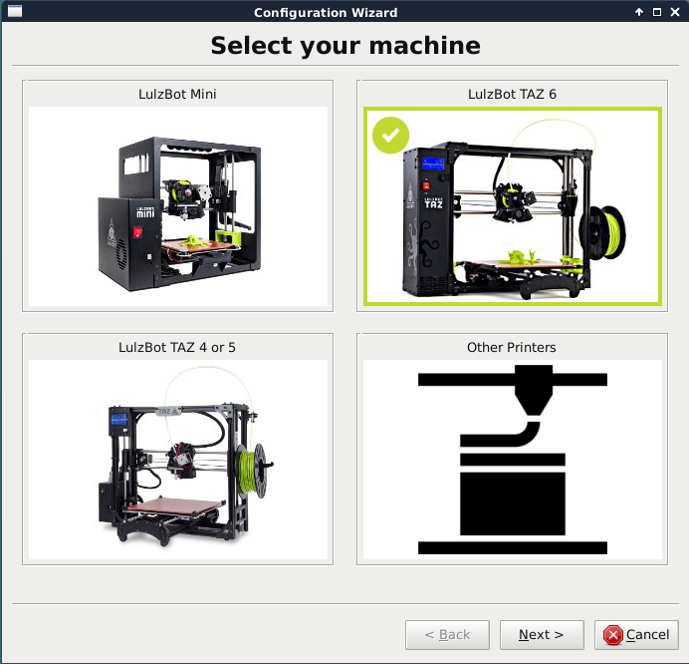
documentation/guide/source/images/TAZ_6_SelectYourMachine.png
