gralco/TAZ6/documentation/guide/source/images/tool_head_connection.JPG

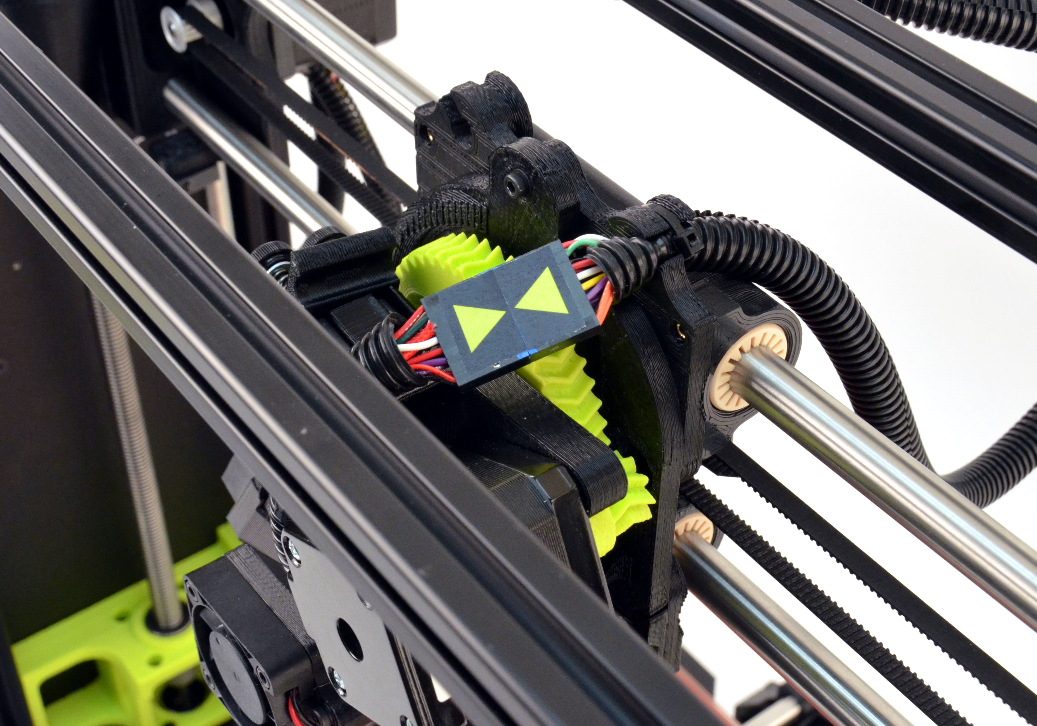
documentation/guide/source/images/tool_head_connection.JPG
