gralco/TAZ6/documentation/guide/source/images/Updated-TAZ6-Toolhead-Selection.png

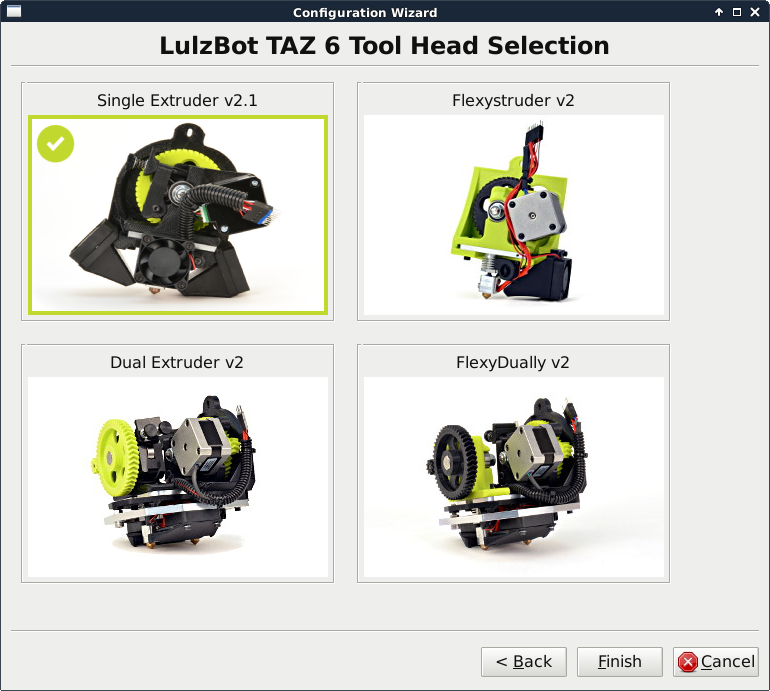
documentation/guide/source/images/Updated-TAZ6-Toolhead-Selection.png
