gralco/TAZ6/documentation/guide/source/Start_cover.png

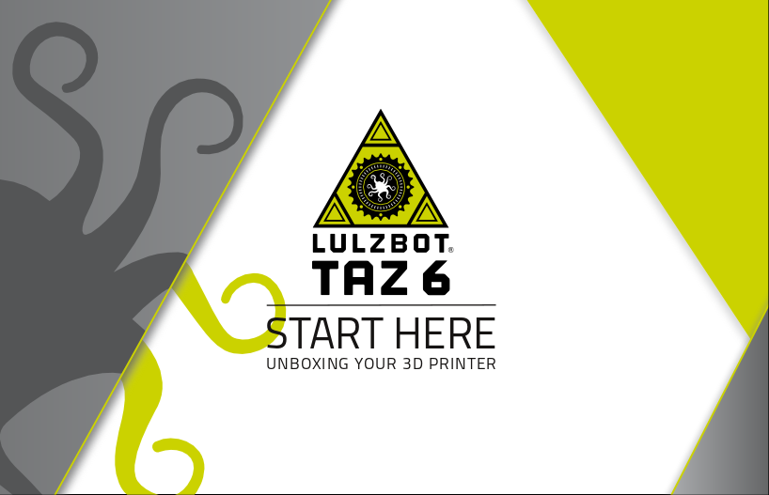
documentation/guide/source/Start_cover.png
