gralco/TAZ6/documentation/manual/links/DSC_0631_resized.png

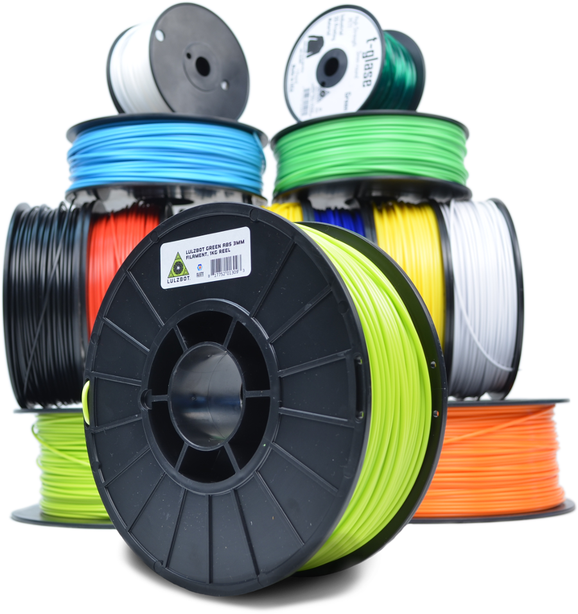
documentation/manual/links/DSC_0631_resized.png
