gralco/TAZ6/documentation/manual/source/images-1600x1200/axes.JPG

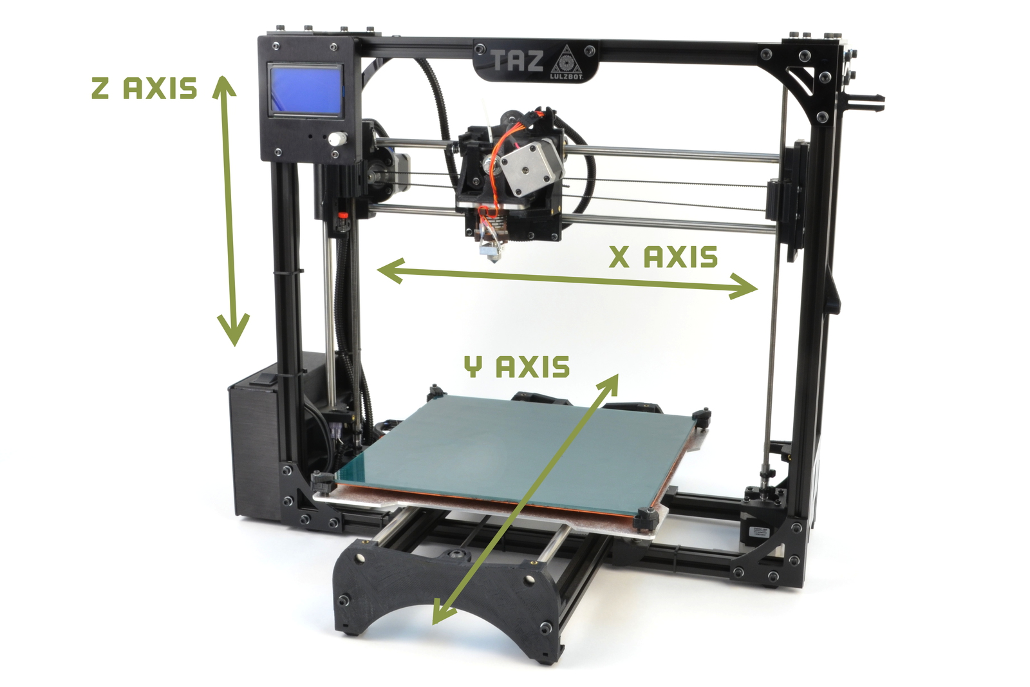
documentation/manual/source/images-1600x1200/axes.JPG
