gralco/TAZ6/documentation/manual/source/images-1600x1200/bed_connectors.JPG

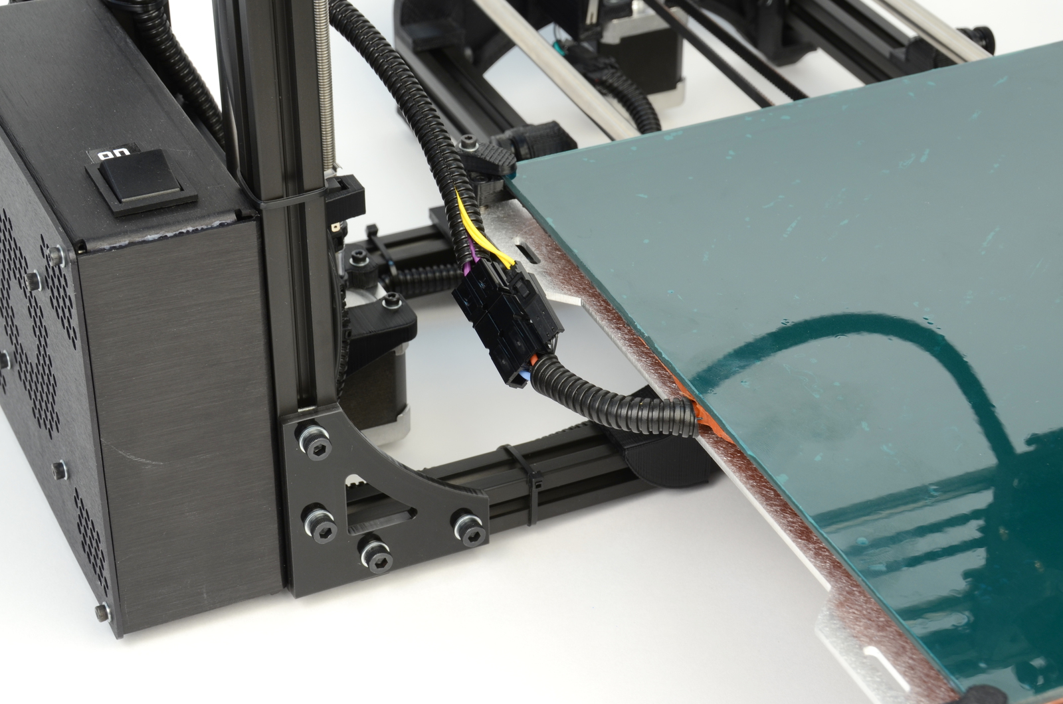
documentation/manual/source/images-1600x1200/bed_connectors.JPG
