gralco/TAZ6/documentation/manual/source/images-1600x1200/bed_connectors_strain_relief.JPG

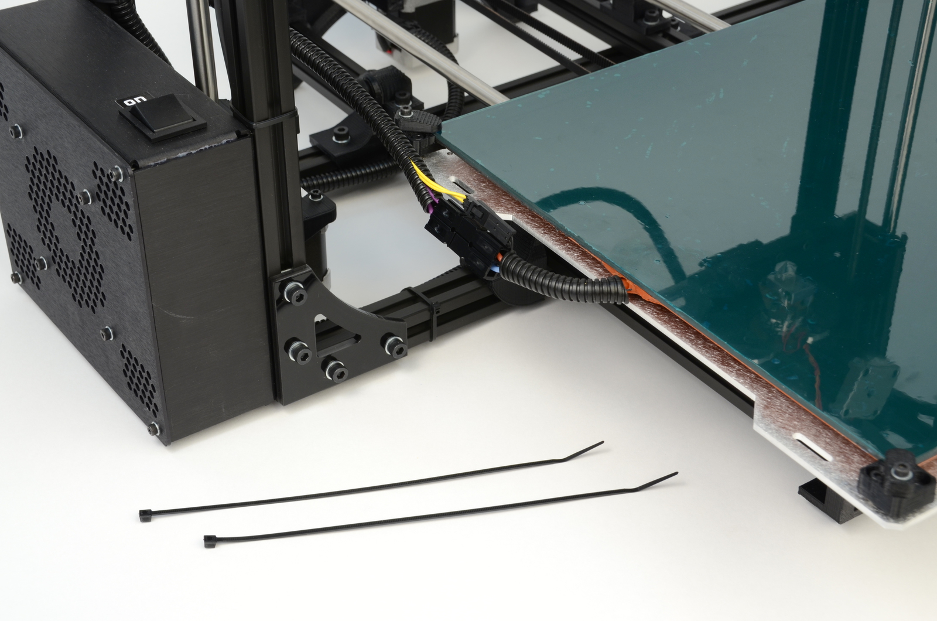
documentation/manual/source/images-1600x1200/bed_connectors_strain_relief.JPG
