gralco/TAZ6/documentation/manual/source/images-1600x1200/bed_connectors_strain_relief_done.JPG

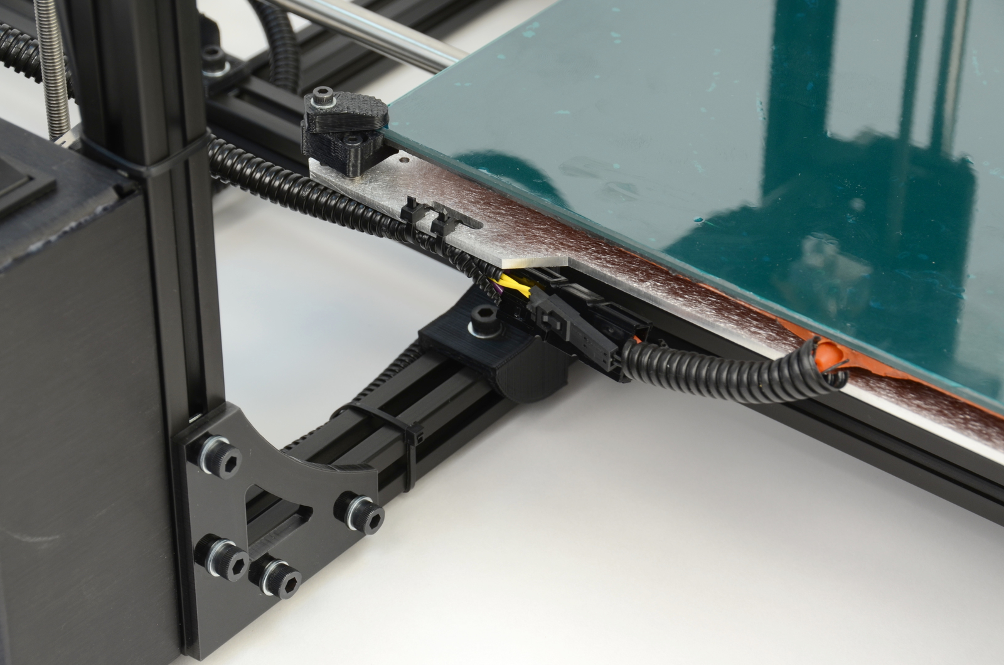
documentation/manual/source/images-1600x1200/bed_connectors_strain_relief_done.JPG
