gralco/TAZ6/documentation/manual/source/images-1600x1200/end_stop_switches.JPG

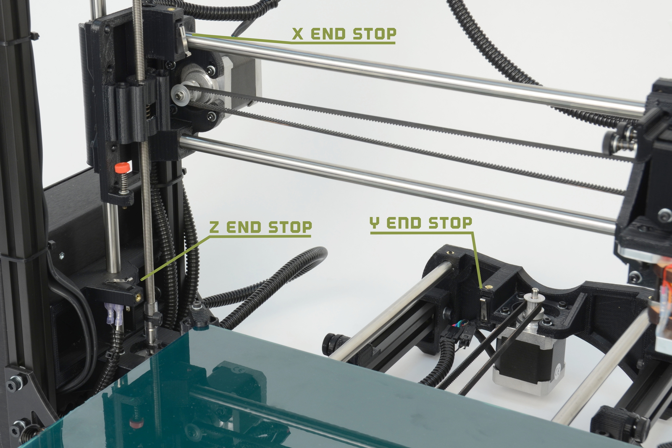
documentation/manual/source/images-1600x1200/end_stop_switches.JPG
