gralco/TAZ6/documentation/manual/source/images-1600x1200/filament_arm.JPG

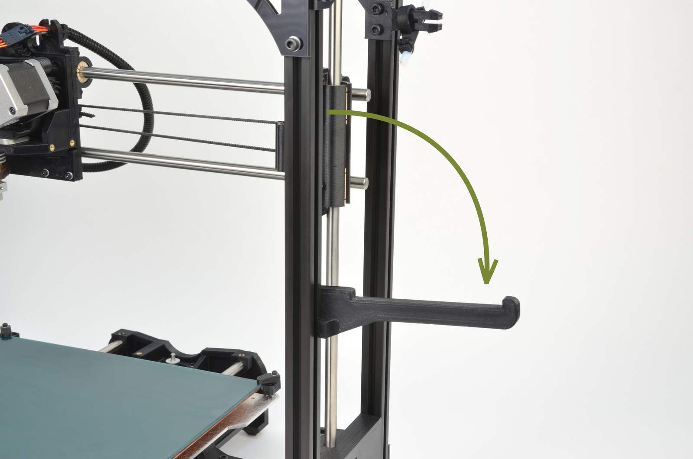
documentation/manual/source/images-1600x1200/filament_arm.JPG
