gralco/TAZ6/documentation/manual/source/images-1600x1200/filament_guide_mount.JPG

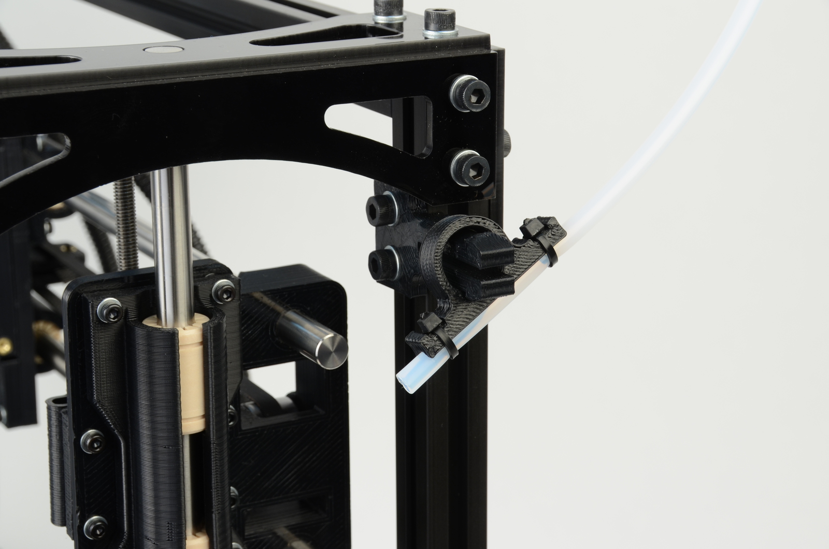
documentation/manual/source/images-1600x1200/filament_guide_mount.JPG
