gralco/TAZ6/documentation/manual/source/images-1600x1200/frame_y_axis_connector.JPG

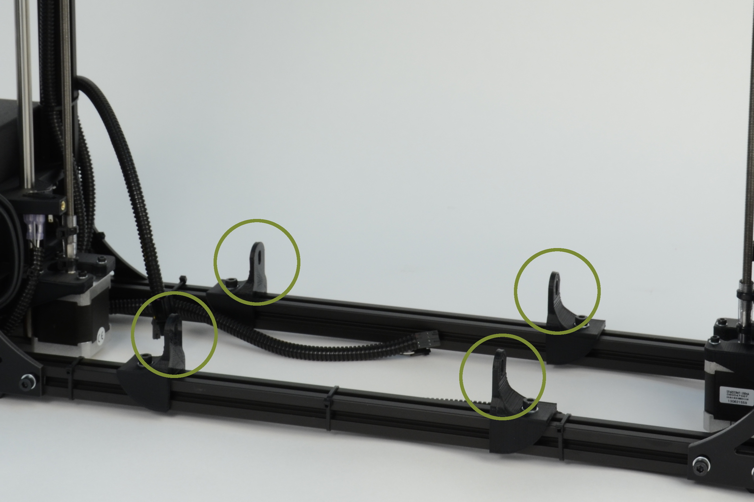
documentation/manual/source/images-1600x1200/frame_y_axis_connector.JPG
