gralco/TAZ6/documentation/manual/source/images-1600x1200/glcd_menu.JPG

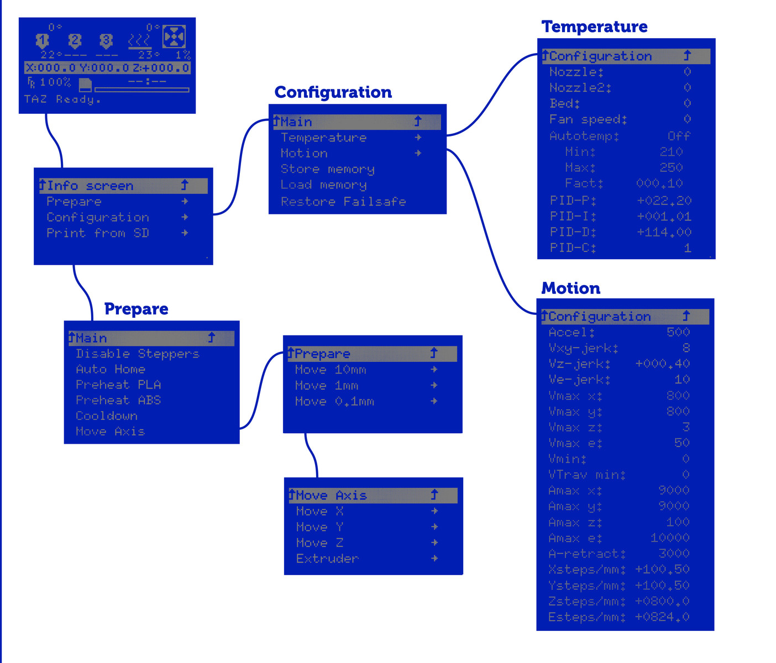
documentation/manual/source/images-1600x1200/glcd_menu.JPG
