gralco/TAZ6/documentation/manual/source/images-1600x1200/katz.jpg

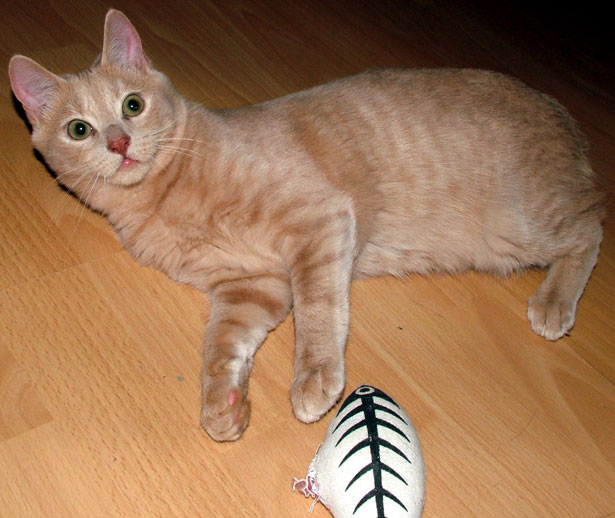
documentation/manual/source/images-1600x1200/katz.jpg
