gralco/TAZ6/documentation/manual/source/images-1600x1200/Layer_Height.jpg

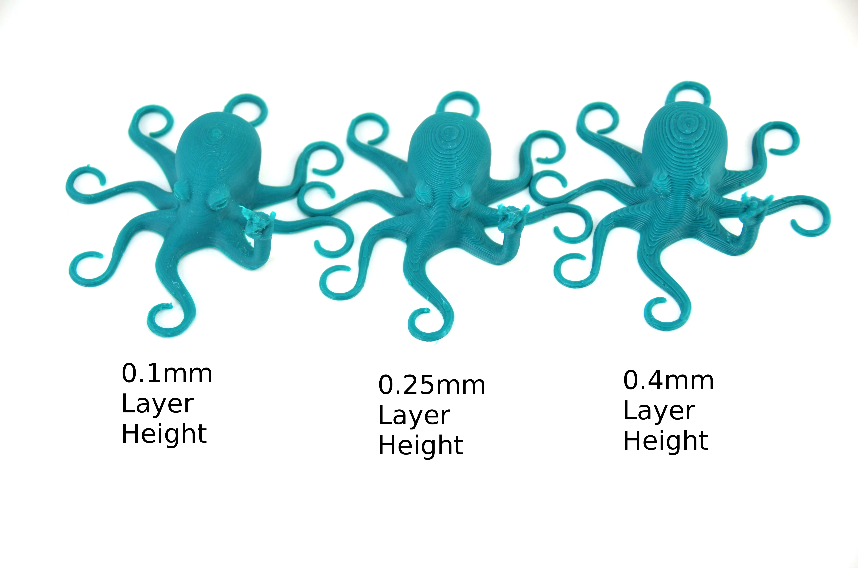
documentation/manual/source/images-1600x1200/Layer_Height.jpg
