gralco/TAZ6/documentation/manual/source/images-1600x1200/Layerheight.png

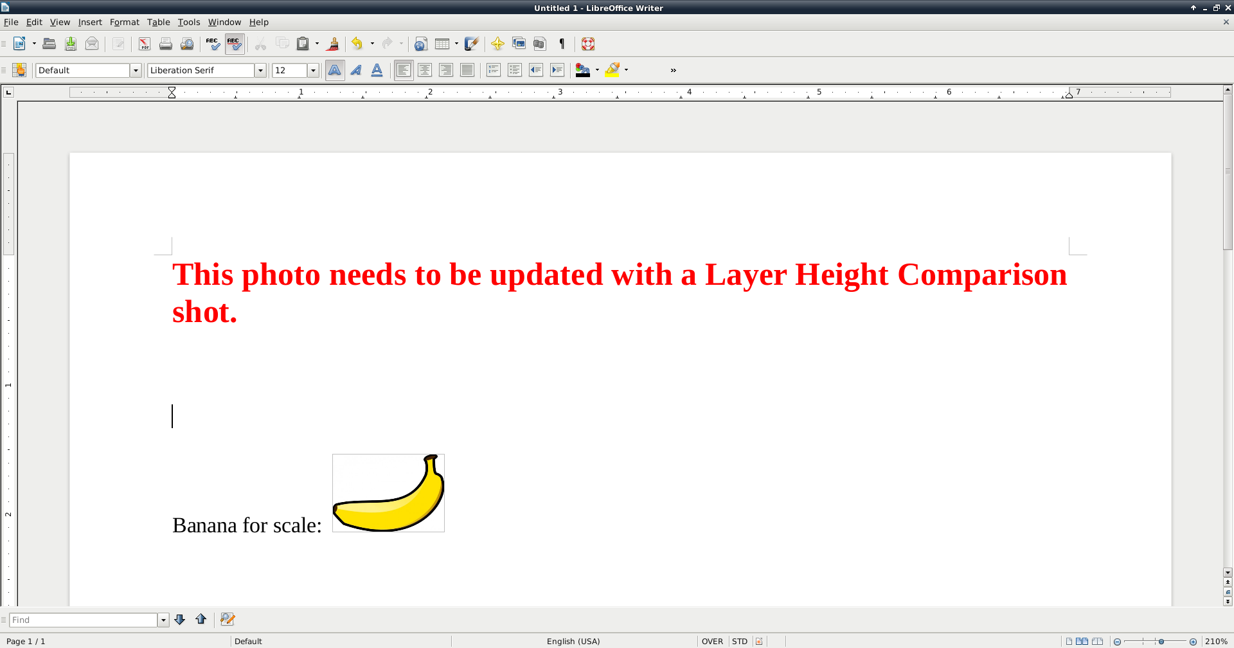
documentation/manual/source/images-1600x1200/Layerheight.png
