gralco/TAZ6/documentation/manual/source/images-1600x1200/layers2.png

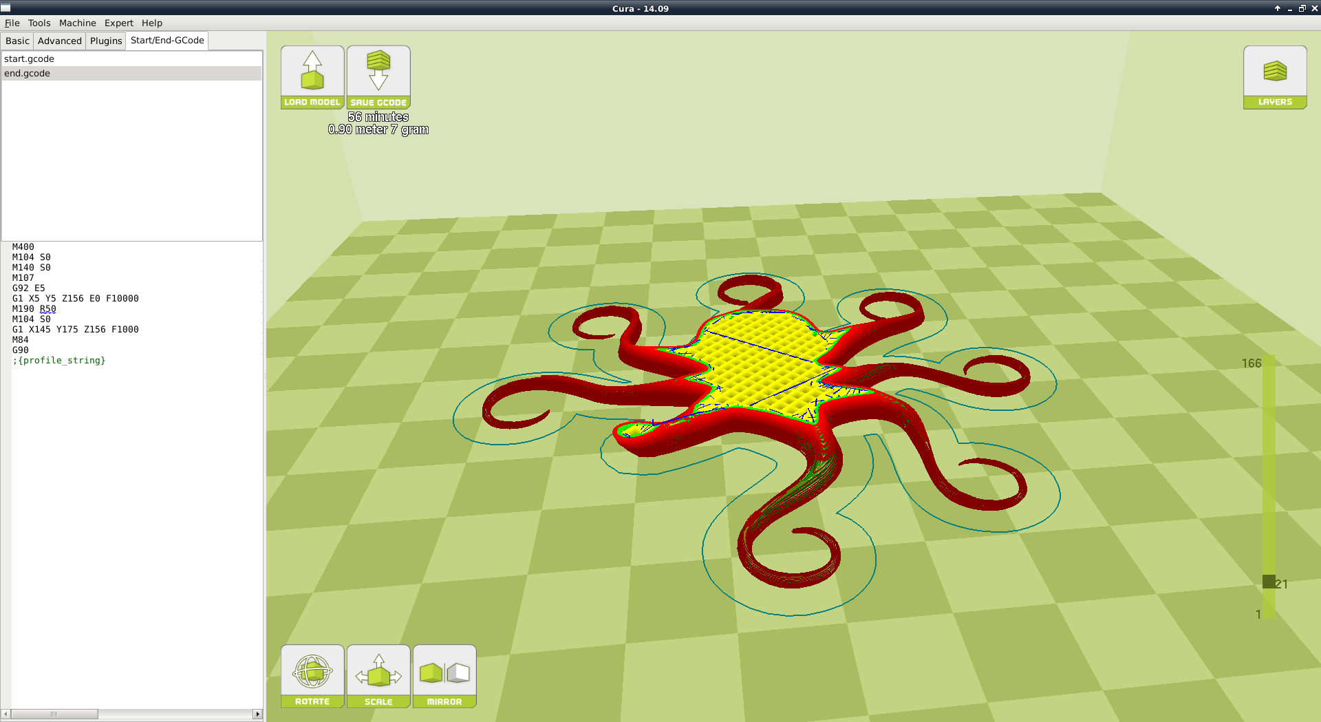
documentation/manual/source/images-1600x1200/layers2.png
