gralco/TAZ6/documentation/manual/source/images-1600x1200/LCD_main_screen.jpg

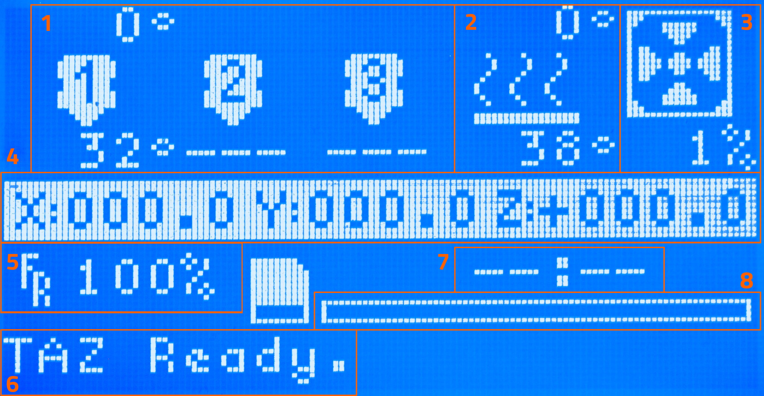
documentation/manual/source/images-1600x1200/LCD_main_screen.jpg
