gralco/TAZ6/documentation/manual/source/images-1600x1200/Machine.png

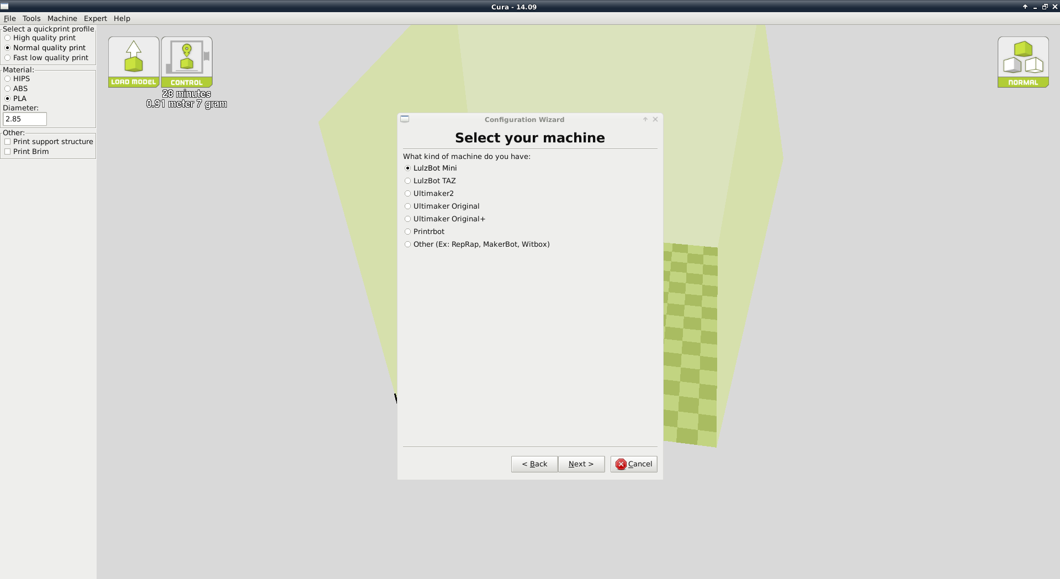
documentation/manual/source/images-1600x1200/Machine.png
