gralco/TAZ6/documentation/manual/source/images-1600x1200/placeholder.jpg

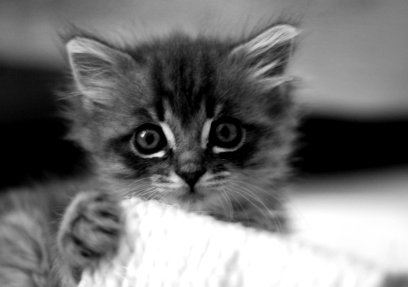
documentation/manual/source/images-1600x1200/placeholder.jpg
