gralco/TAZ6/documentation/manual/source/images-1600x1200/print_control.png

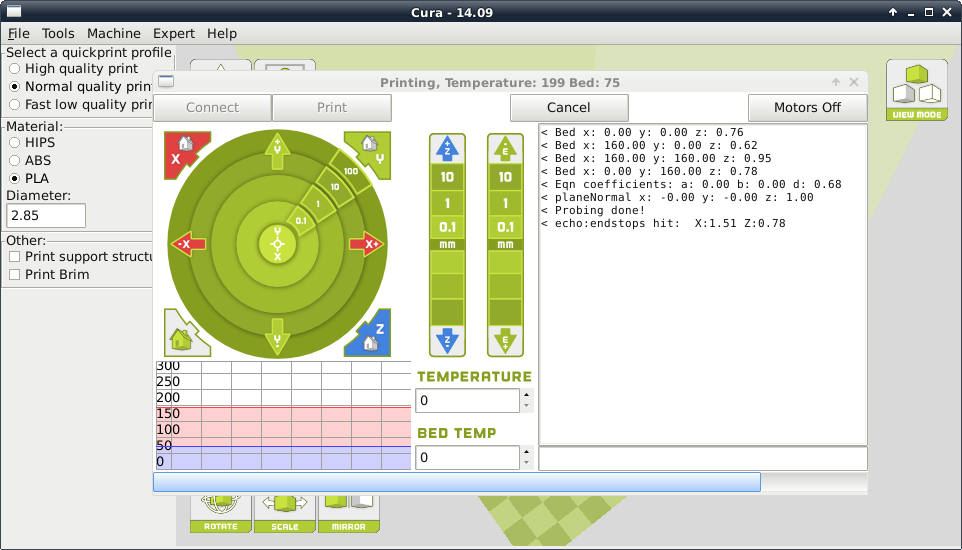
documentation/manual/source/images-1600x1200/print_control.png
