gralco/TAZ6/documentation/manual/source/images-1600x1200/Quick_Settings_TAZ.png

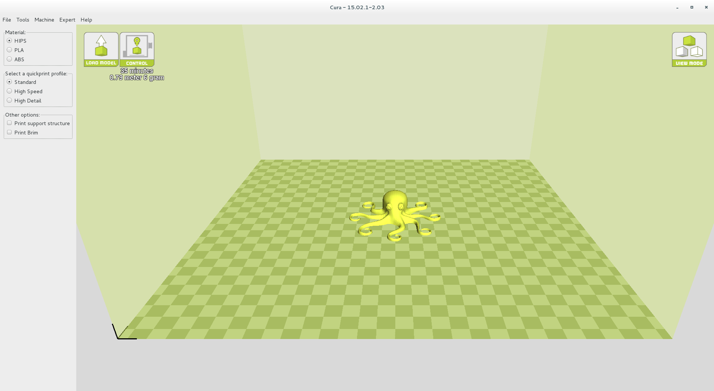
documentation/manual/source/images-1600x1200/Quick_Settings_TAZ.png
