gralco/TAZ6/documentation/manual/source/images-1600x1200/Rotate.png

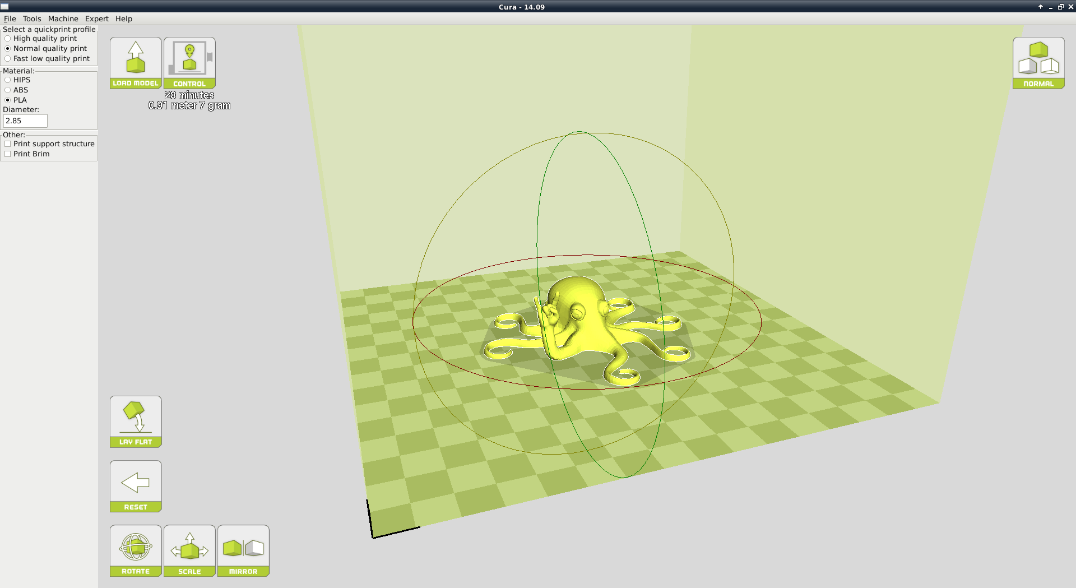
documentation/manual/source/images-1600x1200/Rotate.png
