gralco/TAZ6/documentation/manual/source/images-1600x1200/Rotate_TAZ.png

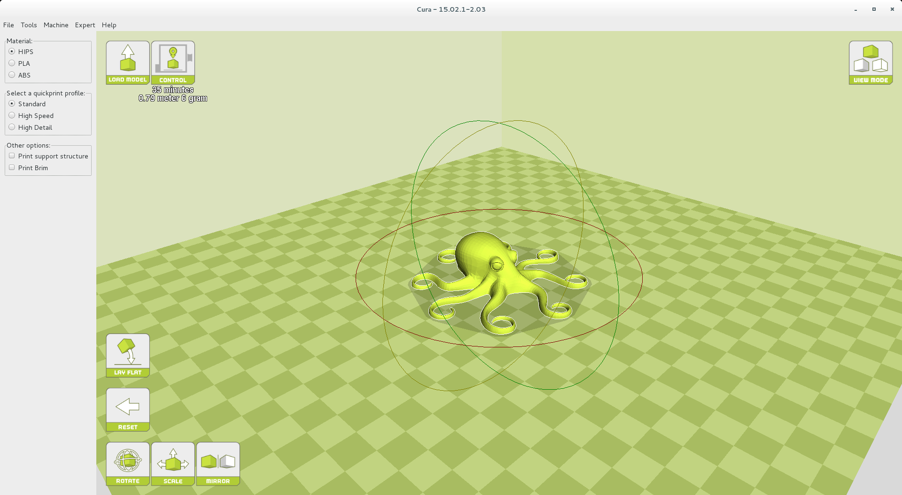
documentation/manual/source/images-1600x1200/Rotate_TAZ.png
