gralco/TAZ6/documentation/manual/source/images-1600x1200/slic3r.jpg

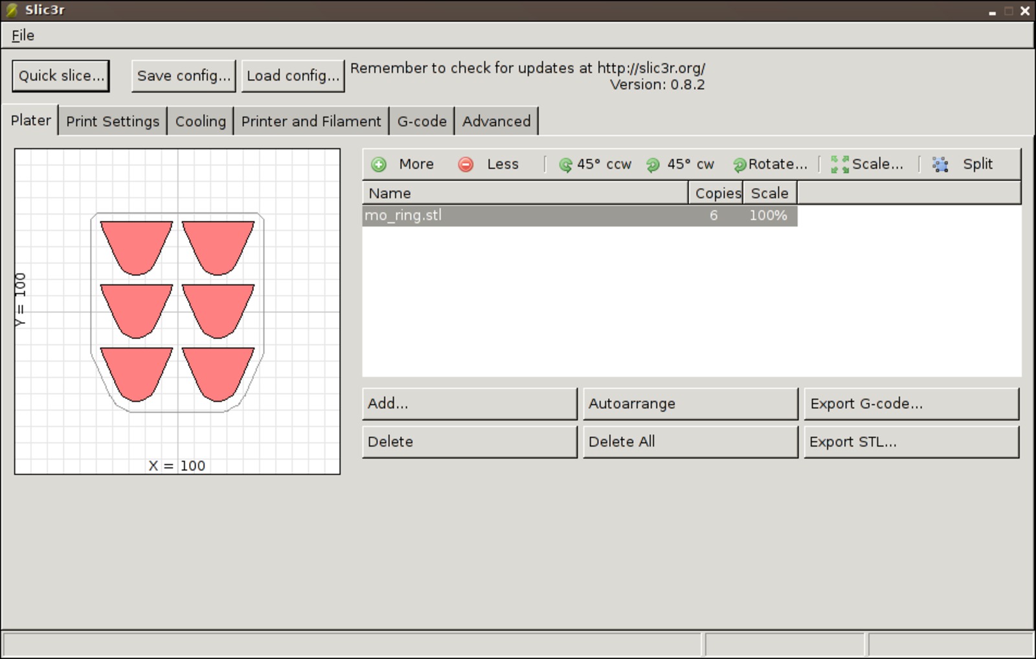
documentation/manual/source/images-1600x1200/slic3r.jpg
