gralco/TAZ6/documentation/manual/source/images-1600x1200/slic3r.png

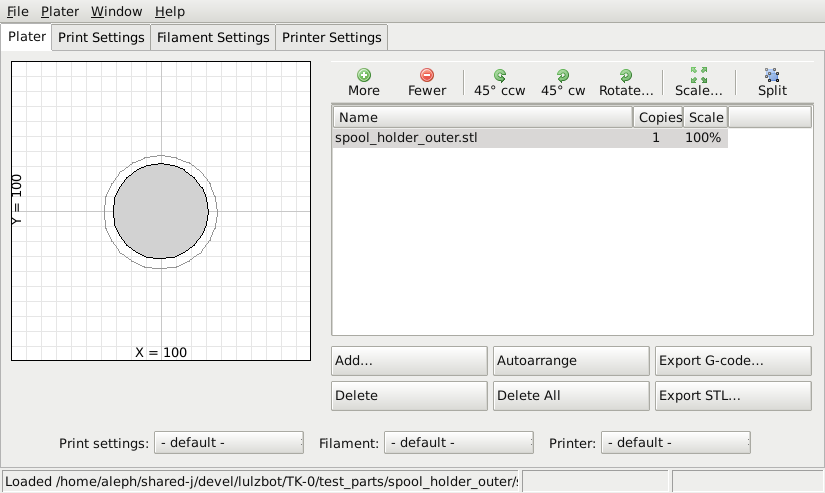
documentation/manual/source/images-1600x1200/slic3r.png
