gralco/TAZ6/documentation/manual/source/images-1600x1200/TAZ_2.0_GLCD-controller.JPG

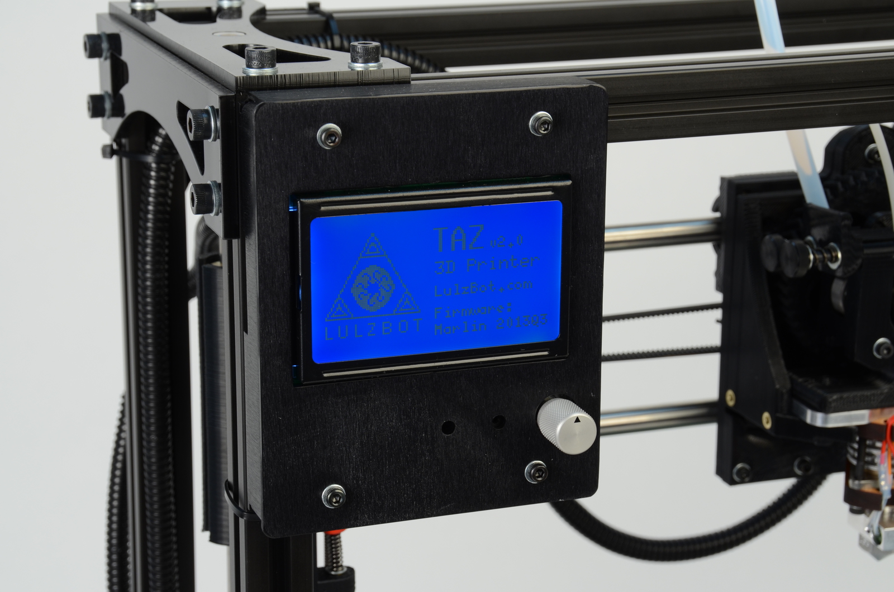
documentation/manual/source/images-1600x1200/TAZ_2.0_GLCD-controller.JPG
