gralco/TAZ6/documentation/manual/source/images-1600x1200/tool_head_connectors.JPG

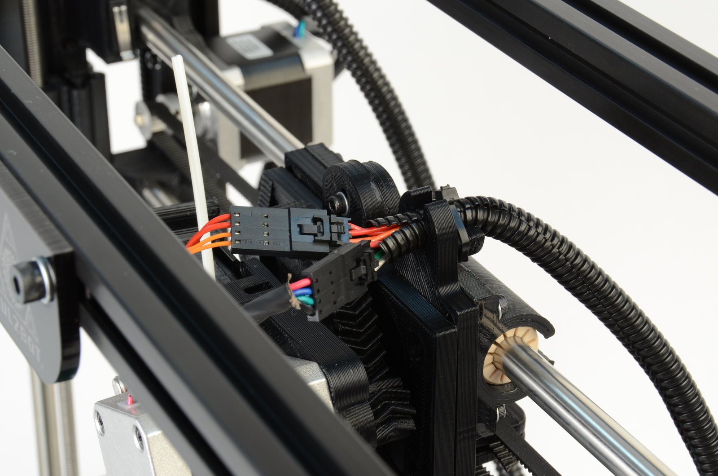
documentation/manual/source/images-1600x1200/tool_head_connectors.JPG
