gralco/TAZ6/documentation/manual/source/images-1600x1200/tool_head_placement.JPG

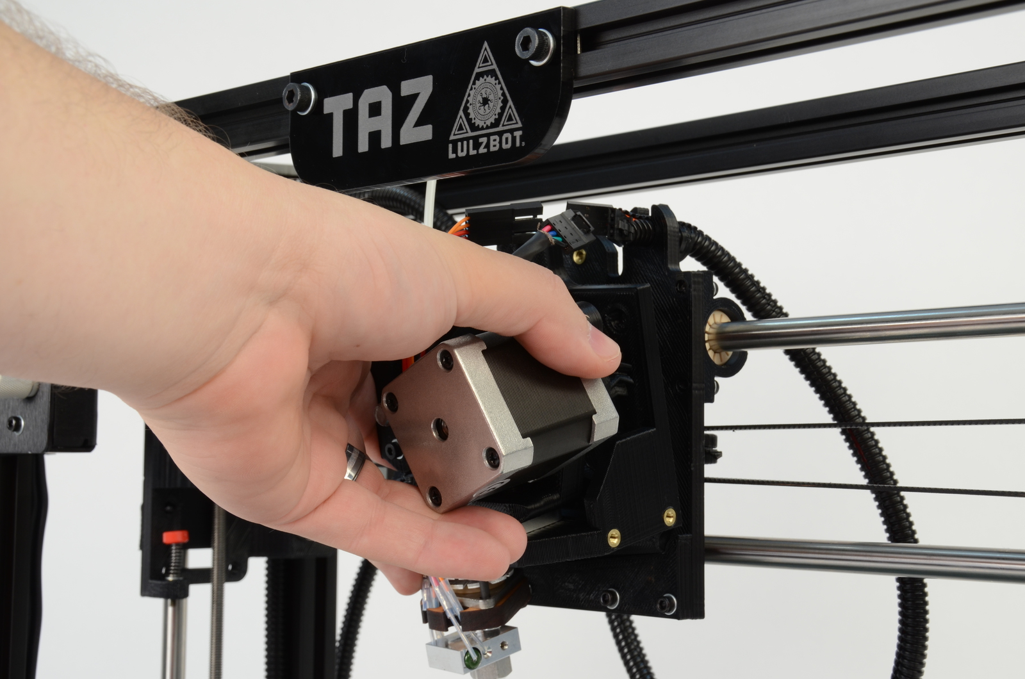
documentation/manual/source/images-1600x1200/tool_head_placement.JPG
