gralco/TAZ6/documentation/manual/source/images-1600x1200/tool_head_screw.JPG

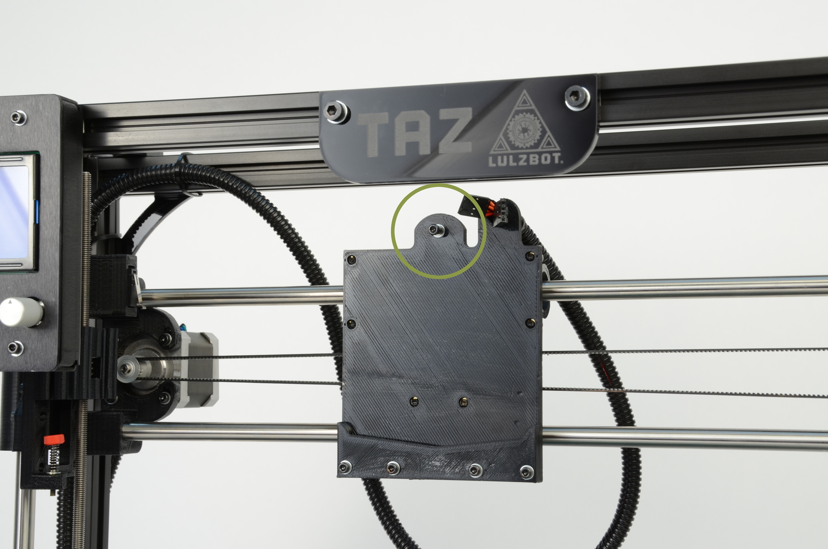
documentation/manual/source/images-1600x1200/tool_head_screw.JPG
