gralco/TAZ6/documentation/manual/source/images-1600x1200/tree3.jpg

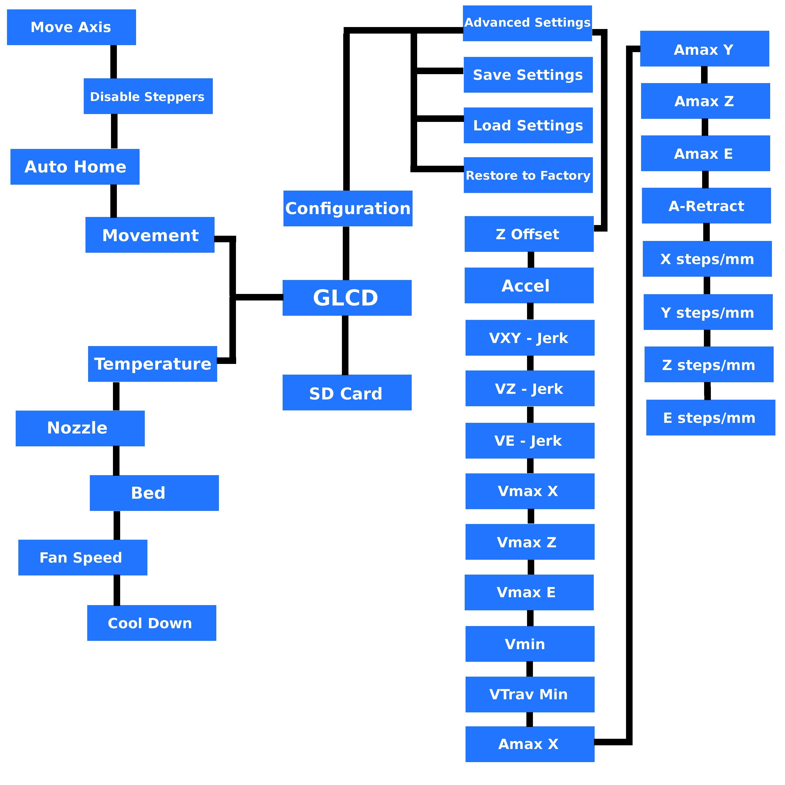
documentation/manual/source/images-1600x1200/tree3.jpg
