gralco/TAZ6/documentation/manual/source/images-1600x1200/y_axis_bolt_tighten.JPG

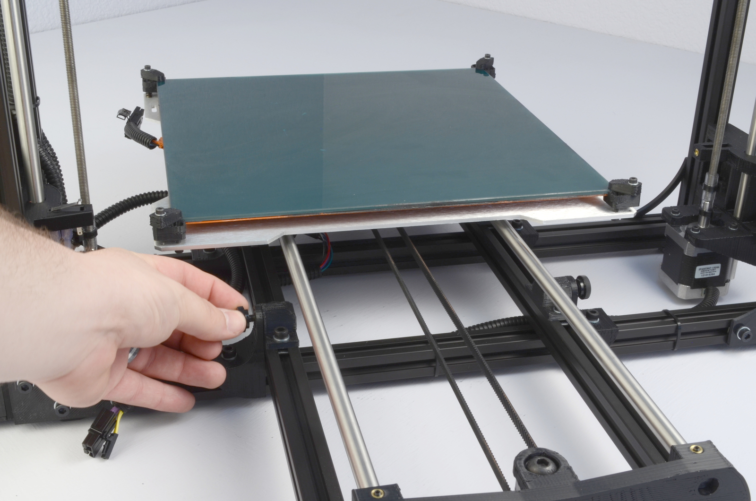
documentation/manual/source/images-1600x1200/y_axis_bolt_tighten.JPG
