gralco/TAZ6/documentation/manual/source/images-1600x1200/y_axis_connectors_zip-tie.JPG

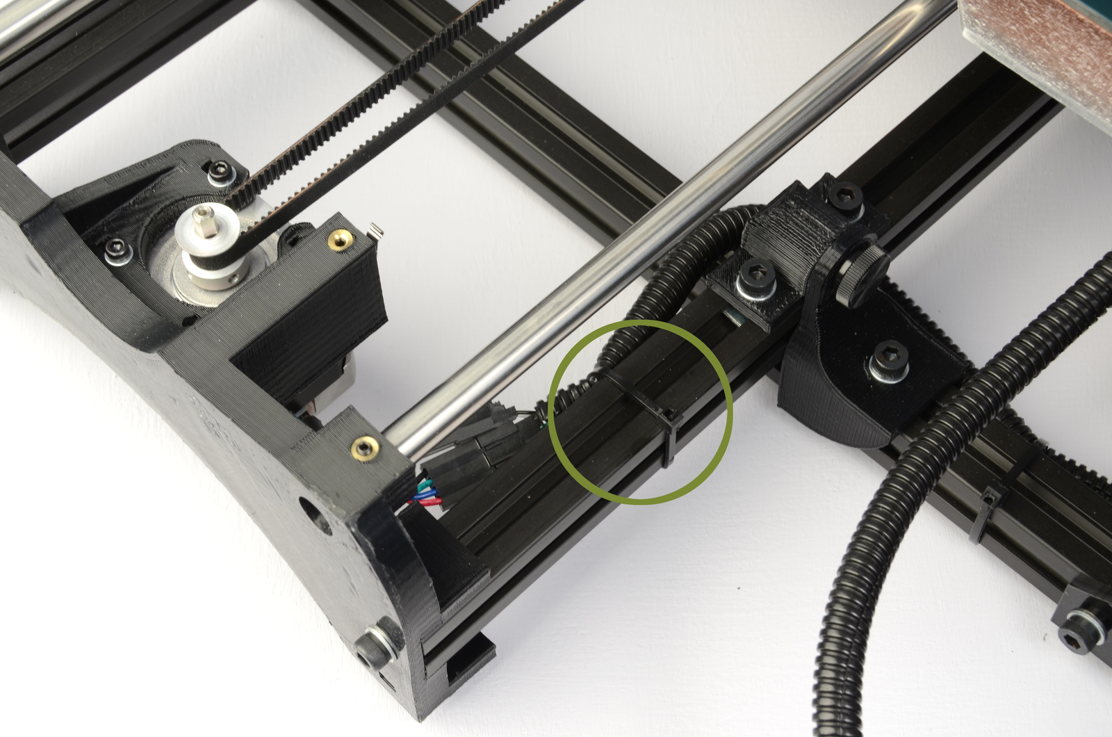
documentation/manual/source/images-1600x1200/y_axis_connectors_zip-tie.JPG
