gralco/TAZ6/documentation/manual/source/images-1600x1200/Z_end_stop_trigger.JPG

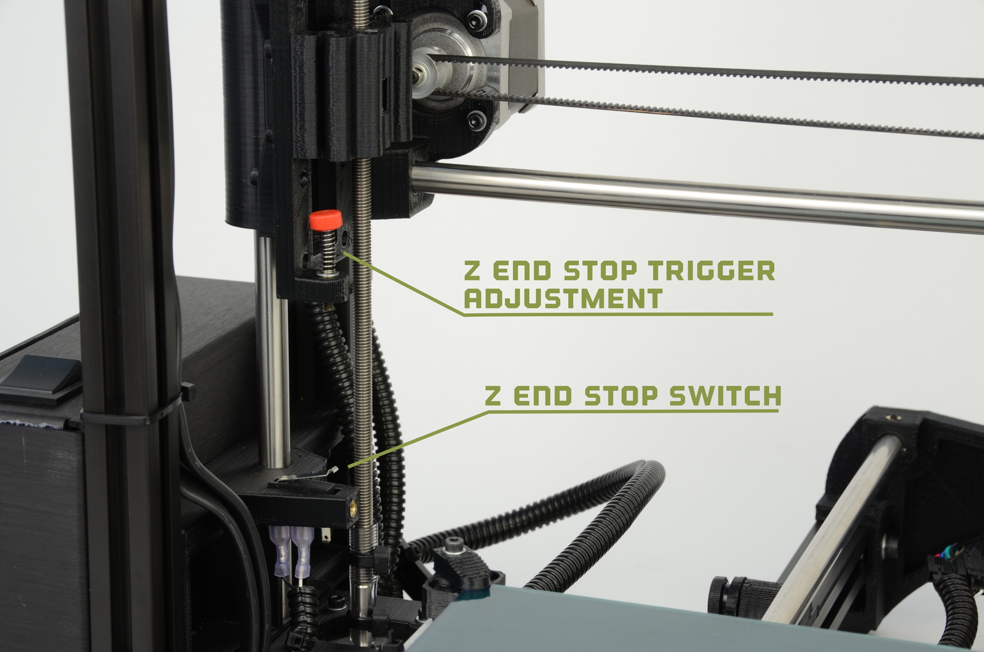
documentation/manual/source/images-1600x1200/Z_end_stop_trigger.JPG
