gralco/TAZ6/documentation/manual/source/images-original/axes.JPG

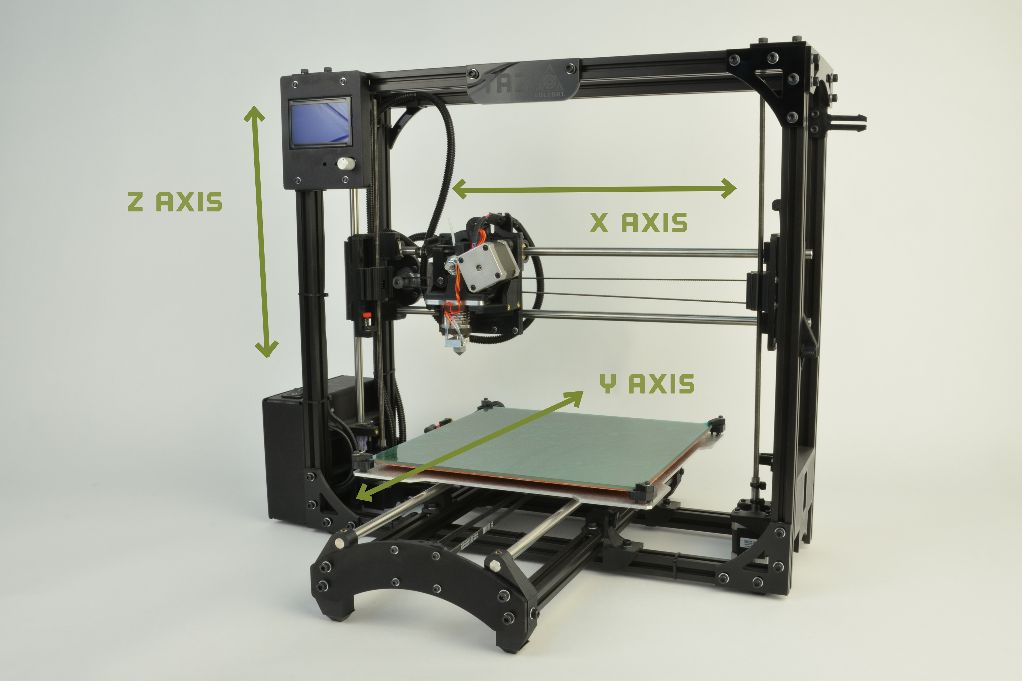
documentation/manual/source/images-original/axes.JPG
