gralco/TAZ6/documentation/manual/source/images-original/bed_connectors_strain_relief.JPG

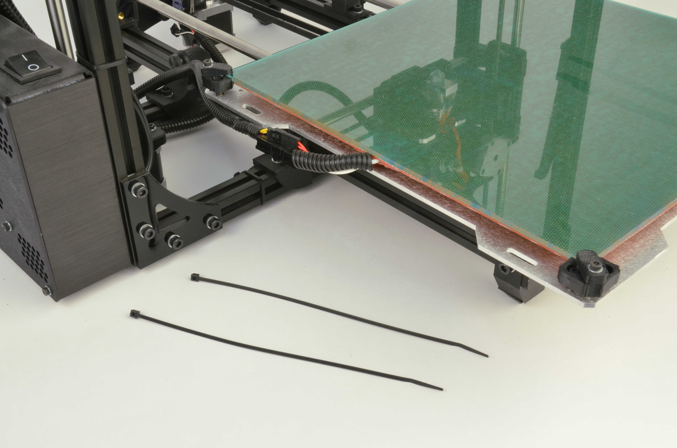
documentation/manual/source/images-original/bed_connectors_strain_relief.JPG
