gralco/TAZ6/documentation/manual/source/images-original/bed_connectors_strain_relief_done.JPG

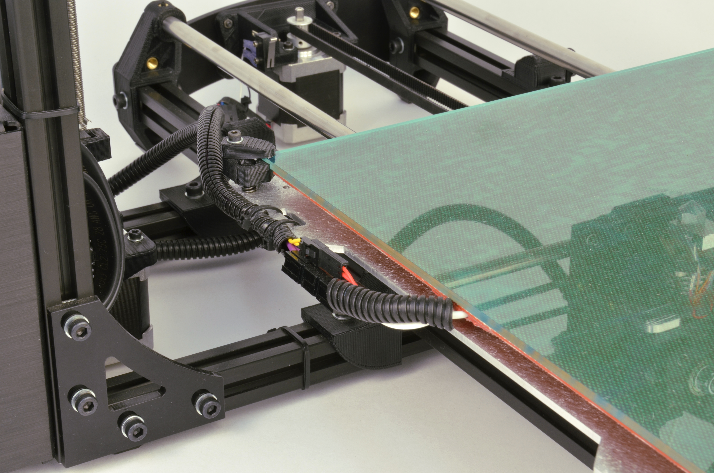
documentation/manual/source/images-original/bed_connectors_strain_relief_done.JPG
