gralco/TAZ6/documentation/manual/source/images-original/end_stop_switches.JPG

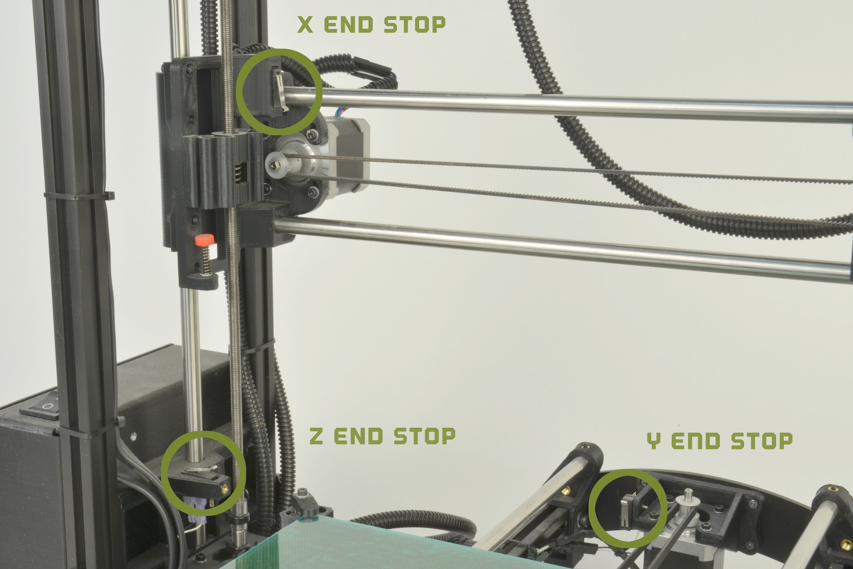
documentation/manual/source/images-original/end_stop_switches.JPG
