gralco/TAZ6/documentation/manual/source/images-original/slic3r.png

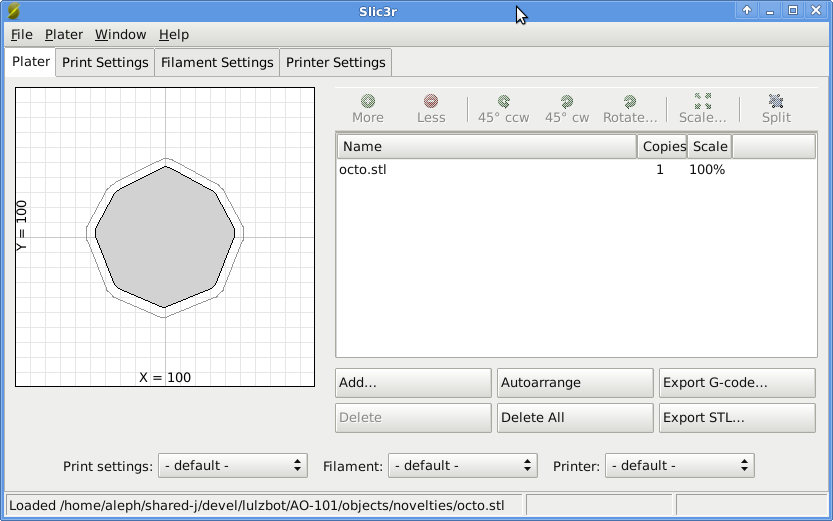
documentation/manual/source/images-original/slic3r.png
