gralco/TAZ6/documentation/manual/source/images-original/y_axis_bolt_tighten.JPG

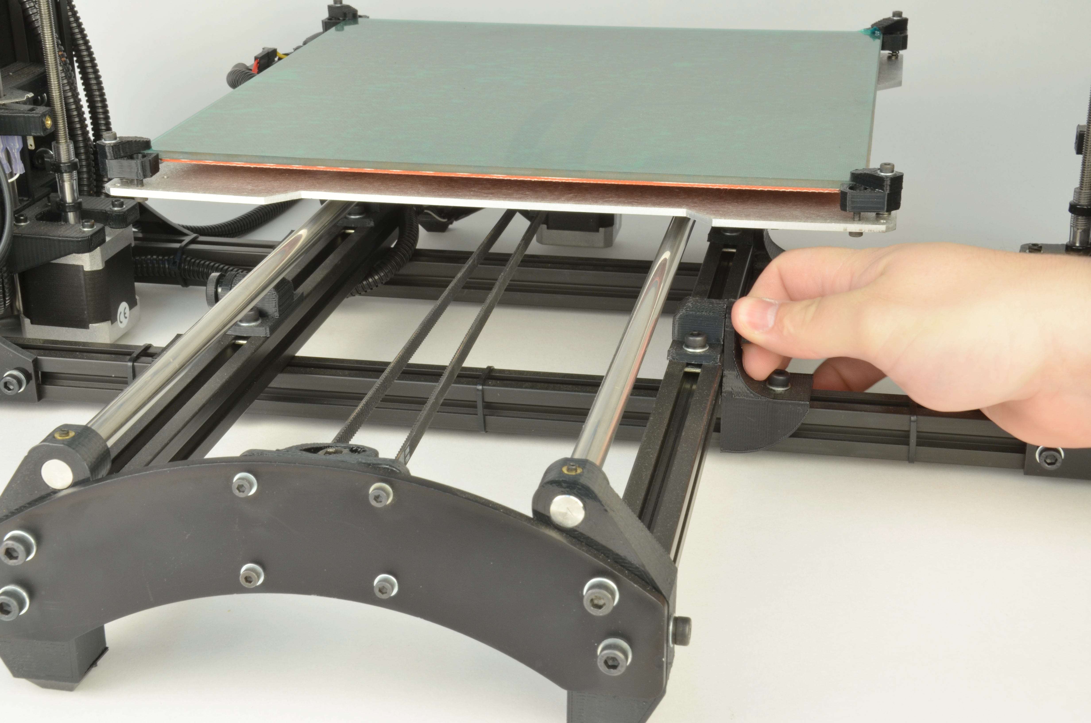
documentation/manual/source/images-original/y_axis_bolt_tighten.JPG
