gralco/TAZ6/documentation/manual/source/images-original/y_axis_bolts.JPG

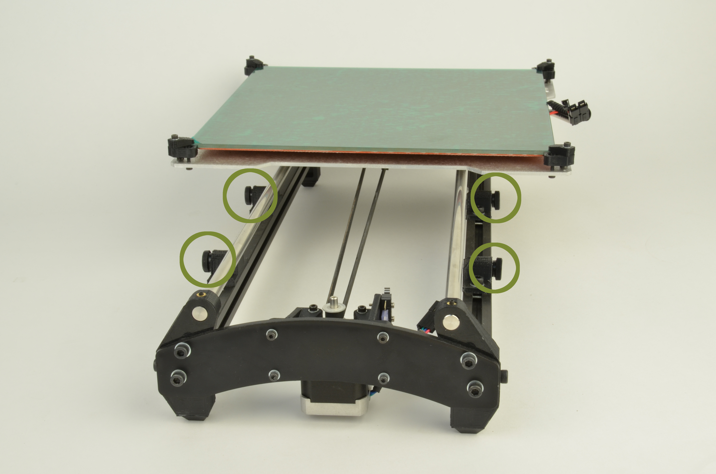
documentation/manual/source/images-original/y_axis_bolts.JPG
