gralco/TAZ6/documentation/manual/source/images-original/y_axis_connectors.JPG

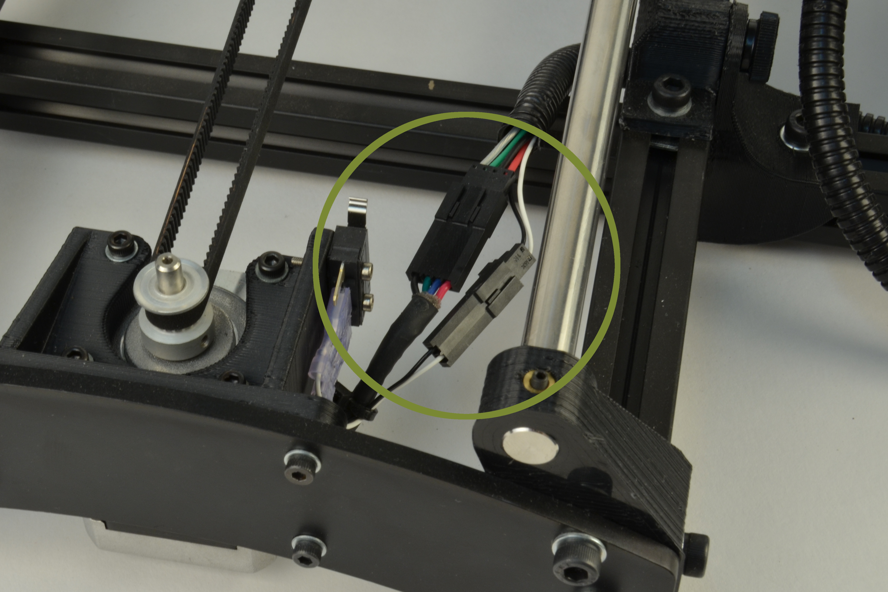
documentation/manual/source/images-original/y_axis_connectors.JPG
