gralco/TAZ6/documentation/manual/source/images-original/y_axis_connectors_zip-tie.JPG

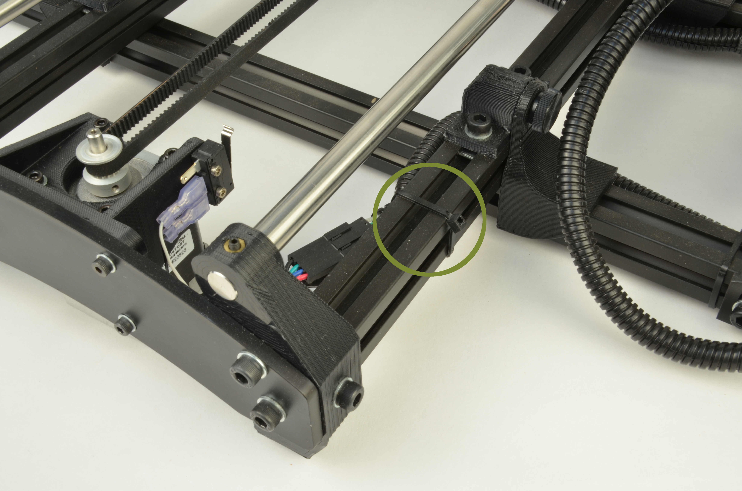
documentation/manual/source/images-original/y_axis_connectors_zip-tie.JPG
