gralco/TAZ6/sample_prints/calibration/line/README.txt

These are the calibration gcode files from the pilot assembly in July 2017.
