gralco/TAZ6/production_docs/TAZ6_calibration_SOP.odt

TAZ 6 Final Calibration Standard Procedure

CC-BY-SA 2016, Aleph Objects, Inc.

- Check extruder E-step number
  - The printheads will come out of pilot with an eStep number assigned
  - Put this number into the eeprom using the LCD
    - Configuration→ Advanced Settings → Esteps/mm
    - Change this value to the one assigned to the printhead in pilot
    - Save (configuration → Save Settings)
  - Verify that it's saved in eeprom
  - Run 100mm of nGen filament at 90mm/s and 230C hotend temp
    - Be sure to use the gCode saved on the SD card that will ship with the printer
      - print from SD → Calibration → extruder_calibration_TAZ6_nGen.g
- Print octopus and check z-offset
  - Be sure to print from the SD card included with the printer
      - print from SD → Calibration → calibration_octopus_taz6.gcode
  - the octopus saved on the gcode has a spaced out skirt, set the z-offset through the LCD during the skirt
    - Configuration→ Advanced Settings → Z-Offset
    - You MUST click the center knob when the z-offset is correct to save it
    - When the print is done, check that the offset has been changed after power cycling the printer.
- Inspect octopus – the bottom layer should not be under or over squished. If it appears to be over or under squished, measure the skirt to confirm and repeat the octopus print and modify the z-offset.
  - The skirt should be between 0.325 and 0.450mm
- Ensure that the eStep value and the z-offset are recorded correctly on the TAZ6 acceptance record and the printer master build log
