gralco/TAZ6/sample_prints/calibration/index.html

# Index of /TAZ/Olive/sample_prints/calibration

(ICO) | Name | Last modified | Size | Description
(PARENTDIR) | Parent Directory | | -
( ) | 0.50-Noz_calibration-100mm-90_taz_6.gcode | 2016-09-28 20:19 | 642
( ) | TAZ-Mini1_x1_E-StepColdPull-nGen.gcode | 2018-09-17 19:19 | 1.5K
( ) | TAZ-Mini1_x2_E-StepColdPull-nGen.gcode | 2018-09-17 19:19 | 2.6K
( ) | XYZ_tester.gcode | 2016-09-28 20:19 | 125
( ) | Z_tester.gcode | 2016-09-28 20:19 | 165
( ) | burnin.gcode | 2016-09-28 20:19 | 7.7K
( ) | calibration_octopus_taz6_nGen-high-speed.gcode | 2016-09-28 20:19 | 972K
( ) | extruder_calibration_TAZ6_nGen.g | 2016-09-28 20:19 | 800
(DIR) | line/ | 2017-07-10 15:49 | -
( ) | shortened_0.50-Noz_calibration-100mm-90_taz_6.gcode | 2016-09-28 20:19 | 416
( ) | z_shipping_245.gcode | 2016-09-28 20:19 | 116
