gralco/TAZ6/production_parts/jigs/control_box_test_fixture/index.html

# Index of /TAZ/Olive/production_parts/jigs/control_box_test_fixture

(ICO) | Name | Last modified | Size | Description
(PARENTDIR) | Parent Directory | | -
( ) | Control_box_test_fixture_front.stl | 2016-09-16 21:56 | 1.2M
( ) | Control_box_test_fixture_front_0.1.stl | 2016-09-16 21:56 | 1.5M
( ) | Control_box_test_fixture_top.stl | 2016-09-16 21:56 | 209K
( ) | Control_box_test_fixture_top_plate.stl | 2016-09-16 21:56 | 181K
( ) | TAZ6_control_box_test_0.1.gcode | 2016-09-16 21:56 | 1.0K
( ) | TAZ6_control_box_test_0.2.gcode | 2016-09-16 21:56 | 1.3K
( ) | TAZ6_control_box_test_0.3.gcode | 2016-09-16 21:56 | 1.4K
( ) | TAZ6_control_box_test_0.4.gcode | 2016-09-16 21:56 | 3.3K
( ) | control_box_test_fixture_front.fcstd | 2016-09-16 21:56 | 226K
( ) | control_box_test_fixture_front_0.1.fcstd | 2016-09-16 21:56 | 293K
( ) | control_box_test_fixture_front_0.1.fcstd1 | 2016-09-16 21:56 | 223K
( ) | control_box_test_fixture_top.fcstd | 2016-09-16 21:56 | 59K
( ) | control_box_test_fixture_top_plate.fcstd | 2016-09-16 21:56 | 13K
( ) | frame_T.fcstd | 2016-09-16 21:56 | 12K
( ) | frame_T.fcstd1 | 2016-09-16 21:56 | 12K
( ) | frame_T.stl | 2016-09-16 21:56 | 187K
( ) | frame_corner.fcstd | 2016-09-16 21:56 | 13K
( ) | frame_corner.fcstd1 | 2016-09-16 21:56 | 9.7K
( ) | frame_corner.stl | 2016-09-16 21:56 | 141K
( ) | frame_corner_41.5_degree.fcstd | 2016-09-16 21:56 | 9.0K
( ) | frame_corner_41.5_degree.stl | 2016-09-16 21:56 | 150K
( ) | frame_corner_48.5_degree.fcstd | 2016-09-16 21:56 | 8.9K
( ) | frame_corner_48.5_degree.stl | 2016-09-16 21:56 | 150K
( ) | heater_pwm_fan_test_ext.fcstd | 2016-09-16 21:56 | 294K
( ) | heater_pwm_fan_test_ext.stl | 2016-09-16 21:56 | 711K
(DIR) | marlin/ | 2017-02-20 23:41 | -
( ) | stepper_arrow_wheel.fcstd | 2016-09-16 21:56 | 39K
( ) | stepper_arrow_wheel.stl | 2016-09-16 21:56 | 291K
( ) | stepper_arrows.stl | 2016-09-16 21:56 | 116K
