gralco/TAZ6/production_parts/jigs/harness_test_fixture/index.html

# Index of /TAZ/Olive/production_parts/jigs/harness_test_fixture

(ICO) | Name | Last modified | Size | Description
(PARENTDIR) | Parent Directory | | -
( ) | blank_tile.stl | 2016-09-16 21:56 | 85K
( ) | taz_Y_Z_Z_external_harness.fcstd | 2016-09-16 21:56 | 217K
( ) | taz_Y_Z_Z_external_harness.fcstd1 | 2016-09-16 21:56 | 217K
( ) | taz_Y_Z_Z_external_harness_proto_board_plate.fcstd | 2016-09-16 21:56 | 13K
( ) | taz_Y_Z_Z_external_harness_proto_board_plate.fcstd1 | 2016-09-16 21:56 | 13K
( ) | taz_Y_Z_Z_external_harness_proto_board_plate.stl | 2016-09-16 21:56 | 184K
( ) | taz_bed_external_harness.stl | 2016-09-16 21:56 | 357K
( ) | taz_bed_external_harness_v2.stl | 2016-09-16 21:56 | 343K
( ) | taz_dual_harness.fcstd | 2016-09-16 21:56 | 94K
( ) | taz_dual_harness.stl | 2016-09-16 21:56 | 1.0M
( ) | taz_dual_harness_internal.fcstd | 2016-09-16 21:56 | 108K
( ) | taz_dual_harness_internal.stl | 2016-09-16 21:56 | 1.0M
( ) | taz_heat_bed_external_extention_harness.fcstd | 2016-09-16 21:56 | 81K
( ) | taz_heat_bed_external_extention_harness.stl | 2016-09-16 21:56 | 425K
( ) | taz_heat_bed_external_extention_harness_plate.fcstd | 2016-09-16 21:56 | 186K
( ) | taz_heat_bed_external_extention_harness_plate.stl | 2016-09-16 21:56 | 458K
( ) | taz_heat_bed_external_harness.fcstd | 2016-09-16 21:56 | 140K
( ) | taz_heat_bed_external_harness.fcstd1 | 2016-09-16 21:56 | 119K
( ) | taz_heat_bed_external_harness_v2.fcstd | 2016-09-16 21:56 | 117K
( ) | taz_x_axis_external_harness.fcstd | 2016-09-16 21:56 | 537K
( ) | taz_x_axis_external_harness.fcstd1 | 2016-09-16 21:56 | 489K
( ) | taz_x_axis_external_harness.stl | 2016-09-16 21:56 | 721K
( ) | taz_y_z_z_external_harness.stl | 2016-09-16 21:56 | 1.2M
