gralco/TAZ6/production_docs/OHAI/REF_ControlBox_TestSequence_OHAI.pdf

Workflow_2

TAZ 6 control box test
Step Pictures | Setup Test, Power on system

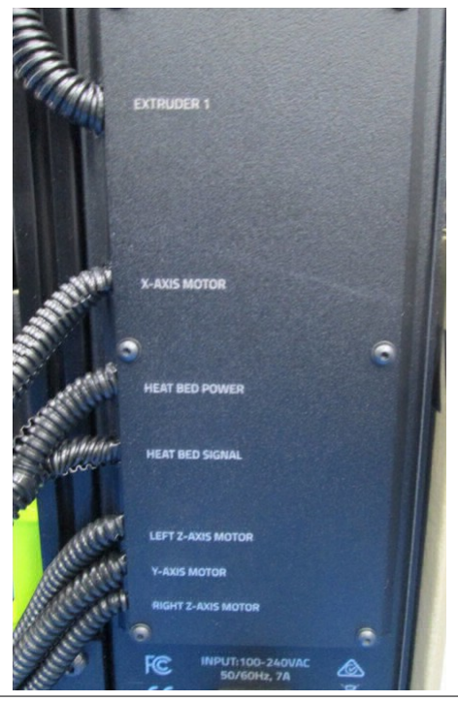
[picture p487: figure]
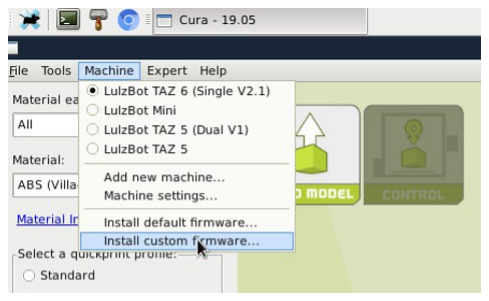
[picture p488: figure]

Select install custom firmware.

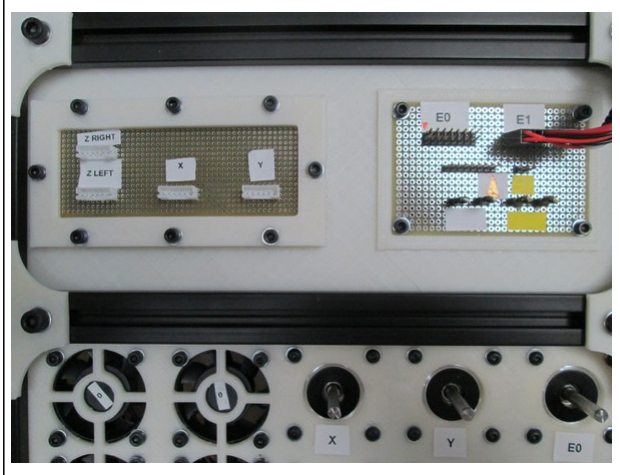
[picture p489: figure]
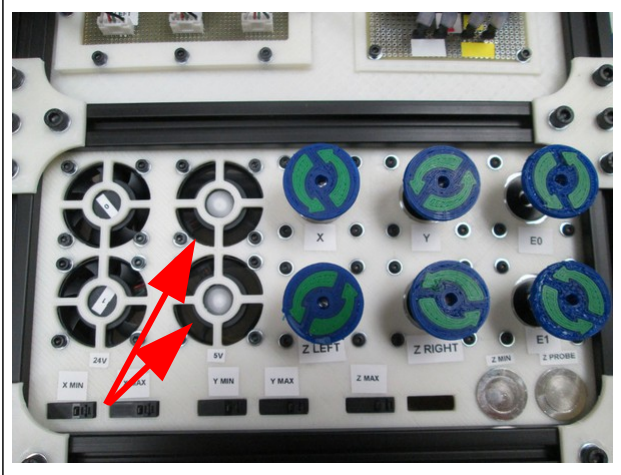
[picture p490: figure]

Plug in cables accordingly | The 5V fans should both be spinning.

TAZ 6 control box test
Step Pictures | Test X Min, X Max, Motors

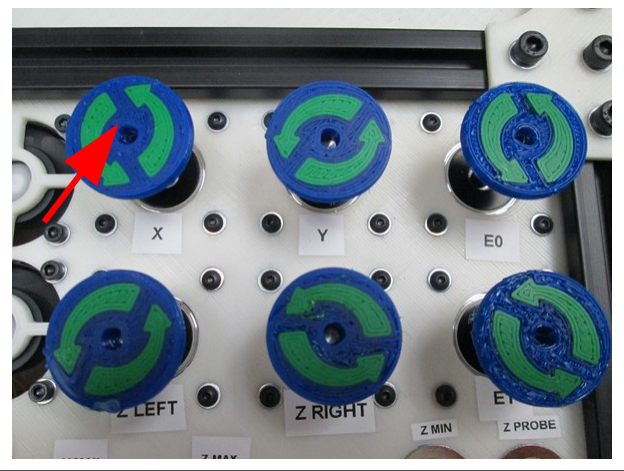
[picture p491: figure]
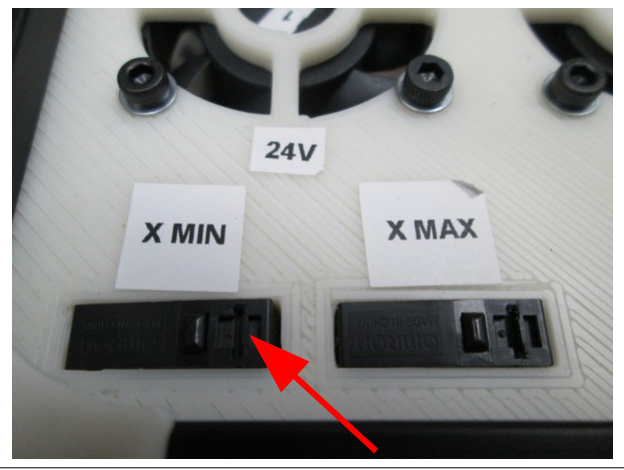
[picture p492: figure]

X spins direction of arrows | Press X min

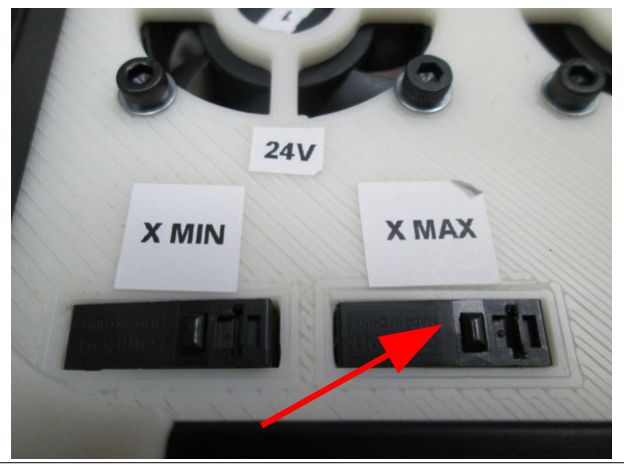
[picture p493: figure]
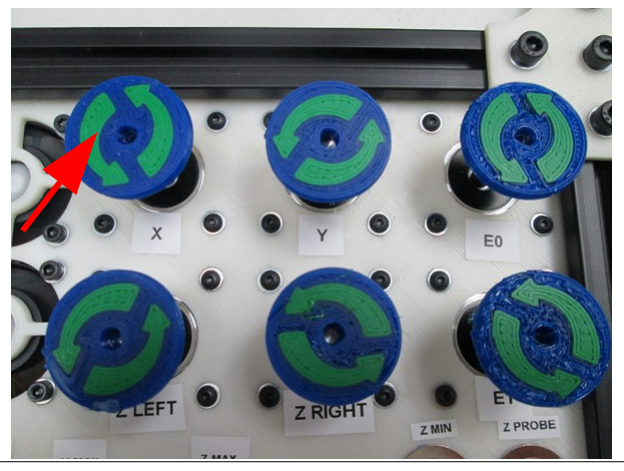
[picture p494: figure]

X motor reverses rotation direction | Press X max

!WARNING! The firmware and g-code for this test fixture are intended to be used on the test fixture only. DO NOT use the firmware or g-code on a completed TAZ 6 or damage will result!

Flash the control box with control box test firmware found here (http://devel.lulzbot.com/TAZ/nutmeg/production_parts/jigs/control_box_test_fixture/marlin/Marlin/Marlin_TAZ6_control_box_test_fixture.hex) by using CURA. In CURA go to machine settings and select install custom firmware. Select the hex file found at the
link above. You will need to have this file saved locally, and may need to rename it as a .hex file after download, if you cannot download, then copy all text to a text editor and save as a .hex file. Turn on the control box, select the file and flash. Wait for CURA to show flash successful. Turn off control box and disconnect.

Plug the control box cables into the test fixture accordingly. And switch on the control box. Verify the firmware at the splash screen. The 5V fans should both be spinning and will remaining spinning throughout the test.

Insert an SD card containing the test G-code (http://devel.lulzbot.com/TAZ/nutmeg/production_parts/jigs/control_box_test_fixture/TAZ6_control_box_test_0.3.gcode) into the SD card reader. You will need to paste this file in a text editor and save as a .gcode file.

Press the encoder (control knob) located on the control box front near the display and and scroll to “Print from SD”; Select
“TAZ6_control_box_test_0.3.gcode”

The cables are labeled on the back of the box

The test begins with the X motor beginning to spin to the left (Counter Clockwise or CCW).

The display will indicate “PUSH THE X MIN SWITCH”; Locate and Press the “X Min” switch on the test fixture; the X motor will start to turn right (Clockwise or CW);

The display will indicate “PUSH X MAX SWITCH”;

Locate and Press the “X MAX” switch on the test fixture; the X motor will stop spinning and the Y motor will start to turn left;

Press the X max switch (move to the next step)

Step Pictures | Test Y Min, Y Max, Motors
Y spins direction of arrows | Press Y min

Press Y max

TAZ 6 control box test
Step Pictures | Test Z Min, Z Max, Motors

Press Z min

Press Z max

The Y motor should be turning to the left.

The display will indicate “PUSH THE Y MIN SWITCH”; Locate and Press the “Y MIN” switch on the test fixture; the X motor will start to turn right;

The display will indicate “PUSH Y MAX SWITCH”; Locate and Press the “Y MAX” switch on the test fixture; the Y motor will stop spinning and the Z motors will start to turn left;

Y spins opposite the direction of arrows

The Z motors should both be turning to the left.

The display will indicate “PUSH THE Z MIN BUTTON”; Locate and Press the “Z MIN” button on the test fixture; the Z motors will start to turn right;

The display will indicate “PUSH Z MAX SWITCH”; Locate and Press the “Z MAX” switch on the test fixture; the Z motors will stop spinning;

Z left and right spin the direction of arrows

Z left and right spin opposite the direction of arrows

Step Pictures | Test E0 motor (via Z probe)
E0 spins direction of arrows | Press Z probe

Press Z probe

TAZ 6 control box test
Step Pictures | Test E1 motor
E1 spins direction of arrows | Press Z probe

Press Z probe

The display will indicate “PUSH THE Z PROBE BUTTON”; Locate and Press the “Z PROBE” button on the test fixture; the E0 motor will briefly turn to the Left;

The display will indicate “PUSH THE Z PROBE BUTTON”; Locate and Press the “Z PROBE” button on the test fixture; the E0 motor will briefly turn to the Right;

E0 spins opposite the direction of arrows Press Z probe

The display will indicate “PUSH THE Z PROBE BUTTON”; Locate and Press the “Z PROBE” button on the test fixture; the E1 motor will briefly turn to the Left;

The display will indicate “PUSH THE Z PROBE BUTTON”; Locate and Press the “Z PROBE” button on the test fixture; the E1 motor will briefly turn to the Right;

E1 spins opposite the direction of arrows Press Z probe

Step Pictures | Test 24VDC fan functionality

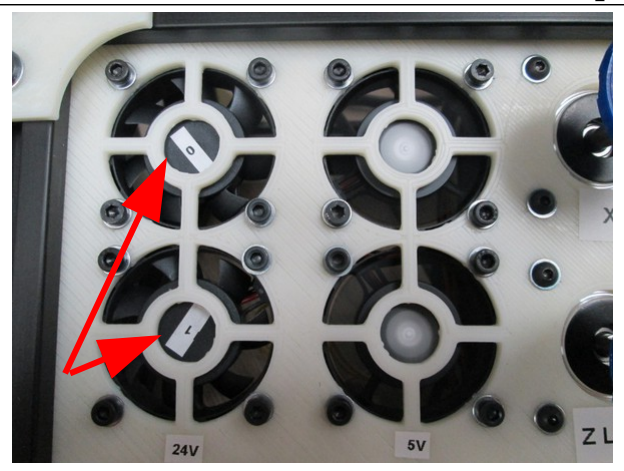
[picture p495: figure]
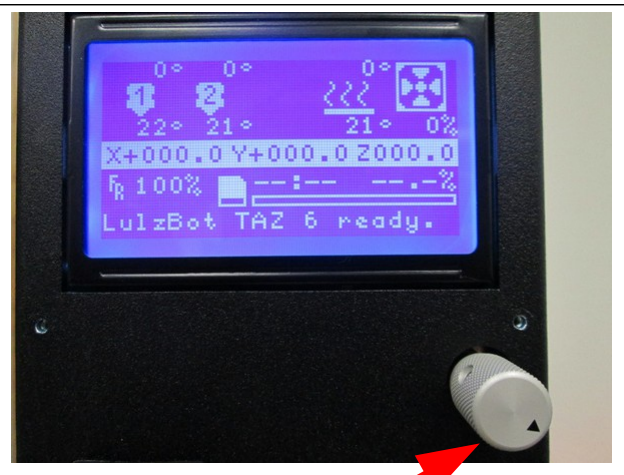
[picture p496: figure]

Verify 24V fans spin at 40% and 100% Press encoder

The 24VDC fans will immediately begin to turn;

The display will indicate “FANS 40 PERCENT”; verify that both 24V fans are spinning at medium speed for approximately 10 seconds;

The fans will start to spin at a high speed for approximately 10 seconds and the display will indicate “FANS 100 PERCENT”; verify both fans have a high spin rate;

The fans will turn off and the display will indicate “PRESS ENCODER”; Locate and Press the encoder on the unit under test, there will be a beep from the control box signaling the test has been completed and was successful. The display will now indicate “Test successful!!!”

Press encoder

After the test was run successfully turn off the control box. When the control box is turned back on the the Splash screen should display “Test Successful!!!” and the display should indicate “Test Successful!!!” this is stored in the EPROM to ensure the box was tested successfully and will be erased when the control box is flashed with the latest TAZ6 firmware.
