gralco/TAZ6/sample_prints/benchmarks/index.html

# Index of /TAZ/Olive/sample_prints/benchmarks

(ICO) | Name | Last modified | Size | Description
(PARENTDIR) | Parent Directory | | -
(DIR) | 3Dbenchy/ | 2016-09-16 21:57 | -
(DIR) | make_2015_tests/ | 2016-09-16 21:57 | -
(DIR) | make_torture_test/ | 2016-09-16 21:57 | -
(DIR) | marvin_keychain/ | 2016-09-16 21:57 | -
