gralco/TAZ6/production_parts/electronics/RAMBo/board/History/index.html

# Index of /TAZ/Olive/production_parts/electronics/RAMBo/board/History

(ICO) | Name (https://devel.lulzbot.com/TAZ/Olive/production_parts/electronics/RAMBo/board/History/?C=N;O=D) | Last modified (https://devel.lulzbot.com/TAZ/Olive/production_parts/electronics/RAMBo/board/History/?C=M;O=A) | Size (https://devel.lulzbot.com/TAZ/Olive/production_parts/electronics/RAMBo/board/History/?C=S;O=A) | Description (https://devel.lulzbot.com/TAZ/Olive/production_parts/electronics/RAMBo/board/History/?C=D;O=A)
(PARENTDIR) | Parent Directory | | -
( ) | RAMBo.brd (https://devel.lulzbot.com/TAZ/Olive/production_parts/electronics/RAMBo/board/History/RAMBo.brd) | 2017-02-20 23:40 | 968K
( ) | RAMBo.sch (https://devel.lulzbot.com/TAZ/Olive/production_parts/electronics/RAMBo/board/History/RAMBo.sch) | 2017-02-20 23:40 | 3.9M
