gralco/TAZ6/production_parts/electronics/TAZ6_Wiring.pdf

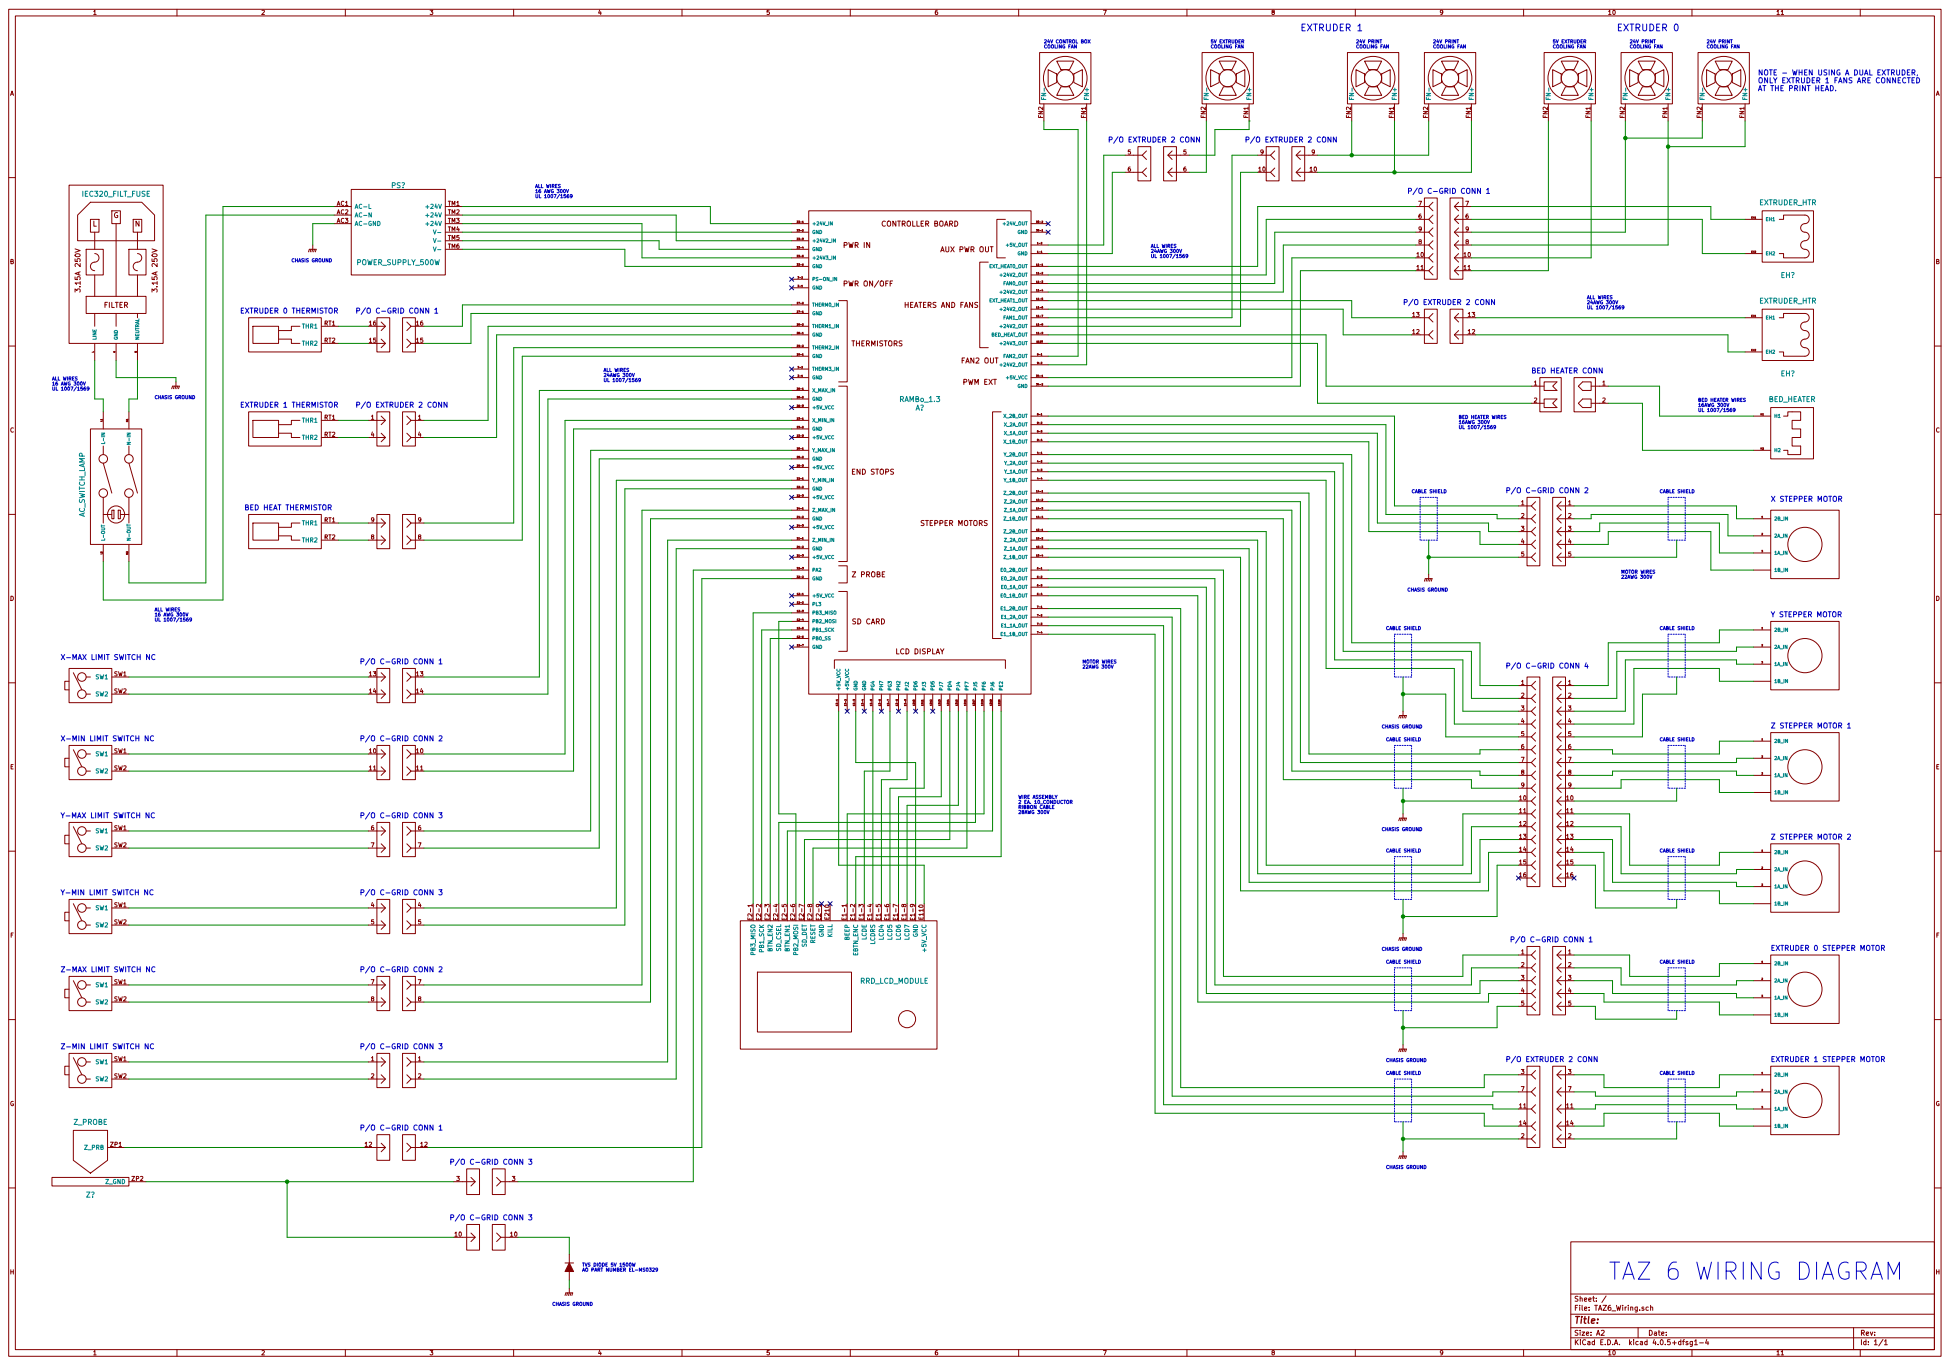
[picture p497: page 1]

24V CONTROL BOX COOLING FAN

NOTE - WHEN USING A DUAL EXTRUDER,
ONLY EXTRUDER 1 FANS ARE CONNECTED
AT THE PRINT HEAD.

N IEC320_FILT_FUSE L-IN L1 N-IN N1 L-OUT L2 N-OUT N2 AC_SWITCH_LAMP
FILTER G

PWM EXT PWR IN

X-MIN LIMIT SWITCH NC

Y-MAX LIMIT SWITCH NC

Y-MIN LIMIT SWITCH NC

Z-MAX LIMIT SWITCH NC

Z-MIN LIMIT SWITCH NC
