gralco/TAZ6/documentation/guide/PDFs_for_print/TAZ_6_QSG_Operation_COVER_FINAL.pdf

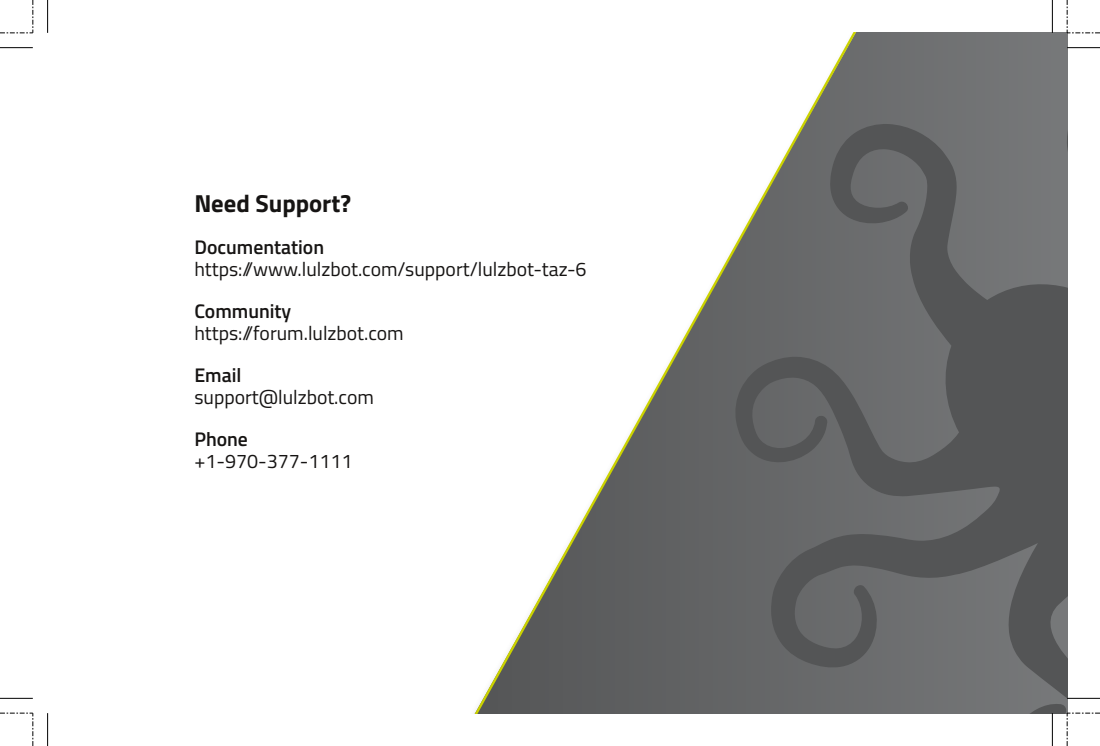
[picture p498: page 1]
Need Support?; Phone +1-970-377-1111

Documentation
https:/www.lulzbot.com/support/lulzbot-taz-6

Community
https:/ forum.lulzbot.com

Email
support@lulzbot.com

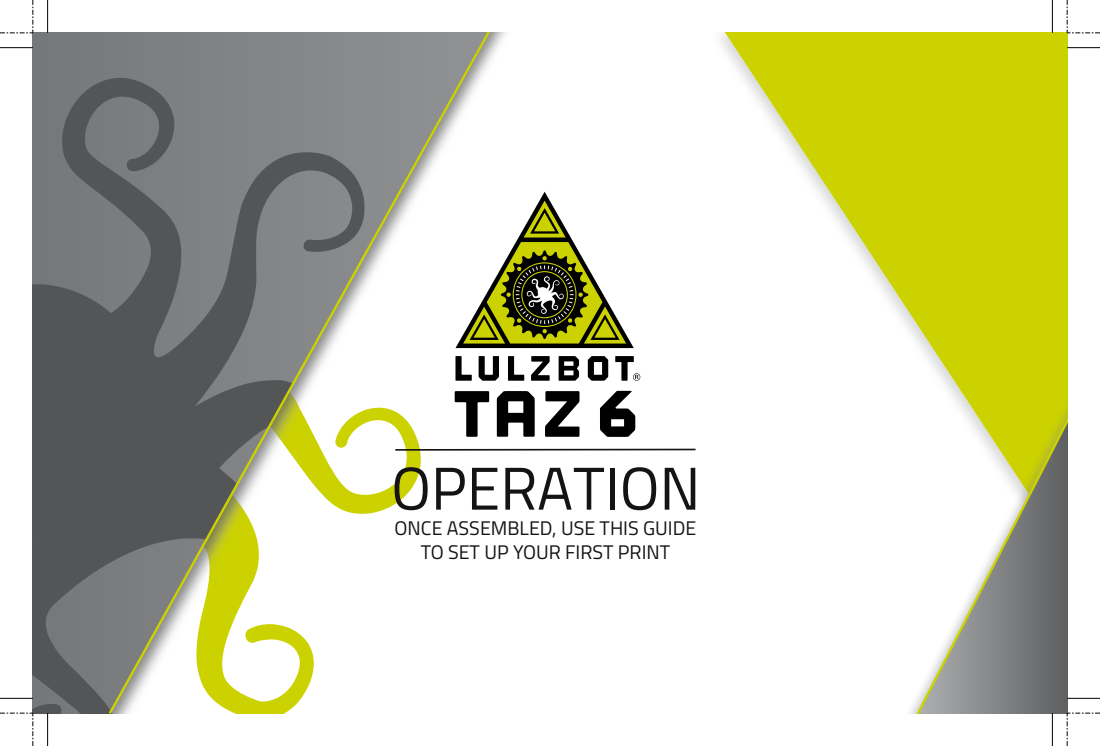
[picture p499: page 2]
OPERATION

ONCE ASSEMBLED, USE THIS GUIDE
TO SET UP YOUR FIRST PRINT
