gralco/TAZ6/production_parts/machined_parts/0.5mm_hotend_assembly_single_v2/0.5mm_hotend_assem_single_v2.pdf

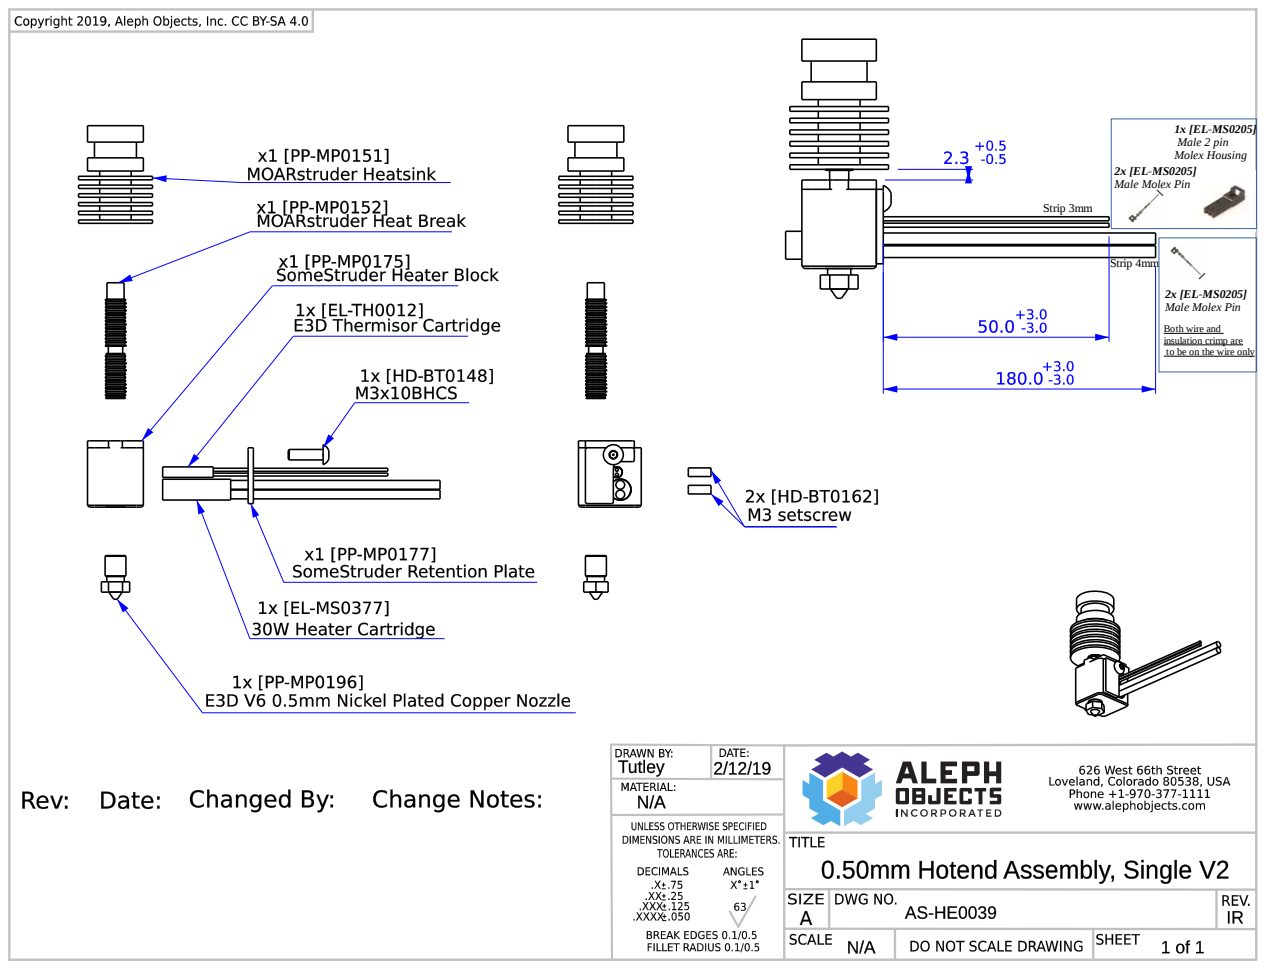
[picture p500: page 1]
Strip 3mm; Strip 4mm; 1x [EL-MS0205] Male 2 pin Molex Housing

Male Molex Pin

Both wire and
insulation crimp are
to be on the wire only
