gralco/TAZ6/production_parts/machined_parts/lulzbot_edition_hexagon_hotend-0.5mm/PP-MP0084-X-X.PDF

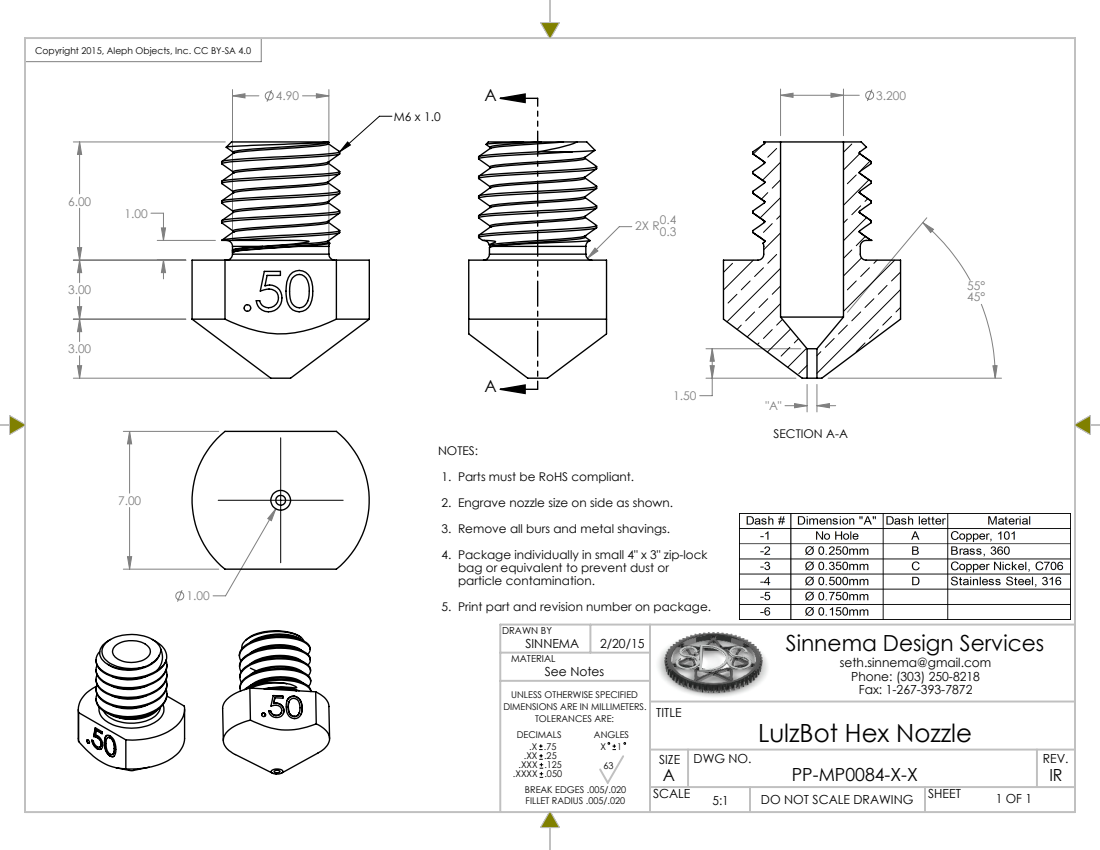
[picture p501: page 1]
SECTION A-A; See Notes; DRAWN BY; SCALE; 1 OF 1 SHEET; DWG NO.; REV.

Copyright 2015, Aleph Objects, Inc. CC BY-SA 4.0

NOTES:
1. Parts must be RoHS compliant.
2. Engrave nozzle size on side as shown.
3. Remove all burs and metal shavings.
4. Package individually in small 4" x 3" zip-lock
bag or equivalent to prevent dust or
particle contamination.
5. Print part and revision number on package.

Sinnema Design Services

seth.sinnema@gmail.com
Phone: (303) 250-8218
Fax: 1-267-393-7872
LulzBot Hex Nozzle
DO NOT SCALE DRAWING

UNLESS OTHERWISE SPECIFIED
DIMENSIONS ARE IN MILLIMETERS.
TOLERANCES ARE:
DECIMALS
.XXX .125
.XXXX .050
BREAK EDGES .005/.020
FILLET RADIUS .005/.020
