gralco/TAZ6/production_parts/electronics/RAMBo/past/SMPSWebenchReportsServlet0-2j.pdf

## WEBENCH ® Design Report

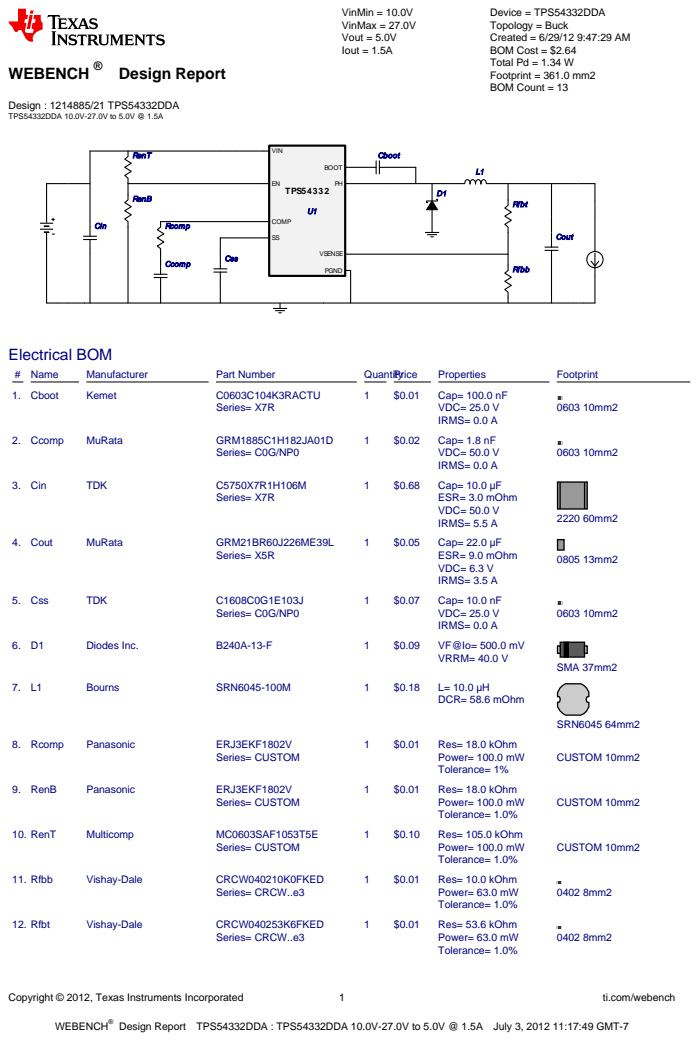
[picture p502: page 1]
Copyright © 2012, Texas Instruments Incorporated; ti.com/webench; WEBENCH®; Design : 1214885/21 TPS54332DDA TPS54332DDA 10.0V-27.0V to 5.0V @ 1.5A; VinMin = 10.0V VinMax = 27.0V Vout = 5.0V Iout = 1.5A; Device = TPS54332DDA Topology = Buck Created = 6/29/12 9:47:29 AM BOM Cost = $2.64 Total Pd = 1.34 W Footprint = 361.0 mm2 BOM Count = 13; Cboot; Ccomp; Cin; Cout; Css; Rcomp; RenB; RenT; Rfbb; Rfbt; TPS54332; VIN; COMP; BOOT; VSENSE; PGND; Electrical BOM; # Name; Manufacturer; Part Number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

Design Report TPS54332DDA : TPS54332DDA 10.0V-27.0V to 5.0V @ 1.5A July 3, 2012 11:17:49 GMT-7

WEBENCH®
Design
Copyright © 2012, Texas Instruments Incorporated | 2 | ti.com/webench

WEBENCH®
Design Report TPS54332DDA : TPS54332DDA 10.0V-27.0V to 5.0V @ 1.5A July 3, 2012 11:17:49 GMT-7
# Name | Manufacturer | Part Number | QuantityPrice | Properties | Footprint

13. U1 | Texas Instruments | TPS54332DDA (http://www.ti.com/product/tps54332) | 1 | $1.40 | Switcher
MPDS092E 57mm2

## Operating Values

# | Name | Value | Category | Description

1. BOM Count | 13.0 | Total Design BOM count
2. Total BOM | $2.641 | Total BOM Cost
3. Cin IRMS | 461.896 m A | Current | Input capacitor RMS ripple current
4. Cout IRMS | 127.31 m A | Current | Output capacitor RMS ripple current
5. IC Ipk | 1.721 A | Current | Peak switch current in IC
6. Iin Avg | 327.57 m A | Current | Average input current
7. L Ipp | 441.015 m A | Current | Peak-to-peak inductor ripple current
8. M1 Irms | 671.593 m A | Current | Q Iavg
9. FootPrint | 361.0 mm2 | General | Total Foot Print Area of BOM components
10. Frequency | 1000.0 k Hz | General | Switching frequency
11. IC Tolerance | 28.0 m V | General | IC Feedback Tolerance
12. M Vds Act | 63.268 m V | General | Voltage drop across the MosFET
13. Mode | CCM | General | Conduction Mode
14. Pout | 7.5 W | General | Total output power
15. D1 Tj | 44.991 degC | Op_Point | D1 junction temperature
16. Vout OP | 5.0 V | Op_Point | Operational Output Voltage
17. Cross Freq | 61.073 k Hz | Op_point | Bode plot crossover frequency
18. Duty Cycle | 20.046 % | Op_point | Duty cycle
19. Efficiency | 84.799 % | Op_point | Steady state efficiency
20. IC Tj | 59.948 degC | Op_point | IC junction temperature
21. ICThetaJA | 50.0 degC/W | Op_point | IC junction-to-ambient thermal resistance
22. IOUT_OP | 1.5 A | Op_point | Iout operating point
23. Phase Marg | 101.888 deg | Op_point | Bode Plot Phase Margin
24. VIN_OP | 27.0 V | Op_point | Vin operating point
25. Vout p-p | 7.783 m V | Op_point | Peak-to-peak output ripple voltage
26. Cin Pd | 640.043 µ W | Power | Input capacitor power dissipation
27. Cout Pd | 145.87 µ W | Power | Output capacitor power dissipation
28. Diode Pd | 599.654 m W | Power | Diode power dissipation
29. IC Pd | 598.96 m W | Power | IC power dissipation
30. L Pd | 145.035 m W | Power | Inductor power dissipation
31. Total Pd | 1.344 W | Power | Total Power Dissipation

## Design Inputs

# | Name | Value | Description

1. Iout | 1.5 A | Maximum Output Current
2. Iout1 | 1.5 Amps | Output Current #1
3. VinMax | 27.0 V | Maximum input voltage
4. VinMin | 10.0 V | Minimum input voltage
5. Vout | 5.0 V | Output Voltage
6. Vout1 | 5.0 Volt | Output Voltage #1
7. base_pn | TPS54332 | Texas Instruments base part number
8. Ta | 30.0 degC | Ambient temperature

## Design Assistance

1. TPS54332 Product Folder : http://www.ti.com/product/tps54332 : contains the data sheet and other resources.

Texas Instruments' WEBENCH simulation tools attempt to recreate the performance of a substantially equivalent physical implementation
of the design. Simulations are created using Texas Instruments' published specifications as well as the published specifications of other device manufacturers. While Texas Instruments does update this information periodically, this information may not be current at the time the simulation is built. Texas Instruments does not warrant the accuracy or completeness of the specifications or any information contained therein. Texas Instruments does not warrant that any designs or recommended parts will meet the specifications you entered, will be suitable for your application or fit for any particular purpose, or will operate as shown in the simulation in a physical implementation. Texas Instruments does not warrant that the designs are production worthy.
You should completely validate and test your design implementation to confirm the system functionality for your application prior to production.
Use of Texas Instruments' WEBENCH simulation tools is subject to Texas Instruments' Site Terms and Conditions of Use. (http://www.ti.com/corp/docs/legal/termsofuse.shtml) Prototype boards based on WEBENCH created designs are provided AS IS without warranty of any kind for evaluation and testing purposes and are subject to the terms of the Evaluation License Agreement. (http://www.ti.com/corp/docs/legal/termsofuse_estore.shtml)
