gralco/TAZ6/production_parts/electronics/Wire_Harnesses/Internal_Cable_Harnesses/AS-CB0068_TAZ6_CB_LCD_Harness_V2.pdf

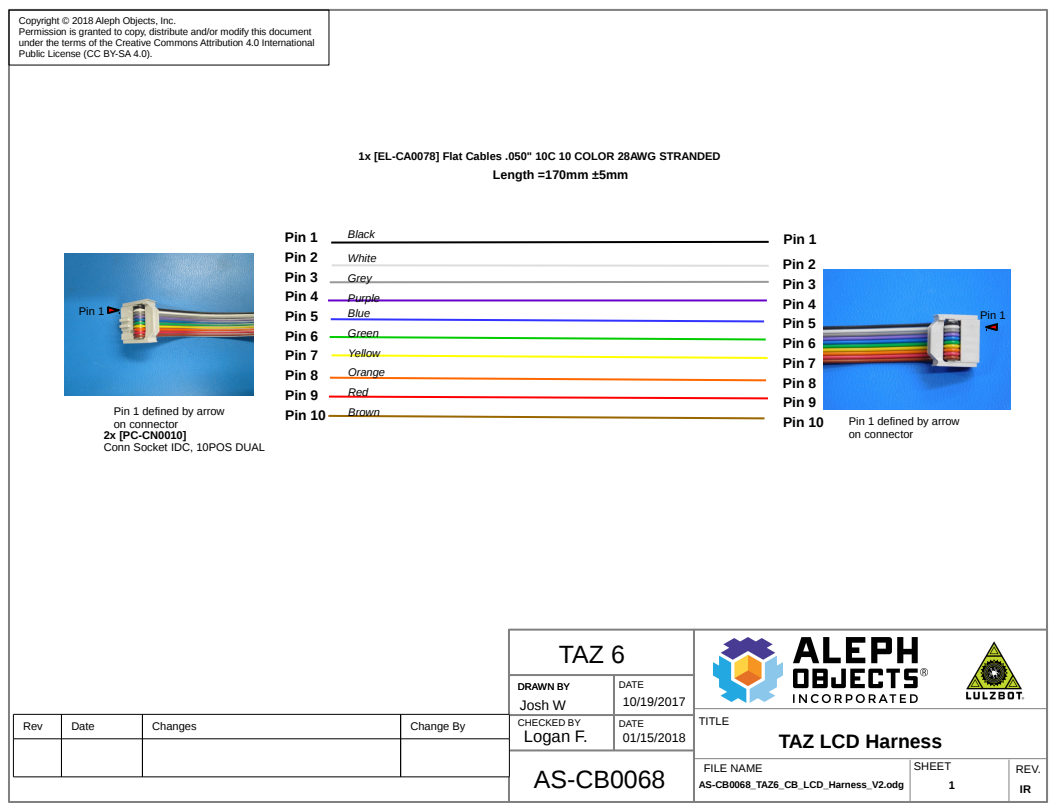
[picture p503: page 1]
TITLE; FILE NAME; SHEET; REV.; IR AS-CB0068_TAZ6_CB_LCD_Harness_V2.odg; Length =170mm ±5mm; Pin 1 Pin 2 Pin 3 Pin 4 Pin 5 Pin 6 Pin 7 Pin 8 Pin 9 Pin 10; Black; White; Grey; Purple Blue; Green; Yellow; Orange; Red; Brown; Pin 1; Pin 2 Pin 3 Pin 4 Pin 5 Pin 6 Pin 7 Pin 8 Pin 9 Pin 10; on connector; Pin 1 defined by arrow

Copyright © 2018 Aleph Objects, Inc.
Permission is granted to copy, distribute and/or modify this document
under the terms of the Creative Commons Attribution 4.0 International
Public License (CC BY-SA 4.0).

1x [EL-CA0078] Flat Cables .050" 10C 10 COLOR 28AWG STRANDED

Pin 1 defined by arrow
Conn Socket IDC, 10POS DUAL

TAZ 6

DRAWN BY DRAWN BY Josh W | DATE 10/19/2017

Rev | Date | Changes | Change By | CHECKED BY Logan F. | DATE 01/15/2018

TAZ LCD Harness
