gralco/TAZ6/production_parts/electronics/Wire_Harnesses/Internal_Cable_Harnesses/TAZ6_CB_Bed_Harness_revC.pdf

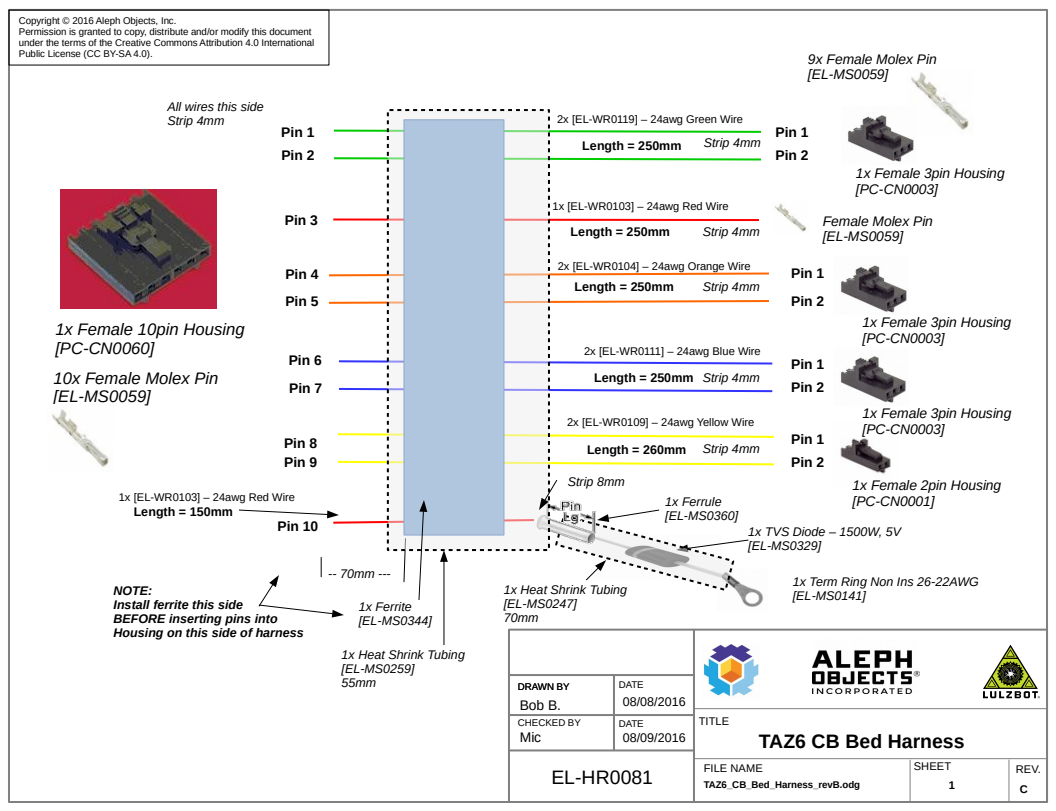
[picture p504: page 1]
FILE NAME; SHEET; REV.; TAZ6_CB_Bed_Harness_revB.odg; Pin 8 Pin 9; Pin 2; Pin 1; 1x Ferrite [EL-MS0344]; 1x Heat Shrink Tubing [EL-MS0259] 55mm; Pin 10; Strip 8mm; Length = 260mm; 1x Female 3pin Housing [PC-CN0003]; Length = 250mm; Strip 4mm; Pin 3; Pin 7; Pin 5; 1x Female 2pin Housing [PC-CN0001]; 1x Ferrule [EL-MS0360]; 1x TVS Diode – 1500W, 5V [EL-MS0329]; 1x Heat Shrink Tubing [EL-MS0247] 70mm

Copyright © 2016 Aleph Objects, Inc.
Permission is granted to copy, distribute and/or modify this document
under the terms of the Creative Commons Attribution 4.0 International
Public License (CC BY-SA 4.0).

9x Female Molex Pin

All wires this side
Strip 4mm

2x [EL-WR0119] – 24awg Green Wire

1x [EL-WR0103] – 24awg Red Wire

Female Molex Pin

2x [EL-WR0104] – 24awg Orange Wire Pin 4

1x Female 10pin Housing
10x Female Molex Pin

2x [EL-WR0111] – 24awg Blue Wire Pin 6

2x [EL-WR0109] – 24awg Yellow Wire

Length = 150mm

1x Term Ring Non Ins 26-22AWG

NOTE:
Install ferrite this side
BEFORE inserting pins into
Housing on this side of harness

DRAWN BY DRAWN BY Bob B. | DATE 08/08/2016

TITLE
TAZ6 CB Bed Harness

CHECKED BY Mic | DATE 08/09/2016
