gralco/TAZ6/production_parts/electronics/Wire_Harnesses/Internal_Cable_Harnesses/TAZ6_CB_Extruder_Harness_revE.pdf

`

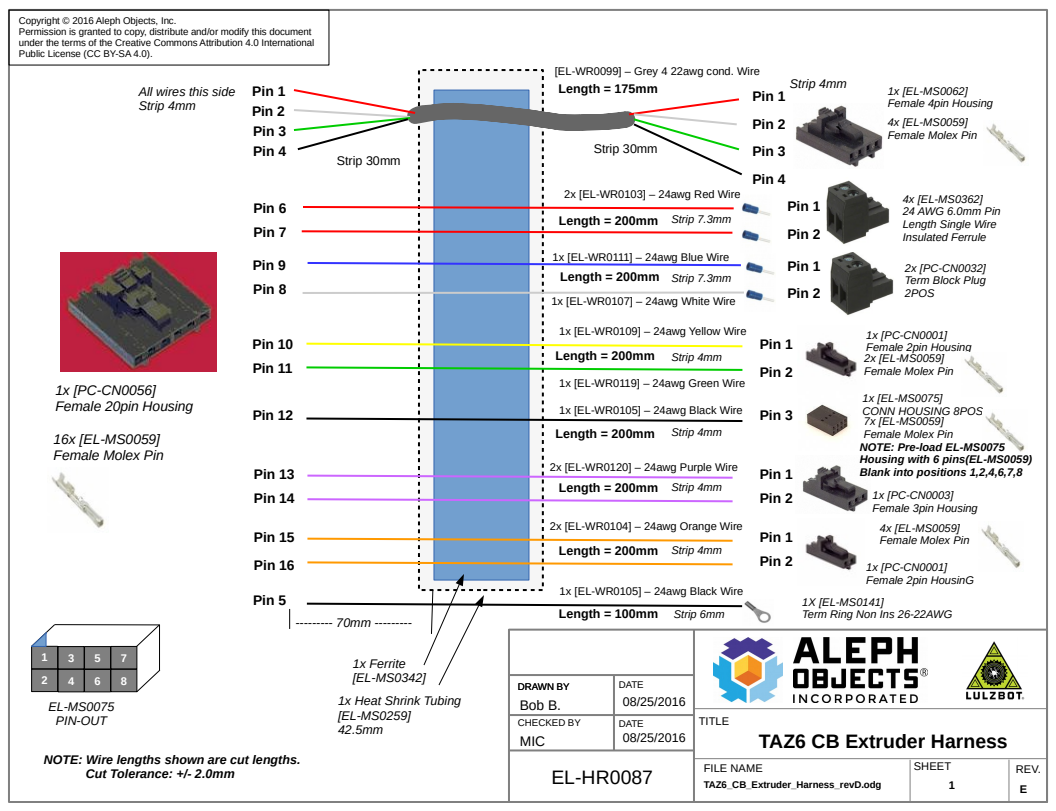
[picture p505: page 1]
FILE NAME; SHEET; REV.; TAZ6_CB_Extruder_Harness_revD.odg; Pin 10; Pin 12; 1x [PC-CN0056] Female 20pin Housing; Pin 3; Pin 1; 1x Ferrite [EL-MS0342]; 1x Heat Shrink Tubing [EL-MS0259] 42.5mm; Pin 6; Pin 8; Pin 15; Pin 16; Pin 2; Strip 4mm; Pin 1 Pin 2 Pin 3 Pin 4; Strip 30mm; Pin 7; Pin 9; Pin 11; Pin 14; Length = 200mm; Pin 5; 1x [EL-WR0105] – 24awg Black Wire; Length = 100mm; Strip 6mm; Pin 4; 2x [PC-CN0032] Term Block Plug 2POS; 1x [PC-CN0001] Female 2pin HousinG; Cut Tolerance: +/- 2.0mm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

[EL-WR0099] – Grey 4 22awg cond. Wire
Length = 175mm

All wires this side
Strip 4mm

Female 4pin Housing
Female Molex Pin

2x [EL-WR0103] – 24awg Red Wire
Length = 200mm Strip 7.3mm

24 AWG 6.0mm Pin
Length Single Wire
Insulated Ferrule

1x [EL-WR0111] – 24awg Blue Wire

1x [EL-WR0107] – 24awg White Wire

1x [EL-WR0109] – 24awg Yellow Wire
Length = 200mm

Female 2pin Housing

1x [EL-WR0119] – 24awg Green Wire

CONN HOUSING 8POS
NOTE: Pre-load EL-MS0075
Housing with 6 pins(EL-MS0059)
Blank into positions 1,2,4,6,7,8
Female 3pin Housing

1x [EL-WR0105] – 24awg Black Wire
Length = 200mm Strip 4mm

2x [EL-WR0120] – 24awg Purple Wire Pin 13

2x [EL-WR0104] – 24awg Orange Wire

Term Ring Non Ins 26-22AWG

DRAWN BY DRAWN BY Bob B. | DATE 08/25/2016

TITLE
TAZ6 CB Extruder Harness

CHECKED BY MIC | DATE 08/25/2016

NOTE: Wire lengths shown are cut lengths.
