gralco/TAZ6/production_parts/electronics/Wire_Harnesses/Internal_Cable_Harnesses/TAZ6_CB_X-Harness_revC.pdf

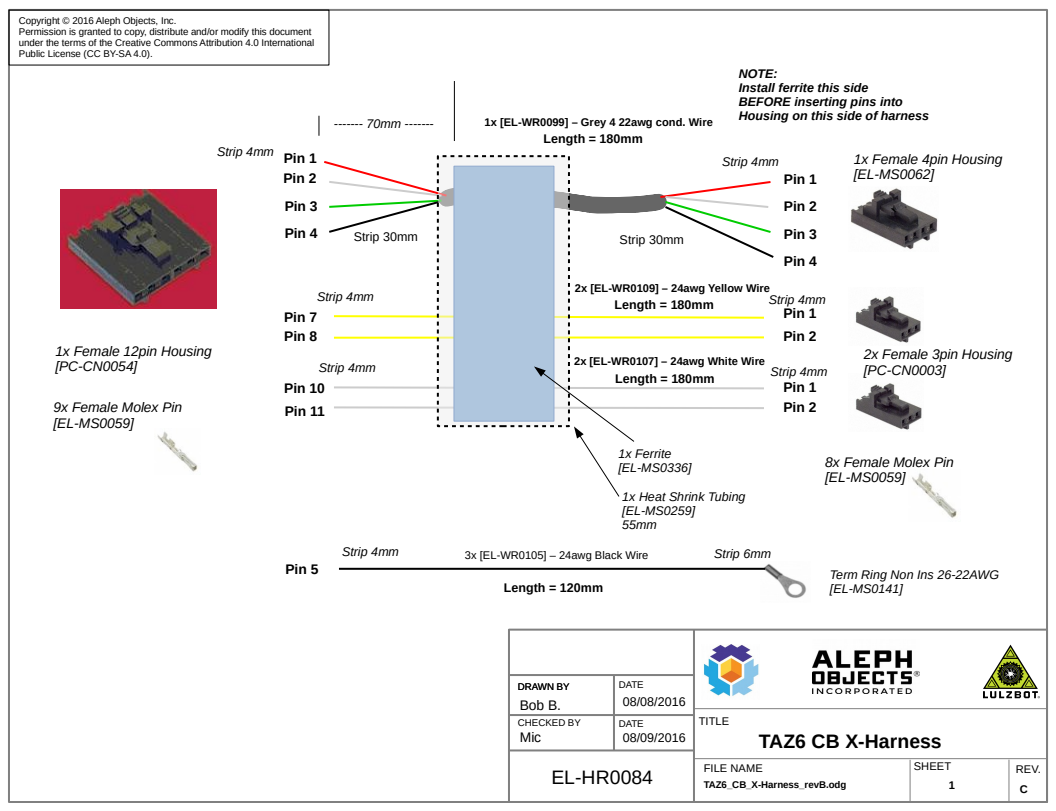
[picture p506: page 1]
TITLE; FILE NAME; SHEET; REV.; TAZ6 CB X-Harness; TAZ6_CB_X-Harness_revB.odg; Length = 180mm; Pin 1 Pin 2; Pin 3; Pin 4; 1x Female 4pin Housing [EL-MS0062]; Strip 4mm; Pin 7 Pin 8; Pin 10; Pin 11; Pin 2; Pin 1; 1x Female 12pin Housing [PC-CN0054]; Strip 30mm; 1x Ferrite [EL-MS0336]; 1x Heat Shrink Tubing [EL-MS0259] 55mm; Length = 120mm; Pin 5; 2x Female 3pin Housing [PC-CN0003]; Strip 6mm

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

NOTE:
Install ferrite this side
BEFORE inserting pins into
Housing on this side of harness

1x [EL-WR0099] – Grey 4 22awg cond. Wire

2x [EL-WR0109] – 24awg Yellow Wire
Length = 180mm

2x [EL-WR0107] – 24awg White Wire

9x Female Molex Pin

8x Female Molex Pin

3x [EL-WR0105] – 24awg Black Wire

Term Ring Non Ins 26-22AWG

DRAWN BY DRAWN BY Bob B. | DATE 08/08/2016

CHECKED BY Mic | DATE 08/09/2016
