gralco/TAZ6/production_parts/electronics/Wire_Harnesses/Internal_Cable_Harnesses/TAZ6_CB_Y-Z_Harness_revD.pdf

`

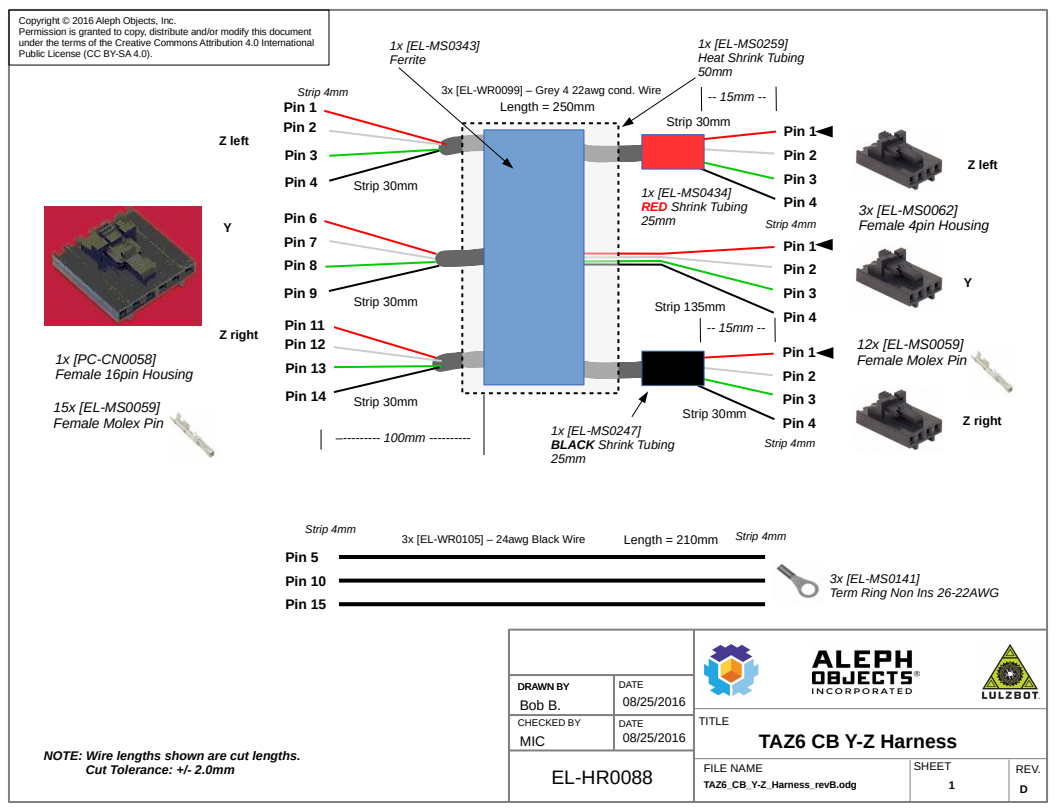
[picture p507: page 1]
TITLE; FILE NAME; SHEET; REV.; TAZ6 CB Y-Z Harness; TAZ6_CB_Y-Z_Harness_revB.odg; Pin 1; Length = 250mm; Pin 2; Pin 3; Pin 4; Pin 6; Strip 4mm; Female 4pin Housing; Pin 7; Pin 8; Pin 9; Pin 11 Pin 12; Pin 13; Pin 14; 1x [PC-CN0058] Female 16pin Housing; Strip 30mm; 1x [EL-MS0343] Ferrite; 1x [EL-MS0259] Heat Shrink Tubing 50mm; 3x [EL-WR0105] – 24awg Black Wire; Length = 210mm; Pin 5; Pin 10; Pin 15; Strip 135mm; Z left; Z right; Cut Tolerance: +/- 2.0mm; 1x [EL-MS0434] RED Shrink Tubing 25mm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

3x [EL-WR0099] – Grey 4 22awg cond. Wire

Female Molex Pin

Term Ring Non Ins 26-22AWG

DRAWN BY DRAWN BY Bob B. | DATE 08/25/2016

CHECKED BY MIC | DATE 08/25/2016

NOTE: Wire lengths shown are cut lengths.
