gralco/TAZ6/production_parts/machined_parts/10_12_mm_smooth_rods/12mmx515_rod_v1.0_revA.pdf

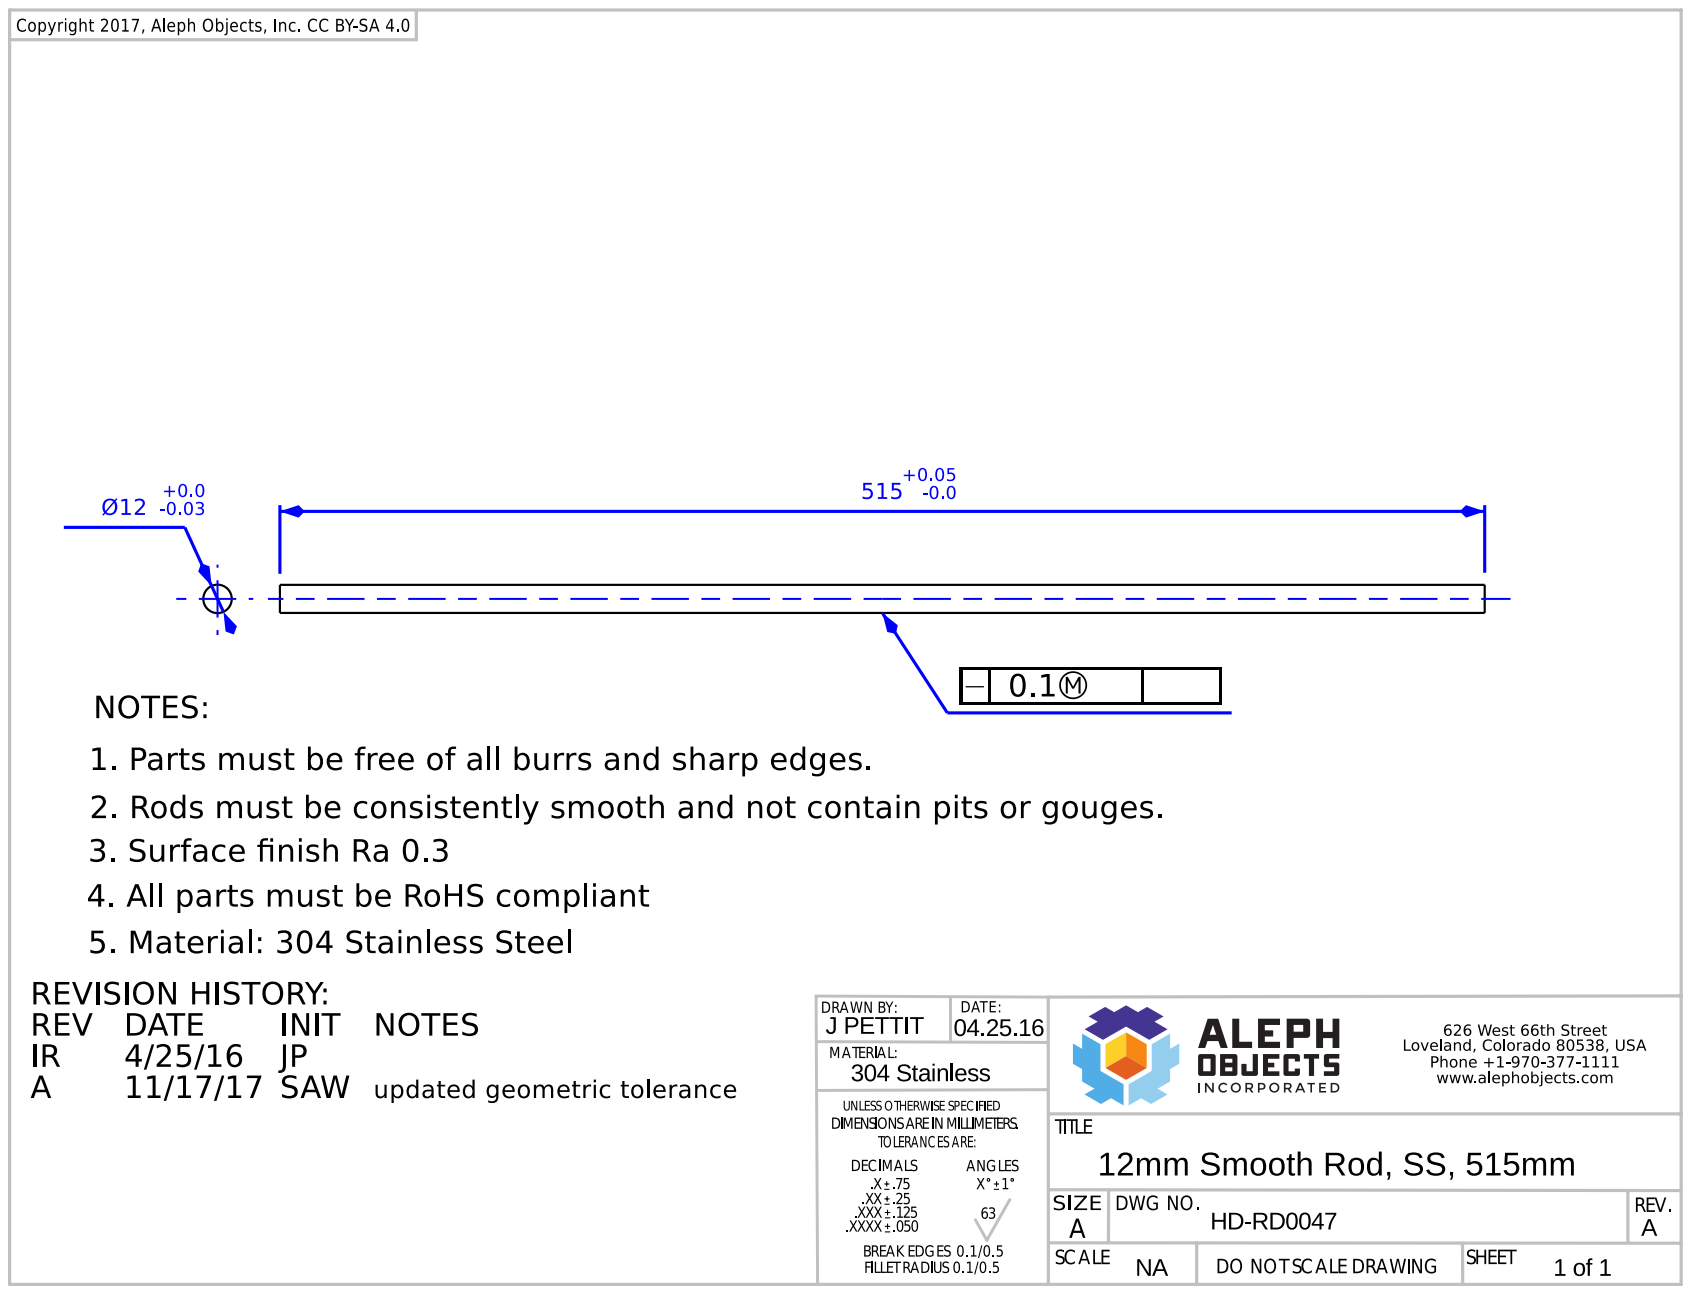
[picture p508: page 1]
