gralco/TAZ6/production_parts/machined_parts/bed_plate_v5.0/300mm_bed_plate_6061_PP-FP0146_revA.pdf

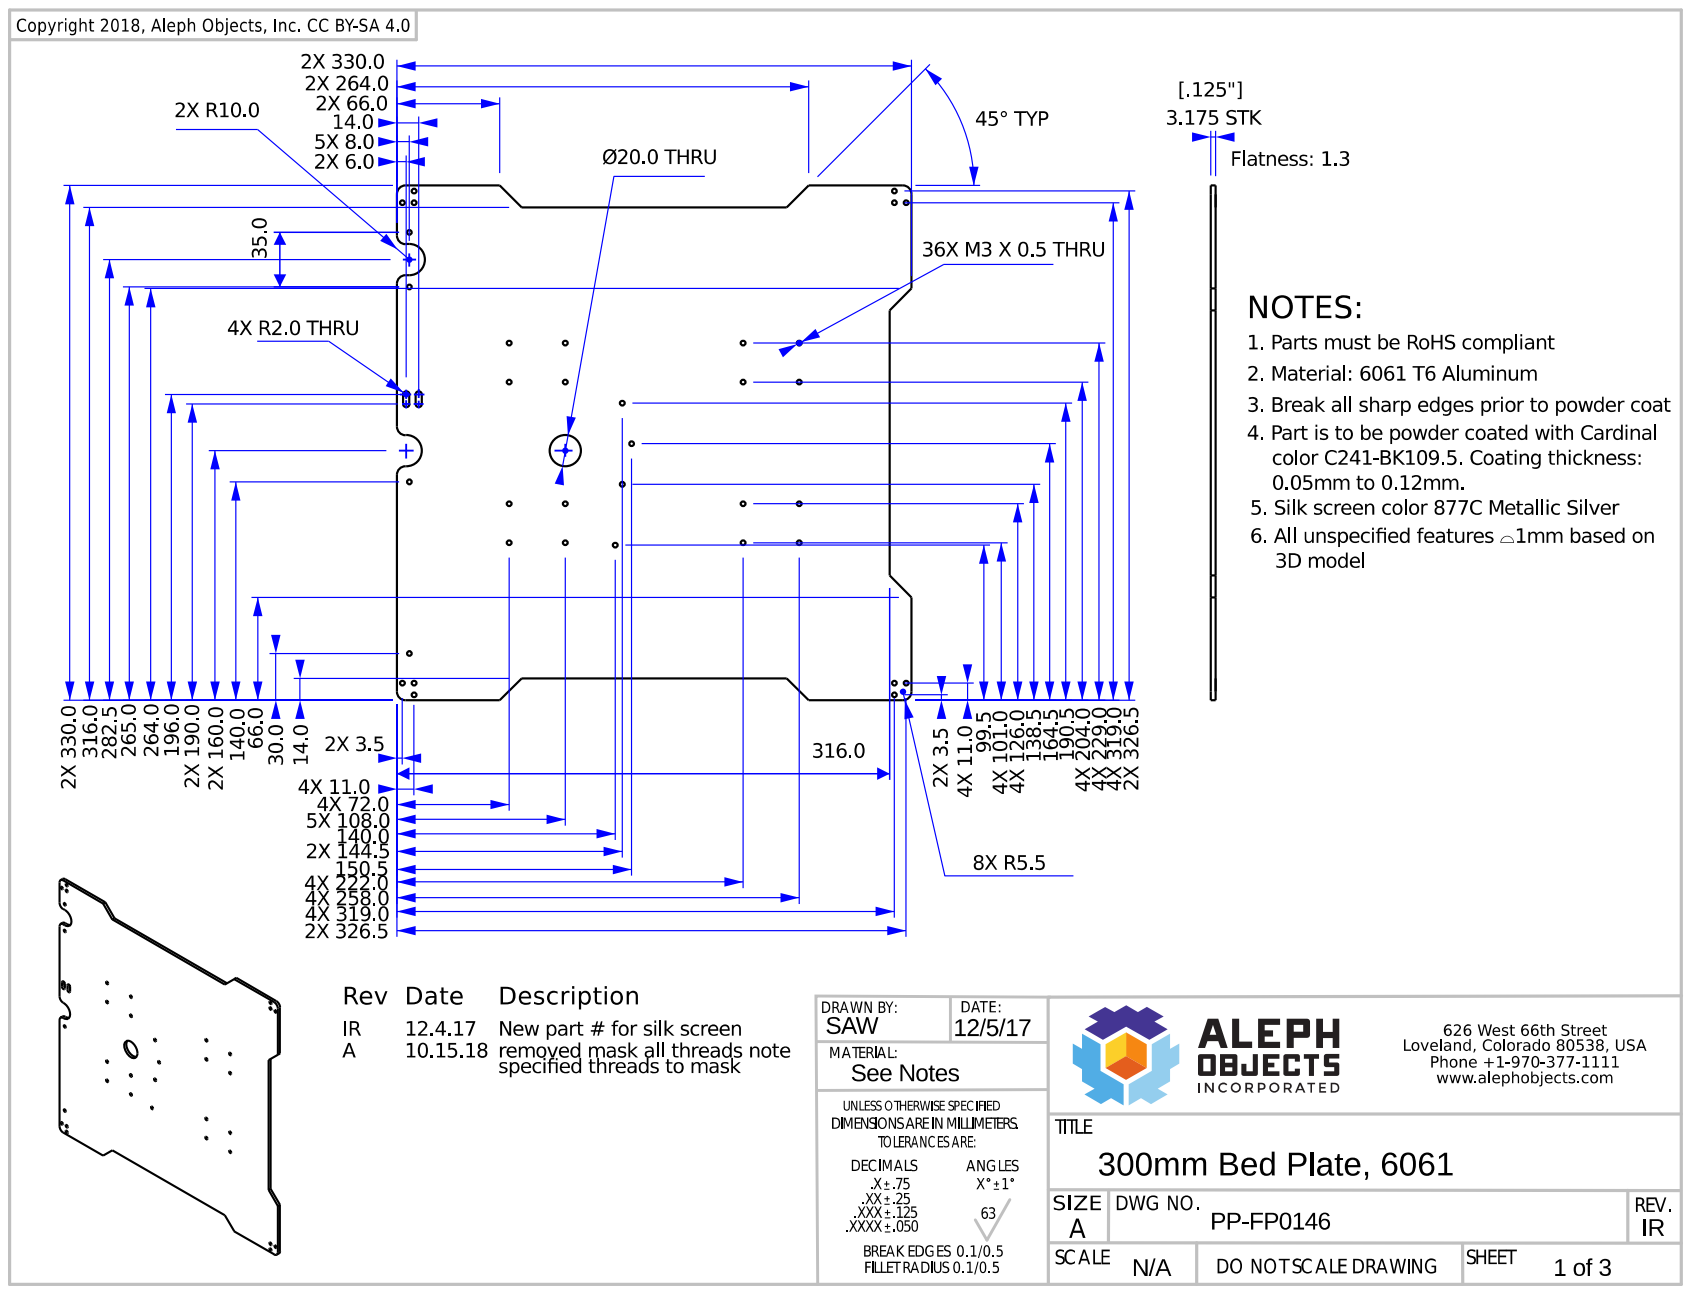
[picture p509: page 1]

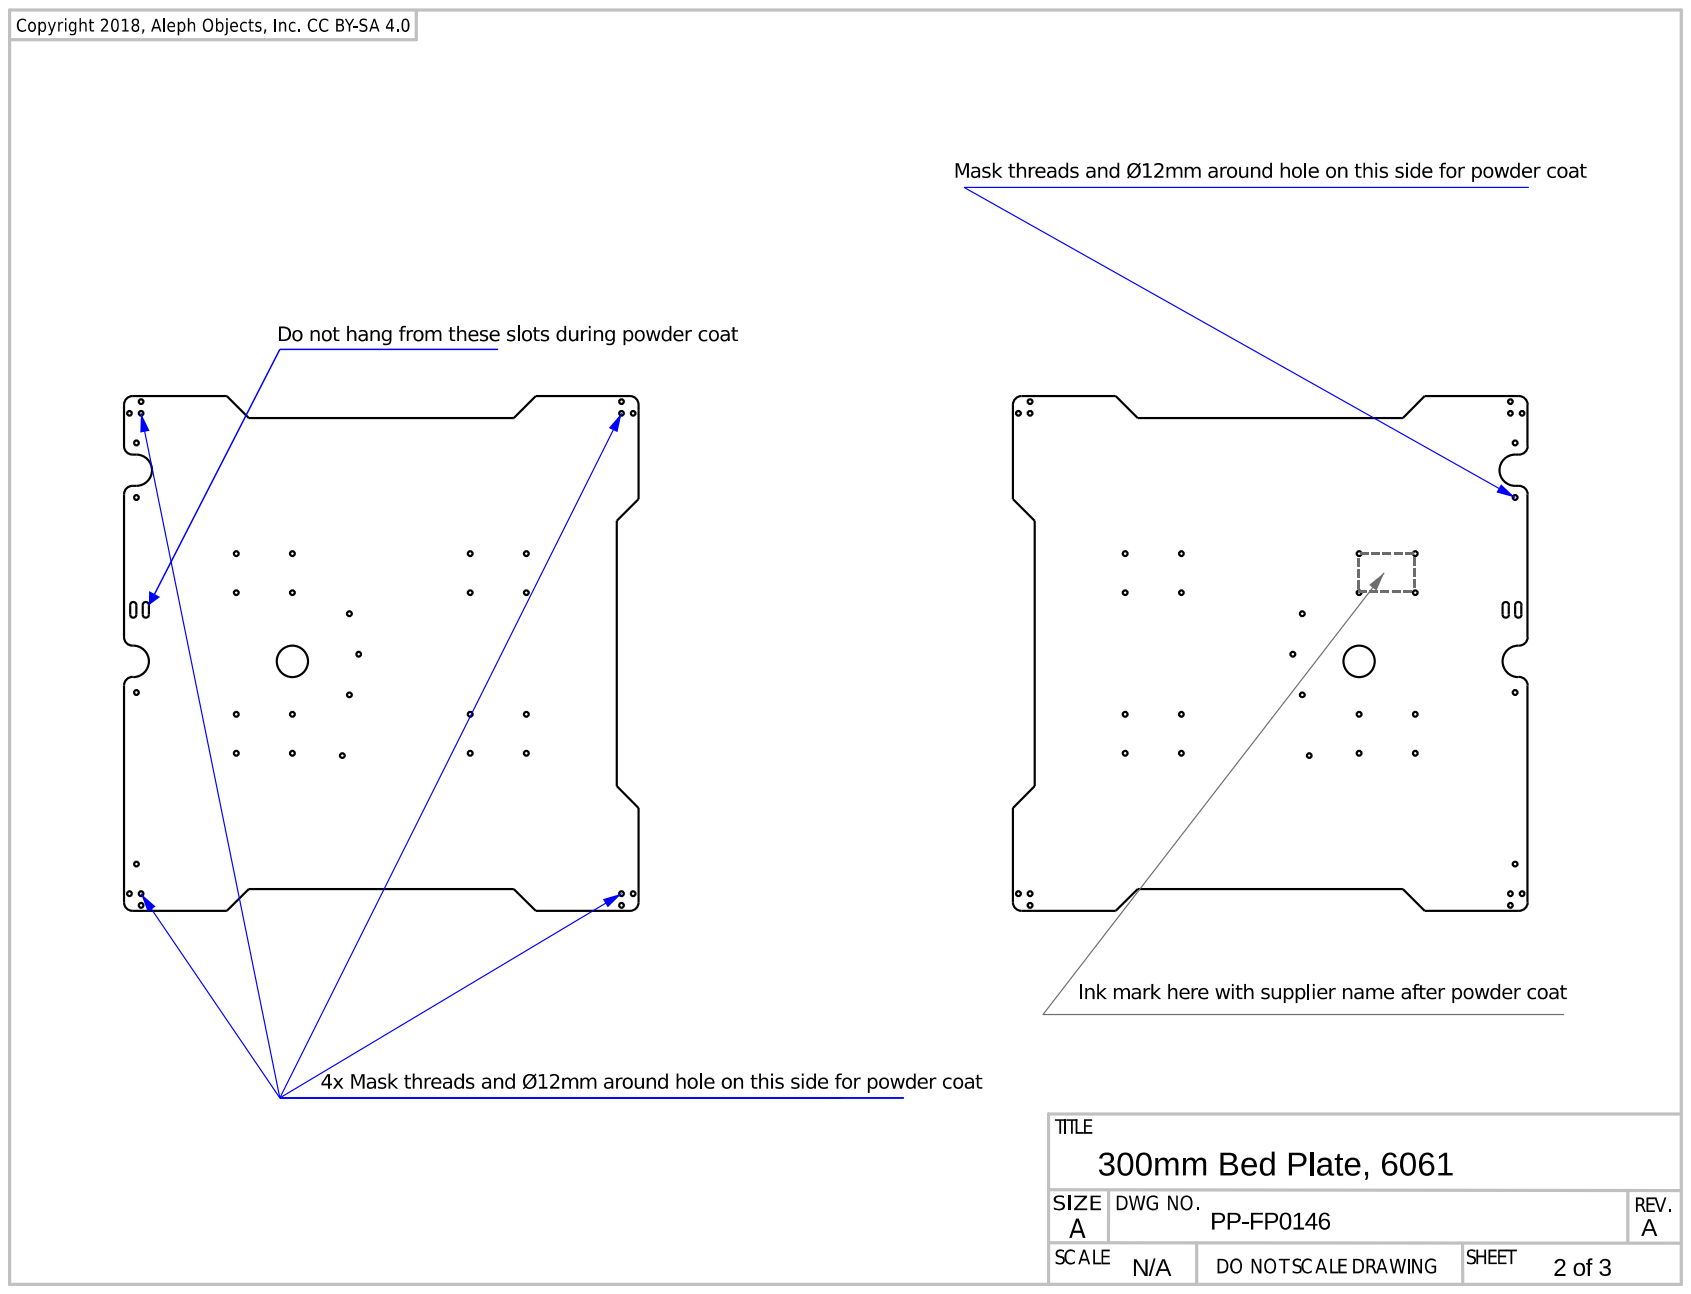
[picture p510: page 2]

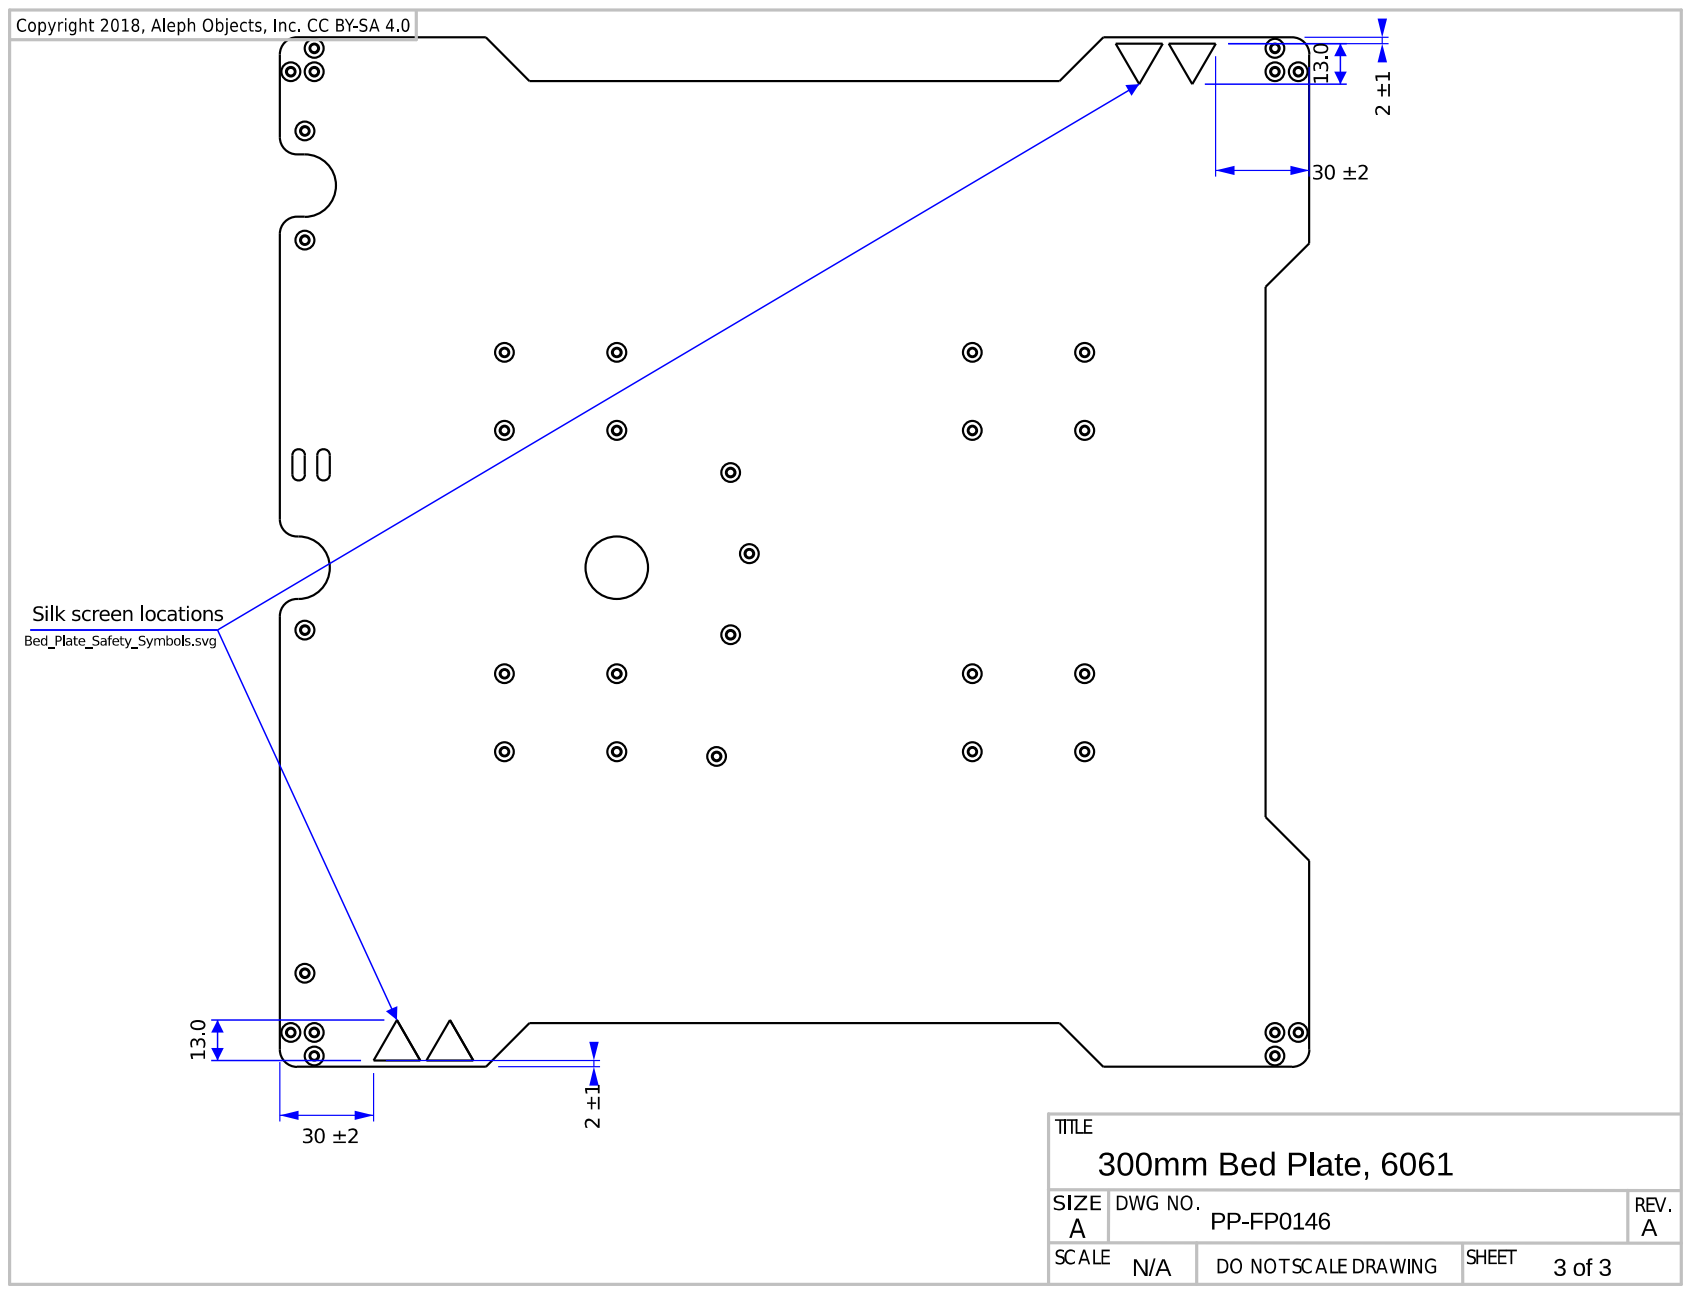
[picture p511: page 3]
