gralco/TAZ6/production_parts/machined_parts/corner_bracket_v2.0/corner_bracket_PP-MP0106_revC.pdf

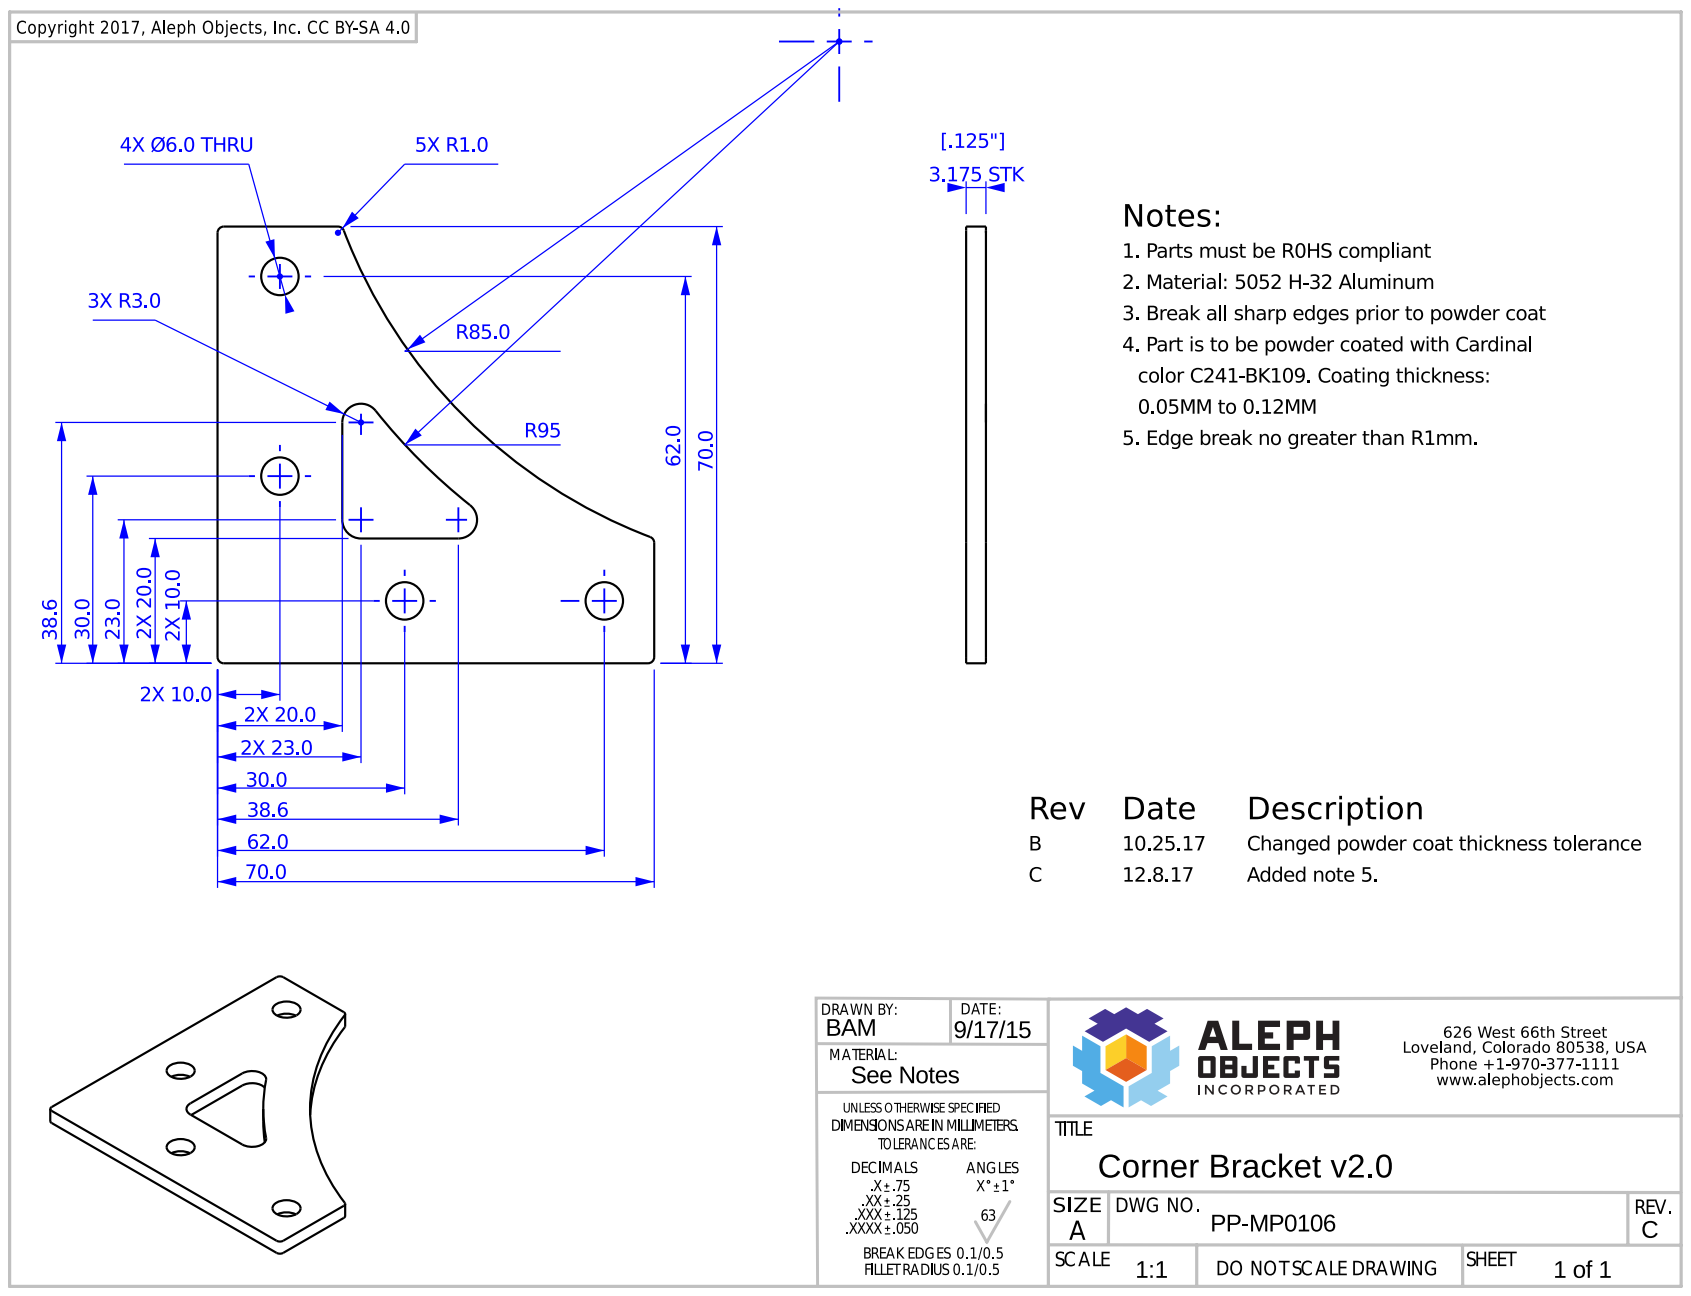
[picture p512: page 1]
