gralco/TAZ6/production_parts/machined_parts/drive_rod_12mm/drive_rod_12mm_HD-RD0048_revA.pdf

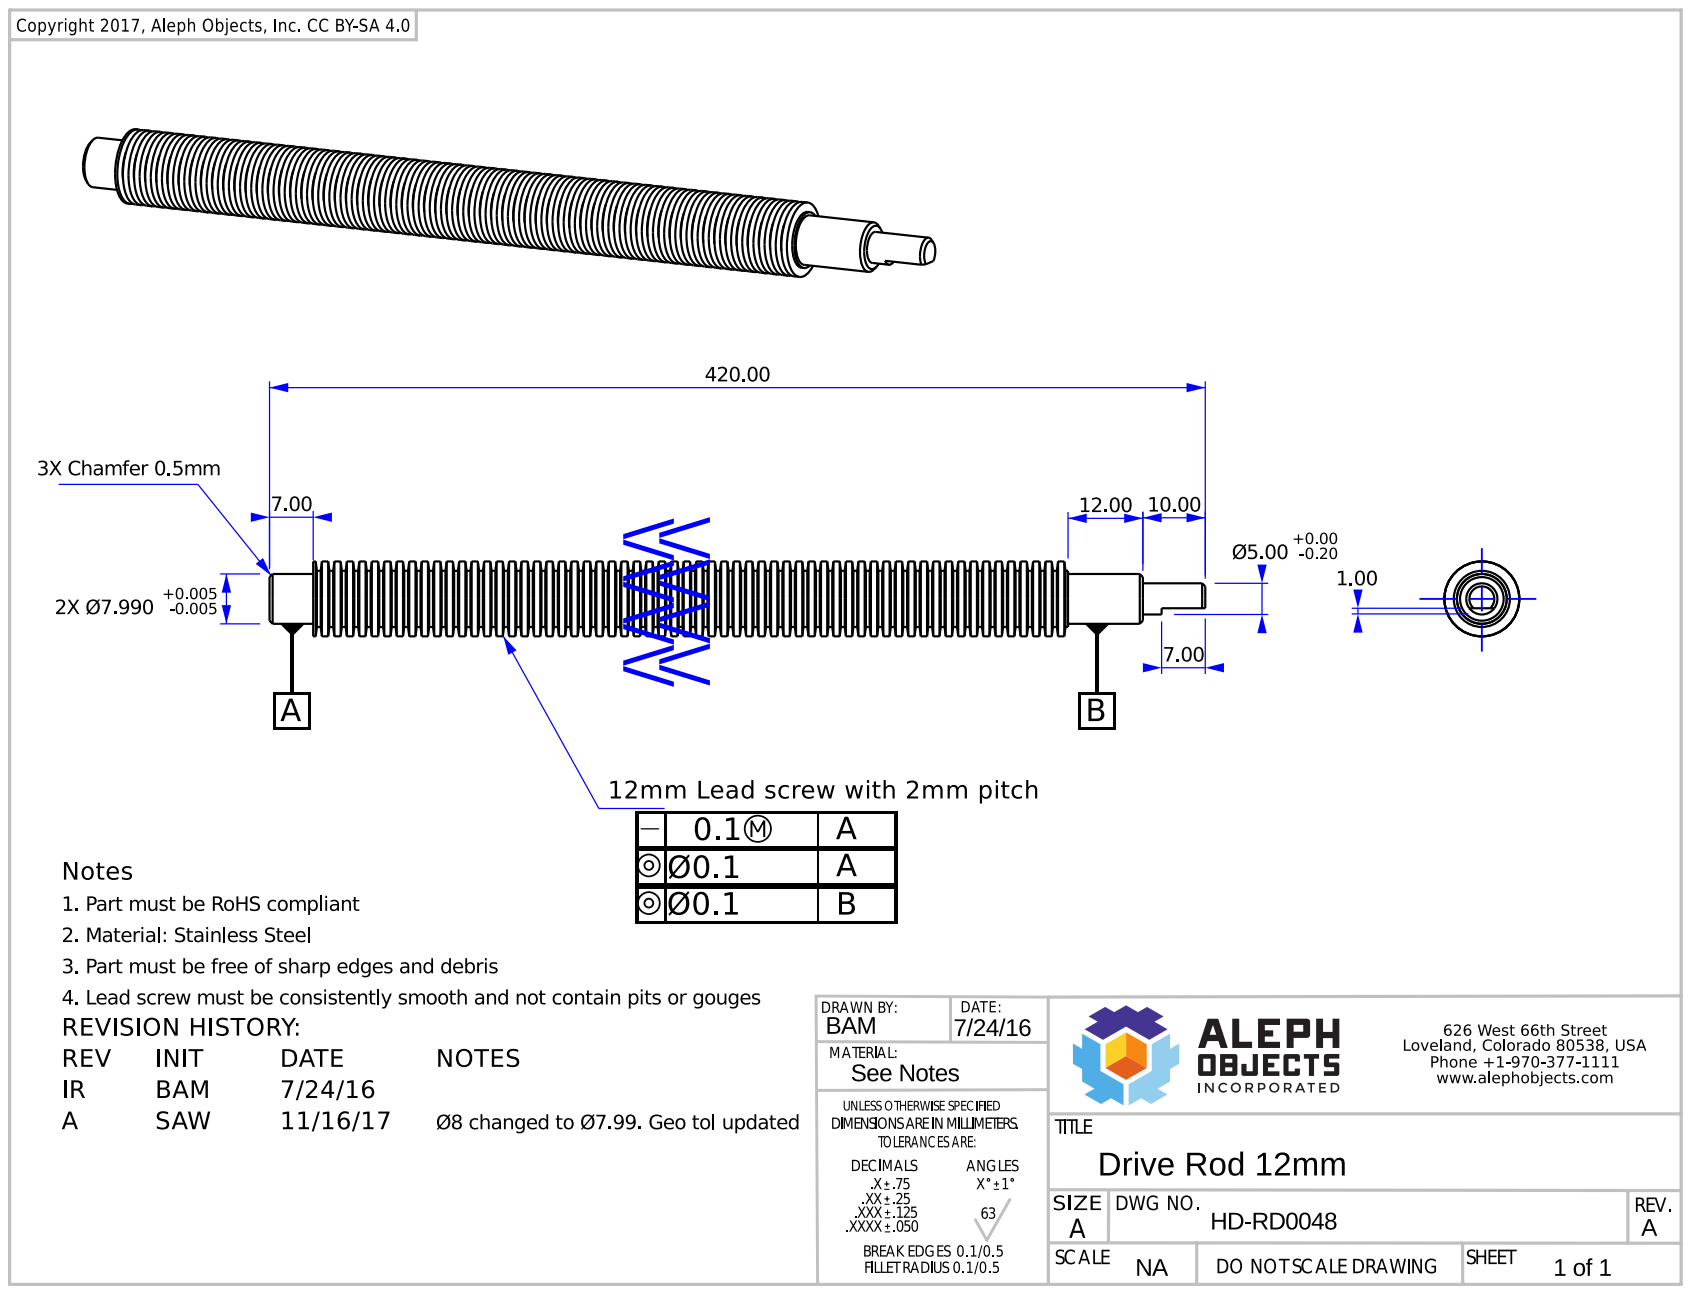
[picture p513: page 1]
