gralco/TAZ6/production_parts/machined_parts/electronics_chassis/electronics_chassis_PP-FP0142_RevA.pdf

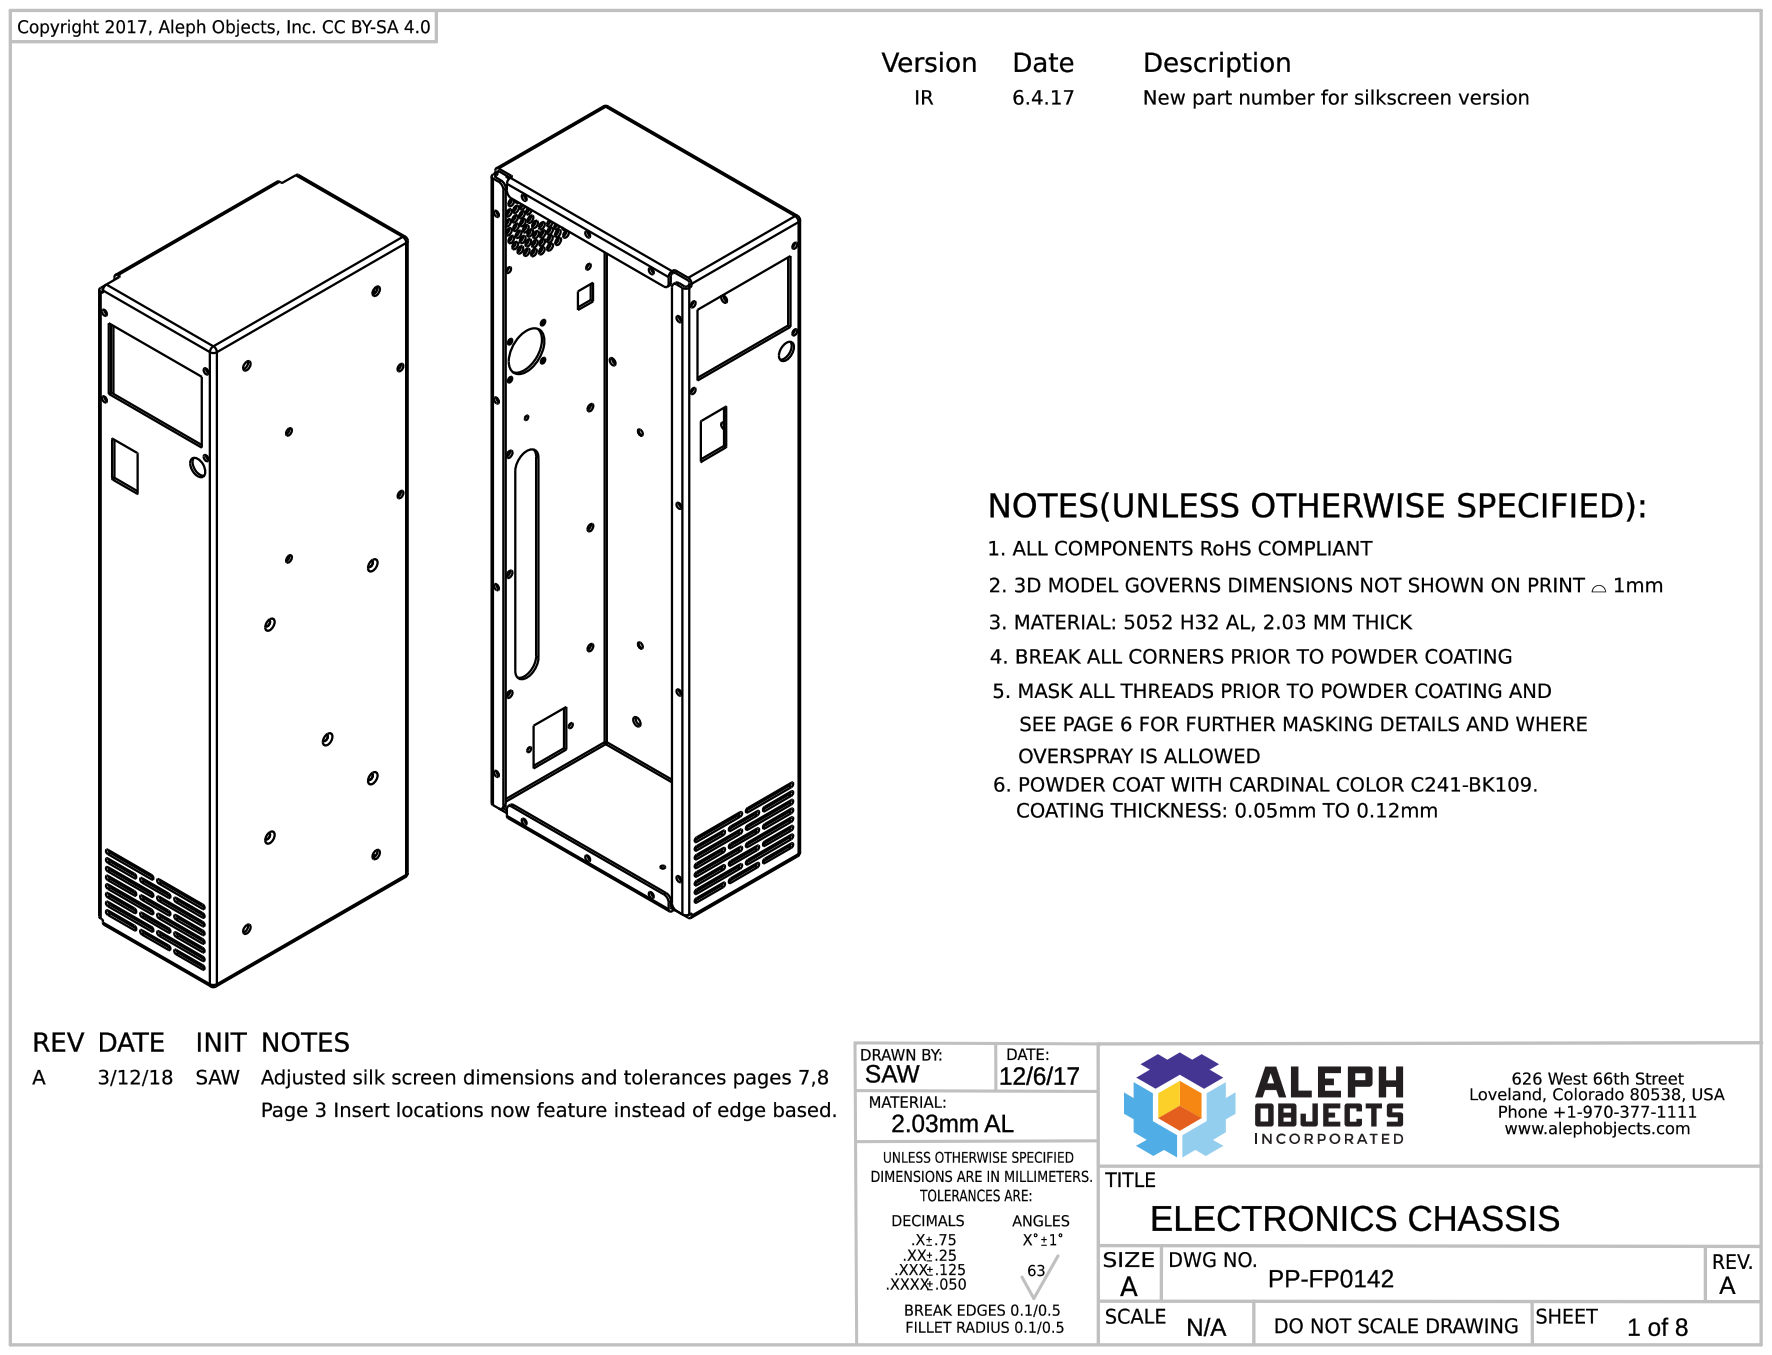
[picture p514: page 1]

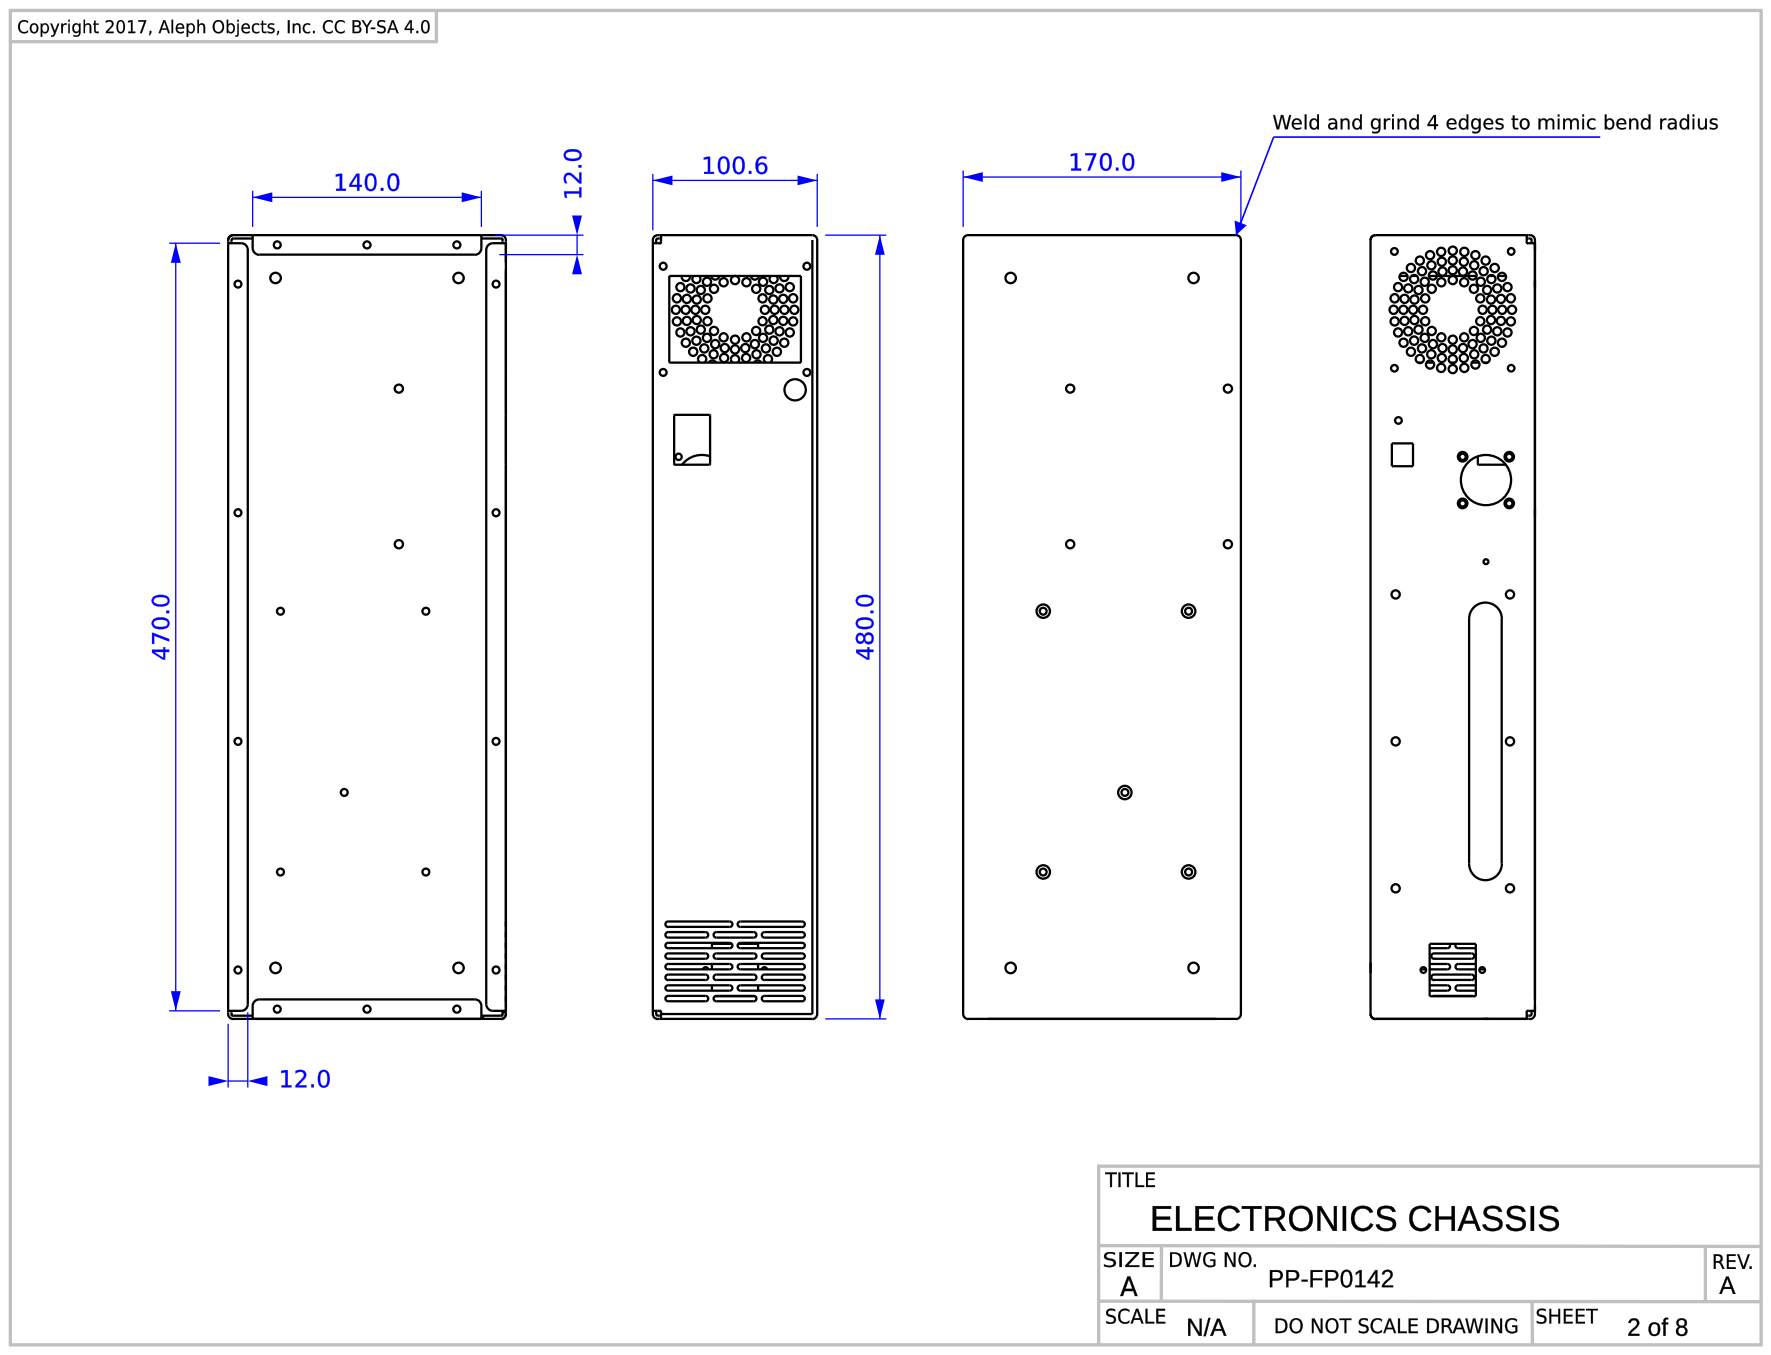
[picture p515: page 2]

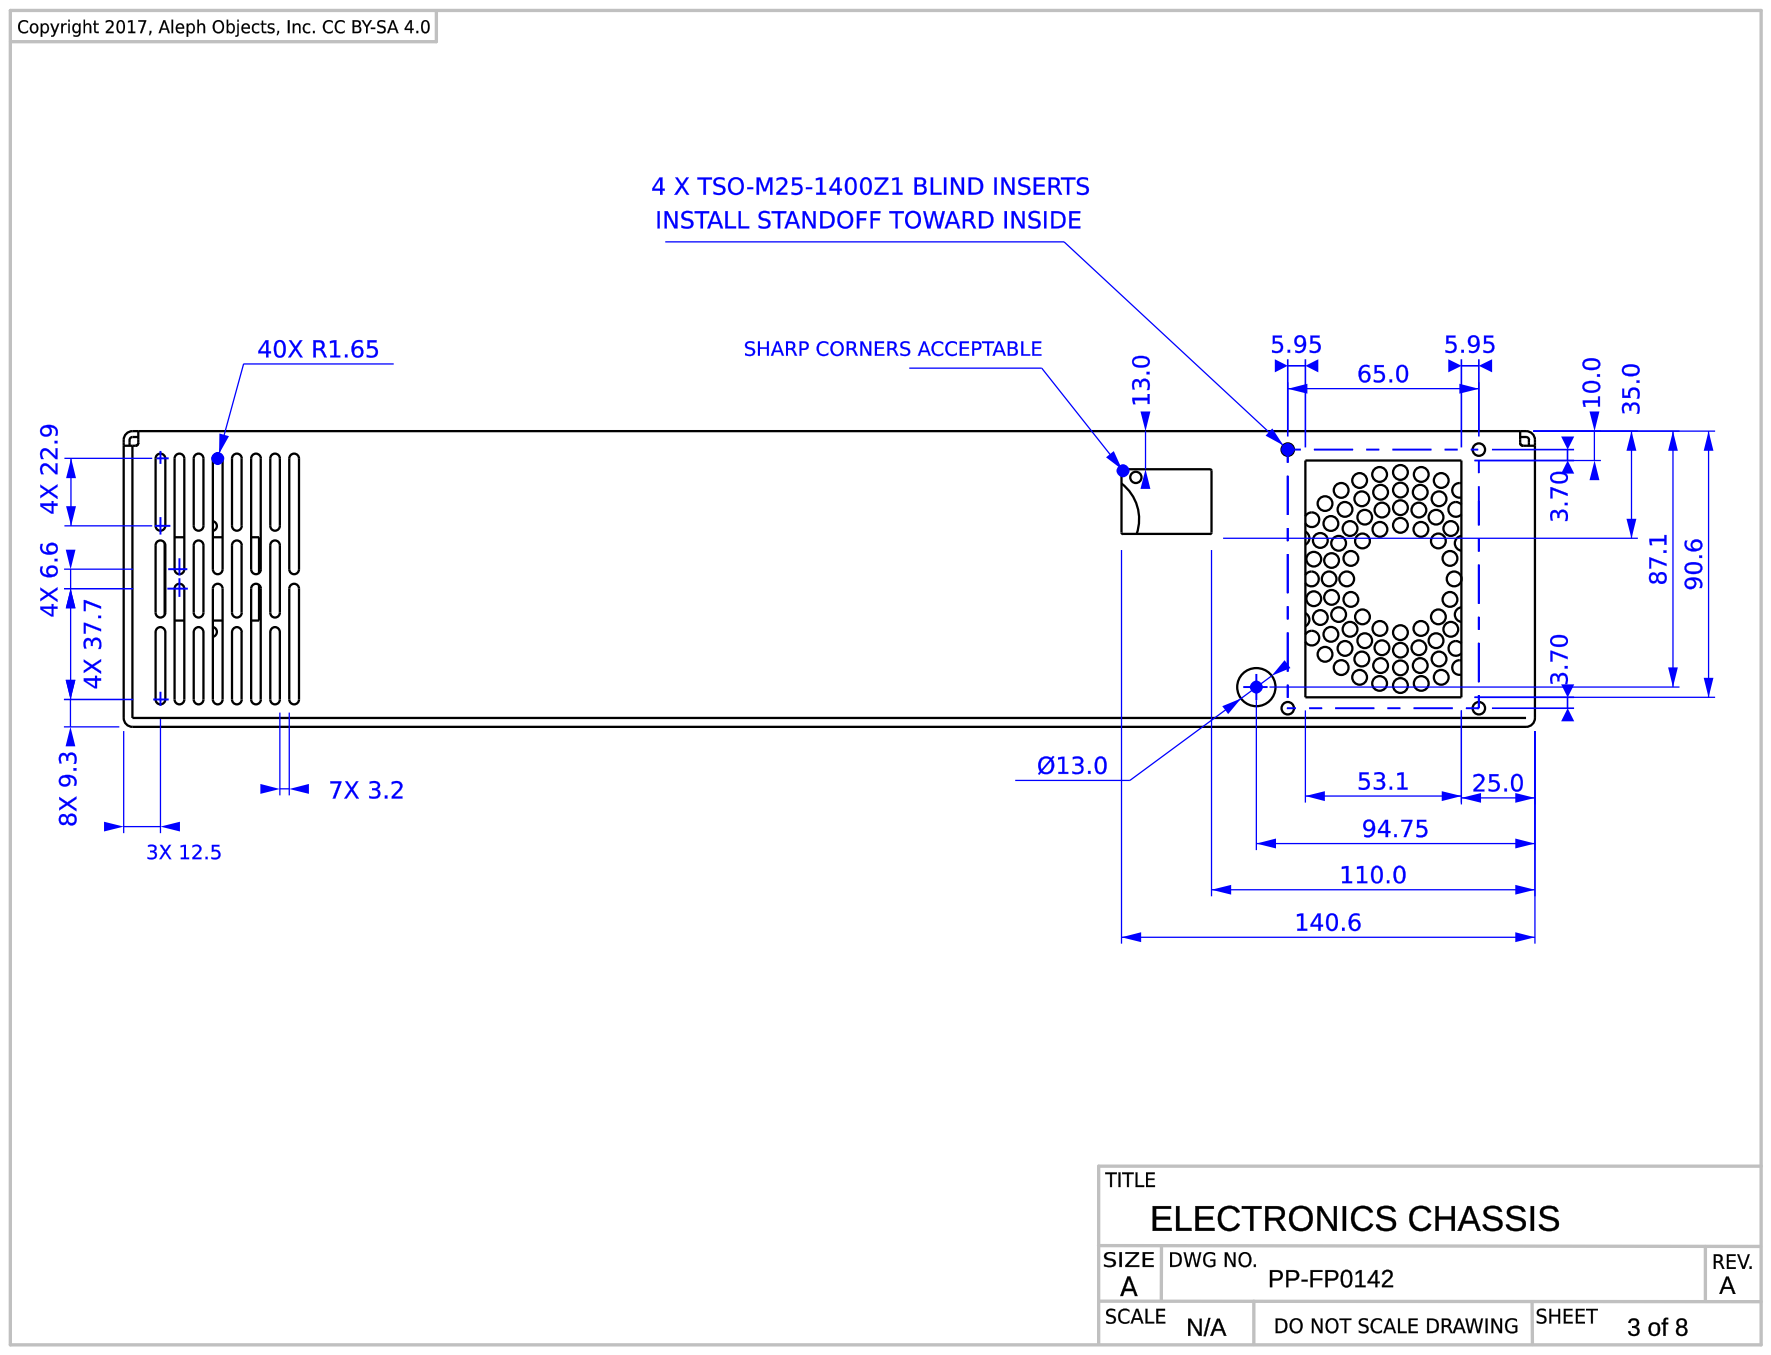
[picture p516: page 3]

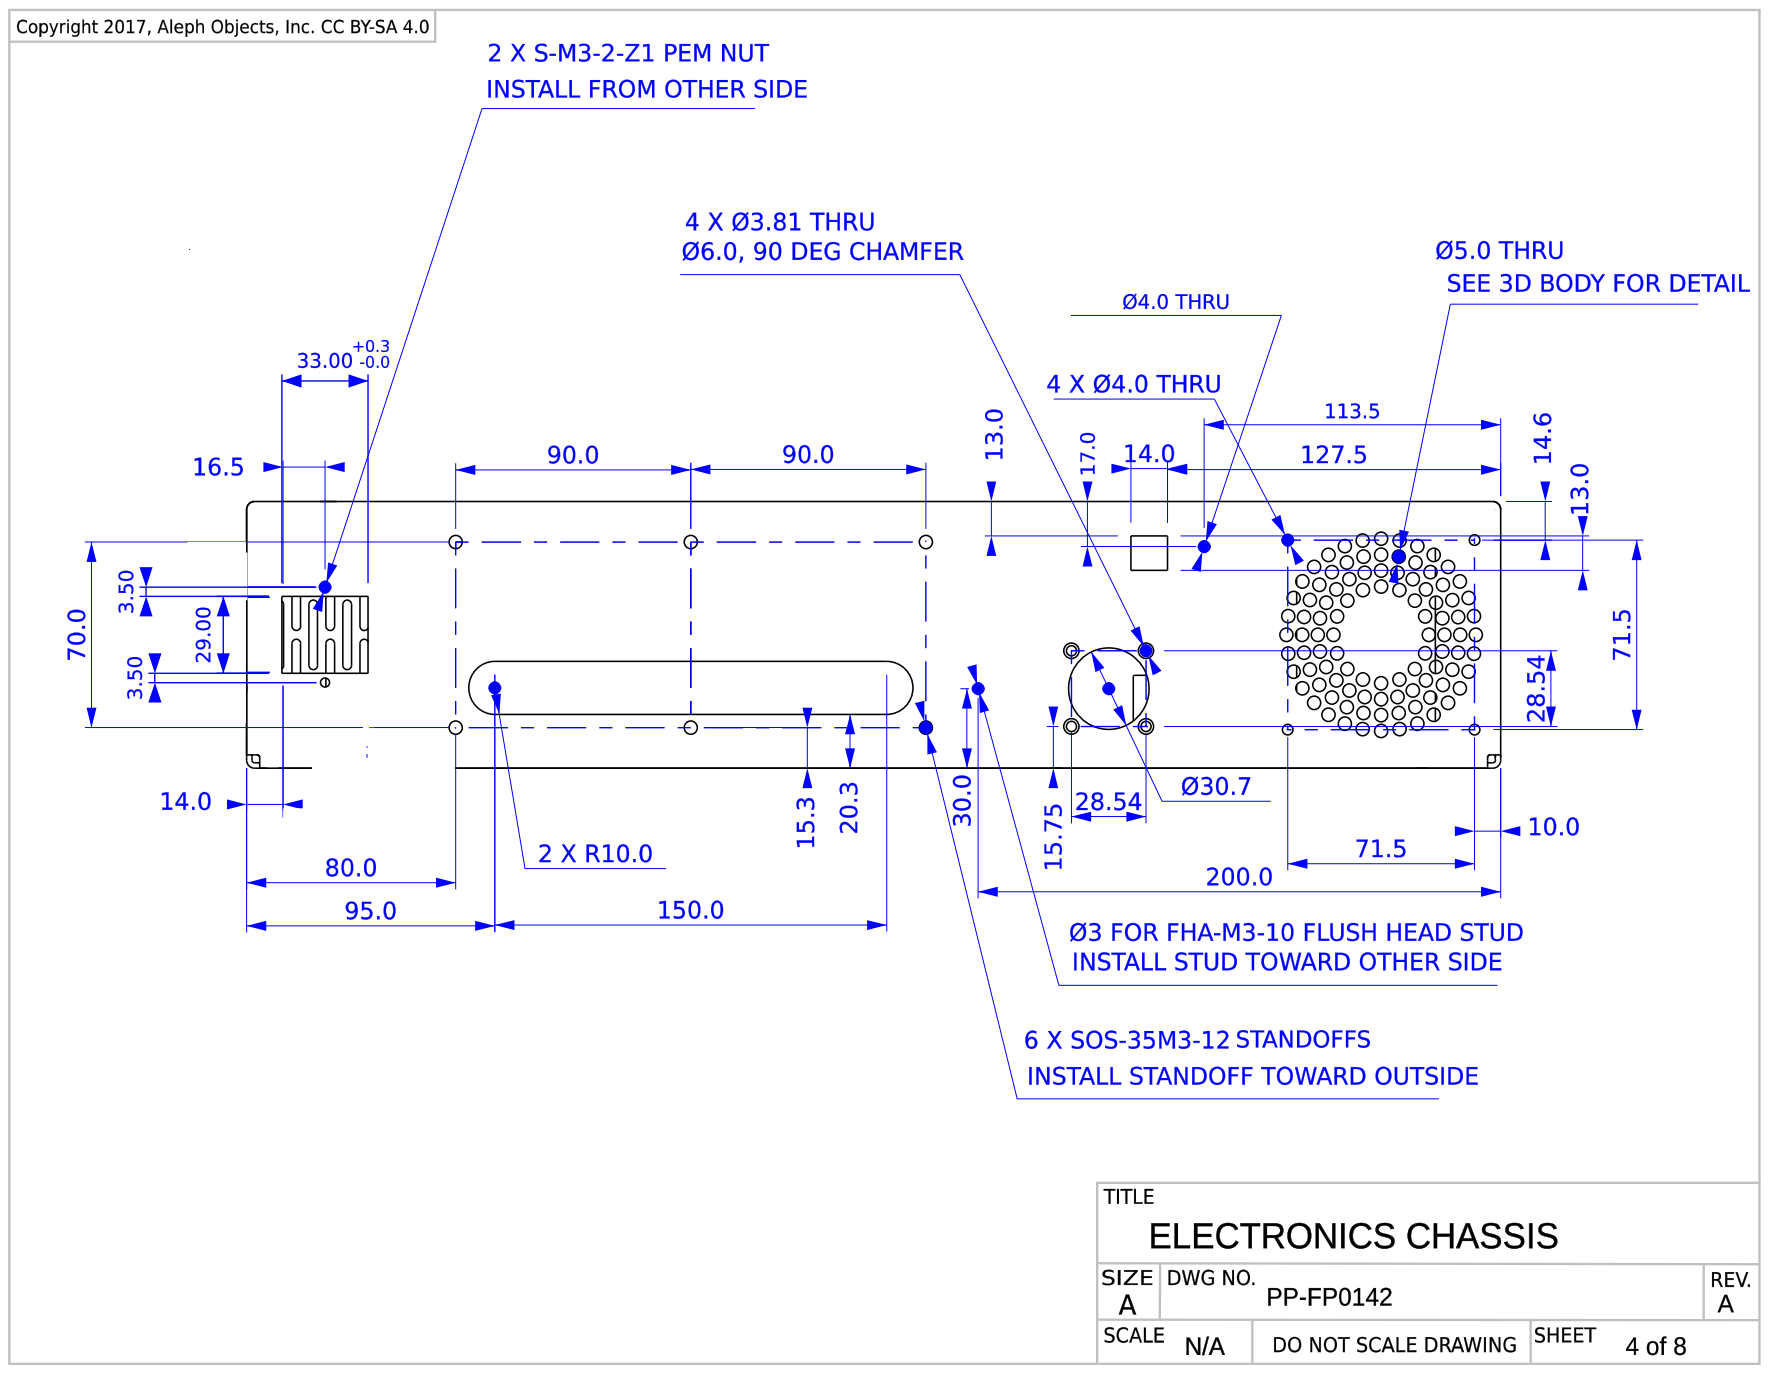
[picture p517: page 4]

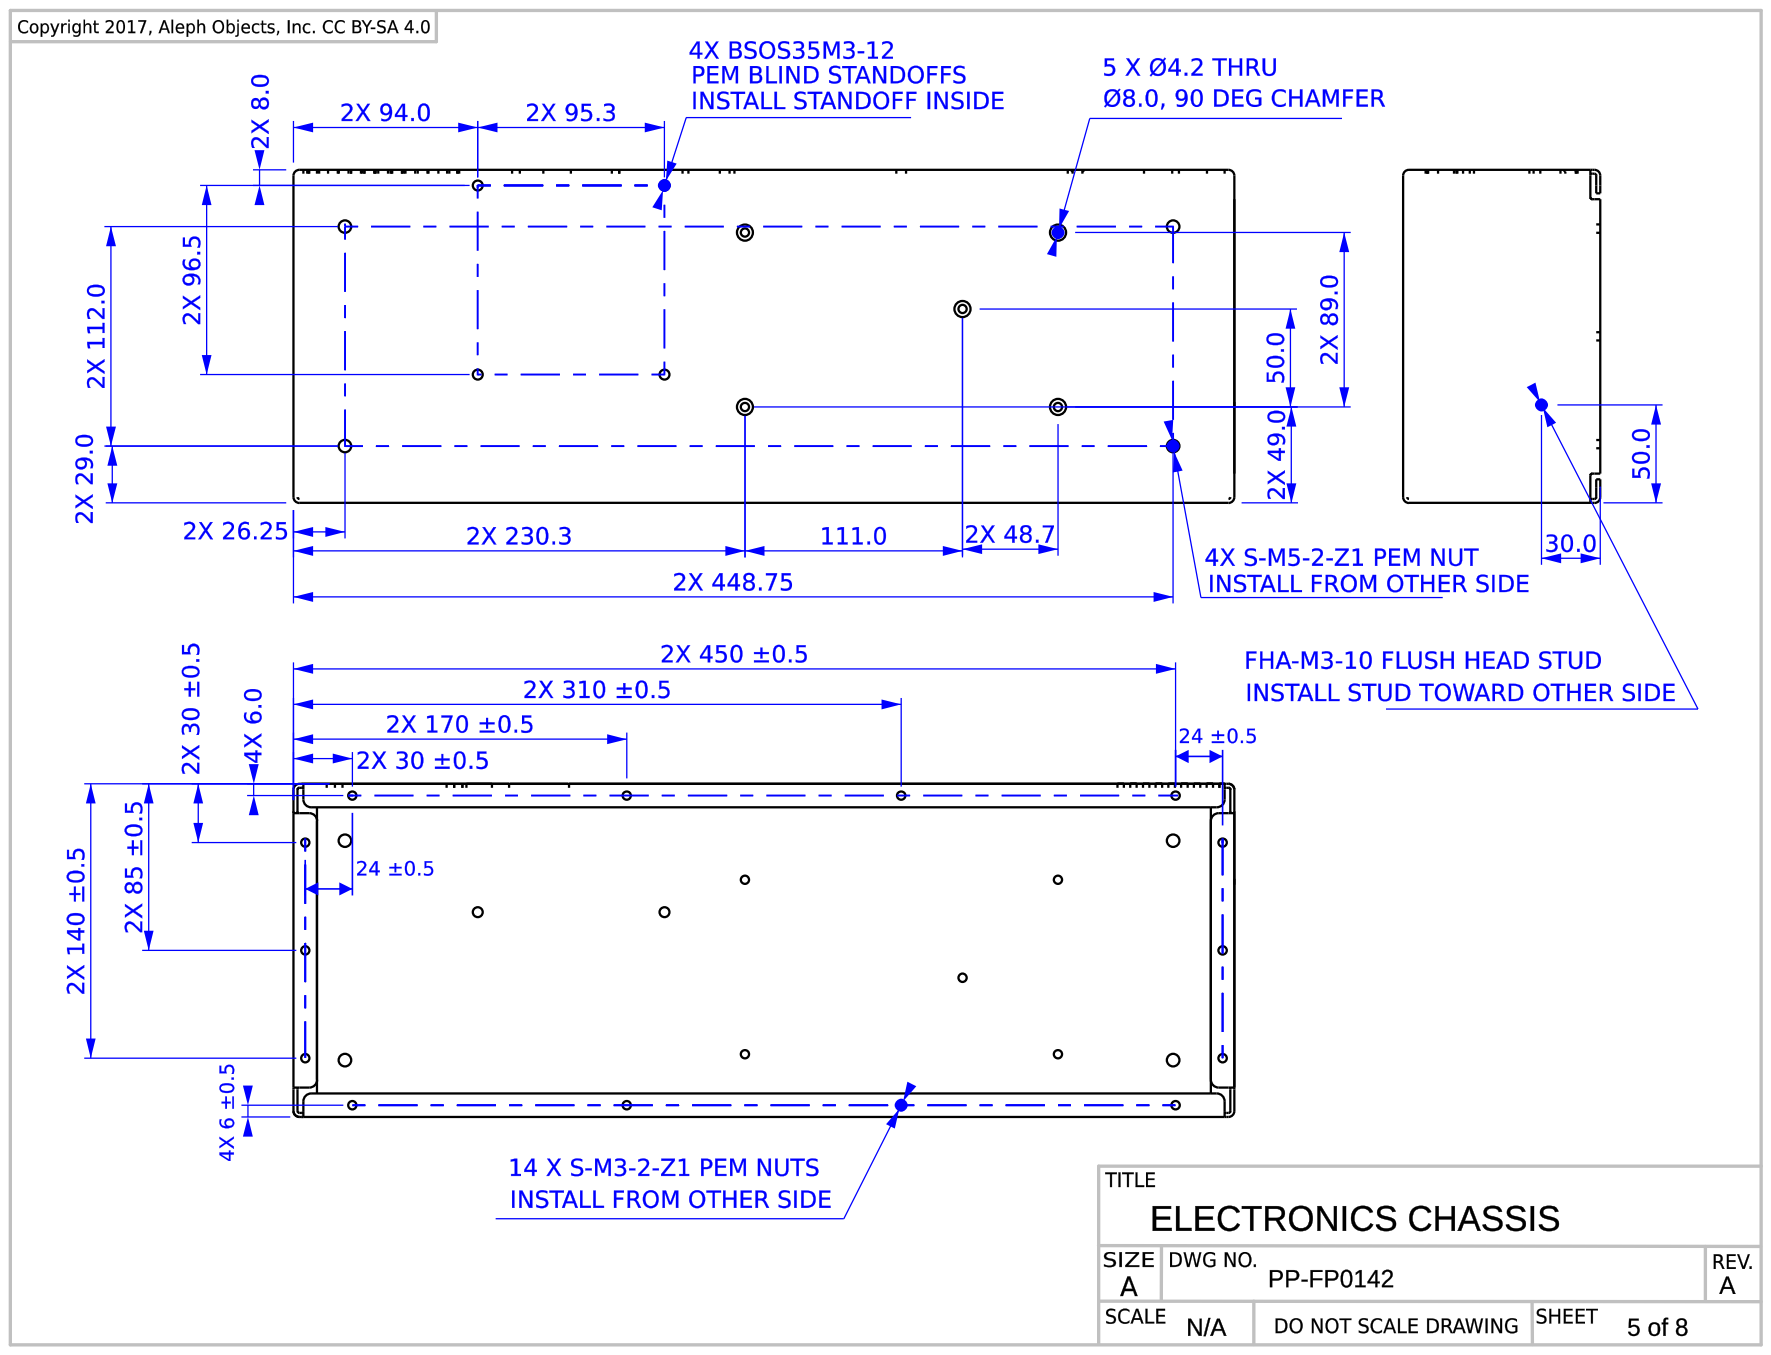
[picture p518: page 5]

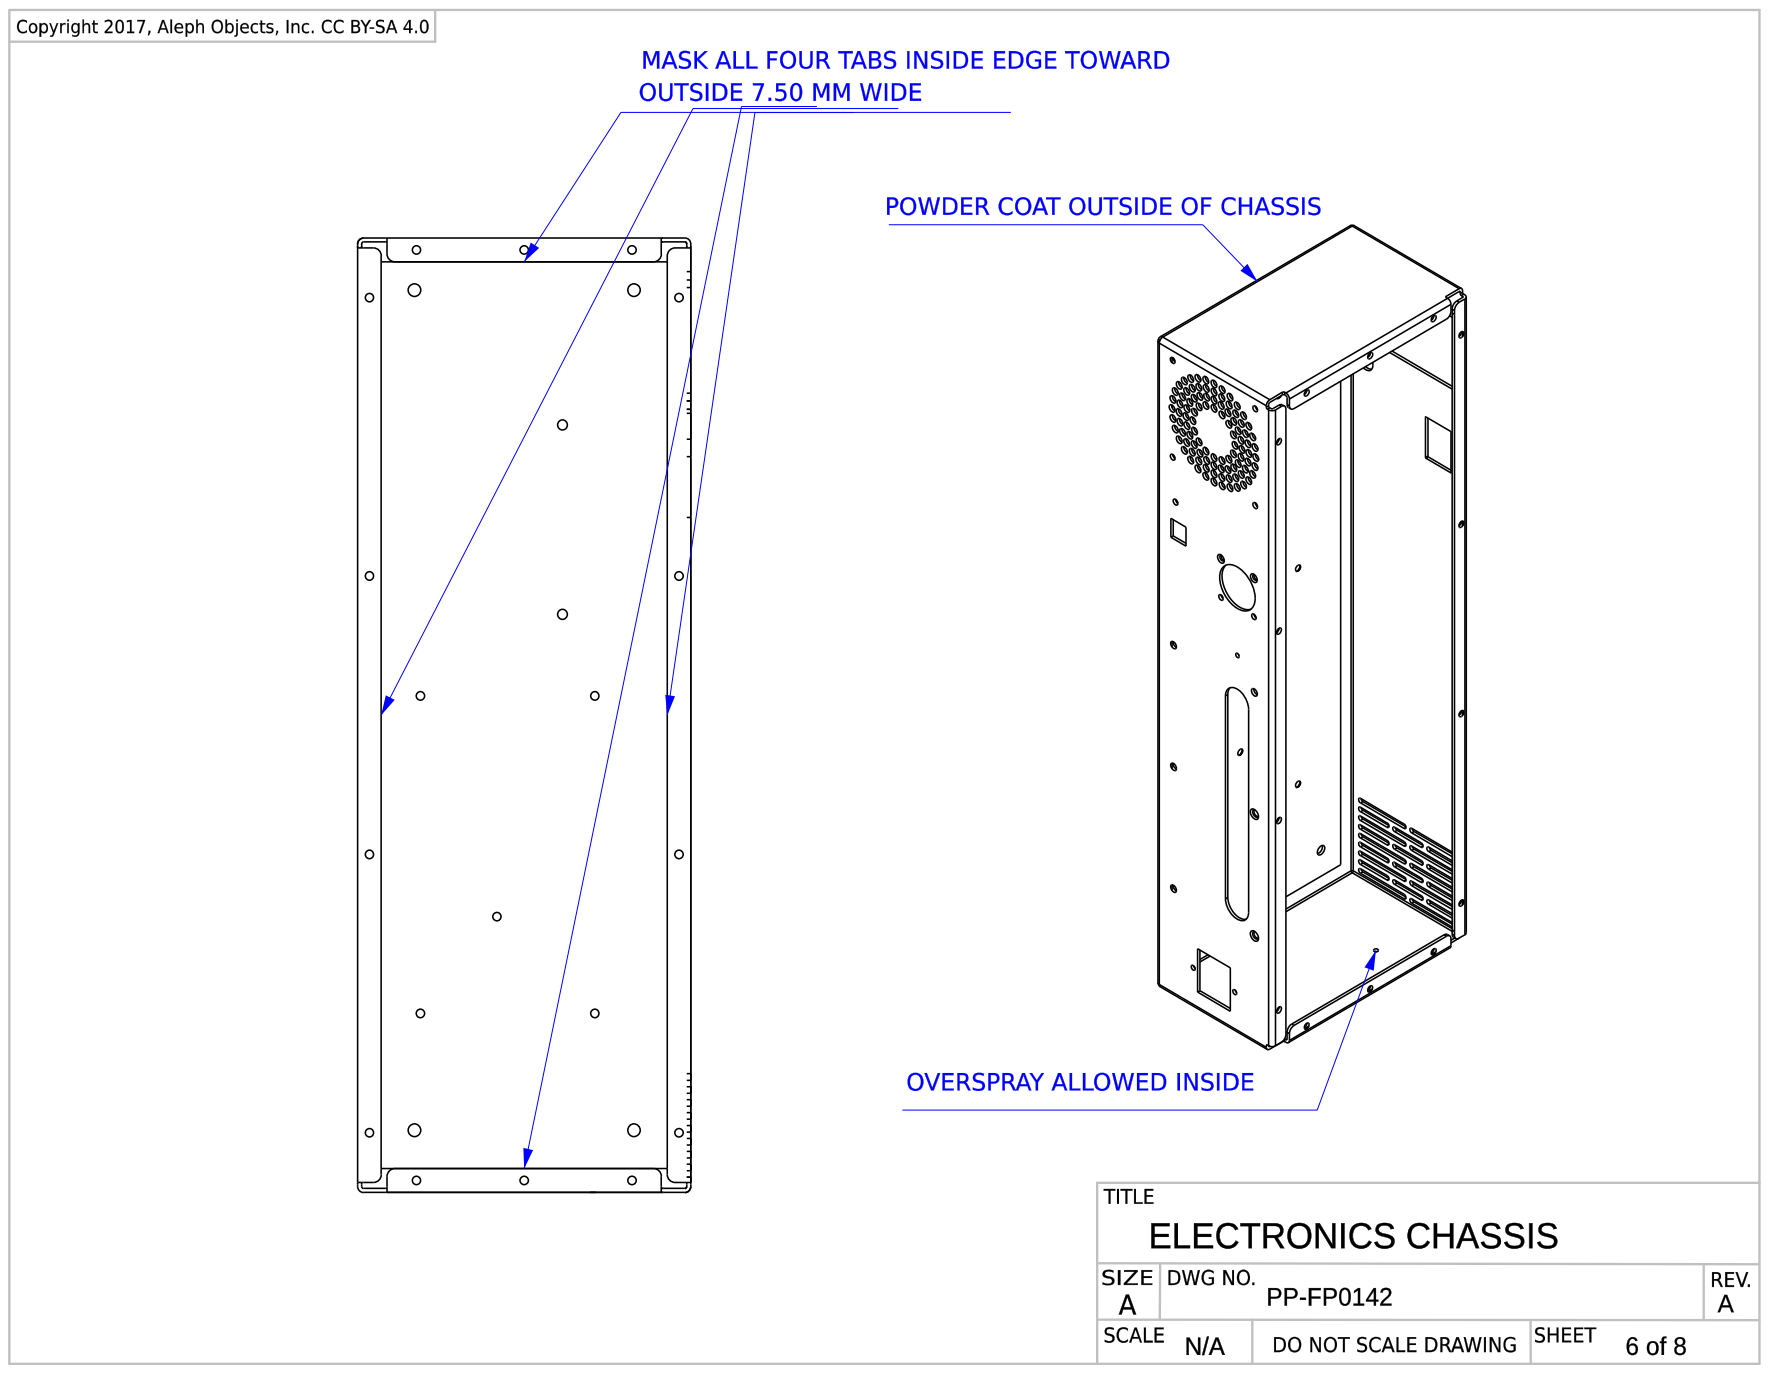
[picture p519: page 6]

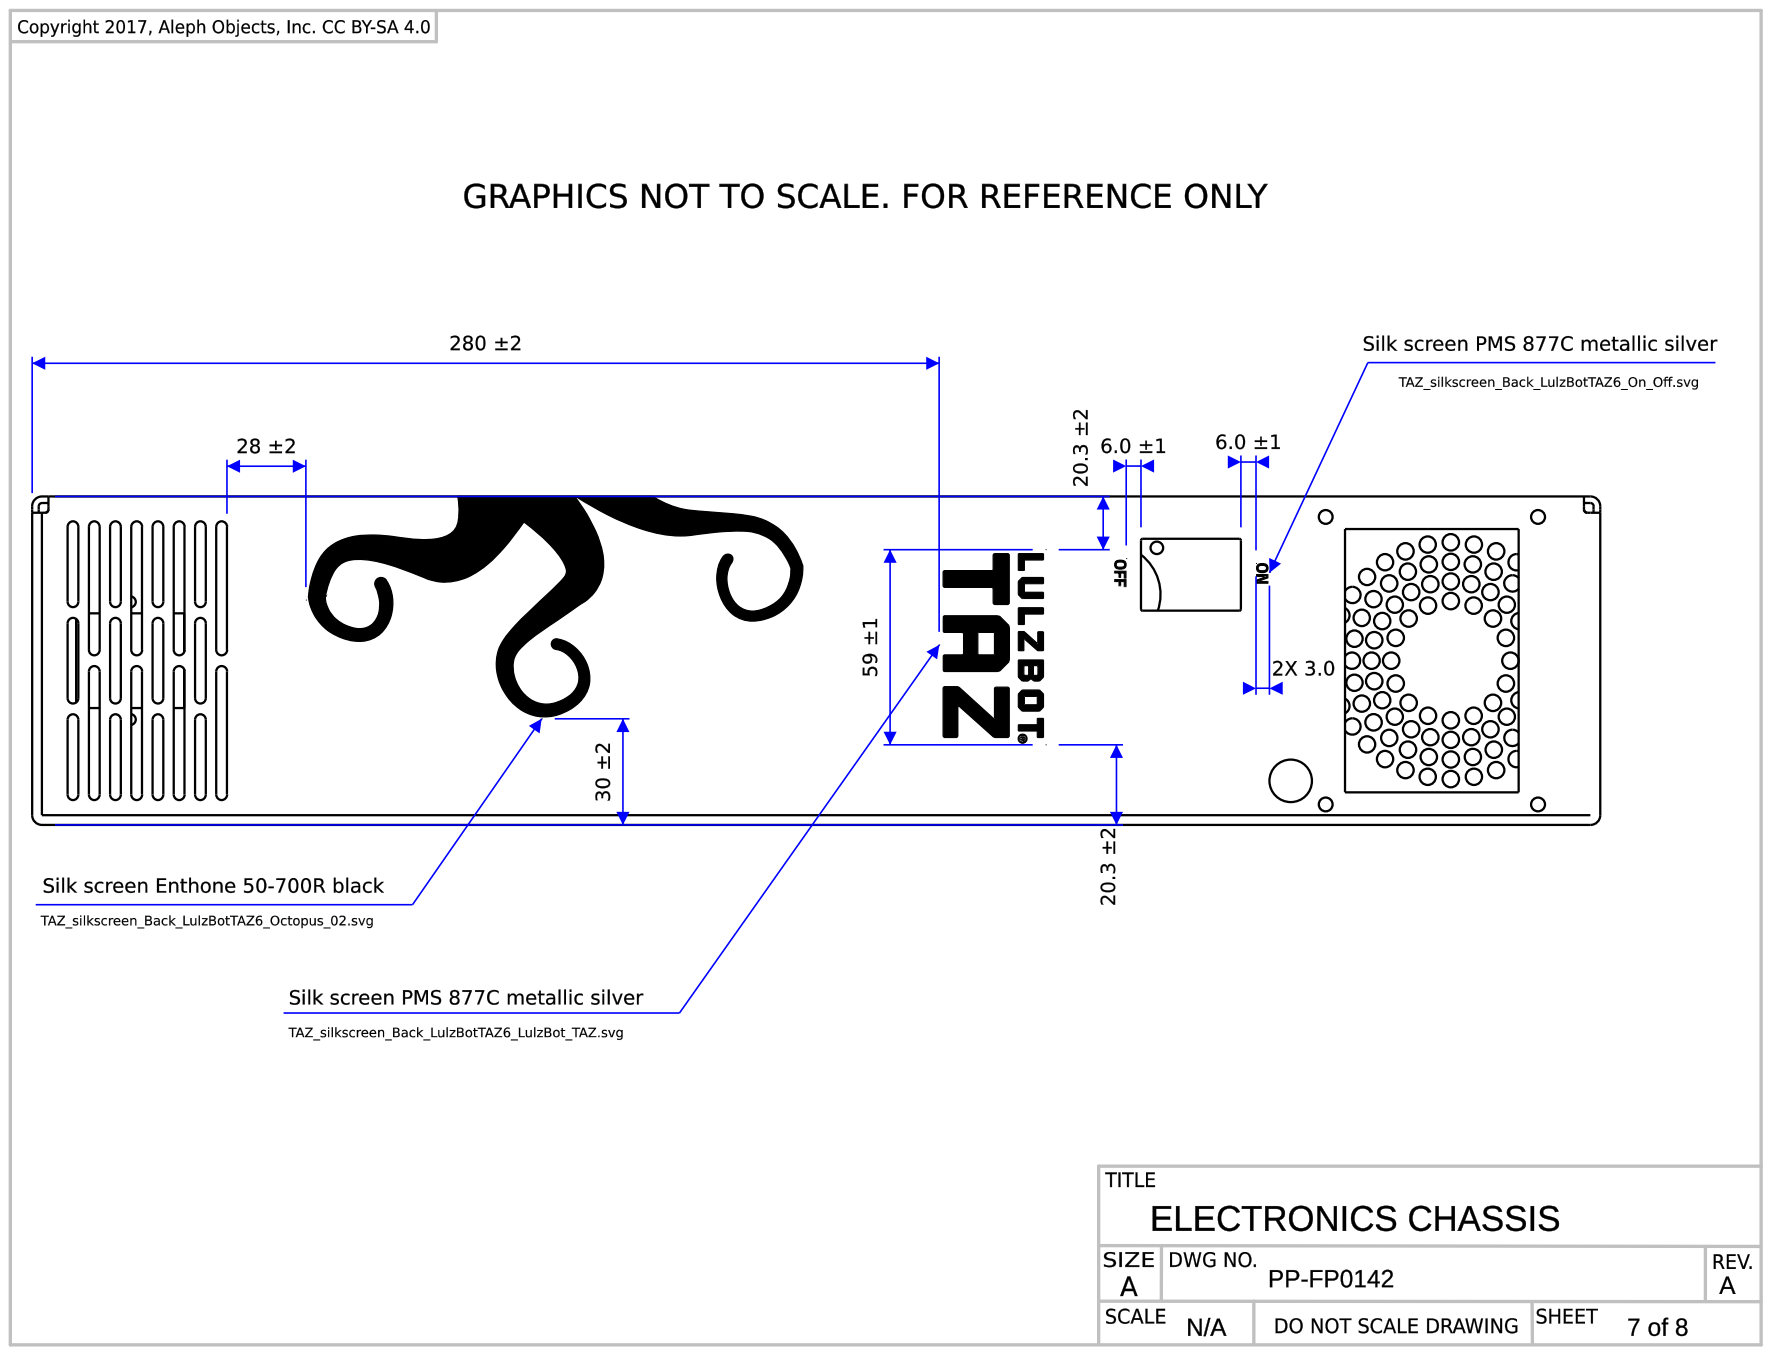
[picture p520: page 7]

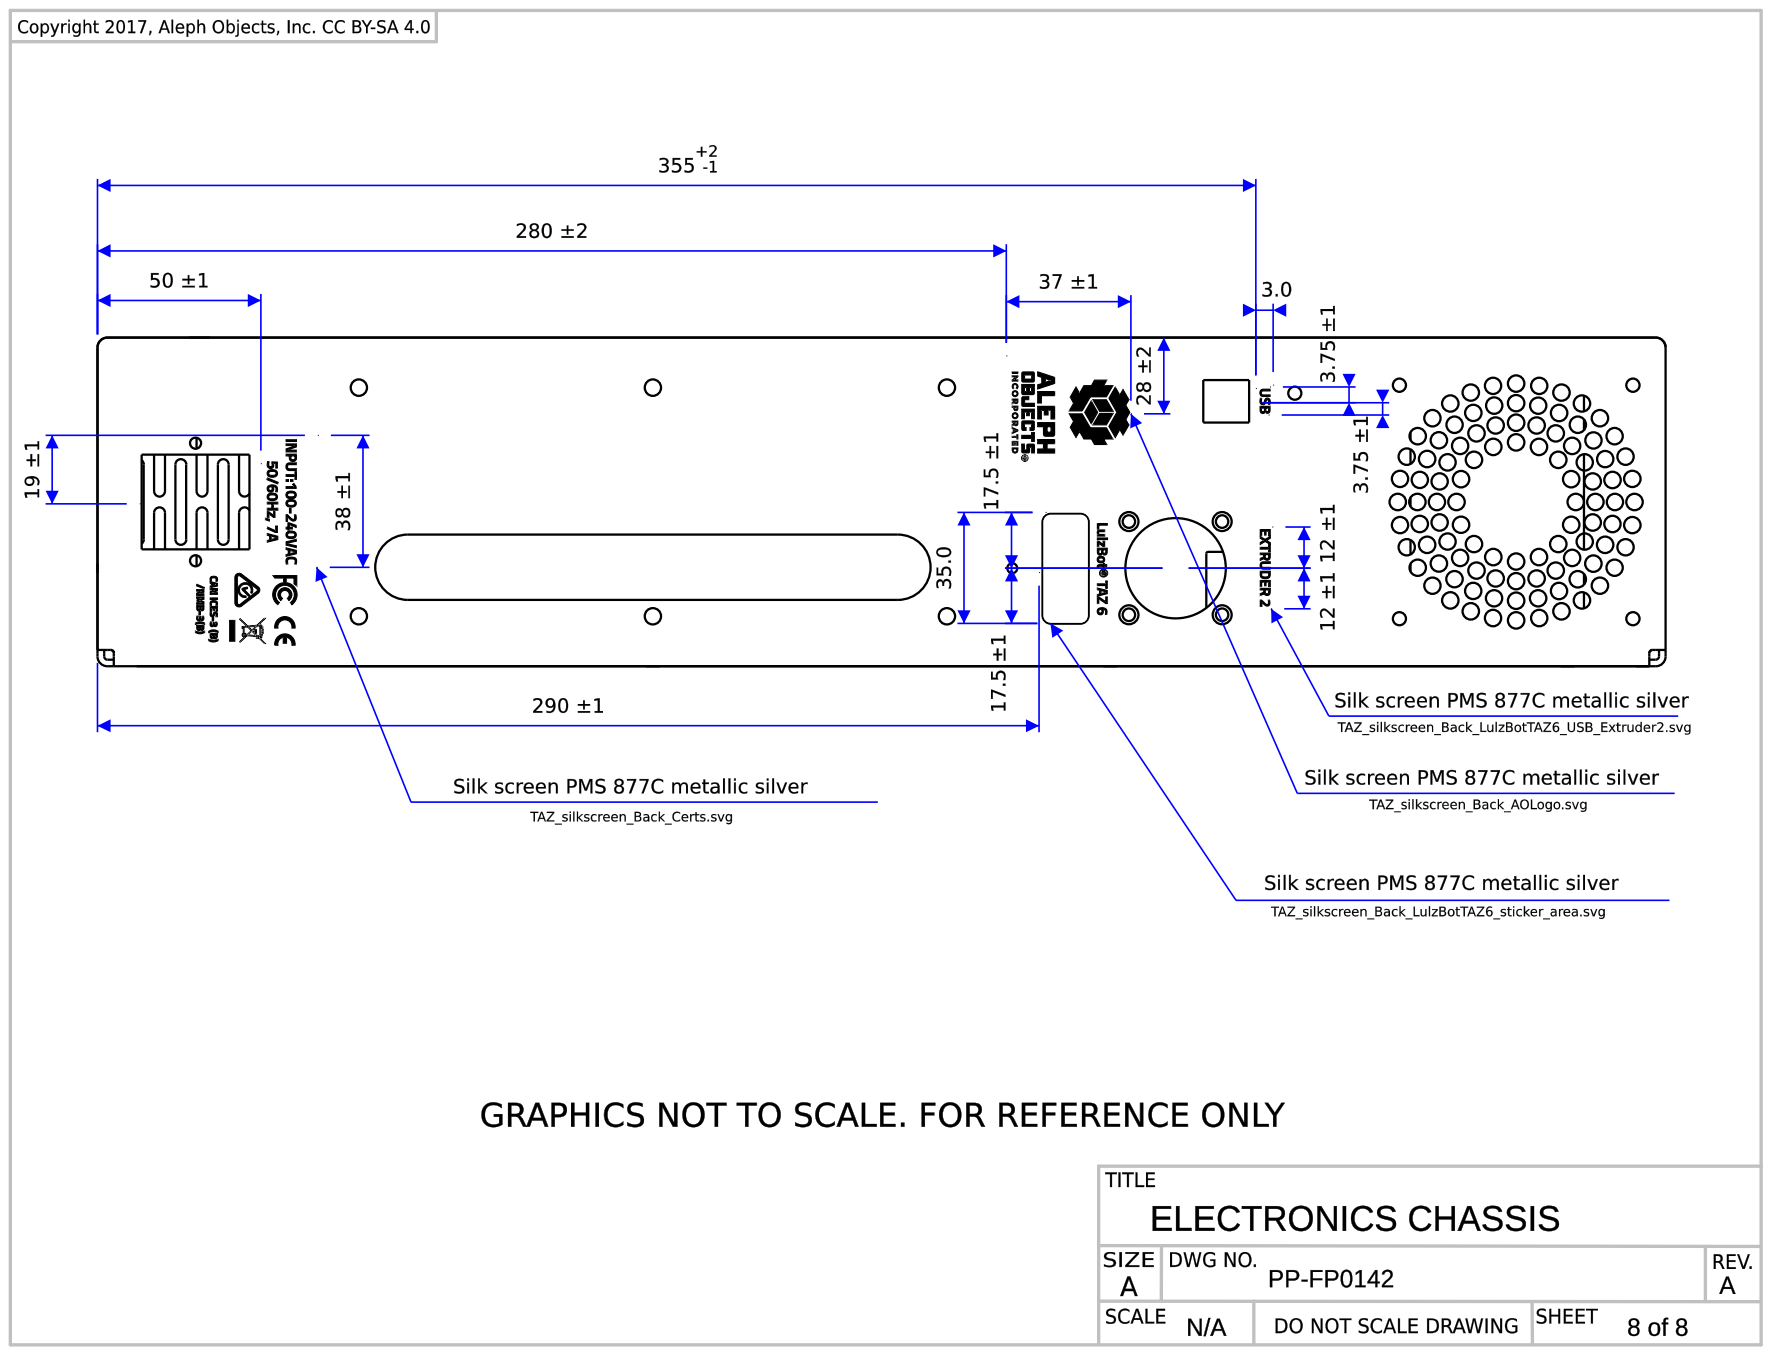
[picture p521: page 8]
