gralco/TAZ6/production_parts/machined_parts/electronics_cover/electronics_cover_PP-FP0143_RevB.pdf

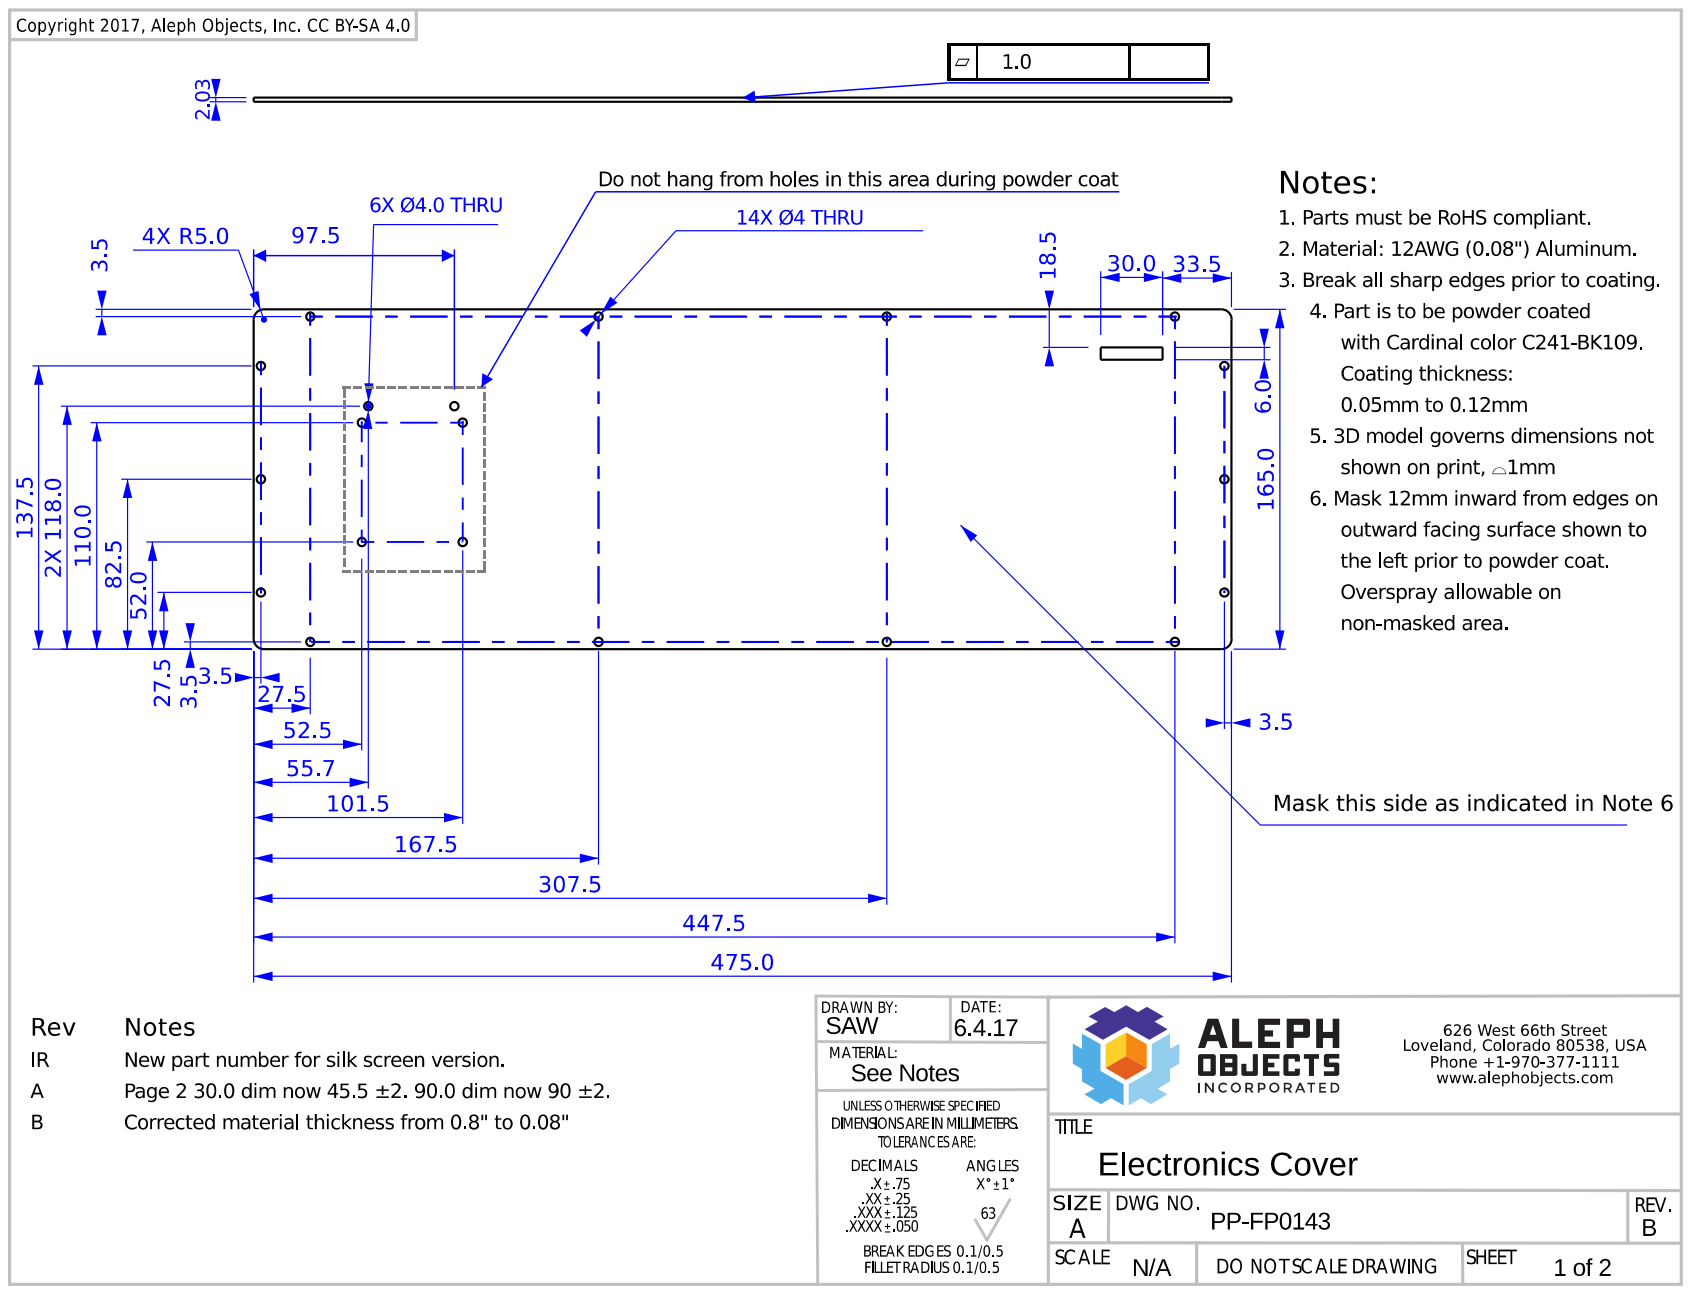
[picture p522: page 1]

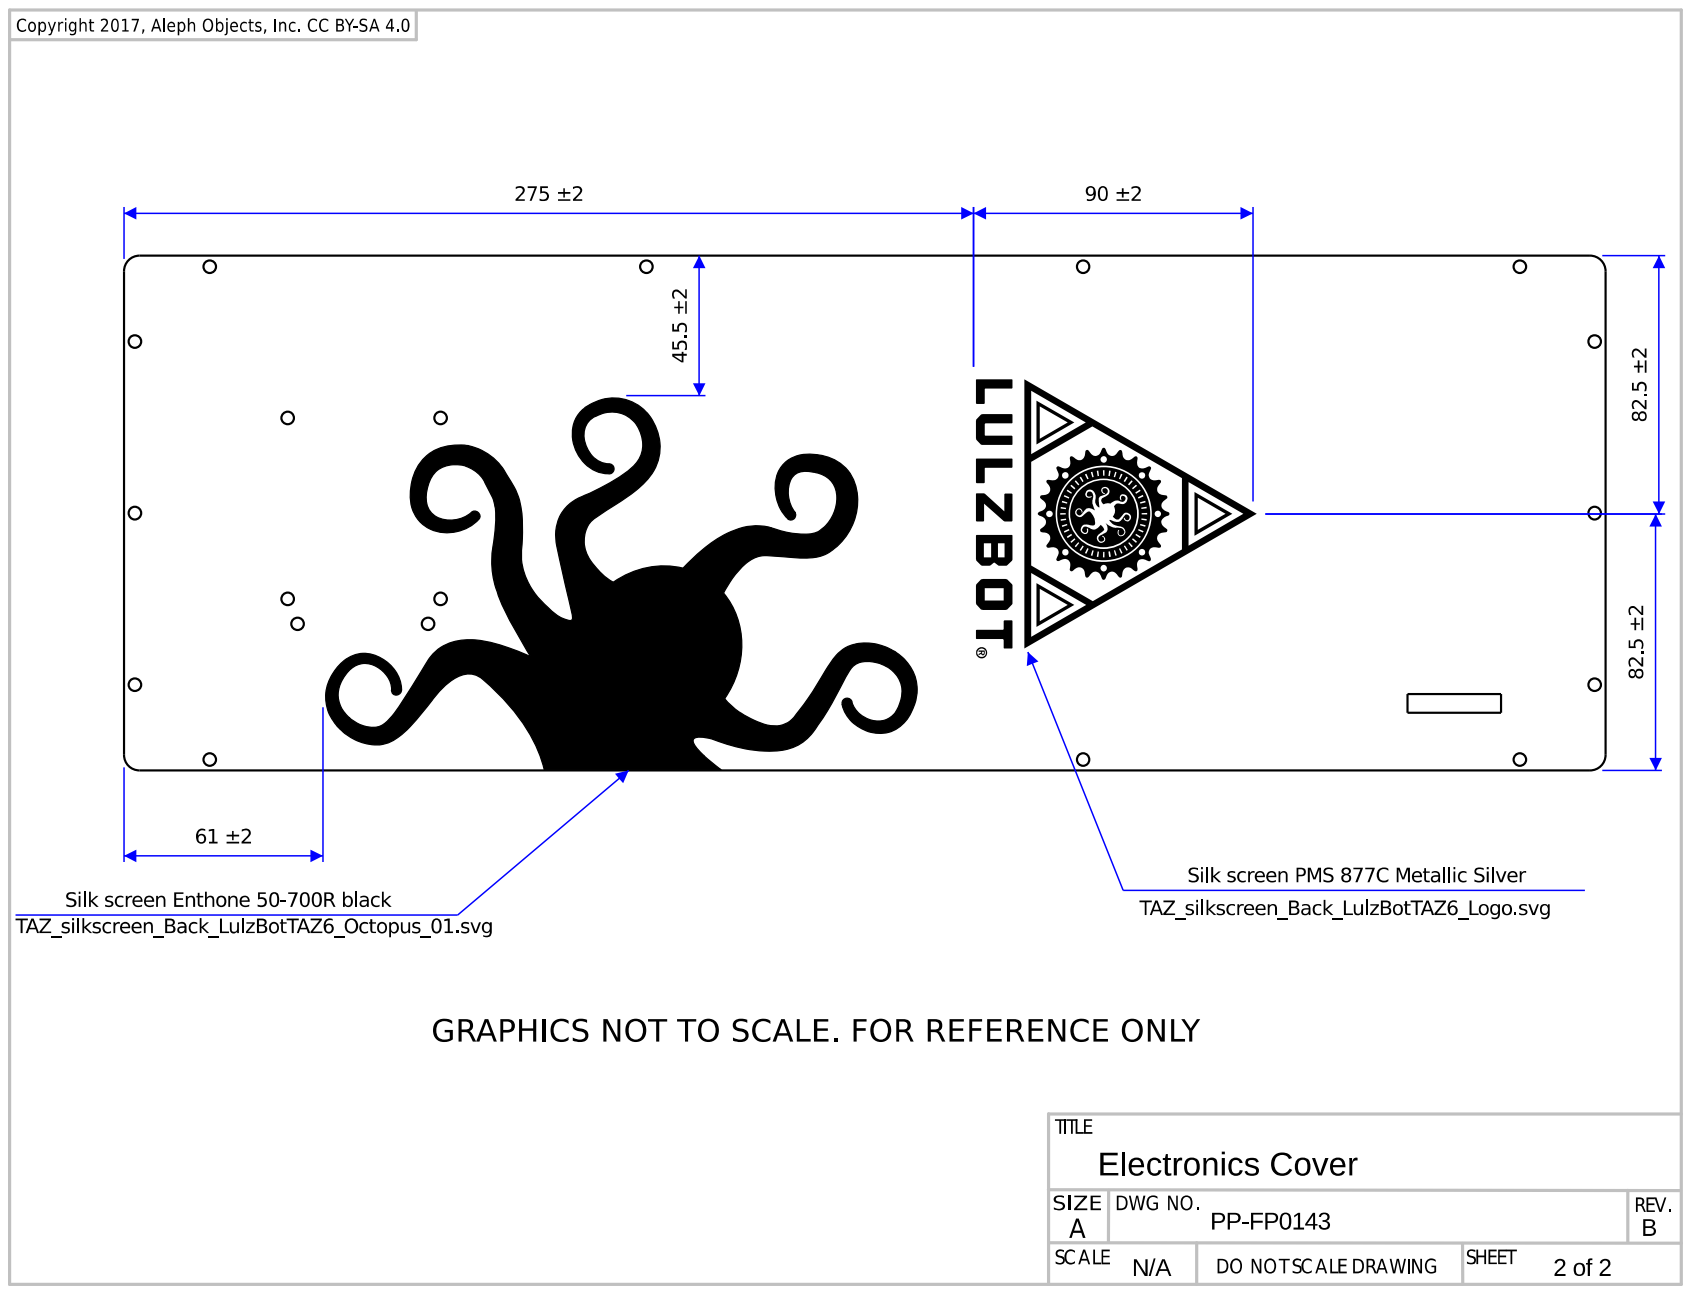
[picture p523: page 2]
