gralco/TAZ6/production_parts/machined_parts/interconnect_cover_v0.5/interconnect_cover_PP-FP0144.pdf

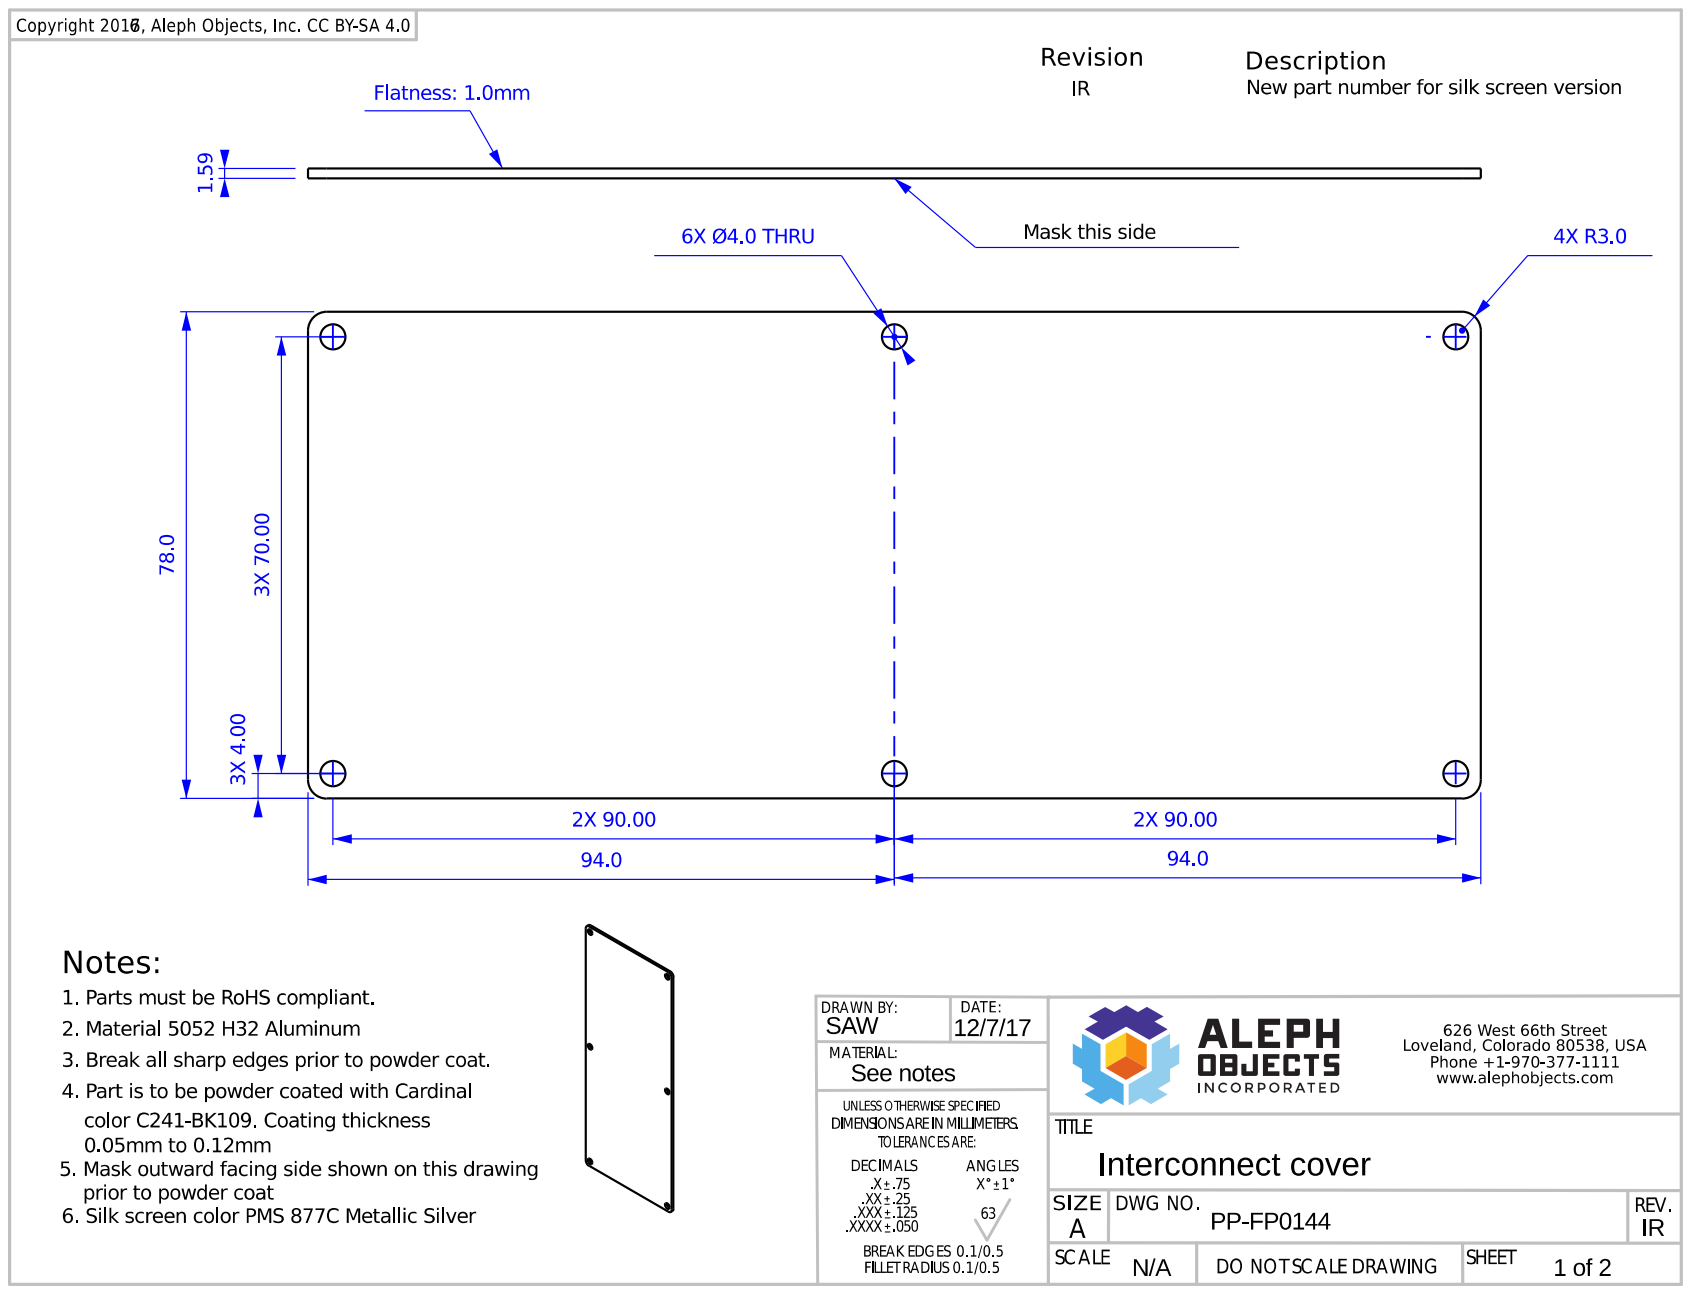
[picture p524: page 1]

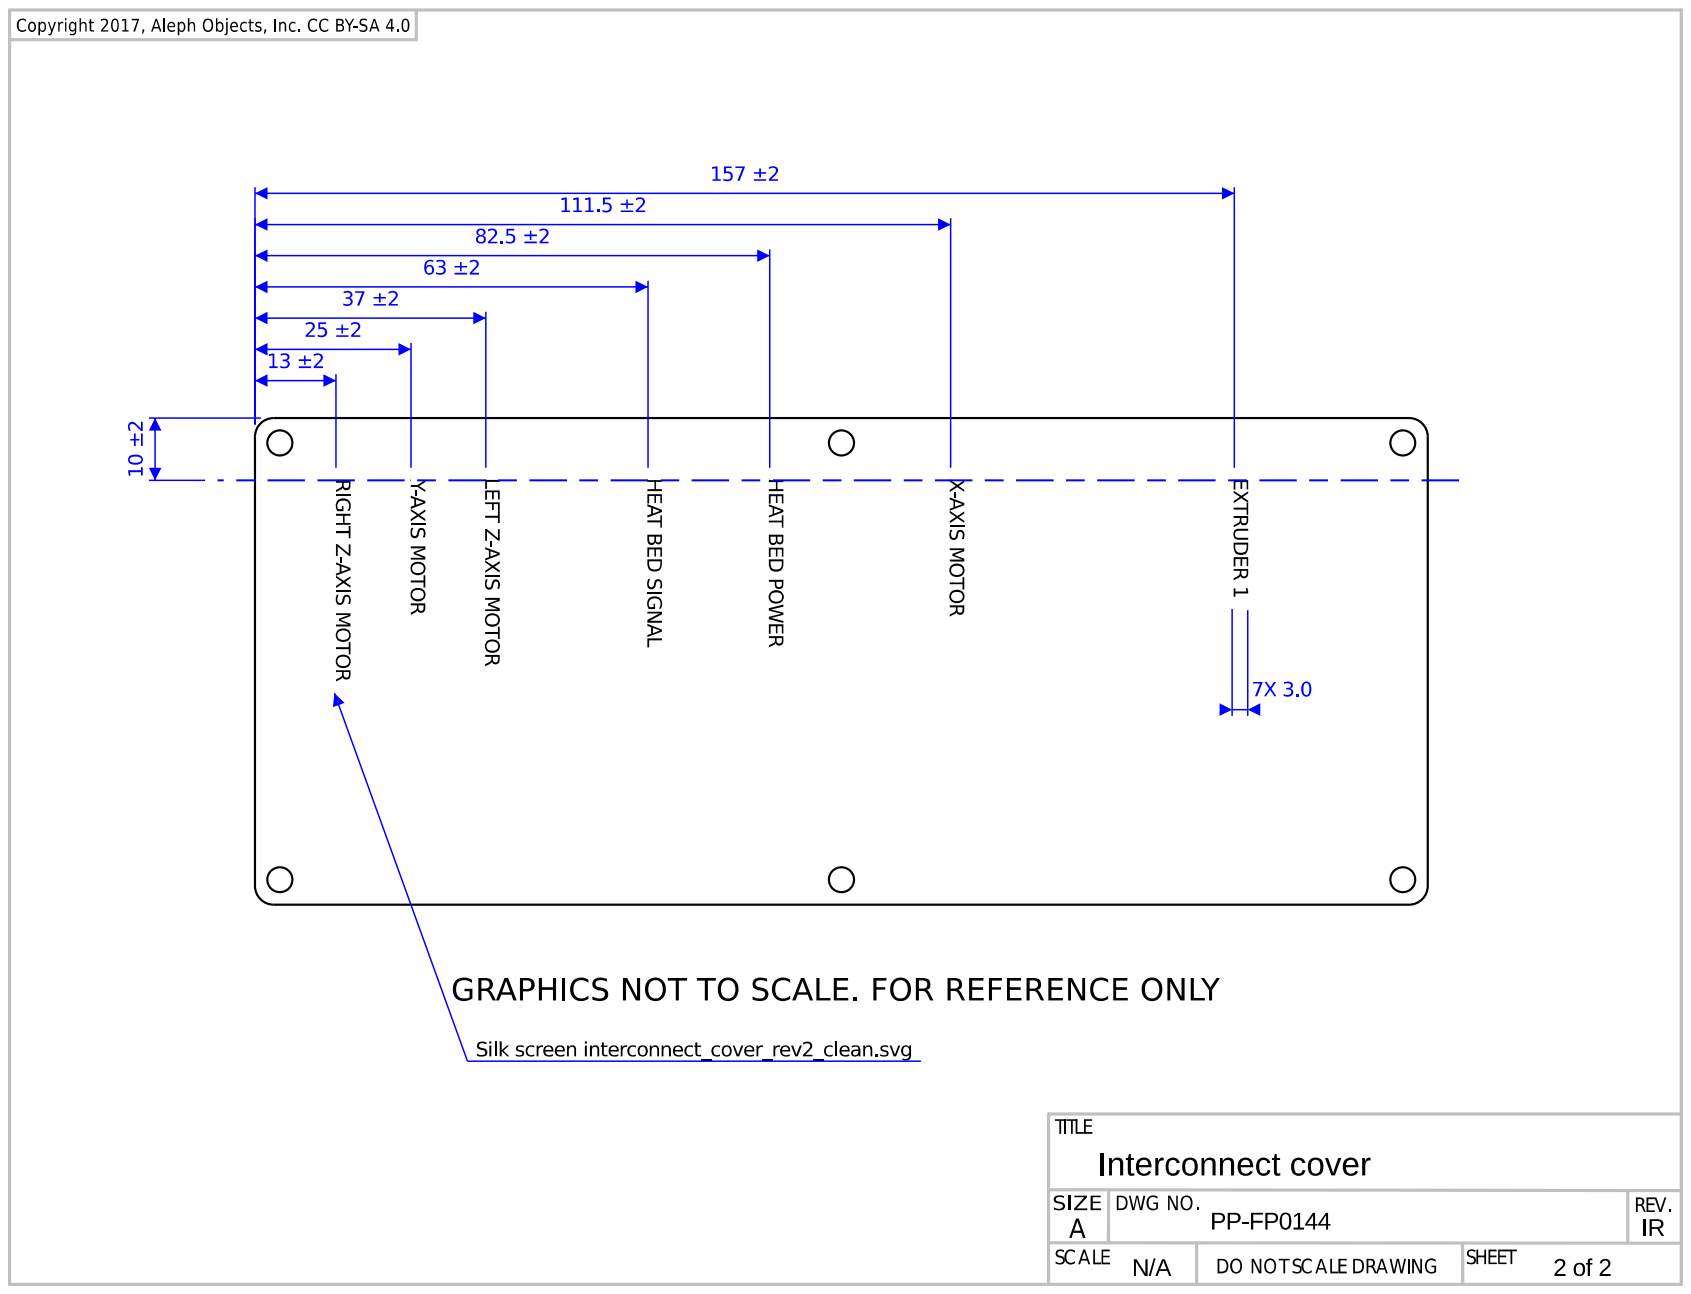
[picture p525: page 2]
