gralco/TAZ6/production_parts/machined_parts/lulzbot_edition_hexagon_hotend-0.5mm/ao-hex_heater-block_revA.pdf

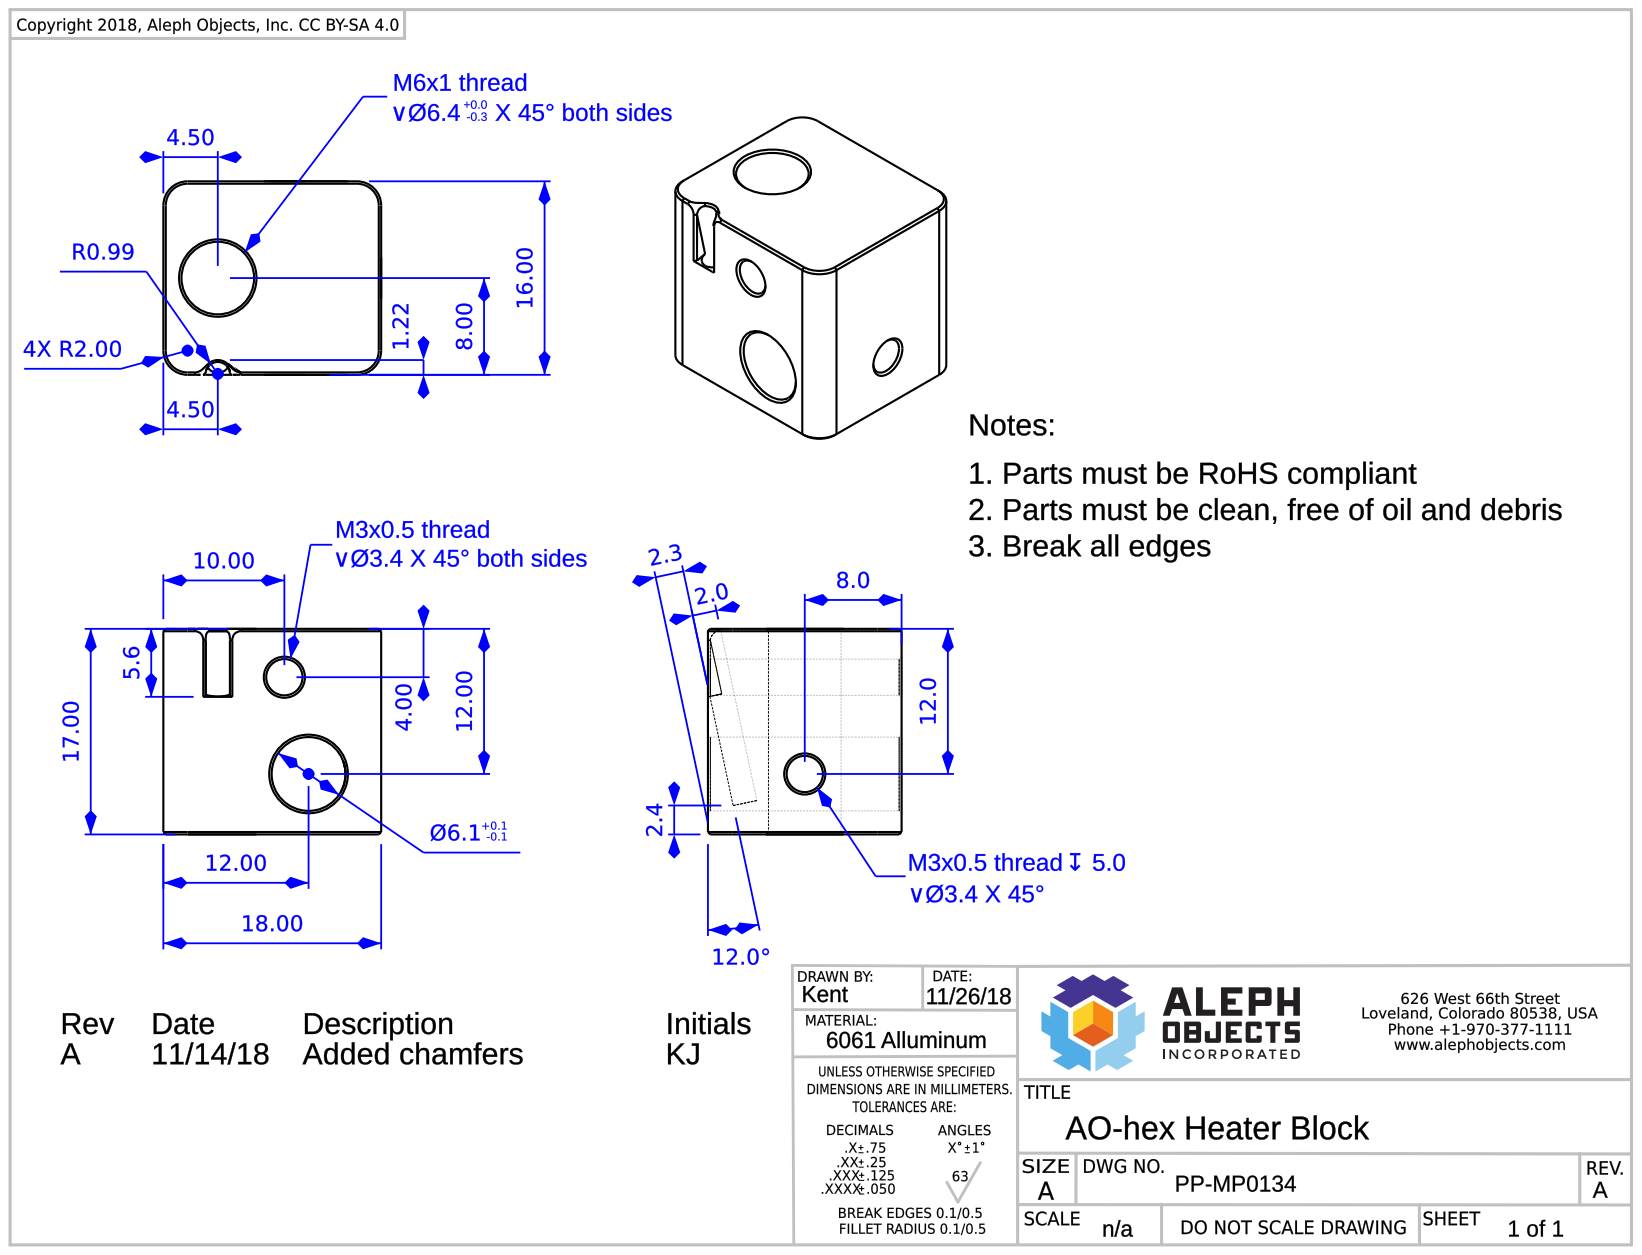
[picture p526: page 1]
