gralco/TAZ6/production_parts/machined_parts/y_end_plate_v0.2/y_end_plate_v0.2_revE_PP-MP0111.pdf

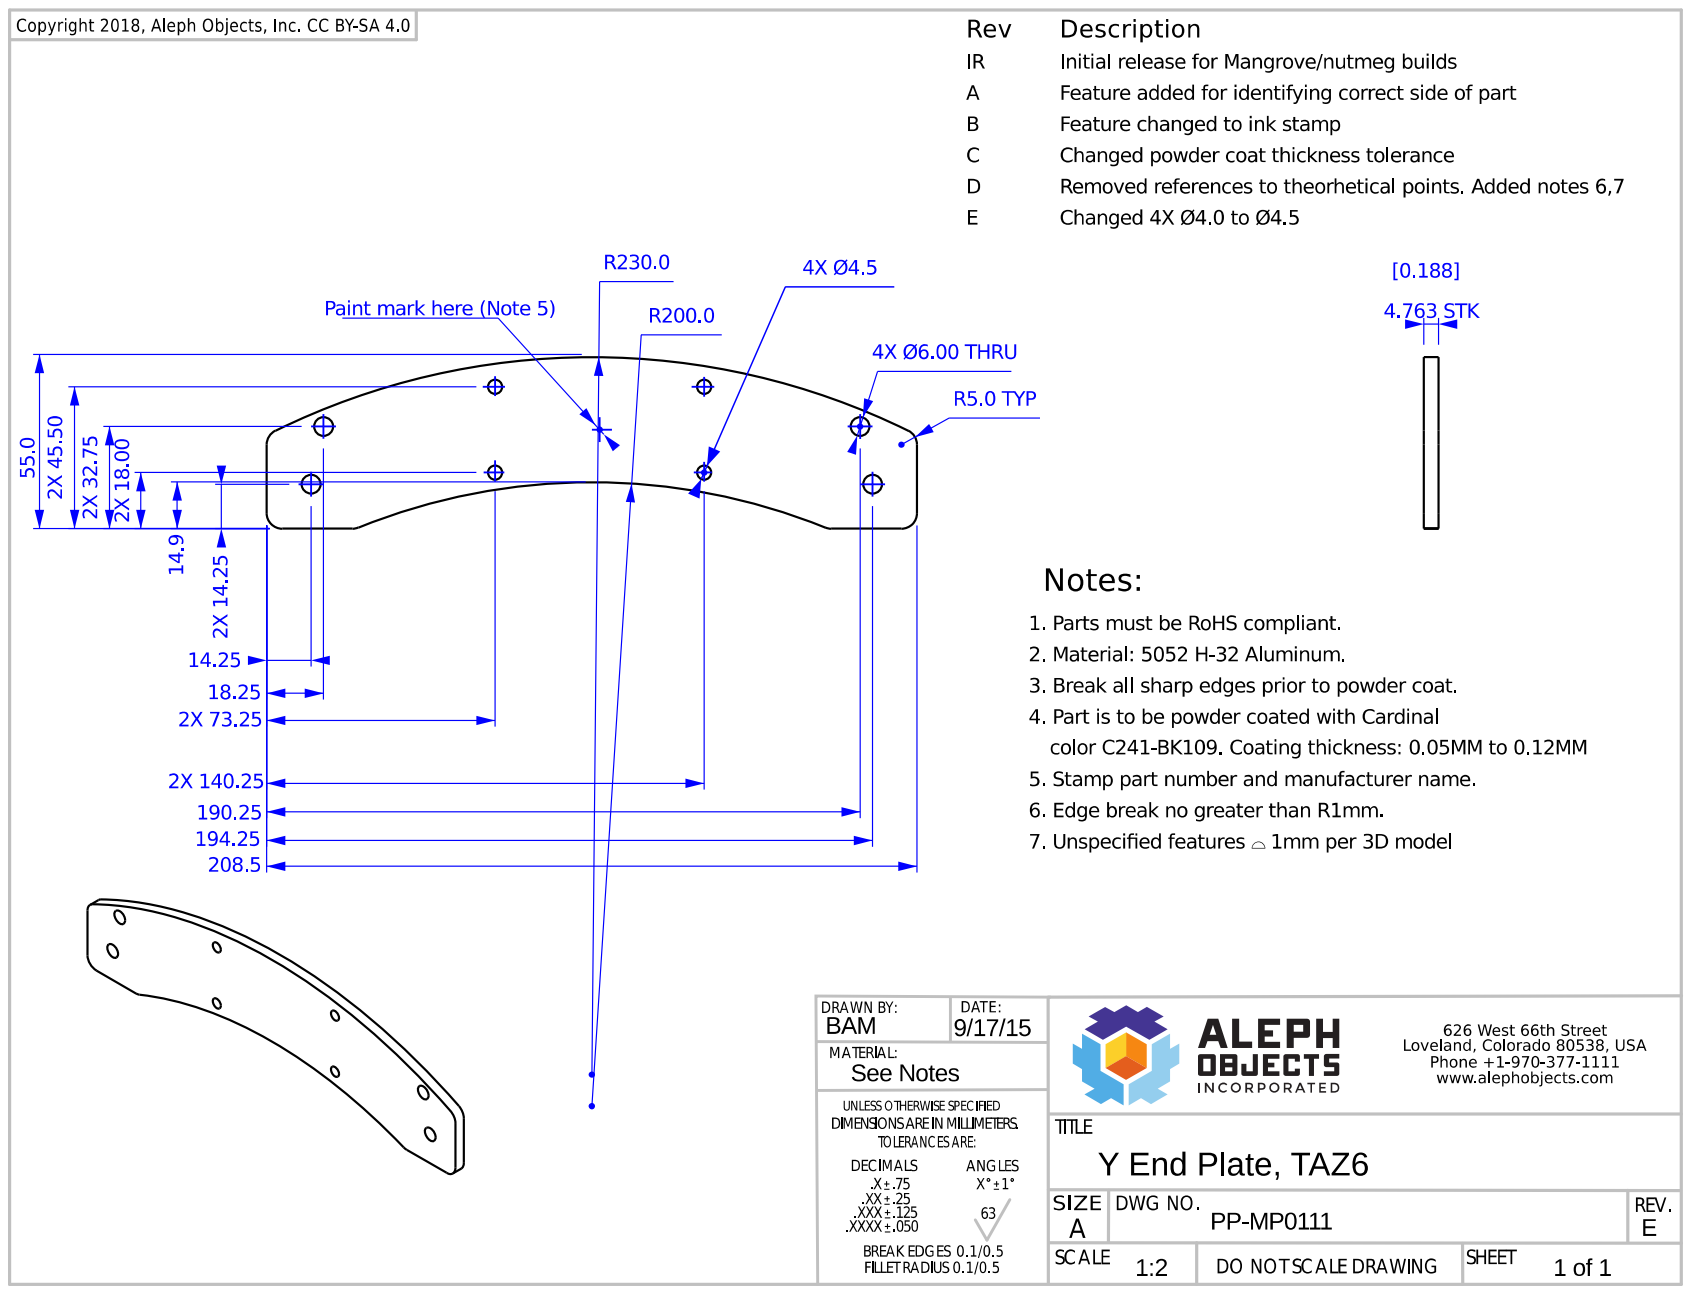
[picture p527: page 1]
